paperji/smart-bartender/hardware/3dprint/README.md

# 3D 프린팅 부품 (출력 부품 01~07)

> 팀 **홍당무** · 사용자의 감정 및 취향 분석 기반 AI 맞춤형 음료 및 칵테일 배합 메이커 · 2026-11-10
> 조립 방법은 [`../guide/조립가이드.md`](../guide/조립가이드.md) STEP 9·10과 **부록 D**를 보세요.

큰 판(외형 W420 × D260 × H380)은 포맥스 5T로 만들고, 정밀하게 맞물리거나·시중에서 구하기 어렵거나·겉으로 보이는 부품 7종만 3D 프린터로 출력합니다. 외형 전체를 출력하면 420mm 판을 2~4조각으로 나눠 이어야 하고(대부분의 출력 장비는 한 변 256~350mm), 출력 대행비가 약 30만~45만 원(추정), 큰 평판은 휘어서 권하지 않습니다.

| 번호 | 파일 (`stl/`) | 수량 | 크기 (mm) | 쓰는 곳 | 대신하는 것 |
|---|---|---:|---|---|---|
| 01 | `01_corner_bracket.stl` | 12 (+예비 2) | 26 × 26 × 16 | 바닥 A–측판 B, 선반 D–B, 상판 C–B 모서리 | L자 꺾쇠 P36 + 너트 접착 |
| 02 | `02_nozzle_block.stl` | 1 | 80 × 60 × 25 | 선반 D 아래(잔 칸 가운데) | 노즐 판 M1 + 걸이 M2 |
| 03 | `03_front_bezel.stl` | 1 | 100 × 40 × 3 | 앞판 F 바깥(버튼·LED 둘레) | — (마감) |
| 04 | `04_grommet_20.stl` | 2 | 28 × 28 × 9 | 선반 D의 Ø20 구멍 | 고무 그로밋 P44 |
| 05 | `05_grommet_12.stl` | 1 | 18 × 18 × 9 | 뒤판 G의 Ø12 구멍 | 고무 그로밋 P44 |
| 06 | `06_lid_corner_cap.stl` | 4 | 25 × 25 × 13 | 상판 C 네 모서리(C에만 접착) | — (마감) |
| 07 | `07_divider_bushing.stl` | 1 | 32 × 32 × 7 | 칸막이 E의 Ø25 구멍 | — (튜브 보호·번호) |

합계 7종 24개, 약 120cm³(PETG를 꽉 채우면 약 150g). `stl_plates/`에는 업로드용 묶음(`plate_A_brackets_x14.stl` 브래킷 14개, `plate_B_others_x10.stl` 나머지 10개)이 있습니다.

## 출력 조건

- 재료 **PETG 흰색**(PLA보다 물·알코올·열에 강함), 레이어 0.2mm, 벽 3겹, 인필 브래킷 50%·나머지 15%
- **크기 배율 100%**(M3 너트 홈 맞변 5.9·볼트 구멍 Ø3.5·튜브 구멍 Ø6.2 등 치수 고정), **파일 방향 그대로**(바닥면 z=0, 서포트 없이 출력되게 설계 — 브래킷은 L자 단면이 바닥)
- 모든 파일은 닫힌 형상(manifold), 단위 mm, 바이너리 STL

## 주문(2026-11-10 공개 정보 기준, 실제 금액은 업로드 견적으로 확인)

- **3DFARM** (https://3dfarm.co.kr/, 경기 김포) — 가입 없이 STL 업로드 즉시 견적, 결제 후 24시간 안에 출력 시작, 3만 원 이상 무료배송. 실제 주문 구성: 묶음 파일 `plate_A_brackets_x14.stl` 수량 1 + `plate_B_others_x10.stl` 수량 1(PETG 흰색, 배율 100%, 방향 '원본 그대로'). 2026-11-10 업로드 견적 51,000원 + 39,000원 = 약 9만 원(부품별 파일로 올린 것보다 쌌음) → **실제 결제 78,700원**(11/16 도착 예정). 한 파일에 부품이 여러 개면 1개당 추가 요금이 붙으니 견적에서 비교합니다. 요청사항에 "너트 홈 안에 서포트 없이"를 적습니다
- **메이크잇3d** (크몽, https://kmong.com/gig/533416) — 0.2mm PLA 10g당 1,500원, 시간 요금 없음, 배송 포함. 크몽 메시지로 견적. PLA면 약 1.5만~2.5만 원(추정)
- 그 밖에 와우쓰리디·아이컨택(업로드 견적), GBSA 3D프린팅통합센터 안양(공공, 비용·학생 자격은 전화 확인)

## 모델 고치기

`parts.py`(파이썬, [manifold3d](https://pypi.org/project/manifold3d/))가 모든 STL을 만듭니다. 치수를 바꾸려면 숫자를 고친 뒤 다시 만듭니다.

```
pip install manifold3d
python parts.py out
```

예: 어댑터 플러그가 커서 뒤판 G 구멍을 키웠으면 `grommet(12.0, 7.0, 3.0)`의 구멍 값을, 튜브가 꺾이면 `nozzle(H=25.0)`의 높이를 바꿉니다. 결과 요약은 `parts.json`.

## 위생

3D 출력물은 어떤 필라멘트도 식품용 인증이 없고 층 사이 홈에 액체가 스며들면 씻기 어렵습니다. 음료가 지나가는 길은 실리콘 튜브와 체크밸브뿐이고, 노즐 블록에서는 튜브 끝을 블록 아래로 10mm 내리고 블록 위쪽 튜브 둘레를 실링해 음료가 출력물에 닿지 않게 합니다(조립가이드 STEP 10 절차 7).
