paperji/smart-bartender/hardware/circuit/검증노트.md

# 회로 전기적 검증 노트 (AI 스마트 바텐더 회로도 v3)

> 팀 홍당무 · 2026-11-06 (SPEC v2.1 반영) · 기준: `smart-bartender/docs/SPEC.md` v2.1 §1 핀맵, `hardware/research/parts_research.md`, `canonical_bom.json`
> 대상 도면: `schematic.svg/png`(시트 1/2), `wiring.svg/png`(시트 2/2), `회로도.html`(연결표 ①~㊱)
> 표기: **(추정)** = 계산·일반값으로 낸 값, 실측으로 바꿔야 함. **(자료)** = 판매처/배포처 자료 값.

---

## 1. 요약

| 항목 | 결론 |
|---|---|
| 5V 4A 어댑터 용량 | 순차 구동 최대 약 0.96A(순간), 동시 구동 약 1.37A(정상)·1.77A(순간) → **여유 2.3배 이상** |
| 3A 퓨즈 | 정상 동작(최대 약 1.8A, 4개 동시 기동해도 약 3A·수십 ms)에서는 끊어지지 않음. **단락의 1차 보호는 어댑터(P11) 내장 과전류·단락 보호**이고, F1은 어댑터 보호가 고장 났거나 더 큰 전류의 어댑터를 쓸 때를 위한 **배선 백업 보호**. 4A 어댑터로는 단락이 나도 퓨즈가 안 끊어질 수 있음(6절) |
| 3.3V로 옵토 릴레이 구동(A안) | OFF는 확실. ON은 입력 전류 약 0.35mA(추정)로 **경계 수준 → 벤치 테스트 필수**, 실패 시 **B안(SPEC v2.1 공식 대체안)**: USB·어댑터를 모두 분리한 상태에서 ⑪(VCC←3V3)을 **먼저** 제거 → ⑨(+5V)를 JD-VCC 핀에서 입력 헤더 VCC 핀으로 옮김 → 점퍼 끼움, VCC=JD-VCC=5V, IN은 GPIO 직결. **B안에서 VCC를 3V3에 연결 금지** |
| 1N4007 플라이백 다이오드 | 전류·전압 정격 모두 충분(1A/1000V vs 0.2~0.6A/5V) |
| 1000µF 16V 커패시터 | 내압 3.2배 여유, 펌프 기동 시 순간 강하 약 0.2V 이하(추정) |
| ESP32 핀 | 사용 핀 모두 일반 GPIO(입력 전용·플래시 핀 미사용), GPIO2 스트래핑 핀은 LED+220Ω→GND로 문제 없음. DevKitC V4에는 GPIO2 사용자 LED가 없으므로 **외부 LED1+R1 필수** |
| 배선 굵기 | AWG20(펌프·전원), AWG22(ESP32 전원·앞판), 듀폰(신호·릴레이 헤더) 모두 전류 대비 충분. AWG22는 UL1007 노랑(P24)·검정(P62)·빨강(P63) 세 색: ⑦·㉛~㊱ 검정, ⑧ 빨강, ㉙·㉚·㉝·㉟ 노랑(+번호 테이프) |

---

## 2. 전류 예산

### 2.1 부하별 전류

| 부하 | 전류 | 근거 |
|---|---|---|
| 수중펌프 SZH-GNP155 1개, 정상 | 약 0.20 A | 4.5V 0.18A 표 (자료) → 5V에서 약간 증가 (추정) |
| 수중펌프 1개, 기동 순간 | 약 0.4~0.6 A (수~수십 ms) | 소형 브러시 DC모터 일반값 2~3배 (추정, 실측 필요) |
| 릴레이 코일 JQC-3FF-S-Z 5V 1개 | 약 0.071 A | 코일 약 70Ω (자료, 제조사 원본 미확인) |
| ESP32 DevKitC V4 (BLE 광고·연결) | 0.10~0.25 A | 보수적으로 0.25 A 사용 |
| 릴레이 입력(옵토) 4개 | A안 ≤ 약 1.5 mA, B안 ≤ 약 10 mA | 3절 계산 |
| 상태 LED (GPIO2) | 약 6 mA | (3.3 − 2.0) V ÷ 220 Ω |
| 능동 부저 ONE005 (3V3) | 약 20~30 mA | (추정) |

### 2.2 동작 모드별 합계 (5V 레일 기준)

| 모드 | 계산 | 합계 |
|---|---|---|
| 대기 (BLE 연결) | 0.25 + 0.006 | 약 0.26 A |
| 순차(seq) 정상 — 펌프 1개 + 릴레이 1개 | 0.25 + 0.071 + 0.20 + 0.04 | **약 0.56 A** |
| 순차 순간 최대 — 펌프 기동 | 0.25 + 0.071 + 0.6 + 0.04 | **약 0.96 A** |
| 동시(par) 정상 — 펌프 4 + 릴레이 4 | 0.25 + 4×0.071 + 4×0.20 + 0.04 | **약 1.37 A (약 6.9 W)** |
| 동시 순간 — 펌웨어가 0.1초 간격으로 차례 기동(`PAR_STAGGER_MS`) | 1.37 − 0.20 + 0.6 | **약 1.77 A** |
| (최악) 4개가 정확히 동시에 기동 | 0.25 + 0.284 + 4×0.6 + 0.04 | 약 2.97 A (수십 ms) |

### 2.3 어댑터 여유

- 5V 4A 어댑터 대비: 순차 순간 최대 0.96 A → **약 4.2배**, 동시 순간 1.77 A → **약 2.3배**. 최악 2.97 A도 정격 이내.
- 연속 전력: 최대 약 6.9 W (어댑터 20 W의 약 35%) → 발열 문제 없음.

### 2.4 선·커넥터 전류

| 경로 | 최대 전류 | 사용 선 | 판단 |
|---|---|---|---|
| ②③④ J1(+)→SW1→F1→TB1 | 약 1.8 A (par 순간) | AWG20 | 충분 (AWG20 배선용 수 A급) |
| ⑤ J1(−)→TB2 (펌프 귀환) | 약 1.4 A | AWG20 | 충분 |
| ⑦ J1(−)→ESP32 GND (ESP32 + 릴레이 코일 귀환) | 약 0.25 + 0.28 = 0.55 A | AWG22 UL1007 검정(P62) | 충분 |
| ⑧ TB1→ESP32 5V | 약 0.25 A | AWG22 UL1007 빨강(P63) | 충분 |
| ⑨ TB1→JD-VCC (코일 4개) | 약 0.28 A | 듀폰 | 충분 (듀폰 접점 1 A급). B안은 TB1→입력 헤더 VCC 핀→점퍼 캡→JD-VCC 경로(약 0.28 A + 입력 약 10 mA) — 점퍼 캡(보통 1~3 A급)도 충분 |
| ⑯ 릴레이 GND→ESP32 GND(J2-14) | 약 0.29 A | 듀폰 | 충분. 코일 전류가 ESP32 보드 GND 면을 지나 ⑦로 돌아감(수 mV 강하) |
| ⑰~⑳ COM, ㉑~㉘ 펌프선 | 펌프 1개 0.2~0.6 A | AWG20 2P | 충분. 0.7 m 왕복 강하 ≈ 1.4 m × 33 mΩ/m × 0.2 A ≈ 9 mV |

### 2.5 전압 강하와 ESP32 레귤레이터 여유

- 어댑터 케이블 + SW1 접점 + 퓨즈 + 배선 저항 합 ≈ 0.15~0.2 Ω (추정) → 1.37 A에서 약 0.2~0.3 V 강하 → ESP32 5V 핀 약 4.7~4.9 V.
- DevKitC의 3.3V LDO는 입력이 약 4.3~4.4 V 이상이면 정상 출력(드롭아웃 약 1 V급 가정) → 여유 있음. 순차 구동에서는 강하가 더 작음.

---

## 3. 3.3V 로직으로 옵토 릴레이를 구동하는 근거

- 보드 구조(사진 확인): 입력 헤더 `VCC IN4 IN3 IN2 IN1 GND`(치수도 방향 기준 위→아래), 2핀 점퍼 `JD-VCC | VCC`, 별도 코일 GND 핀 없음(코일 전류는 입력 헤더 GND로 귀환).
- 점퍼 헤더가 2핀뿐이라 **점퍼 캡을 끼우면 두 핀이 모두 덮여** JD-VCC 핀에 듀폰 소켓(⑨)을 같이 꽂을 수 없음 → B안에서는 +5V(⑨)를 **입력 헤더 VCC 핀(⑪을 뺀 자리)** 으로 넣고, 점퍼 캡을 통해 JD-VCC로 보냄. 이렇게 하면 VCC 핀을 ⑨가 차지하므로 3V3(⑪)을 실수로 다시 꽂을 자리도 없어짐.
- 입력 회로(추정, 일반적인 4채널 옵토 보드): `VCC → 1kΩ → 표시 LED(약 1.8 V) → 옵토 LED(약 1.15 V) → INx`.

| 방식 | IN = HIGH (OFF) | IN = LOW (ON) | 판단 |
|---|---|---|---|
| **A안 (SPEC)** 점퍼 제거, VCC = 3V3, JD-VCC = 5V | VCC − IN = 0 V → 전류 0 → **확실히 OFF** | (3.3 − 1.8 − 1.15) ÷ 1 kΩ ≈ **0.35 mA** (추정, 범위 0.3~0.7 mA) | 옵토 CTR이 낮으면 코일 트랜지스터가 덜 켜질 수 있음 → **시험 필수** |
| **B안** (USB·어댑터 분리 후) ⑪ 먼저 제거, ⑨(+5V)를 입력 헤더 VCC 핀으로 옮기고 점퍼 끼움 → VCC = JD-VCC = 5V | 5 − 3.3 = 1.7 V < LED 2개 문턱 약 2.6~3.0 V → **OFF** (추정) | (5 − 2.95) ÷ 1 kΩ ≈ **2.0~2.4 mA** → 확실히 ON | A안 실패 시 사용. **VCC를 3V3에 연결 금지** |

- ESP32 GPIO 부담: A안 싱크 약 0.35 mA, B안 약 2.4 mA → ESP32 권장 범위(수십 mA) 대비 매우 작음.
- B안에서 GPIO에 5V가 들어가는 경로: GPIO HIGH일 때 LED 직렬 회로에 걸리는 전압이 문턱 미만이라 전류가 거의 없고, 부팅 중(High-Z)에도 GPIO 보호 다이오드를 통해 흐를 만큼의 전압차가 생기지 않음(추정). 5V가 직접 GPIO에 닿는 배선은 없음.
- 부팅 순서: 펌웨어 `safeOutput()`이 `gpio_set_level(HIGH)`(출력 레지스터 선기록) → `pinMode(OUTPUT)` → `digitalWrite(HIGH)` 순서(SPEC §1; ESP32 코어 3.x는 `pinMode` 전에 부른 `digitalWrite`를 무시함, `config.h` RELAY_OFF_LEVEL=1)라 부팅 중 펌프가 튀지 않음. 리셋 직후 GPIO26/27/32/33은 입력 상태 → IN 핀에 전류 경로 없음 → OFF 유지.
- 핀 선택 검토: GPIO26·27·32·33·4·2·23은 모두 입출력 가능 GPIO. 입력 전용(34~39)·플래시(6~11) 미사용. GPIO2는 스트래핑 핀이지만 다운로드 모드 조건(LOW 또는 플로팅)을 LED+220Ω→GND가 방해하지 않음. GPIO32/33은 32 kHz 크리스털 핀이지만 DevKitC V4에는 크리스털이 없음.

---

## 4. 다이오드 정격 (D1~D4, 1N4007)

| 항목 | 요구 | 1N4007 | 판단 |
|---|---|---|---|
| 순방향 평균 전류 | 펌프 전류 0.2 A (차단 직후 수 ms) | 1 A | 5배 여유 |
| 순방향 서지 | 기동 전류 0.6 A 수준 | 30 A (8.3 ms) | 충분 |
| 역내압 | 평상시 5 V 역바이어스 | 1000 V | 충분 |
| 역회복 시간 | 릴레이 ON/OFF(초 단위) | 일반 정류용(수 µs) | 릴레이용으로 문제 없음. **PWM(MOSFET) 업그레이드 시 1N5819 쇼트키로 교체** |

- 방향: **띠(캐소드) = 펌프(+)**. 반대로 달면 릴레이 ON 때 5V–GND가 다이오드로 단락 → 5V 레일이 무너져 ESP32 재부팅(브라운아웃)·릴레이 해제, 또는 어댑터 보호 동작(꺼짐·재시작 반복). 4A 어댑터의 단락 전류(약 4~6 A, 추정)는 3A 퓨즈 정격의 1.5~2배라 **퓨즈는 끊어지지 않을 수 있고**, 1A 정격 다이오드가 약 4~5 W로 과열·소손될 수 있음. 특히 ESP32를 USB로 켠 디버깅 상태(⑧ 분리)에서는 릴레이가 계속 붙어 있어 단락이 이어질 수 있음 → "퓨즈 멀쩡 = 다이오드 정상"이 아님. 띠 방향을 눈으로 확인하고, 수축튜브가 변색·냄새 난 다이오드는 교체.
- 위치(SPEC §1): **① 펌프 리드선 이음부(뚜껑 위)** 또는 **② 연장선의 박스 쪽 끝** — **전기적으로 동일**(둘 다 펌프와 병렬).
  배선도(wiring.svg)는 ①로 그렸고, 조립 가이드 STEP3은 ②를 씁니다(젖지 않고, 펌프를 잇기 전에 멀티미터로 방향을 확인하기 쉬움).
  `parts_research.md` 3.5절·BOM P10의 "릴레이 쪽(띠 다리 → NO 단자, 반대 다리 → TB2)"도 ②와 같은 회로입니다.
- 역기전력 크기 예시(가정 L ≈ 1 mH, I = 0.2 A, 차단 1 µs): V ≈ 200 V, E ≈ 20 µJ → 다이오드가 약 0.8 V로 제한.

## 5. 커패시터 정격 (C1, 1000µF 16V 105℃)

- 내압: 16 V ÷ 5 V = 3.2배 여유(일반 권장 1.5~2배 이상) ✔
- 순간 강하 억제(추정): 펌프 기동 추가 전류 0.4 A가 0.5 ms 동안 C1에서만 공급된다고 가정 → ΔV = I·Δt ÷ C = 0.4 × 0.0005 ÷ 0.001 = **0.2 V**.
- 전원 투입 시 충전 돌입: 에너지 ½CV² = 12.5 mJ, 어댑터 출력 임피던스로 제한 → 퓨즈 I²t(3A 속단형 수 A²s급) 대비 무시 가능.
- 극성: 띠(−) → TB2, 긴 다리(+) → TB1. TB1 1번·TB2 8번이 맞닿게 두 커넥터를 나란히 고정해 다리를 바로 꽂음.
- (선택) ESP32 리셋이 생기면 P17 100µF를 ESP32 5V–GND 가까이에 추가.

## 6. 기타 정격

| 부품 | 정격 | 사용 | 판단 |
|---|---|---|---|
| 릴레이 접점 JQC-3FF-S-Z | 10 A 30 VDC | 0.2~0.6 A 5 VDC (유도성, 다이오드 있음) | 충분 |
| J1 DC잭 터미널 | 20 A, 1~38 V | ≤ 1.8 A | 충분 |
| SW1 KCD1-101A | 6 A 250 VAC (DC 정격 미표기) | 5 VDC ≤ 1.8 A | 저전압 DC라 아크 작음, 문제 없음(추정) |
| F1 FH-303 + 3A 유리관 | 홀더 10 A | 3A 퓨즈(속단형 가정, IEC 60127-2 F형): 1.5×In은 1시간 이상 견딤, 2.1×In(6.3 A) ≤ 30분, 2.75×In(8.3 A) 10 ms~2 s | 4A 어댑터는 단락 전류가 약 1.5~2×In(약 4.4~6 A, 어댑터 과전류 보호 동작점 추정)이라 **퓨즈가 끊어지지 않을 수 있음** → 단락 1차 보호는 어댑터 내장 보호, F1은 어댑터 보호 고장·더 큰 어댑터 사용 시의 배선 백업 보호. 정상 동작(최대 약 1.8 A)·4개 동시 기동(약 3 A, 수십 ms)에는 단선 안 됨. 3A 유지(2A로 낮추면 정상 1.37 A·순간 1.77 A는 견디지만 4~5 A에서 즉시 끊어지지는 않음) |
| PCT-418 | AWG28~14 (자료) | AWG20/22, 듀폰 | 적합. 피복 8~10 mm 벗겨 끝까지 삽입 |

---

## 7. SPEC 핀맵 일치 확인

| SPEC §1 항목 | 회로도 | 배선도/연결표 | 일치 |
|---|---|---|---|
| 펌프1 GPIO26 → IN1 | P1, GPIO26(J2-10) | ⑫ 파랑 | ✔ |
| 펌프2 GPIO27 → IN2 | P2, GPIO27(J2-11) | ⑬ 초록 | ✔ |
| 펌프3 GPIO32 → IN3 | P3, GPIO32(J2-7) | ⑭ 노랑 | ✔ |
| 펌프4 GPIO33 → IN4 | P4, GPIO33(J2-8) | ⑮ 보라 | ✔ |
| (확장) 펌프5~8 GPIO25·13·18·19 | 확장 메모 | HTML 핀표 | ✔ (배선은 미표시) |
| 버튼 GPIO4 → GND, INPUT_PULLUP | SW2 | ㉝ ㉞ | ✔ |
| 상태 LED GPIO2 (외부 LED+220Ω **필수**) | LED1·R1 (실선 = 필수) | ㉟ ㊱ | ✔ (보드에 사용자 LED 없음 → 외부 필수) |
| 부저 GPIO23 (능동, HIGH=울림) | BZ1 | ㉙ ㉚ ㉜ | ✔ (`config.h` BUZZER_ON_LEVEL=1과 일치) |
| 릴레이 VCC ← 3V3 (TB3), JD-VCC 점퍼 제거 (A안) | 표시 | ⑩ ⑪ + 점퍼 제거 표시 | ✔ |
| B안: 전원(USB·어댑터) 분리 → ⑪ 먼저 제거 → ⑨를 입력 헤더 VCC 핀으로 옮김 → 점퍼 끼움 · VCC=5V, 3V3 연결 금지 | 메모 | 메모 + 회로도.html ⑤ | ✔ (SPEC §1 v2.1 교차검증 반영본의 "⑪ 먼저 → ⑨ 이동 → 점퍼 캡, 전원 분리 상태"와 같은 순서) |
| 릴레이 JD-VCC ← 5V 레일 | 표시 | ⑨ | ✔ |
| ESP32 5V 핀 ← 5V 레일, USB 시 분리 | 표시 | ⑧ + 경고 | ✔ |
| 공통 GND, 별형 접지(⑤ → TB2, ⑦ → ESP32 GND, 릴레이 GND → ESP32 GND) | GND 레일 | ⑤ ⑦ ⑯ ㉒~㉘ ㉛ | ✔ |
| 전원: 어댑터 → SW1 → F1 3A → TB1, TB2 = GND, TB3 = 3V3 | SW1·F1 | ①~⑥ ⑩ | ✔ |
| 1N4007: 띠 → 펌프(+), 위치는 이음부 또는 박스 쪽 끝(전기적으로 동일) | D1~D4 | 이음부로 그림 + 메모 | ✔ |
| 릴레이 NO/COM/NC 멀티미터 확인 (COM–NC 삐, COM–NO 무음) | — | 배선도 메모 · 회로도.html ④ | ✔ |
| 5V 레일 1000µF 16V | C1 | ⑥ | ✔ |
| Active-LOW, `gpio_set_level(HIGH)` → `pinMode(OUTPUT)` → `digitalWrite(HIGH)` | 메모 | — | ✔ (펌웨어 `config.h` RELAY_ON_LEVEL=0) |

## 8. 회로 구현 선택 (1~3, 5는 SPEC v2.1 §1에 반영됨)

1. **SW1 전원 스위치 + F1 3A 퓨즈**(BOM P13~P15). SPEC v2.1부터 정식 구성(회로도의 "권장" 표시 삭제).
2. **분배 커넥터 3개**: TB1 = +5V(8구 모두 사용), TB2 = GND(J1−, 펌프− ×4, C1−, 예비 2), **TB3 = 3V3**(ESP32 3V3 → 릴레이 VCC·부저 VCC). TB3에는 BOM의 PCT-418 예비분을 사용 → 남는 예비 1개.
3. **GND 별형(스타) 접지**: J1(−) 나사에 ⑤(→TB2, 펌프 귀환)와 ⑦(→ESP32 GND J3-1) 두 가닥. 릴레이 GND는 ⑯으로 ESP32 GND(J2-14)에 연결.
   펌프의 큰 전류가 ESP32 GND 선을 지나지 않아 잡음·리셋에 유리. 결과적으로 모든 GND는 공통(SPEC과 동일).
   참고: SPEC §1 문구는 TB2를 "펌프·릴레이 코일 측"이라 적었지만, 이 릴레이 보드는 코일 GND 핀이 따로 없어 **코일 전류는 ⑯ → ESP32 GND → ⑦** 로 돌아갑니다(2.4절). 모두 공통 GND라 동작에는 영향 없음.
4. **다이오드 위치**: 이음부(뚜껑 위) 또는 연장선 박스 쪽 끝 — 전기적으로 동일(4절). 배선도는 이음부, 조립 가이드는 박스 쪽 끝.
5. 릴레이 단자 NO/COM/NC 순서는 보드 실크 기호를 사진으로 판독해 "치수도 방향에서 각 블록 위 = NO, 가운데 = COM, 아래 = NC"로 그림 → **멀티미터로 확인하도록 안내**(COM–NC 도통, COM–NO 무도통).

## 9. 남은 위험 · 확인 필요

| # | 위험 | 영향 | 대응 |
|---|---|---|---|
| 1 | A안(3.3V)에서 릴레이가 안 켜지거나 불안정 | 펌프 미동작 | 브레드보드 벤치 테스트 → 실패 시 B안(USB·어댑터 분리 후 ⑪ 먼저 제거 → ⑨를 VCC 핀으로 → 점퍼). 입력 회로 직렬 구조는 미확인 |
| 2 | 릴레이 NO/NC 위치 오판 | 전원 넣자마자 펌프 계속 동작 | 도통 확인 후 결선, 첫 통전은 펌프 선 없이(회로도.html ⑦) |
| 3 | JD-VCC·VCC 핀 혼동(인접 2핀) 또는 점퍼를 낀 채 ⑪ 연결 | 5V가 ESP32 3V3로 역류 → 고장 | 빨강/주황 색 구분, 점퍼 캡 제거 확인, 도통 검사(TB1–TB3 무음). B안은 ⑨가 VCC 핀을 차지해 ⑪을 꽂을 자리가 없음 |
| 4 | USB와 어댑터 이중 전원 | PC 포트/보드 손상 | ⑧ 분리 후 USB (경고 3곳 표시). 뽑은 ⑧ 끝(ESP32 5V = USB VBUS)은 수축튜브 캡·테이프로 절연해 J1 −·릴레이 COM 나사에 닿지 않게 |
| 5 | 펌프 기동 전류·실제 유량 미측정 | 전류 예산 오차 | 멀티미터 직렬 측정(200 mA 레인지 초과 주의, 10 A 단자 사용) |
| 6 | 펌프 5V 구동(정격 3~4.5V) | 수명 단축·발열 | 판매처 5V 안내 있음. 펌웨어가 펌프 1개 최대 120초(make, v2.1에서 60→120초)·run 60초로 제한하고 순차 구동이 기본. 120초 연속 구동 시 펌프 발열을 시운전에서 손으로 확인 |
| 7 | 브러시 모터 잡음으로 ESP32 리셋/BLE 끊김 | 제조 중단 | 다이오드(펌프와 병렬, 위치는 이음부·박스 쪽 끝 어느 쪽이든), 순차 구동, 필요 시 C2 100µF(P17) 또는 펌프 단자 0.1µF 세라믹(미보유) 추가 |
| 8 | 이음부·전선이 액체에 젖음 | 누전·부식 | 수축튜브 2겹, 전장 박스는 선반 위(액체와 격리), 이음부는 액면보다 위 |
| 9 | 릴레이 코일 전류가 ESP32 GND를 경유(⑯→⑦) | ⑦ 빠지면 ESP32·릴레이 모두 꺼짐(안전 측) | ⑦을 J1 나사에 확실히 조임 |
| 10 | 레버 커넥터·확장보드 단자에 듀폰 핀/가는 선 접촉 불량 | 간헐 동작 | 듀폰은 잘라 피복 벗겨 사용, 당김 시험 |
| 11 | 부저 ONE005 핀 순서(VCC/I/O/GND) 미확인 | 오결선 | 모듈 인쇄 확인 후 결선 |
| 12 | KCD1·FH-303 패널 구멍 치수 미확인 | 뒤판 G 가공 | 실물 실측(parts_research 8절) |

## 10. 검증 방법 (이번 작업에서 한 것)

- 도면 생성 스크립트(`src/`)가 전선 좌표를 기록해 **점 없는 교차를 자동 검출**: 회로도 0건, 배선도 3건(모두 반원 점프로 표시: ⑭×⑮, ⑫×⑬ — GPIO 순서가 릴레이 IN 순서와 엇갈려 생기는 필연적 교차, ㉙×⑦).
- 서로 다른 전선이 같은 직선 위에 겹치는 구간 자동 검출: 0건.
- 연결표 ①~㊱ 번호가 배선도 번호와 같은 원본(`src/connections.json`)에서 생성됨 → 번호 누락/중복 0건.
- Edge 헤드리스로 PNG(3600×2400)를 만들어 직접 확인하며 3회 수정: 글자 겹침(SW1/F1 라벨, 3V3 플래그–버튼 라벨, 범례 넘침, C1 라벨–전선), 회로도 내부 선이 상자에 가려지는 문제, 펌프 다이오드 가독성(확대 그림 추가), 점퍼 라벨 잘림 수정.
- (v2.1 수정) 상태 LED를 필수(실선)로, SW1·F1의 "권장" 표시 삭제, B안 순서(⑪ 먼저 뽑고 → ⑨를 VCC 핀으로 옮기고 → 점퍼 끼움, 2핀 점퍼라 JD-VCC 핀에는 캡만)·다이오드 위치 문구 통일, 120초 제한 반영 → 스크립트 재실행 후 PNG 재확인(교차 0/3건 동일, 겹침 없음).
- (리뷰 반영 2026-11-06) B안 배선을 실제로 만들 수 있게 수정(2핀 점퍼 헤더: ⑨를 입력 헤더 VCC 핀으로 옮긴 뒤 캡, JD-VCC 핀엔 캡만 — connections.json ⑨, 회로도·배선도 메모, 회로도.html ⑤ 그림), 퓨즈 역할 재정리(단락 1차 보호 = 어댑터, F1 = 백업 — 1·4·6절), 릴레이 초기화 순서를 SPEC·펌웨어와 일치(`gpio_set_level` → `pinMode` → `digitalWrite`), USB 업로드 때 뺀 ⑧ 끝 절연 안내 추가 → 스크립트 재실행 후 PNG 재확인(회로도 교차 0건, 배선도 반원 점프 3건·겹침 0건, 연결 번호 1~36 누락/중복 0건 — 수정 전과 동일).
- (BOM P62·P63 반영 2026-11-06) UL1007은 노랑(P24)·검정(P62)·빨강(P63) 세 색만 구매 → 연결표 색을 실제 구매 색과 맞춤: ⑦·㉛·㉜·㉞·㊱ 검정(P62), ⑧ 빨강(P63), ㉙·㉚·㉝·㉟ 노랑(P24, 예전 주황·분홍·하늘·갈색) + 선 양 끝 번호 테이프, ⑩은 듀폰 주황(또는 UL1007 노랑), ㉙는 듀폰 주황으로 이어도 됨. 배선도 범례·굵기 문구·회로도.html 굵기 안내·⑧ 부품표(P24·P62·P63)와 B안 문구(전원 분리 후 ⑪ 먼저)를 고친 뒤 make_schematic.py → make_wiring.py → make_html.py → render_png.py 재실행: 회로도 교차 0건, 배선도 반원 점프 3건(⑦×㉙, ⑮×⑭, ⑬×⑫)·겹침 0건, 연결 36개·번호 1~36 일치 — 수정 전과 같음. PNG(3600×2400)는 범례·앞판·주의 상자를 확대해 글자 넘침·겹침 없음을 확인.
- (리뷰 반영 2026-11-07) 회로도.html 맨 위 핀맵 표의 B안 요약 행에도 위 문구와 같이 "USB·어댑터 분리 후"와 "⑪ 먼저"를 넣음(make_html.py의 그 행만 고쳐 make_html.py만 재실행 — schematic/wiring SVG·PNG는 바뀌지 않음, 연결표 36행 그대로).
- ESP32 핀 위치는 Espressif DevKitC 핀 배치도, 릴레이 헤더·점퍼·단자 위치는 판매처 사진과 치수도(76×56 mm, 홀 간격 69.6×49.4 mm)로 대조.
