paperji/smart-bartender/docs/프로젝트_정리.md

# 캡스톤 폴더 전체 스캔 결과 정리 (2026-11-06, 7장 v2.1 진행 결과 · 8장 앱 v3.0 2026-11-07 · 10장 앱 v3.1 2026-11-08)

> 기준: 팀 캡스톤 폴더의 모든 파일(HWP·HWPX·PPTX·XLSX·PDF·코드·이미지) 텍스트 추출 후 통합. (보고서 원본은 이 저장소에 넣지 않음)
> 내용이 충돌하면 **최근 수정 파일을 우선**했습니다.

## 1. 과제 한눈에 보기

| 항목 | 내용 |
|---|---|
| 과제명 | 사용자의 감정 및 취향 분석 기반 AI 맞춤형 음료 및 칵테일 배합 메이커 |
| 팀 | 홍당무 (51분반, 4명) |
| 과목 | 캡스톤디자인Ⅰ(2026/1) → **캡스톤디자인Ⅱ(2026/2, 현재)** |
| 유형 | 일반 캡스톤디자인 / 결과물: 시제품 + 소프트웨어 |
| 목표 | 앱에 기분·맛·성향 입력 → AI(Gemini)가 기기 내 재료로 레시피 생성 → ESP32가 펌프 시간 제어로 자동 배합 |
| 특허 아이디어 | ① BM/SW: 재고 연동 AI 추천 + 거절 시 미보유 재료 추가 장착 유도 루프 ② HW: 펌프 단독 구동시간 제어 모듈 |

## 2. 진행 이력 (문서 근거)

| 시기 | 내용 | 근거 파일 |
|---|---|---|
| 3/3~3/21 (1~3주) | 팀 구성, 주제 확정, 역할 분담 | 주차별 보고서, 1학기 중간보고서 |
| 3/25 | 1학기 과제계획서 (밸브+펌프 구조, 앱 워크플로우 설계) | 1학기 과제 계획서 (3/25) |
| 3/26~3/30 | Expo 앱 + Vercel 백엔드(Gemini 2.5 Flash) 구축 | beverage-maker app |
| 4/13 | 선행특허 조사 보고서, 특허 분석 PPT | 선행특허 보고서, 프레젠테이션.pptx |
| 4월 말 | 중간발표, 앱 틀 화면 | 어플틀 사진.png |
| 5/5 | 1차 물품 구매(109,200원), 회로도 V1(솔레노이드 포함) | 물품구매의뢰서.xlsx, 회로도.html |
| 5/8 | 1학기 중간보고서 제출 | 중간보고서 .hwpx |
| 5/14 | **회로도 V2: 솔레노이드 제거, 펌프 단독 제어** | 회로도ver2.html |
| 5/25~6/7 | 진행사항·기말 PPT (Wi-Fi STA, 릴레이 4ch, 캘리브레이션 계획) | 진행사항/기말 .pptx |
| 5/29 | 2차 구매(52,200원: 체크밸브, 1N4007, AWG20, 튜브 5mm, 수축튜브) | 물품구매의뢰서_추가분.xlsx |
| 6/22 | 1학기 결과보고서 (실습비 161,400원 집행) | 결과보고서 .hwp |
| 9/21 | 2026 캡스톤 경진대회 참가 신청 (유형Ⅱ AI·공학) | 참가신청서 .hwp |
| 10/1 | 2학기 과제계획서 (캡스톤디자인Ⅱ) | 과제 계획서 홍당무 .hwp |
| 10/10 | 경진대회 예선보고서 (계획 대비 70%) | 예선보고서 .hwp |
| 11/6 | ESP32 Wi-Fi 코드·앱 코드 최신화 (Wi-Fi/HTTP 방식) | esp32 모터 제어 코드 c++.txt, 앱 코드 javascript.txt |
| 10월 중순 | 경진대회 예선 결과: **예선 탈락** (사용자 확인) → 이후 목표는 졸업작품 시제품·논문·특허 | — |
| 11/10~11/11 | **2학기 부품 구매(무납땜 기준)**: 3D 출력 부품 78,700원(견적 90,000원보다 적음)·포맥스 3장 43,000원 → 디바이스마트 35품목 102,528원(거래명세서 대조) · 다이소 6품목 14,000원(배송비 3,000원 포함) — 2학기 지출 238,228원 | `hardware/BOM_무납땜기준.xlsx` 지출_완료 시트 |

## 3. 하드웨어 현황 (구매 완료)

| 부품 | 수량 | 사용 여부 |
|---|---|---|
| ESP32 DevKitC WROOM-32D V4 (CP2102) | 2 | 1개 사용, 1개 예비 |
| 4채널 5V 릴레이 모듈 SZH-RLBG-012 | 2 | 1개 사용, 1개 예비(펌프 5~8 확장용) |
| 수중펌프모터 SZH-GNP155 | 4 | 사용 |
| SparkFun 솔레노이드 5V ROB-11015 | 4 | **미사용** (설계 변경으로 제외) |
| 실리콘 튜브 내경 4mm×5m, 5mm×8m | — | 사용 |
| 체크밸브 JGB32PPS | 4 | 사용 (역류·드립 방지) |
| 1N4007 다이오드 | 10 | 4개 사용 (펌프 역기전력 보호) |
| 5V 4A 어댑터, DC 플러그, 터미널-DC 커넥터 | 1/1/2 | 사용 |
| AWG20 2P 10m, 열수축 슬리브, 브레드보드, 점퍼선 | — | 사용 |

## 4. 소프트웨어 현황 (v1, 11/6 기준)
- 앱: Expo SDK 54 / React Native, 재료 4개 태그 입력 + 원하는 맛 텍스트 → Vercel 백엔드 → Gemini → `{"재료명": ml}` 응답을 `pump1~4`로 변환 → ESP32에 HTTP POST.
- ESP32: Wi-Fi STA + WebServer `/makeDrink`, `delay()`로 순차 구동, `MS_PER_ML=1000`(미보정).
- 한계: 블루투스 미지원, 재료 저장 안 됨(앱 재시작 시 초기화), IP 하드코딩, 캘리브레이션·진행상황·비상정지·기록 없음, 디자인 미흡, Expo Go 오류 화면 발생 이력.

## 5. 발견한 문제점 / 정정 필요 사항
1. 회로도 V2: 릴레이 모듈 VCC를 5V로 연결 → ESP32(3.3V) 신호로는 릴레이가 확실히 꺼지지 않을 수 있음 → v3에서 JD-VCC 분리 배선으로 수정.
2. 회로도 V2: 플라이백 다이오드 외 전원 안정화 커패시터·퓨즈 없음, ESP32 USB/외부 5V 동시 연결 주의 없음.
3. 기존 코드 `MS_PER_ML = 1000` (1ml/초) 는 실제 펌프 유량(수십 ml/초 수준)과 크게 달라 캘리브레이션 필수.
4. 선행특허 보고서·특허 PPT에는 여전히 '솔레노이드 밸브' 기반 H/W 차별화가 적혀 있음 → 최신 설계(펌프 단독 제어)와 불일치.

## 6. v2에서 바꾸는 것 (요약 — 상세는 SPEC.md)
- 통신: Wi-Fi/HTTP → **BLE (Nordic UART, 줄바꿈 JSON)** — 공유기·IP 불필요.
- 펌웨어: 비차단 상태머신, 진행률 알림, 비상정지(앱/버튼), 펌프별 유량 보정값 플래시 저장, 시리얼로도 테스트 가능.
- 앱: 재료(펌프) 저장·수정·잔량 관리, 기분/맛/도수/날씨(자동)/상황/성향 입력, AI 레시피 카드·비율 조정, 제조 진행·비상정지, 기록·피드백, 캘리브레이션 마법사, 데모 모드.
- AI: 구조화된 JSON 응답(스키마 강제) + 서버/앱 이중 검증 + 오프라인 규칙기반 대체.
- 회로: JD-VCC 분리, 1000µF 커패시터, 퓨즈, 버튼·LED·부저(선택), 실물형 배선도.

## 7. v2.1 진행 결과 (2026-11-07 기준)

### 7.1 만든 것
| 산출물 | 위치 | 상태 |
|---|---|---|
| ESP32 펌웨어 v2.1.0 (BLE) | `firmware/` | PC 테스트 191/191 (펌프 4개 180 + 8개 11), arduino-cli 컴파일 3종(기본·8펌프·2펌프) 에러·경고 0, 플래시 1,128,275B(86%)·RAM 51,328B |
| 안드로이드 앱 v2.1 (Expo) | `app/` | 자동 테스트 143/143, 타입 검사 0 오류, expo-doctor 20/20, 웹 빌드 성공. 데모 기기로 추천 → 레시피 → 제조 → 피드백 → 새 재료 탐색 → 기록 → 잔량 차감까지 브라우저에서 직접 눌러 확인(11/7) |
| AI 서버 v2.1 (Vercel + Gemini) | `backend/` | 로컬 테스트 68/68 (가짜 Gemini 응답, 실제 호출 없음) |
| 회로도·배선도·연결표 ①~㊱ | `hardware/circuit/` | 문서 간 교차 검증 통과(연결 36개 일치) |
| BOM·추가 구매 의뢰서용 시트 | `hardware/BOM.xlsx`, `BOM.md` (2026-11-10부터 두 기준 통합판 — 이 줄의 숫자는 11-06 원본 `hardware/research/BOM_원본_20261106.*` 기준) | 검증 78/0. 필수 구매 79,658원(VAT 포함, 의뢰서 기준 VAT 별도 72,418원, 35품목) |
| 초보자 조립 가이드 | `hardware/guide/조립가이드.html` | STEP 1~12, 그림 15장, 깨진 링크 0 |
| 2학기 중간보고서 | 팀 보고서 폴더의 `캡스톤 디자인 중간보고서(2학기) …홍당무.hwpx/.hwp/.pdf` (이 저장소에는 포함하지 않음) | 1~10주(9/1~11/6), 제출일 2026-11-06 |

### 7.2 교차 검증 (같은 입력을 양쪽에 넣어 결과 비교)
- **펌웨어 ↔ 앱 데모 기기**: 명령 스크립트 387·757·757개 중 386·756·756개가 출력까지 완전히 같음. 남은 1개는 `setcal`에 소수 셋째 자리 값(4.445)을 넣었을 때의 반올림 차이(실제 앱은 소수 둘째 자리까지만 보냄).
- **앱 ↔ AI 서버 (무작위 10,000건 × 3, 3,000건 × 2)**: 계약 항목 모두 100% 일치. "무알콜·성인 확인 전에는 술 장착·대체 제안 0" 안전 항목은 앱·서버 모두 100%. 참고용 차이 4개(탐색 카드 ml 반올림 등)는 계약 밖이며 안전과 무관.

### 7.3 아직 확인하지 못한 것 (실물이 있어야 함)
- ~~실제 보드 업로드·BLE 연결~~ → 2026-11-07 확인(9장). 남은 것: 릴레이·펌프를 단 실물 구동, 릴레이 A안(3.3V)/B안(5V) 결정, 캘리브레이션 실측.
- ~~PC ↔ ESP32 블루투스 연결~~ → 2026-11-07 확인(9장). 남은 것: 실제 **휴대폰(APK)** ↔ ESP32 연결.
- 실제 Gemini 호출: v3.0 부터 서버 배포 없이 각자 본인 키로(8장). 예전 서버는 크레딧 소진 오류 상태였고 더 쓰지 않음.
- ~~가격 미확인 품목~~ → 2026-11-11 무납땜 기준 부품을 모두 사서 디바이스마트 품목은 거래명세서 금액으로 바뀜. 다이소 6품목은 결제 14,000원(배송비 3,000원 포함, 품목별은 다이소몰 판매가로 나눔), 선택 품목(시음 전 교체용 P65~P67, 볼트 P68, 자석 P69)은 사지 않음. 재원(1학기 잔액 이월·예선 지원금·2학기 실습비)도 미확인.

### 7.4 주의
- 식품용 부품으로 바꾸기 전에는 기기에서 나온 액체를 마시지 않고, 시연은 색 물로 합니다(조립가이드 1.3).

## 8. 앱 v3.0 (2026-11-07) — 웹앱 하나로 PC·안드로이드

결정(2026-11-07): ① AI 는 **사용자가 본인 Gemini API 키를 앱에 등록**(BYOK) ② 앱 디자인은 **밝은 톤** ③ Expo 대신 **웹으로 PC·폰에서 동작 + 파일(APK·EXE)로도 설치**. 기준 문서 `docs/WEBAPP_DESIGN.md`.

| 산출물 | 위치 | 상태 |
|---|---|---|
| 앱 v3.0.3 (Vite + React 19 + TypeScript) | `app/` | `npm test` 323/323, 타입 검사 0 오류, 웹·PWA 빌드 + 키 검사 통과 |
| 안드로이드 APK (Capacitor 8) | `app/release/SmartBartender-3.0.3.apk` (깃 제외 → GitHub Releases) | 빌드·서명 확인(약 6MB). **실제 휴대폰 ↔ ESP32 연결·앱 안 업데이트(3.0.2 → 3.0.3) 확인**(9장) |
| Windows EXE (Electron, portable) | `app/release/SmartBartender-3.0.3-portable.exe` (깃 제외 → GitHub Releases) | 빌드(약 108MB) + 창 없이 실행 점검 통과. **실제 PC ↔ ESP32 연결·앱 안 업데이트(3.0.2 → 3.0.3) 확인**(9장) |
| 웹앱 배포 | `.github/workflows/pages.yml` → https://paperji.github.io/smart-bartender/ | 배포됨(2026-11-07, Actions). 저장소에 올리면 자동으로 다시 배포. 열려 있던 3.0.1 창이 3.0.3 으로 저절로 바뀌는 것 확인(PC·휴대폰 크롬) |
| 이전 앱 v2.1 (Expo) | `legacy/app-expo-v2.1/` | 참고용 보관(고치거나 배포하지 않음) |
| 백엔드 v2.1 | `backend/` | 보정 규칙 기준 구현으로만 유지(68/68), 앱↔백엔드 결과 비교 테스트. 배포하지 않음 |

- 바뀐 것: 서버 모드·서버 주소 설정 제거(앱이 Gemini 를 직접 호출, 키는 그 기기에만 저장), 키 등록 화면([키 확인]·[저장]·[삭제]·키 발급 방법), 첫 실행 안내 카드, 밝은 톤 UI, PC 화면(왼쪽 메뉴·2열), 웹 블루투스·APK 네이티브 BLE·EXE 앱 안 기기 선택 창, PWA 오프라인 실행, 설정 > 앱 정보(내려받기·오픈소스 고지).
- 그대로인 것: 펌웨어·BLE 프로토콜, 보정 규칙(SPEC §3.3)·탐색(§5.4), 화면 기능과 문구(해요체), 데모 모드.
- 공개 저장소 원칙(팀 결정 2026-11-07): 개인 이름·학번·연락처는 넣지 않고 팀 이름 "홍당무"만 씀. `hardware/BOM_납땜기준.xlsx`·`BOM_무납땜기준.xlsx` 의 의뢰서 팀장 이름 칸도 비워 두고 문서 속성(작성자)을 지움 — 학교 제출본은 제출 전에 직접 기입.

## 9. 실제 ESP32 연결 시험 (2026-11-07)

USB 로만 연결한 ESP32 보드(릴레이·펌프 없음 → 펌프 핀만 켜지고 아무것도 움직이지 않음)에 펌웨어를 올리고, 이 PC 의 블루투스로 앱과 연결해 봤어요.

| 항목 | 결과 |
|---|---|
| 보드 | ESP32-D0WD-V3 (rev 3.1), 플래시 4MB, CP210x (COM5). 광고 이름 `SmartBartender-606A` |
| 업로드 | `arduino-cli`(Arduino IDE 2 내장) + 코어 esp32 3.3.8 + ArduinoJson 7.4.3 → 1.13MB(86%), 경고 0, 해시 검증 통과 (`firmware/README.md` 3-1) |
| USB 시리얼 | 부팅 메시지·`hello`/`status`/`ping`/`getcal` 응답이 SPEC 그대로 |
| PC 블루투스 자동 시험 | `firmware/test/ble_e2e.py` **32/32** (펌웨어 2.1.0·2.1.1·2.1.2 모두): 광고·특성, 순차·동시 제조(예상 2.425초 → 실제 2.52초), BUSY, 비상 정지(0.08초), 오류 4종, 한글 id 20바이트 쓰기, run, **제조 중 끊기 → 0.6초 뒤 다시 광고 → 다시 연결해 `status.last` 로 결과 확인**. MTU 247 |
| Windows 앱(EXE) | 데모 모드 끄기 → 기기 선택 → 연결(펌웨어 버전 표시) → 오프라인 추천 레시피 → **기기로 제조**(10.6초, 완료·기록·잔량 차감) → **비상 정지**(나온 양 74.3ml 표시) → **제조 중 보드 리셋** → 앱이 자동으로 다시 연결해 "기기가 다시 켜져 제조가 멈췄어요, 확인된 양 약 60ml" 로 정리 |
| 고친 것 (앱 v3.0.1 · 펌웨어 2.1.1) | 독립 검토로 찾은 3가지: ① 블루투스 혼잡 때 펌웨어가 결과 줄(done)까지 버릴 수 있었고, 앱은 연결된 채로는 다시 묻지 않아 제조 화면이 99% 에 멈출 수 있었음 → 펌웨어는 4초까지 다시 보내고 한 줄만 포기 + 줄 맞춤, 앱은 끝날 시각 + 3초·정지 1.5초 뒤·기기 줄이 3초 끊기면 `status` 로 확인 ② EXE 에서 기기가 광고하지 않으면 선택 창이 안 뜨고 "검색 중지"가 몇 분 동안 안 됨 → 선택 창을 바로 열고 취소 가능 ③ EXE 에서 PC 블루투스가 꺼져 있으면 아무 안내 없음 → 안내 문구. 고친 코드를 다시 독립 검토해 찾은 9건(정지 뒤 stopped 를 놓치면 끝날 시각까지 기다림, ack 를 놓친 프라이밍이 계획량으로 기록됨, '기기 선택' 두 번 누르면 취소됨, 남은 callback 때문에 취소 예약이 안 됨, 줄 맞춤 `\n` 만 남은 혼잡 뒤 새 줄이 일찍 포기됨 등)도 고치고, 고치기 전 코드로 되돌리면 실패하는 테스트로 확인. 테스트: 펌웨어 PC 213/213, 앱 284/284(3.0.1) |
| v3.0.1 EXE 로 다시 확인 | 다른 연결이 기기를 잡고 있는 동안 기기 선택 → 선택 창이 바로 열리고 12초 뒤 "기기를 찾지 못했어요" 안내 → **취소하면 바로 끝남**, 나중에 기기가 다시 광고해도 창이 저절로 뜨지 않음 → 다시 기기 선택 → 연결 → 제조 완료·기록 |
| **휴대폰 APK ↔ 실제 ESP32** (갤럭시 S20 Ultra(안드로이드 13), GitHub 에서 받은 3.0.1) | USB 디버깅으로 화면·로그를 보며 시험: 데모 끄기 → 주변 기기 검색 → `SmartBartender-606A` 연결(펌웨어 버전 표시) → 레시피 → **기기로 제조**(10.6초, 완료 알림·기록) → **비상 정지**(63ml 에서 멈춤, 알림) → **보드를 다시 올리는 동안 끊겼다가 앱이 스스로 다시 연결** |
| 휴대폰 첫 연결 실패 | 연결 요청 뒤 0.3초 만에 실패(안드로이드 GATT 133, HCI 0x3E — 기기가 첫 연결 패킷을 놓침, 기기 시리얼에는 아무것도 없음)가 자주 남. PC 는 매번 연결. 첫 시도 연결: 펌웨어 2.1.1(이중 모드) 14번 중 7번, 2.1.2(블루투스 컨트롤러 BLE 전용) 26번 중 22번. 같은 펌웨어도 시험마다 달라 휴대폰 쪽 무선 상황 영향이 큼 → 앱 3.0.3 이 4번까지 자동으로 다시 시도(앱 테스트 287/287) |

### 9.1 v3.0.3 공개 뒤 실기 시험 (2026-11-07, 컴퓨터·휴대폰 × 설치형 앱·웹앱)

v3.0.3(앱 안 자동 업데이트 포함)을 공개하기 전에 업데이트 코드를 독립 검토 4번(지적 18+4+9+1건 모두 고침, 앱 테스트 323/323) 거친 뒤, 웹 배포·Releases v3.0.3 을 올리고 아래를 실제로 해 봤어요.

| 항목 | 결과 |
|---|---|
| 웹 자동 업데이트 — PC 크롬 | 3.0.1 이 열려 있던 탭을 다시 열자 3.0.1 이 잠깐 보인 뒤 **약 10초 안에 스스로 새로고침돼 3.0.3** (서비스 워커) |
| 웹 자동 업데이트 — 휴대폰 크롬 | 위와 같음 (갤럭시 S20 Ultra, 안드로이드 13) |
| EXE 자동 업데이트 | 시험용 3.0.2 EXE 를 켜자 4초 뒤 **"새 버전이 나왔어요 v3.0.3"** 창(바뀐 점 3줄) → 업데이트 → 진행률(약 12초, 113MB) → SHA-256 확인 → 같은 폴더에 3.0.3 EXE 저장(임시 파일 남지 않음) → **새 EXE 가 켜진 뒤 3.0.2 가 스스로 닫힘** → 3.0.3 은 "최신"이라 다시 묻지 않음 |
| APK 자동 업데이트 | 시험용 3.0.2 APK → 설정 › 앱 정보 › 업데이트 확인(자동 확인은 6시간 간격이라 이번엔 건너뜀 — 정상) → 추천 창 → 업데이트 → **"이 출처 허용"을 켜 달라는 창** → 설정 열기(갤럭시는 "출처를 알 수 없는 앱 설치" **목록**이 열려 앱을 찾아 켬) → 안드로이드 설치 창 "업데이트" → **3.0.3(versionCode 30003)**, 기록·설정 그대로, 기기에 자동으로 다시 연결 |
| 페어링 — PC 크롬 웹앱 | 데모 끄기 → 기기 선택(브라우저 창) → **5/5 연결**(2.0~3.1초, 펌웨어 v2.1.2 표시) → 세척(펌프당 3초) 진행률 → 완료 |
| 페어링 — 휴대폰 크롬 웹앱 | **6/6 연결**(약 2.1초) → 세척 완료 |
| 페어링 — 휴대폰 APK 3.0.3 | 업데이트 직후 자동 재연결 + 주변 기기 검색 → **8/8 연결, 모두 첫 시도(GATT 133 재시도 0번)**(5.4~6.4초) → 세척: 기기 시리얼에서 `clean` → ack → 펌프 1~4 → done(12.9초) 확인, 앱 "세척 완료" |
| 페어링 — PC EXE 3.0.3 | 앱 안 기기 선택 창 → **5/5 연결**(2.5~3.1초) → 세척 완료 |

- 시험 방법: PC 크롬은 따로 만든 시험용 프로필 + 원격 디버깅(CDP, 블루투스 선택 창은 `DeviceAccess.selectPrompt`), 휴대폰 크롬은 USB 디버깅으로 같은 방법, APK 는 adb 화면 덤프·터치, EXE 는 `--remote-debugging-port`. "이 출처 허용"·안드로이드 설치 확인은 휴대폰 주인이 직접 누름.
- 보드만 연결된 상태(릴레이·펌프 없음)라 세척은 펌프 핀만 켜지고 아무것도 움직이지 않음.
- 알게 된 점: 갤럭시는 "설정 열기"가 앱 전용 화면이 아니라 목록을 엶 — 다음 버전에서 안내 문구를 "목록에서 AI 스마트 바텐더를 눌러 켜기"로 손볼 것. → v3.1 에서 앱 안 업데이트 창·토스트에 반영(10장).

남은 것: 릴레이·펌프를 단 실물 구동(조립가이드 STEP2 벤치 테스트), 펌프별 캘리브레이션.

## 10. 앱 v3.1 (2026-11-08) — 모두의 레시피 · 여러 AI 키

결정(2026-11-08): ① 사용자가 만든 레시피를 **공유**하고, 다른 사람도 그 레시피로 만들 수 있게 — 공유 서버는 **새 Supabase 무료 프로젝트**, 인기 순위는 **실제로 기기로 만들기 시작했을 때** 기기 하나당 1번만 셈 ② AI 키는 Gemini 말고도 여러 회사 ③ 화면 문구는 "Gemini" 대신 "AI" ④ 키 발급 방법은 AI 를 고르면 그 회사 방법이 보이게 ⑤ v3.0.3 시험에서 알게 된 갤럭시 업데이트 안내 문구를 앱 안 창에도 반영 ⑥ 설정 화면에서 톱니바퀴를 여러 번 누르면 뒤로 가기를 그만큼 눌러야 하던 문제 고침.

| 산출물 | 위치 | 상태 |
|---|---|---|
| 앱 v3.1.0 | `app/` | `npm test` 383/383, 타입 검사 0 오류, 웹·PWA 빌드 + 키 검사 통과 |
| 공유 서버 | Supabase 프로젝트 `smart-bartender`(서울, 무료) — 표·함수 정의 `docs/shared-recipes.sql`(v1~v3) | 표는 직접 읽고 쓸 수 없고 정해진 함수 5개(공유·목록/검색·사용·신고·공유 취소)로만 접근. 앱에 든 키는 공개용(publishable) 키뿐 |
| 안드로이드 APK · Windows EXE | `app/release/SmartBartender-3.1.0.apk` · `SmartBartender-3.1.0-portable.exe` (깃 제외 → GitHub Releases) | 빌드·실기 시험(아래) |

- **여러 AI**: Gemini·ChatGPT·Claude·Grok·DeepSeek·Mistral·Groq·OpenRouter 8곳. 키는 회사마다 따로 그 기기에만 저장. 다른 회사 모양의 키를 넣으면 저장 전에 알려 줌. 회사마다 요청 모양(JSON 스키마·JSON 모드·일반)이 달라 거절되면 한 단계씩 낮춰 다시 요청. 8곳 모두 웹(paperji.github.io)·APK·EXE 에서 브라우저 직접 호출(CORS) 되는 것 확인.
- **모두의 레시피(공유 탭)**: 기록에서 다 만든 잔 → [공유](별명·한마디, AI 가 쓴 설명·팁은 선택) → 많이 만든 순 **TOP 5** + "새로 올라온 레시피" + 이름·재료 검색 + 신고 + 내 공유 취소. 내 기기 펌프에 없는 재료는 빼고 만들 수 있는지 미리 보여 줌. 성인 인증 전에는 무알콜 레시피만 보임.
- **악용 막기(서버)**: 같은 IP(값은 소금 친 해시로만 저장) 하루 공유 20·사용 300·신고 20, 한 레시피에 같은 IP 기기 20대까지만 셈, 서로 다른 IP 2곳 이상에서 신고 3번이면 숨김, 술 이름인데 도수 0 으로 올려도 서버가 술로 판단, 같은 레시피 다시 공유는 새로 만들지 않음, 시간당 전체 600개 한도.
- **독립 검토 3번**: 지적 약 30건 + 13건 + 4건 모두 고치고, 고치기 전 코드로는 실패하는 테스트를 붙임.

### 10.1 실기 시험 (2026-11-08, 컴퓨터·휴대폰 × 설치형 앱·웹앱, 실제 ESP32 — 보드만 연결)

| 항목 | 결과 |
|---|---|
| PC EXE 3.1.0 | 기기 연결(2.6초, 펌웨어 v2.1.2) → 제조 → 기록에서 **공유**(별명 QA홍당무) → 공유 탭 "새로 올라온 레시피"에 "내 레시피"로 보임 → 다른 기기가 만든 뒤 **TOP 1**. 가짜 ChatGPT 키 → "키가 올바르지 않아요"(앱 보안 정책(CSP)에서 막히지 않음). 설정 화면에서 톱니바퀴 숨김 |
| 휴대폰 APK 3.1.0 (갤럭시 S20 Ultra) | 기기 자동 재연결, 아래 탭 5개, 공유 탭에 EXE 가 올린 레시피 → [이 레시피로 만들기] → **실제 ESP32 로 제조 → 만든 수 1**, 기록에 "모두의 레시피" 표시(다시 공유 버튼 없음). 톱니바퀴 숨김·뒤로 1번에 메인. 가짜 ChatGPT 키 → "키가 올바르지 않아요" |
| 휴대폰 크롬 웹앱 | 연결 2.1초 → 공유 레시피로 제조 → **만든 수 2**, "만들어 봤어요" 표시 |
| PC 크롬 웹앱 | 연결 3.1초 → 검색(있는 이름 1개·없는 이름 0개) → 제조 → **만든 수 3** |
| 개발 브라우저 | Gemini 실제 호출("AI 추천 · Gemini"), 가짜 ChatGPT·Claude 키 → "키가 올바르지 않아요", 다른 회사 키 경고·바꾸기, 공유 창 미리보기, 휴대폰 너비 탭 5개 |
| 3차 검토 반영 뒤 다시 빌드한 것 | PC 크롬 웹앱(새 번들) 연결 3.1초 → 제조 완료 → **다른 탭에서 데모 모드로 바꾼 것처럼 해도 완료 화면이 그대로**(기기는 데모로 다시 시작). EXE 연결 2.6초 → 제조 완료, 톱니바퀴 숨김·뒤로 1번. 휴대폰 APK 다시 설치(versionCode 30100) → 실제 기기에 자동 재연결 → 톱니바퀴 숨김·뒤로 1번 → 제조 완료(사이다 115ml·오렌지주스 85ml). 휴대폰 크롬 웹앱(새 번들) 연결 2.1초 → 제조 완료, 톱니바퀴 숨김·뒤로 1번 |

- 시험이 끝난 뒤 공유한 시험 레시피는 공유 취소 → 서버의 레시피·사용 기록·신고 모두 0개 확인.
- 시험 방법은 9.1 과 같음(크롬·EXE 원격 디버깅, 휴대폰 USB 디버깅). 시험용 Gemini 키는 개발용 로컬 파일에만 있고 빌드에는 들어가지 않음(키 검사 통과).

### 10.2 공개 (2026-11-08)

커밋 `6527988` → Actions(리눅스 테스트 382 + 건너뜀 1, Windows 전용 빌드 스크립트 시험)·웹 배포 성공 → Releases **v3.1.0**(APK·EXE, SHA-256 은 릴리스 노트).

| 항목 | 결과 |
|---|---|
| 웹 자동 업데이트 | 3.0.3 이 열려 있던 탭이 약 12초 뒤 스스로 3.1.0 으로 바뀜. 공개 주소(paperji.github.io)에서 공유 탭 → 공유 서버 응답 200 |
| EXE 앱 안 업데이트 (공개된 3.0.3 → 3.1.0) | 켜고 5초 뒤 "새 버전이 나왔어요 v3.1.0"(바뀐 점 3줄) → 업데이트 → 받기·SHA-256 확인 → **새 EXE 가 켜지고 3.0.3 은 닫힘** |
| 공개 직후 실패 1번 | 릴리스를 올리고 약 1분 뒤 첫 시도는 "HTTP 400", 같은 창에서 다시 시도는 "인터넷 연결을 확인해 주세요". 몇 분 뒤 새로 켠 3.0.3 은 처음 상황 그대로 2번 모두 정상 → GitHub 파일 서버 쪽 일시적인 문제로 보임(같은 Electron 으로 따로 받아도 정상). 실패해도 "다시 시도"·나중에 다시 켜면 받을 수 있음 |
| APK | 실제 다운로드 주소에서 받은 파일의 SHA-256 이 릴리스와 같음, 앱의 릴리스 판별 함수로 3.0.3 이 3.1.0 을 새 버전으로 알아봄(휴대폰은 이미 3.1.0 이라 앱 안 업데이트는 시험하지 않음) |

- 시험 메모: 3.0.3 은 창이 화면 앞에 있을 때만 받은 뒤 바로 설치하고, 아니면 "받아 두었어요 — 지금 설치"로 물어봄(설계대로).
