paperji/smart-bartender/hardware/circuit/회로도.html

# AI 스마트 바텐더 회로도 v3 — 회로도 · 배선도 · 연결표

팀 홍당무 · 캡스톤디자인Ⅱ (안양대학교 정보전기전자공학과) · 2026-11-06 · SPEC v2.1 기준 (smart-bartender/docs/SPEC.md §1 핀맵) · 인터넷 없이 열리는 단일 파일

## 한눈에 보기

앱(스마트폰)이 블루투스(BLE)로 레시피를 보내면 ESP32가 각 펌프를 계산된 시간만큼 켭니다. ESP32 핀은 3.3V 신호만 낼 수 있어 펌프를 직접 돌리지 못하므로, 릴레이(전기로 움직이는 스위치)가 5V 전원을 펌프에 연결/차단합니다.

- 전원: 5V 4A 어댑터 → J1 DC잭 → SW1 전원 스위치 → F1 3A 퓨즈 → TB1(+5V 분배). TB2 = GND 분배, TB3 = 3V3 분배. GND는 J1(−) 나사에서 ⑤(→ TB2, 펌프 귀환)와 ⑦(→ ESP32 GND, ESP32·릴레이 귀환)로 따로 나누는 별형 접지이며, 전기적으로는 모두 공통입니다.
- 제어: GPIO26·27·32·33 → 릴레이 IN1~IN4 → 펌프 1~4. 릴레이는 LOW = 켜짐(Active-LOW).
- 보호: 펌프마다 1N4007 다이오드(역기전력 흡수), 5V에 1000µF 커패시터(전압 순간 강하 완화).

기능 | ESP32 핀 (헤더 위치) | 연결 대상
펌프 1 / 2 / 3 / 4 | GPIO26 (J2-10) / GPIO27 (J2-11) / GPIO32 (J2-7) / GPIO33 (J2-8) | 릴레이 IN1 / IN2 / IN3 / IN4
시작/정지 버튼 (선택) | GPIO4 (J3-13) | 버튼 → GND (내부 풀업, 눌림 = LOW)
상태 LED (필수) | GPIO2 (J3-15) | 220Ω → LED → GND (DevKitC V4에는 GPIO2 사용자 LED가 없어 외부 LED 필수)
부저 (선택) | GPIO23 (J3-2) | 능동 부저 I/O (HIGH = 울림)
릴레이 로직 전원 | 3V3 (J2-1) → TB3 | 릴레이 VCC — A안(기본): JD-VCC 점퍼 제거. B안(USB·어댑터 분리 후): ⑪ 먼저 제거 → ⑨(+5V)를 이 VCC 핀으로 옮김 → 점퍼 캡 끼움 · VCC=5V (3V3 연결 금지)
릴레이 코일 전원 | — (TB1 +5V) | 릴레이 JD-VCC (B안: ⑨ → 입력 헤더 VCC 핀 → 점퍼 캡 → JD-VCC)
ESP32 전원 | 5V (J2-19) | TB1 +5V (USB 업로드 시 분리)
(확장) 펌프 5~8 | GPIO25 · 13 · 18 · 19 | 2번째 릴레이 IN1~4 (같은 방식)

J2 = ESP32 왼쪽 핀줄, J3 = 오른쪽 핀줄. 안테나(금속 덮개 쪽)를 위로 두고 위에서부터 1, 2, 3 … 으로 셉니다.

파일: schematic.svg · schematic.png · wiring.svg · wiring.png · 검증노트.md (전류 예산·정격 검토)

## ① 회로도 (전기적 연결 관계)

위쪽 빨간 선 = +5V 버스, 아래 검은 선 = GND 버스. 점(●)이 있는 곳만 연결되고, 점 없이 교차하는 선은 연결되지 않습니다. 점선 = 선택 부품(버튼·부저). 상태 LED는 필수입니다.

## ② 배선도 (실물 그대로 선 잇기)

동그라미 번호 = 아래 연결표의 번호(조립 순서). 반원 모양으로 튀어 오른 곳은 '그냥 위로 지나가는' 곳(연결 아님)입니다. ESP32 확장보드(P02 터미널쉴드)를 쓰면 같은 이름의 단자에 꽂으면 됩니다.

## ③ 연결표 (번호 = 배선도의 동그라미 번호 = 권장 작업 순서)

굵기: AWG20 = 보유한 빨강/검정 2P 선(P19, 펌프·전원), AWG22 = UL1007 22AWG, 듀폰 = 점퍼 케이블(P20~P22, 약 AWG26). UL1007은 노랑(P24)·검정(P62)·빨강(P63) 세 색만 삽니다: GND선 ⑦·㉛~㊱ = 검정, ESP32 5V선 ⑧ = 빨강, 앞판 신호선 ㉙·㉚·㉝·㉟ = 노랑(같은 색이라 선 양 끝에 번호 테이프로 구분). 릴레이 헤더처럼 튀어나온 핀(수)에는 듀폰 암(F) 끝을, 레버 커넥터·나사 단자·확장보드 단자에는 피복을 8~10mm 벗긴 끝을 꽂습니다(듀폰은 반을 잘라 사용). 레버 커넥터는 레버를 올리고 → 끝까지 밀어 넣고 → 레버를 내린 뒤 살짝 당겨 빠지지 않는지 확인합니다.

번호 | 출발 단자 | 도착 단자 | 선 색 | 권장 굵기 | 비고
A. 전원부 (어댑터 → 스위치 → 퓨즈 → 분배 커넥터, ESP32 전원)
1 | 어댑터 DC 플러그 | J1 DC잭(2.1×5.5 암) | — | (꽂기) | 어댑터 콘센트는 마지막 점검 후 꽂기
2 | J1 (+) 나사 | SW1 단자 1 | 빨강 | AWG20
3 | SW1 단자 2 | F1 퓨즈홀더 단자 1 | 빨강 | AWG20 | 납땜+수축튜브
4 | F1 퓨즈홀더 단자 2 | TB1 (+5V) 8번 | 빨강 | AWG20
5 | J1 (−) 나사 | TB2 (GND) 1번 | 검정 | AWG20 | J1(−) 나사에 ⑤·⑦ 두 가닥을 함께 조임
6 | C1 띠(−) 다리 | TB2 8번 / 긴 다리(+) → TB1 1번 | — | (부품 다리) | TB1·TB2를 나란히 붙여 다리를 바로 꽂음. 극성 반대 금지
7 | J1 (−) 나사 | ESP32 GND (J3-1, 오른쪽 줄 1번) | 검정 | AWG22 UL1007 (P62) | ESP32·릴레이 쪽 GND (별형 접지)
8 | TB1 (+5V) 7번 | ESP32 5V (J2-19, 왼쪽 줄 맨 아래) | 빨강 | AWG22 UL1007 (P63) | USB 업로드 때는 이 선을 뽑기!
B. 릴레이 전원 · 제어 신호 (ESP32 ↔ 릴레이 입력 헤더)
9 | TB1 (+5V) 6번 | A안: 릴레이 JD-VCC 핀 (점퍼 헤더 왼쪽) / B안: 입력 헤더 VCC 핀 (⑪을 뺀 자리) | 빨강 | 듀폰 F (≈AWG26) | A안: 점퍼 캡은 빼서 보관 / B안: ⑪을 뽑고 ⑨를 입력 헤더 VCC 핀으로 옮긴 뒤 캡 끼움 — 캡과 듀폰 소켓은 한 핀에 같이 꽂을 수 없음(JD-VCC 핀에는 캡만)
10 | ESP32 3V3 (J2-1, 왼쪽 줄 맨 위) | TB3 (3V3) 2번 | 주황 | 듀폰 (≈AWG26) | 듀폰 양 끝을 잘라 씀. UL1007로 하면 노랑(P24) + 양 끝 번호 테이프 ⑩
11 | 릴레이 VCC (입력 헤더 맨 위) | TB3 (3V3) 1번 | 주황 | 듀폰 F (≈AWG26) | B안이면 연결하지 않음 — 이 VCC 핀에는 ⑨(+5V)가 들어감(B안에서 VCC를 3V3에 연결 금지)
12 | ESP32 GPIO26 (J2-10) | 릴레이 IN1 | 파랑 | 듀폰 (≈AWG26) | 펌프1
13 | ESP32 GPIO27 (J2-11) | 릴레이 IN2 | 초록 | 듀폰 (≈AWG26) | 펌프2
14 | ESP32 GPIO32 (J2-7) | 릴레이 IN3 | 노랑 | 듀폰 (≈AWG26) | 펌프3
15 | ESP32 GPIO33 (J2-8) | 릴레이 IN4 | 보라 | 듀폰 (≈AWG26) | 펌프4
16 | 릴레이 GND (입력 헤더 맨 아래) | ESP32 GND (J2-14) | 검정 | 듀폰 F (≈AWG26) | 릴레이 코일 전류(최대 약 0.3A)도 이 선으로 돌아옴
C. 펌프 전원 (TB1 → 릴레이 COM, 릴레이 NO → 펌프 → TB2)
17 | TB1 (+5V) 5번 | 릴레이 K1 COM (가운데 단자) | 빨강 | AWG20
18 | TB1 (+5V) 4번 | 릴레이 K2 COM (가운데 단자) | 빨강 | AWG20
19 | TB1 (+5V) 3번 | 릴레이 K3 COM (가운데 단자) | 빨강 | AWG20
20 | TB1 (+5V) 2번 | 릴레이 K4 COM (가운데 단자) | 빨강 | AWG20
21 | 릴레이 K1 NO (위 단자) | 펌프1 빨간선(+) | 빨강 | AWG20 2P | 펌프 선은 뚜껑 위 이음부에서 연장
22 | 펌프1 검은선(−) | TB2 (GND) 2번 | 검정 | AWG20 2P
23 | 릴레이 K2 NO (위 단자) | 펌프2 빨간선(+) | 빨강 | AWG20 2P | 펌프 선은 뚜껑 위 이음부에서 연장
24 | 펌프2 검은선(−) | TB2 (GND) 3번 | 검정 | AWG20 2P
25 | 릴레이 K3 NO (위 단자) | 펌프3 빨간선(+) | 빨강 | AWG20 2P | 펌프 선은 뚜껑 위 이음부에서 연장
26 | 펌프3 검은선(−) | TB2 (GND) 4번 | 검정 | AWG20 2P
27 | 릴레이 K4 NO (위 단자) | 펌프4 빨간선(+) | 빨강 | AWG20 2P | 펌프 선은 뚜껑 위 이음부에서 연장
28 | 펌프4 검은선(−) | TB2 (GND) 5번 | 검정 | AWG20 2P
D1~D4 | 다이오드 1N4007 띠(캐소드) 다리 → 펌프 빨간선(+) | 반대쪽(애노드) 다리 → 펌프 검은선(−) | — | (부품 다리) | 위치는 ① 펌프 리드선 이음부(뚜껑 위, 배선도 그림) 또는 ② 연장선의 박스 쪽 끝(조립 가이드 STEP3) — 전기적으로 동일(SPEC §1). 어느 쪽이든 펌프와 병렬, 납땜 후 수축튜브
D. 앞판 F — 상태 LED(필수) · 시작/정지 버튼 · 부저(선택)
29 | TB3 (3V3) 3번 | BZ1 VCC | 노랑 | AWG22 UL1007 (P24) + 듀폰 F | 부저를 달 때만. 3V3선 — 노랑 신호선과 같은 색이라 양 끝 번호 테이프 ㉙ (듀폰 주황으로 이어도 됨)
30 | ESP32 GPIO23 (J3-2) | BZ1 I/O | 노랑 | AWG22 UL1007 (P24) + 듀폰 F | 양 끝 번호 테이프 ㉚
31 | ESP32 GND (J3-7) | 앞판 GND 공통선 | 검정 | AWG22 UL1007 (P62)
32 | BZ1 GND | 앞판 GND 공통선 | 검정 | 듀폰 F + AWG22 UL1007 (P62)
33 | ESP32 GPIO4 (J3-13) | SW2 단자 1 | 노랑 | AWG22 UL1007 (P24) | 납땜 · 양 끝 번호 테이프 ㉝
34 | SW2 단자 2 | 앞판 GND 공통선 | 검정 | AWG22 UL1007 (P62) | 납땜
35 | ESP32 GPIO2 (J3-15) | R1 → LED1 긴 다리(+) | 노랑 | AWG22 UL1007 (P24) | R1은 LED 다리에 납땜 · 양 끝 번호 테이프 ㉟
36 | LED1 짧은 다리(−) | 앞판 GND 공통선 | 검정 | AWG22 UL1007 (P62)

## ④ 꼭 지킬 주의사항 5가지

1. (A안) 릴레이 JD-VCC 점퍼 캡을 뺀다. 보드 모서리의 작은 플라스틱 점퍼 캡(JD-VCC│VCC 두 핀을 이어 줌, 색은 제품마다 다름)을 뽑아 보관합니다. 그다음 JD-VCC 핀(보드 인쇄 확인)에는 +5V(⑨ 빨강), 입력 헤더의 VCC에는 3V3(⑪ 주황)을 꽂습니다. 캡을 낀 채 VCC에 3V3을 연결하면 5V가 ESP32의 3.3V 쪽으로 거꾸로 흘러 ESP32가 고장 날 수 있습니다. 3.3V로 안 켜질 때는 ⑤ B안(USB·어댑터를 모두 뺀 뒤 ⑪을 먼저 뽑고 → ⑨를 JD-VCC 핀에서 빈 VCC 핀으로 옮긴 뒤 → 캡을 다시 끼움. 점퍼 캡과 듀폰 소켓은 한 핀에 같이 꽂을 수 없어 B안에서 JD-VCC 핀에는 캡만 끼웁니다. B안에서는 VCC를 3V3에 절대 연결하지 않음).
2. 다이오드 방향: 띠(은색 줄, 캐소드) = 펌프 빨간선(+) 쪽. 다이오드는 평소엔 전류가 흐르지 않다가, 펌프가 꺼지는 순간 생기는 역방향 고전압만 흡수합니다. 반대로 달면 릴레이가 켜질 때마다 +5V와 GND가 다이오드로 바로 이어집니다(단락). 펌프를 켜는 순간 ESP32가 재부팅되거나 어댑터가 꺼지고, 다이오드가 뜨거워집니다(ESP32를 USB로 켠 디버깅 상태에서는 단락이 계속돼 더 위험). 5V 4A 어댑터는 단락이 나면 약 4~6A(추정)에서 스스로 출력을 끊기 때문에 3A 퓨즈는 끊어지지 않을 수 있습니다 — "퓨즈가 멀쩡하다 = 다이오드 방향이 맞다"가 아닙니다. 수축튜브가 변색됐거나 냄새가 난 다이오드는 교체합니다.
3. 커패시터 극성: 띠(−)가 있는 다리 = GND(TB2), 긴 다리(+) = +5V(TB1). 전해 커패시터는 거꾸로 꽂으면 부풀거나 터질 수 있습니다. 16V 이상 제품(보유 계획 16V)만 사용합니다.
4. USB로 펌웨어를 올릴 때는 ⑧(TB1 → ESP32 5V) 선을 먼저 뽑는다. Espressif는 USB·5V핀·3V3핀 중 한 곳으로만 전원을 넣으라고 경고합니다. ⑧을 꽂은 채 USB를 연결하면 PC의 USB 전원과 어댑터 전원이 서로 부딪히거나, 어댑터가 꺼져 있을 때 USB가 릴레이·펌프까지 먹여 PC 포트에 무리가 갑니다. GND(⑦)는 그대로 둬도 됩니다. 뽑은 ⑧의 끝(ESP32 5V에 연결된 맨 심선)에는 USB를 꽂으면 전기가 흐르므로 수축튜브 캡(P26)이나 절연·마스킹테이프로 감싸고, 릴레이 나사 단자·J1 나사에서 먼 박스 벽에 붙여 둡니다(GND·+5V에 닿으면 USB 단락이나 이중 전원). 업로드가 끝나면 USB를 빼고 테이프를 벗긴 뒤 ⑧을 다시 꽂습니다.
5. 어댑터를 꽂기 전에 멀티미터로 단락 검사. 멀티미터를 도통(삐 소리, 다이오드 기호) 모드로 두고 TB1(+5V) – TB2(GND), TB3(3V3) – TB2, TB1 – TB3 사이를 각각 잽니다. '삐' 소리가 계속 나면 어딘가 붙어 있는 것(단락)이니 전원을 넣지 말고 배선을 다시 확인합니다. (C1·ESP32 보드의 커패시터가 충전되느라 처음에 잠깐 '삐'하고 곧 멈추는 것은 정상)

추가: 릴레이 단자 NO/COM/NC 위치는 보드 인쇄를 확인하세요. 전원 없이 멀티미터 도통 모드에서 COM–NC는 '삐', COM–NO는 무음이 정상입니다(이 배선도는 제조사 치수도 방향 기준 '위 단자 = NO'로 그렸습니다). 전원을 넣자마자 펌프가 계속 돌면 NO/NC를 바꿔 꽂은 것이니 즉시 SW1을 끄세요.

## ⑤ 릴레이 3.3V 동작 시험과 B안

이 릴레이 보드는 입력이 표시 LED + 옵토커플러 LED 직렬 구조로 추정됩니다(보드 회로도 원본 미확인). 그래서 3.3V로 구동(A안)하면 입력 전류가 약 0.3~0.7mA로 작아 켜지지 않을 수도 있습니다. 조립 전에 브레드보드에서 먼저 시험하세요.

1. A안대로 연결(⑨ ⑪ ⑫~⑯) → 앱 또는 nRF Connect에서 {"cmd":"run","p":1,"ms":2000} 전송.
2. IN1 표시 LED가 켜지고 '딸깍' 소리가 나면 성공. 채널 2~4도 "p":2 ~ "p":4로 확인.
3. 안 켜지면 B안: USB와 어댑터를 모두 뺀 상태에서 ① ⑪(3V3 → 릴레이 VCC) 선을 먼저 뽑아 치우고 → ② +5V 선 ⑨(빨강)를 JD-VCC 핀에서 빼서 입력 헤더의 VCC 핀(⑪이 있던 자리)에 꽂고 → ③ 점퍼 캡을 끼웁니다. 이제 +5V가 VCC 핀으로 들어가 점퍼 캡을 거쳐 JD-VCC(코일)에도 들어갑니다(VCC = JD-VCC = 5V). JD-VCC 핀에는 캡만 있고 다른 선은 없습니다(2.54mm 점퍼 캡은 두 핀을 모두 덮으므로 듀폰 소켓을 꽂은 핀에는 들어가지 않음). 신호선(⑫~⑮)·GND(⑯)는 그대로(IN은 GPIO 직결). ⑨가 VCC 핀을 차지하므로 3V3(⑪)을 다시 꽂을 자리도 없어집니다. 확인(전원 없이, 멀티미터 도통 모드): TB1(+5V) ↔ 릴레이 VCC 핀·JD-VCC 핀 모두 '삐', TB1 ↔ TB3(3V3)은 무음.
4. B안으로 1~2를 다시 시험합니다. 꺼질 때(신호 HIGH)도 확실히 꺼지는지 봅니다. 두 안 모두 Active-LOW라 펌웨어는 바꾸지 않습니다. 정한 방식을 릴레이에 테이프로 적어 둡니다.

B안에서 신호가 HIGH(3.3V)일 때 5 − 3.3 = 1.7V만 걸리는데, 직렬 LED 2개를 켜려면 약 2.6~3V가 필요해 확실히 꺼집니다(추정). 신호가 LOW(0V)이면 약 2~2.4mA가 흘러 확실히 켜집니다. B안에서는 릴레이 VCC를 절대 3V3에 연결하지 마세요.

## ⑥ 동작 원리 (논문·보고서용 설명)

### 1) 제어 흐름

앱이 BLE(Nordic UART)로 {"cmd":"make","steps":[{"p":1,"ml":45}, …]}를 보내면, 펌웨어는 펌프별 유량 Q(ml/s, 캘리브레이션 값)를 이용해 구동 시간을 계산합니다.

구동 시간 t [ms] = V [ml] ÷ Q [ml/s] × 1000 예) 45 ml, Q = 4.5 ml/s → t = 10,000 ms (10초)

해당 GPIO를 LOW로 만들어 릴레이를 켜고, t가 지나면 HIGH로 되돌립니다. 기본은 펌프를 하나씩 차례로 켜는 순차 구동(펌프 사이 300ms 휴지)이며, 밸브 없이 '펌프를 켜 둔 시간'으로만 양을 정하는 펌프 단독 시간 제어 방식입니다. 안전을 위해 펌웨어는 한 번의 제조에서 펌프 1개당 최대 120초(재료 1개 최대 300ml, 총 500ml), 직접 구동(run)은 최대 60초로 제한하고, 어떤 펌프든 (최대 구동시간 + 1초) 이상 켜져 있으면 전체를 정지합니다(SPEC §2.3, v2.1).

### 2) 릴레이 Active-LOW와 옵토커플러 절연

릴레이 입력은 VCC → 저항(약 1kΩ) → 표시 LED → 옵토커플러 LED → IN 핀 구조입니다. IN이 LOW(0V)이면 전류가 흘러 옵토 LED가 켜지고, 옵토 출력 트랜지스터가 JD-VCC(5V) 쪽 코일 구동 트랜지스터를 켜서 릴레이 접점(COM–NO)이 닫힙니다. 즉 LOW = ON입니다.

A안 입력 전류 I_IN ≈ (V_VCC − V_LED − V_F,opto) ÷ R = (3.3 − 1.8 − 1.15) V ÷ 1 kΩ ≈ 0.35 mA (추정) B안 입력 전류 I_IN ≈ (5.0 − 1.8 − 1.15) V ÷ 1 kΩ ≈ 2.0 mA, OFF 시 5.0 − 3.3 = 1.7 V < 약 2.95 V → 전류 0

JD-VCC 점퍼를 빼면 입력 쪽(VCC, ESP32 3.3V)과 코일 쪽(JD-VCC, 5V)의 전원이 분리되어, 신호 HIGH = VCC(3.3V)가 되어 확실히 꺼집니다. 부팅 순간 GPIO가 출력 레지스터 기본값(0 = LOW)으로 잠깐 바뀌며 펌프가 튀는 것을 막기 위해, 펌웨어는 gpio_set_level(HIGH)로 출력 레지스터를 먼저 HIGH로 써 두고 pinMode(OUTPUT) → digitalWrite(HIGH) 순서로 바꿉니다(SPEC §1 — ESP32 코어 3.x는 pinMode 전에 부른 digitalWrite를 무시하므로 gpio_set_level을 씀). 부팅 중 GPIO가 입력(High-Z) 상태일 때는 IN 핀으로 전류가 흐를 길이 없어 릴레이는 꺼진 상태를 유지합니다.

### 3) 플라이백(역기전력) 다이오드

모터 코일은 인덕턴스 L을 가져, 릴레이가 전류 I를 갑자기 끊으면 V = L·di/dt의 큰 역전압이 생깁니다. 이 전압은 릴레이 접점에 불꽃(아크)을 일으키고 전기 잡음으로 ESP32 리셋·BLE 끊김을 유발할 수 있습니다. 펌프와 반대 방향(띠 = +)으로 병렬 연결한 다이오드가 이 전류에 순환 경로를 만들어 전압을 약 0.8V로 묶어 줍니다.

예시(가정: L ≈ 1 mH, I = 0.2 A, 차단 1 µs): V ≈ 1e-3 × 0.2 ÷ 1e-6 = 200 V, 에너지 E = ½ L I² ≈ 20 µJ 1N4007: 평균 1 A · 순간 30 A · 역내압 1000 V → 펌프 전류(≈0.2 A, 기동 ≈0.6 A) · 전원 5 V에 충분

### 4) 순차 구동 전류 계산 (전원 용량 검토)

부하 | 전류 | 근거
수중펌프 1개 (정상 운전) | 약 0.20 A | 판매처 표 4.5V 0.18A, 5V에서 약간 증가 (추정)
수중펌프 1개 (기동 순간) | 약 0.4~0.6 A | 소형 DC 모터 일반값 2~3배 (추정, 멀티미터 실측 필요)
릴레이 코일 1개 | 약 0.071 A | JQC-3FF 5V, 코일 약 70Ω (배포처 자료)
ESP32 DevKitC (BLE 동작) | 0.10~0.25 A | 보수적으로 0.25 A 사용
LED + 부저 + 옵토 입력 | 약 0.04 A | LED (3.3−2.0)/220Ω ≈ 6 mA, 부저 약 30 mA (추정)

순차(seq) 정상: 0.25 + 0.071 + 0.20 + 0.04 ≈ 0.56 A 순간 최대: 0.25 + 0.071 + 0.6 + 0.04 ≈ 0.96 A 동시(par) 정상: 0.25 + 4×0.071 + 4×0.20 + 0.04 ≈ 1.37 A (전력 약 6.9 W) 동시 기동(펌웨어가 0.1초 간격으로 차례 기동): 1.37 − 0.20 + 0.6 ≈ 1.77 A → 5V 4A 어댑터 여유: 순차 약 4.2배, 동시 약 2.3배. 3A 퓨즈는 정상 동작에서 끊어지지 않음. 단락 보호: 1차 = 어댑터(P11) 내장 과전류·단락 보호(정격의 약 110~150% = 약 4.4~6A에서 차단, 추정), F1 3A = 배선 백업 보호(어댑터 보호 고장·더 큰 어댑터 사용 대비). 4A 어댑터의 단락 전류는 퓨즈 정격의 약 1.5~2배라 3A 퓨즈가 바로 끊어지지 않을 수 있음(속단형 가정, IEC 60127-2 F형: 1.5배 1시간 이상 견딤, 2.1배 ≤ 30분, 2.75배 10ms~2s).

순차 구동을 기본으로 하는 이유: 한 번에 펌프 1개만 돌아 전류가 작고(전압 강하 최소) 유량이 일정해 정량성이 좋기 때문입니다. 1000µF 커패시터는 펌프 기동 순간의 전류를 잠깐 대신 공급합니다. 예) 추가 0.4A가 0.5ms 동안 필요할 때 ΔV = I·Δt / C = 0.4 × 0.0005 ÷ 0.001 = 0.2V만 떨어집니다(추정).

## ⑦ 처음 전원 넣기 (단계별 점검)

1. ④의 5가지를 눈으로 다시 확인하고, 멀티미터 단락 검사를 합니다.
2. 펌프 선 ㉑ ㉓ ㉕ ㉗을 아직 꽂지 않은 상태에서 SW1을 켭니다. ESP32 빨간 전원 LED가 켜지는지, TB1–TB2 사이 4.9~5.25V, TB3–TB2 사이 3.2~3.4V인지 측정합니다.
3. 앱(또는 nRF Connect)으로 연결해 run 명령으로 릴레이 4개가 차례로 '딸깍'하는지 확인합니다. 안 되면 ⑤ B안.
4. SW1을 끄고 펌프 선을 꽂습니다. 펌프를 물을 담은 용기에 넣고(공회전 금지) 다시 켠 뒤 펌프별로 2초씩 구동해 봅니다.
5. 앱의 캘리브레이션(10초 구동 → 실제 ml 입력)으로 펌프별 유량을 저장합니다. 용기를 절반쯤 채운 상태에서 하세요. 저장 전에는 앱에 "캘리브레이션 전 — 실제보다 적게 나올 수 있어요" 배너가 뜹니다(기본값 20ml/s가 실제 약 3~6ml/s보다 커서 덜 나오는 쪽).
6. PC에서 시리얼 로그를 보며 시험할 때는 ⑧만 뽑고, 뽑은 ⑧ 끝을 수축튜브 캡이나 테이프로 감싸 박스 벽에 붙인 뒤 USB를 연결합니다(이 끝에는 USB 5V가 걸려, J1 − 나사에 닿으면 USB 단락, 릴레이 COM 나사에 닿으면 이중 전원). 이때 어댑터(SW1)를 켜 두면 릴레이·펌프는 어댑터로, ESP32는 USB로 동작합니다(GND ⑦은 연결 유지).

## ⑧ 그림 기호 ↔ 부품(BOM) 대응

기호 | 부품 | BOM ID | 기호 | 부품 | BOM ID
J1 | 터미널블럭 to DC 잭 (2.1mm 암) | P12 | U1 | ESP32 DevKitC V4 (+확장보드 선택) | P01 (+P02)
SW1 | 로커 스위치 KCD1-101A | P13 | K1~K4 | 4채널 릴레이 SZH-RLBG-012 | P08
F1 | 퓨즈홀더 FH-303 + 퓨즈 3A | P14 · P15 | M1~M4 | 수중펌프 SZH-GNP155 | P09
TB1 · TB2 · TB3 | 레버 커넥터 PCT-418 (5V · GND · 3V3) | P18 (3개 + 예비 1) | D1~D4 | 다이오드 1N4007 | P10
C1 | 전해 커패시터 1000µF 16V | P16 | BZ1 · SW2 | 능동 부저 ONE005 · 16mm 푸시 버튼 | P04 · P03
어댑터 | 5V 4A 어댑터 | P11 | LED1 · R1 | 5mm 빨강 LED · 220Ω | P05 · P06
전선 | AWG20 2P(빨/검) · UL1007 22AWG 노랑·검정·빨강 · 듀폰 점퍼 | P19 · P24·P62·P63 · P20~P22 | 절연 | 열수축튜브 · 솔더 슬리브 · 케이블타이 | P26 · P25 · P27

이 페이지와 그림은 hardware/circuit/src/의 파이썬 스크립트(make_schematic.py → make_wiring.py → make_html.py, PNG: render_png.py)로 다시 만들 수 있습니다. 핀이나 배선을 바꿀 때는 먼저 SPEC.md를 고치고 스크립트를 수정한 뒤 다시 실행하세요.
