paperji/smart-bartender/hardware/circuit/schematic.png

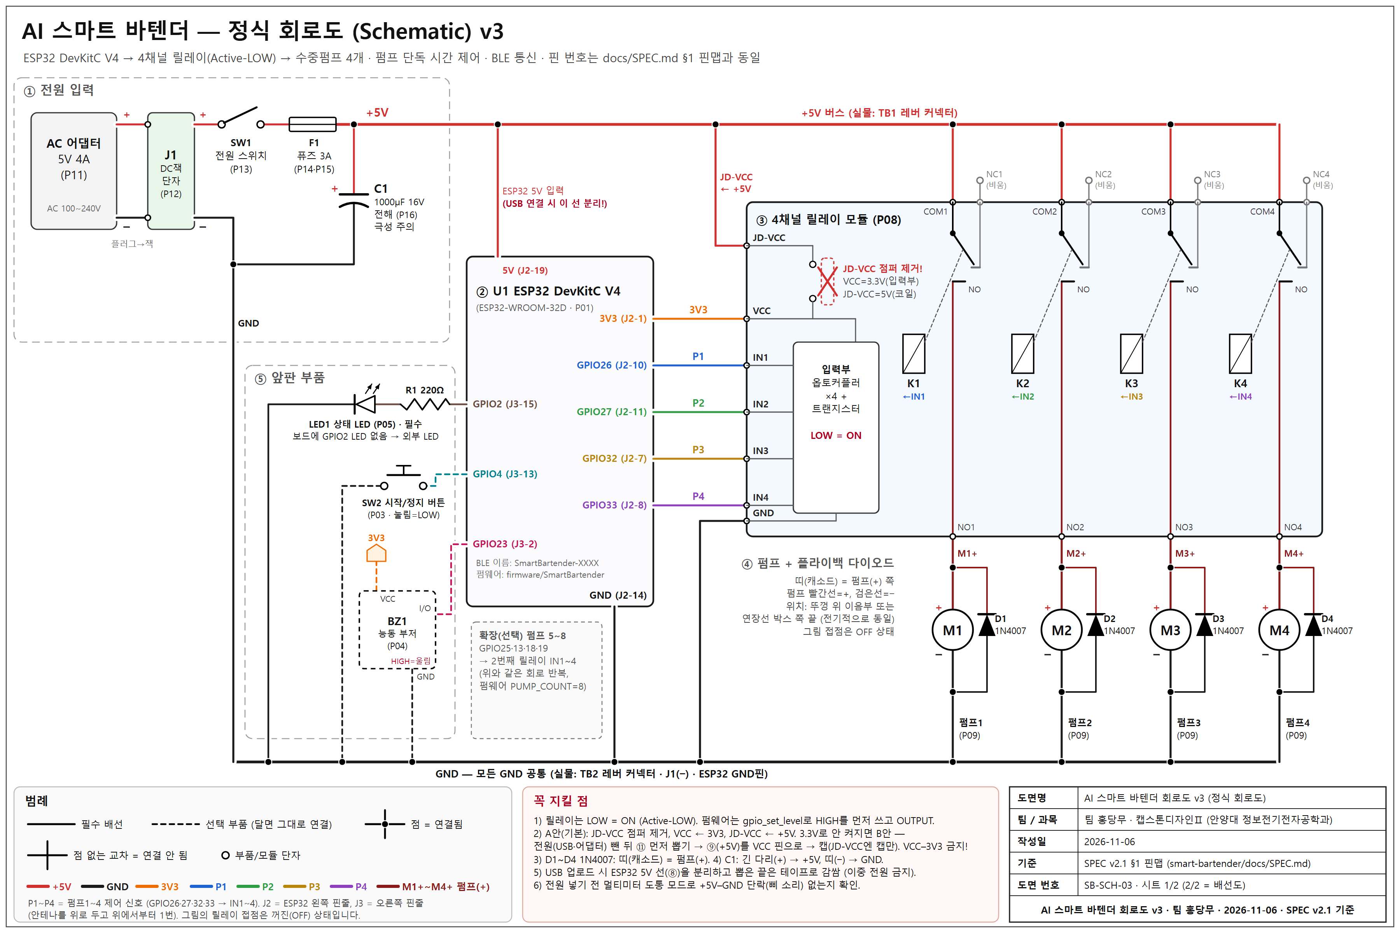
hardware/circuit/schematic.png
