paperji/smart-bartender/hardware/BOM.md

# BOM (부품 목록) — 통합판: 납땜 기준 · 무납땜 기준 비교

> 팀 홍당무 · 작성 2026-11-11 · 사용자의 감정 및 취향 분석 기반 AI 맞춤형 음료 및 칵테일 배합 메이커
> 엑셀: `BOM.xlsx` (시트: 요약 / 주문_링크 / BOM_전체 / 지출_완료 / 보유_미사용 / 선택_업그레이드 / 예산). 이 문서와 엑셀은 같은 스크립트(`research/make_bom_master.py`)로 만들어 숫자가 같습니다.
> 기준별 자세한 BOM(학교 의뢰서 양식 포함): [`BOM_납땜기준.md`](BOM_납땜기준.md) · [`BOM_무납땜기준.md`](BOM_무납땜기준.md). 원본(2026-11-06): [`research/BOM_원본_20261106.md`](research/BOM_원본_20261106.md).

## 0. 한눈에 보기

> **2026-11-11 팀은 무납땜 기준으로 부품을 모두 샀습니다**(디바이스마트 35품목 · 다이소 6품목, 4장). 무납땜의 '앞으로 살 것'은 0원이고, 납땜 열은 '지금 납땜 기준으로 바꾸면 더 사야 할 것'입니다.

| 항목 | 납땜 기준 | 무납땜 기준 | 비고 |
|---|---:|---:|---|
| 앞으로 ① 디바이스마트 (VAT 포함) | 5,203원 (3품목) | 0원 (0품목) | 학교 의뢰서(VAT 별도): 납땜 4,730 · 무납땜 0 |
| └ 디바이스마트 배송비 | 2,700원 | 0원 | 주문액 66,000원 미만일 때 2,700원(조사값) |
| 앞으로 ② 다이소·편의점 등 | 0원 (0품목) | 0원 (0품목) | 가격 아는 것만 |
| 이미 결제한 것 | 238,228원 | 238,228원 | 3D 프린팅 출력 부품 (plate_A 브래킷 01 ×14 + plate_B 나머지 02~07 ×10) 78,700원 · 포맥스 5T 흰색 43,000원 · 디바이스마트 주문 — 무납땜 기준 35품목 102,528원 · 다이소 — 무납땜 기준 6품목 14,000원 |
| **2학기 전체** | **246,131원** | **238,228원** | 선택 구매·공구 구매 제외 · 배송비 포함 |

환불 예정(합계 미포함): 다이소 TARK 직사각 간편 용기 1L 3개입 화이트 (품번 58801) 11,000원

- **납땜 기준**: 원래 설계 그대로 인두기로 납땜(학교 실습실 공구 대여). 제작: [`guide/제작가이드_납땜기준.md`](guide/제작가이드_납땜기준.md)
- **무납땜 기준**: 레버 커넥터·선 달린 스위치·인라인 퓨즈로 집에서 조립. 제작: [`guide/제작가이드_무납땜기준.md`](guide/제작가이드_무납땜기준.md)

## 1. 두 기준에서 달라지는 부품

| ID | 부품 | 적용 | 상태 (납땜 / 무납땜) | 구매 (납땜 / 무납땜) |
|---|---|---|---|---|
| P13 | 로커 스위치 KCD1-101A (ON/OFF, SPST) | 납땜 기준만 | 구매 필요 / 불필요 (P73 하네스 스위치로 대체) | 1 / 0 |
| P14 | 패널형 퓨즈홀더 FH-303 (5×20mm 유리관용) | 납땜 기준만 | 구매 필요 / 불필요 (P74 인라인 퓨즈홀더로 대체) | 1 / 0 |
| P73 | 하네스 스위치 (101A-5264) — KCD-101A 로커 스위치 + 리드선 200mm | 무납땜 기준만 | 해당 없음 / 주문 완료 (11-11, 배송 대기) | 0 / 0 |
| P74 | 퓨즈홀더 FH-201 (빨강, 라인홀더 — 선 달린 인라인형) | 무납땜 기준만 | 해당 없음 / 주문 완료 (11-11, 배송 대기) | 0 / 0 |
| P25 | 열 수축 솔더 슬리브 1.0SQ [SZH-CA002] | 납땜 기준만 | 보유 / 보유 (무납땜 기준에서는 안 씀) | 0 / 0 |
| P26 | NT DIY 열수축튜브 328세트 | 공통 | 구매 필요 / 선택(무납땜에서는 효과 작음) | 1 / 0 |
| P75 | 3선 결합 탈피형 커넥터 PCT-413 (칩센) — 3구 정션형 | 무납땜 기준만 | 해당 없음 / 주문 완료 (11-11, 배송 대기) | 0 / 0 |
| P76 | 2선 결합 탈피형 커넥터 PCT-412 (칩센) — 1:1 이음 | 무납땜 기준만 | 해당 없음 / 주문 완료 (11-11, 배송 대기) | 0 / 0 |
| P77 | 5선 결합 탈피형 커넥터 PCT-415 (칩센) — 앞판 GND 허브 | 무납땜 기준만 | 해당 없음 / 주문 완료 (11-11, 배송 대기) | 0 / 0 |
| P78 | 터미널 압착단자 케이블 2.8mm [CG0731] (30cm) | 무납땜 기준만 | 해당 없음 / 주문 완료 (11-11, 배송 대기) | 0 / 0 |
| P79 | 전기 절연 테이프 19mm×10m 2개입 | 무납땜 기준만 | 해당 없음 / 구매 완료 (11-11) | 0 / 0 |
| P46 | 실습용 납땜세트B (학교 실습실 대여 가능) | 납땜 기준만 | 학교 대여 (집에 없음) / 불필요 (무납땜) | 0 / 0 |
| P47 | 일반 실납 1.0mm [SME15510] (학교 실습실 대여 가능) | 납땜 기준만 | 학교 대여 / 불필요 (무납땜) | 0 / 0 |
| P52 | 열풍기 D26411 (학교 실습실 대여 가능) | 납땜 기준만 | 학교 대여 (집에 없음) / 불필요 (무납땜) | 0 / 0 |

## 2. 주문 링크 (앞으로 살 것, 구매처별)

링크를 누르면 상품 페이지가 열립니다. 고른 기준의 수량만 보고 주문하세요(0 = 그 기준에서는 사지 않음). 디바이스마트 링크·가격은 2026-11-06~10 조사 기준이라 주문 전에 품절·가격을 다시 확인합니다.

### 디바이스마트

| ID | 부품 | 상품 페이지 | 단가(원) | 수량 납땜 | 수량 무납땜 | 메모 |
|---|---|---|---:|---:|---:|---|
| P13 | 로커 스위치 KCD1-101A (ON/OFF, SPST) | [1790](https://www.devicemart.co.kr/goods/view?no=1790) | 330 | 1 | 0 | [납땜 기준만] 회로도 SW1(전원 스위치) / STEP4 뒤판 G 사각 구멍 |
| P14 | 패널형 퓨즈홀더 FH-303 (5×20mm 유리관용) | [4577](https://www.devicemart.co.kr/goods/view?no=4577) | 583 | 1 | 0 | [납땜 기준만] 회로도 F1(퓨즈홀더) / STEP4 뒤판 G 둥근 구멍 |
| P26 | NT DIY 열수축튜브 328세트 | [1320936](https://www.devicemart.co.kr/goods/view?no=1320936) | 4,290 | 1 | 0 | 배선 절연 |

## 3. 전체 BOM (80개 항목, 분류별)

필요·구매 = 납땜 기준 / 무납땜 기준. 단가는 VAT 포함. 상태가 두 기준에서 같으면 하나만 적었습니다.

### 제어 (7개)

| ID | 부품명 | 적용 | 필요 | 보유 | 구매 | 단가(원) | 상태 | 구매처 · 상품 페이지 |
|---|---|---|---:|---:|---:|---:|---|---|
| P01 | ESP32 DevKitC WROOM-32D V4 CP2102 개발보드 [CMODULE-40] (Happy House) | 공통 | 1 / 1 | 2 | 0 / 0 | 9,900 | 보유 | 디바이스마트 · [15313999](https://www.devicemart.co.kr/goods/view?no=15313999) |
| P02 | ESP32-DevKitC 터미널 확장보드 Push-in 타입 (ElectroCookie) | 공통 | 1 / 1 | 1 | 0 / 0 | 12,100 | 주문 완료 (11-11, 배송 대기) | 디바이스마트 · [15223173](https://www.devicemart.co.kr/goods/view?no=15223173) |
| P03 | 메탈 푸쉬 스위치 플랫형 16mm [HX16-B1] (모멘터리) | 공통 | 1 / 1 | 1 | 0 / 0 | 2,970 | 주문 완료 (11-11, 배송 대기) | 디바이스마트 · [1325010](https://www.devicemart.co.kr/goods/view?no=1325010) |
| P04 | 회로내장형 액티브 부저 모듈 [ONE005] | 공통 | 1 / 1 | 1 | 0 / 0 | 1,100 | 주문 완료 (11-11, 배송 대기) | 디바이스마트 · [10916337](https://www.devicemart.co.kr/goods/view?no=10916337) |
| P05 | 5mm LED 빨강 원통평면형 불투명 [5PR3HD19] | 공통 | 1 / 1 | 2 | 0 / 0 | 55 | 주문 완료 (11-11, 배송 대기) | 디바이스마트 · [3218](https://www.devicemart.co.kr/goods/view?no=3218) |
| P06 | 저항 220Ω 1/4W 1% [221F] | 공통 | 1 / 1 | 10 | 0 / 0 | 33 | 주문 완료 (11-11, 배송 대기) | 디바이스마트 · [2001](https://www.devicemart.co.kr/goods/view?no=2001) |
| P07 | Micro USB 5핀 데이터 케이블 1m | 공통 | 1 / 1 | 1 | 0 / 0 | 770 | 주문 완료 (11-11, 배송 대기) | 디바이스마트 · [32695](https://www.devicemart.co.kr/goods/view?no=32695) |

### 구동 (3개)

| ID | 부품명 | 적용 | 필요 | 보유 | 구매 | 단가(원) | 상태 | 구매처 · 상품 페이지 |
|---|---|---|---:|---:|---:|---:|---|---|
| P08 | 아두이노 4채널 5V 릴레이 모듈 [SZH-RLBG-012] | 공통 | 1 / 1 | 2 | 0 / 0 | 4,180 | 보유 | 디바이스마트 · [1327545](https://www.devicemart.co.kr/goods/view?no=1327545) |
| P09 | 수중펌프모터 [SZH-GNP155] | 공통 | 4 / 4 | 6 | 0 / 0 | 3,190 | 주문 완료 (11-11, 배송 대기) | 디바이스마트 · [1329770](https://www.devicemart.co.kr/goods/view?no=1329770) |
| P10 | 다이오드 1N4007 | 공통 | 4 / 4 | 10 | 0 / 0 | 22 | 보유 | 디바이스마트 · [3011](https://www.devicemart.co.kr/goods/view?no=3011) |

### 전원 (10개)

| ID | 부품명 | 적용 | 필요 | 보유 | 구매 | 단가(원) | 상태 | 구매처 · 상품 페이지 |
|---|---|---|---:|---:|---:|---:|---|---|
| P11 | 아답터 100~240V / 5V 4A [내경2.1~2.5/외경5.5mm] 전원 코드 일체형 | 공통 | 1 / 1 | 1 | 0 / 0 | 8,360 | 보유 | 디바이스마트 · [12233458](https://www.devicemart.co.kr/goods/view?no=12233458) |
| P12 | 터미널블럭 to DC 커넥터 (DC2.1 FEMALE) [SZH-LC002] | 공통 | 1 / 1 | 2 | 0 / 0 | 550 | 보유 | 디바이스마트 · [1321144](https://www.devicemart.co.kr/goods/view?no=1321144) |
| P13 | 로커 스위치 KCD1-101A (ON/OFF, SPST) | 납땜 기준만 | 1 / 0 | 0 | 1 / 0 | 330 | 구매 필요 / 불필요 (P73 하네스 스위치로 대체) | 디바이스마트 · [1790](https://www.devicemart.co.kr/goods/view?no=1790) |
| P14 | 패널형 퓨즈홀더 FH-303 (5×20mm 유리관용) | 납땜 기준만 | 1 / 0 | 0 | 1 / 0 | 583 | 구매 필요 / 불필요 (P74 인라인 퓨즈홀더로 대체) | 디바이스마트 · [4577](https://www.devicemart.co.kr/goods/view?no=4577) |
| P15 | 퓨즈 5×20 3A 250V (LB FUSE) | 공통 | 1 / 1 | 3 | 0 / 0 | 121 | 주문 완료 (11-11, 배송 대기) | 디바이스마트 · [4537](https://www.devicemart.co.kr/goods/view?no=4537) |
| P16 | 전해 커패시터 16V 1000µF 105℃ (SAMYOUNG, 10×16mm) | 공통 | 1 / 1 | 10 | 0 / 0 | 99 | 주문 완료 (11-11, 배송 대기) | 디바이스마트 · [29524](https://www.devicemart.co.kr/goods/view?no=29524) |
| P17 | (선택) 전해 커패시터 16V 100µF 105℃ (5×12mm) | 공통 | 1 / 1 | 10 | 0 / 0 | 33 | 주문 완료 (11-11, 배송 대기) | 디바이스마트 · [29522](https://www.devicemart.co.kr/goods/view?no=29522) |
| P18 | 레버형 전선연결 커넥터 8선 결합 PCT-418 (칩센) | 공통 | 3 / 3 | 4 | 0 / 0 | 352 | 주문 완료 (11-11, 배송 대기) | 디바이스마트 · [10911193](https://www.devicemart.co.kr/goods/view?no=10911193) |
| P73 | 하네스 스위치 (101A-5264) — KCD-101A 로커 스위치 + 리드선 200mm | 무납땜 기준만 | 0 / 1 | 1 | 0 / 0 | 4,730 | 해당 없음 / 주문 완료 (11-11, 배송 대기) | 디바이스마트 · [37135](https://www.devicemart.co.kr/goods/view?no=37135) |
| P74 | 퓨즈홀더 FH-201 (빨강, 라인홀더 — 선 달린 인라인형) | 무납땜 기준만 | 0 / 1 | 1 | 0 / 0 | 726 | 해당 없음 / 주문 완료 (11-11, 배송 대기) | 디바이스마트 · [35327](https://www.devicemart.co.kr/goods/view?no=35327) |

### 배선 (17개)

| ID | 부품명 | 적용 | 필요 | 보유 | 구매 | 단가(원) | 상태 | 구매처 · 상품 페이지 |
|---|---|---|---:|---:|---:|---:|---|---|
| P19 | AWG20 2P 10M (검정, 빨강) | 공통 | 1 / 1 | 1 | 0 / 0 | 10,340 | 보유 | 디바이스마트 · [13003174](https://www.devicemart.co.kr/goods/view?no=13003174) |
| P20 | 점퍼 케이블 40P (F/F) | 공통 | 1 / 1 | 1 | 0 / 0 | 1,100 | 보유 | 디바이스마트 · [32284](https://www.devicemart.co.kr/goods/view?no=32284) |
| P21 | 점퍼 케이블 40P (M/F) | 공통 | 1 / 1 | 1 | 0 / 0 | 1,100 | 보유 | 디바이스마트 · [1113721](https://www.devicemart.co.kr/goods/view?no=1113721) |
| P22 | 점퍼 케이블 40P (M/M) | 공통 | 1 / 1 | 1 | 0 / 0 | 1,100 | 보유 | 디바이스마트 · [1113722](https://www.devicemart.co.kr/goods/view?no=1113722) |
| P23 | 브레드보드 830핀 MB-102 [SZH-BBAD-002] | 공통 | 1 / 1 | 2 | 0 / 0 | 1,540 | 보유 | 디바이스마트 · [1322408](https://www.devicemart.co.kr/goods/view?no=1322408) |
| P24 | UL1007 래핑와이어 22AWG 10M 노랑 [VLT-CAB160] | 공통 | 1 / 1 | 1 | 0 / 0 | 3,630 | 주문 완료 (11-11, 배송 대기) | 디바이스마트 · [15960649](https://www.devicemart.co.kr/goods/view?no=15960649) |
| P25 | 열 수축 솔더 슬리브 1.0SQ [SZH-CA002] | 납땜 기준만 | 8 / 0 | 10 | 0 / 0 | 330 | 보유 / 보유 (무납땜 기준에서는 안 씀) | 디바이스마트 · [12507090](https://www.devicemart.co.kr/goods/view?no=12507090) |
| P26 | NT DIY 열수축튜브 328세트 | 공통 | 1 / 1 | 0 | 1 / 0 | 4,290 | 구매 필요 / 선택(무납땜에서는 효과 작음) | 디바이스마트 · [1320936](https://www.devicemart.co.kr/goods/view?no=1320936) |
| P27 | 케이블타이 100mm 1000개 (CableMate UN-100MB 블랙) | 공통 | 1 / 1 | 1 | 0 / 0 | 3,740 | 주문 완료 (11-11, 배송 대기) | 디바이스마트 · [1215043](https://www.devicemart.co.kr/goods/view?no=1215043) |
| P28 | 케이블타이 고정용 접착 마운트 20×20mm [SZ-XL015] | 공통 | 10 / 10 | 10 | 0 / 0 | 132 | 주문 완료 (11-11, 배송 대기) | 디바이스마트 · [1382746](https://www.devicemart.co.kr/goods/view?no=1382746) |
| P62 | UL1007 래핑와이어 22AWG 10M 검정 [VLT-CAB159] | 공통 | 1 / 1 | 1 | 0 / 0 | 3,630 | 주문 완료 (11-11, 배송 대기) | 디바이스마트 · [15960648](https://www.devicemart.co.kr/goods/view?no=15960648) |
| P63 | UL1007 래핑와이어 22AWG 10M 빨강 [VLT-CAB161] | 공통 | 1 / 1 | 1 | 0 / 0 | 3,630 | 주문 완료 (11-11, 배송 대기) | 디바이스마트 · [15960650](https://www.devicemart.co.kr/goods/view?no=15960650) |
| P75 | 3선 결합 탈피형 커넥터 PCT-413 (칩센) — 3구 정션형 | 무납땜 기준만 | 0 / 8 | 10 | 0 / 0 | 220 | 해당 없음 / 주문 완료 (11-11, 배송 대기) | 디바이스마트 · [1290839](https://www.devicemart.co.kr/goods/view?no=1290839) |
| P76 | 2선 결합 탈피형 커넥터 PCT-412 (칩센) — 1:1 이음 | 무납땜 기준만 | 0 / 8 | 10 | 0 / 0 | 132 | 해당 없음 / 주문 완료 (11-11, 배송 대기) | 디바이스마트 · [1290838](https://www.devicemart.co.kr/goods/view?no=1290838) |
| P77 | 5선 결합 탈피형 커넥터 PCT-415 (칩센) — 앞판 GND 허브 | 무납땜 기준만 | 0 / 1 | 1 | 0 / 0 | 253 | 해당 없음 / 주문 완료 (11-11, 배송 대기) | 디바이스마트 · [1290840](https://www.devicemart.co.kr/goods/view?no=1290840) |
| P78 | 터미널 압착단자 케이블 2.8mm [CG0731] (30cm) | 무납땜 기준만 | 0 / 2 | 2 | 0 / 0 | 330 | 해당 없음 / 주문 완료 (11-11, 배송 대기) | 디바이스마트 · [15306311](https://www.devicemart.co.kr/goods/view?no=15306311) |
| P79 | 전기 절연 테이프 19mm×10m 2개입 | 무납땜 기준만 | 0 / 1 | 1 | 0 / 0 | 1,000 | 해당 없음 / 구매 완료 (11-11) | 다이소 · [24482](https://www.daisomall.co.kr/pd/pdr/SCR_PDR_0001?pdNo=24482) |

### 배관 (5개)

| ID | 부품명 | 적용 | 필요 | 보유 | 구매 | 단가(원) | 상태 | 구매처 · 상품 페이지 |
|---|---|---|---:|---:|---:|---:|---|---|
| P29 | 실리콘 튜브 1M 내경 5mm (외경 7mm) [K11168275] | 공통 | 3 / 3 | 8 | 0 / 0 | 1,870 | 보유 | 디바이스마트 · [14115487](https://www.devicemart.co.kr/goods/view?no=14115487) |
| P30 | 실리콘 튜브 1M 내경 4mm (외경 6mm) [K11168264] | 공통 | 1 / 1 | 5 | 0 / 0 | 1,760 | 보유 | 디바이스마트 · [14115486](https://www.devicemart.co.kr/goods/view?no=14115486) |
| P31 | 체크밸브 JGB32PPS (JG) | 공통 | 4 / 4 | 5 | 0 / 0 | 6,050 | 주문 완료 (11-11, 배송 대기) | 디바이스마트 · [12519260](https://www.devicemart.co.kr/goods/view?no=12519260) |
| P32 | 다이소 직사각 저장 용기 970ml (품번 1069852, (주)해창) | 공통 | 4 / 4 | 5 | 0 / 0 | 1,000 | 구매 완료 (11-11) | 다이소 · [1069852](https://www.daisomall.co.kr/pd/pdr/SCR_PDR_0001?pdNo=1069852) |
| P33 | 실리콘 원형 코스터 세트 2개입 (지름 약 10cm) — 드립 매트 | 공통 | 1 / 1 | 1 | 0 / 0 | 1,000 | 구매 완료 (11-11) | 다이소 · [1038323](https://www.daisomall.co.kr/pd/pdr/SCR_PDR_0001?pdNo=1038323) |

### 외형 (15개)

| ID | 부품명 | 적용 | 필요 | 보유 | 구매 | 단가(원) | 상태 | 구매처 · 상품 페이지 |
|---|---|---|---:|---:|---:|---:|---|---|
| P34 | 포맥스(PVC 발포보드) 5T 흰색 600×900mm | 공통 | 3 / 3 | 3 | 0 / 0 |  | 구매 완료 | 구매 완료 — 판매처는 영수증 참고 |
| P35 | 화신박스 단자함 EG AGH-152010 (150×200×100, 플라스틱 속판 포함) | 공통 | 1 / 1 | 1 | 0 / 0 | 12,320 | 주문 완료 (11-11, 배송 대기) | 디바이스마트 · [14003437](https://www.devicemart.co.kr/goods/view?no=14003437) |
| P36 | L자 꺾쇠(소형, 약 25mm) | 둘 다 불필요 | 0 / 0 | 0 | 0 / 0 |  | 불필요 (출력 브래킷 01로 대체) | 다이소/철물점 |
| P37 | 스텐 둥근머리 십자볼트 M3×10 | 공통 | 24 / 24 | 25 | 0 / 0 | 22 | 주문 완료 (11-11, 배송 대기) | 디바이스마트 · [10912297](https://www.devicemart.co.kr/goods/view?no=10912297) |
| P38 | 육각 너트(스텐) M3 | 공통 | 24 / 24 | 25 | 0 / 0 | 22 | 주문 완료 (11-11, 배송 대기) | 디바이스마트 · [10893596](https://www.devicemart.co.kr/goods/view?no=10893596) |
| P39 | M3 알루미늄 서포트 Female 10mm [SZH-ZR059] | 공통 | 4 / 4 | 4 | 0 / 0 | 462 | 주문 완료 (11-11, 배송 대기) | 디바이스마트 · [1382352](https://www.devicemart.co.kr/goods/view?no=1382352) |
| P40 | 둥근머리 십자볼트(니켈) M3×6 | 공통 | 8 / 8 | 10 | 0 / 0 | 11 | 주문 완료 (11-11, 배송 대기) | 디바이스마트 · [10912222](https://www.devicemart.co.kr/goods/view?no=10912222) |
| P41 | 고무발 S-1 18×10H | 공통 | 4 / 4 | 10 | 0 / 0 | 110 | 주문 완료 (11-11, 배송 대기) | 디바이스마트 · [14882214](https://www.devicemart.co.kr/goods/view?no=14882214) |
| P42 | 순간접착제 LOCTITE 401 20g | 공통 | 1 / 1 | 1 | 0 / 0 | 4,400 | 주문 완료 (11-11, 배송 대기) | 디바이스마트 · [9108](https://www.devicemart.co.kr/goods/view?no=9108) |
| P43 | 핫멜트스틱(대) 10개 | 공통 | 1 / 1 | 1 | 0 / 0 | 2,200 | 주문 완료 (11-11, 배송 대기) | 디바이스마트 · [13187167](https://www.devicemart.co.kr/goods/view?no=13187167) |
| P44 | 케이블 그로밋(고무 부싱) — Ø20 구멍용 2개 + Ø12 구멍용 1개 | 둘 다 불필요 | 0 / 0 | 0 | 0 / 0 |  | 불필요 (출력 그로밋 04·05로 대체) | 철물점/온라인(확인 필요) |
| P45 | 원형 네오디뮴 자석 13mm 3개입 (다이소) | 공통 | 1 / 1 | 1 | 0 / 0 | 1,000 | 구매 완료 (11-11) | 다이소 · [1057293](https://www.daisomall.co.kr/pd/pdr/SCR_PDR_0001?pdNo=1057293) |
| P64 | Coms 사각 벨크로테이프 10조 (접착식 양면 찍찍이) 55×35mm [T9162] | 공통 | 1 / 1 | 1 | 0 / 0 | 1,540 | 주문 완료 (11-11, 배송 대기) | 디바이스마트 · [15810228](https://www.devicemart.co.kr/goods/view?no=15810228) |
| P71 | 오공 초강력 폼 양면테이프 투명 18mm×2m (두께 1mm) | 공통 | 1 / 1 | 1 | 0 / 0 | 2,000 | 구매 완료 (11-11) | 다이소 · [1019760](https://www.daisomall.co.kr/pd/pdr/SCR_PDR_0001?pdNo=1019760) |
| P80 | 자석용 보조 설치판 5.5×3.5cm 3개입 (다이소, 접착식 철판) | 공통 | 1 / 1 | 1 | 0 / 0 | 1,000 | 구매 완료 (11-11) | 다이소 · [1050101](https://www.daisomall.co.kr/pd/pdr/SCR_PDR_0001?pdNo=1050101) |

### 3D 프린팅 (1개)

| ID | 부품명 | 적용 | 필요 | 보유 | 구매 | 단가(원) | 상태 | 구매처 · 상품 페이지 |
|---|---|---|---:|---:|---:|---:|---|---|
| P70 | 3D 프린팅 출력 부품 7종 24개 (PETG 흰색) — 업로드 묶음 plate_A(브래킷 14) + plate_B(나머지 10) | 공통 | 1 / 1 | 0 | 0 / 0 |  | 주문 완료 (배송 예정 11/16) | 3DFARM · [상품 페이지](https://3dfarm.co.kr/) |

### 공구 (10개)

| ID | 부품명 | 적용 | 필요 | 보유 | 구매 | 단가(원) | 상태 | 구매처 · 상품 페이지 |
|---|---|---|---:|---:|---:|---:|---|---|
| P46 | 실습용 납땜세트B (학교 실습실 대여 가능) | 납땜 기준만 | 1 / 0 | 0 | 0 / 0 | 26,400 | 학교 대여 (집에 없음) / 불필요 (무납땜) | 디바이스마트 · [10894366](https://www.devicemart.co.kr/goods/view?no=10894366) |
| P47 | 일반 실납 1.0mm [SME15510] (학교 실습실 대여 가능) | 납땜 기준만 | 1 / 0 | 0 | 0 / 0 | 3,190 | 학교 대여 / 불필요 (무납땜) | 디바이스마트 · [1171334](https://www.devicemart.co.kr/goods/view?no=1171334) |
| P48 | 디지털 멀티미터 M300 | 공통 | 1 / 1 | 1 | 0 / 0 | 8,800 | 주문 완료 (11-11, 배송 대기) | 디바이스마트 · [10917721](https://www.devicemart.co.kr/goods/view?no=10917721) |
| P49 | 와이어 스트리퍼 TU-2022 | 공통 | 1 / 1 | 1 | 0 / 0 | 6,600 | 주문 완료 (11-11, 배송 대기) | 디바이스마트 · [1330598](https://www.devicemart.co.kr/goods/view?no=1330598) |
| P50 | 니퍼 TU-C01 (학교 실습실 대여 가능) | 공통 | 1 / 1 | 0 | 0 / 0 | 3,190 | 학교 대여 | 디바이스마트 · [1287084](https://www.devicemart.co.kr/goods/view?no=1287084) |
| P51 | 글루건 DY-3000 60W (학교 실습실 대여 가능) | 공통 | 1 / 1 | 0 | 0 / 0 | 8,360 | 학교 대여 | 디바이스마트 · [10931307](https://www.devicemart.co.kr/goods/view?no=10931307) |
| P52 | 열풍기 D26411 (학교 실습실 대여 가능) | 납땜 기준만 | 1 / 0 | 0 | 0 / 0 | 68,200 | 학교 대여 (집에 없음) / 불필요 (무납땜) | 디바이스마트 · [12171271](https://www.devicemart.co.kr/goods/view?no=12171271) |
| P53 | 헬리컬 스텝드릴 4~35mm [K40843729] (학교 실습실 대여 가능) | 공통 | 1 / 1 | 0 | 0 / 0 | 26,070 | 학교 대여 | 디바이스마트 · [14117356](https://www.devicemart.co.kr/goods/view?no=14117356) |
| P54 | 커터칼(대)·쇠자(60cm)·커팅매트 (학교 실습실 대여 가능) | 공통 | 1 / 1 | 0 | 0 / 0 |  | 학교 대여 | 다이소/화방 |
| P72 | [건전지] 23A 12V 알카라인 1알 (멀티미터 M300용) | 공통 | 1 / 1 | 1 | 0 / 0 | 770 | 주문 완료 (11-11, 배송 대기) | 디바이스마트 · [10921874](https://www.devicemart.co.kr/goods/view?no=10921874) |

### 선택 (9개)

| ID | 부품명 | 적용 | 필요 | 보유 | 구매 | 단가(원) | 상태 | 구매처 · 상품 페이지 |
|---|---|---|---:|---:|---:|---:|---|---|
| P55 | 연동(페리스탈틱) 펌프 DFRobot Gravity Digital Peristaltic Pump [DFR0523] | 선택 | 4 / 4 | 0 | 0 / 0 | 45,540 | 선택(구매 안 함) | 디바이스마트 · [1377341](https://www.devicemart.co.kr/goods/view?no=1377341) |
| P56 | HX711 로드셀 24비트 AD 컨버터 모듈 [SZH-SSBH-016] | 선택 | 1 / 1 | 0 | 0 / 0 | 1,870 | 선택(구매 안 함) | 디바이스마트 · [1327440](https://www.devicemart.co.kr/goods/view?no=1327440) |
| P57 | 4선 로드셀 1kg [VLT-LCS002] | 선택 | 1 / 1 | 0 | 0 / 0 | 7,260 | 선택(구매 안 함) | 디바이스마트 · [15961057](https://www.devicemart.co.kr/goods/view?no=15961057) |
| P58 | MOSFET GPIO 보드 4채널 YYNMOS-4 [SZH-YY012] (AF60N03) | 선택 | 1 / 1 | 0 | 0 / 0 | 19,360 | 선택(구매 안 함) | 디바이스마트 · [13908386](https://www.devicemart.co.kr/goods/view?no=13908386) |
| P65 | (선택·시음 전 교체용) 식품용 실리콘 튜브 내경5/외경7mm (FDA 또는 LFGB 표기), 1m 단위 | 선택 | 3 / 3 | 0 | 0 / 0 |  | 선택(구매 안 함) | 국내 쇼핑몰·실험용품점 (디바이스마트 미취급, 확인 필요) |
| P66 | (선택·시음 전 교체용) 식품용 실리콘 튜브 내경4/외경6mm (FDA 또는 LFGB 표기), 1m 단위 | 선택 | 1 / 1 | 0 | 0 / 0 |  | 선택(구매 안 함) | 국내 쇼핑몰·실험용품점 (디바이스마트 미취급, 확인 필요) |
| P67 | (선택·시음 전 교체용) 식품용 체크밸브 — 액체용, 내경4 튜브용 바브 (P31과 같은 규격) | 선택 | 4 / 4 | 0 | 0 / 0 |  | 선택(구매 안 함) | 국내 쇼핑몰·실험용품점 (디바이스마트 미취급, 확인 필요) |
| P68 | (선택·조립 방식) 둥근머리 십자볼트 머신스크류 M3×15 (철, 노란색) | 선택 | 2 / 2 | 0 | 0 / 0 | 11 | 선택(구매 안 함) | 디바이스마트 · [34252](https://www.devicemart.co.kr/goods/view?no=34252) |
| P69 | (선택·조립 방식) 자석 캐치 추가분 — 상판 C 고정 대안 (P45와 같은 제품) | 선택 | 4 / 4 | 0 | 0 / 0 | 1,000 | 선택(구매 안 함) | 다이소 · [1057293](https://www.daisomall.co.kr/pd/pdr/SCR_PDR_0001?pdNo=1057293) |

### 미사용 (3개)

| ID | 부품명 | 적용 | 필요 | 보유 | 구매 | 단가(원) | 상태 | 구매처 · 상품 페이지 |
|---|---|---|---:|---:|---:|---:|---|---|
| P59 | SparkFun 솔레노이드 5V (small) [ROB-11015] | 미사용 | 0 / 0 | 4 | 0 / 0 | 14,410 | 미사용 | 디바이스마트 · [1313586](https://www.devicemart.co.kr/goods/view?no=1313586) |
| P60 | 열 수축 솔더 슬리브 6.0SQ [SZH-CA004] | 미사용 | 0 / 0 | 10 | 0 / 0 | 440 | 미사용 | 디바이스마트 · [12507092](https://www.devicemart.co.kr/goods/view?no=12507092) |
| P61 | DC 플러그 NT10-AF35 (DC 전원 변환 젠더, 수 5.5/2.1mm, 25cm) | 미사용 | 0 / 0 | 1 | 0 / 0 | 1,100 | 미사용 | 디바이스마트 · [1078077](https://www.devicemart.co.kr/goods/view?no=1078077) |

## 4. 이미 결제한 것 (2학기, 두 기준 공통)

| 날짜 | 품목 | 구매처 | 수량 | 금액(원) | 상태 |
|---|---|---|---|---:|---|
| 11-10 | 3D 프린팅 출력 부품 (plate_A 브래킷 01 ×14 + plate_B 나머지 02~07 ×10) | 3DFARM | 2판 | 78,700 | 주문 완료 (배송 예정 11/16) |
| 11-10 | 포맥스 5T 흰색 | 포맥스 판매처 | 3장 | 43,000 | 구매 완료 |
| 11-11 | 디바이스마트 주문 — 무납땜 기준 35품목 | 디바이스마트 | 35품목 | 102,528 | 주문 완료 (11-11, 배송 대기) |
| 11-11 | 다이소 — 무납땜 기준 6품목 | 다이소 | 6품목 | 14,000 | 구매 완료 (11-11) |
| | **합계** | | | **238,228** | |

### 디바이스마트 주문 — 무납땜 기준 35품목 (11-11) — 무납땜 BOM 계획 대비

거래명세서의 품명·수량·단가(VAT 별도) 그대로입니다. 거래명세서(2026-11-11): 상품 90,480원(VAT 별도) + 배송비 3,000원 → 공급가액 93,207 + 부가세 9,321 = 결제 102,528원(카드). 거래명세서 원본은 개인정보가 있어 저장소에 올리지 않고 팀이 보관(정산용).

| No | ID | 품명 | 수량 | 단가(원) VAT 별도 | 금액(원) VAT 포함 | 무납땜 BOM 계획 대비 |
|---:|---|---|---:|---:|---:|---|
| 1 | P02 | ESP32 확장보드 터미널쉴드(Push-in 타입) | 1 | 11,000 | 12,100 | BOM 계획과 같음 |
| 2 | P03 | 메탈 푸쉬 스위치 플랫형 [HX16-B1] | 1 | 2,700 | 2,970 | BOM 계획과 같음 |
| 3 | P04 | 회로내장형 액티브 부저 모듈 [ONE005] | 1 | 1,000 | 1,100 | BOM 계획과 같음 |
| 4 | P05 | [5PR3HD19] 원통평면형- 5파이 불투명 LED(빨강) | 2 | 50 | 110 | 단가 계획 61 → 실제 55원(VAT 포함) |
| 5 | P06 | 1/4W 1% Axial Resistor 221F (220Ω) | 10 | 30 | 330 | BOM 계획과 같음 |
| 6 | P07 | Micro USB 5P Cable(1M) | 1 | 700 | 770 | BOM 계획과 같음 |
| 7 | P09 | 수중펌프모터 [SZH-GNP155] | 2 | 2,900 | 6,380 | BOM 계획과 같음 |
| 8 | P15 | 퓨즈 5x20-3A | 3 | 110 | 363 | BOM 계획과 같음 |
| 9 | P16 | E/C 16V 1000uF (105℃)/10X16 | 10 | 90 | 990 | BOM 계획과 같음 |
| 10 | P17 | E/C 16V 100uF (105℃)/5X12 | 10 | 30 | 330 | BOM 계획과 같음 |
| 11 | P18 | 8선 결합 탈피형 커넥터 PCT-418 | 4 | 320 | 1,408 | BOM 계획과 같음 |
| 12 | P73 | 하네스 스위치 (101A-5264) | 1 | 4,300 | 4,730 | BOM 계획과 같음 |
| 13 | P74 | 퓨즈홀더 FH-201 (빨강색) | 1 | 660 | 726 | BOM 계획과 같음 |
| 14 | P24 | UL1007 래핑와이어 22AWG 노랑 10M [VLT-CAB160] | 1 | 3,300 | 3,630 | BOM 계획과 같음 |
| 15 | P27 | 케이블메이트 케이블타이, UN-100MB [소/100mm] [블랙] [1000개] | 1 | 3,400 | 3,740 | BOM 계획과 같음 |
| 16 | P28 | 케이블타이 고정용 마운트 20x20mm [SZ-XL015] | 10 | 120 | 1,320 | 단가 계획 145 → 실제 132원(VAT 포함) |
| 17 | P62 | UL1007 래핑와이어 22AWG 검정 10M [VLT-CAB159] | 1 | 3,300 | 3,630 | BOM 계획과 같음 |
| 18 | P63 | UL1007 래핑와이어 22AWG 빨강 10M [VLT-CAB161] | 1 | 3,300 | 3,630 | BOM 계획과 같음 |
| 19 | P75 | PCT-413 | 10 | 200 | 2,200 | BOM 계획과 같음 |
| 20 | P76 | 2선 결합 탈피형 커넥터 PCT-412 | 10 | 120 | 1,320 | BOM 계획과 같음 |
| 21 | P77 | PCT-415 | 1 | 230 | 253 | BOM 계획과 같음 |
| 22 | P31 | [JG] 체크밸브 : JGB32PPS | 1 | 5,500 | 6,050 | BOM 계획과 같음 |
| 23 | P35 | 화신박스 단자함 EG AGH-152010 | 1 | 11,200 | 12,320 | BOM 계획과 같음 |
| 24 | P37 | 스텐 둥근머리 십자볼트 M3x10 | 25 | 20 | 550 | 수량 계획 30 → 실제 25 |
| 25 | P38 | 육각 너트 (스텐) M3 | 25 | 20 | 550 | 수량 계획 30 → 실제 25 |
| 26 | P39 | M3 알루미늄 서포트 Female 10mm [SZH-ZR059] | 4 | 420 | 1,848 | 단가 계획 508 → 실제 462원(VAT 포함) |
| 27 | P40 | 둥근머리 십자볼트 (니켈) M3x6 | 10 | 10 | 110 | BOM 계획과 같음 |
| 28 | P41 | 고무발/라디오발/S-1/18*10H | 10 | 100 | 1,100 | BOM 계획과 같음 |
| 29 | P42 | 순간접착제 LOCTITE 401 20g | 1 | 4,000 | 4,400 | BOM 계획과 같음 |
| 30 | P43 | 핫멜트스틱(대) 10개 | 1 | 2,000 | 2,200 | BOM 계획과 같음 |
| 31 | P64 | Coms 사각 벨크로테이프 10개입 양면 찍찍이 55x35mm [T9162] | 1 | 1,400 | 1,540 | BOM 계획과 같음 |
| 32 | P48 | 디지털 멀티미터 M300 | 1 | 8,000 | 8,800 | BOM 계획과 같음 |
| 33 | P49 | 와이어 스트리퍼 TU-2022 | 1 | 6,000 | 6,600 | BOM 계획과 같음 |
| 34 | P72 | [건전지] 23A [41mAh/1알] | 1 | 700 | 770 | 단가 계획 700 → 실제 770원(VAT 포함) |
| 35 | P78 | 터미널 압착단자 케이블 [1EA] [CG0731] [2.8mm] (옵션 CG0731 2.8mm 흑색) | 2 | 300 | 660 | BOM 계획과 같음 |
| | | 배송비 | | | 3,000 | 거래명세서 배송비 칸: 1번 줄 0원 · 35번 줄(CG0731, P78) 3,000원(VAT 포함) — CG0731만 따로 배송되는 상품으로 보임 |
| | | **합계** | | | **102,528** | 공급가액 93,207 + 부가세 9,321 |

### 다이소 — 무납땜 기준 6품목 (11-11) — 무납땜 BOM 계획 대비

결제 14,000원 = 물건 11,000원 + 배송비 3,000원(2026-11-11 사용자 확인). 품목별 금액은 다이소몰 판매가로 나눔.

| No | ID | 품명 | 수량 | 단가(원) VAT 포함 | 금액(원) VAT 포함 | 무납땜 BOM 계획 대비 |
|---:|---|---|---:|---:|---:|---|
| 1 | P32 | 직사각 저장 용기 970ml (다이소 1069852) | 5 | 1,000 | 5,000 | BOM 계획과 같음 |
| 2 | P33 | 실리콘 원형 코스터 세트 2개입 (다이소 1038323) | 1 | 1,000 | 1,000 | BOM 계획과 같음 |
| 3 | P45 | 원형 네오디뮴 자석 13mm 3개입 (다이소 1057293) | 1 | 1,000 | 1,000 | BOM 계획과 같음 |
| 4 | P80 | 자석용 보조 설치판 3개입 (다이소 1050101) | 1 | 1,000 | 1,000 | BOM 계획과 같음 |
| 5 | P71 | 오공 초강력 폼 양면테이프 18mm×2m (다이소 1019760) | 1 | 2,000 | 2,000 | BOM 계획과 같음 |
| 6 | P79 | 전기 절연 테이프 19mm×10m 2개입 (다이소 24482) | 1 | 1,000 | 1,000 | BOM 계획과 같음 |
| | | 배송비 | | | 3,000 | 다이소 배송비(택배) — 사용자 확인 |
| | | **합계** | | | **14,000** |  |

## 5. 확인할 것 (공통)

- **포맥스 3장**: 600×900 통판이면 직접 재단합니다(커터칼·쇠자 60cm 이상·커팅매트). 맞춤 재단이면 할 일이 없습니다.
- **용기 5개(11-11 구매)**: 4개가 같은 제품인지, 입구가 60mm 이상이고 펌프가 들어가 바닥에 눕는지, 펌프 리드가 입구 위로 약 5cm 이상 나오는지 집에서 확인합니다(제작가이드 2.4). TARK 용기는 취소·환불합니다.
- **디바이스마트 물건이 오면**(11-11 주문) 거래명세서와 수량을 하나씩 맞춰 봅니다(특히 볼트·너트 25개, CG0731 2개, PCT-413·412 10개씩). 모두 왔으면 `bom_variants.json` purchases의 상태를 '구매 완료'로 바꾸고 다시 만듭니다.
- **볼트 P37·너트 P38은 25개씩**(필요 24) — 예비가 1개뿐이니 지퍼백에 따로 보관합니다.
- 단가: 11-11에 산 부품은 거래명세서·구매 금액으로 바꿨습니다. 아직 사지 않은 부품(납땜 기준에서만 더 사는 것·선택 품목)의 단가는 조사 시점(2026-11-06~10) 값입니다.
- 재원(1학기 잔액 이월 38,600원 · 예선 참가 지원금 50,000원 · 캡스톤디자인Ⅱ 실습비)은 아직 확인 전입니다. `예산` 시트 노란 칸을 고치면 판단이 다시 계산됩니다.
- 제작가이드(2026-11-10, `guide/제작가이드_납땜기준.md` · `제작가이드_무납땜기준.md`) 2장 부품표는 이 BOM과 같은 기준입니다. 예전 `조립가이드.md`(2026-11-06)의 부품표는 옛 기준(P32 용기·P36·P44)입니다.
- **TARK 용기 환불액**: 11,000원에 배송비가 들었으면 환불이 적을 수 있습니다. 확정되면 차액을 `지출_완료` 시트에 지출로 넣습니다.

---
*이 문서와 `BOM.xlsx`는 `research/canonical_bom.json`·`research/BOM_원본_20261106.xlsx`(2026-11-06)를 원본으로 `research/make_bom_master.py`(설정 `research/bom_variants.json`)가 만들었습니다. 기준별 BOM은 `research/make_boms.py`.*
