paperji/smart-bartender/hardware/BOM_무납땜기준.md

# BOM — 무납땜 기준 · 사용자의 감정 및 취향 분석 기반 AI 맞춤형 음료 및 칵테일 배합 메이커

> 팀 홍당무 · 작성 2026-11-11 · 원본 [`research/BOM_원본_20261106.md`](research/BOM_원본_20261106.md)(2026-11-06)를 최신화한 판입니다. 다른 기준은 [`BOM_납땜기준.md`](BOM_납땜기준.md), 두 기준을 한 표로 비교한 통합판은 [`BOM.md`](BOM.md).
> 엑셀: `BOM_무납땜기준.xlsx` (시트: 요약 / 주문_링크 / BOM_전체 / 추가구매_의뢰서용 / 지출_완료 / 보유_미사용 / 선택_업그레이드 / 예산). 이 문서와 엑셀은 같은 스크립트로 만들어 숫자가 같습니다.

## 0. 한눈에 보기

- **2026-11-11 이 기준의 부품을 모두 샀습니다**(디바이스마트 35품목 102,528원 · 다이소 6품목 14,000원 — 두 주문 모두 배송비 3,000원씩 포함). 앞으로 살 것은 없고, 산 내역은 `지출_완료` 시트에 부품별로 있습니다.
- **인두기·열풍기 없이** 집에서 조립하는 기준입니다. 납땜 20~23곳과 솔더 슬리브 8곳을 **레버 커넥터**(꽂고 레버만 내리는 이음)와 **선이 미리 달린 부품**으로 바꿨습니다.
- 인두기(P46)·실납(P47)·열풍기(P52)는 필요 없습니다. 대신 피복 벗기기(와이어 스트리퍼)와 멀티미터는 집에 있어야 해서 구매로 넣었습니다.
- 구멍 뚫기(드릴·스텝드릴)는 무납땜이어도 남습니다. 학교에서 빌리거나 손공구(예산 시트)로 합니다.
- **앞으로 살 것 ① 디바이스마트: 없음** (이 기준의 디바이스마트 부품은 모두 샀습니다 — 아래 '이미 결제한 것')
- **앞으로 살 것 ② 다이소·철물점·기타: 없음**
- **이미 결제한 것: 238,228원** — 3D 프린팅 출력 부품 (plate_A 브래킷 01 ×14 + plate_B 나머지 02~07 ×10) 78,700원 · 포맥스 5T 흰색 43,000원 · 디바이스마트 주문 — 무납땜 기준 35품목 102,528원 · 다이소 — 무납땜 기준 6품목 14,000원
- 환불 예정(합계 미포함): 다이소 TARK 직사각 간편 용기 1L 3개입 화이트 (품번 58801) 11,000원 (취소·환불 예정)
- 2학기 전체(이미 결제 + 앞으로 살 것): **238,228원** (선택 구매·공구 구매·가격 미확인 품목 제외)

## 1. 원본 BOM에서 바뀐 점

- **용기 P32**: 처음 산 다이소 TARK 1L(약 165×120×80mm)는 폭 120mm라 W420 본체에 안 들어가 취소하고, 기준(좌우 ≤95·앞뒤 ≤135·높이 ≤170)을 상품 페이지로 확인한 **다이소 직사각 저장 용기 970ml**(약 105×80×150, 1,000원)로 바꿨습니다. 후보 셋(970ml 직사각 · 900ml 원형 · 800ml 사각) 중 단면이 가장 넓고 낮아 액면 변화가 가장 작습니다. 4개 + 예비 1.
- **3D 프린팅 출력 부품 P70** 추가(주문 완료 — 결제 78,700원(견적 90,000원보다 적음), 11/16 배송 예정). 그래서 **L자 꺾쇠 P36·고무 그로밋 P44는 사지 않고**, 포맥스 노즐 판 M1·M2도 자르지 않습니다.
- **포맥스 P34**: 3장 구매 완료(43,000원).
- **멀티미터 P48**은 집에서 STEP1부터 쓰므로 학교 대여 대신 구매로 바꾸고, 전지(P72, 디바이스마트 주문에 함께)를 추가했습니다.
- **폼 양면테이프 P71** 추가(앞면 베젤을 뗄 수 있게 붙임).
- 이미 결제한 돈은 `지출_완료` 시트로 따로 모으고, `예산` 시트를 '이미 결제 / 앞으로 살 것'으로 나눴습니다. TARK 용기 11,000원은 환불 예정으로 따로 적었습니다.
- **다이소 물건 링크**(2026-11-10 다이소몰 확인): 드립 트레이 P33 → 실리콘 원형 코스터 2개입(1038323), 자석 캐치 P45 → 네오디뮴 자석 13mm 3개입(1057293) + 접착식 철판 P80(1050101, 새 품목), 폼 양면테이프 P71 → 오공 18mm×2m 두께 1mm(1019760). 23A 전지 P72는 디바이스마트(10921874)로 옮김.
- **2026-11-11 무납땜 기준 부품 구매**: 디바이스마트 35품목 — 거래명세서를 BOM 무납땜 주문 목록과 대조해 품목이 모두 일치, 차이는 볼트 P37·너트 P38 30→25개(필요 24), 단가 P05·P28·P39가 BOM보다 낮고 23A 전지 P72는 VAT 포함 770원 — 결제 102,528원(배송비 3,000원 포함). 다이소 6품목 14,000원(물건 11,000원 + 배송비 3,000원). 산 부품은 보유 수량에 더하고 `지출_완료` 시트에 부품별로 적었습니다(설정 `bom_variants.json`의 purchases). 고정 방식은 기본(전장 박스 벨크로 P64 · 상판 캡티브 너트)으로 정해져 볼트 P68·자석 P69는 사지 않았습니다.
- **무납땜으로 바꾼 부품**: 로커 스위치 P13 → 선 달린 하네스 스위치 P73, 패널 퓨즈홀더 P14 → 선 달린 인라인 퓨즈홀더 P74, 솔더 슬리브 P25·다이오드 납땜 → 3구 레버 커넥터 P75, 선 이음 → 2구 레버 커넥터 P76, 앞판 GND 공통선 → 5구 레버 커넥터 P77, 버튼 단자 → 2.8mm 단자 달린 선 P78, 수축튜브(열) → 절연테이프 P79.
- **필요 없어진 공구**: 인두기 P46 · 실납 P47 · 열풍기 P52. 수축튜브 P26은 선택으로 바꿈(열을 안 씀). 와이어 스트리퍼 P49(TU-2022)·멀티미터 P48 구매는 두 기준 공통입니다.
- 조립 순서는 `guide/제작가이드_무납땜기준.md`를 따릅니다. 아래 표의 방법이 그 가이드의 STEP3·4·9·10에 그대로 들어 있습니다.

## 2. 무납땜 접속 방법 (원래 납땜하던 곳)

| 접속·작업 | 방법 | 쓰는 부품 · 공구 |
|---|---|---|
| STEP3 다이오드 8곳 + 펌프 리드 이음 8곳 (펌프 4개) | 뚜껑 위에서 **3구 레버 커넥터 2개**(펌프마다): ① 연장선 빨강 + 다이오드 띠쪽 다리 + 펌프 빨강, ② 연장선 검정 + 다이오드 반대 다리 + 펌프 검정. 피복 9~10mm, 한 구멍에 한 가닥. 펌프를 꽂기 전에 멀티미터 다이오드 모드로 방향 확인(검정 리드→빨강 선, 빨강 리드→검정 선에 0.5~0.7, 반대는 OL). 커넥터 2개와 다이오드를 절연테이프로 한 덩어리로 감아 뚜껑 윗면에서 1~2cm 띄워 연장선에 케이블타이로 고정(당김·물방울 방지). 펌프 리드가 뚜껑 위로 3cm 이상 나와야 함 | PCT-413 P75 · 1N4007 P10 · 멀티미터 P48 · 케이블타이 P27 · 절연테이프 P79 |
| STEP4 전원 스위치 SW1 (2곳) | 선이 달린 **하네스 로커 스위치**를 G 사각 구멍에 끼움. 리드 끝 커넥터를 잘라 필요한 길이만 남기고 피복을 벗김. SW1 리드 1 ↔ ②, SW1 리드 2 ↔ F1 리드 1을 **2구 레버 커넥터로 바로 이음**(연결표 ③ 대신 — AWG20 8cm는 쓰지 않음) | 하네스 스위치 P73 · PCT-412 P76 |
| STEP4 퓨즈홀더 F1 (2곳) | 선이 달린 **인라인 퓨즈홀더**를 G 안쪽(박스 밖) 위쪽에 두고 F1 리드 2 ↔ ④를 레버 커넥터로 이음. G 퓨즈 구멍은 뚫지 않음. 퓨즈 교체는 상판 C를 열고 함 | FH-201 P74 · 퓨즈 P15 · PCT-412 P76 |
| STEP9 버튼 SW2 (2곳) | **2.8mm 단자 달린 선**(검정 2) 2개를 버튼 단자에 꽂고 단자를 절연테이프로 감음. 단자 1 쪽은 PCT-412로 노랑 ㉝과, 단자 2 쪽은 GND 허브(PCT-415)에. 단자가 3개 이상이면 누를 때만 이어지는 두 단자를 고름 | CG0731 P78 · PCT-412 · PCT-415 |
| STEP9 LED + 저항 R1 (3곳) | LED 긴 다리(+)에 표시 → LED 긴 다리 ↔ R1, R1 ↔ 노랑 ㉟를 **2구 레버 커넥터**로, LED 짧은 다리는 GND 허브로. 다리는 옆으로 꺾어 커넥터를 F 면에 납작하게 붙이고(F와 박스 사이 약 35mm) 절연테이프로 감쌈 | PCT-412 P76 · PCT-415 P77 · 절연테이프 P79 |
| STEP9 부저 (3곳) | 부저 핀(모듈 인쇄 이름 확인)에 **듀폰 F/F 점퍼**를 꽂고 반대쪽 끝 피복을 벗겨 반으로 접어 꼰 뒤 ㉙·㉚(PCT-412)과 GND 허브에. 부저는 선택 부품이라 빼면 이 3곳이 없어짐 | 점퍼 P20(보유) · PCT-412 · PCT-415 |
| STEP9 앞판 GND 공통선 | 가지치기 납땜 대신 **5구 레버 커넥터** 한 개에 버튼·LED·부저 GND와 박스로 가는 검정 ㉛을 모음 | PCT-415 P77 |
| 수축튜브 약 22~25개 (열 작업) | 열 없이 **절연테이프**로 감음(수축튜브는 선택 — 헐겁게 씌우고 테이프로 고정). 라이터는 쓰지 않음(PVC 판 근처 유독가스) | 절연테이프 P79 · (선택) 수축튜브 P26 |
| 그래도 남는 일 | **구멍 약 51~55개**(뚜껑 12 · 뒤판 G 2 · 전장 박스 8~12 · 외형 판 약 29 — 드릴·스텝드릴 학교 대여 또는 손공구), **글루건**(뚜껑 전선 구멍·LED·보강), 피복 벗기기 약 70곳, 멀티미터 측정 | 스텝드릴 P53(대여) · 글루건 P51 · 스트리퍼 P49 · 멀티미터 P48 |

## 3. 전체 BOM (80개 항목, 분류별)

구매 = 추가로 사야 할 수량, 금액 = 구매 × 단가(VAT 포함). 상태: 구매 필요 · 보유 · 주문 완료 · 구매 완료 · 학교 대여 · 불필요 · 선택 · 미사용.

### 제어 (7개 · 추가 구매 0원)

| ID | 부품명 | 규격/모델 | 필요 | 보유 | 구매 | 단가(원) | 금액(원) | 상태 | 구매처 · 상품번호 | 사용 위치 | 비고 |
|---|---|---|---:|---:|---:|---:|---:|---|---|---|---|
| P01 | ESP32 DevKitC WROOM-32D V4 CP2102 개발보드 [CMODULE-40] (Happy House) | 38핀(19핀×2열), 5V·3V3·GND 전원핀, 마이크로USB(CP2102), EN/BOOT 버튼, 사용자 LED 없음(5V 전원 LED만) | 1 | 2 | 0 | 9,900 | 0 | 보유 | 디바이스마트 · [15313999](https://www.devicemart.co.kr/goods/view?no=15313999) | 회로도 U1 / STEP 전장부(ESP32 장착) | 1개는 고장 대비 예비(펌웨어를 미리 올려 두면 바로 교체 가능, 앱 개발·시험용 겸용). 전원은 USB·5V핀·3V3핀 중 하나만 사용(Espressif 경고). 5V 핀 실크 표기는 "5V". |
| P02 | ESP32-DevKitC 터미널 확장보드 Push-in 타입 (ElectroCookie) | ESP32-DevKitC(38핀) 전용 소켓+푸시인 단자대, 스탠드오프·나사·20P 리본케이블 동봉 (보드 외형 치수 확인 필요) | 1 | 1 | 0 | 12,100 | 0 | 주문 완료 (11-11, 배송 대기) · 지출 12,100원 | 디바이스마트 · [15223173](https://www.devicemart.co.kr/goods/view?no=15223173) | 회로도 U1 단자 / STEP 전장부 | ✔ 11-11 디바이스마트에서 1개 구매(VAT 별도 단가 11,000원). 대안: CMODULE-47(15315957, 4,400원, 3핀(S/V/G) 헤더형·듀폰 연결, 단자대 아님. 보드 DC잭은 6.5~16V 입력이라 5V 어댑터 연결 금지). DevKitC는 폭이 넓어 830핀 브레드보드 1개에 꽂으면 한쪽 핀 열이 거의 남지 않음. |
| P03 | 메탈 푸쉬 스위치 플랫형 16mm [HX16-B1] (모멘터리) | 일반 PUSH(누르는 동안만 ON), 3A 36VDC, 패널 홀 16mm, 스위치 지름 18mm, LED 없음 | 1 | 1 | 0 | 2,970 | 0 | 주문 완료 (11-11, 배송 대기) · 지출 2,970원 | 디바이스마트 · [1325010](https://www.devicemart.co.kr/goods/view?no=1325010) | 회로도 SW2 / 앞판 상부 | ✔ 11-11 디바이스마트에서 1개 구매(VAT 별도 단가 2,700원). GPIO4 ↔ GND (INPUT_PULLUP). 시작/비상정지 버튼. |
| P04 | 회로내장형 액티브 부저 모듈 [ONE005] | DC 3.3~5V, HIGH 입력 시 울림(액티브), 24×21mm, 고정 홀 | 1 | 1 | 0 | 1,100 | 0 | 주문 완료 (11-11, 배송 대기) · 지출 1,100원 | 디바이스마트 · [10916337](https://www.devicemart.co.kr/goods/view?no=10916337) | 회로도 BZ1 / 앞판 상부(안쪽) | ✔ 11-11 디바이스마트에서 1개 구매(VAT 별도 단가 1,000원). SPEC상 선택 부품. I/O ← GPIO23, VCC ← TB3(3V3). HIGH=울림이라 SPEC v2.1 펌웨어 기본값 BUZZER_ON_LEVEL 1과 일치. (SZH-SDBJ-006 같은 LOW=울림 모듈을 쓰면 BUZZER_ON_LEVEL 0) |
| P05 | 5mm LED 빨강 원통평면형 불투명 [5PR3HD19] | 5파이, 2V, 20mA | 1 | 2 | 0 | 55 | 0 | 주문 완료 (11-11, 배송 대기) · 지출 110원 | 디바이스마트 · [3218](https://www.devicemart.co.kr/goods/view?no=3218) | 회로도 LED1 / 앞판 상부 | ✔ 11-11 디바이스마트에서 2개 구매(VAT 별도 단가 50원). DevKitC V4에는 GPIO2 사용자 LED가 없으므로 외부 LED + 220Ω(R1) 필수(SPEC §1). 1개 예비. |
| P06 | 저항 220Ω 1/4W 1% [221F] | 탄소피막, 1/4W, ±1% | 1 | 10 | 0 | 33 | 0 | 주문 완료 (11-11, 배송 대기) · 지출 330원 | 디바이스마트 · [2001](https://www.devicemart.co.kr/goods/view?no=2001) | 회로도 R1 | ✔ 11-11 디바이스마트에서 10개 구매(VAT 별도 단가 30원). 최소주문 10개. LED 전류 약 6mA. |
| P07 | Micro USB 5핀 데이터 케이블 1m | USB-A ↔ micro-B, 데이터 통신 가능 | 1 | 1 | 0 | 770 | 0 | 주문 완료 (11-11, 배송 대기) · 지출 770원 | 디바이스마트 · [32695](https://www.devicemart.co.kr/goods/view?no=32695) | STEP 펌웨어 업로드 | ✔ 11-11 디바이스마트에서 1개 구매(VAT 별도 단가 700원). 펌웨어 업로드용. 데이터 전송되는 케이블이 이미 있으면 구매 불필요(충전 전용 케이블은 PC가 인식 못 함). |

### 구동 (3개 · 추가 구매 0원)

| ID | 부품명 | 규격/모델 | 필요 | 보유 | 구매 | 단가(원) | 금액(원) | 상태 | 구매처 · 상품번호 | 사용 위치 | 비고 |
|---|---|---|---:|---:|---:|---:|---:|---|---|---|---|
| P08 | 아두이노 4채널 5V 릴레이 모듈 [SZH-RLBG-012] | TONGLING JQC-3FF-S-Z 5VDC(코일 약 70Ω≈71mA, 0.36W), 접점 10A 250VAC/10A 30VDC, 채널별 옵토커플러+표시LED, 2핀 JD-VCC/VCC 점퍼(별도 코일 GND핀 없음 → 코일 GND는 메인 헤더 GND), Active-LOW, 76×56mm, M3용 3mm 홀(간격 69.6×49.4mm) | 1 | 2 | 0 | 4,180 | 0 | 보유 | 디바이스마트 · [1327545](https://www.devicemart.co.kr/goods/view?no=1327545) | 회로도 K1~K4(릴레이 CH1~CH4) / STEP 전장부 | 1개는 예비(펌프 5~8 확장·고장 대비). A안(기본: JD-VCC 점퍼 제거, VCC=3V3)으로 안 켜지면 B안(SPEC 공식 대체안, USB·어댑터를 모두 뺀 상태에서: ① 입력 헤더 VCC ← 3V3 선(⑪)을 먼저 뽑음 → ② 5V 선(⑨)을 JD-VCC 핀에서 빼서 입력 헤더 VCC 핀에 꽂음 → ③ 점퍼 캡을 끼움 (VCC = JD-VCC = 5V, 점퍼가 2핀이라 JD-VCC 핀에는 캡만). B안에서 VCC를 3V3에 연결 금지) — parts_research.md 3.2절. |
| P09 | 수중펌프모터 [SZH-GNP155] | 정격 DC 3V(0.12A·80L/H·양정0.35m) / 4.5V(0.18A·100L/H·양정0.55m), 판매처 5V 연결 안내, 출수구 외경 7.5mm·내경 4.9mm, 본체 약 43×23mm, IP68, 튜브 미포함, 식품등급 표기 없음, 해외입고품(AS 불가) | 4 | 6 | 0 | 3,190 | 0 | 주문 완료 (11-11, 배송 대기) · 지출 6,380원 | 디바이스마트 · [1329770](https://www.devicemart.co.kr/goods/view?no=1329770) | 회로도 M1~M4 / STEP 용기·펌프 | ✔ 11-11 디바이스마트에서 2개 구매(VAT 별도 단가 2,900원). qtyToBuy 2 = 고장 대비 예비(권장, 필수 아님 — 기말 시연·논문 실험 중 펌프가 고장 나면 바로 교체). 물 없이 공회전 금지. 식품등급 표기·본체 재질 미확인 → 시음하려면 재질 확인 또는 연동 펌프(P55)로 교체(조립가이드 1.3). |
| P10 | 다이오드 1N4007 | 1A 1000V, DO-41 | 4 | 10 | 0 | 22 | 0 | 보유 | 디바이스마트 · [3011](https://www.devicemart.co.kr/goods/view?no=3011) | 회로도 D1~D4 | 펌프마다 병렬 1개: 띠(캐소드)→펌프(+)(=릴레이 NO 쪽), 반대쪽(애노드)→펌프(−)(=GND). 위치는 펌프 리드 이음부 또는 연장선의 박스 쪽 끝(전기적으로 동일, SPEC §1). |

### 전원 (10개 · 추가 구매 0원)

| ID | 부품명 | 규격/모델 | 필요 | 보유 | 구매 | 단가(원) | 금액(원) | 상태 | 구매처 · 상품번호 | 사용 위치 | 비고 |
|---|---|---|---:|---:|---:|---:|---:|---|---|---|---|
| P11 | 아답터 100~240V / 5V 4A [내경2.1~2.5/외경5.5mm] 전원 코드 일체형 | 5V 4A, DC 케이블 150cm, 과전류·과전압·단락 보호 | 1 | 1 | 0 | 8,360 | 0 | 보유 | 디바이스마트 · [12233458](https://www.devicemart.co.kr/goods/view?no=12233458) | 회로도 어댑터(J1에 꽂음) / STEP 전원 | 최대 소비 추정 약 1.3A(병렬 구동 시) → 여유 충분. 코드 일체형이라 플러그를 뒤판 G의 Ø12 구멍으로 통과시킴 → 플러그 몸통 지름이 12mm 이하인지 실측(확인 필요). |
| P12 | 터미널블럭 to DC 커넥터 (DC2.1 FEMALE) [SZH-LC002] | DC잭 2.1×5.5mm(암), 최대 20A, 1~38V, 나사 단자 | 1 | 2 | 0 | 550 | 0 | 보유 | 디바이스마트 · [1321144](https://www.devicemart.co.kr/goods/view?no=1321144) | 회로도 J1 / 전장 박스 | 1개 예비. 어댑터 플러그를 꽂는 입력 단자(전장 박스 안). |
| P13 | 로커 스위치 KCD1-101A (ON/OFF, SPST) | 2P, 6A 250VAC / 10A 125VAC | 0 | 0 | 0 | 330 | 0 | 불필요 (P73 하네스 스위치로 대체) | 디바이스마트 · [1790](https://www.devicemart.co.kr/goods/view?no=1790) | 회로도 SW1(전원 스위치) / STEP4 뒤판 G 사각 구멍 | 단자가 납땜·탭형이라 무납땜 기준에서는 선이 달린 같은 계열 스위치(P73)를 씀. |
| P14 | 패널형 퓨즈홀더 FH-303 (5×20mm 유리관용) | 10A 250V, 너트 고정형, 납땜 단자 | 0 | 0 | 0 | 583 | 0 | 불필요 (P74 인라인 퓨즈홀더로 대체) | 디바이스마트 · [4577](https://www.devicemart.co.kr/goods/view?no=4577) | 회로도 F1(퓨즈홀더) / STEP4 뒤판 G 둥근 구멍 | FH-303은 납땜 러그라 무납땜으로 쓸 수 없음. 뒤판 G의 퓨즈 구멍도 필요 없어짐. |
| P15 | 퓨즈 5×20 3A 250V (LB FUSE) | 5파이×20mm, 3A | 1 | 3 | 0 | 121 | 0 | 주문 완료 (11-11, 배송 대기) · 지출 363원 | 디바이스마트 · [4537](https://www.devicemart.co.kr/goods/view?no=4537) | 회로도 F1(3A 퓨즈, P74 인라인 홀더에 넣음) | ✔ 11-11 디바이스마트에서 3개 구매(VAT 별도 단가 110원). 2개 예비(예비 퓨즈는 기기와 함께 보관). |
| P16 | 전해 커패시터 16V 1000µF 105℃ (SAMYOUNG, 10×16mm) | 16V / 1000µF / 105℃ / 10×16 DIP | 1 | 10 | 0 | 99 | 0 | 주문 완료 (11-11, 배송 대기) · 지출 990원 | 디바이스마트 · [29524](https://www.devicemart.co.kr/goods/view?no=29524) | 회로도 C1 | ✔ 11-11 디바이스마트에서 10개 구매(VAT 별도 단가 90원). 최소주문 10개. TB1(+5V) 1번 ↔ TB2(GND) 8번 사이(연결 ⑥). 극성 주의(긴 다리·무표시 쪽 +, 띠 쪽 −). |
| P17 | (선택) 전해 커패시터 16V 100µF 105℃ (5×12mm) | 16V / 100µF / 105℃ | 1 | 10 | 0 | 33 | 0 | 주문 완료 (11-11, 배송 대기) · 지출 330원 | 디바이스마트 · [29522](https://www.devicemart.co.kr/goods/view?no=29522) | C2(선택, 회로도 외 보조) / 확장보드 5V–GND | ✔ 11-11 디바이스마트에서 10개 구매(VAT 별도 단가 30원). 최소주문 10개. ESP32 확장보드 5V-GND 단자 근처 보조 커패시터(선택, 회로도에는 없음 — ESP32 재부팅이 잦을 때만). |
| P18 | 레버형 전선연결 커넥터 8선 결합 PCT-418 (칩센) | 8구 전부 공통 결선, AWG28~14(0.08~4.0mm²), 단선·연선 가능, 40.1×21×14.4mm | 3 | 4 | 0 | 352 | 0 | 주문 완료 (11-11, 배송 대기) · 지출 1,408원 | 디바이스마트 · [10911193](https://www.devicemart.co.kr/goods/view?no=10911193) | 회로도 TB1(+5V)·TB2(GND)·TB3(3V3) / 전장 박스 | ✔ 11-11 디바이스마트에서 4개 구매(VAT 별도 단가 320원). TB1 +5V · TB2 GND · TB3 3V3 분배 3개 + 예비 1. 무납땜 기준에서 다이오드는 뚜껑 위 PCT-413(P75)에 있으므로 GND 커넥터는 TB2 하나로 충분. |
| P73 | 하네스 스위치 (101A-5264) — KCD-101A 로커 스위치 + 리드선 200mm | ON/OFF 로커(비조광), 선이 공장에서 달려 나옴(끝의 5264 커넥터는 잘라 피복 벗김). 리드 굵기 확인 필요(AWG22 이상 권장) | 1 | 1 | 0 | 4,730 | 0 | 주문 완료 (11-11, 배송 대기) · 지출 4,730원 | 디바이스마트 · [37135](https://www.devicemart.co.kr/goods/view?no=37135) | 회로도 SW1 / STEP4 뒤판 G 사각 구멍 | ✔ 11-11 디바이스마트에서 1개 구매(VAT 별도 단가 4,300원). P13 대신. G 사각 구멍은 그대로(받은 스위치 몸통을 재서 0.5mm 작게 표시 → 줄로 맞춤). 5mm 판이라 '딸깍' 고정이 약하면 글루건 보강(추정). 리드는 필요한 길이만 남겨 자르고, 나머지 거리는 AWG20(②)으로 이음. 리드가 가늘어 벗길 때 끊기지 않게 조심. 2주 기다릴 수 있으면 나사 단자 셀렉터 스위치 슈나이더 XA2AD21(3,080원 + 업체 택배 3,300원, G에 Ø22.3 둥근 구멍)도 가능. |
| P74 | 퓨즈홀더 FH-201 (빨강, 라인홀더 — 선 달린 인라인형) | 5×20mm 유리관 퓨즈용, 15A, 양쪽 리드선(굵기 확인) | 1 | 1 | 0 | 726 | 0 | 주문 완료 (11-11, 배송 대기) · 지출 726원 | 디바이스마트 · [35327](https://www.devicemart.co.kr/goods/view?no=35327) | 회로도 F1 / 뒤판 G 안쪽(박스 밖) | ✔ 11-11 디바이스마트에서 1개 구매(VAT 별도 단가 660원). P14 대신. 퓨즈 P15(3A)를 그대로 넣음. 홀더는 박스 밖, 상판 C를 열었을 때 손이 닿는 G 안쪽 위쪽에 케이블타이로 고정(볼트·브래킷 금속에 닿지 않게). 퓨즈 교체·STEP4 '퓨즈 빼면 0V' 시험은 상판 C를 열고 함. |

### 배선 (17개 · 추가 구매 0원)

| ID | 부품명 | 규격/모델 | 필요 | 보유 | 구매 | 단가(원) | 금액(원) | 상태 | 구매처 · 상품번호 | 사용 위치 | 비고 |
|---|---|---|---:|---:|---:|---:|---:|---|---|---|---|
| P19 | AWG20 2P 10M (검정, 빨강) | 2심 평행선 AWG20 | 1 | 1 | 0 | 10,340 | 0 | 보유 | 디바이스마트 · [13003174](https://www.devicemart.co.kr/goods/view?no=13003174) | 전원·펌프 배선 | 5V/GND 전원 배선 + 펌프 리드선 연장(펌프당 약 0.7m × 4 ≈ 2.8m). |
| P20 | 점퍼 케이블 40P (F/F) | 2.54mm 듀폰 | 1 | 1 | 0 | 1,100 | 0 | 보유 | 디바이스마트 · [32284](https://www.devicemart.co.kr/goods/view?no=32284) | 릴레이 신호선 | 릴레이 IN 헤더 ↔ 확장보드(한쪽 끝을 잘라 피복을 벗겨 푸시인 단자에 삽입). |
| P21 | 점퍼 케이블 40P (M/F) | 2.54mm 듀폰 | 1 | 1 | 0 | 1,100 | 0 | 보유 | 디바이스마트 · [1113721](https://www.devicemart.co.kr/goods/view?no=1113721) | 릴레이 신호선 | 신호선/시험용. |
| P22 | 점퍼 케이블 40P (M/M) | 2.54mm 듀폰 | 1 | 1 | 0 | 1,100 | 0 | 보유 | 디바이스마트 · [1113722](https://www.devicemart.co.kr/goods/view?no=1113722) | STEP 벤치 테스트 | 브레드보드 시험용. |
| P23 | 브레드보드 830핀 MB-102 [SZH-BBAD-002] | 830홀 | 1 | 2 | 0 | 1,540 | 0 | 보유 | 디바이스마트 · [1322408](https://www.devicemart.co.kr/goods/view?no=1322408) | STEP 벤치 테스트 | 조립 전 회로 시험(벤치 테스트)용. 본체에는 미사용. |
| P24 | UL1007 래핑와이어 22AWG 10M 노랑 [VLT-CAB160] | UL1007, 22AWG, 노랑 | 1 | 1 | 0 | 3,630 | 0 | 주문 완료 (11-11, 배송 대기) · 지출 3,630원 | 디바이스마트 · [15960649](https://www.devicemart.co.kr/goods/view?no=15960649) | 앞판 신호선 ㉙·㉚·㉝·㉟ | ✔ 11-11 디바이스마트에서 1개 구매(VAT 별도 단가 3,300원). 앞판 신호선(㉙ 부저 VCC 연장·㉚ 부저 I/O·㉝ 버튼·㉟ LED)용. 앞판 신호선 ㉙·㉚·㉝·㉟는 모두 이 노랑(연결표와 같음)이고 4가닥이 같은 색이라 선 양 끝 번호 테이프로 구분(㉙는 연결표대로 듀폰 주황으로 이어도 됨). GND선과 5V선은 색을 나눔: GND선(⑦·앞판 GND 공통선 ㉛·㉜·㉞·㊱) = 검정 P62, ESP32 5V선(⑧) = 빨강 P63(같은 시리즈·같은 값). 단가는 상품 페이지 확인(VAT 별도 3,300원). |
| P25 | 열 수축 솔더 슬리브 1.0SQ [SZH-CA002] | 납+접착제 내장 수축튜브(무납땜 접속), 1.0SQ용 | 0 | 10 | 0 | 330 | 0 | 보유 (무납땜 기준에서는 안 씀) | 디바이스마트 · [12507090](https://www.devicemart.co.kr/goods/view?no=12507090) | 펌프 리드 연장 | 펌프 리드 이음을 3구 레버 커넥터 P75로 바꿈. 리드가 짧아 뚜껑 안쪽에서 이어야 할 때만(방수 필요) 학교에서 열풍기로 씀. |
| P26 | NT DIY 열수축튜브 328세트 | 8규격 5색, 40mm 컷팅 | 1 | 0 | 0 | 4,290 | 0 | 선택(무납땜에서는 효과 작음) | 디바이스마트 · [1320936](https://www.devicemart.co.kr/goods/view?no=1320936) | 배선 절연 | 열을 쓰지 않으므로 수축이 안 됨. 헐겁게 씌워 절연테이프 P79로 고정할 때만 필요 — 절연테이프만 써도 됨. 11-11 주문에는 넣지 않았음 — 나중에 따로 사면 배송비(66,000원 미만 2,700원)가 붙으니 다른 주문과 묶어 삼. |
| P27 | 케이블타이 100mm 1000개 (CableMate UN-100MB 블랙) | 100mm | 1 | 1 | 0 | 3,740 | 0 | 주문 완료 (11-11, 배송 대기) · 지출 3,740원 | 디바이스마트 · [1215043](https://www.devicemart.co.kr/goods/view?no=1215043) | 배관·배선 정리 | ✔ 11-11 디바이스마트에서 1개 구매(VAT 별도 단가 3,400원). 튜브-바브 연결부 조임, 배선 정리. |
| P28 | 케이블타이 고정용 접착 마운트 20×20mm [SZ-XL015] | 양면테이프 부착형 | 10 | 10 | 0 | 132 | 0 | 주문 완료 (11-11, 배송 대기) · 지출 1,320원 | 디바이스마트 · [1382746](https://www.devicemart.co.kr/goods/view?no=1382746) | 배관 고정 | ✔ 11-11 디바이스마트에서 10개 구매(VAT 별도 단가 120원). 최소주문 10개. 선반 아래 체크밸브·튜브 고정. |
| P62 | UL1007 래핑와이어 22AWG 10M 검정 [VLT-CAB159] | UL1007, 22AWG, 검정 | 1 | 1 | 0 | 3,630 | 0 | 주문 완료 (11-11, 배송 대기) · 지출 3,630원 | 디바이스마트 · [15960648](https://www.devicemart.co.kr/goods/view?no=15960648) | ESP32 GND ⑦ · 앞판 GND ㉛(PCT-415로) | ✔ 11-11 디바이스마트에서 1개 구매(VAT 별도 단가 3,300원). ESP32 GND선 ⑦(J1 − 나사 → J3-1, 약 20cm)과 앞판 GND ㉛(약 40cm, PCT-415 GND 모음으로) — 합계 약 0.6m. ㉜·㉞·㊱은 듀폰·CG0731·LED 다리로 PCT-415에 바로 꽂음. ⑦(GND 검정)과 ⑧(5V 빨강, P63)을 색으로 구분해 바꿔 무는 실수(ESP32 역전압)를 막음. 10M 단위 판매. 단가는 상품 페이지 확인(VAT 별도 3,300원). |
| P63 | UL1007 래핑와이어 22AWG 10M 빨강 [VLT-CAB161] | UL1007, 22AWG, 빨강 | 1 | 1 | 0 | 3,630 | 0 | 주문 완료 (11-11, 배송 대기) · 지출 3,630원 | 디바이스마트 · [15960650](https://www.devicemart.co.kr/goods/view?no=15960650) | ESP32 5V ⑧ | ✔ 11-11 디바이스마트에서 1개 구매(VAT 별도 단가 3,300원). ESP32 5V선 ⑧(TB1-7 → J2-19, 약 20cm). 검정 P62와 색으로 극성 구분. 10M 단위 판매라 대부분 남음 → 2학기 확장(로드셀·추가 펌프) 전원선으로 활용. 단가는 상품 페이지 확인(VAT 별도 3,300원). |
| P75 | 3선 결합 탈피형 커넥터 PCT-413 (칩센) — 3구 정션형 | 3구가 모두 이어짐, 0.08~2.5mm² (AWG28~14), 피복 9~10mm, 재사용 가능 | 8 | 10 | 0 | 220 | 0 | 주문 완료 (11-11, 배송 대기) · 지출 2,200원 | 디바이스마트 · [1290839](https://www.devicemart.co.kr/goods/view?no=1290839) | STEP3 펌프 리드 이음 + 다이오드 D1~D4 (뚜껑 위) | ✔ 11-11 디바이스마트에서 10개 구매(VAT 별도 단가 200원). 펌프마다 2개: ① 연장선 빨강 + 다이오드 띠(캐소드) 다리 + 펌프 빨강, ② 연장선 검정 + 다이오드 반대 다리 + 펌프 검정. 한 구멍에 한 가닥. 레버를 내린 커넥터 2개와 다이오드를 절연테이프 P79로 한 덩어리로 감고, 뚜껑 윗면에서 1~2cm 띄워 케이블타이로 연장선에 고정(방수가 아니므로 리필 때 이 위로 붓지 않음). 펌프 리드가 뚜껑 위로 3cm 이상 나와야 함. 레버형인지 받으면 확인. 8 + 예비 2. |
| P76 | 2선 결합 탈피형 커넥터 PCT-412 (칩센) — 1:1 이음 | 0.08~2.5mm² (AWG28~14), 피복 9~10mm, 재사용 가능 | 8 | 10 | 0 | 132 | 0 | 주문 완료 (11-11, 배송 대기) · 지출 1,320원 | 디바이스마트 · [1290838](https://www.devicemart.co.kr/goods/view?no=1290838) | STEP4 ②–SW1 · SW1–F1(연결표 ③ 대신) · F1–④ 3곳 · STEP9 ㉙·㉚·㉝·LED↔R1·R1↔㉟ 5곳 | ✔ 11-11 디바이스마트에서 10개 구매(VAT 별도 단가 120원). 전원부 3 + 앞판 5 + 예비 2. 전원부 이음은 박스 밖 G 쪽에 두고 케이블타이로 고정. ㉙(3V3) 이음은 피복을 9~10mm로만 벗김 — 남은 심선이 옆의 LED·R1 다리나 버튼 단자(GND)에 닿으면 3V3 단락. 가는 듀폰선은 벗긴 끝을 반으로 접어 꼬아 넣고 당겨 봄. |
| P77 | 5선 결합 탈피형 커넥터 PCT-415 (칩센) — 앞판 GND 허브 | 5구 공통, 0.08~2.5mm² (AWG28~14) | 1 | 1 | 0 | 253 | 0 | 주문 완료 (11-11, 배송 대기) · 지출 253원 | 디바이스마트 · [1290840](https://www.devicemart.co.kr/goods/view?no=1290840) | STEP9 앞판 GND ㉛·㉜·㉞·㊱ | ✔ 11-11 디바이스마트에서 1개 구매(VAT 별도 단가 230원). 앞판 GND 공통선(가지치기 납땜) 대신. 버튼 단자 2(㉞)·LED 짧은 다리(㊱)·부저 GND(㉜)·박스로 가는 검정 ㉛을 한 곳에. F 안쪽 박스 오른쪽 빈 공간 쪽에 폼 양면테이프(P71)로 붙임. |
| P78 | 터미널 압착단자 케이블 2.8mm [CG0731] (30cm) | 2.8mm 암 평형 단자가 압착된 선(다른 끝은 피복 벗김) | 2 | 2 | 0 | 330 | 0 | 주문 완료 (11-11, 배송 대기) · 지출 660원 | 디바이스마트 · [15306311](https://www.devicemart.co.kr/goods/view?no=15306311) | STEP9 버튼 SW2 단자 2곳 | ✔ 11-11 디바이스마트에서 2개 구매(VAT 별도 단가 300원). 버튼 단자 2곳에 꽂고 다른 끝을 PCT-412(노랑 ㉝)·PCT-415(GND)에. 빨강은 5V에만 쓰는 규칙이라 검정으로 주문하되, 단자 1 쪽 선(GPIO4 신호)은 양 끝에 ㉝ 번호 테이프를 감아 GND와 구분. 빨강·검정이 아닌 색을 고를 수 있으면 1개는 그 색. 버튼 단자 개수·폭(2.8mm)은 받으면 확인 — 안 맞으면 심선을 러그 구멍에 감아 꼬고 테이프, 또는 학교에서 2곳만 납땜. STEP2 벤치 시험의 버튼 연결에도 씀. |
| P79 | 전기 절연 테이프 19mm×10m 2개입 | PVC | 1 | 1 | 0 | 1,000 | 0 | 구매 완료 (11-11) · 지출 1,000원 | 다이소 · [24482](https://www.daisomall.co.kr/pd/pdr/SCR_PDR_0001?pdNo=24482) | 다이오드 다리 · 저항 R1 · 이음부 절연 | ✔ 11-11 다이소에서 1개 구매(단가 1,000원). 열을 써야 하는 수축튜브 대신(또는 수축튜브를 헐겁게 씌우고 감아 고정). |

### 배관 (5개 · 추가 구매 0원)

| ID | 부품명 | 규격/모델 | 필요 | 보유 | 구매 | 단가(원) | 금액(원) | 상태 | 구매처 · 상품번호 | 사용 위치 | 비고 |
|---|---|---|---:|---:|---:|---:|---:|---|---|---|---|
| P29 | 실리콘 튜브 1M 내경 5mm (외경 7mm) [K11168275] | 내경5/외경7mm, 1m, 한국산, 식품등급 표기 없음 | 3 | 8 | 0 | 1,870 | 0 | 보유 | 디바이스마트 · [14115487](https://www.devicemart.co.kr/goods/view?no=14115487) | 배관(펌프→체크밸브) | 펌프 출수구(외경 7.5mm)에 끼움 → 체크밸브 앞까지. 펌프당 약 0.7m(용기 인출 여유 포함). 식품등급 표기 없음 → 시음 전에는 식품용 P65로 교체(선택, 조립가이드 1.3). |
| P30 | 실리콘 튜브 1M 내경 4mm (외경 6mm) [K11168264] | 내경4/외경6mm, 1m, 한국산, 식품등급 표기 없음 | 1 | 5 | 0 | 1,760 | 0 | 보유 | 디바이스마트 · [14115486](https://www.devicemart.co.kr/goods/view?no=14115486) | 배관(체크밸브↔노즐) | 체크밸브 바브(Ø3.2~5.0)용: ①입구 바브에 3cm 슬리브 → 그 바깥(외경6)에 내경5 튜브를 1.5cm 겹쳐 끼우고 케이블타이 ②출구 → 노즐 약 10cm. 식품등급 표기 없음 → 시음 전에는 식품용 P66으로 교체(선택, 조립가이드 1.3). |
| P31 | 체크밸브 JGB32PPS (JG) | 덕빌형, 개방압 2kPa(약 20cm 물기둥), 배압 3bar, 전장 35.3~35.8mm, 바브 Ø3.2(끝)~5.0(턱), 내부 유로 Ø2.0mm, 판매처 설명상 공기용, 재질/식품적합성 미표기 | 4 | 5 | 0 | 6,050 | 0 | 주문 완료 (11-11, 배송 대기) · 지출 6,050원 | 디바이스마트 · [12519260](https://www.devicemart.co.kr/goods/view?no=12519260) | 배관 CV1~CV4 / STEP 배관 | ✔ 11-11 디바이스마트에서 1개 구매(VAT 별도 단가 5,500원). qtyToBuy 1 = 고장·막힘 대비 예비. 화살표(FLOW)가 노즐 쪽을 향하게, 노즐 직전에 설치. 유로 Ø2.0mm라 유량이 크게 줄 수 있음(parts_research.md 3.3절). 판매처 설명상 공기용·재질 미표기 → 시음 전에는 식품용 P67로 교체(선택, 조립가이드 1.3). |
| P32 | 다이소 직사각 저장 용기 970ml (품번 1069852, (주)해창) | 약 105(앞뒤) × 80(좌우) × 150mm(높이, 뚜껑 포함 — 상세 치수도). 몸체 PET · 나사식 뚜껑 PP, 식품용 기구 표시. 입구 안지름 약 64~70mm(사진 비례 추정) | 4 | 5 | 0 | 1,000 | 0 | 구매 완료 (11-11) · 지출 5,000원 | 다이소 · [1069852](https://www.daisomall.co.kr/pd/pdr/SCR_PDR_0001?pdNo=1069852) | STEP 용기 준비 | ✔ 11-11 다이소에서 5개 구매(단가 1,000원). W420 기준(좌우 ≤95·앞뒤 ≤135·높이 ≤170)을 상품 페이지로 확인(2026-11-10). 좁은 80mm 쪽을 좌우로 놓음. 후보 셋 중 단면이 가장 넓고(약 81~83cm²) 낮아 액면 변화가 가장 작음(설계 기준 '낮고 넓을수록 좋음'). 칸 폭 98.75에서 좌우 여유 약 16~19mm → 가이드 N(용기 사이)으로 자리 고정. 눈금 없음. 같은 회사 대안: 원형 저장 용기 900ml(1035184, 지름 94×165) · 사각 저장 용기 800ml(1027241, 80×80×165). 4개 + 예비 1(뚜껑 구멍 뚫다 깨질 때 대비). 나사식 뚜껑이라 리필 때 뚜껑을 잡고 몸통을 돌림. 몸체 PET 60℃까지(열탕·식기세척기 금지). 처음 산 TARK 1L(165×120×80)은 취소. |
| P33 | 실리콘 원형 코스터 세트 2개입 (지름 약 10cm) — 드립 매트 | 지름 약 10cm, 가장자리 턱이 낮은 실리콘 매트 2개(그레이·브라운). 높이 몇 mm(표기 없음) | 1 | 1 | 0 | 1,000 | 0 | 구매 완료 (11-11) · 지출 1,000원 | 다이소 · [1038323](https://www.daisomall.co.kr/pd/pdr/SCR_PDR_0001?pdNo=1038323) | STEP 잔 받침 | ✔ 11-11 다이소에서 1개 구매(단가 1,000원). 잔 칸 바닥(150×100mm)에 깔아 방울을 받음 — 치수 조건(≤150×100, 높이 ≤15mm)을 모두 맞는 다이소몰 상품(2026-11-10). 턱이 얕아 몇 방울만 받으므로 시연 중 자주 닦음. 물을 더 받고 싶으면 분리형 모던 비누 받침(1063199, 14×9.5×3cm, 1,000원)도 되지만 높이 30mm라 잔 높이 한계가 약 175mm로 줄어듦(추정). |

### 외형 (15개 · 추가 구매 0원)

| ID | 부품명 | 규격/모델 | 필요 | 보유 | 구매 | 단가(원) | 금액(원) | 상태 | 구매처 · 상품번호 | 사용 위치 | 비고 |
|---|---|---|---:|---:|---:|---:|---:|---|---|---|---|
| P34 | 포맥스(PVC 발포보드) 5T 흰색 600×900mm | 5mm 두께, 커터칼 재단 가능 | 3 | 3 | 0 |  |  | 구매 완료 · 지출 43,000원 | 구매 완료 — 판매처는 영수증 참고 | STEP 외형(재단표 A~N) | 2026-11-10 3장 구매 완료(43,000원). 600×900 통판이면 재단표(부록 B, W420)대로 직접 재단 — 커터칼·쇠자 60cm 이상·커팅매트(P54) 필요. 노즐 판 M1·M2는 출력 노즐 블록 02를 쓰므로 자르지 않음. |
| P35 | 화신박스 단자함 EG AGH-152010 (150×200×100, 플라스틱 속판 포함) | 전장부 전용 박스(액체와 격리) | 1 | 1 | 0 | 12,320 | 0 | 주문 완료 (11-11, 배송 대기) · 지출 12,320원 | 디바이스마트 · [14003437](https://www.devicemart.co.kr/goods/view?no=14003437) | STEP5 전장부 / STEP10 선반 D 위 | ✔ 11-11 디바이스마트에서 1개 구매(VAT 별도 단가 11,200원). 선반 위에 올리고 ESP32·릴레이·분배 커넥터를 내부에 배치. 벽 구멍: 좌·우 Ø12(펌프 선), 뒤 Ø16(어댑터 선·SW1/F1 선), 앞 Ø10(앞판 신호선) — 배선 후 글루건으로 막음. 내부 유효 치수 실측(확인 필요). 선반 D에는 접착식 벨크로(P64) 4쌍으로 고정(기본, 박스 바닥·D에 구멍 없음). 볼트 고정은 선택: 뒤쪽 두 모서리(본체 x 약 115·295, y 약 180)만, M3×15(P68). |
| P36 | L자 꺾쇠(소형, 약 25mm) | 철제, 나사 구멍 2개 | 0 | 0 | 0 |  |  | 불필요 (출력 브래킷 01로 대체) | 다이소/철물점 | STEP 외형 조립 | 3D 프린팅 모서리 브래킷 01(P70) 12개 + 예비 2를 씀. 출력 부품이 없을 때만 12개. |
| P37 | 스텐 둥근머리 십자볼트 M3×10 | M3, 10mm, SUS | 24 | 25 | 0 | 22 | 0 | 주문 완료 (11-11, 배송 대기) · 지출 550원 | 디바이스마트 · [10912297](https://www.devicemart.co.kr/goods/view?no=10912297) | STEP 외형·전장 | ✔ 11-11 디바이스마트에서 25개 구매(VAT 별도 단가 20원). 출력 브래킷 01 12개 × 2쌍 = 24(상판 C 캡티브 너트 4 포함). 실제로는 25개를 사서 예비가 1개뿐 — 지퍼백에 따로 보관하고, 모자라면 디바이스마트에서 더 삼(개당 20원 + 배송비). 전장 박스 볼트 고정(선택)은 P68 M3×15를 따로 씀. |
| P38 | 육각 너트(스텐) M3 | M3, SUS | 24 | 25 | 0 | 22 | 0 | 주문 완료 (11-11, 배송 대기) · 지출 550원 | 디바이스마트 · [10893596](https://www.devicemart.co.kr/goods/view?no=10893596) | STEP 외형·전장 | ✔ 11-11 디바이스마트에서 25개 구매(VAT 별도 단가 20원). 출력 브래킷 01 12개 × 2쌍 = 24(상판 C 캡티브 너트 4 포함). 실제로는 25개를 사서 예비가 1개뿐 — 지퍼백에 따로 보관하고, 모자라면 디바이스마트에서 더 삼(개당 20원 + 배송비). 전장 박스를 볼트(P68)로 고정하는 선택을 하면 너트 2개가 더 필요 — 지금은 벨크로(P64) 기준이라 해당 없음. |
| P39 | M3 알루미늄 서포트 Female 10mm [SZH-ZR059] | M3, 10mm×5mm | 4 | 4 | 0 | 462 | 0 | 주문 완료 (11-11, 배송 대기) · 지출 1,848원 | 디바이스마트 · [1382352](https://www.devicemart.co.kr/goods/view?no=1382352) | STEP 전장부 | ✔ 11-11 디바이스마트에서 4개 구매(VAT 별도 단가 420원). 릴레이 모듈을 박스 속판에 띄워 고정(속판에 Ø3.2 구멍 4개, 간격 69.6×49.4mm). ESP32 확장보드는 서포트 동봉. |
| P40 | 둥근머리 십자볼트(니켈) M3×6 | M3, 6mm | 8 | 10 | 0 | 11 | 0 | 주문 완료 (11-11, 배송 대기) · 지출 110원 | 디바이스마트 · [10912222](https://www.devicemart.co.kr/goods/view?no=10912222) | STEP 전장부 | ✔ 11-11 디바이스마트에서 10개 구매(VAT 별도 단가 10원). 서포트 고정용, 최소주문 10개. |
| P41 | 고무발 S-1 18×10H | 지름 18mm, 높이 10mm | 4 | 10 | 0 | 110 | 0 | 주문 완료 (11-11, 배송 대기) · 지출 1,100원 | 디바이스마트 · [14882214](https://www.devicemart.co.kr/goods/view?no=14882214) | STEP 외형 | ✔ 11-11 디바이스마트에서 10개 구매(VAT 별도 단가 100원). 최소주문 10개. 바닥판 네 모서리. |
| P42 | 순간접착제 LOCTITE 401 20g | 시아노아크릴레이트, 플라스틱용 | 1 | 1 | 0 | 4,400 | 0 | 주문 완료 (11-11, 배송 대기) · 지출 4,400원 | 디바이스마트 · [9108](https://www.devicemart.co.kr/goods/view?no=9108) | STEP 외형 조립 | ✔ 11-11 디바이스마트에서 1개 구매(VAT 별도 단가 4,000원). 포맥스 맞대기 접착 + 출력 브래킷 01 육각 홈의 캡티브 너트 고정(상판 C 쪽, 기름 바른 볼트를 끼운 채 굳힘). |
| P43 | 핫멜트스틱(대) 10개 | 글루건용 굵은 스틱 | 1 | 1 | 0 | 2,200 | 0 | 주문 완료 (11-11, 배송 대기) · 지출 2,200원 | 디바이스마트 · [13187167](https://www.devicemart.co.kr/goods/view?no=13187167) | STEP 외형·배관 | ✔ 11-11 디바이스마트에서 1개 구매(VAT 별도 단가 2,000원). 접착부 보강·관통 구멍 실링(전장 박스 벽 구멍·그로밋 둘레·뚜껑 구멍, 그로밋 대안). 사용 글루건 규격(7mm/11mm) 확인. |
| P44 | 케이블 그로밋(고무 부싱) — Ø20 구멍용 2개 + Ø12 구멍용 1개 | 고무, 패널 두께 5mm용(홈 폭 5mm 이상), 장착 구멍 Ø20 ×2 · Ø12 ×1 | 0 | 0 | 0 |  |  | 불필요 (출력 그로밋 04·05로 대체) | 철물점/온라인(확인 필요) | STEP 외형(선반 D·뒤판 G) | 3D 프린팅 그로밋 04(Ø20용) 2개 + 05(Ø12용) 1개(P70)를 씀. 출력 부품이 없을 때만 구매. |
| P45 | 원형 네오디뮴 자석 13mm 3개입 (다이소) | 지름 약 13mm 원형 네오디뮴 자석 3개, 접착면 없음 | 1 | 1 | 0 | 1,000 | 0 | 구매 완료 (11-11) · 지출 1,000원 | 다이소 · [1057293](https://www.daisomall.co.kr/pd/pdr/SCR_PDR_0001?pdNo=1057293) | STEP9 뒤 덮개 H 고정 (P80 철판과 짝) | ✔ 11-11 다이소에서 1개 구매(단가 1,000원). 다이소몰에 완제품 '자석 캐치'가 없어 자석 + 접착식 철판(P80)으로 만듦. 2개를 걸림턱 L 뒷면에 순간접착제(P42)로 붙이고(1개 예비), 뒤 덮개 H 안쪽 같은 자리에 P80 철판을 붙임. 흡착력 수치는 상품 정보에 없음(가벼운 5mm 판이라 2곳이면 충분할 것으로 추정). |
| P64 | Coms 사각 벨크로테이프 10조 (접착식 양면 찍찍이) 55×35mm [T9162] | 뒷면 접착(양면테이프), 까끌면+보슬면 한 쌍 × 10조, 55×35mm | 1 | 1 | 0 | 1,540 | 0 | 주문 완료 (11-11, 배송 대기) · 지출 1,540원 | 디바이스마트 · [15810228](https://www.devicemart.co.kr/goods/view?no=15810228) | STEP10 절차 1 전장 박스 고정(기본) / 2.3 소모품 | ✔ 11-11 디바이스마트에서 1개 구매(VAT 별도 단가 1,400원). 전장 박스(P35)를 선반 D에 고정하는 기본 방법(조립가이드 2.3 소모품·STEP10 절차 1): 박스 바닥 네 모서리와 D의 같은 자리에 한 쌍씩 = 4쌍 사용(크면 반으로 잘라 씀), 6쌍 예비. 박스 바닥·선반 D에 구멍을 뚫지 않음(박스 앞쪽 모서리 아래는 막힌 빈 공간이라 너트를 끼울 수 없음). 붙일 면의 먼지·기름을 닦고 꾹 눌러 붙임(제품 설명: 거친 면·재사용 시 접착력 떨어짐). 상품 페이지 확인: VAT 별도 1,400원 / 포함 1,540원, 평균 준비기간 3~4일(2026-11-06). |
| P71 | 오공 초강력 폼 양면테이프 투명 18mm×2m (두께 1mm) | 아크릴 폼, 폭 18mm · 길이 2m · 두께 1mm | 1 | 1 | 0 | 2,000 | 0 | 구매 완료 (11-11) · 지출 2,000원 | 다이소 · [1019760](https://www.daisomall.co.kr/pd/pdr/SCR_PDR_0001?pdNo=1019760) | STEP9 절차 다 8 앞면 베젤(출력 03) · 부저 고정 | ✔ 11-11 다이소에서 1개 구매(단가 2,000원). 베젤은 순간접착제로 붙이지 않음(LED를 바꿀 때 베젤을 떼야 함). 부착 후 24시간 뒤 최대 접착력, 뗄 때 표면이 상할 수 있음(상품 안내). 더 싼 대안: 3M 스카치 마운팅 폼 12mm×1m(58898, 1,000원, 두께 표기 없음). |
| P80 | 자석용 보조 설치판 5.5×3.5cm 3개입 (다이소, 접착식 철판) | 약 35×55mm 철판 3개, 뒷면 접착테이프(재사용 불가, 붙인 뒤 24시간 후 사용) | 1 | 1 | 0 | 1,000 | 0 | 구매 완료 (11-11) · 지출 1,000원 | 다이소 · [1050101](https://www.daisomall.co.kr/pd/pdr/SCR_PDR_0001?pdNo=1050101) | STEP9 뒤 덮개 H 안쪽 (P45 자석과 짝) | ✔ 11-11 다이소에서 1개 구매(단가 1,000원). 자석이 붙는 철판. 뒤 덮개 H 안쪽, 걸림턱 L의 자석과 마주 보는 자리에 2개 붙임(1개 예비). 더 작은 3×3cm 6개입(1050099)은 조사 때 온라인 재고 0. |

### 3D 프린팅 (1개 · 추가 구매 0원)

| ID | 부품명 | 규격/모델 | 필요 | 보유 | 구매 | 단가(원) | 금액(원) | 상태 | 구매처 · 상품번호 | 사용 위치 | 비고 |
|---|---|---|---:|---:|---:|---:|---:|---|---|---|---|
| P70 | 3D 프린팅 출력 부품 7종 24개 (PETG 흰색) — 업로드 묶음 plate_A(브래킷 14) + plate_B(나머지 10) | 레이어 0.2mm · 벽 3겹 · 인필 plate_A 50%/plate_B 15% · 배율 100% · 방향 원본 그대로. 01 브래킷 ×14, 02 노즐 블록, 03 앞면 베젤, 04 그로밋 Ø20 ×2, 05 그로밋 Ø12, 06 상판 모서리 캡 ×4, 07 튜브 부싱 | 1 | 0 | 0 |  |  | 주문 완료 (배송 예정 11/16) · 지출 78,700원 | 3DFARM · [상품 페이지](https://3dfarm.co.kr/) | STEP9·10, 제작가이드 부록 D | 결제 78,700원(업로드 견적 51,000 + 39,000 = 90,000원보다 적음). 파일·조건: hardware/3dprint/README.md. 받은 날 부록 D '받은 뒤 확인' 표대로 검수. |

### 공구 (10개 · 추가 구매 0원)

| ID | 부품명 | 규격/모델 | 필요 | 보유 | 구매 | 단가(원) | 금액(원) | 상태 | 구매처 · 상품번호 | 사용 위치 | 비고 |
|---|---|---|---:|---:|---:|---:|---:|---|---|---|---|
| P46 | 실습용 납땜세트B (학교 실습실 대여 가능) | 인두기 30W·인두 스탠드·납흡입기·페이스트·납 50g | 0 | 0 | 0 | 26,400 | 0 | 불필요 (무납땜) | 디바이스마트 · [10894366](https://www.devicemart.co.kr/goods/view?no=10894366) | STEP 공구 준비 | 무납땜 기준에서는 쓰지 않음. |
| P47 | 일반 실납 1.0mm [SME15510] (학교 실습실 대여 가능) | 1.0mm | 0 | 0 | 0 | 3,190 | 0 | 불필요 (무납땜) | 디바이스마트 · [1171334](https://www.devicemart.co.kr/goods/view?no=1171334) | STEP 공구 준비 | 무납땜 기준에서는 쓰지 않음. |
| P48 | 디지털 멀티미터 M300 | DCV ≤500V, DCA ≤200mA, 저항, 도통 | 1 | 1 | 0 | 8,800 | 0 | 주문 완료 (11-11, 배송 대기) · 지출 8,800원 | 디바이스마트 · [10917721](https://www.devicemart.co.kr/goods/view?no=10917721) | STEP 공구 준비 | ✔ 11-11 디바이스마트에서 1개 구매(VAT 별도 단가 8,000원). 집에서 STEP1부터 계속 씀(전압·도통·다이오드 방향 확인) → 학교 대여 대신 구매. 12V 23A 전지는 들어 있지 않아 P72로 따로 삼. 받으면 다이얼에 다이오드(▶\|) 자리가 있는지 확인. |
| P49 | 와이어 스트리퍼 TU-2022 | 구멍 0.4/0.5/0.65/0.8/1.0/1.3mm (약 AWG26~16, 듀폰선까지) | 1 | 1 | 0 | 6,600 | 0 | 주문 완료 (11-11, 배송 대기) · 지출 6,600원 | 디바이스마트 · [1330598](https://www.devicemart.co.kr/goods/view?no=1330598) | STEP 공구 준비 | ✔ 11-11 디바이스마트에서 1개 구매(VAT 별도 단가 6,000원). 집에서 하는 피복 벗기기(STEP4 J1·TB, STEP5 듀폰 끝 8mm, STEP10 앞판 결선, 무납땜은 레버 커넥터 9~10mm)에 필요 → 학교 대여 대신 구매. AWG20 → 1.0, UL1007 22AWG → 0.8, 듀폰선 → 0.5 구멍. 원래 BOM의 TU-2021(0.6~2.6mm)은 듀폰선이 범위 밖. |
| P50 | 니퍼 TU-C01 (학교 실습실 대여 가능) | 125mm | 1 | 0 | 0 | 3,190 | 0 | 학교 대여 | 디바이스마트 · [1287084](https://www.devicemart.co.kr/goods/view?no=1287084) | STEP 공구 준비 | 학교 대여 가능. [가격: 디바이스마트 검색 API 값 — 상품 페이지 재확인 필요(일부 품목은 페이지가가 약 10% 낮았음)] |
| P51 | 글루건 DY-3000 60W (학교 실습실 대여 가능) | 11mm 스틱용 | 1 | 0 | 0 | 8,360 | 0 | 학교 대여 | 디바이스마트 · [10931307](https://www.devicemart.co.kr/goods/view?no=10931307) | STEP 공구 준비 | 학교 대여 가능. [가격: 디바이스마트 검색 API 값 — 상품 페이지 재확인 필요(일부 품목은 페이지가가 약 10% 낮았음)] |
| P52 | 열풍기 D26411 (학교 실습실 대여 가능) | 2단 풍량, 노즐 2개 | 0 | 0 | 0 | 68,200 | 0 | 불필요 (무납땜) | 디바이스마트 · [12171271](https://www.devicemart.co.kr/goods/view?no=12171271) | STEP 공구 준비 | 솔더 슬리브를 쓰지 않으므로 필요 없음. 수축튜브는 열 없이 헐겁게 씌우거나 절연테이프(P79)로 대신. |
| P53 | 헬리컬 스텝드릴 4~35mm [K40843729] (학교 실습실 대여 가능) | 생크 6.35mm | 1 | 0 | 0 | 26,070 | 0 | 학교 대여 | 디바이스마트 · [14117356](https://www.devicemart.co.kr/goods/view?no=14117356) | STEP 공구 준비 | 구멍 약 51~55개(뚜껑 12 · 뒤판 G 2(퓨즈 구멍 없음) · 전장 박스 8~12 · 외형 판 약 29). 빌릴 수 없으면 예산 시트의 손공구 줄. |
| P54 | 커터칼(대)·쇠자(60cm)·커팅매트 (학교 실습실 대여 가능) | 포맥스 직접 재단용 | 1 | 0 | 0 |  |  | 학교 대여 | 다이소/화방 | STEP 외형 | 포맥스가 600×900 통판이면 직접 재단해야 함 — 커터칼(대)·쇠자 60cm 이상(다이소 50cm 자는 짧음)·커팅매트를 학교에서 빌리거나 삼. 맞춤 재단이면 불필요. |
| P72 | [건전지] 23A 12V 알카라인 1알 (멀티미터 M300용) | 23A(A23) 12V, 41mAh | 1 | 1 | 0 | 770 | 0 | 주문 완료 (11-11, 배송 대기) · 지출 770원 | 디바이스마트 · [10921874](https://www.devicemart.co.kr/goods/view?no=10921874) | P48 멀티미터 | ✔ 11-11 디바이스마트에서 1개 구매(VAT 별도 단가 700원). M300에는 전지가 들어 있지 않음(상품 페이지). 디바이스마트 주문에 함께 넣어 삼(11-11, 실제 단가 VAT 별도 700원). 다이소몰은 23A를 온라인으로 팔지 않음(편의점·문구점에도 있을 수 있음). |

### 선택 (9개 · 추가 구매 0원)

| ID | 부품명 | 규격/모델 | 필요 | 보유 | 구매 | 단가(원) | 금액(원) | 상태 | 구매처 · 상품번호 | 사용 위치 | 비고 |
|---|---|---|---:|---:|---:|---:|---:|---|---|---|---|
| P55 | 연동(페리스탈틱) 펌프 DFRobot Gravity Digital Peristaltic Pump [DFR0523] | 입력 5~6V, 연속 1.8A/피크 2.5A, 서보(PPM) 신호 제어 | 4 | 0 | 0 | 45,540 | 0 | 선택(구매 안 함) | 디바이스마트 · [1377341](https://www.devicemart.co.kr/goods/view?no=1377341) | 2학기 확장/논문 | 액체가 튜브에만 닿아 위생·정량성 우수. 4개면 약 18만원, 전류가 커서 5V 10A급 전원 필요(확인 필요). 대안: Adafruit 12V 연동펌프(14600697, 49,830원, 12V 전원 필요). |
| P56 | HX711 로드셀 24비트 AD 컨버터 모듈 [SZH-SSBH-016] | 2.7~5V | 1 | 0 | 0 | 1,870 | 0 | 선택(구매 안 함) | 디바이스마트 · [1327440](https://www.devicemart.co.kr/goods/view?no=1327440) | 2학기 확장/논문 | 무게 기반 자동 보정(잔 받침 아래 로드셀). |
| P57 | 4선 로드셀 1kg [VLT-LCS002] | 1kg, 4선 | 1 | 0 | 0 | 7,260 | 0 | 선택(구매 안 함) | 디바이스마트 · [15961057](https://www.devicemart.co.kr/goods/view?no=15961057) | 2학기 확장/논문 | HX711과 함께 사용. |
| P58 | MOSFET GPIO 보드 4채널 YYNMOS-4 [SZH-YY012] (AF60N03) | 36V 5A, 단방향 | 1 | 0 | 0 | 19,360 | 0 | 선택(구매 안 함) | 디바이스마트 · [13908386](https://www.devicemart.co.kr/goods/view?no=13908386) | 2학기 확장/논문 | 릴레이 대체·PWM 유량 미세제어. ESP32 3.3V 게이트 구동 가능 여부 확인 필요. PWM 시 플라이백은 1N5819 쇼트키(상품번호 27, 44원, 최소 10) 권장. |
| P65 | (선택·시음 전 교체용) 식품용 실리콘 튜브 내경5/외경7mm (FDA 또는 LFGB 표기), 1m 단위 | 내경5/외경7mm, 식품 접촉용 표기(FDA 21 CFR 177.2600 또는 LFGB) + 판매처 적합성 자료(시험성적서) 확인 | 3 | 0 | 0 |  |  | 선택(구매 안 함) | 국내 쇼핑몰·실험용품점 (디바이스마트 미취급, 확인 필요) | 1.3 시음 조건 / STEP8 배관(P29 자리) | P29 대체(지금 P29는 식품등급 표기 없음 → 바꾸기 전에는 아무도 마시지 않음, 조립가이드 1.3·5장). 펌프 출수구(외경 7.5) → 체크밸브 앞까지 펌프당 약 0.7m × 4 = 약 2.8m → 3m. 디바이스마트 검색("식품용 실리콘 튜브"·"실리콘 튜브 FDA"·"식품등급"·"Food-Grade", 2026-11-06)에 식품용 표기 실리콘 튜브 없음 → 판매처·가격 확인 필요. 시음할 계획(예: 졸업작품 심사)이 정해지면 미리 주문. 튜브·밸브만으로는 부족 — 펌프(P09) 재질 확인 또는 연동 펌프(P55) 교체도 함께(1.3). |
| P66 | (선택·시음 전 교체용) 식품용 실리콘 튜브 내경4/외경6mm (FDA 또는 LFGB 표기), 1m 단위 | 내경4/외경6mm, 식품 접촉용 표기(FDA 21 CFR 177.2600 또는 LFGB) + 판매처 적합성 자료 확인 | 1 | 0 | 0 |  |  | 선택(구매 안 함) | 국내 쇼핑몰·실험용품점 (디바이스마트 미취급, 확인 필요) | 1.3 시음 조건 / STEP8 배관(P30 자리: 슬리브·노즐 쪽) | P30 대체: 체크밸브 입구 겹침 이음 슬리브 3cm + 밸브 → 노즐 15cm = 펌프당 18cm × 4 = 약 0.72m → 1m. 외경 6mm가 내경5 튜브 안에 꽉 끼어야 겹침 이음이 됨(P30과 같은 치수). 디바이스마트 검색("식품용 실리콘 튜브"·"실리콘 튜브 FDA"·"식품등급"·"Food-Grade", 2026-11-06)에 식품용 표기 실리콘 튜브 없음 → 판매처·가격 확인 필요.  |
| P67 | (선택·시음 전 교체용) 식품용 체크밸브 — 액체용, 내경4 튜브용 바브 (P31과 같은 규격) | 식품 접촉 재질 표기(예: PP 몸통 + 실리콘 덕빌, FDA 21 CFR 177.1520·177.2600 등), 액체용, 바브가 내경4/외경6 튜브에 맞음(P31: 바브 끝 Ø3.2~턱 Ø5.0), 개방압 약 2kPa 이하·내부 유로 Ø2mm 이상 권장 | 4 | 0 | 0 |  |  | 선택(구매 안 함) | 국내 쇼핑몰·실험용품점 (디바이스마트 미취급, 확인 필요) | 1.3 시음 조건 / STEP8 배관 CV1~CV4(P31 자리) | P31 대체(JGB32PPS는 판매처 설명상 "공기용", 재질·식품 적합성 미표기). 4개 + 예비 1 권장(선택 구매 수량 5). 디바이스마트 "체크밸브" 검색 결과(JGB32PPS·JT3205·JGG95ABS 등)는 모두 공기용 설명이고 식품용 표기 제품 없음(2026-11-06) → 판매처·가격 확인 필요. 개방압이 크거나 유로가 좁으면 유량이 줄어드니, 바꾼 뒤 STEP8 누수·역류 테스트와 STEP11 캘리브레이션을 다시 함. 화살표(FLOW)는 노즐 쪽. |
| P68 | (선택·조립 방식) 둥근머리 십자볼트 머신스크류 M3×15 (철, 노란색) | M3, 15mm, 철(상품명 "노란색"), 십자 | 2 | 0 | 0 | 11 | 0 | 선택(구매 안 함) | 디바이스마트 · [34252](https://www.devicemart.co.kr/goods/view?no=34252) | STEP10 절차 1 (선택: 볼트 고정) / STEP9 D 선반 (선택) 구멍 | 전장 박스를 볼트로 고정할 때만(선택, 기본은 벨크로 P64): 뒤쪽 두 모서리(본체 x 약 115·295, y 약 180 — 아래가 용기 칸)만 사용. 볼트가 박스 바닥 + 선반 D(5mm) + 너트(P38 M3)를 지나야 해서 M3×10(P37)은 짧을 수 있음(박스 바닥 두께 실측). 최소주문 10개 → 선택 구매 수량 10(110원). 너트는 P38, 뒤 덮개 H를 열고 용기를 꺼낸 뒤 용기 칸 쪽(D 아래)에서 끼움. 스텐을 원하면 스텐 둥근머리 십자볼트는 15mm가 없어 M3×16(10912300, 33원, 최소 5개). 볼트 고정을 고르면(11-11 주문에는 넣지 않았으므로 따로 주문 — 너트 P38도 예비가 1개뿐이라 2개 더), 선반 D Ø3.5 ×2(STEP9 구멍 표 "D 선반 (선택)", 조립 전)와 박스 바닥 Ø3.5 ×2(STEP5 박스 준비, 속판 달기 전)를 미리 뚫음. 상품 페이지 확인: VAT 별도 10원 / 포함 11원, 평균 준비기간 1~2일(2026-11-06). |
| P69 | (선택·조립 방식) 자석 캐치 추가분 — 상판 C 고정 대안 (P45와 같은 제품) | P45 자석 + P80 철판과 같은 제품 | 4 | 0 | 0 | 1,000 | 0 | 선택(구매 안 함) | 다이소 · [1057293](https://www.daisomall.co.kr/pd/pdr/SCR_PDR_0001?pdNo=1057293) | STEP9 상판 C (선택: 자석 고정) | 상판 C를 볼트(브래킷 캡티브 너트) 대신 자석으로 붙일 때만(선택): P45 자석 1팩 + P80 철판 1팩을 더 삼(4곳이면 각 2팩). 기본(캡티브 너트)이면 불필요. |

### 미사용 (3개 · 추가 구매 0원)

| ID | 부품명 | 규격/모델 | 필요 | 보유 | 구매 | 단가(원) | 금액(원) | 상태 | 구매처 · 상품번호 | 사용 위치 | 비고 |
|---|---|---|---:|---:|---:|---:|---:|---|---|---|---|
| P59 | SparkFun 솔레노이드 5V (small) [ROB-11015] | 5V 솔레노이드 | 0 | 4 | 0 | 14,410 | 0 | 미사용 | 디바이스마트 · [1313586](https://www.devicemart.co.kr/goods/view?no=1313586) | - | 1학기 설계 변경(솔레노이드 제거, 펌프 단독 시간 제어)으로 미사용. |
| P60 | 열 수축 솔더 슬리브 6.0SQ [SZH-CA004] | 6.0SQ(약 10AWG)용 | 0 | 10 | 0 | 440 | 0 | 미사용 | 디바이스마트 · [12507092](https://www.devicemart.co.kr/goods/view?no=12507092) | - | AWG20·펌프 리드선에는 너무 커서 미사용. |
| P61 | DC 플러그 NT10-AF35 (DC 전원 변환 젠더, 수 5.5/2.1mm, 25cm) | 수(Male) 플러그 + 25cm 리드선 | 0 | 1 | 0 | 1,100 | 0 | 미사용 | 디바이스마트 · [1078077](https://www.devicemart.co.kr/goods/view?no=1078077) | - | 현재 설계에서는 불필요(어댑터 → 터미널 DC 암 단자로 직접 연결). 예비/시험용. |

## 4. 추가 구매 목록 (구매처별)

더 살 부품이 없습니다. 이미 산 부품의 링크는 엑셀 `주문_링크` 시트의 '☑ 이미 산 것' 구획에 있습니다.

### 4.1 디바이스마트: 0품목, 합계 0원 (VAT 포함) / 0원 (VAT 별도)

더 살 디바이스마트 부품이 없습니다. 이미 산 내역(거래명세서 대조)은 아래 '이미 결제한 것'에 있습니다.

### 4.2 다이소 · 철물점 · 기타: 0품목

더 살 물건이 없습니다.

## 5. 이미 결제한 것 (2학기)

| 날짜 | 품목 | 구매처 | 수량 | 금액(원) | 상태 | 비고 |
|---|---|---|---|---:|---|---|
| 11-10 | 3D 프린팅 출력 부품 (plate_A 브래킷 01 ×14 + plate_B 나머지 02~07 ×10) | 3DFARM | 2판 | 78,700 | 주문 완료 (배송 예정 11/16) | PETG 흰색 · 0.2mm · 벽 3겹 · 인필 plate_A 50% / plate_B 15%. 실제 결제 78,700원(2026-11-11 사용자 확인) — 업로드 견적 51,000 + 39,000 = 90,000원보다 적음. 판별 금액은 따로 확인하지 않음 |
| 11-10 | 포맥스 5T 흰색 | 포맥스 판매처 | 3장 | 43,000 | 구매 완료 | 600×900 통판인지 맞춤 재단인지 확인 필요(통판이면 직접 재단) |
| 11-11 | 디바이스마트 주문 — 무납땜 기준 35품목 | 디바이스마트 | 35품목 | 102,528 | 주문 완료 (11-11, 배송 대기) | 거래명세서(2026-11-11): 상품 90,480원(VAT 별도) + 배송비 3,000원 → 공급가액 93,207 + 부가세 9,321 = 결제 102,528원(카드). 거래명세서 원본은 개인정보가 있어 저장소에 올리지 않고 팀이 보관(정산용). |
| 11-11 | 다이소 — 무납땜 기준 6품목 | 다이소 | 6품목 | 14,000 | 구매 완료 (11-11) | 결제 14,000원 = 물건 11,000원 + 배송비 3,000원(2026-11-11 사용자 확인). 품목별 금액은 다이소몰 판매가로 나눔. |
| | **합계** | | | **238,228** | | |
| 11-10 | ~~다이소 TARK 직사각 간편 용기 1L 3개입 화이트 (품번 58801)~~ | 다이소 | 4 | (11,000) | 취소·환불 예정 | 약 165×120×80mm라 W420 본체(용기 폭 ≤95mm)에 안 들어감. 금액 구성(상품값·배송비)과 환불 확정액은 영수증으로 확인 (합계 미포함) |

### 디바이스마트 주문 — 무납땜 기준 35품목 (11-11) — 부품별 내역 · BOM 계획 대비

거래명세서의 품명·수량·단가(VAT 별도) 그대로입니다. 거래명세서(2026-11-11): 상품 90,480원(VAT 별도) + 배송비 3,000원 → 공급가액 93,207 + 부가세 9,321 = 결제 102,528원(카드). 거래명세서 원본은 개인정보가 있어 저장소에 올리지 않고 팀이 보관(정산용).

| No | ID | 품명 | 수량 | 단가(원) VAT 별도 | 금액(원) VAT 포함 | BOM 계획 대비 |
|---:|---|---|---:|---:|---:|---|
| 1 | P02 | ESP32 확장보드 터미널쉴드(Push-in 타입) | 1 | 11,000 | 12,100 | BOM 계획과 같음 |
| 2 | P03 | 메탈 푸쉬 스위치 플랫형 [HX16-B1] | 1 | 2,700 | 2,970 | BOM 계획과 같음 |
| 3 | P04 | 회로내장형 액티브 부저 모듈 [ONE005] | 1 | 1,000 | 1,100 | BOM 계획과 같음 |
| 4 | P05 | [5PR3HD19] 원통평면형- 5파이 불투명 LED(빨강) | 2 | 50 | 110 | 단가 계획 61 → 실제 55원(VAT 포함) |
| 5 | P06 | 1/4W 1% Axial Resistor 221F (220Ω) | 10 | 30 | 330 | BOM 계획과 같음 |
| 6 | P07 | Micro USB 5P Cable(1M) | 1 | 700 | 770 | BOM 계획과 같음 |
| 7 | P09 | 수중펌프모터 [SZH-GNP155] | 2 | 2,900 | 6,380 | BOM 계획과 같음 |
| 8 | P15 | 퓨즈 5x20-3A | 3 | 110 | 363 | BOM 계획과 같음 |
| 9 | P16 | E/C 16V 1000uF (105℃)/10X16 | 10 | 90 | 990 | BOM 계획과 같음 |
| 10 | P17 | E/C 16V 100uF (105℃)/5X12 | 10 | 30 | 330 | BOM 계획과 같음 |
| 11 | P18 | 8선 결합 탈피형 커넥터 PCT-418 | 4 | 320 | 1,408 | BOM 계획과 같음 |
| 12 | P73 | 하네스 스위치 (101A-5264) | 1 | 4,300 | 4,730 | BOM 계획과 같음 |
| 13 | P74 | 퓨즈홀더 FH-201 (빨강색) | 1 | 660 | 726 | BOM 계획과 같음 |
| 14 | P24 | UL1007 래핑와이어 22AWG 노랑 10M [VLT-CAB160] | 1 | 3,300 | 3,630 | BOM 계획과 같음 |
| 15 | P27 | 케이블메이트 케이블타이, UN-100MB [소/100mm] [블랙] [1000개] | 1 | 3,400 | 3,740 | BOM 계획과 같음 |
| 16 | P28 | 케이블타이 고정용 마운트 20x20mm [SZ-XL015] | 10 | 120 | 1,320 | 단가 계획 145 → 실제 132원(VAT 포함) |
| 17 | P62 | UL1007 래핑와이어 22AWG 검정 10M [VLT-CAB159] | 1 | 3,300 | 3,630 | BOM 계획과 같음 |
| 18 | P63 | UL1007 래핑와이어 22AWG 빨강 10M [VLT-CAB161] | 1 | 3,300 | 3,630 | BOM 계획과 같음 |
| 19 | P75 | PCT-413 | 10 | 200 | 2,200 | BOM 계획과 같음 |
| 20 | P76 | 2선 결합 탈피형 커넥터 PCT-412 | 10 | 120 | 1,320 | BOM 계획과 같음 |
| 21 | P77 | PCT-415 | 1 | 230 | 253 | BOM 계획과 같음 |
| 22 | P31 | [JG] 체크밸브 : JGB32PPS | 1 | 5,500 | 6,050 | BOM 계획과 같음 |
| 23 | P35 | 화신박스 단자함 EG AGH-152010 | 1 | 11,200 | 12,320 | BOM 계획과 같음 |
| 24 | P37 | 스텐 둥근머리 십자볼트 M3x10 | 25 | 20 | 550 | 수량 계획 30 → 실제 25 |
| 25 | P38 | 육각 너트 (스텐) M3 | 25 | 20 | 550 | 수량 계획 30 → 실제 25 |
| 26 | P39 | M3 알루미늄 서포트 Female 10mm [SZH-ZR059] | 4 | 420 | 1,848 | 단가 계획 508 → 실제 462원(VAT 포함) |
| 27 | P40 | 둥근머리 십자볼트 (니켈) M3x6 | 10 | 10 | 110 | BOM 계획과 같음 |
| 28 | P41 | 고무발/라디오발/S-1/18*10H | 10 | 100 | 1,100 | BOM 계획과 같음 |
| 29 | P42 | 순간접착제 LOCTITE 401 20g | 1 | 4,000 | 4,400 | BOM 계획과 같음 |
| 30 | P43 | 핫멜트스틱(대) 10개 | 1 | 2,000 | 2,200 | BOM 계획과 같음 |
| 31 | P64 | Coms 사각 벨크로테이프 10개입 양면 찍찍이 55x35mm [T9162] | 1 | 1,400 | 1,540 | BOM 계획과 같음 |
| 32 | P48 | 디지털 멀티미터 M300 | 1 | 8,000 | 8,800 | BOM 계획과 같음 |
| 33 | P49 | 와이어 스트리퍼 TU-2022 | 1 | 6,000 | 6,600 | BOM 계획과 같음 |
| 34 | P72 | [건전지] 23A [41mAh/1알] | 1 | 700 | 770 | 단가 계획 700 → 실제 770원(VAT 포함) |
| 35 | P78 | 터미널 압착단자 케이블 [1EA] [CG0731] [2.8mm] (옵션 CG0731 2.8mm 흑색) | 2 | 300 | 660 | BOM 계획과 같음 |
| | | 배송비 | | | 3,000 | 거래명세서 배송비 칸: 1번 줄 0원 · 35번 줄(CG0731, P78) 3,000원(VAT 포함) — CG0731만 따로 배송되는 상품으로 보임 |
| | | **합계** | | | **102,528** | 공급가액 93,207 + 부가세 9,321 |

### 다이소 — 무납땜 기준 6품목 (11-11) — 부품별 내역 · BOM 계획 대비

결제 14,000원 = 물건 11,000원 + 배송비 3,000원(2026-11-11 사용자 확인). 품목별 금액은 다이소몰 판매가로 나눔.

| No | ID | 품명 | 수량 | 단가(원) VAT 포함 | 금액(원) VAT 포함 | BOM 계획 대비 |
|---:|---|---|---:|---:|---:|---|
| 1 | P32 | 직사각 저장 용기 970ml (다이소 1069852) | 5 | 1,000 | 5,000 | BOM 계획과 같음 |
| 2 | P33 | 실리콘 원형 코스터 세트 2개입 (다이소 1038323) | 1 | 1,000 | 1,000 | BOM 계획과 같음 |
| 3 | P45 | 원형 네오디뮴 자석 13mm 3개입 (다이소 1057293) | 1 | 1,000 | 1,000 | BOM 계획과 같음 |
| 4 | P80 | 자석용 보조 설치판 3개입 (다이소 1050101) | 1 | 1,000 | 1,000 | BOM 계획과 같음 |
| 5 | P71 | 오공 초강력 폼 양면테이프 18mm×2m (다이소 1019760) | 1 | 2,000 | 2,000 | BOM 계획과 같음 |
| 6 | P79 | 전기 절연 테이프 19mm×10m 2개입 (다이소 24482) | 1 | 1,000 | 1,000 | BOM 계획과 같음 |
| | | 배송비 | | | 3,000 | 다이소 배송비(택배) — 사용자 확인 |
| | | **합계** | | | **14,000** |  |

## 6. 예산 요약

| 구분 | 금액(원) | 비고 |
|---|---:|---|
| 1학기 실습비 지원 / 집행 / 잔액 | 200,000 / 161,400 / 38,600 | 결과보고서 정산서 기준. 잔액 이월 여부 확인 필요 |
| 경진대회 예선 참가 지원금 | 50,000 | 받았는지·사용 기한 확인 필요 |
| 캡스톤디자인Ⅱ 실습비 | 확인 필요 | 1학기는 200,000원 |
| 2학기 이미 결제 | 238,228 | 3D 프린팅 출력 부품 (plate_A 브래킷 01 ×14 + plate_B 나머지 02~07 ×10) · 포맥스 5T 흰색 · 디바이스마트 주문 — 무납땜 기준 35품목 · 다이소 — 무납땜 기준 6품목 |
| 2학기 앞으로 ① 디바이스마트 | 0 | VAT 포함 (VAT 별도 0) |
| 2학기 앞으로 ② 다이소·철물점·기타 | 0 | 가격 미확인 품목 제외 |
| **2학기 전체** | **238,228** | 선택 구매·공구 구매 제외 |
| (공구 직접 구매) 집에 없으면: 글루건·니퍼 | 11,550 | 글루건 DY-3000 8,360(11mm 스틱 P43용) + 니퍼 TU-C01 3,190 (디바이스마트) |
| (공구 직접 구매) 드릴을 못 빌릴 때 손공구 | 15,990 | 테이퍼 리머 TR-01 11,990(엘레파츠) + 줄 3개 세트 2,000 + 대형 커터칼 2,000(다이소). 손으로 하면 몇 시간 걸림 |

엑셀 `예산` 시트의 노란 칸(재원)을 확인한 값으로 고치면 판단이 자동으로 다시 계산됩니다. 선택 업그레이드(로드셀·연동펌프 등)는 원본 `research/BOM_원본_20261106.md` 4장과 같고 엑셀 `선택_업그레이드` 시트에 그대로 있습니다.

## 7. 확인할 것

- **포맥스 3장**: 600×900 통판이면 직접 재단합니다(커터칼·쇠자 60cm 이상·커팅매트). 맞춤 재단이면 할 일이 없습니다.
- **용기 5개(11-11 구매)**: 4개가 같은 제품인지, 입구가 60mm 이상이고 펌프가 들어가 바닥에 눕는지, 펌프 리드가 입구 위로 약 5cm 이상 나오는지 집에서 확인합니다(제작가이드 2.4). TARK 용기는 취소·환불합니다.
- **디바이스마트 물건이 오면**(11-11 주문) 거래명세서와 수량을 하나씩 맞춰 봅니다(특히 볼트·너트 25개, CG0731 2개, PCT-413·412 10개씩). 모두 왔으면 `bom_variants.json` purchases의 상태를 '구매 완료'로 바꾸고 다시 만듭니다.
- **볼트 P37·너트 P38은 25개씩**(필요 24) — 예비가 1개뿐이니 지퍼백에 따로 보관합니다.
- 단가: 11-11에 산 부품은 거래명세서·구매 금액으로 바꿨습니다. 아직 사지 않은 부품(납땜 기준에서만 더 사는 것·선택 품목)의 단가는 조사 시점(2026-11-06~10) 값입니다.
- 재원(1학기 잔액 이월 38,600원 · 예선 참가 지원금 50,000원 · 캡스톤디자인Ⅱ 실습비)은 아직 확인 전입니다. `예산` 시트 노란 칸을 고치면 판단이 다시 계산됩니다.
- 제작가이드(2026-11-10, `guide/제작가이드_납땜기준.md` · `제작가이드_무납땜기준.md`) 2장 부품표는 이 BOM과 같은 기준입니다. 예전 `조립가이드.md`(2026-11-06)의 부품표는 옛 기준(P32 용기·P36·P44)입니다.
- **TARK 용기 환불액**: 11,000원에 배송비가 들었으면 환불이 적을 수 있습니다. 확정되면 차액을 `지출_완료` 시트에 지출로 넣습니다.
- **펌프 리드 길이**: 레버 커넥터는 방수가 안 되므로 뚜껑 위에서만 잇습니다. 펌프 리드가 뚜껑 위로 3cm 이상 나오는지 먼저 확인합니다.
- **받으면 확인**: PCT-413이 레버형인지, 버튼 단자가 2.8mm 탭인지, 하네스 스위치가 G 사각 구멍에 '딸깍' 걸리는지(약하면 글루건), P73·P74 리드 굵기(AWG22 이상 권장).
- 조립은 `guide/제작가이드_무납땜기준.md`(2026-11-10)를 따릅니다. 예전 `조립가이드.md`는 납땜 기준입니다.
- **버튼 HX16-B1 단자**: 받으면 단자 개수·폭을 잽니다. 2.8mm 탭이 아니면 감아 꼬기(테이프) 또는 학교에서 2곳만 납땜합니다.
- **점퍼 P20·P21 길이**: BOM에 길이가 없습니다. 부저까지 모자라면 F/F + M/F로 잇거나 노랑 UL1007 40cm를 씁니다.
- **시운전 뒤** 뚜껑 위 레버 커넥터가 젖지 않았는지 확인합니다(방수 아님).
- 학과에 **실습실 공구 대여**(드릴·스텝드릴·글루건·니퍼·커터칼/쇠자)가 되는지 먼저 묻습니다. 안 되면 `예산` 시트의 공구 직접 구매 줄을 봅니다.

---
*이 문서와 `BOM_무납땜기준.xlsx`는 `research/canonical_bom.json`과 `research/BOM_원본_20261106.xlsx`(2026-11-06)를 원본으로 `research/make_boms.py`(설정 `research/bom_variants.json`)가 만들었습니다. 엑셀에서 수량이나 단가 칸만 고쳐도 금액·합계·예산이 자동으로 다시 계산됩니다.*
