paperji/smart-bartender/hardware/research/BOM_원본_20261106.md

# BOM (부품 목록) — 사용자의 감정 및 취향 분석 기반 AI 맞춤형 음료 및 칵테일 배합 메이커 (v2)

> **보관본**: 2026-11-06 원본(원래 위치 `hardware/BOM.md`). 아래 본문의 경로는 `hardware/` 기준입니다. BOM 생성기(`make_boms.py`·`make_bom_master.py`)가 이 원본의 엑셀(`BOM_원본_20261106.xlsx`)에서 VAT 별도 단가·보유_미사용·선택_업그레이드·1학기 예산 값을 읽습니다.
> **최신판(2026-11-10)**: 통합판 [`BOM.md`](../BOM.md) · [`BOM_납땜기준.md`](../BOM_납땜기준.md) · [`BOM_무납땜기준.md`](../BOM_무납땜기준.md) — 3D 프린팅 출력 부품·새 용기·이미 결제한 돈을 반영했습니다. 이 문서는 2026-11-06 원본으로 남겨 둡니다.
> 팀 홍당무 · 안양대 정보전기전자공학과 캡스톤디자인Ⅱ · 작성 2026-11-06 · 수정 2026-11-06 (SPEC v2.1 · 경진대회 예선 탈락 반영)
> 엑셀 파일: `BOM_원본_20261106.xlsx`(원래 이름 `BOM.xlsx`). 시트는 BOM_전체 / 추가구매_의뢰서용 / 보유_미사용 / 선택_업그레이드 / 예산 다섯 개입니다. 이 문서와 엑셀은 같은 스크립트로 만들어 내용이 같습니다.
> 근거 자료: `research/parts_research.md`(사양·호환성·재단표), `research/canonical_bom.json`(원본 데이터), `../docs/SPEC.md` v2.1(핀맵), `circuit/회로도.html`(회로 기호), `guide/조립가이드.md`(구멍 위치).

## 0. 한눈에 보기

- 교내 경진대회는 **예선 탈락**이라 급한 일정이 없습니다. 목표는 **기말 시연 · 졸업작품 시제품 · 졸업논문 · 특허**입니다. 부품은 **기말 시연 최소 2~3주 전**에 주문하면 됩니다(6장).
- **새로 사야 하는 품목: 35개**. 디바이스마트 29개, 다이소·철물점·재단 업체 6개입니다.
- **디바이스마트 주문 합계: 79,658원 (VAT 포함)**. VAT를 뺀 금액은 72,418원으로, 학교 의뢰서에 적는 금액입니다(1학기와 같은 기준).
  - 무료배송 기준(66,000원, VAT 포함)을 넘습니다. 기준에 못 미치면 배송비 2,700원이 붙습니다.
  - 이 중 16,474원(11품목)은 사이트 검색 결과로만 확인한 단가입니다. 주문할 때 상품 페이지에서 다시 확인하세요. 이 품목들이 모두 10% 싸게 나와도 무료배송 기준은 넘습니다.
- **가격을 아직 모르는 품목 6개**는 단가 칸을 비워 두었습니다: P32 식품용 밀폐용기 0.7~1.2L, P33 드립 트레이, P34 포맥스, P36 L자 꺾쇠, P44 케이블 그로밋, P45 자석 캐치.
- **전장 박스는 접착식 벨크로(P64, 1,540원)로 선반에 붙이는 것이 기본**이라 필수 구매에 넣었습니다. 볼트로 고정하고 싶으면 선택 품목 P68(M3×15, 110원)을 디바이스마트 주문에 함께 넣으세요(4.2절).
- **식품용 부품으로 바꾸기 전에는 기기에서 나온 액체를 아무도 마시지 않습니다**(조립가이드 1.3). 시연은 색 물로 합니다. 팀원 시음이 꼭 필요할 때만 **선택(시음 전 교체용)** P65·P66·P67(식품용 튜브·체크밸브)을 사세요. 디바이스마트에 없어 가격 확인이 필요합니다(4.2절).
- 공구(인두기·열풍기 등)는 **학교 실습실에서 빌리는 것**을 기준으로 해서 구매 수량을 0으로 두었습니다.
- 표의 단가는 2026-11-06에 조회한 디바이스마트 **VAT 포함** 판매가입니다. 빈칸은 "가격 확인 필요"라는 뜻입니다.

## 1. 전체 BOM (69개 항목, 분류별)

구매 = 추가로 사야 할 수량, 금액 = 구매 × 단가입니다. 상품번호를 누르면 상품 페이지가 열립니다.

### 제어 (7개 · 추가 구매 17,392원)

| ID | 부품명 | 규격/모델 | 필요 | 보유 | 구매 | 단가(원) | 금액(원) | 구매처 · 상품번호 | 사용 위치 | 비고 |
|---|---|---|---:|---:|---:|---:|---:|---|---|---|
| P01 | ESP32 DevKitC WROOM-32D V4 CP2102 개발보드 [CMODULE-40] (Happy House) | 38핀(19핀×2열), 5V·3V3·GND 전원핀, 마이크로USB(CP2102), EN/BOOT 버튼, 사용자 LED 없음(5V 전원 LED만) | 1 | 2 | 0 | 9,900 | 0 | 디바이스마트 · [15313999](https://www.devicemart.co.kr/goods/view?no=15313999) | 회로도 U1 / STEP 전장부(ESP32 장착) | 1개는 고장 대비 예비(펌웨어를 미리 올려 두면 바로 교체 가능, 앱 개발·시험용 겸용). 전원은 USB·5V핀·3V3핀 중 하나만 사용(Espressif 경고). 5V 핀 실크 표기는 "5V". 1학기 구매 단가 8,000원(VAT 별도). |
| P02 | ESP32-DevKitC 터미널 확장보드 Push-in 타입 (ElectroCookie) | ESP32-DevKitC(38핀) 전용 소켓+푸시인 단자대, 스탠드오프·나사·20P 리본케이블 동봉 (보드 외형 치수 확인 필요) | 1 | 0 | **1** | 12,100 | 12,100 | 디바이스마트 · [15223173](https://www.devicemart.co.kr/goods/view?no=15223173) | 회로도 U1 단자 / STEP 전장부 | 대안: CMODULE-47(15315957, 4,400원, 3핀(S/V/G) 헤더형·듀폰 연결, 단자대 아님. 보드 DC잭은 6.5~16V 입력이라 5V 어댑터 연결 금지). DevKitC는 폭이 넓어 830핀 브레드보드 1개에 꽂으면 한쪽 핀 열이 거의 남지 않음. |
| P03 | 메탈 푸쉬 스위치 플랫형 16mm [HX16-B1] (모멘터리) | 일반 PUSH(누르는 동안만 ON), 3A 36VDC, 패널 홀 16mm, 스위치 지름 18mm, LED 없음 | 1 | 0 | **1** | 2,970 | 2,970 | 디바이스마트 · [1325010](https://www.devicemart.co.kr/goods/view?no=1325010) | 회로도 SW2 / 앞판 상부 | GPIO4 ↔ GND (INPUT_PULLUP). 시작/비상정지 버튼. |
| P04 | 회로내장형 액티브 부저 모듈 [ONE005] | DC 3.3~5V, HIGH 입력 시 울림(액티브), 24×21mm, 고정 홀 | 1 | 0 | **1** | 1,100 | 1,100 | 디바이스마트 · [10916337](https://www.devicemart.co.kr/goods/view?no=10916337) | 회로도 BZ1 / 앞판 상부(안쪽) | SPEC상 선택 부품. I/O ← GPIO23, VCC ← TB3(3V3). HIGH=울림이라 SPEC v2.1 펌웨어 기본값 BUZZER_ON_LEVEL 1과 일치. (SZH-SDBJ-006 같은 LOW=울림 모듈을 쓰면 BUZZER_ON_LEVEL 0) |
| P05 | 5mm LED 빨강 원통평면형 불투명 [5PR3HD19] | 5파이, 2V, 20mA | 1 | 0 | **2** | 61 | 122 | 디바이스마트 · [3218](https://www.devicemart.co.kr/goods/view?no=3218) | 회로도 LED1 / 앞판 상부 | DevKitC V4에는 GPIO2 사용자 LED가 없으므로 외부 LED + 220Ω(R1) 필수(SPEC §1). 1개 예비. ※단가 재확인 필요(사이트 검색 결과 값, 상품 페이지 미확인) |
| P06 | 저항 220Ω 1/4W 1% [221F] | 탄소피막, 1/4W, ±1% | 1 | 0 | **10** | 33 | 330 | 디바이스마트 · [2001](https://www.devicemart.co.kr/goods/view?no=2001) | 회로도 R1 | 최소주문 10개. LED 전류 약 6mA. ※단가 재확인 필요(사이트 검색 결과 값, 상품 페이지 미확인) |
| P07 | Micro USB 5핀 데이터 케이블 1m | USB-A ↔ micro-B, 데이터 통신 가능 | 1 | 0 | **1** | 770 | 770 | 디바이스마트 · [32695](https://www.devicemart.co.kr/goods/view?no=32695) | STEP 펌웨어 업로드 | 펌웨어 업로드용. 데이터 전송되는 케이블이 이미 있으면 구매 불필요(충전 전용 케이블은 PC가 인식 못 함). |

### 구동 (3개 · 추가 구매 6,380원)

| ID | 부품명 | 규격/모델 | 필요 | 보유 | 구매 | 단가(원) | 금액(원) | 구매처 · 상품번호 | 사용 위치 | 비고 |
|---|---|---|---:|---:|---:|---:|---:|---|---|---|
| P08 | 아두이노 4채널 5V 릴레이 모듈 [SZH-RLBG-012] | TONGLING JQC-3FF-S-Z 5VDC(코일 약 70Ω≈71mA, 0.36W), 접점 10A 250VAC/10A 30VDC, 채널별 옵토커플러+표시LED, 2핀 JD-VCC/VCC 점퍼(별도 코일 GND핀 없음 → 코일 GND는 메인 헤더 GND), Active-LOW, 76×56mm, M3용 3mm 홀(간격 69.6×49.4mm) | 1 | 2 | 0 | 4,180 | 0 | 디바이스마트 · [1327545](https://www.devicemart.co.kr/goods/view?no=1327545) | 회로도 K1~K4(릴레이 CH1~CH4) / STEP 전장부 | 1개는 예비(펌프 5~8 확장·고장 대비). A안(기본: JD-VCC 점퍼 제거, VCC=3V3)으로 안 켜지면 B안(SPEC 공식 대체안, USB·어댑터를 모두 뺀 상태에서: ① 입력 헤더 VCC ← 3V3 선(⑪)을 먼저 뽑음 → ② 5V 선(⑨)을 JD-VCC 핀에서 빼서 입력 헤더 VCC 핀에 꽂음 → ③ 점퍼 캡을 끼움 (VCC = JD-VCC = 5V, 점퍼가 2핀이라 JD-VCC 핀에는 캡만). B안에서 VCC를 3V3에 연결 금지) — parts_research.md 3.2절. |
| P09 | 수중펌프모터 [SZH-GNP155] | 정격 DC 3V(0.12A·80L/H·양정0.35m) / 4.5V(0.18A·100L/H·양정0.55m), 판매처 5V 연결 안내, 출수구 외경 7.5mm·내경 4.9mm, 본체 약 43×23mm, IP68, 튜브 미포함, 식품등급 표기 없음, 해외입고품(AS 불가) | 4 | 4 | **2** | 3,190 | 6,380 | 디바이스마트 · [1329770](https://www.devicemart.co.kr/goods/view?no=1329770) | 회로도 M1~M4 / STEP 용기·펌프 | qtyToBuy 2 = 고장 대비 예비(권장, 필수 아님 — 기말 시연·논문 실험 중 펌프가 고장 나면 바로 교체). 물 없이 공회전 금지. 식품등급 표기·본체 재질 미확인 → 시음하려면 재질 확인 또는 연동 펌프(P55)로 교체(조립가이드 1.3). |
| P10 | 다이오드 1N4007 | 1A 1000V, DO-41 | 4 | 10 | 0 | 22 | 0 | 디바이스마트 · [3011](https://www.devicemart.co.kr/goods/view?no=3011) | 회로도 D1~D4 | 펌프마다 병렬 1개: 띠(캐소드)→펌프(+)(=릴레이 NO 쪽), 반대쪽(애노드)→펌프(−)(=GND). 위치는 펌프 리드 이음부 또는 연장선의 박스 쪽 끝(전기적으로 동일, SPEC §1). |

### 전원 (8개 · 추가 구매 4,004원)

| ID | 부품명 | 규격/모델 | 필요 | 보유 | 구매 | 단가(원) | 금액(원) | 구매처 · 상품번호 | 사용 위치 | 비고 |
|---|---|---|---:|---:|---:|---:|---:|---|---|---|
| P11 | 아답터 100~240V / 5V 4A [내경2.1~2.5/외경5.5mm] 전원 코드 일체형 | 5V 4A, DC 케이블 150cm, 과전류·과전압·단락 보호 | 1 | 1 | 0 | 8,360 | 0 | 디바이스마트 · [12233458](https://www.devicemart.co.kr/goods/view?no=12233458) | 회로도 어댑터(J1에 꽂음) / STEP 전원 | 최대 소비 추정 약 1.3A(병렬 구동 시) → 여유 충분. 코드 일체형이라 플러그를 뒤판 G의 Ø12 구멍으로 통과시킴 → 플러그 몸통 지름이 12mm 이하인지 실측(확인 필요). |
| P12 | 터미널블럭 to DC 커넥터 (DC2.1 FEMALE) [SZH-LC002] | DC잭 2.1×5.5mm(암), 최대 20A, 1~38V, 나사 단자 | 1 | 2 | 0 | 550 | 0 | 디바이스마트 · [1321144](https://www.devicemart.co.kr/goods/view?no=1321144) | 회로도 J1 / 전장 박스 | 1개 예비. 어댑터 플러그를 꽂는 입력 단자(전장 박스 안). |
| P13 | 로커 스위치 KCD1-101A (ON/OFF, SPST) | 2P, 6A 250VAC / 10A 125VAC | 1 | 0 | **1** | 330 | 330 | 디바이스마트 · [1790](https://www.devicemart.co.kr/goods/view?no=1790) | 회로도 SW1(전원 스위치) / STEP4 뒤판 G 사각 구멍 | 주 전원 스위치(SPEC v2.1 §1: J1(+) → SW1 → F1 → TB1). 패널 사각 구멍 치수는 실물 실측(확인 필요, 몸통 약 19×13mm 추정). STEP4에서 뒤판 G에 구멍을 먼저 뚫고 G 바깥에서 끼운 뒤 G 안쪽에서 납땜(재단된 G판이 STEP4 전에 필요). |
| P14 | 패널형 퓨즈홀더 FH-303 (5×20mm 유리관용) | 10A 250V, 너트 고정형, 납땜 단자 | 1 | 0 | **1** | 583 | 583 | 디바이스마트 · [4577](https://www.devicemart.co.kr/goods/view?no=4577) | 회로도 F1(퓨즈홀더) / STEP4 뒤판 G 둥근 구멍 | J1(+) → SW1 → F1 → TB1(+5V 버스). 장착 구멍 지름 실측(확인 필요, 나사 몸통 약 Ø12~13mm 추정). STEP4에서 뒤판 G 둥근 구멍에 바깥에서 끼우고 안쪽 너트로 고정한 뒤 납땜(SW1과 함께). |
| P15 | 퓨즈 5×20 3A 250V (LB FUSE) | 5파이×20mm, 3A | 1 | 0 | **3** | 121 | 363 | 디바이스마트 · [4537](https://www.devicemart.co.kr/goods/view?no=4537) | 회로도 F1(3A 퓨즈, P14 홀더에 장착) | 2개 예비(예비 퓨즈는 기기와 함께 보관). |
| P16 | 전해 커패시터 16V 1000µF 105℃ (SAMYOUNG, 10×16mm) | 16V / 1000µF / 105℃ / 10×16 DIP | 1 | 0 | **10** | 99 | 990 | 디바이스마트 · [29524](https://www.devicemart.co.kr/goods/view?no=29524) | 회로도 C1 | 최소주문 10개. TB1(+5V) 1번 ↔ TB2(GND) 8번 사이(연결 ⑥). 극성 주의(긴 다리·무표시 쪽 +, 띠 쪽 −). |
| P17 | (선택) 전해 커패시터 16V 100µF 105℃ (5×12mm) | 16V / 100µF / 105℃ | 1 | 0 | **10** | 33 | 330 | 디바이스마트 · [29522](https://www.devicemart.co.kr/goods/view?no=29522) | C2(선택, 회로도 외 보조) / 확장보드 5V–GND | 최소주문 10개. ESP32 확장보드 5V-GND 단자 근처 보조 커패시터(선택, 회로도에는 없음 — ESP32 재부팅이 잦을 때만). ※단가 재확인 필요(사이트 검색 결과 값, 상품 페이지 미확인) |
| P18 | 레버형 전선연결 커넥터 8선 결합 PCT-418 (칩센) | 8구 전부 공통 결선, AWG28~14(0.08~4.0mm²), 단선·연선 가능, 40.1×21×14.4mm | 3 | 0 | **4** | 352 | 1,408 | 디바이스마트 · [10911193](https://www.devicemart.co.kr/goods/view?no=10911193) | 회로도 TB1(+5V)·TB2(GND)·TB3(3V3) / 전장 박스 | 회로도 v3 기준 3개 사용 + 1개 예비. TB1 = +5V 버스(8구 모두: F1 출력④·ESP32 5V⑧·JD-VCC⑨·K1~K4 COM⑰~⑳·C1+⑥), TB2 = GND 버스(J1−⑤·펌프(−)×4 ㉒㉔㉖㉘·C1−⑥, 2구 예비), TB3 = 3V3 분배(ESP32 3V3⑩ → 릴레이 VCC⑪(A안)·부저 VCC㉙). ESP32 GND는 J1(−)에서 바로(⑦, 별형 접지), 다이오드는 펌프 선에 납땜하므로 GND 커넥터는 TB2 하나로 충분. |

### 배선 (12개 · 추가 구매 20,370원)

| ID | 부품명 | 규격/모델 | 필요 | 보유 | 구매 | 단가(원) | 금액(원) | 구매처 · 상품번호 | 사용 위치 | 비고 |
|---|---|---|---:|---:|---:|---:|---:|---|---|---|
| P19 | AWG20 2P 10M (검정, 빨강) | 2심 평행선 AWG20 | 1 | 1 | 0 | 10,340 | 0 | 디바이스마트 · [13003174](https://www.devicemart.co.kr/goods/view?no=13003174) | 전원·펌프 배선 | 5V/GND 전원 배선 + 펌프 리드선 연장(펌프당 약 0.7m × 4 ≈ 2.8m). |
| P20 | 점퍼 케이블 40P (F/F) | 2.54mm 듀폰 | 1 | 1 | 0 | 1,100 | 0 | 디바이스마트 · [32284](https://www.devicemart.co.kr/goods/view?no=32284) | 릴레이 신호선 | 릴레이 IN 헤더 ↔ 확장보드(한쪽 끝을 잘라 피복을 벗겨 푸시인 단자에 삽입). |
| P21 | 점퍼 케이블 40P (M/F) | 2.54mm 듀폰 | 1 | 1 | 0 | 1,100 | 0 | 디바이스마트 · [1113721](https://www.devicemart.co.kr/goods/view?no=1113721) | 릴레이 신호선 | 신호선/시험용. |
| P22 | 점퍼 케이블 40P (M/M) | 2.54mm 듀폰 | 1 | 1 | 0 | 1,100 | 0 | 디바이스마트 · [1113722](https://www.devicemart.co.kr/goods/view?no=1113722) | STEP 벤치 테스트 | 브레드보드 시험용. |
| P23 | 브레드보드 830핀 MB-102 [SZH-BBAD-002] | 830홀 | 1 | 2 | 0 | 1,540 | 0 | 디바이스마트 · [1322408](https://www.devicemart.co.kr/goods/view?no=1322408) | STEP 벤치 테스트 | 조립 전 회로 시험(벤치 테스트)용. 본체에는 미사용. 1학기 정산액(5/5 109,200원)이 의뢰서 합계(108,000원)보다 1,200원 많아, 품절 대체품 [Voltly] 브레드보드 830핀 흰색 VLT-BB016(15960353, 2,000원×2)으로 구매된 것으로 추정 — 실물 확인. |
| P24 | UL1007 래핑와이어 22AWG 10M 노랑 [VLT-CAB160] | UL1007, 22AWG, 노랑 | 1 | 0 | **1** | 3,630 | 3,630 | 디바이스마트 · [15960649](https://www.devicemart.co.kr/goods/view?no=15960649) | 앞판 신호선 ㉙·㉚·㉝·㉟ | 앞판 신호선(㉙ 부저 VCC 연장·㉚ 부저 I/O·㉝ 버튼·㉟ LED)용. 앞판 신호선 ㉙·㉚·㉝·㉟는 모두 이 노랑(연결표와 같음)이고 4가닥이 같은 색이라 선 양 끝 번호 테이프로 구분(㉙는 연결표대로 듀폰 주황으로 이어도 됨). GND선과 5V선은 색을 나눔: GND선(⑦·앞판 GND 공통선 ㉛·㉜·㉞·㊱) = 검정 P62, ESP32 5V선(⑧) = 빨강 P63(같은 시리즈·같은 값). 단가는 상품 페이지 확인(VAT 별도 3,300원). |
| P62 | UL1007 래핑와이어 22AWG 10M 검정 [VLT-CAB159] | UL1007, 22AWG, 검정 | 1 | 0 | **1** | 3,630 | 3,630 | 디바이스마트 · [15960648](https://www.devicemart.co.kr/goods/view?no=15960648) | ESP32 GND ⑦ · 앞판 GND 공통선 ㉛·㉜·㉞·㊱ | ESP32 GND선 ⑦(J1 − 나사 → J3-1, 약 20cm)과 앞판 GND 공통선(㉛ 약 40cm·㉜·㉞·㊱ 짧은 선) — 합계 약 1.5m. ⑦(GND 검정)과 ⑧(5V 빨강, P63)을 색으로 구분해 바꿔 무는 실수(ESP32 역전압)를 막음. 10M 단위 판매. 단가는 상품 페이지 확인(VAT 별도 3,300원). |
| P63 | UL1007 래핑와이어 22AWG 10M 빨강 [VLT-CAB161] | UL1007, 22AWG, 빨강 | 1 | 0 | **1** | 3,630 | 3,630 | 디바이스마트 · [15960650](https://www.devicemart.co.kr/goods/view?no=15960650) | ESP32 5V ⑧ | ESP32 5V선 ⑧(TB1-7 → J2-19, 약 20cm). 검정 P62와 색으로 극성 구분. 10M 단위 판매라 대부분 남음 → 2학기 확장(로드셀·추가 펌프) 전원선으로 활용. 단가는 상품 페이지 확인(VAT 별도 3,300원). |
| P25 | 열 수축 솔더 슬리브 1.0SQ [SZH-CA002] | 납+접착제 내장 수축튜브(무납땜 접속), 1.0SQ용 | 8 | 10 | 0 | 330 | 0 | 디바이스마트 · [12507090](https://www.devicemart.co.kr/goods/view?no=12507090) | 펌프 리드 연장 | 펌프 리드 ↔ AWG20 연장선 접속(펌프당 2개=8개). 열풍기 필요. |
| P26 | NT DIY 열수축튜브 328세트 | 8규격 5색, 40mm 컷팅 | 1 | 0 | **1** | 4,290 | 4,290 | 디바이스마트 · [1320936](https://www.devicemart.co.kr/goods/view?no=1320936) | 배선 절연 | 다이오드 다리·납땜부 절연. |
| P27 | 케이블타이 100mm 1000개 (CableMate UN-100MB 블랙) | 100mm | 1 | 0 | **1** | 3,740 | 3,740 | 디바이스마트 · [1215043](https://www.devicemart.co.kr/goods/view?no=1215043) | 배관·배선 정리 | 튜브-바브 연결부 조임, 배선 정리. ※단가 재확인 필요(사이트 검색 결과 값, 상품 페이지 미확인) |
| P28 | 케이블타이 고정용 접착 마운트 20×20mm [SZ-XL015] | 양면테이프 부착형 | 10 | 0 | **10** | 145 | 1,450 | 디바이스마트 · [1382746](https://www.devicemart.co.kr/goods/view?no=1382746) | 배관 고정 | 최소주문 10개. 선반 아래 체크밸브·튜브 고정. ※단가 재확인 필요(사이트 검색 결과 값, 상품 페이지 미확인) |

### 배관 (5개 · 추가 구매 6,050원)

| ID | 부품명 | 규격/모델 | 필요 | 보유 | 구매 | 단가(원) | 금액(원) | 구매처 · 상품번호 | 사용 위치 | 비고 |
|---|---|---|---:|---:|---:|---:|---:|---|---|---|
| P29 | 실리콘 튜브 1M 내경 5mm (외경 7mm) [K11168275] | 내경5/외경7mm, 1m, 한국산, 식품등급 표기 없음 | 3 | 8 | 0 | 1,870 | 0 | 디바이스마트 · [14115487](https://www.devicemart.co.kr/goods/view?no=14115487) | 배관(펌프→체크밸브) | 펌프 출수구(외경 7.5mm)에 끼움 → 체크밸브 앞까지. 펌프당 약 0.7m(용기 인출 여유 포함). 식품등급 표기 없음 → 시음 전에는 식품용 P65로 교체(선택, 조립가이드 1.3). |
| P30 | 실리콘 튜브 1M 내경 4mm (외경 6mm) [K11168264] | 내경4/외경6mm, 1m, 한국산, 식품등급 표기 없음 | 1 | 5 | 0 | 1,760 | 0 | 디바이스마트 · [14115486](https://www.devicemart.co.kr/goods/view?no=14115486) | 배관(체크밸브↔노즐) | 체크밸브 바브(Ø3.2~5.0)용: ①입구 바브에 3cm 슬리브 → 그 바깥(외경6)에 내경5 튜브를 1.5cm 겹쳐 끼우고 케이블타이 ②출구 → 노즐 약 10cm. 식품등급 표기 없음 → 시음 전에는 식품용 P66으로 교체(선택, 조립가이드 1.3). |
| P31 | 체크밸브 JGB32PPS (JG) | 덕빌형, 개방압 2kPa(약 20cm 물기둥), 배압 3bar, 전장 35.3~35.8mm, 바브 Ø3.2(끝)~5.0(턱), 내부 유로 Ø2.0mm, 판매처 설명상 공기용, 재질/식품적합성 미표기 | 4 | 4 | **1** | 6,050 | 6,050 | 디바이스마트 · [12519260](https://www.devicemart.co.kr/goods/view?no=12519260) | 배관 CV1~CV4 / STEP 배관 | qtyToBuy 1 = 고장·막힘 대비 예비. 화살표(FLOW)가 노즐 쪽을 향하게, 노즐 직전에 설치. 유로 Ø2.0mm라 유량이 크게 줄 수 있음(parts_research.md 3.3절). 판매처 설명상 공기용·재질 미표기 → 시음 전에는 식품용 P67로 교체(선택, 조립가이드 1.3). |
| P32 | 식품용 밀폐용기 0.7~1.2L (PP/트라이탄) | 외곽 ≤ 폭95×깊이135×높이170mm(뚜껑 포함, W420 본체 기준), 뚜껑 입구 폭 ≥ 60mm, 뚜껑은 구멍을 뚫을 수 있는 PP | 4 | 0 | **4** |  |  | [다이소 매장(실측 후 구매)](https://www.daisomall.co.kr/pd/pdr/SCR_PDR_0001?pdNo=58803) | STEP 용기 준비 | W420 본체는 용기 외곽 폭 ≤ 95mm일 때만 4개 일렬 배치 가능. 폭 95 초과~120mm 이하면 본체를 W520으로(parts_research.md 5.4절, 포맥스 재단 전에 결정), 120mm 초과면 다른 용기. 깊이 135mm 초과면 깊이 규칙도 적용. 다이소 1L급 직사각 용기는 대부분 폭 120mm 이상(예: TARK 1L 약 165×120×80mm는 W520 + 깊이 +30 필요, 다이소몰 pdNo=58803) → 매장에서 자로 재고 구매. 뚜껑에 Ø7(튜브)·Ø5(전선)·Ø3(공기, 진공 방지) 구멍. 가격 확인 필요 |
| P33 | 드립 트레이(물받이) ≤ 150×100mm | PP 또는 스테인리스, 세척 가능, 높이 ≤ 15mm 권장 | 1 | 0 | **1** |  |  | 다이소 | STEP 잔 받침 | 비누받침/배수 트레이 등으로 대체 가능. 가격 확인 필요 |

### 외형 (13개 · 추가 구매 25,462원)

| ID | 부품명 | 규격/모델 | 필요 | 보유 | 구매 | 단가(원) | 금액(원) | 구매처 · 상품번호 | 사용 위치 | 비고 |
|---|---|---|---:|---:|---:|---:|---:|---|---|---|
| P34 | 포맥스(PVC 발포보드) 5T 흰색 600×900mm | 5mm 두께, 커터칼 재단 가능 | 3 | 0 | **3** |  |  | [포맥스/아크릴 재단 쇼핑몰(아크리애·정아크릴·DKD아크릴 등) 또는 화방](https://www.acryiae.com/front/product/view.do?productSeq=14) | STEP 외형(재단표 A~N) | 권장: 재단표 부품 치수로 "맞춤 재단 주문"(아크리애 안내 오차 ±1~2mm, 자동견적 → 가격 확인 필요). 뒤판 G는 1주차 STEP4(SW1·F1을 G에 끼운 뒤 납땜)에 필요하므로 STEP1 시작일에 주문. 용기 폭으로 본체 폭(W420/W520)을 정한 뒤 주문. 직접 재단 시 600×900 3장(2장 + 뒤 덮개·예비용 1장). 디바이스마트(하나아크릴) 5T는 300×300~450×450 맞춤재단, 흰색 5T 미확인·일부 색 품절. 가격 확인 필요 |
| P35 | 화신박스 단자함 EG AGH-152010 (150×200×100, 플라스틱 속판 포함) | 전장부 전용 박스(액체와 격리) | 1 | 0 | **1** | 12,320 | 12,320 | 디바이스마트 · [14003437](https://www.devicemart.co.kr/goods/view?no=14003437) | STEP5 전장부 / STEP10 선반 D 위 | 선반 위에 올리고 ESP32·릴레이·분배 커넥터를 내부에 배치. 벽 구멍: 좌·우 Ø12(펌프 선), 뒤 Ø16(어댑터 선·SW1/F1 선), 앞 Ø10(앞판 신호선) — 배선 후 글루건으로 막음. 내부 유효 치수 실측(확인 필요). 선반 D에는 접착식 벨크로(P64) 4쌍으로 고정(기본, 박스 바닥·D에 구멍 없음). 볼트 고정은 선택: 뒤쪽 두 모서리(본체 x 약 115·295, y 약 180)만, M3×15(P68). |
| P36 | L자 꺾쇠(소형, 약 25mm) | 철제, 나사 구멍 2개 | 12 | 0 | **12** |  |  | 다이소/철물점 | STEP 외형 조립 | 패널 모서리 보강 + 상판 탈착 고정. 가격 확인 필요 |
| P37 | 스텐 둥근머리 십자볼트 M3×10 | M3, 10mm, SUS | 40 | 0 | **40** | 22 | 880 | 디바이스마트 · [10912297](https://www.devicemart.co.kr/goods/view?no=10912297) | STEP 외형·전장 | 최소주문 5개. ※단가 재확인 필요(사이트 검색 결과 값, 상품 페이지 미확인) |
| P38 | 육각 너트(스텐) M3 | M3, SUS | 40 | 0 | **40** | 22 | 880 | 디바이스마트 · [10893596](https://www.devicemart.co.kr/goods/view?no=10893596) | STEP 외형·전장 | 최소주문 5개. ※단가 재확인 필요(사이트 검색 결과 값, 상품 페이지 미확인) |
| P39 | M3 알루미늄 서포트 Female 10mm [SZH-ZR059] | M3, 10mm×5mm | 4 | 0 | **4** | 508 | 2,032 | 디바이스마트 · [1382352](https://www.devicemart.co.kr/goods/view?no=1382352) | STEP 전장부 | 릴레이 모듈을 박스 속판에 띄워 고정(속판에 Ø3.2 구멍 4개, 간격 69.6×49.4mm). ESP32 확장보드는 서포트 동봉. ※단가 재확인 필요(사이트 검색 결과 값, 상품 페이지 미확인) |
| P40 | 둥근머리 십자볼트(니켈) M3×6 | M3, 6mm | 8 | 0 | **10** | 11 | 110 | 디바이스마트 · [10912222](https://www.devicemart.co.kr/goods/view?no=10912222) | STEP 전장부 | 서포트 고정용, 최소주문 10개. ※단가 재확인 필요(사이트 검색 결과 값, 상품 페이지 미확인) |
| P41 | 고무발 S-1 18×10H | 지름 18mm, 높이 10mm | 4 | 0 | **10** | 110 | 1,100 | 디바이스마트 · [14882214](https://www.devicemart.co.kr/goods/view?no=14882214) | STEP 외형 | 최소주문 10개. 바닥판 네 모서리. |
| P42 | 순간접착제 LOCTITE 401 20g | 시아노아크릴레이트, 플라스틱용 | 1 | 0 | **1** | 4,400 | 4,400 | 디바이스마트 · [9108](https://www.devicemart.co.kr/goods/view?no=9108) | STEP 외형 조립 | 포맥스 맞대기 접착 + 상판 C 꺾쇠 아래 M3 너트 고정(캡티브 너트, 조립가이드 STEP9). 다이소 순간접착제로 대체 가능. ※단가 재확인 필요(사이트 검색 결과 값, 상품 페이지 미확인) |
| P43 | 핫멜트스틱(대) 10개 | 글루건용 굵은 스틱 | 1 | 0 | **1** | 2,200 | 2,200 | 디바이스마트 · [13187167](https://www.devicemart.co.kr/goods/view?no=13187167) | STEP 외형·배관 | 접착부 보강·관통 구멍 실링(전장 박스 벽 구멍·그로밋 둘레·뚜껑 구멍, 그로밋 대안). 사용 글루건 규격(7mm/11mm) 확인. ※단가 재확인 필요(사이트 검색 결과 값, 상품 페이지 미확인) |
| P44 | 케이블 그로밋(고무 부싱) — Ø20 구멍용 2개 + Ø12 구멍용 1개 | 고무, 패널 두께 5mm용(홈 폭 5mm 이상), 장착 구멍 Ø20 ×2 · Ø12 ×1 | 3 | 0 | **3** |  |  | 철물점/온라인(확인 필요) | STEP 외형(선반 D·뒤판 G) | 조립가이드 STEP9 구멍표 기준: 선반 D Ø20 ×2(펌프 선 통로), 뒤판 G Ø12 ×1(어댑터 선). 뒤판 G는 어댑터 플러그(코드 일체형)를 먼저 Ø12 구멍에 통과시킨 뒤, 그로밋에 칼집을 내어 케이블에 끼우고 구멍에 밀어 넣음(플러그가 그로밋 안지름보다 큼, 추정). 일반 그로밋은 판 두께 1~3mm용이 많아 5mm 포맥스에 맞는 제품이 없으면 사지 않고 글루건으로 구멍 가장자리 마감(대안, 추가 비용 0). 가격 확인 필요 |
| P45 | 자석 캐치(또는 소형 경첩) 2세트 | 가구용 | 2 | 0 | **2** |  |  | 다이소/철물점 | STEP 외형(뒤 덮개) | 뒤 덮개(용기 칸) H 고정용 2개. 상판 C도 자석으로 고정하려면(볼트·캡티브 너트 대신, 선택) P69로 2~4개 추가. 가격 확인 필요 |
| P64 | Coms 사각 벨크로테이프 10조 (접착식 양면 찍찍이) 55×35mm [T9162] | 뒷면 접착(양면테이프), 까끌면+보슬면 한 쌍 × 10조, 55×35mm | 1 | 0 | **1** | 1,540 | 1,540 | 디바이스마트 · [15810228](https://www.devicemart.co.kr/goods/view?no=15810228) | STEP10 절차 1 전장 박스 고정(기본) / 2.3 소모품 | 전장 박스(P35)를 선반 D에 고정하는 기본 방법(조립가이드 2.3 소모품·STEP10 절차 1): 박스 바닥 네 모서리와 D의 같은 자리에 한 쌍씩 = 4쌍 사용(크면 반으로 잘라 씀), 6쌍 예비. 박스 바닥·선반 D에 구멍을 뚫지 않음(박스 앞쪽 모서리 아래는 막힌 빈 공간이라 너트를 끼울 수 없음). 붙일 면의 먼지·기름을 닦고 꾹 눌러 붙임(제품 설명: 거친 면·재사용 시 접착력 떨어짐). 상품 페이지 확인: VAT 별도 1,400원 / 포함 1,540원, 평균 준비기간 3~4일(2026-11-06). |

### 공구 (9개 · 추가 구매 0원)

| ID | 부품명 | 규격/모델 | 필요 | 보유 | 구매 | 단가(원) | 금액(원) | 구매처 · 상품번호 | 사용 위치 | 비고 |
|---|---|---|---:|---:|---:|---:|---:|---|---|---|
| P46 | 실습용 납땜세트B (학교 실습실 대여 가능) | 인두기 30W·인두 스탠드·납흡입기·페이스트·납 50g | 1 | 0 | 0 | 26,400 | 0 | 디바이스마트 · [10894366](https://www.devicemart.co.kr/goods/view?no=10894366) | STEP 공구 준비 | 학교 실습실 대여 가능. 없을 때만 구매. ※단가 재확인 필요(사이트 검색 결과 값, 상품 페이지 미확인) |
| P47 | 일반 실납 1.0mm [SME15510] (학교 실습실 대여 가능) | 1.0mm | 1 | 0 | 0 | 3,190 | 0 | 디바이스마트 · [1171334](https://www.devicemart.co.kr/goods/view?no=1171334) | STEP 공구 준비 | 학교 실습실 대여/지급 확인. ※단가 재확인 필요(사이트 검색 결과 값, 상품 페이지 미확인) |
| P48 | 디지털 멀티미터 M300 (학교 실습실 대여 가능) | DCV ≤500V, DCA ≤200mA, 저항, 도통 | 1 | 0 | 0 | 8,800 | 0 | 디바이스마트 · [10917721](https://www.devicemart.co.kr/goods/view?no=10917721) | STEP 공구 준비 | 전압·극성·도통 확인 필수 도구. ※단가 재확인 필요(사이트 검색 결과 값, 상품 페이지 미확인) |
| P49 | 와이어 스트리퍼 TU-2021 (학교 실습실 대여 가능) | 0.6~2.6mm(약 AWG22~10) | 1 | 0 | 0 | 4,180 | 0 | 디바이스마트 · [1330597](https://www.devicemart.co.kr/goods/view?no=1330597) | STEP 공구 준비 | AWG20/22 피복 제거. ※단가 재확인 필요(사이트 검색 결과 값, 상품 페이지 미확인) |
| P50 | 니퍼 TU-C01 (학교 실습실 대여 가능) | 125mm | 1 | 0 | 0 | 3,190 | 0 | 디바이스마트 · [1287084](https://www.devicemart.co.kr/goods/view?no=1287084) | STEP 공구 준비 | 학교 대여 가능. ※단가 재확인 필요(사이트 검색 결과 값, 상품 페이지 미확인) |
| P51 | 글루건 DY-3000 60W (학교 실습실 대여 가능) | 11mm 스틱용 | 1 | 0 | 0 | 8,360 | 0 | 디바이스마트 · [10931307](https://www.devicemart.co.kr/goods/view?no=10931307) | STEP 공구 준비 | 학교 대여 가능. ※단가 재확인 필요(사이트 검색 결과 값, 상품 페이지 미확인) |
| P52 | 열풍기 D26411 (학교 실습실 대여 가능) | 2단 풍량, 노즐 2개 | 1 | 0 | 0 | 68,200 | 0 | 디바이스마트 · [12171271](https://www.devicemart.co.kr/goods/view?no=12171271) | STEP 공구 준비 | 솔더 슬리브·수축튜브용. 고가 → 학교 대여 권장. ※단가 재확인 필요(사이트 검색 결과 값, 상품 페이지 미확인) |
| P53 | 헬리컬 스텝드릴 4~35mm [K40843729] (학교 실습실 대여 가능) | 생크 6.35mm | 1 | 0 | 0 | 26,070 | 0 | 디바이스마트 · [14117356](https://www.devicemart.co.kr/goods/view?no=14117356) | STEP 공구 준비 | Ø4~25 구멍: 버튼 Ø16·그로밋 Ø20/Ø12·튜브 통로 Ø25·전장 박스 벽 Ø10~16·뚜껑 Ø7/Ø5·LED Ø5·노즐 판 Ø6.5. Ø3(뚜껑 공기 구멍·안내 구멍)·Ø3.2/Ø3.5(M3 볼트)는 일반 드릴 날 사용. 드릴 본체·드릴 날은 학교 대여. ※단가 재확인 필요(사이트 검색 결과 값, 상품 페이지 미확인) |
| P54 | 커터칼(대)·쇠자(60cm)·커팅매트 (학교 실습실 대여 가능) | 포맥스 직접 재단용 | 1 | 0 | 0 |  |  | 다이소/화방 | STEP 외형 | 재단 주문 시 불필요. 가격 확인 필요 |

### 선택 (9개 · 추가 구매 0원)

필요할 때만 사는 품목입니다(구매 0 → 필수 합계에서 빠짐). 업그레이드 P55~P58은 4.1절, 시음 전 교체용·조립 방식 선택 P65~P69 품목은 4.2절에 선택 시 수량·금액이 있습니다.

| ID | 부품명 | 규격/모델 | 필요 | 보유 | 구매 | 단가(원) | 금액(원) | 구매처 · 상품번호 | 사용 위치 | 비고 |
|---|---|---|---:|---:|---:|---:|---:|---|---|---|
| P55 | 연동(페리스탈틱) 펌프 DFRobot Gravity Digital Peristaltic Pump [DFR0523] | 입력 5~6V, 연속 1.8A/피크 2.5A, 서보(PPM) 신호 제어 | 4 | 0 | 0 | 45,540 | 0 | 디바이스마트 · [1377341](https://www.devicemart.co.kr/goods/view?no=1377341) | 2학기 확장/논문 | 액체가 튜브에만 닿아 위생·정량성 우수. 4개면 약 18만원, 전류가 커서 5V 10A급 전원 필요(확인 필요). 대안: Adafruit 12V 연동펌프(14600697, 49,830원, 12V 전원 필요). |
| P56 | HX711 로드셀 24비트 AD 컨버터 모듈 [SZH-SSBH-016] | 2.7~5V | 1 | 0 | 0 | 1,870 | 0 | 디바이스마트 · [1327440](https://www.devicemart.co.kr/goods/view?no=1327440) | 2학기 확장/논문 | 무게 기반 자동 보정(잔 받침 아래 로드셀). |
| P57 | 4선 로드셀 1kg [VLT-LCS002] | 1kg, 4선 | 1 | 0 | 0 | 7,260 | 0 | 디바이스마트 · [15961057](https://www.devicemart.co.kr/goods/view?no=15961057) | 2학기 확장/논문 | HX711과 함께 사용. |
| P58 | MOSFET GPIO 보드 4채널 YYNMOS-4 [SZH-YY012] (AF60N03) | 36V 5A, 단방향 | 1 | 0 | 0 | 19,360 | 0 | 디바이스마트 · [13908386](https://www.devicemart.co.kr/goods/view?no=13908386) | 2학기 확장/논문 | 릴레이 대체·PWM 유량 미세제어. ESP32 3.3V 게이트 구동 가능 여부 확인 필요. PWM 시 플라이백은 1N5819 쇼트키(상품번호 27, 44원, 최소 10) 권장. |
| P65 | (선택·시음 전 교체용) 식품용 실리콘 튜브 내경5/외경7mm (FDA 또는 LFGB 표기), 1m 단위 | 내경5/외경7mm, 식품 접촉용 표기(FDA 21 CFR 177.2600 또는 LFGB) + 판매처 적합성 자료(시험성적서) 확인 | 3 | 0 | 0 |  |  | 국내 쇼핑몰·실험용품점 (디바이스마트 미취급, 확인 필요) | 1.3 시음 조건 / STEP8 배관(P29 자리) | P29 대체(지금 P29는 식품등급 표기 없음 → 바꾸기 전에는 아무도 마시지 않음, 조립가이드 1.3·5장). 펌프 출수구(외경 7.5) → 체크밸브 앞까지 펌프당 약 0.7m × 4 = 약 2.8m → 3m. 디바이스마트 검색("식품용 실리콘 튜브"·"실리콘 튜브 FDA"·"식품등급"·"Food-Grade", 2026-11-06)에 식품용 표기 실리콘 튜브 없음 → 판매처·가격 확인 필요. 시음할 계획(예: 졸업작품 심사)이 정해지면 미리 주문. 튜브·밸브만으로는 부족 — 펌프(P09) 재질 확인 또는 연동 펌프(P55) 교체도 함께(1.3). 가격 확인 필요 |
| P66 | (선택·시음 전 교체용) 식품용 실리콘 튜브 내경4/외경6mm (FDA 또는 LFGB 표기), 1m 단위 | 내경4/외경6mm, 식품 접촉용 표기(FDA 21 CFR 177.2600 또는 LFGB) + 판매처 적합성 자료 확인 | 1 | 0 | 0 |  |  | 국내 쇼핑몰·실험용품점 (디바이스마트 미취급, 확인 필요) | 1.3 시음 조건 / STEP8 배관(P30 자리: 슬리브·노즐 쪽) | P30 대체: 체크밸브 입구 겹침 이음 슬리브 3cm + 밸브 → 노즐 15cm = 펌프당 18cm × 4 = 약 0.72m → 1m. 외경 6mm가 내경5 튜브 안에 꽉 끼어야 겹침 이음이 됨(P30과 같은 치수). 디바이스마트 검색("식품용 실리콘 튜브"·"실리콘 튜브 FDA"·"식품등급"·"Food-Grade", 2026-11-06)에 식품용 표기 실리콘 튜브 없음 → 판매처·가격 확인 필요. 가격 확인 필요 |
| P67 | (선택·시음 전 교체용) 식품용 체크밸브 — 액체용, 내경4 튜브용 바브 (P31과 같은 규격) | 식품 접촉 재질 표기(예: PP 몸통 + 실리콘 덕빌, FDA 21 CFR 177.1520·177.2600 등), 액체용, 바브가 내경4/외경6 튜브에 맞음(P31: 바브 끝 Ø3.2~턱 Ø5.0), 개방압 약 2kPa 이하·내부 유로 Ø2mm 이상 권장 | 4 | 0 | 0 |  |  | 국내 쇼핑몰·실험용품점 (디바이스마트 미취급, 확인 필요) | 1.3 시음 조건 / STEP8 배관 CV1~CV4(P31 자리) | P31 대체(JGB32PPS는 판매처 설명상 "공기용", 재질·식품 적합성 미표기). 4개 + 예비 1 권장(선택 구매 수량 5). 디바이스마트 "체크밸브" 검색 결과(JGB32PPS·JT3205·JGG95ABS 등)는 모두 공기용 설명이고 식품용 표기 제품 없음(2026-11-06) → 판매처·가격 확인 필요. 개방압이 크거나 유로가 좁으면 유량이 줄어드니, 바꾼 뒤 STEP8 누수·역류 테스트와 STEP11 캘리브레이션을 다시 함. 화살표(FLOW)는 노즐 쪽. 가격 확인 필요 |
| P68 | (선택·조립 방식) 둥근머리 십자볼트 머신스크류 M3×15 (철, 노란색) | M3, 15mm, 철(상품명 "노란색"), 십자 | 2 | 0 | 0 | 11 | 0 | 디바이스마트 · [34252](https://www.devicemart.co.kr/goods/view?no=34252) | STEP10 절차 1 (선택: 볼트 고정) / STEP9 D 선반 (선택) 구멍 | 전장 박스를 볼트로 고정할 때만(선택, 기본은 벨크로 P64): 뒤쪽 두 모서리(본체 x 약 115·295, y 약 180 — 아래가 용기 칸)만 사용. 볼트가 박스 바닥 + 선반 D(5mm) + 너트(P38 M3)를 지나야 해서 M3×10(P37)은 짧을 수 있음(박스 바닥 두께 실측). 최소주문 10개 → 선택 구매 수량 10(110원). 너트는 P38, 뒤 덮개 H를 열고 용기를 꺼낸 뒤 용기 칸 쪽(D 아래)에서 끼움. 스텐을 원하면 스텐 둥근머리 십자볼트는 15mm가 없어 M3×16(10912300, 33원, 최소 5개). 볼트 고정을 고르면 디바이스마트 주문에 함께 넣고, 선반 D Ø3.5 ×2(STEP9 구멍 표 "D 선반 (선택)", 조립 전)와 박스 바닥 Ø3.5 ×2(STEP5 박스 준비, 속판 달기 전)를 미리 뚫음. 상품 페이지 확인: VAT 별도 10원 / 포함 11원, 평균 준비기간 1~2일(2026-11-06). |
| P69 | (선택·조립 방식) 자석 캐치 추가분 — 상판 C 고정 대안 (P45와 같은 제품) | 가구용 자석 캐치, P45와 같은 제품 | 4 | 0 | 0 |  |  | 다이소/철물점 | STEP9 상판 C (선택: 자석 고정) | 상판 C를 볼트(꺾쇠 아래 캡티브 너트, STEP9 절차 다 9) 대신 자석으로 붙일 때만(선택): 2~4개 추가(선택 구매 수량은 4 기준). 뒤 덮개 H용 P45 2개와 별도. 볼트 방식이면 불필요. 가격 확인 필요. 가격 확인 필요 |

### 미사용 (3개 · 추가 구매 0원)

| ID | 부품명 | 규격/모델 | 필요 | 보유 | 구매 | 단가(원) | 금액(원) | 구매처 · 상품번호 | 사용 위치 | 비고 |
|---|---|---|---:|---:|---:|---:|---:|---|---|---|
| P59 | SparkFun 솔레노이드 5V (small) [ROB-11015] | 5V 솔레노이드 | 0 | 4 | 0 | 14,410 | 0 | 디바이스마트 · [1313586](https://www.devicemart.co.kr/goods/view?no=1313586) | - | 1학기 설계 변경(솔레노이드 제거, 펌프 단독 시간 제어)으로 미사용. |
| P60 | 열 수축 솔더 슬리브 6.0SQ [SZH-CA004] | 6.0SQ(약 10AWG)용 | 0 | 10 | 0 | 440 | 0 | 디바이스마트 · [12507092](https://www.devicemart.co.kr/goods/view?no=12507092) | - | AWG20·펌프 리드선에는 너무 커서 미사용. |
| P61 | DC 플러그 NT10-AF35 (DC 전원 변환 젠더, 수 5.5/2.1mm, 25cm) | 수(Male) 플러그 + 25cm 리드선 | 0 | 1 | 0 | 1,100 | 0 | 디바이스마트 · [1078077](https://www.devicemart.co.kr/goods/view?no=1078077) | - | 현재 설계에서는 불필요(어댑터 → 터미널 DC 암 단자로 직접 연결). 예비/시험용. |

## 2. 추가 구매 목록 (구매처별)

### 2.1 디바이스마트: 29품목, 합계 79,658원 (VAT 포함) / 72,418원 (VAT 별도)

학교 물품구매의뢰서에는 **VAT 별도 단가**를 적습니다(1학기 의뢰서와 같은 기준). 엑셀 `추가구매_의뢰서용` 시트를 그대로 옮겨 쓰면 됩니다.

| 순번 | ID | 물품 이름 | 상품 번호 | 수량 | 단가 VAT 별도 | 소계 VAT 별도 | 단가 VAT 포함 | 소계 VAT 포함 | 비고 |
|---:|---|---|---|---:|---:|---:|---:|---:|---|
| 1 | P02 | ESP32-DevKitC 터미널 확장보드 Push-in 타입 (ElectroCookie) | [15223173](https://www.devicemart.co.kr/goods/view?no=15223173) | 1 | 11,000 | 11,000 | 12,100 | 12,100 | ESP32 배선용 단자 확장보드 |
| 2 | P03 | 메탈 푸쉬 스위치 플랫형 16mm [HX16-B1] (모멘터리) | [1325010](https://www.devicemart.co.kr/goods/view?no=1325010) | 1 | 2,700 | 2,700 | 2,970 | 2,970 | 시작/비상정지 버튼 |
| 3 | P04 | 회로내장형 액티브 부저 모듈 [ONE005] | [10916337](https://www.devicemart.co.kr/goods/view?no=10916337) | 1 | 1,000 | 1,000 | 1,100 | 1,100 | 완료 알림 부저 |
| 4 | P05 | 5mm LED 빨강 원통평면형 불투명 [5PR3HD19] | [3218](https://www.devicemart.co.kr/goods/view?no=3218) | 2 | 55 | 110 | 61 | 122 | 상태 표시 LED (1개 예비) · 단가 재확인 필요 |
| 5 | P06 | 저항 220Ω 1/4W 1% [221F] | [2001](https://www.devicemart.co.kr/goods/view?no=2001) | 10 | 30 | 300 | 33 | 330 | LED 저항 (최소주문 10개) · 단가 재확인 필요 |
| 6 | P07 | Micro USB 5핀 데이터 케이블 1m | [32695](https://www.devicemart.co.kr/goods/view?no=32695) | 1 | 700 | 700 | 770 | 770 | 펌웨어 업로드용 (데이터 케이블 보유 시 제외) |
| 7 | P09 | 수중펌프모터 [SZH-GNP155] | [1329770](https://www.devicemart.co.kr/goods/view?no=1329770) | 2 | 2,900 | 5,800 | 3,190 | 6,380 | 고장 대비 예비 펌프 (권장) |
| 8 | P13 | 로커 스위치 KCD1-101A (ON/OFF, SPST) | [1790](https://www.devicemart.co.kr/goods/view?no=1790) | 1 | 300 | 300 | 330 | 330 | 주 전원 스위치 |
| 9 | P14 | 패널형 퓨즈홀더 FH-303 (5×20mm 유리관용) | [4577](https://www.devicemart.co.kr/goods/view?no=4577) | 1 | 530 | 530 | 583 | 583 | 퓨즈홀더 (전원 보호) |
| 10 | P15 | 퓨즈 5×20 3A 250V (LB FUSE) | [4537](https://www.devicemart.co.kr/goods/view?no=4537) | 3 | 110 | 330 | 121 | 363 | 3A 퓨즈 (2개 예비) |
| 11 | P16 | 전해 커패시터 16V 1000µF 105℃ (SAMYOUNG, 10×16mm) | [29524](https://www.devicemart.co.kr/goods/view?no=29524) | 10 | 90 | 900 | 99 | 990 | 5V 전원 안정화 (최소주문 10개) |
| 12 | P17 | (선택) 전해 커패시터 16V 100µF 105℃ (5×12mm) | [29522](https://www.devicemart.co.kr/goods/view?no=29522) | 10 | 30 | 300 | 33 | 330 | (선택) 보조 커패시터 (최소주문 10개) · 단가 재확인 필요 |
| 13 | P18 | 레버형 전선연결 커넥터 8선 결합 PCT-418 (칩센) | [10911193](https://www.devicemart.co.kr/goods/view?no=10911193) | 4 | 320 | 1,280 | 352 | 1,408 | TB1 +5V · TB2 GND · TB3 3V3 분배 (1개 예비) |
| 14 | P24 | UL1007 래핑와이어 22AWG 10M 노랑 [VLT-CAB160] | [15960649](https://www.devicemart.co.kr/goods/view?no=15960649) | 1 | 3,300 | 3,300 | 3,630 | 3,630 | 버튼·LED·부저 신호선 (노랑) |
| 15 | P62 | UL1007 래핑와이어 22AWG 10M 검정 [VLT-CAB159] | [15960648](https://www.devicemart.co.kr/goods/view?no=15960648) | 1 | 3,300 | 3,300 | 3,630 | 3,630 | ESP32 GND선 ⑦·앞판 GND 공통선 (검정) |
| 16 | P63 | UL1007 래핑와이어 22AWG 10M 빨강 [VLT-CAB161] | [15960650](https://www.devicemart.co.kr/goods/view?no=15960650) | 1 | 3,300 | 3,300 | 3,630 | 3,630 | ESP32 5V선 ⑧ (빨강) |
| 17 | P26 | NT DIY 열수축튜브 328세트 | [1320936](https://www.devicemart.co.kr/goods/view?no=1320936) | 1 | 3,900 | 3,900 | 4,290 | 4,290 | 배선 절연 |
| 18 | P27 | 케이블타이 100mm 1000개 (CableMate UN-100MB 블랙) | [1215043](https://www.devicemart.co.kr/goods/view?no=1215043) | 1 | 3,400 | 3,400 | 3,740 | 3,740 | 튜브 연결부 조임·배선 정리 · 단가 재확인 필요 |
| 19 | P28 | 케이블타이 고정용 접착 마운트 20×20mm [SZ-XL015] | [1382746](https://www.devicemart.co.kr/goods/view?no=1382746) | 10 | 132 | 1,320 | 145 | 1,450 | 체크밸브·튜브 고정 (최소주문 10개) · 단가 재확인 필요 |
| 20 | P31 | 체크밸브 JGB32PPS (JG) | [12519260](https://www.devicemart.co.kr/goods/view?no=12519260) | 1 | 5,500 | 5,500 | 6,050 | 6,050 | 고장·막힘 대비 예비 체크밸브 |
| 21 | P35 | 화신박스 단자함 EG AGH-152010 (150×200×100, 플라스틱 속판 포함) | [14003437](https://www.devicemart.co.kr/goods/view?no=14003437) | 1 | 11,200 | 11,200 | 12,320 | 12,320 | 전장부 박스 (액체와 격리) |
| 22 | P37 | 스텐 둥근머리 십자볼트 M3×10 | [10912297](https://www.devicemart.co.kr/goods/view?no=10912297) | 40 | 20 | 800 | 22 | 880 | 외형·전장 고정 볼트 · 단가 재확인 필요 |
| 23 | P38 | 육각 너트(스텐) M3 | [10893596](https://www.devicemart.co.kr/goods/view?no=10893596) | 40 | 20 | 800 | 22 | 880 | M3 볼트용 너트 · 단가 재확인 필요 |
| 24 | P39 | M3 알루미늄 서포트 Female 10mm [SZH-ZR059] | [1382352](https://www.devicemart.co.kr/goods/view?no=1382352) | 4 | 462 | 1,848 | 508 | 2,032 | 릴레이 모듈 띄움 고정 · 단가 재확인 필요 |
| 25 | P40 | 둥근머리 십자볼트(니켈) M3×6 | [10912222](https://www.devicemart.co.kr/goods/view?no=10912222) | 10 | 10 | 100 | 11 | 110 | 서포트 고정 볼트 (최소주문 10개) · 단가 재확인 필요 |
| 26 | P41 | 고무발 S-1 18×10H | [14882214](https://www.devicemart.co.kr/goods/view?no=14882214) | 10 | 100 | 1,000 | 110 | 1,100 | 바닥 고무발 (최소주문 10개) |
| 27 | P42 | 순간접착제 LOCTITE 401 20g | [9108](https://www.devicemart.co.kr/goods/view?no=9108) | 1 | 4,000 | 4,000 | 4,400 | 4,400 | 포맥스 접착 · 상판 C 꺾쇠 너트 고정 · 단가 재확인 필요 |
| 28 | P43 | 핫멜트스틱(대) 10개 | [13187167](https://www.devicemart.co.kr/goods/view?no=13187167) | 1 | 2,000 | 2,000 | 2,200 | 2,200 | 접착부 보강 (글루건 스틱 규격 확인) · 단가 재확인 필요 |
| 29 | P64 | Coms 사각 벨크로테이프 10조 (접착식 양면 찍찍이) 55×35mm [T9162] | [15810228](https://www.devicemart.co.kr/goods/view?no=15810228) | 1 | 1,400 | 1,400 | 1,540 | 1,540 | 전장 박스 고정 (접착식 벨크로 10쌍 중 4쌍 사용) |
| | | **합계** | | | | **72,418** | | **79,658** | VAT 포함 기준 무료배송 충족 |

### 2.2 다이소 · 철물점 · 재단 업체: 6품목 (상품번호 없음, 가격 확인 필요)

| 순번 | ID | 물품 | 수량 | 구매처 | 고르는 기준 |
|---:|---|---|---:|---|---|
| 30 | P32 | 식품용 밀폐용기 0.7~1.2L (PP/트라이탄) | 4 | 다이소 매장 | 외곽 폭≤95·깊이≤135·높이≤170mm(W420 본체 기준), 입구≥60mm, PP — 매장에서 자로 실측 후 같은 제품 4개. 폭 95 초과~120mm면 본체 W520 |
| 31 | P33 | 드립 트레이(물받이) ≤ 150×100mm | 1 | 다이소 | 물받이 ≤150×100mm, 높이≤15mm |
| 32 | P34 | 포맥스(PVC 발포보드) 5T 흰색 600×900mm | 3 | 포맥스 재단 쇼핑몰(아크리애·정아크릴·DKD아크릴) 또는 화방 | 용기로 본체 폭(W420/W520)을 정한 뒤 재단표(A~N) 치수로 맞춤 재단 주문 권장 (직접 재단 시 600×900 3장). 뒤판 G는 1주차 STEP4에 필요하므로 일찍 주문 |
| 33 | P36 | L자 꺾쇠(소형, 약 25mm) | 12 | 다이소/철물점 | 약 25mm, 나사 구멍 Ø3.5~4 (M3 볼트용) |
| 34 | P44 | 케이블 그로밋(고무 부싱) — Ø20 구멍용 2개 + Ø12 구멍용 1개 | 3 | 철물점/온라인 | Ø20 구멍용 2(선반 D) + Ø12 구멍용 1(뒤판 G), 패널 5mm용 — 맞는 제품이 없으면 글루건 마감 |
| 35 | P45 | 자석 캐치(또는 소형 경첩) 2세트 | 2 | 다이소/철물점 | 뒤 덮개(용기 칸) 고정 |

- **용기(P32)를 가장 먼저 고르세요. 본체 크기가 용기로 정해집니다.** 기본 본체(W420)는 용기 4개를 한 줄로 넣기 때문에 **용기 외곽 폭이 95mm 이하**(깊이 ≤ 135mm, 높이 ≤ 170mm, 뚜껑 포함)여야 합니다.
  - 폭이 95mm보다 크고 120mm 이하면 본체 폭을 **W520**으로 늘립니다(`research/parts_research.md` 5.4절). 120mm보다 크면 다른 용기를 고르세요. 깊이가 135mm보다 크면 깊이도 같은 만큼 늘려야 합니다.
  - 다이소 1L 직사각 용기는 대부분 폭이 120mm 이상입니다. 매장에 자를 가져가서 직접 재고, **같은 제품 4개**를 사세요.
- **포맥스(P34)**: 용기로 본체 폭(W420/W520)을 정한 다음, `research/parts_research.md` 5.2절 재단표(A~N)의 치수대로 맞춤 재단을 주문하는 것이 가장 정확합니다. 납기와 가격은 쇼핑몰 자동견적으로 확인하세요.
- **그로밋(P44)**: 선반 D의 Ø20 구멍 2개용과 뒤판 G의 Ø12 구멍 1개용입니다(조립가이드 STEP9 구멍표). 그로밋은 1~3mm 판용이 많아서 5mm 포맥스에 맞는 제품이 없을 수 있습니다. 그럴 때는 사지 말고 **글루건으로 구멍 가장자리를 마감**하세요.

## 3. 보유했지만 이번 설계에서 안 쓰는 부품 / 남는 부품

| ID | 부품 | 보유 | 사용 | 남음 | 구분 | 1학기 단가 (VAT 별도) | 활용 아이디어 |
|---|---|---:|---:|---:|---|---:|---|
| P59 | SparkFun 솔레노이드 5V (small) [ROB-11015] | 4 | 0 | 4 | 미사용(설계 변경) | 13,100 | 1학기 설계 변경(솔레노이드 제거 → 펌프 단독 시간 제어)으로 미사용. 이 부품은 액체를 여닫는 '밸브'가 아니라 막대(플런저)를 밀고 당기는 소형 액추에이터이므로 액체 경로에는 쓸 수 없음(제품 설명 확인 권장). 활용: ① 주류 용기 칸 잠금 장치 — 앱 성인 인증(만 19세) 후에만 잠금 해제(예비 릴레이 CH + 1N4007 병렬, 정격 전류 확인 필요), ② 노즐을 톡 쳐서 마지막 방울을 떨어뜨리는 드립 커터, ③ 시연용 동작 데모. 사용하지 않으면 학과 공용 부품으로 반납·기증. |
| P60 | 열 수축 솔더 슬리브 6.0SQ [SZH-CA004] | 10 | 0 | 10 | 미사용(규격 큼) | 400 | 약 10AWG 굵은 전선용이라 AWG20·펌프 리드선에는 너무 큼. 활용: 2학기 연동펌프용 5V 10A급 전원의 굵은 전선(AWG14~12) 접속. |
| P61 | DC 플러그 NT10-AF35 (수 5.5/2.1mm, 25cm) | 1 | 0 | 1 | 미사용 | 1,000 | 어댑터 → DC 암 단자(P12) 직결이라 불필요. 활용: 벤치 시험용 전원 케이블, 2학기 추가 모듈 전원 분기. |
| P01 | ESP32 DevKitC WROOM-32D V4 | 2 | 1 | 1 | 예비 1 | 8,000 | 펌웨어 개발용 두 번째 보드(본체 조립 중에도 앱-BLE 시험), 기말 시연·논문 실험 중 고장 대비 예비 — 펌웨어를 미리 올려 둘 것. |
| P08 | 4채널 5V 릴레이 [SZH-RLBG-012] | 2 | 1 | 1 | 예비 1 | 2,600 | SPEC의 펌프 5~8 확장(GPIO 25·13·18·19), 솔레노이드 잠금 장치·조명 제어, 고장 대비 예비(B안 전환 시험용으로도 사용). |
| P23 | 브레드보드 830핀 | 2 | 0 | 2 | 벤치 테스트 전용 | 1,400 | 조립 전 회로 시험용(본체에는 미사용). 2학기 HX711·로드셀 시험. (1학기 대체품 VLT-BB016 2,000원으로 구매되었을 가능성 — BOM 비고 참고) |
| P12 | 터미널블럭 to DC 커넥터 (DC2.1 FEMALE) | 2 | 1 | 1 | 예비 1 | 500 | 전원 입력 단자 예비. |
| P10 | 다이오드 1N4007 | 10 | 4 | 6 | 예비 6 | 20 | 펌프 추가(5~8)·솔레노이드 플라이백 다이오드. |
| P29 | 실리콘 튜브 내경 5mm (1m) | 8 | 3 | 5 | 예비 약 5m | 1,700 | 위생을 위해 주기적 교체용, 세척용 연장 호스. |
| P30 | 실리콘 튜브 내경 4mm (1m) | 5 | 1 | 4 | 예비 약 4m | 1,600 | 노즐 쪽 튜브 교체용. |
| P25 | 열 수축 솔더 슬리브 1.0SQ | 10 | 8 | 2 | 예비 2 | 300 | 접속 실패 시 재작업용. |
| P22 | 점퍼 케이블 40P (M/M) | 1 | 0 | 1 | 벤치 테스트 전용 | 1,000 | 브레드보드 시험용. |
| | **남는 부품의 1학기 구매 금액 합계** | | | | | **87,920** | 가장 큰 항목은 솔레노이드 4개(52,400원) |

## 4. 선택 구매

이 장의 품목은 필수 구매 합계와 학교 의뢰서에 넣지 않았습니다. 사기로 정하면 엑셀 `추가구매_의뢰서용` 시트에 직접 줄을 추가하세요.

### 4.1 선택 업그레이드 (2학기 확장 · 졸업논문 · 특허 포인트)

필수 부품으로 기본 동작(제조·캘리브레이션)을 먼저 확인한 뒤, 졸업논문 실험과 특허 아이디어용으로 검토하세요. 예산이 확인되면 1순위부터 하나씩 사는 것을 권합니다.

| 우선 | ID | 품목 | 상품번호 | 수량 | 단가(원) | 금액(원) | 기대 효과 (논문 포인트) | 조건 · 주의 |
|---|---|---|---|---:|---:|---:|---|---|
| 1순위 | P56+P57 | HX711 로드셀 AD 모듈 [SZH-SSBH-016] + 4선 로드셀 1kg [VLT-LCS002] | [1327440](https://www.devicemart.co.kr/goods/view?no=1327440) / [15961057](https://www.devicemart.co.kr/goods/view?no=15961057) | 1 | 9,130 | 9,130 | 잔 받침 아래 무게 측정 → ① '시간 제어(개루프) vs 무게 피드백(폐루프)' 추출 정확도 비교 실험(목표량 대비 오차율 %) — 논문 핵심 데이터, ② 캘리브레이션 자동화(10초 구동 후 무게로 ml/s 자동 계산), ③ 잔이 없으면 제조 금지(안전). | GPIO 2개 필요(SPEC 핀맵 확장 필요). 액체 비중(시럽·주류) 보정 필요. 단가 = 1,870 + 7,260 (각 상품 페이지). |
| 2순위 | P55 | DFRobot Gravity 디지털 연동(페리스탈틱) 펌프 [DFR0523] | [1377341](https://www.devicemart.co.kr/goods/view?no=1377341) | 4 | 45,540 | 182,160 | 액체가 튜브 안에서만 이동 → 펌프 내부 오염 없음(식품 위생). 회전수 ∝ 유량이라 양정·점도 영향이 적어 시럽 같은 '이종 점도 액체 정밀 펌핑'(특허 아이디어)과 직결. 수중펌프 vs 연동펌프 유량 안정성 비교 실험. | 4개 약 18만원. 연속 1.8A/피크 2.5A → 4개 동시 구동 시 5V 10A급 전원 필요(아래 U2). 서보(PPM) 신호 제어라 펌웨어 수정 필요. |
| 2순위(P55와 함께) | U2 | 5V 10A급 SMPS (연동펌프 4개 동시 구동용) |  | 1 |  |  | 연동펌프 전원. | 제품·가격 확인 필요. |
| 3순위 | P58 | MOSFET GPIO 보드 4채널 YYNMOS-4 [SZH-YY012] (AF60N03) | [13908386](https://www.devicemart.co.kr/goods/view?no=13908386) | 1 | 19,360 | 19,360 | 릴레이 대체 → 무접점(딸깍 소음·접점 마모 없음), PWM으로 유량 미세 조절 → 목표량 근처에서 감속해 넘침 감소. | ESP32 3.3V 게이트 구동 가능 여부 확인 필요. |
| 3순위(P58과 함께) | U1 | 쇼트키 다이오드 1N5819 (MOSFET PWM용 플라이백) | [27](https://www.devicemart.co.kr/goods/view?no=27) | 10 | 44 | 440 | PWM 구동 시 빠른 플라이백 다이오드. | 최소주문 10개. ※단가 재확인 필요(조사 메모 값). |
| 대안 | U3 | (대안) Adafruit 12V 연동펌프 | [14600697](https://www.devicemart.co.kr/goods/view?no=14600697) | 0 | 49,830 | 0 | P55 대신 사용 가능한 연동펌프. | 12V 전원 별도 필요 → 전원 설계 변경. 수량 0(비교용). |
| 무료 | S1 | (소프트웨어) 잔량 기반 유량 보정 |  | 0 | 0 | 0 | 앱이 아는 잔량(액면 높이)에 따라 유량이 15~20% 변하는 것을 보정 계수로 반영 → 추가 비용 없이 정확도 개선. | 펌웨어·앱 수정만 필요. 로드셀 데이터로 보정 계수 도출 가능. |
| | | **합계 (가격 미확인 제외)** | | | | **211,090** | | |

- **1순위는 로드셀 + HX711(9,130원)** 입니다. 값이 싸고, "시간 제어 vs 무게 피드백" 추출 정확도(오차율) 비교 실험 데이터를 얻을 수 있어 논문 효과가 가장 큽니다.

### 4.2 선택 구매: 시음 전 교체용 · 조립 방식 선택

| 구분 | ID | 품목 | 상품번호 | 수량 | 단가(원) | 금액(원) | 언제 사나 (용도) | 고르는 기준 · 주의 |
|---|---|---|---|---:|---:|---:|---|---|
| 시음 전 교체용 | P65 | 식품용 실리콘 튜브 내경5/외경7mm (FDA 또는 LFGB 표기), 1m 단위 |  | 3 |  |  | 팀원 시음(예: 졸업작품 심사)을 할 때만 — 그 전에는 색 물 시연, 아무도 마시지 않음(조립가이드 1.3). P29(내경5) 대체: 펌프 → 체크밸브 펌프당 약 0.7m × 4 | FDA(21 CFR 177.2600) 또는 LFGB 표기 + 판매처 적합성 자료 확인. 내경5/외경7(펌프 출수구 외경 7.5에 꽉 끼는 규격). 디바이스마트 미취급 → 국내 쇼핑몰·실험용품점에서 찾기 · 가격 확인 필요 |
| 시음 전 교체용 | P66 | 식품용 실리콘 튜브 내경4/외경6mm (FDA 또는 LFGB 표기), 1m 단위 |  | 1 |  |  | P30(내경4) 대체: 체크밸브 입구 슬리브 3cm + 밸브 → 노즐 15cm, 펌프당 18cm × 4 | FDA 또는 LFGB 표기. 내경4/외경6(외경 6이 내경5 튜브 안에 꽉 끼어야 겹침 이음 가능). 디바이스마트 미취급 · 가격 확인 필요 |
| 시음 전 교체용 | P67 | 식품용 체크밸브 — 액체용, 내경4 튜브용 바브 (P31과 같은 규격) |  | 5 |  |  | P31(공기용·재질 미표기) 대체: 4개 + 예비 1. 바꾼 뒤 STEP8 누수·역류 테스트와 STEP11 캘리브레이션 다시 | 식품 접촉 재질 표기(예: PP 몸통 + 실리콘 덕빌), 액체용, 바브가 내경4 튜브에 맞음(P31: Ø3.2~5.0), 개방압 약 2kPa 이하·유로 Ø2mm 이상 권장(작으면 유량 감소). 디바이스마트 미취급 · 가격 확인 필요 |
| 조립 방식 선택 | P68 | 둥근머리 십자볼트 머신스크류 M3×15 (철, 노란색) | [34252](https://www.devicemart.co.kr/goods/view?no=34252) | 10 | 11 | 110 | 전장 박스를 볼트로 고정할 때만(기본은 벨크로 P64): 뒤쪽 두 모서리에 2개 사용, 최소주문 10개. 너트는 P38 | M3×10(P37)은 박스 바닥 + 선반 D 5mm + 너트에 짧을 수 있음. 스텐을 원하면 M3×16(10912300, 33원, 최소 5개). 고르면 디바이스마트 주문에 함께 넣고 D 선반·박스 바닥 Ø3.5 ×2를 조립 전에 뚫기 |
| 조립 방식 선택 | P69 | 자석 캐치 추가분 — 상판 C 고정 대안 (P45와 같은 제품) |  | 4 |  |  | 상판 C를 볼트(캡티브 너트) 대신 자석으로 고정할 때만: 2~4개(4 기준). 뒤 덮개 H용 P45 2개와 별도 | P45와 같은 제품(다이소/철물점). 볼트 방식이면 불필요 · 가격 확인 필요 |
| | | **소계: 시음 전 교체용** | | | | **0** | 가격 확인 필요 3품목 미포함 | |
| | | **소계: 조립 방식 선택** | | | | **110** | 가격 확인 필요 1품목 미포함 | |

- **시음 전 교체용**: 지금 튜브(P29·P30)·체크밸브(P31)는 식품등급 표기가 없어서(체크밸브는 "공기용") **바꾸기 전에는 아무도 마시지 않습니다**. 시음이 꼭 필요하면 ① 이 세 가지로 교체 + 펌프(P09) 재질 확인(또는 연동 펌프 P55로 교체) → ② 조립가이드 STEP12 세척 → ③ **팀원만** 마십니다(조립가이드 1.3). 디바이스마트에는 식품용 표기 제품이 없어(2026-11-06 검색) 판매처·가격을 따로 확인해야 합니다. **FDA·LFGB 표기와 판매처의 적합성 자료(시험성적서)** 를 확인하고, 규격(내경5/외경7, 내경4/외경6, 내경4 튜브용 바브)이 지금 부품과 같은지 봅니다.
- **조립 방식 선택**: 기본 방식(전장 박스 = 벨크로 P64, 상판 C = 꺾쇠 아래 캡티브 너트)이면 살 것이 없습니다. 전장 박스를 볼트로 고정하려면 P68(110원)을 디바이스마트 주문에 넣고, 선반 D와 박스 바닥의 Ø3.5 구멍 2개를 **조립 전에** 뚫어 둡니다. 상판 C를 자석으로 붙이려면 P69를 다이소에서 P45와 함께 삽니다.

## 5. 예산 요약

| 구분 | 금액(원) | 비고 |
|---|---:|---|
| 1학기 실습비 지원 | 200,000 | 캡스톤디자인Ⅰ |
| 1학기 집행: 5/5 물품구매의뢰서 | 109,200 | 의뢰서 합계 108,000원과 1,200원 차이는 브레드보드 대체품 구매로 추정 |
| 1학기 집행: 5/29 추가분 | 52,200 | |
| **1학기 집행 합계** | **161,400** | 결과보고서 정산서 기준 |
| **1학기 잔액** | **38,600** | 2학기로 **이월되는지 확인 필요** |
| 경진대회 예선 참가 지원금 | 50,000 | 팀당. **받았는지·언제까지 쓸 수 있는지 확인 필요**. 식사비·다과비·재료비에 사용. (예선 탈락이라 본선 지원금은 없음) |
| 캡스톤디자인Ⅱ 실습비 | 확인 필요 | 1학기는 200,000원이었음 |
| 2학기 ① 디바이스마트 추가 구매 | 79,658 | VAT 포함. VAT 별도로는 72,418원 |
| 2학기 ② 다이소·철물점·재단 | 가격 확인 필요 | 6품목 |
| (선택) ③ 업그레이드 | 211,090 | 5V 10A SMPS 가격 미포함 |
| (선택) ④ 시음 전 교체용 | 가격 확인 필요 | 식품용 튜브·체크밸브(P65·P66·P67). 시음할 때만 |
| (선택) ⑤ 조립 방식 선택 | 110 + 가격 확인 필요 | 볼트 고정 P68 110원 · 상판 자석 P69. 기본 방식이면 0원 |

### 지출 시나리오

| 시나리오 | 지출 예상(원) | 예선 지원금(50,000원)만 쓸 때 | 1학기 잔액 + 예선 지원금(88,600원)으로 쓸 때 | 빠진 비용 |
|---|---:|---|---|---|
| 1. 필수 구매만 (①, 권장 예비 포함) | 79,658 | **29,658원 부족** | 8,942원 남음 | ② 다이소·재단 비용 미포함 |
| 2. 필수 + 선택 업그레이드 (① + ③) | 290,748 | **240,748원 부족** | **202,148원 부족** | ②·5V 10A SMPS 미포함 |
| (참고) 필수 + 1순위 업그레이드만 (① + 로드셀·HX711) | 88,788 | **38,788원 부족** | **188원 부족** | ② 미포함 |
| (시음할 때) 필수 + 시음 전 교체용 (① + ④) | 79,658 | **29,658원 부족** | 8,942원 남음 | ② 미포함, ④ 가격 미확인 3품목 미포함 |

- **시나리오 1(필수 구매만)**: 예선 지원금만으로는 29,658원이 모자랍니다. 1학기 잔액(38,600원)이 이월되면 합계 88,600원으로 8,942원이 남습니다.
- **시나리오 2(필수 + 선택 업그레이드)**: 290,748원이라 캡스톤디자인Ⅱ 실습비가 있어야 합니다. 실습비가 1학기와 같은 200,000원이라면 합계 288,600원으로 **2,148원이 모자라고**, ② 비용과 SMPS 비용도 빠져 있어 실제로는 더 모자랍니다. 업그레이드는 1순위(로드셀+HX711, 9,130원)부터 하나씩 사세요.
- **(시음할 때)**: ④ 시음 전 교체용 부품은 가격을 아직 몰라 지출 예상이 시나리오 1과 같게 보입니다. 엑셀 `선택_업그레이드` 시트 아래 표에 단가를 넣으면 `예산` 시트의 ④와 이 시나리오가 자동으로 다시 계산됩니다.
- 위 세 가지 재원(1학기 잔액 이월, 예선 참가 지원금, 캡스톤디자인Ⅱ 실습비)은 **모두 아직 확인되지 않았습니다**. 엑셀 `예산` 시트의 노란 칸을 확인한 값으로 고치면 시나리오 판단이 자동으로 바뀝니다.

## 6. 구매 팁

1. **기말 시연 최소 2~3주 전에 주문하세요.** 디바이스마트 준비기간(상품 페이지 표기 1~4일)과 택배, 학교 구매신청 처리 기간이 걸립니다.
   받은 뒤에도 조립·배선·캘리브레이션·시연 연습에 1~2주가 필요하고, 고장 나거나 빠진 부품을 다시 주문할 시간도 있어야 합니다.
2. **돈이 어디서 나오는지 먼저 확인하세요.** 학사지원과나 지도교수님께 다음을 물어보세요.
   ① 1학기 잔액 38,600원이 2학기로 이월되는지, ② 경진대회 예선 참가 지원금 50,000원을 받았는지와 사용 기한, ③ 캡스톤디자인Ⅱ 실습비 금액, ④ 학교 구매신청이 처리되는 데 걸리는 기간.
   오리엔테이션 자료 기준으로 안양캠퍼스 팀은 법인카드를 빌리거나 인터넷 구매신청으로 지원금을 씁니다.
3. **용기(P32)부터 고르세요.** 용기 폭으로 본체 폭(95mm 이하 → W420, 95~120mm → W520)이 정해지고, 그래야 포맥스 재단 치수가 확정됩니다. 디바이스마트 부품은 본체 크기와 상관없어서 따로 먼저 주문해도 됩니다.
4. **디바이스마트는 한 번에 주문하세요.** 66,000원(VAT 포함) 이상이면 무료배송입니다.
   예비 펌프(P09)와 예비 체크밸브(P31)를 모두 빼도 67,228원으로 기준을 넘습니다. 그래도 예비 부품은 기말 시연이나 논문 실험 중에 고장 났을 때 바로 바꿀 수 있으므로 그대로 두는 것을 권합니다.
   VAT 별도 금액(72,418원)으로 계산해도 66,000원을 넘습니다.
5. **장바구니에서 확인할 것**: 품절 여부, 최소주문수량(저항·커패시터·접착 마운트·볼트·고무발은 10개 단위, M3 볼트·너트는 최소 5개), 최종 가격(특히 "단가 재확인 필요" 품목).
6. **Micro USB 케이블(P07)** 은 이미 있으면 빼도 됩니다. 단, 충전 전용 케이블은 PC가 ESP32를 인식하지 못하니 **데이터 전송이 되는 케이블**인지 확인하세요.
7. **다이소·철물점**: 자를 가져가서 용기를 직접 재고 **같은 제품 4개**를 사세요. 드립 트레이, L자 꺾쇠, 자석 캐치도 함께 사면 됩니다. 그로밋은 5mm 판에 맞는지 확인하고, 맞는 게 없으면 글루건 마감으로 대신합니다.
8. **포맥스**: 맞춤 재단은 업체마다 납기가 달라서 주문할 때 확인하세요. 납기가 너무 길면 화방이나 문구점에서 600×900 판을 사서 커터칼로 직접 자르면 됩니다. 판 배치는 `parts_research.md` 5.3절에 있습니다.
   **뒤판 G는 1주차 STEP4에서 필요합니다**(스위치 SW1·퓨즈홀더 F1을 G에 끼운 뒤 납땜). 그래서 포맥스도 STEP1을 시작하는 날 주문하세요.
9. **공구는 학교 실습실에서 빌리세요.** 인두기, 멀티미터, 와이어 스트리퍼, 니퍼, 글루건, 드릴(스텝드릴 + Ø3·Ø3.5 드릴 날)이 필요합니다. 열풍기(68,200원)는 솔더 슬리브를 녹이는 데만 쓰므로 꼭 빌리세요.
10. **받으면 바로 검수하세요.** 수량을 세고, 펌프는 **물에 담근 상태에서만** 5V로 잠깐 돌려 봅니다(공회전 금지). 릴레이는 3.3V 구동(A안) 벤치 테스트를 하고, 안 켜지면 B안으로 바꿉니다(`parts_research.md` 3.2절).
11. **영수증과 거래명세서를 보관하세요.** 결과보고서 실습비 정산서와 지원금 증빙에 필요합니다.
12. **주문 전에 고정 방식을 정하세요.** 전장 박스는 벨크로(P64, 필수 구매에 포함)가 기본이고, 볼트로 하려면 P68을 같이 주문합니다. 상판 C는 캡티브 너트(P37·P38·P42, 추가 구매 없음)가 기본이고, 자석으로 하려면 P69를 다이소에서 삽니다(4.2절).
13. **시음 계획이 있으면 식품용 부품을 미리 사세요.** 졸업작품 심사 등에서 팀원이 맛을 봐야 한다면 P65·P66·P67을 그 전에 주문해 교체하고, 누수 테스트(STEP8)와 캘리브레이션(STEP11)을 다시 합니다. 판매처가 정해지면 BOM 단가 칸을 채우세요.

## 7. 가격 미확인 · 재확인 필요 목록

- **가격 미확인(단가 빈칸, 추가 구매 품목)**: P32, P33, P34, P36, P44, P45. 다이소·철물점·재단 업체 가격은 조사하지 못했습니다.
- **가격 미확인(구매 안 함)**: P54 커터칼·쇠자·커팅매트(공구, 대여), U2 5V 10A SMPS(업그레이드).
- **가격 미확인(선택 구매)**: P65, P66, P67, P69 — 식품용 튜브·체크밸브는 디바이스마트에 식품용 표기 제품이 없어 판매처부터 찾아야 합니다(2026-11-06 검색).
- **단가 재확인 필요(검색 결과 값, 상품 페이지 미확인)**: 추가 구매 품목 중 P05, P06, P17, P27, P28, P37, P38, P39, P40, P42, P43 → 합계 16,474원. 공구 P46~P53, 업그레이드 U1(1N5819)도 같습니다.
- 포맥스 맞춤 재단 가격과 MDF 레이저 커팅 대행 가격도 확인하지 못했습니다.

---
*이 문서와 BOM.xlsx는 `research/canonical_bom.json`을 원본으로 같은 생성 스크립트(make_bom.py)가 만들었습니다. 엑셀에서 수량이나 단가 칸만 고쳐도 금액, 합계, 예산 시트가 자동으로 다시 계산됩니다.*
