paperji/smart-bartender/hardware/research/parts_research.md

# 부품 사양 조사 · 추가 구매처 · 정규 BOM 근거 (AI 스마트 바텐더 v2)

> 팀 홍당무 · 작성 2026-11-06 · 수정 2026-11-06 (SPEC **v2.1** · 회로도 v3 · 조립가이드 구멍표 · 경진대회 예선 탈락 · v2.1 교차검증(릴레이 B안 절차 · 전장 박스 벨크로 고정 · 뒤판 G STEP4 가공 · 시음 전 교체 부품) 반영)
> 기준 문서: `smart-bartender/docs/SPEC.md` (v2.1). 확정 BOM 데이터: `canonical_bom.json` (이 문서의 ID P01~P69 와 동일 — 나중에 추가한 P62·P63 UL1007 검정·빨강, P64 벨크로, P65~P69 선택 구매는 기존 번호를 바꾸지 않으려고 맨 뒤 번호)
> 일정: 교내 경진대회는 **예선 탈락**이라 급한 일정 압박은 없습니다. 목표는 **기말 시연 · 졸업작품 시제품 · 졸업논문 · 특허**입니다.
>
> **가격 표기 규칙**: 디바이스마트 가격은 2026-11-06 조회한 **VAT 포함 판매가**(원)입니다.
> (물품구매의뢰서에 적힌 금액은 VAT 별도 가격이라 10% 차이가 납니다. 예: 펌프 2,900원 → 3,190원)
> 직접 확인하지 못한 값은 **"확인 필요"** 로 적었고, 추측한 값은 **"추정"** 이라고 명시했습니다.
> **가격 검증 상태**: 상품 페이지(판매가 VAT 별도/포함)로 직접 확인한 품목과, 조사 도중 디바이스마트 접속이 차단되어 **사이트 검색 API 값만 확인한 품목**이 섞여 있습니다.
> 후자는 BOM `note`에 `[가격: 디바이스마트 검색 API 값 — 상품 페이지 재확인 필요]`로 표시(구매 품목 중 P05·P06·P17·P27·P28·P37~P40·P42·P43, 공구 P46~P53).
> 페이지와 비교한 품목 중 6개(P03·P04·P13·P14·P15·P24)는 API 값이 페이지 VAT 포함가보다 약 10% 높았기에 페이지 값으로 고쳤습니다(P24: 3,993 → 3,630원). P62·P63(3,630원), P64 벨크로(1,540원), P68 M3×15 볼트(11원)도 상품 페이지 값입니다.

---

## 1. 핵심 결론 (먼저 읽기)

1. **배관 규격**: 펌프 출수구는 **외경 7.5mm / 내경 4.9mm** → 보유한 **내경 5mm(외경 7mm) 튜브**가 맞습니다.
   체크밸브(JGB32PPS) 바브는 **끝 Ø3.2 ~ 턱 Ø5.0mm** → **내경 4mm(외경 6mm) 튜브**가 맞습니다.
   두 튜브는 "내경4 튜브 3cm를 체크밸브에 끼우고 → 그 바깥(외경 6mm)에 내경5 튜브를 겹쳐 끼우기 + 케이블타이" 방식으로
   **추가 어댑터 없이** 연결됩니다(1mm 끼워맞춤).
2. **체크밸브가 유량을 크게 줄입니다(추정)**: 내부 유로가 **Ø2.0mm**, 개방압 **2kPa(약 20cm 물기둥)** 라서
   펌프 유량이 **약 3~6 ml/s(추정)** 로 떨어질 수 있습니다(밸브 없으면 약 10~14 ml/s, 추정). 3.3절 참고.
   → 200ml 한 잔에 약 35~65초. SPEC v2.1에서 **펌프당 최대 구동시간이 120초**로 늘어나, 유량이 **2.5 ml/s 이상**이면 한 재료 최대 300ml(`maxStepMl`)까지 가능합니다(4 ml/s면 300ml에 75초).
3. **릴레이(SZH-RLBG-012)**: 채널마다 옵토커플러가 있고, **JD-VCC 점퍼는 2핀(VCC | JD-VCC)** 형이며 **별도 코일 GND 핀이 없습니다**(코일 GND = 메인 헤더 GND).
   SPEC 기본 **A안**(점퍼 제거, VCC=3.3V, JD-VCC=5V)은 널리 쓰이지만 이 보드는 입력이 "표시 LED + 옵토 LED 직렬" 구조로 보여
   **3.3V에서는 입력 전류가 작아(약 0.3~0.7mA, 추정) 안 켜질 수도** 있습니다. 반드시 벤치 테스트 후, 안 되면 SPEC v2.1 공식 대체안 **B안**(**⑪ 3V3 선을 먼저 뽑고 → ⑨ 5V 선을 JD-VCC 핀에서 입력 헤더 VCC 핀으로 옮기고 → 점퍼 캡을 끼움**, VCC = JD-VCC = 5V, IN=GPIO 직결 — 3.2절)으로 전환. 두 안 모두 Active-LOW라 펌웨어는 같습니다.
4. **ESP32 DevKitC V4**: 38핀, 5V 핀 이름은 **"5V"**, **GPIO2 사용자 LED 없음**(5V 전원 LED만) → 상태 LED는 **외부 LED + 220Ω 필수**.
   보드 폭이 넓어 브레드보드 1개로는 불편 → **ESP32-DevKitC 전용 푸시인 터미널 확장보드(P02)** 를 권장.
5. **추가 구매(디바이스마트)** 합계 **79,658원(VAT 포함, 무료배송 기준 66,000원 이상)**.
   여기에 다이소 용기·드립트레이·L자 꺾쇠·자석 캐치, 포맥스 재단비(가격 확인 필요)가 추가됩니다.
6. **용기 폭이 본체 크기를 정합니다**: 기본 본체 **W420은 용기 외곽 폭 ≤ 95mm일 때만** 용기 4개를 한 줄로 넣을 수 있습니다.
   폭 95mm 초과 ~ 120mm 이하면 본체를 **W520**으로(5.4절), 120mm 초과면 다른 용기를 고릅니다. 다이소 1L급 직사각 용기는 대부분 **폭 120mm 이상**이므로 매장에서 자로 실측하세요.
   **용기를 먼저 정한 뒤** 포맥스 재단(5.2절)을 주문합니다.
7. **부저 ONE005는 HIGH=울림** → SPEC v2.1 펌웨어 기본값 `BUZZER_ON_LEVEL 1`과 일치. 상태 LED는 **외부 LED + 220Ω 필수**(4번).
8. **관통 구멍 지름은 조립가이드와 같습니다**(5.6절 일람). 그로밋(P44)은 선반 D **Ø20 ×2** + 뒤판 G **Ø12 ×1**용이고, 5mm 판에 맞는 제품이 없으면 **글루건 마감**으로 대신합니다.
   뒤판 G의 구멍(Ø12·SW1 사각·F1 둥근)은 **STEP4(1주차)에서 미리 뚫습니다** — SW1·F1을 G 바깥에서 끼운 뒤 G 안쪽에서 납땜해야 하므로, 재단된 G판이 STEP4 전에 있어야 합니다.
9. **전장 박스 고정 = 접착식 벨크로(P64, 필수 구매)** 가 기본입니다. 박스 앞쪽 모서리 아래는 사방이 막힌 빈 공간이라 볼트 너트를 끼울 손이 들어가지 않기 때문입니다. 볼트는 선택이며 **뒤쪽 두 모서리(본체 x 약 115·295, y 약 180 — 아래가 용기 칸)** 만, M3×15(P68) + 너트(P38)로 고정합니다(5.6절).
10. **식품용 부품으로 바꾸기 전에는 기기에서 나온 액체를 아무도 마시지 않습니다**(조립가이드 1.3·5장, 시연은 색 물). 시음이 꼭 필요할 때만 **선택(시음 전 교체용)** P65·P66·P67(식품용 튜브·체크밸브)로 바꾸고 펌프 재질을 확인합니다(3.6절). 디바이스마트에는 식품용 표기 제품이 없어 판매처·가격 확인이 필요합니다.

---

## 2. 보유 부품 사양 (디바이스마트 상품 페이지 확인)

| ID | 부품 | 확인된 사양 | 출처 |
|---|---|---|---|
| P01 | ESP32 DevKitC WROOM-32D V4 CP2102 [CMODULE-40] ×2 | Espressif DevKitC V4 레이아웃, **38핀(J2·J3 각 19핀)**, 전원 3가지(마이크로USB / **5V**+GND 핀 / 3V3+GND 핀) **중 하나만** 사용(Espressif 경고), **5V Power On LED만 있음(사용자 LED 없음)**, GPIO6~11(CLK·D0~D3·CMD)은 플래시용이라 사용 금지 | [상품](https://www.devicemart.co.kr/goods/view?no=15313999), [Espressif 가이드](https://docs.espressif.com/projects/esp-dev-kits/en/latest/esp32/esp32-devkitc/user_guide.html) |
| P08 | 4채널 5V 릴레이 [SZH-RLBG-012] ×2 | 릴레이 **TONGLING JQC-3FF-S-Z 5VDC**, 접점 AC 250V 10A / DC 30V 10A, 동작전압 5V, 채널별 **옵토커플러 + 입력 표시 LED**, 헤더 `GND IN1 IN2 IN3 IN4 VCC`, **2핀 점퍼 `VCC | JD-VCC`**(사진 확대로 확인, 별도 GND 핀 없음), LOW 입력 시 동작(Active-LOW), PCB 76×56mm, 고정홀 Ø3mm(간격 69.6×49.4mm) | [상품](https://www.devicemart.co.kr/goods/view?no=1327545) |
| P08 | (릴레이 코일) | 5V 코일 약 **70Ω → 약 71mA**, 0.36W, 동작전압 3.8V (배포처 데이터, 제조사 원본 미확인 → 확인 필요) | [Futurlec JQC-3FF-05](https://futurlec.com/Relays/JQC-3FF-05.shtml) |
| P09 | 수중펌프 [SZH-GNP155] ×4 | 표: JT-DC3W-3 = **3V 0.12A 0.36W 양정 0.35m 80L/H**, JT-DC3W-4.5 = **4.5V 0.18A 0.91W 양정 0.55m 100L/H**, 기동전압 1V, IP68. 판매처 설명 "빨간선 → 5V". **노즐(출수구) 외경 7.5mm · 내경 4.9mm**, 본체 약 43×23mm, 튜브 미포함, 해외입고(기술지원·AS 불가). 판매처 사진에서 6×9, 5×8 튜브 장착 예시 | [상품](https://www.devicemart.co.kr/goods/view?no=1329770) |
| P31 | 체크밸브 JGB32PPS ×4 | "단방향으로 **공기**를 흐르게 하는 체크밸브", **Open Pressure 2kPa, Back Pressure 3bar**, 요약 "35.3(±0.3)mm × 4.8(±0.3)mm". 도면: 전장 35.8mm, 몸통 Ø10.1, 바브 끝 Ø3.2 / 턱 Ø5.0, 바브 몸통 Ø4.0, **내부 유로 Ø2.0**, 덕빌(오리주둥이) 방식, FLOW 화살표 표시. **재질·식품 적합성 표기 없음(확인 필요)** | [상품](https://www.devicemart.co.kr/goods/view?no=12519260) |
| P30 | 실리콘 튜브 내경 4mm 1M ×5 | **내경 4 / 외경 6mm**, 1m, 원산지 한국(나비PB). 식품등급 표기 없음 | [상품](https://www.devicemart.co.kr/goods/view?no=14115486) |
| P29 | 실리콘 튜브 내경 5mm 1M ×8 | **내경 5 / 외경 7mm**, 1m, 원산지 한국. 식품등급 표기 없음 | [상품](https://www.devicemart.co.kr/goods/view?no=14115487) |
| P61 | DC 플러그 NT10-AF35 ×1 | "DC 전원 변환 젠더 / **MALE** 외경 5.5파이, 내경 2.1파이 / 25cm" (수 플러그 + 리드선) | [상품](https://www.devicemart.co.kr/goods/view?no=1078077) |
| P12 | 터미널블럭 to DC 커넥터 (DC2.1 FEMALE) ×2 | DC잭 2.1×5.5mm(암), 최대허용전류 20A, 허용전압 1~38V, 나사 단자 | [상품](https://www.devicemart.co.kr/goods/view?no=1321144) |
| P11 | 아답터 5V 4A ×1 | 100~240V, 50/60Hz, DC 케이블 150cm, 과전류·과전압·단락 보호, 플러그 내경 2.1~2.5 / 외경 5.5mm | [상품](https://www.devicemart.co.kr/goods/view?no=12233458) |
| P19 | AWG20 2P 10M (검/빨) ×1 | 전원·펌프 연장선 | [상품](https://www.devicemart.co.kr/goods/view?no=13003174) |
| P25/P60 | 열수축 솔더 슬리브 1.0SQ ×10 / 6.0SQ ×10 | 납·접착제 내장 수축튜브(열풍기로 가열하면 납땜+방수 절연). 6.0SQ는 굵은 전선(약 10AWG)용이라 이번 설계엔 미사용 | [1.0SQ](https://www.devicemart.co.kr/goods/view?no=12507090), [6.0SQ](https://www.devicemart.co.kr/goods/view?no=12507092) |
| P10 | 1N4007 ×10 | 1A 1000V 정류 다이오드 | [상품](https://www.devicemart.co.kr/goods/view?no=3011) |
| P59 | SparkFun 솔레노이드 5V ×4 | 설계 변경으로 **미사용** | [상품](https://www.devicemart.co.kr/goods/view?no=1313586) |

---

## 3. 호환성 · 설계 판단

### 3.1 펌프 ↔ 튜브 ↔ 체크밸브 ↔ 노즐 (결론: 보유품만으로 연결 가능)

```
[펌프 출수구 외경 7.5]──내경5/외경7 튜브(약 0.7m)──┐
                                                   │ (겹침 이음 1.5cm + 케이블타이)
                         내경4/외경6 튜브 3cm 슬리브 ┘
                                 │
                     [체크밸브 입구 바브 Ø3.2~5.0]  ▶FLOW▶  [출구 바브]
                                 │
                       내경4/외경6 튜브 약 10cm ── 노즐 플레이트 구멍(Ø6.5) ── 잔
```

| 연결부 | 치수 | 판단 |
|---|---|---|
| 펌프 출수구 ↔ 내경5 튜브 | 출수구 외경 7.5 vs 튜브 내경 5 | **꽉 끼움(권장)**. 판매처도 5×8 튜브 장착 사진 제시. 뜨거운 물에 튜브 끝을 10초 담그면 잘 들어감 |
| 펌프 출수구 ↔ 내경4 튜브 | 7.5 vs 4 | 너무 빡빡함(비권장) |
| 체크밸브 바브 ↔ 내경4 튜브 | 바브 턱 Ø5.0 vs 내경 4 | **적합**. 케이블타이로 한 번 조이면 확실 |
| 체크밸브 바브 ↔ 내경5 튜브 | 바브 턱 Ø5.0 vs 내경 5 | 헐거움 → 직접 연결 비권장 |
| 내경5 튜브 ↔ 내경4 튜브(외경 6) | 6 vs 5 (1mm 겹침) | **겹침 이음 가능**. 1.5cm 이상 겹치고 케이블타이 |

- 체크밸브는 **FLOW 화살표가 노즐 쪽**을 향하게, **노즐 바로 앞(선반 아래)** 에 둡니다. 그러면 펌프가 멈춰도 밸브 아래쪽 튜브에 액체가 차 있어(빨대 위를 손가락으로 막은 효과) 다음 제조 때 바로 나옵니다.
- 개방압 2kPa(약 20cm 물기둥)는 사이펀(저절로 흘러나옴)을 한 번 더 막아 주는 안전장치 역할도 합니다. 그래도 **노즐 출구는 모든 용기의 최대 액면보다 높게**(SPEC 1절) 유지합니다.
- 보유 튜브 수량(내경5 8m, 내경4 5m)은 필요량(약 2.8m, 약 0.6m)보다 충분합니다.

### 3.2 릴레이를 ESP32(3.3V)로 구동 (JD-VCC 점퍼)

- 보드 구조(사진 확인): 헤더 `GND IN1 IN2 IN3 IN4 VCC`, 점퍼 `VCC | JD-VCC` **2핀**. 점퍼를 빼면 **VCC = 입력(옵토) 쪽 전원**, **JD-VCC = 릴레이 코일 전원**. 코일 전류는 **메인 헤더 GND** 로 돌아옵니다(별도 GND 핀 없음) → GND 공통 필수(SPEC과 동일).
- 입력 회로는 통상 `VCC → 1kΩ → 표시LED → 옵토LED → INx` 직렬 구조로 알려져 있습니다(포럼 분석 — 이 보드 회로도 원본은 미확인, **확인 필요**). LED 두 개의 전압강하 합이 약 2.6~3.0V라서:

| 방식 | 연결 | OFF(IN=HIGH 3.3V) | ON(IN=LOW 0V) | 판단 |
|---|---|---|---|---|
| **A안 (SPEC 기본)** | 점퍼 제거, VCC←TB3(ESP32 **3V3**), JD-VCC←TB1(**5V**), GND 공통 | 0V 걸림 → **확실히 OFF** | (3.3−2.6~3.0)/1kΩ ≈ **0.3~0.7mA(추정)** → **켜지지 않을 수 있음** | 먼저 시험 |
| **B안 (SPEC v2.1 공식 대체안)** | USB·어댑터를 모두 뺀 뒤 **① ⑪(VCC ← 3V3)을 먼저 뽑음 → ② ⑨(+5V)를 JD-VCC 핀에서 빼서 입력 헤더 VCC 핀(⑪ 자리)에 꽂음 → ③ 점퍼 캡 끼움** → VCC = JD-VCC = **5V**(JD-VCC 핀에는 캡만), IN←ESP32 GPIO 직결, GND 공통 | 5−3.3=1.7V < LED 합 2.6V → **OFF**(추정) | (5−2.6)/1kΩ ≈ **2.4mA** → 확실히 ON | A안 실패 시 |

- **시험 방법(벤치 테스트)**: 브레드보드에서 A안으로 연결 → `{"cmd":"run","p":1,"ms":2000}` 또는 테스트 스케치로 IN1을 LOW → "딸깍" 소리·표시 LED 확인. 4채널 모두 확인. 안 켜지면 B안. 두 안 모두 Active-LOW라 펌웨어는 그대로입니다.
- **주의(B안)**: 점퍼가 끼워진 상태에서 VCC 핀을 ESP32 **3V3(TB3)에 연결하면 절대 안 됩니다**(5V가 3.3V 레일로 역류). B안에서 릴레이 VCC는 **절대 3V3에 연결하지 않음**(SPEC §1).
- **왜 ⑨를 옮기나(B안)**: 점퍼 헤더는 `VCC | JD-VCC` 2핀이고 점퍼 캡이 두 핀을 모두 덮습니다. 듀폰 선이 꽂힌 핀에는 캡이 들어가지 않으므로 ⑨를 JD-VCC 핀에 둔 채로는 캡을 끼울 수 없고, ⑨를 빼고 캡만 끼우면 릴레이에 5V가 전혀 들어가지 않습니다. 그래서 ⑨를 입력 헤더 VCC 핀으로 옮기고, 캡이 VCC → JD-VCC(코일)로 5V를 넘겨줍니다. **⑪을 먼저 뽑는 이유**: 점퍼와 ⑪이 한순간이라도 함께 연결되면 5V가 ESP32 3V3로 거꾸로 들어갑니다. ⑨가 VCC 핀을 차지하면 ⑪을 다시 꽂을 자리도 없어집니다. 옮긴 뒤 전원 없이 멀티미터 도통 모드로 +5V 레일 ↔ VCC 핀, +5V 레일 ↔ JD-VCC 핀이 모두 "삐"인지 확인합니다(조립가이드 STEP2 절차 라와 같은 순서).
- 부팅 중 GPIO가 입력(High-Z) 상태일 때도 두 방식 모두 입력 LED에 전류가 흐를 경로가 없어 릴레이는 OFF 상태를 유지합니다. 펌웨어는 SPEC v2.1 초기화 순서(출력 레지스터를 먼저 HIGH로 `gpio_set_level` → `pinMode(OUTPUT)` → `digitalWrite(HIGH)`; ESP32 코어 3.x는 `pinMode` 전의 `digitalWrite`를 무시)를 따릅니다.
- 참고 자료: RandomNerdTutorials는 "입력이 약 2V 아래로 내려가면 릴레이 동작"이라 설명하고 3.3V/VIN 모두 사용 가능하다고 함([링크](https://randomnerdtutorials.com/esp32-relay-module-ac-web-server/)). 반면 일부 판매처는 3.3V 안정 동작을 위해 입력 저항(1kΩ→220Ω) 교체가 필요할 수 있다고 안내([Phipps Electronics](https://www.phippselectronics.com/support/5v-2-4-8-channel-relay-modules-with-optocoupler-users-guide/)).

### 3.3 유량 · 양정 추정 (반드시 실측으로 대체할 것)

- 조건: 노즐 출구 높이 230mm(바닥판 윗면 기준), 용기 안 액면 높이 약 150mm(가득) ~ 30mm(거의 빔) → 들어 올리는 높이 약 0.08~0.20m.
  체크밸브 개방압 2kPa ≈ 0.20m, 체크밸브 유로 Ø2.0mm의 국부 손실(손실계수 1~3 가정), 튜브 마찰(내경5 0.7m + 내경4 0.15m) 포함.
  펌프 곡선은 판매처 표(4.5V: 0.55m / 100L/H)를 직선으로 가정, 5V에서는 회전수 비례 가정(양정 ×(5/4.5)², 유량 ×5/4.5).
- 결과(**추정**, 계산 스크립트로 산출):

| 조건 | 가득 찬 용기 | 거의 빈 용기 | 차이 |
|---|---|---|---|
| 5V, 체크밸브 있음(손실계수 1~3) | **약 4~6 ml/s** | 약 3~5 ml/s | 약 20% |
| 5V, 체크밸브 없음 | 약 14 ml/s | 약 12 ml/s | 약 15% |

- 의미:
  1. SPEC 기본 유량값 20 ml/s 는 실제보다 **크게 설정된 값**(실제로 덜 나오는 쪽, 넘치진 않음). **캘리브레이션(펌프 10초 구동 → 실측 ml 입력)은 필수**입니다.
  2. SPEC v2.1의 "한 펌프 구동시간 ≤ **120초**" 기준으로, 유량 4 ml/s면 300ml에 75초라 문제없습니다. 유량이 **2.5 ml/s 미만**이면 300ml 한 스텝이 120초를 넘어 `LIMIT` 오류가 나므로, 양을 줄이거나 4번 선택지를 씁니다.
  3. 액면 높이에 따라 유량이 15~20% 달라질 수 있음 → **캘리브레이션은 용기를 절반쯤 채운 상태에서** 하고, 낮고 넓은 용기가 유리.
  4. 너무 느리면(예: 3 ml/s 미만) 선택지: (a) 체크밸브 제거(노즐 높이 조건 유지, 매 제조 시 튜브 채우는 시간 생김), (b) 유로가 더 큰 체크밸브로 교체(제품 확인 필요), (c) `"mode":"par"` 동시 구동.
  5. 밀폐용기 뚜껑에 **Ø3 공기 구멍**(SPEC §1)이 없으면 퍼낼수록 용기 안이 진공이 되어 유량이 점점 줄어듭니다 → 뚜껑마다 공기 구멍 1개(5.2절 뚜껑 가공).

### 3.4 ESP32 보드 · 확장보드

- 보유 보드는 Espressif ESP32-DevKitC V4와 동일한 핀 배치(사진·핀 표 확인). SPEC 핀맵(GPIO 26/27/32/33, 25/13/18/19, 4, 2, 23)은 모두 일반 GPIO이며 플래시 핀(6~11)과 겹치지 않습니다.
  GPIO2는 부팅 모드 관련(스트래핑) 핀이지만 LED+220Ω을 GND로 연결하는 것은 문제없습니다.
- **P02 ElectroCookie ESP32-DevKitC 터미널쉴드(Push-in)**: DevKitC 전용, 누르고 전선 꽂는 단자, 스탠드오프·나사·20핀 리본케이블 동봉(제품 사진).
  대안 **CMODULE-47**(15315957, 4,400원): "ESP32S 38P/V4" 3핀(S·V·G) 헤더 확장보드, 소켓 간격 24.0/25.5mm 두 종 → DevKitC 호환이지만 **나사/푸시인 단자가 아니라 듀폰선 연결**. 보드의 DC잭은 "DC6.5~16V" 입력(레귤레이터 경유)이라 **5V 어댑터를 거기에 꽂으면 안 됨** → 5V 핀 헤더로 공급.

### 3.5 전원 예산 · 보호

| 부하 | 전류(추정) |
|---|---|
| 펌프 1개 | 약 0.2A (4.5V 정격 0.18A, 5V에서 약간 증가, 기동 순간 더 큼 → 실측 필요) |
| 릴레이 코일 1개 | 약 71mA |
| ESP32 (BLE 동작) | 약 0.1~0.25A |
| **순차 모드 최대** | 약 0.6A |
| **동시 모드 최대(4펌프)** | 약 1.3A + 기동 서지 |

- 5V 4A 어댑터로 충분. **전원 스위치(SW1) + 3A 퓨즈(F1)** 는 SPEC v2.1에 반영됨(배선 단락 시 화재 방지, 시연·실험 안전). 배치: `어댑터(+) → J1 → SW1 → F1(3A) → TB1(+5V 버스)`.
- 1000µF 16V 전해 커패시터 C1은 **TB1 1번(+) ↔ TB2 8번(−)** 사이(연결 ⑥, 릴레이/ESP32 가까이).
- 분배는 **레버형 8구 커넥터 PCT-418**(8구 공통 결선, AWG28~14) **3개 + 예비 1개** (회로도 v3):

| 커넥터 | 역할 | 사용 구 |
|---|---|---|
| **TB1** | **+5V 버스** | 8구 모두: F1 출력④ · ESP32 5V⑧ · JD-VCC⑨(B안: ⑨는 입력 헤더 VCC 핀 → 점퍼 캡 → JD-VCC) · K1~K4 COM⑰~⑳ · C1+⑥ |
| **TB2** | **GND 버스** | J1(−)⑤ · 펌프(−)×4 ㉒㉔㉖㉘ · C1−⑥ (2구 예비) |
| **TB3** | **3V3 분배** | ESP32 3V3⑩ → 릴레이 VCC⑪(A안만) · 부저 VCC㉙ (5구 예비) |
| (예비) | 고장·확장 대비 | — |

- 접지는 **별형(스타)**: J1(−) 나사에서 ⑤ → TB2(펌프 쪽), ⑦ → ESP32 GND로 따로 나누고, 릴레이 GND 핀 → ESP32 GND(⑯). 전기적으로는 모두 공통 GND(SPEC §1). ESP32 GND가 J1에서 바로 가므로 GND 레버 커넥터는 TB2 하나로 충분합니다.
- 플라이백 다이오드(1N4007)는 펌프와 병렬: 캐소드(띠) → 펌프(+)(릴레이 NO 쪽), 애노드 → 펌프(−)(GND 쪽). 위치는 **펌프 리드 이음부 또는 연장선의 박스 쪽 끝**(전기적으로 동일, SPEC §1).

### 3.6 위생(식품 접촉) — 지금 부품으로는 아무도 마시지 않음 · 시음 전 교체 부품

- 펌프(P09)·실리콘 튜브(P29·P30)·체크밸브(P31) 모두 **식품등급 표기가 없습니다**(확인 필요). 체크밸브는 판매처 설명상 "공기"용이고, 펌프 본체·덕빌 고무 재질도 확인되지 않았습니다.
  식품에 닿아도 안전한지는 알코올이 있든 없든 같은 문제입니다.
- 그래서 **식품용 부품으로 바꾸기 전에는 기기에서 나온 액체를 아무도 마시지 않습니다**(조립가이드 1.3·5장). 기말 시연·졸업작품 전시의 시연은 **물이나 식용색소를 탄 색 물을 컵에 따르는 것까지**만 합니다. 학교 시연·전시에서는 주류를 쓰지 않습니다(조립가이드 1.4).
- 시제품은 **처음 사용 전 미지근한 물 + 식초/베이킹소다 세척 → 맑은 물 세척(clean 명령)**, 사용 후 매번 물로 세척합니다(조립가이드 STEP12).
- **시음이 꼭 필요할 때(예: 졸업작품 심사)**: ① 아래 **선택(시음 전 교체용)** 부품으로 교체 + 펌프 재질 확인(또는 연동 펌프 P55로 교체, 7절) → ② STEP12 세척 → ③ **팀원만** 마십니다(조립가이드 1.3). 시음 계획이 정해지면 미리 주문합니다(BOM 4.2절, 엑셀 `선택_업그레이드` 시트 아래 표).

| ID | 교체 부품 (선택) | 바꾸는 부품 | 선택 시 수량 | 고르는 기준 |
|---|---|---|---:|---|
| P65 | 식품용 실리콘 튜브 내경5/외경7mm, 1m 단위 | P29 | 3 (m) | **FDA(21 CFR 177.2600) 또는 LFGB 표기** + 판매처 적합성 자료(시험성적서). 펌프 출수구(외경 7.5)에 꽉 끼는 내경5/외경7 그대로. 펌프당 약 0.7m × 4 |
| P66 | 식품용 실리콘 튜브 내경4/외경6mm, 1m 단위 | P30 | 1 (m) | 같은 표기. 외경 6이 내경5 튜브 안에 꽉 끼어야 겹침 이음이 됨(3.1절). 슬리브 3cm + 밸브 → 노즐 15cm = 펌프당 18cm × 4 |
| P67 | 식품용 체크밸브 (액체용, 내경4 튜브용 바브) | P31 | 5 (4 + 예비 1) | 식품 접촉 재질 표기(예: PP 몸통 + 실리콘 덕빌), 액체용, 바브가 내경4 튜브에 맞음(P31: Ø3.2~5.0), 개방압 약 2kPa 이하·유로 Ø2mm 이상 권장 |

- **구매처**: 디바이스마트 검색("식품용 실리콘 튜브"·"실리콘 튜브 FDA"·"식품등급"·"Food-Grade"·"체크밸브", 2026-11-06)에서 **식품용 표기 실리콘 튜브·체크밸브를 찾지 못했습니다**(체크밸브 JGB32PPS·JT3205·JGG95ABS는 모두 "공기" 용도 설명). 국내 쇼핑몰·실험용품점에서 위 기준으로 찾고, **판매처·가격 확인 필요**. "식품용"이라는 말만 있고 FDA·LFGB 표기나 자료가 없으면 고르지 않습니다.
- 바꾼 뒤에는 개방압·유로가 달라 유량이 바뀔 수 있으므로 **STEP8 누수·역류 테스트와 STEP11 캘리브레이션을 다시** 합니다.
- 고도수 주류(40%)가 펌프 플라스틱(재질 미표기)에 오래 닿아도 되는지는 검증되지 않았습니다. 논문·2학기에는 액체가 튜브에만 닿는 연동 펌프(7절 P55)가 위생 면에서 근본 대책입니다.

---

## 4. 추가 구매 목록 (canonical_bom.json 중 qtyToBuy > 0)

### 4.1 디바이스마트 (합계 **79,658원**, VAT 포함 → 66,000원 이상 **무료배송**, 미만이면 배송비 2,700원)

<!-- BOM_TABLE_START -->
| ID | 품목 | 상품번호 | 수량 | 단가 | 소계 | 비고 |
|---|---|---|---|---|---|---|
| P35 | 화신박스 단자함 EG AGH-152010 (150×200×100, 플라스틱 속판 포함) | 14003437 | 1 | 12,320 | 12,320 | 전장 박스 |
| P02 | ESP32-DevKitC 터미널 확장보드 Push-in 타입 (ElectroCookie) | 15223173 | 1 | 12,100 | 12,100 | 대안 CMODULE-47 4,400원 |
| P09 | 수중펌프모터 [SZH-GNP155] | 1329770 | 2 | 3,190 | 6,380 | 고장 대비 예비(권장) |
| P31 | 체크밸브 JGB32PPS (JG) | 12519260 | 1 | 6,050 | 6,050 | 고장·막힘 대비 예비 |
| P42 | 순간접착제 LOCTITE 401 20g | 9108 | 1 | 4,400 | 4,400 |  |
| P26 | NT DIY 열수축튜브 328세트 | 1320936 | 1 | 4,290 | 4,290 |  |
| P27 | 케이블타이 100mm 1000개 (CableMate UN-100MB 블랙) | 1215043 | 1 | 3,740 | 3,740 |  |
| P24 | UL1007 래핑와이어 22AWG 10M 노랑 [VLT-CAB160] | 15960649 | 1 | 3,630 | 3,630 | 신호선(노랑) |
| P62 | UL1007 래핑와이어 22AWG 10M 검정 [VLT-CAB159] | 15960648 | 1 | 3,630 | 3,630 | GND선 ⑦·앞판 GND(검정) |
| P63 | UL1007 래핑와이어 22AWG 10M 빨강 [VLT-CAB161] | 15960650 | 1 | 3,630 | 3,630 | ESP32 5V선 ⑧(빨강) |
| P03 | 메탈 푸쉬 스위치 플랫형 16mm [HX16-B1] (모멘터리) | 1325010 | 1 | 2,970 | 2,970 | 모멘터리 |
| P43 | 핫멜트스틱(대) 10개 | 13187167 | 1 | 2,200 | 2,200 |  |
| P39 | M3 알루미늄 서포트 Female 10mm [SZH-ZR059] | 1382352 | 4 | 508 | 2,032 |  |
| P64 | Coms 사각 벨크로테이프 10조 (접착식 양면 찍찍이) 55×35mm [T9162] | 15810228 | 1 | 1,540 | 1,540 | 전장 박스 고정(벨크로 기본) |
| P28 | 케이블타이 고정용 접착 마운트 20×20mm [SZ-XL015] | 1382746 | 10 | 145 | 1,450 | 최소 10 |
| P18 | 레버형 전선연결 커넥터 8선 결합 PCT-418 (칩센) | 10911193 | 4 | 352 | 1,408 | TB1 +5V · TB2 GND · TB3 3V3 + 예비 1 |
| P04 | 회로내장형 액티브 부저 모듈 [ONE005] | 10916337 | 1 | 1,100 | 1,100 | HIGH=울림 |
| P41 | 고무발 S-1 18×10H | 14882214 | 10 | 110 | 1,100 | 최소 10 |
| P16 | 전해 커패시터 16V 1000µF 105℃ (SAMYOUNG, 10×16mm) | 29524 | 10 | 99 | 990 | 최소 10 |
| P37 | 스텐 둥근머리 십자볼트 M3×10 | 10912297 | 40 | 22 | 880 |  |
| P38 | 육각 너트(스텐) M3 | 10893596 | 40 | 22 | 880 |  |
| P07 | Micro USB 5핀 데이터 케이블 1m | 32695 | 1 | 770 | 770 | 보유 시 제외 |
| P14 | 패널형 퓨즈홀더 FH-303 (5×20mm 유리관용) | 4577 | 1 | 583 | 583 |  |
| P15 | 퓨즈 5×20 3A 250V (LB FUSE) | 4537 | 3 | 121 | 363 |  |
| P06 | 저항 220Ω 1/4W 1% [221F] | 2001 | 10 | 33 | 330 | 최소 10 |
| P13 | 로커 스위치 KCD1-101A (ON/OFF, SPST) | 1790 | 1 | 330 | 330 |  |
| P17 | (선택) 전해 커패시터 16V 100µF 105℃ (5×12mm) | 29522 | 10 | 33 | 330 | 선택, 최소 10 |
| P05 | 5mm LED 빨강 원통평면형 불투명 [5PR3HD19] | 3218 | 2 | 61 | 122 |  |
| P40 | 둥근머리 십자볼트(니켈) M3×6 | 10912222 | 10 | 11 | 110 | 최소 10 |
| | **합계** | | | | **79,658** | |
<!-- BOM_TABLE_END -->

- 위 합계 중 **16,474원**은 검색 API 가격(페이지 재확인 필요) 품목입니다. 이 품목들이 모두 10% 낮더라도 합계는 약 78,000원으로 **무료배송 기준(66,000원)을 넘습니다**.
- **UL1007 22AWG는 노랑(P24)·검정(P62)·빨강(P63) 각 1롤**입니다. 조립가이드 연결표의 ⑦ ESP32 GND = 검정, ⑧ ESP32 5V = 빨강, 앞판 GND 공통선(㉛·㉜·㉞·㊱) = 검정을 색으로 지키기 위해서입니다(두 선을 바꿔 물면 ESP32에 역전압). 나머지 UL1007 신호선(㉙·㉚·㉝·㉟)은 노랑 + 선 양 끝 번호 테이프로 구분합니다. 검정·빨강은 기존 번호(P01~P61)를 바꾸지 않으려고 맨 뒤 번호 P62·P63을 붙였고, BOM 표에서는 P24 바로 뒤에 놓았습니다. 세 상품 모두 상품 페이지에서 VAT 별도 3,300원 / VAT 포함 3,630원, 평균 준비기간 3~4일을 확인했습니다(2026-11-06).
- **P64 접착식 벨크로**(Coms T9162, 55×35mm 까끌면+보슬면 10쌍, 1,540원)는 전장 박스를 선반 D에 붙이는 **기본 고정 방법**이라 필수 구매에 넣었습니다(조립가이드 2.3·STEP10). 4쌍(박스 바닥 네 모서리)을 쓰고 6쌍은 예비입니다. 디바이스마트의 다른 "벨크로" 상품은 대부분 케이블 묶음용(고리형·롤타이)이라 뒷면 접착식 사각 패드를 골랐습니다(상품 페이지·상세 이미지 확인: "양면Tape/찍찍이, 10조, 55×35").
- 주문 전에 장바구니에서 **품절·최소주문수량·최종 가격**을 다시 확인하세요(조회 시점 기준 모두 판매 '정상' 상태. 단, P62·P63은 판매 상태를 확인하지 못함).
- 상품별 평균 준비기간은 페이지 표기 **1~4일** → 택배·학교 구매신청 처리 기간과 조립·캘리브레이션·시연 연습(1~2주)을 생각해 **기말 시연 최소 2~3주 전 주문** 권장.
- 예산(1학기 잔액 38,600원 이월 여부, 경진대회 예선 참가 지원금 50,000원 수령 여부·사용 기한, 캡스톤디자인Ⅱ 실습비 금액)은 모두 확인 필요 → `../BOM.xlsx` `예산` 시트와 `../BOM.md` 5장.
- 같은 품목을 엘레파츠·아이씨뱅큐 등에서도 찾을 수 있으나 이번 조사에서는 가격·재고를 확인하지 않았습니다.

### 4.2 다이소 · 철물점 · 재단 업체 (가격 확인 필요)

| ID | 품목 | 수량 | 구매처 | 기준 |
|---|---|---|---|---|
| P32 | 식품용 밀폐용기 0.7~1.2L | 4 | 다이소 매장(자 들고 가서 실측) | 외곽 **폭 ≤95 × 깊이 ≤135 × 높이 ≤170mm**(W420 본체 기준), 뚜껑 입구 ≥60mm, PP. 폭 95 초과~120mm면 본체 W520(5.4절) |
| P33 | 드립 트레이 | 1 | 다이소 | ≤150×100mm, 높이 ≤15mm |
| P34 | 포맥스 5T 흰색 600×900 | 3 (직접 재단 시) | 재단 쇼핑몰([아크리애](https://www.acryiae.com/front/product/view.do?productSeq=14), [정아크릴](https://jungacryl.com/), [DKD아크릴](https://www.aquaself.net/goods/goods_view.php?goodsNo=1616)) 또는 화방 | **5.2절 재단표 그대로 맞춤 재단 주문 권장**(아크리애: 10~1200mm 입력, ±1~2mm, 900×900 초과는 방문/퀵). **뒤판 G는 1주차 STEP4에 필요** → STEP1 시작일에 주문 |
| P36 | L자 꺾쇠 25mm 내외 | 12 | 다이소/철물점 | 나사 구멍 Ø3.5~4 |
| P44 | 고무 그로밋: **Ø20 구멍용 2**(선반 D) + **Ø12 구멍용 1**(뒤판 G) | 3 | 철물점/온라인 | 패널 두께 5mm용(홈 폭 ≥5mm). 맞는 제품이 없으면 사지 않고 **글루건으로 구멍 가장자리 마감** |
| P45 | 자석 캐치 또는 소형 경첩 | 2 | 다이소/철물점 | 뒤 덮개 H 고정. 상판 C도 자석으로 고정하면 같은 제품 2~4개 추가(P69, 선택 — 4.4절) |

- 디바이스마트(하나아크릴) 포맥스 5T는 300×300~450×450 맞춤 재단 상품이며, 흰색 5T는 확인되지 않았고 검정·회색·초록은 품절(조회 시점).
- MDF 레이저 커팅 대행은 국내 가격을 확인하지 못했습니다(확인 필요). 학교/지역 메이커스페이스 레이저커터 이용 시 아래 재단표를 DXF로 옮겨 사용 가능. MDF는 물에 약하므로 수성 바니시·시트지 마감, 5~6T 권장.

### 4.3 공구 (학교 실습실 대여 우선 — BOM에서는 qtyToBuy 0)

인두기 세트(P46, 26,400원), 실납(P47), 멀티미터(P48, 8,800원), 와이어 스트리퍼(P49), 니퍼(P50), 글루건(P51), **열풍기(P52 — 솔더 슬리브용, 68,200원이므로 대여 권장)**, 드릴+스텝드릴(P53), 커터칼·쇠자·커팅매트(P54).

### 4.4 선택 구매 — 시음 전 교체용 · 조립 방식 선택 (BOM에서는 분류 '선택', qtyToBuy 0 → 필수 합계 제외)

| ID | 구분 | 품목 | 선택 시 수량 | 단가 | 구매처 | 언제 사나 |
|---|---|---|---:|---:|---|---|
| P65 | 시음 전 교체용 | 식품용 실리콘 튜브 내경5/외경7mm (FDA/LFGB 표기) | 3 (m) | 가격 확인 필요 | 국내 쇼핑몰·실험용품점 (디바이스마트 미취급) | 팀원 시음을 할 때만 (3.6절) |
| P66 | 시음 전 교체용 | 식품용 실리콘 튜브 내경4/외경6mm (FDA/LFGB 표기) | 1 (m) | 가격 확인 필요 | 〃 | 〃 |
| P67 | 시음 전 교체용 | 식품용 체크밸브 (액체용, 내경4 튜브용 바브) | 5 | 가격 확인 필요 | 〃 | 〃 |
| P68 | 조립 방식 선택 | 둥근머리 십자볼트 M3×15 (철, 노란색) [34252](https://www.devicemart.co.kr/goods/view?no=34252) | 10 (최소주문, 2개 사용) | 11원 | 디바이스마트 | 전장 박스를 **볼트로** 고정할 때만(기본은 벨크로 P64) — 5.6절 |
| P69 | 조립 방식 선택 | 자석 캐치 추가분 (P45와 같은 제품) | 4 (2~4) | 가격 확인 필요 | 다이소/철물점 | 상판 C를 볼트(캡티브 너트) 대신 **자석**으로 고정할 때만 |

- 선택 시 금액은 엑셀 `선택_업그레이드` 시트 아래 표에서 계산되고, `예산` 시트의 ④(시음 전 교체용)·⑤(조립 방식 선택)와 "(시음할 때)" 시나리오에 자동으로 들어갑니다. 판매처를 정하면 단가 칸만 채우면 됩니다.
- P68: 볼트가 박스 바닥 + 선반 D(5mm) + 너트(P38)를 지나야 해서 M3×10(P37)은 짧을 수 있습니다(박스 바닥 두께 실측). 디바이스마트의 스텐 둥근머리 십자볼트에는 15mm가 없어 철(노란색) M3×15를 골랐습니다. 스텐을 원하면 M3×16([10912300](https://www.devicemart.co.kr/goods/view?no=10912300), 33원, 최소 5개). 볼트 고정을 고르면 디바이스마트 주문에 함께 넣고, 구멍은 **조립 전에** 뚫습니다(선반 D는 STEP9 구멍 표, 박스 바닥은 STEP5 박스 준비 — 속판을 달기 전).

---

## 5. 외형 개념 · 재단표 (cut list) — 조립가이드는 이 치수를 그대로 사용

### 5.1 좌표와 구역 (모든 치수 mm, 판 두께 t = 5, 포맥스 5T)

- 외형 **W420 × D260 × H380** (고무발 제외).
- 좌표: **x** = 왼쪽→오른쪽(앞에서 볼 때, 0~420), **y** = 앞→뒤(0~260), **z** = **바닥판 윗면** 기준 높이(바닥판 두께 5mm는 그 아래).
- 내부 폭 = 420 − 5 − 5 = **410**.

| 구역 | 범위 | 설명 |
|---|---|---|
| 전장부(상단) | z 260~370, 선반 위 | 하이박스(150×200×100)를 선반 위 x 105~305, y 40~190 에 배치. 액체와 격리. 고정은 **접착식 벨크로(P64) 4쌍**(박스 바닥 네 모서리, 구멍 없음)이 기본, 볼트는 선택(뒤쪽 두 모서리만, 5.6절) |
| 중간 선반 | z 255~260 | 전장부 바닥 겸 노즐 지지 |
| 용기 칸(하단 뒤) | y 110~255, z 0~255 | 용기가 놓이는 깊이 140(y 110~250, 뒤쪽 y 250~255는 걸림턱 L). 용기 4개 일렬 — 가이드 N 사이 칸 폭 약 97~100 → **용기 외곽 폭 ≤ 95**. 뒤 덮개 H(y 255~260) 열고 뒤로 꺼냄 |
| 잔 칸(하단 앞 가운데) | x 135~285, y 0~105, z 0~255 | 폭 150 × 깊이 105, 드립 트레이 + 잔 |
| 노즐 출구 | 한 줄 4개 x 192·204·216·228(가운데 x 210), y 52, **z 230** | 용기 최대 액면(≤ z 160)보다 70mm 이상 높음 → 사이펀 방지 |

### 5.2 재단표

| 기호 | 패널명 | 치수 (가로 × 세로) | 수량 | 위치 / 가공 |
|---|---|---|---|---|
| A | 바닥판 | 420 × 260 | 1 | 맨 아래. 네 모서리 아래에 고무발(P41). 뒤 덮개 걸림턱 L 부착 |
| B | 측판 (좌·우) | 260(깊이) × 370(높이) | 2 | 바닥판 위 양끝(x 0~5, 415~420)에 세움 |
| C | 상판 (탈착식) | 420 × 260 | 1 | 측판 위(z 370~375). L자 꺾쇠 4개 + M3 볼트로 고정(정비 시 분리). 꺾쇠 아래 M3 너트는 **순간접착제로 미리 붙여 둠**(캡티브 너트 — C를 얹으면 손이 안 들어가므로 위에서 볼트만 돌림, 조립가이드 STEP9). 대안: 자석 캐치(P69 2~4개, 선택) |
| D | 중간 선반 | 410 × 250 | 1 | z 255~260, y 5~255. **Ø20 구멍 2개**(펌프 전선 통로, 그로밋 P44 Ø20용): 판 기준 좌·우 끝에서 55, 뒤쪽 끝에서 35 = 본체 좌표 (x 60, y 220), (x 360, y 220). **(선택) Ø3.5 구멍 2개**(전장 박스를 볼트로 고정할 때만): 판 기준 왼쪽 끝에서 110 / 290, 뒤쪽 끝에서 75 = 본체 (x 115, y 180), (x 295, y 180) — 조립 전에 가공, 벨크로 고정이면 뚫지 않음 |
| E | 칸막이 (용기 칸 ↔ 잔 칸) | 410 × 255 | 1 | y 105~110, z 0~255. **Ø25 구멍 1개**(튜브 4가닥 통로): 판 가로 중앙, 위 끝에서 17mm 아래가 구멍 중심 |
| F | 앞판 상부 (조작 패널) | 410 × 115 | 1 | y 0~5, z 255~370. **Ø16 구멍**(버튼 P03): 오른쪽 끝에서 70, 높이 중앙 / **Ø5 구멍**(LED P05): 오른쪽 끝에서 110, 높이 중앙 |
| G | 뒤판 상부 (전원 패널) | 410 × 115 | 1 | y 255~260, z 255~370. 뒤에서 볼 때 왼쪽 끝에서: **Ø12 구멍** 40(어댑터 선, 그로밋 P44 Ø12용 또는 글루건 마감) / **로커 스위치 사각 구멍** 90(실물 실측) / **퓨즈홀더 구멍** 140(실물 실측, 약 Ø12~13 추정) — 모두 높이 중앙. **구멍은 STEP4(1주차)에서 미리 뚫음**: SW1·F1을 G 바깥에서 끼운 뒤 G 안쪽에서 납땜(먼저 납땜하면 둘 다 끼울 수 없음). G는 STEP4부터 전원부에 매달려 다니다가 STEP9에 본체에 붙음 |
| H | 뒤 덮개 (용기 칸, 탈착식) | 408 × 253 | 1 | y 255~260, 뒤쪽 개구부(410 × 255)에 1mm 여유로 끼움. 손가락 구멍 Ø25(선택, 가로 가운데·위쪽 끝에서 25), 자석 캐치 2개(P45) |
| I | 앞판 하부 (좌·우) | 125 × 255 | 2 | y 0~5, z 0~255, x 5~130 / 290~415 |
| J | 잔 칸 옆벽 (좌·우) | 105(깊이) × 255(높이) | 2 | x 130~135 / 285~290, y 0~105 (앞면과 같은 면, 뒤끝은 칸막이 E에 닿음) |
| K | 선반 받침대 | 145 × 20 | 2 | 측판 안쪽, 용기 칸 구간(y 110~255), z 235~255. 선반 D를 받침 |
| L | 뒤 덮개 걸림턱 | 410 × 15 | 1 | 바닥판 위 뒤쪽 끝 y 250~255에 세워 붙임(높이 15, 뒤 덮개 H가 안으로 밀려들지 않게) |
| M1 | 노즐 플레이트 | 60 × 60 | 1 | 하단면 z 230. **Ø6.5 구멍 4개 한 줄**: 왼쪽 끝에서 **12·24·36·48mm**, 앞쪽 끝에서 **30mm**(간격 12mm, 왼쪽부터 펌프 1·2·3·4 = 본체 x 192·204·216·228, y 52). 내경4 튜브(외경 6) 끝을 위에서 꽂아 아래로 3mm 나오게 하고 위에서 글루건 고정. (2×2 배열은 앞·뒤 튜브가 20mm 틈에서 겹쳐 꺾이므로 쓰지 않음) |
| M2 | 노즐 걸이 | 60 × 20 | 2 | M1 위 좌·우 양끝에 세워 붙여 "ㄷ"자 노즐 블록(앞·뒤는 열림, 튜브는 뒤쪽 칸막이 E에서 들어옴). 튜브를 끼운 뒤 블록을 선반 D 아래 x 180~240, y 22~82에 접착 → M1 하단 z 230 |
| N | 용기 칸 가이드 (선택) | 140 × 15 | 3 | 바닥판 위 용기 사이(x ≈ 107, 210, 312), y 110~250(칸막이 E 뒷면 ~ 걸림턱 L 앞면), 세워 붙임 |

- 체크밸브 4개: 용기 칸 쪽 선반 아래, 칸막이 구멍 근처에 접착 마운트(P28)+케이블타이로 가로 고정, 화살표 → 노즐 방향.
- 튜브 길이(펌프당): 내경5 약 0.7m(용기 뚜껑 → 위로 → 체크밸브, 용기를 뒤로 30cm 꺼낼 여유 포함), 내경4 약 13cm(슬리브 3cm + 밸브→노즐 10cm).
- **용기 뚜껑 가공**(뚜껑마다 3개): **Ø7**(튜브, 펌프 출수구 바로 위) · **Ø5**(펌프 전선, Ø7에서 약 20mm 옆) · **Ø3 공기 구멍**(가장자리에서 약 15mm 안쪽, 진공 방지 — SPEC §1).
  송곳으로 작게 뚫고 스텝드릴을 천천히 돌려 넓힘(PP는 빨리 돌리면 녹음). Ø3은 송곳 또는 Ø3 드릴 날. 펌프 리드-연장선 이음(솔더 슬리브)은 **뚜껑 위**에서 하고, Ø5 구멍 둘레는 글루건으로 막음(**공기 구멍은 막지 않음**).

### 5.3 직접 재단할 때 판 배치 (600 × 900 판 3장, 칼날 여유 5mm)

- **판 1**: A(0,0) · C(0,265) · B좌(0,530) · B우(265,530) · I좌(425,0) · I우(425,260) · K×2(세워서 20×145: (555,0),(580,0))
- **판 2**: D(0,0) · E(0,255) · F(0,515) · G(0,635) · L(0,755) · N×3(가로로 (0,775),(145,775),(290,775)) · J좌(415,0) · J우(415,260) · M1(525,0) · M2×2((525,65),(525,90))
- **판 3**: H(0,0) + 나머지는 실수 대비 예비
- (괄호 안은 판 왼쪽 위 모서리 기준 부품 왼쪽 위 좌표, 가로 600 방향이 x)
- 재단 주문 시에는 위 표의 부품을 그대로 주문(판 배치 불필요).
- 직접 재단할 때는 **판 2의 G를 가장 먼저** 잘라 둡니다(1주차 STEP4에서 SW1·F1 구멍을 뚫고 끼움).

### 5.4 폭·깊이 변경 규칙 (용기가 더 클 때)

- **먼저 용기 외곽 폭(w, 좌우 방향, 뚜껑 포함)으로 본체 폭을 고릅니다** (용기 4개 일렬 + 가이드 N 3개):

| 용기 외곽 폭 w | 본체 | 근거 |
|---|---|---|
| **w ≤ 95mm** | **W420 (기본)** | 내부 폭 410 − 가이드 15 = 395 → 칸당 약 98.75 |
| **95 < w ≤ 120mm** | **W520** (ΔW = 100, 아래 규칙) | 내부 폭 510 − 15 = 495 → 칸당 약 123.75 |
| **w > 120mm** | 4개 일렬 불가 → **다른 용기** 고르기 | (가이드·재단표는 W420·W520 두 경우만 계산됨) |

  깊이(앞뒤 방향)가 135mm보다 크면 아래 깊이 규칙도 함께 적용합니다(예: TARK 1L 165×120 → W520 + 깊이 +30). **용기를 정한 뒤에 포맥스를 재단/주문**하세요.
- **폭을 ΔW 만큼 늘릴 때** (예: 폭 120mm 용기 → 본체 W520, ΔW = 100):
  A·C 가로 +ΔW, D·E·F·G·L 가로 +ΔW, H 가로 +ΔW, I 가로 +ΔW/2(각각), 나머지(B·J·K·M·N) 그대로. 잔 칸은 가운데 유지, N 위치는 (내부폭/4) 간격으로 재계산.
  → W520 예: A·C 520×260, D 510×250, E 510×255, F·G 510×115, H 508×253, L 510×15, I 175×255.
  잔 칸·노즐 블록·전장 박스는 가운데(x 260 기준)로 옮기고, 구멍은 판 기준 위치를 그대로 씁니다(D Ø20은 좌·우 끝에서 55, E Ø25는 가로 가운데, F·G는 각 끝에서 같은 거리).
- **깊이를 ΔD 만큼 늘릴 때** (용기 깊이 135mm 초과): A·C·B 깊이 +ΔD, D +ΔD, K +ΔD, N +ΔD (용기 칸만 깊어지고 잔 칸은 그대로).

### 5.5 접착·고정 요령(재료 관점)

- 포맥스(PVC 발포)는 **순간접착제(시아노아크릴레이트)** 로 맞대기 접착이 잘 됩니다(P42). 안쪽 모서리를 글루건(P43)으로 한 번 더 보강.
- 힘이 걸리는 곳(측판-바닥, 상판 탈착부, 선반)은 **L자 꺾쇠 + M3×10 볼트·너트**(P36~P38). 포맥스에 목나사는 잘 빠지므로 관통 볼트+너트 사용.
- 릴레이 모듈은 하이박스 속판에 M3 서포트 10mm(P39) 4개로 띄워 고정(아래쪽 납땜면 단락 방지).
- **전장 박스 → 선반 D**: 접착식 벨크로(P64) 4쌍(박스 바닥 네 모서리와 D의 같은 자리)이 기본입니다. 박스 앞쪽 모서리 아래(x 5~130 / 290~415, y 5~105)는 I·J·E·B·A·D로 사방이 막힌 빈 공간이라 너트를 끼울 수 없고, 조립이 끝난 본체에 구멍을 뚫으면 안 되기 때문입니다. 볼트로 더 단단히 잡고 싶으면 **뒤쪽 두 모서리(x 약 115·295, y 약 180)** 만 쓰고, 너트는 뒤 덮개 H를 열고 용기를 꺼낸 뒤 용기 칸 쪽(D 아래)에서 끼웁니다(M3×15 P68 + P38).
- **상판 C**: 꺾쇠를 B에 달기 전에 각 꺾쇠 가로 다리 아래에 M3 너트를 대고 볼트로 잡은 상태에서 너트 테두리에 순간접착제(P42)를 조금 발라 붙입니다(**캡티브 너트**). 볼트 나사산에 식용유·바셀린을 살짝 묻히면 볼트가 같이 붙지 않습니다. 대안은 자석 캐치(P69, 선택).

### 5.6 관통 구멍 일람 (조립가이드 STEP3·4·5·9·10의 구멍과 같은 값)

판 위치는 각 판의 끝에서 잰 거리(mm)입니다. G판은 **뒤에서(바깥면) 볼 때** 기준입니다.

| 판 / 부품 | 구멍 | 개수 | 위치 | 용도 / 마감 |
|---|---|---:|---|---|
| D 중간 선반 | Ø20 | 2 | 좌·우 끝에서 55, 뒤쪽 끝에서 35 | 펌프 1·2 / 3·4 전선 → **그로밋 P44(Ø20용)**, 배선 후 둘레 글루건 |
| D 중간 선반 **(선택)** | Ø3.5 | 2 | 왼쪽 끝에서 110 / 290, 뒤쪽 끝에서 75 (본체 x 115·295, y 180) | 전장 박스를 **볼트로** 고정할 때만 — STEP9 조립 전에 가공. M3×15(P68) + 너트(P38). 벨크로(기본)면 뚫지 않음 |
| E 칸막이 | Ø25 | 1 | 가로 가운데(205), 위쪽 끝에서 17 | 체크밸브 → 노즐 튜브 4가닥(2×2로 묶어 통과) |
| F 앞판 상부 | Ø16 | 1 | 오른쪽 끝에서 70, 높이 가운데(57.5) | 버튼 SW2(P03), 뒤에서 너트 |
| F 앞판 상부 | Ø5 | 1 | 오른쪽 끝에서 110, 높이 가운데 | LED1(P05), 뒤에서 글루건 |
| G 뒤판 상부 | Ø12 | 1 | 왼쪽 끝에서 40, 높이 가운데 | 어댑터 선 → **그로밋 P44(Ø12용)** 또는 글루건 마감. **G의 구멍 3개는 STEP4에서 미리 뚫음** |
| G 뒤판 상부 | 사각(실측) | 1 | 왼쪽 끝에서 90, 높이 가운데 | SW1 로커 스위치(P13, 몸통 약 19×13 추정 → 실측보다 0.5mm 작게 시작해 넓힘) |
| G 뒤판 상부 | 원형(실측, 약 Ø12~13 추정) | 1 | 왼쪽 끝에서 140, 높이 가운데 | F1 퓨즈홀더(P14), 안쪽에서 너트 |
| H 뒤 덮개 | Ø25 (선택) | 1 | 가로 가운데, 위쪽 끝에서 25 | 손가락 걸이 |
| M1 노즐 판 | Ø6.5 | 4 | **한 줄**: 왼쪽 끝에서 12·24·36·48, 앞쪽 끝에서 30 | 내경4 튜브 끝(외경 6), 위에서 글루건 |
| 용기 뚜껑 ×4 | Ø7 · Ø5 · **Ø3** | 각 1 | 출수구 바로 위 / Ø7에서 20 옆 / 가장자리에서 15 안쪽 | 튜브 / 펌프 전선(글루건으로 막음) / **공기 구멍(막지 않음)** |
| 전장 박스(P35) 벽 | Ø12 · Ø12 · Ø16 · Ø10 | 각 1 | 왼쪽 · 오른쪽 · 뒤 · 앞 벽, 박스 바닥에서 약 20 | 펌프 1·2 선 / 펌프 3·4 선 / 어댑터 선·SW1·F1 선 / 앞판 신호선 — 배선 후 글루건 |
| 전장 박스 바닥 **(선택)** | Ø3.5 | 2 | **뒤쪽 두 모서리**(본체 x 약 115·295, y 약 180 — 선반 D (선택) 구멍과 같은 자리) | 볼트 고정을 고를 때만, STEP5 박스 준비에서 속판을 달기 전에 뚫음. **기본은 벨크로(P64) — 박스 바닥에 구멍 없음** |
| 전장 박스 속판 | Ø3.2 | 4 | 릴레이 고정 구멍 간격 69.6 × 49.4 | M3 서포트 10mm(P39) + M3×6(P40) |
| 꺾쇠 자리(A·B·C·D) | Ø3.5 | 꺾쇠마다 | 꺾쇠 구멍에 맞춰 조립 때 | M3×10 볼트·너트(P36~P38) |

- **그로밋(P44)**: 일반 고무 그로밋은 판 두께 1~3mm용이 많습니다. 5mm 포맥스에 맞는 홈 폭(≥5mm) 제품이 없으면 사지 말고, 구멍 가장자리를 사포로 다듬은 뒤 **글루건으로 마감**합니다(전선 피복 보호 + 물방울 차단).
  뒤판 G는 어댑터 플러그(코드 일체형)를 **먼저 Ø12 구멍에 통과**시킨 뒤 그로밋에 칼집을 내어 케이블에 끼우고 구멍에 밀어 넣습니다(플러그 몸통이 그로밋 안지름보다 큼, 추정). 플러그 몸통 지름이 12mm보다 크면 G 구멍을 키워야 합니다(실측).
- **드릴**: 스텝드릴(P53, 4~35mm)로 Ø5~Ø25, 일반 드릴 날로 Ø3·Ø3.2·Ø3.5 (모두 학교 대여).

---

## 6. 용기 선택 기준 (P32)

1. 외곽 **폭 ≤ 95mm**, **깊이 ≤ 135mm**, **높이 ≤ 170mm** (뚜껑 포함) — **W420 본체 기준**. 폭이 95mm 초과~120mm 이하면 본체 **W520**(5.4절), 120mm 초과면 다른 용기. 펌프(약 43×23mm, 출수구 포함 높이 약 30mm)가 바닥에 눕혀 들어가야 함.
2. 뚜껑 입구 폭 ≥ 60mm (펌프를 넣고 빼기), 뚜껑에 구멍 3개(Ø7 튜브 · Ø5 전선 · **Ø3 공기**)를 뚫을 수 있는 PP 재질.
3. **낮고 넓을수록** 액면 변화가 작아 유량이 일정(3.3절). 단 펌프보다 낮은 액면(약 25~30mm)은 못 씀(잔여량).
4. 같은 제품 4개로 통일(캘리브레이션 조건 동일).
5. 확인한 다이소 1L 제품 치수: TARK 직사각 간편 용기 1L 3개입 약 165×120×80mm (2,000원, [pdNo=58803](https://www.daisomall.co.kr/pd/pdr/SCR_PDR_0001?pdNo=58803)), 내츄럴 직사각 손잡이형 1L 약 144×204×53mm(1,000원, 품절 표시, [pdNo=21252](https://www.daisomall.co.kr/pd/pdr/SCR_PDR_0001?pdNo=21252)) → **둘 다 폭 95 초과**. 매장에서 슬림/세로형/원형(지름 ≤95) 용기를 실측하거나 5.4절 규칙으로 본체 확대.

---

## 7. 선택 업그레이드 (논문 · 2학기 확장)

| ID | 품목 | 가격 | 효과 / 주의 |
|---|---|---|---|
| P55 | DFRobot Gravity 디지털 연동펌프 DFR0523 (5~6V, 연속 1.8A) | 45,540원 ×4 | 튜브만 액체에 닿아 위생적, 회전수=유량이라 정량성 우수, 양정 영향 적음. 4개 동시 시 큰 전류 → 5V 10A급 전원 필요(확인 필요). 대안 Adafruit 12V 연동펌프(14600697, 49,830원, 12V 전원) |
| P56+P57 | HX711 모듈(1,870원) + 1kg 로드셀(7,260원) | 9,130원 | 잔 받침 아래 무게 측정 → 실제 추출량으로 자동 보정·종료(시간 제어의 오차 보완). 논문 실험 데이터에 유용 |
| P58 | 4채널 MOSFET 보드 YYNMOS-4 (AF60N03) | 19,360원 | 릴레이 대체, PWM으로 유량 미세 조절. ESP32 3.3V 구동 여부 확인 필요, 플라이백은 1N5819 |

---

## 8. 확인 필요 항목 (직접 확인하지 못한 것)

1. 릴레이 보드 실제 입력 회로(표시 LED 직렬 여부)와 **3.3V(A안) 동작 여부** → 벤치 테스트로 확정.
2. 체크밸브 JGB32PPS **재질·식품 적합성**, 액체 사용 시 실제 개방압·유량 손실.
3. 펌프·실리콘 튜브의 식품등급 여부, 펌프 본체 재질(고도수 주류 내성). 시음 전 교체 부품(P65~P67, 식품용 FDA/LFGB 표기 튜브·체크밸브)의 판매처·가격(디바이스마트 미취급).
4. 실제 유량(ml/s) — 3.3절은 계산 추정치.
5. 펌프 기동 전류(멀티미터 측정 권장), 리드선 길이.
6. 로커 스위치 KCD1-101A 패널 구멍 치수, 퓨즈홀더 FH-303 장착 구멍 지름 → 실물 실측 후 **STEP4에서** G판 가공(재단된 G판이 STEP4 전에 필요).
7. ElectroCookie 확장보드 외형 치수, 하이박스 AGH-152010 내부 유효 치수.
8. 다이소 용기·드립트레이·L자 꺾쇠·자석 캐치, 고무 그로밋 가격·재고.
9. 포맥스 맞춤 재단 가격(쇼핑몰 자동견적), MDF 레이저 커팅 대행 가격.
10. 릴레이 코일 저항/전류(배포처 데이터 70Ω — 제조사 원본 미확인).
11. 5mm 판에 맞는 그로밋(홈 폭 ≥5mm, Ø20용·Ø12용) 유무 → 없으면 글루건 마감.
12. 어댑터(P11) 플러그 몸통 지름 — 뒤판 G Ø12 · 전장 박스 뒤 벽 Ø16 통과 여부.
13. 예산: 1학기 잔액(38,600원) 2학기 이월 여부, 경진대회 예선 참가 지원금(50,000원) 수령 여부·사용 기한, 캡스톤디자인Ⅱ 실습비 금액, 학교 구매신청 처리 기간.
14. (볼트 고정을 고를 때만) 전장 박스 바닥 두께 → M3 볼트 길이(M3×15 P68로 충분한지). 벨크로(P64)의 박스(플라스틱)·포맥스 접착력은 실물로 확인.

---

## 9. SPEC 변경 제안 → v2.1 반영 현황

이 조사에서 낸 제안 중 1~7번은 SPEC **v2.1**(2026-11-06)에 반영되었습니다. 이 문서와 BOM도 v2.1 기준으로 고쳤습니다.

| # | 제안 | SPEC v2.1 | 이 문서 · BOM |
|---|---|---|---|
| 1 | 상태 LED: 외부 LED + 220Ω **필수**(DevKitC V4에 GPIO2 사용자 LED 없음) | 반영 (§1) | P05 · P06 |
| 2 | 릴레이 **B안**(VCC=JD-VCC=5V, IN=GPIO 직결)을 공식 대체안으로, "B안에서 VCC를 3V3에 연결 금지". 교차검증에서 절차 확정: **⑪ 먼저 뽑기 → ⑨를 입력 헤더 VCC 핀으로 → 점퍼 캡** | 반영 (§1) | 3.2절, P08 |
| 3 | 전원 스위치 SW1 + 3A 퓨즈 F1, PCT-418 분배 | 반영 (§1: TB1 +5V 버스 · TB2 GND 버스 · TB3 3V3 분배, 별형 접지) | 3.5절, P13~P15 · P18 |
| 4 | 한 펌프 구동시간 60초 → **120초** | 반영 (§2.3, `maxPumpMs` 120000) | 1절 2번, 3.3절 |
| 5 | 기본 유량 20 ml/s 유지 + "캘리브레이션 전" 안내, 용기를 반쯤 채운 상태에서 캘리브레이션 | 반영 (§1, §5.6 `calSet` 배너) | 3.3절 |
| 6 | 튜브 규격 · 체크밸브 방향 · 노즐 높이 명시 | 반영 (§1 액체 경로 — **뚜껑 Ø3 공기 구멍** 포함) | 3.1절, 5.2절 뚜껑 가공 |
| 7 | 부저 **ONE005(HIGH=울림)** 확정 | 반영 (§1 `BUZZER_ON_LEVEL 1`) | P04 (LOW=울림 모듈이면 `BUZZER_ON_LEVEL 0`) |
| 8 | (선택) 잔량 기반 유량 보정 계수 | 미반영 — 향후 과제 | 7절 로드셀 업그레이드와 함께 논문 주제 후보 |

- **SPEC 문구 메모 → 반영됨**: SPEC §1 접지 문단이 "⑤ → TB2(펌프 측)"으로 고쳐졌고, 이 릴레이 보드는 별도 코일 GND 핀이 없어 **릴레이 코일 전류는 릴레이 GND 핀 → ESP32 GND(⑯) → ⑦ → 어댑터(−)** 로 돌아온다는 설명도 들어갔습니다(회로도 연결표 ⑯ 비고와 같음).

---

## 10. 출처 (2026-11-06 조회)

- 디바이스마트 상품 페이지(상품번호는 BOM의 productNo): `https://www.devicemart.co.kr/goods/view?no=<상품번호>` — 상세 설명은 `goods/view_contents?no=<상품번호>` 및 상세 이미지에서 확인
  - 펌프 1329770, 릴레이 1327545, 체크밸브 12519260, ESP32 15313999, 튜브 14115486/14115487, DC플러그 1078077, DC터미널 1321144, 어댑터 12233458,
    ElectroCookie 15223173, CMODULE-47 15315957, PCT-418 10911193, PCT-1-5 14021207, 하이박스 14003437, 부저 10916337/1326921, 푸시스위치 1325010, 로커 1790, 퓨즈홀더 4577, 퓨즈 4537, 커패시터 29524/29522, 포맥스(하나아크릴) 7926 외
  - 교차검증 추가분(2026-11-06): 접착식 벨크로 Coms T9162 15810228(상세 이미지: 양면Tape/찍찍이 10조 55×35mm), M3×15 철 십자볼트 34252, 스텐 M3×16 10912300. 식품용 표기 실리콘 튜브·체크밸브는 디바이스마트 검색에서 찾지 못함
- [Espressif ESP32-DevKitC V4 사용자 가이드](https://docs.espressif.com/projects/esp-dev-kits/en/latest/esp32/esp32-devkitc/user_guide.html)
- [RandomNerdTutorials — ESP32 Relay Module](https://randomnerdtutorials.com/esp32-relay-module-ac-web-server/)
- [Phipps Electronics — Relay modules with optocoupler user's guide](https://www.phippselectronics.com/support/5v-2-4-8-channel-relay-modules-with-optocoupler-users-guide/)
- [Arduino Forum — Relay jumper isolation](https://forum.arduino.cc/t/relay-jumper-isolation/693248)
- [Futurlec — JQC-3FF-05 relay data](https://futurlec.com/Relays/JQC-3FF-05.shtml)
- [다이소몰 TARK 직사각 간편 용기 1L](https://www.daisomall.co.kr/pd/pdr/SCR_PDR_0001?pdNo=58803), [내츄럴 직사각 손잡이형 1L](https://www.daisomall.co.kr/pd/pdr/SCR_PDR_0001?pdNo=21252)
- [아크리애 포맥스판(백색) 맞춤 재단](https://www.acryiae.com/front/product/view.do?productSeq=14), [정아크릴](https://jungacryl.com/), [DKD아크릴 포맥스&ABS 재단](https://www.aquaself.net/goods/goods_view.php?goodsNo=1616)
