paperji/smart-bartender/hardware/BOM.xlsx

Sheet: 요약
통합 BOM — 납땜 기준 · 무납땜 기준 비교 · 사용자의 감정 및 취향 분석 기반 AI 맞춤형 음료 및 칵테일 배합 메이커
팀 홍당무 · 작성 2026-11-11 · 원본 BOM(2026-11-06)은 research/BOM_원본_20261106.xlsx 로 보관. 기준별 자세한 BOM: BOM_납땜기준.xlsx · BOM_무납땜기준.xlsx
이 파일은
• 2026-11-11 팀은 무납땜 기준으로 부품을 모두 샀습니다(디바이스마트 35품목 · 다이소 6품목 — 지출_완료 시트에 부품별). 무납땜 열의 '앞으로 살 것'은 0이고, 납땜 열은 '지금 납땜 기준으로 바꾸면 더 사야 할 것'입니다.
• 두 기준(납땜 = 인두기로 원래 설계대로, 무납땜 = 레버 커넥터·선 달린 부품)을 한 표로 비교한 통합판입니다. 부품마다 '적용'(공통 / 납땜 기준만 / 무납땜 기준만)과 기준별 필요·구매 수량이 있습니다.
• 주문할 때는 '주문_링크' 시트를 보세요 — 앞으로 살 부품을 구매처별로 모았고(이미 산 것은 아래 '☑ 이미 산 것' 구획), 링크를 누르면 상품 페이지가 열립니다.
• 학교 물품구매의뢰서 양식(VAT 별도)은 기준별 BOM의 '추가구매_의뢰서용' 시트에 있습니다.
• 제작 방법은 guide/제작가이드_납땜기준.md · guide/제작가이드_무납땜기준.md.
한눈에 보기
항목 | 납땜 기준(원) | 무납땜 기준(원) | 비고
앞으로 ① 디바이스마트 (VAT 포함) | 5203 | 0 | 품목 수: 납땜 3 · 무납땜 0
└ 디바이스마트 배송비 (66,000원 미만일 때) | 2700 | 0 | 2,700원(조사값, VAT 포함)
앞으로 ② 다이소·편의점 등 (가격 아는 것만) | 0 | 0 | 가격 미확인: 없음
이미 결제한 것 | 238228 | 238228 | 3D 프린팅 출력 부품 (plate_A 브래킷 01 ×14 + plate_B 나머지 02~07 ×10) · 포맥스 5T 흰색 · 디바이스마트 주문 — 무납땜 기준 35품목 · 다이소 — 무납땜 기준 6품목 — 실제로 쓴 돈이라 두 기준 같음
2학기 전체 | 246131 | 238228 | 선택 구매·공구 구매 제외 · 디바이스마트 주문액이 66,000원 미만이면 배송비 2,700원 포함
두 기준에서 달라지는 부품
ID | 부품 | 적용 | 메모
P13 | 로커 스위치 KCD1-101A (ON/OFF, SPST) | 납땜 기준만 | 상태 (납땜 / 무납땜): 구매 필요 / 불필요 (P73 하네스 스위치로 대체)
P14 | 패널형 퓨즈홀더 FH-303 (5×20mm 유리관용) | 납땜 기준만 | 상태 (납땜 / 무납땜): 구매 필요 / 불필요 (P74 인라인 퓨즈홀더로 대체)
P73 | 하네스 스위치 (101A-5264) — KCD-101A 로커 스위치 + 리드선 200mm | 무납땜 기준만 | 상태 (납땜 / 무납땜): 해당 없음 / 주문 완료 (11-11, 배송 대기)
P74 | 퓨즈홀더 FH-201 (빨강, 라인홀더 — 선 달린 인라인형) | 무납땜 기준만 | 상태 (납땜 / 무납땜): 해당 없음 / 주문 완료 (11-11, 배송 대기)
P25 | 열 수축 솔더 슬리브 1.0SQ [SZH-CA002] | 납땜 기준만 | 상태 (납땜 / 무납땜): 보유 / 보유 (무납땜 기준에서는 안 씀)
P26 | NT DIY 열수축튜브 328세트 | 공통 | 상태 (납땜 / 무납땜): 구매 필요 / 선택(무납땜에서는 효과 작음)
P75 | 3선 결합 탈피형 커넥터 PCT-413 (칩센) — 3구 정션형 | 무납땜 기준만 | 상태 (납땜 / 무납땜): 해당 없음 / 주문 완료 (11-11, 배송 대기)
P76 | 2선 결합 탈피형 커넥터 PCT-412 (칩센) — 1:1 이음 | 무납땜 기준만 | 상태 (납땜 / 무납땜): 해당 없음 / 주문 완료 (11-11, 배송 대기)
P77 | 5선 결합 탈피형 커넥터 PCT-415 (칩센) — 앞판 GND 허브 | 무납땜 기준만 | 상태 (납땜 / 무납땜): 해당 없음 / 주문 완료 (11-11, 배송 대기)
P78 | 터미널 압착단자 케이블 2.8mm [CG0731] (30cm) | 무납땜 기준만 | 상태 (납땜 / 무납땜): 해당 없음 / 주문 완료 (11-11, 배송 대기)
P79 | 전기 절연 테이프 19mm×10m 2개입 | 무납땜 기준만 | 상태 (납땜 / 무납땜): 해당 없음 / 구매 완료 (11-11)
P46 | 실습용 납땜세트B (학교 실습실 대여 가능) | 납땜 기준만 | 상태 (납땜 / 무납땜): 학교 대여 (집에 없음) / 불필요 (무납땜)
P47 | 일반 실납 1.0mm [SME15510] (학교 실습실 대여 가능) | 납땜 기준만 | 상태 (납땜 / 무납땜): 학교 대여 / 불필요 (무납땜)
P52 | 열풍기 D26411 (학교 실습실 대여 가능) | 납땜 기준만 | 상태 (납땜 / 무납땜): 학교 대여 (집에 없음) / 불필요 (무납땜)
원본 BOM(2026-11-06)에서 바뀐 점 (공통)
• 용기 P32: 처음 산 다이소 TARK 1L(약 165×120×80mm)는 폭 120mm라 W420 본체에 안 들어가 취소하고, 기준(좌우 ≤95·앞뒤 ≤135·높이 ≤170)을 상품 페이지로 확인한 다이소 직사각 저장 용기 970ml(약 105×80×150, 1,000원)로 바꿨습니다. 후보 셋(970ml 직사각 · 900ml 원형 · 800ml 사각) 중 단면이 가장 넓고 낮아 액면 변화가 가장 작습니다. 4개 + 예비 1.
• 3D 프린팅 출력 부품 P70 추가(주문 완료 — 결제 78,700원(견적 90,000원보다 적음), 11/16 배송 예정). 그래서 L자 꺾쇠 P36·고무 그로밋 P44는 사지 않고, 포맥스 노즐 판 M1·M2도 자르지 않습니다.
• 포맥스 P34: 3장 구매 완료(43,000원).
• 멀티미터 P48은 집에서 STEP1부터 쓰므로 학교 대여 대신 구매로 바꾸고, 전지(P72, 디바이스마트 주문에 함께)를 추가했습니다.
• 폼 양면테이프 P71 추가(앞면 베젤을 뗄 수 있게 붙임).
• 이미 결제한 돈은 지출_완료 시트로 따로 모으고, 예산 시트를 '이미 결제 / 앞으로 살 것'으로 나눴습니다. TARK 용기 11,000원은 환불 예정으로 따로 적었습니다.
• 다이소 물건 링크(2026-11-10 다이소몰 확인): 드립 트레이 P33 → 실리콘 원형 코스터 2개입(1038323), 자석 캐치 P45 → 네오디뮴 자석 13mm 3개입(1057293) + 접착식 철판 P80(1050101, 새 품목), 폼 양면테이프 P71 → 오공 18mm×2m 두께 1mm(1019760). 23A 전지 P72는 디바이스마트(10921874)로 옮김.
• 2026-11-11 무납땜 기준 부품 구매: 디바이스마트 35품목 — 거래명세서를 BOM 무납땜 주문 목록과 대조해 품목이 모두 일치, 차이는 볼트 P37·너트 P38 30→25개(필요 24), 단가 P05·P28·P39가 BOM보다 낮고 23A 전지 P72는 VAT 포함 770원 — 결제 102,528원(배송비 3,000원 포함). 다이소 6품목 14,000원(물건 11,000원 + 배송비 3,000원). 산 부품은 보유 수량에 더하고 지출_완료 시트에 부품별로 적었습니다(설정 bom_variants.json의 purchases). 고정 방식은 기본(전장 박스 벨크로 P64 · 상판 캡티브 너트)으로 정해져 볼트 P68·자석 P69는 사지 않았습니다.
확인할 것 (공통)
• 포맥스 3장: 600×900 통판이면 직접 재단합니다(커터칼·쇠자 60cm 이상·커팅매트). 맞춤 재단이면 할 일이 없습니다.
• 용기 5개(11-11 구매): 4개가 같은 제품인지, 입구가 60mm 이상이고 펌프가 들어가 바닥에 눕는지, 펌프 리드가 입구 위로 약 5cm 이상 나오는지 집에서 확인합니다(제작가이드 2.4). TARK 용기는 취소·환불합니다.
• 디바이스마트 물건이 오면(11-11 주문) 거래명세서와 수량을 하나씩 맞춰 봅니다(특히 볼트·너트 25개, CG0731 2개, PCT-413·412 10개씩). 모두 왔으면 bom_variants.json purchases의 상태를 '구매 완료'로 바꾸고 다시 만듭니다.
• 볼트 P37·너트 P38은 25개씩(필요 24) — 예비가 1개뿐이니 지퍼백에 따로 보관합니다.
• 단가: 11-11에 산 부품은 거래명세서·구매 금액으로 바꿨습니다. 아직 사지 않은 부품(납땜 기준에서만 더 사는 것·선택 품목)의 단가는 조사 시점(2026-11-06~10) 값입니다.
• 재원(1학기 잔액 이월 38,600원 · 예선 참가 지원금 50,000원 · 캡스톤디자인Ⅱ 실습비)은 아직 확인 전입니다. 예산 시트 노란 칸을 고치면 판단이 다시 계산됩니다.
• 제작가이드(2026-11-10, guide/제작가이드_납땜기준.md · 제작가이드_무납땜기준.md) 2장 부품표는 이 BOM과 같은 기준입니다. 예전 조립가이드.md(2026-11-06)의 부품표는 옛 기준(P32 용기·P36·P44)입니다.
• TARK 용기 환불액: 11,000원에 배송비가 들었으면 환불이 적을 수 있습니다. 확정되면 차액을 지출_완료 시트에 지출로 넣습니다.

Sheet: 주문_링크
주문 링크 — 두 기준 비교 (앞으로 살 것 3품목, 수량 0 = 그 기준에서는 사지 않음)
링크를 누르면 상품 페이지가 열립니다. 고른 기준의 수량 열만 보고 주문하세요. 수량·단가는 BOM_전체 시트와 연동됩니다. 디바이스마트 링크·가격은 2026-11-06~10 조사 기준 — 주문 전에 품절·가격을 다시 확인. 주문액이 66,000원 미만이면 배송비 2,700원(조사값)이 따로 붙음(예산 시트에 포함). 학교 의뢰서는 기준별 BOM의 '추가구매_의뢰서용' 시트.
주문함 | ID | 부품명 | 구매처 | 상품번호 | 단가(원) VAT 포함 | 수량 납땜 | 금액 납땜 | 수량 무납땜 | 금액 무납땜 | 링크 (누르면 상품 페이지) | 고르는 기준 · 메모
디바이스마트 (devicemart.co.kr — 학교 인터넷 구매신청)
☐ | P13 | 로커 스위치 KCD1-101A (ON/OFF, SPST) | 디바이스마트 | 1790 | 330 | 1 | 330 | 0 | 0 | 상품 페이지 열기 (https://www.devicemart.co.kr/goods/view?no=1790) | [납땜 기준만] 회로도 SW1(전원 스위치) / STEP4 뒤판 G 사각 구멍
☐ | P14 | 패널형 퓨즈홀더 FH-303 (5×20mm 유리관용) | 디바이스마트 | 4577 | 583 | 1 | 583 | 0 | 0 | 상품 페이지 열기 (https://www.devicemart.co.kr/goods/view?no=4577) | [납땜 기준만] 회로도 F1(퓨즈홀더) / STEP4 뒤판 G 둥근 구멍
☐ | P26 | NT DIY 열수축튜브 328세트 | 디바이스마트 | 1320936 | 4290 | 1 | 4290 | 0 | 0 | 상품 페이지 열기 (https://www.devicemart.co.kr/goods/view?no=1320936) | 배선 절연
 |  | 디바이스마트 소계 (VAT 포함, 가격 아는 것만) |  |  |  |  | 5203 |  | 0
 |  | 앞으로 살 것 합계 (VAT 포함, 가격 미확인·배송비 제외 — 배송비는 예산 시트) |  |  |  |  | 5203 |  | 0
☑ 이미 산 것 — 디바이스마트 주문 — 무납땜 기준 35품목 · 주문 완료 (11-11, 배송 대기) · 산 수량은 무납땜 열에
☑ 11-11 | P02 | ESP32-DevKitC 터미널 확장보드 Push-in 타입 (ElectroCookie) | 디바이스마트 | 15223173 | 12100 |  |  | 1 | 12100 | 상품 페이지 열기 (https://www.devicemart.co.kr/goods/view?no=15223173) | [무납땜 BOM 대비] BOM 계획과 같음
☑ 11-11 | P03 | 메탈 푸쉬 스위치 플랫형 16mm [HX16-B1] (모멘터리) | 디바이스마트 | 1325010 | 2970 |  |  | 1 | 2970 | 상품 페이지 열기 (https://www.devicemart.co.kr/goods/view?no=1325010) | [무납땜 BOM 대비] BOM 계획과 같음
☑ 11-11 | P04 | 회로내장형 액티브 부저 모듈 [ONE005] | 디바이스마트 | 10916337 | 1100 |  |  | 1 | 1100 | 상품 페이지 열기 (https://www.devicemart.co.kr/goods/view?no=10916337) | [무납땜 BOM 대비] BOM 계획과 같음
☑ 11-11 | P05 | 5mm LED 빨강 원통평면형 불투명 [5PR3HD19] | 디바이스마트 | 3218 | 55 |  |  | 2 | 110 | 상품 페이지 열기 (https://www.devicemart.co.kr/goods/view?no=3218) | [무납땜 BOM 대비] 단가 계획 61 → 실제 55원(VAT 포함)
☑ 11-11 | P06 | 저항 220Ω 1/4W 1% [221F] | 디바이스마트 | 2001 | 33 |  |  | 10 | 330 | 상품 페이지 열기 (https://www.devicemart.co.kr/goods/view?no=2001) | [무납땜 BOM 대비] BOM 계획과 같음
☑ 11-11 | P07 | Micro USB 5핀 데이터 케이블 1m | 디바이스마트 | 32695 | 770 |  |  | 1 | 770 | 상품 페이지 열기 (https://www.devicemart.co.kr/goods/view?no=32695) | [무납땜 BOM 대비] BOM 계획과 같음
☑ 11-11 | P09 | 수중펌프모터 [SZH-GNP155] | 디바이스마트 | 1329770 | 3190 |  |  | 2 | 6380 | 상품 페이지 열기 (https://www.devicemart.co.kr/goods/view?no=1329770) | [무납땜 BOM 대비] BOM 계획과 같음
☑ 11-11 | P15 | 퓨즈 5×20 3A 250V (LB FUSE) | 디바이스마트 | 4537 | 121 |  |  | 3 | 363 | 상품 페이지 열기 (https://www.devicemart.co.kr/goods/view?no=4537) | [무납땜 BOM 대비] BOM 계획과 같음
☑ 11-11 | P16 | 전해 커패시터 16V 1000µF 105℃ (SAMYOUNG, 10×16mm) | 디바이스마트 | 29524 | 99 |  |  | 10 | 990 | 상품 페이지 열기 (https://www.devicemart.co.kr/goods/view?no=29524) | [무납땜 BOM 대비] BOM 계획과 같음
☑ 11-11 | P17 | (선택) 전해 커패시터 16V 100µF 105℃ (5×12mm) | 디바이스마트 | 29522 | 33 |  |  | 10 | 330 | 상품 페이지 열기 (https://www.devicemart.co.kr/goods/view?no=29522) | [무납땜 BOM 대비] BOM 계획과 같음
☑ 11-11 | P18 | 레버형 전선연결 커넥터 8선 결합 PCT-418 (칩센) | 디바이스마트 | 10911193 | 352 |  |  | 4 | 1408 | 상품 페이지 열기 (https://www.devicemart.co.kr/goods/view?no=10911193) | [무납땜 BOM 대비] BOM 계획과 같음
☑ 11-11 | P73 | 하네스 스위치 (101A-5264) — KCD-101A 로커 스위치 + 리드선 200mm | 디바이스마트 | 37135 | 4730 |  |  | 1 | 4730 | 상품 페이지 열기 (https://www.devicemart.co.kr/goods/view?no=37135) | [무납땜 BOM 대비] BOM 계획과 같음
☑ 11-11 | P74 | 퓨즈홀더 FH-201 (빨강, 라인홀더 — 선 달린 인라인형) | 디바이스마트 | 35327 | 726 |  |  | 1 | 726 | 상품 페이지 열기 (https://www.devicemart.co.kr/goods/view?no=35327) | [무납땜 BOM 대비] BOM 계획과 같음
☑ 11-11 | P24 | UL1007 래핑와이어 22AWG 10M 노랑 [VLT-CAB160] | 디바이스마트 | 15960649 | 3630 |  |  | 1 | 3630 | 상품 페이지 열기 (https://www.devicemart.co.kr/goods/view?no=15960649) | [무납땜 BOM 대비] BOM 계획과 같음
☑ 11-11 | P27 | 케이블타이 100mm 1000개 (CableMate UN-100MB 블랙) | 디바이스마트 | 1215043 | 3740 |  |  | 1 | 3740 | 상품 페이지 열기 (https://www.devicemart.co.kr/goods/view?no=1215043) | [무납땜 BOM 대비] BOM 계획과 같음
☑ 11-11 | P28 | 케이블타이 고정용 접착 마운트 20×20mm [SZ-XL015] | 디바이스마트 | 1382746 | 132 |  |  | 10 | 1320 | 상품 페이지 열기 (https://www.devicemart.co.kr/goods/view?no=1382746) | [무납땜 BOM 대비] 단가 계획 145 → 실제 132원(VAT 포함)
☑ 11-11 | P62 | UL1007 래핑와이어 22AWG 10M 검정 [VLT-CAB159] | 디바이스마트 | 15960648 | 3630 |  |  | 1 | 3630 | 상품 페이지 열기 (https://www.devicemart.co.kr/goods/view?no=15960648) | [무납땜 BOM 대비] BOM 계획과 같음
☑ 11-11 | P63 | UL1007 래핑와이어 22AWG 10M 빨강 [VLT-CAB161] | 디바이스마트 | 15960650 | 3630 |  |  | 1 | 3630 | 상품 페이지 열기 (https://www.devicemart.co.kr/goods/view?no=15960650) | [무납땜 BOM 대비] BOM 계획과 같음
☑ 11-11 | P75 | 3선 결합 탈피형 커넥터 PCT-413 (칩센) — 3구 정션형 | 디바이스마트 | 1290839 | 220 |  |  | 10 | 2200 | 상품 페이지 열기 (https://www.devicemart.co.kr/goods/view?no=1290839) | [무납땜 BOM 대비] BOM 계획과 같음
☑ 11-11 | P76 | 2선 결합 탈피형 커넥터 PCT-412 (칩센) — 1:1 이음 | 디바이스마트 | 1290838 | 132 |  |  | 10 | 1320 | 상품 페이지 열기 (https://www.devicemart.co.kr/goods/view?no=1290838) | [무납땜 BOM 대비] BOM 계획과 같음
☑ 11-11 | P77 | 5선 결합 탈피형 커넥터 PCT-415 (칩센) — 앞판 GND 허브 | 디바이스마트 | 1290840 | 253 |  |  | 1 | 253 | 상품 페이지 열기 (https://www.devicemart.co.kr/goods/view?no=1290840) | [무납땜 BOM 대비] BOM 계획과 같음
☑ 11-11 | P78 | 터미널 압착단자 케이블 2.8mm [CG0731] (30cm) | 디바이스마트 | 15306311 | 330 |  |  | 2 | 660 | 상품 페이지 열기 (https://www.devicemart.co.kr/goods/view?no=15306311) | [무납땜 BOM 대비] BOM 계획과 같음
☑ 11-11 | P31 | 체크밸브 JGB32PPS (JG) | 디바이스마트 | 12519260 | 6050 |  |  | 1 | 6050 | 상품 페이지 열기 (https://www.devicemart.co.kr/goods/view?no=12519260) | [무납땜 BOM 대비] BOM 계획과 같음
☑ 11-11 | P35 | 화신박스 단자함 EG AGH-152010 (150×200×100, 플라스틱 속판 포함) | 디바이스마트 | 14003437 | 12320 |  |  | 1 | 12320 | 상품 페이지 열기 (https://www.devicemart.co.kr/goods/view?no=14003437) | [무납땜 BOM 대비] BOM 계획과 같음
☑ 11-11 | P37 | 스텐 둥근머리 십자볼트 M3×10 | 디바이스마트 | 10912297 | 22 |  |  | 25 | 550 | 상품 페이지 열기 (https://www.devicemart.co.kr/goods/view?no=10912297) | [무납땜 BOM 대비] 수량 계획 30 → 실제 25
☑ 11-11 | P38 | 육각 너트(스텐) M3 | 디바이스마트 | 10893596 | 22 |  |  | 25 | 550 | 상품 페이지 열기 (https://www.devicemart.co.kr/goods/view?no=10893596) | [무납땜 BOM 대비] 수량 계획 30 → 실제 25
☑ 11-11 | P39 | M3 알루미늄 서포트 Female 10mm [SZH-ZR059] | 디바이스마트 | 1382352 | 462 |  |  | 4 | 1848 | 상품 페이지 열기 (https://www.devicemart.co.kr/goods/view?no=1382352) | [무납땜 BOM 대비] 단가 계획 508 → 실제 462원(VAT 포함)
☑ 11-11 | P40 | 둥근머리 십자볼트(니켈) M3×6 | 디바이스마트 | 10912222 | 11 |  |  | 10 | 110 | 상품 페이지 열기 (https://www.devicemart.co.kr/goods/view?no=10912222) | [무납땜 BOM 대비] BOM 계획과 같음
☑ 11-11 | P41 | 고무발 S-1 18×10H | 디바이스마트 | 14882214 | 110 |  |  | 10 | 1100 | 상품 페이지 열기 (https://www.devicemart.co.kr/goods/view?no=14882214) | [무납땜 BOM 대비] BOM 계획과 같음
☑ 11-11 | P42 | 순간접착제 LOCTITE 401 20g | 디바이스마트 | 9108 | 4400 |  |  | 1 | 4400 | 상품 페이지 열기 (https://www.devicemart.co.kr/goods/view?no=9108) | [무납땜 BOM 대비] BOM 계획과 같음
☑ 11-11 | P43 | 핫멜트스틱(대) 10개 | 디바이스마트 | 13187167 | 2200 |  |  | 1 | 2200 | 상품 페이지 열기 (https://www.devicemart.co.kr/goods/view?no=13187167) | [무납땜 BOM 대비] BOM 계획과 같음
☑ 11-11 | P64 | Coms 사각 벨크로테이프 10조 (접착식 양면 찍찍이) 55×35mm [T9162] | 디바이스마트 | 15810228 | 1540 |  |  | 1 | 1540 | 상품 페이지 열기 (https://www.devicemart.co.kr/goods/view?no=15810228) | [무납땜 BOM 대비] BOM 계획과 같음
☑ 11-11 | P48 | 디지털 멀티미터 M300 | 디바이스마트 | 10917721 | 8800 |  |  | 1 | 8800 | 상품 페이지 열기 (https://www.devicemart.co.kr/goods/view?no=10917721) | [무납땜 BOM 대비] BOM 계획과 같음
☑ 11-11 | P49 | 와이어 스트리퍼 TU-2022 | 디바이스마트 | 1330598 | 6600 |  |  | 1 | 6600 | 상품 페이지 열기 (https://www.devicemart.co.kr/goods/view?no=1330598) | [무납땜 BOM 대비] BOM 계획과 같음
☑ 11-11 | P72 | [건전지] 23A 12V 알카라인 1알 (멀티미터 M300용) | 디바이스마트 | 10921874 | 770 |  |  | 1 | 770 | 상품 페이지 열기 (https://www.devicemart.co.kr/goods/view?no=10921874) | [무납땜 BOM 대비] 단가 계획 700 → 실제 770원(VAT 포함)
 |  | (참고) 이미 산 것 — 위 '앞으로 살 것 합계'에 넣지 않음, 배송비 제외 |  |  |  |  | 0 |  | 99528
☑ 이미 산 것 — 다이소 — 무납땜 기준 6품목 · 구매 완료 (11-11) · 산 수량은 무납땜 열에
☑ 11-11 | P79 | 전기 절연 테이프 19mm×10m 2개입 | 다이소 | 24482 | 1000 |  |  | 1 | 1000 | 상품 페이지 열기 (https://www.daisomall.co.kr/pd/pdr/SCR_PDR_0001?pdNo=24482) | [무납땜 BOM 대비] BOM 계획과 같음
☑ 11-11 | P32 | 다이소 직사각 저장 용기 970ml (품번 1069852, (주)해창) | 다이소 | 1069852 | 1000 |  |  | 5 | 5000 | 상품 페이지 열기 (https://www.daisomall.co.kr/pd/pdr/SCR_PDR_0001?pdNo=1069852) | [무납땜 BOM 대비] BOM 계획과 같음
☑ 11-11 | P33 | 실리콘 원형 코스터 세트 2개입 (지름 약 10cm) — 드립 매트 | 다이소 | 1038323 | 1000 |  |  | 1 | 1000 | 상품 페이지 열기 (https://www.daisomall.co.kr/pd/pdr/SCR_PDR_0001?pdNo=1038323) | [무납땜 BOM 대비] BOM 계획과 같음
☑ 11-11 | P45 | 원형 네오디뮴 자석 13mm 3개입 (다이소) | 다이소 | 1057293 | 1000 |  |  | 1 | 1000 | 상품 페이지 열기 (https://www.daisomall.co.kr/pd/pdr/SCR_PDR_0001?pdNo=1057293) | [무납땜 BOM 대비] BOM 계획과 같음
☑ 11-11 | P71 | 오공 초강력 폼 양면테이프 투명 18mm×2m (두께 1mm) | 다이소 | 1019760 | 2000 |  |  | 1 | 2000 | 상품 페이지 열기 (https://www.daisomall.co.kr/pd/pdr/SCR_PDR_0001?pdNo=1019760) | [무납땜 BOM 대비] BOM 계획과 같음
☑ 11-11 | P80 | 자석용 보조 설치판 5.5×3.5cm 3개입 (다이소, 접착식 철판) | 다이소 | 1050101 | 1000 |  |  | 1 | 1000 | 상품 페이지 열기 (https://www.daisomall.co.kr/pd/pdr/SCR_PDR_0001?pdNo=1050101) | [무납땜 BOM 대비] BOM 계획과 같음
 |  | (참고) 이미 산 것 — 위 '앞으로 살 것 합계'에 넣지 않음, 배송비 제외 |  |  |  |  | 0 |  | 11000

Sheet: BOM_전체
AI 스마트 바텐더 — 통합 BOM (납땜 기준 · 무납땜 기준 비교, 부품 전체)
팀 홍당무 · 작성 2026-11-11 · 원본 BOM(2026-11-06, research/BOM_원본_20261106.xlsx)을 최신화한 통합판 · 단가 = VAT 포함 판매가(빈칸 = 가격 확인 필요) · 금액 = 구매 수량 × 단가 · '적용' = 그 부품이 어느 기준에 필요한지
No | ID | 분류 | 부품명 | 규격/모델 | 적용 | 필요 납땜 | 필요 무납땜 | 보유 | 구매 납땜 | 구매 무납땜 | 단가(원) VAT 포함 | 금액(원) 납땜 | 금액(원) 무납땜 | 상태 (납땜 / 무납땜) | 지출 완료(원) | 구매처 | 상품번호 | 링크 | 사용 위치 | 비고
1 | P01 | 제어 | ESP32 DevKitC WROOM-32D V4 CP2102 개발보드 [CMODULE-40] (Happy House) | 38핀(19핀×2열), 5V·3V3·GND 전원핀, 마이크로USB(CP2102), EN/BOOT 버튼, 사용자 LED 없음(5V 전원 LED만) | 공통 | 1 | 1 | 2 | 0 | 0 | 9900 | 0 | 0 | 보유 |  | 디바이스마트 | 15313999 | 상품 페이지 (https://www.devicemart.co.kr/goods/view?no=15313999) | 회로도 U1 / STEP 전장부(ESP32 장착) | 1개는 고장 대비 예비(펌웨어를 미리 올려 두면 바로 교체 가능, 앱 개발·시험용 겸용). 전원은 USB·5V핀·3V3핀 중 하나만 사용(Espressif 경고). 5V 핀 실크 표기는 "5V".
2 | P02 | 제어 | ESP32-DevKitC 터미널 확장보드 Push-in 타입 (ElectroCookie) | ESP32-DevKitC(38핀) 전용 소켓+푸시인 단자대, 스탠드오프·나사·20P 리본케이블 동봉 (보드 외형 치수 확인 필요) | 공통 | 1 | 1 | 1 | 0 | 0 | 12100 | 0 | 0 | 주문 완료 (11-11, 배송 대기) | 12100 | 디바이스마트 | 15223173 | 상품 페이지 (https://www.devicemart.co.kr/goods/view?no=15223173) | 회로도 U1 단자 / STEP 전장부 | ✔ 11-11 디바이스마트에서 1개 구매(VAT 별도 단가 11,000원). 대안: CMODULE-47(15315957, 4,400원, 3핀(S/V/G) 헤더형·듀폰 연결, 단자대 아님. 보드 DC잭은 6.5~16V 입력이라 5V 어댑터 연결 금지). DevKitC는 폭이 넓어 830핀 브레드보드 1개에 꽂으면 한쪽 핀 열이 거의 남지 않음.
3 | P03 | 제어 | 메탈 푸쉬 스위치 플랫형 16mm [HX16-B1] (모멘터리) | 일반 PUSH(누르는 동안만 ON), 3A 36VDC, 패널 홀 16mm, 스위치 지름 18mm, LED 없음 | 공통 | 1 | 1 | 1 | 0 | 0 | 2970 | 0 | 0 | 주문 완료 (11-11, 배송 대기) | 2970 | 디바이스마트 | 1325010 | 상품 페이지 (https://www.devicemart.co.kr/goods/view?no=1325010) | 회로도 SW2 / 앞판 상부 | ✔ 11-11 디바이스마트에서 1개 구매(VAT 별도 단가 2,700원). GPIO4 ↔ GND (INPUT_PULLUP). 시작/비상정지 버튼.
4 | P04 | 제어 | 회로내장형 액티브 부저 모듈 [ONE005] | DC 3.3~5V, HIGH 입력 시 울림(액티브), 24×21mm, 고정 홀 | 공통 | 1 | 1 | 1 | 0 | 0 | 1100 | 0 | 0 | 주문 완료 (11-11, 배송 대기) | 1100 | 디바이스마트 | 10916337 | 상품 페이지 (https://www.devicemart.co.kr/goods/view?no=10916337) | 회로도 BZ1 / 앞판 상부(안쪽) | ✔ 11-11 디바이스마트에서 1개 구매(VAT 별도 단가 1,000원). SPEC상 선택 부품. I/O ← GPIO23, VCC ← TB3(3V3). HIGH=울림이라 SPEC v2.1 펌웨어 기본값 BUZZER_ON_LEVEL 1과 일치. (SZH-SDBJ-006 같은 LOW=울림 모듈을 쓰면 BUZZER_ON_LEVEL 0)
5 | P05 | 제어 | 5mm LED 빨강 원통평면형 불투명 [5PR3HD19] | 5파이, 2V, 20mA | 공통 | 1 | 1 | 2 | 0 | 0 | 55 | 0 | 0 | 주문 완료 (11-11, 배송 대기) | 110 | 디바이스마트 | 3218 | 상품 페이지 (https://www.devicemart.co.kr/goods/view?no=3218) | 회로도 LED1 / 앞판 상부 | ✔ 11-11 디바이스마트에서 2개 구매(VAT 별도 단가 50원). DevKitC V4에는 GPIO2 사용자 LED가 없으므로 외부 LED + 220Ω(R1) 필수(SPEC §1). 1개 예비.
6 | P06 | 제어 | 저항 220Ω 1/4W 1% [221F] | 탄소피막, 1/4W, ±1% | 공통 | 1 | 1 | 10 | 0 | 0 | 33 | 0 | 0 | 주문 완료 (11-11, 배송 대기) | 330 | 디바이스마트 | 2001 | 상품 페이지 (https://www.devicemart.co.kr/goods/view?no=2001) | 회로도 R1 | ✔ 11-11 디바이스마트에서 10개 구매(VAT 별도 단가 30원). 최소주문 10개. LED 전류 약 6mA.
7 | P07 | 제어 | Micro USB 5핀 데이터 케이블 1m | USB-A ↔ micro-B, 데이터 통신 가능 | 공통 | 1 | 1 | 1 | 0 | 0 | 770 | 0 | 0 | 주문 완료 (11-11, 배송 대기) | 770 | 디바이스마트 | 32695 | 상품 페이지 (https://www.devicemart.co.kr/goods/view?no=32695) | STEP 펌웨어 업로드 | ✔ 11-11 디바이스마트에서 1개 구매(VAT 별도 단가 700원). 펌웨어 업로드용. 데이터 전송되는 케이블이 이미 있으면 구매 불필요(충전 전용 케이블은 PC가 인식 못 함).
8 | P08 | 구동 | 아두이노 4채널 5V 릴레이 모듈 [SZH-RLBG-012] | TONGLING JQC-3FF-S-Z 5VDC(코일 약 70Ω≈71mA, 0.36W), 접점 10A 250VAC/10A 30VDC, 채널별 옵토커플러+표시LED, 2핀 JD-VCC/VCC 점퍼(별도 코일 GND핀 없음 → 코일 GND는 메인 헤더 GND), Active-LOW, 76×56mm, M3용 3mm 홀(간격 69.6×49.4mm) | 공통 | 1 | 1 | 2 | 0 | 0 | 4180 | 0 | 0 | 보유 |  | 디바이스마트 | 1327545 | 상품 페이지 (https://www.devicemart.co.kr/goods/view?no=1327545) | 회로도 K1~K4(릴레이 CH1~CH4) / STEP 전장부 | 1개는 예비(펌프 5~8 확장·고장 대비). A안(기본: JD-VCC 점퍼 제거, VCC=3V3)으로 안 켜지면 B안(SPEC 공식 대체안, USB·어댑터를 모두 뺀 상태에서: ① 입력 헤더 VCC ← 3V3 선(⑪)을 먼저 뽑음 → ② 5V 선(⑨)을 JD-VCC 핀에서 빼서 입력 헤더 VCC 핀에 꽂음 → ③ 점퍼 캡을 끼움 (VCC = JD-VCC = 5V, 점퍼가 2핀이라 JD-VCC 핀에는 캡만). B안에서 VCC를 3V3에 연결 금지) — parts_research.md 3.2절.
9 | P09 | 구동 | 수중펌프모터 [SZH-GNP155] | 정격 DC 3V(0.12A·80L/H·양정0.35m) / 4.5V(0.18A·100L/H·양정0.55m), 판매처 5V 연결 안내, 출수구 외경 7.5mm·내경 4.9mm, 본체 약 43×23mm, IP68, 튜브 미포함, 식품등급 표기 없음, 해외입고품(AS 불가) | 공통 | 4 | 4 | 6 | 0 | 0 | 3190 | 0 | 0 | 주문 완료 (11-11, 배송 대기) | 6380 | 디바이스마트 | 1329770 | 상품 페이지 (https://www.devicemart.co.kr/goods/view?no=1329770) | 회로도 M1~M4 / STEP 용기·펌프 | ✔ 11-11 디바이스마트에서 2개 구매(VAT 별도 단가 2,900원). qtyToBuy 2 = 고장 대비 예비(권장, 필수 아님 — 기말 시연·논문 실험 중 펌프가 고장 나면 바로 교체). 물 없이 공회전 금지. 식품등급 표기·본체 재질 미확인 → 시음하려면 재질 확인 또는 연동 펌프(P55)로 교체(조립가이드 1.3).
10 | P10 | 구동 | 다이오드 1N4007 | 1A 1000V, DO-41 | 공통 | 4 | 4 | 10 | 0 | 0 | 22 | 0 | 0 | 보유 |  | 디바이스마트 | 3011 | 상품 페이지 (https://www.devicemart.co.kr/goods/view?no=3011) | 회로도 D1~D4 | 펌프마다 병렬 1개: 띠(캐소드)→펌프(+)(=릴레이 NO 쪽), 반대쪽(애노드)→펌프(−)(=GND). 위치는 펌프 리드 이음부 또는 연장선의 박스 쪽 끝(전기적으로 동일, SPEC §1).
11 | P11 | 전원 | 아답터 100~240V / 5V 4A [내경2.1~2.5/외경5.5mm] 전원 코드 일체형 | 5V 4A, DC 케이블 150cm, 과전류·과전압·단락 보호 | 공통 | 1 | 1 | 1 | 0 | 0 | 8360 | 0 | 0 | 보유 |  | 디바이스마트 | 12233458 | 상품 페이지 (https://www.devicemart.co.kr/goods/view?no=12233458) | 회로도 어댑터(J1에 꽂음) / STEP 전원 | 최대 소비 추정 약 1.3A(병렬 구동 시) → 여유 충분. 코드 일체형이라 플러그를 뒤판 G의 Ø12 구멍으로 통과시킴 → 플러그 몸통 지름이 12mm 이하인지 실측(확인 필요).
12 | P12 | 전원 | 터미널블럭 to DC 커넥터 (DC2.1 FEMALE) [SZH-LC002] | DC잭 2.1×5.5mm(암), 최대 20A, 1~38V, 나사 단자 | 공통 | 1 | 1 | 2 | 0 | 0 | 550 | 0 | 0 | 보유 |  | 디바이스마트 | 1321144 | 상품 페이지 (https://www.devicemart.co.kr/goods/view?no=1321144) | 회로도 J1 / 전장 박스 | 1개 예비. 어댑터 플러그를 꽂는 입력 단자(전장 박스 안).
13 | P13 | 전원 | 로커 스위치 KCD1-101A (ON/OFF, SPST) | 2P, 6A 250VAC / 10A 125VAC | 납땜 기준만 | 1 | 0 | 0 | 1 | 0 | 330 | 330 | 0 | 구매 필요 / 불필요 (P73 하네스 스위치로 대체) |  | 디바이스마트 | 1790 | 상품 페이지 (https://www.devicemart.co.kr/goods/view?no=1790) | 회로도 SW1(전원 스위치) / STEP4 뒤판 G 사각 구멍 | [납땜] 회로도 SW1. 단자는 납땜(가이드 STEP4 절차 4). 5mm 포맥스라 스냅 클립이 안 걸리면 G 안쪽 구멍 둘레를 커터칼로 얇게 파거나 글루건으로 보강(추정). / [무납땜] 단자가 납땜·탭형이라 무납땜 기준에서는 선이 달린 같은 계열 스위치(P73)를 씀.
14 | P14 | 전원 | 패널형 퓨즈홀더 FH-303 (5×20mm 유리관용) | 10A 250V, 너트 고정형, 납땜 단자 | 납땜 기준만 | 1 | 0 | 0 | 1 | 0 | 583 | 583 | 0 | 구매 필요 / 불필요 (P74 인라인 퓨즈홀더로 대체) |  | 디바이스마트 | 4577 | 상품 페이지 (https://www.devicemart.co.kr/goods/view?no=4577) | 회로도 F1(퓨즈홀더) / STEP4 뒤판 G 둥근 구멍 | [납땜] J1(+) → SW1 → F1 → TB1(+5V 버스). 장착 구멍 지름 실측(확인 필요, 나사 몸통 약 Ø12~13mm 추정). STEP4에서 뒤판 G 둥근 구멍에 바깥에서 끼우고 안쪽 너트로 고정한 뒤 납땜(SW1과 함께). / [무납땜] FH-303은 납땜 러그라 무납땜으로 쓸 수 없음. 뒤판 G의 퓨즈 구멍도 필요 없어짐.
15 | P15 | 전원 | 퓨즈 5×20 3A 250V (LB FUSE) | 5파이×20mm, 3A | 공통 | 1 | 1 | 3 | 0 | 0 | 121 | 0 | 0 | 주문 완료 (11-11, 배송 대기) | 363 | 디바이스마트 | 4537 | 상품 페이지 (https://www.devicemart.co.kr/goods/view?no=4537) | [납땜] 회로도 F1(3A 퓨즈, P14 홀더에 장착) / [무납땜] 회로도 F1(3A 퓨즈, P74 인라인 홀더에 넣음) | ✔ 11-11 디바이스마트에서 3개 구매(VAT 별도 단가 110원). 2개 예비(예비 퓨즈는 기기와 함께 보관).
16 | P16 | 전원 | 전해 커패시터 16V 1000µF 105℃ (SAMYOUNG, 10×16mm) | 16V / 1000µF / 105℃ / 10×16 DIP | 공통 | 1 | 1 | 10 | 0 | 0 | 99 | 0 | 0 | 주문 완료 (11-11, 배송 대기) | 990 | 디바이스마트 | 29524 | 상품 페이지 (https://www.devicemart.co.kr/goods/view?no=29524) | 회로도 C1 | ✔ 11-11 디바이스마트에서 10개 구매(VAT 별도 단가 90원). 최소주문 10개. TB1(+5V) 1번 ↔ TB2(GND) 8번 사이(연결 ⑥). 극성 주의(긴 다리·무표시 쪽 +, 띠 쪽 −).
17 | P17 | 전원 | (선택) 전해 커패시터 16V 100µF 105℃ (5×12mm) | 16V / 100µF / 105℃ | 공통 | 1 | 1 | 10 | 0 | 0 | 33 | 0 | 0 | 주문 완료 (11-11, 배송 대기) | 330 | 디바이스마트 | 29522 | 상품 페이지 (https://www.devicemart.co.kr/goods/view?no=29522) | C2(선택, 회로도 외 보조) / 확장보드 5V–GND | ✔ 11-11 디바이스마트에서 10개 구매(VAT 별도 단가 30원). 최소주문 10개. ESP32 확장보드 5V-GND 단자 근처 보조 커패시터(선택, 회로도에는 없음 — ESP32 재부팅이 잦을 때만).
18 | P18 | 전원 | 레버형 전선연결 커넥터 8선 결합 PCT-418 (칩센) | 8구 전부 공통 결선, AWG28~14(0.08~4.0mm²), 단선·연선 가능, 40.1×21×14.4mm | 공통 | 3 | 3 | 4 | 0 | 0 | 352 | 0 | 0 | 주문 완료 (11-11, 배송 대기) | 1408 | 디바이스마트 | 10911193 | 상품 페이지 (https://www.devicemart.co.kr/goods/view?no=10911193) | 회로도 TB1(+5V)·TB2(GND)·TB3(3V3) / 전장 박스 | [납땜] ✔ 11-11 디바이스마트에서 4개 구매(VAT 별도 단가 320원). 회로도 v3 기준 3개 사용 + 1개 예비. TB1 = +5V 버스(8구 모두: F1 출력④·ESP32 5V⑧·JD-VCC⑨·K1~K4 COM⑰~⑳·C1+⑥), TB2 = GND 버스(J1−⑤·펌프(−)×4 ㉒㉔㉖㉘·C1−⑥, 2구 예비), TB3 = 3V3 분배(ESP32 3V3⑩ → 릴레이 VCC⑪(A안)·부저 VCC㉙). ESP32 GND는 J1(−)에서 바로(⑦, 별형 접지), 다이오드는 펌프 선에 납땜하므로 GND 커넥터는 TB2 하나로 충분. / [무납땜] ✔ 11-11 디바이스마트에서 4개 구매(VAT 별도 단가 320원). TB1 +5V · TB2 GND · TB3 3V3 분배 3개 + 예비 1. 무납땜 기준에서 다이오드는 뚜껑 위 PCT-413(P75)에 있으므로 GND 커넥터는 TB2 하나로 충분.
19 | P73 | 전원 | 하네스 스위치 (101A-5264) — KCD-101A 로커 스위치 + 리드선 200mm | ON/OFF 로커(비조광), 선이 공장에서 달려 나옴(끝의 5264 커넥터는 잘라 피복 벗김). 리드 굵기 확인 필요(AWG22 이상 권장) | 무납땜 기준만 | 0 | 1 | 1 | 0 | 0 | 4730 | 0 | 0 | 해당 없음 / 주문 완료 (11-11, 배송 대기) | 4730 | 디바이스마트 | 37135 | 상품 페이지 (https://www.devicemart.co.kr/goods/view?no=37135) | 회로도 SW1 / STEP4 뒤판 G 사각 구멍 | ✔ 11-11 디바이스마트에서 1개 구매(VAT 별도 단가 4,300원). P13 대신. G 사각 구멍은 그대로(받은 스위치 몸통을 재서 0.5mm 작게 표시 → 줄로 맞춤). 5mm 판이라 '딸깍' 고정이 약하면 글루건 보강(추정). 리드는 필요한 길이만 남겨 자르고, 나머지 거리는 AWG20(②)으로 이음. 리드가 가늘어 벗길 때 끊기지 않게 조심. 2주 기다릴 수 있으면 나사 단자 셀렉터 스위치 슈나이더 XA2AD21(3,080원 + 업체 택배 3,300원, G에 Ø22.3 둥근 구멍)도 가능.
20 | P74 | 전원 | 퓨즈홀더 FH-201 (빨강, 라인홀더 — 선 달린 인라인형) | 5×20mm 유리관 퓨즈용, 15A, 양쪽 리드선(굵기 확인) | 무납땜 기준만 | 0 | 1 | 1 | 0 | 0 | 726 | 0 | 0 | 해당 없음 / 주문 완료 (11-11, 배송 대기) | 726 | 디바이스마트 | 35327 | 상품 페이지 (https://www.devicemart.co.kr/goods/view?no=35327) | 회로도 F1 / 뒤판 G 안쪽(박스 밖) | ✔ 11-11 디바이스마트에서 1개 구매(VAT 별도 단가 660원). P14 대신. 퓨즈 P15(3A)를 그대로 넣음. 홀더는 박스 밖, 상판 C를 열었을 때 손이 닿는 G 안쪽 위쪽에 케이블타이로 고정(볼트·브래킷 금속에 닿지 않게). 퓨즈 교체·STEP4 '퓨즈 빼면 0V' 시험은 상판 C를 열고 함.
21 | P19 | 배선 | AWG20 2P 10M (검정, 빨강) | 2심 평행선 AWG20 | 공통 | 1 | 1 | 1 | 0 | 0 | 10340 | 0 | 0 | 보유 |  | 디바이스마트 | 13003174 | 상품 페이지 (https://www.devicemart.co.kr/goods/view?no=13003174) | 전원·펌프 배선 | 5V/GND 전원 배선 + 펌프 리드선 연장(펌프당 약 0.7m × 4 ≈ 2.8m).
22 | P20 | 배선 | 점퍼 케이블 40P (F/F) | 2.54mm 듀폰 | 공통 | 1 | 1 | 1 | 0 | 0 | 1100 | 0 | 0 | 보유 |  | 디바이스마트 | 32284 | 상품 페이지 (https://www.devicemart.co.kr/goods/view?no=32284) | 릴레이 신호선 | 릴레이 IN 헤더 ↔ 확장보드(한쪽 끝을 잘라 피복을 벗겨 푸시인 단자에 삽입).
23 | P21 | 배선 | 점퍼 케이블 40P (M/F) | 2.54mm 듀폰 | 공통 | 1 | 1 | 1 | 0 | 0 | 1100 | 0 | 0 | 보유 |  | 디바이스마트 | 1113721 | 상품 페이지 (https://www.devicemart.co.kr/goods/view?no=1113721) | 릴레이 신호선 | 신호선/시험용.
24 | P22 | 배선 | 점퍼 케이블 40P (M/M) | 2.54mm 듀폰 | 공통 | 1 | 1 | 1 | 0 | 0 | 1100 | 0 | 0 | 보유 |  | 디바이스마트 | 1113722 | 상품 페이지 (https://www.devicemart.co.kr/goods/view?no=1113722) | STEP 벤치 테스트 | 브레드보드 시험용.
25 | P23 | 배선 | 브레드보드 830핀 MB-102 [SZH-BBAD-002] | 830홀 | 공통 | 1 | 1 | 2 | 0 | 0 | 1540 | 0 | 0 | 보유 |  | 디바이스마트 | 1322408 | 상품 페이지 (https://www.devicemart.co.kr/goods/view?no=1322408) | STEP 벤치 테스트 | 조립 전 회로 시험(벤치 테스트)용. 본체에는 미사용.
26 | P24 | 배선 | UL1007 래핑와이어 22AWG 10M 노랑 [VLT-CAB160] | UL1007, 22AWG, 노랑 | 공통 | 1 | 1 | 1 | 0 | 0 | 3630 | 0 | 0 | 주문 완료 (11-11, 배송 대기) | 3630 | 디바이스마트 | 15960649 | 상품 페이지 (https://www.devicemart.co.kr/goods/view?no=15960649) | 앞판 신호선 ㉙·㉚·㉝·㉟ | ✔ 11-11 디바이스마트에서 1개 구매(VAT 별도 단가 3,300원). 앞판 신호선(㉙ 부저 VCC 연장·㉚ 부저 I/O·㉝ 버튼·㉟ LED)용. 앞판 신호선 ㉙·㉚·㉝·㉟는 모두 이 노랑(연결표와 같음)이고 4가닥이 같은 색이라 선 양 끝 번호 테이프로 구분(㉙는 연결표대로 듀폰 주황으로 이어도 됨). GND선과 5V선은 색을 나눔: GND선(⑦·앞판 GND 공통선 ㉛·㉜·㉞·㊱) = 검정 P62, ESP32 5V선(⑧) = 빨강 P63(같은 시리즈·같은 값). 단가는 상품 페이지 확인(VAT 별도 3,300원).
27 | P25 | 배선 | 열 수축 솔더 슬리브 1.0SQ [SZH-CA002] | 납+접착제 내장 수축튜브(무납땜 접속), 1.0SQ용 | 납땜 기준만 | 8 | 0 | 10 | 0 | 0 | 330 | 0 | 0 | 보유 / 보유 (무납땜 기준에서는 안 씀) |  | 디바이스마트 | 12507090 | 상품 페이지 (https://www.devicemart.co.kr/goods/view?no=12507090) | 펌프 리드 연장 | [납땜] 펌프 리드 ↔ AWG20 연장선 접속(펌프당 2개=8개). 열풍기 필요. / [무납땜] 펌프 리드 이음을 3구 레버 커넥터 P75로 바꿈. 리드가 짧아 뚜껑 안쪽에서 이어야 할 때만(방수 필요) 학교에서 열풍기로 씀.
28 | P26 | 배선 | NT DIY 열수축튜브 328세트 | 8규격 5색, 40mm 컷팅 | 공통 | 1 | 1 | 0 | 1 | 0 | 4290 | 4290 | 0 | 구매 필요 / 선택(무납땜에서는 효과 작음) |  | 디바이스마트 | 1320936 | 상품 페이지 (https://www.devicemart.co.kr/goods/view?no=1320936) | 배선 절연 | [납땜] 다이오드 다리·납땜부 절연. / [무납땜] 열을 쓰지 않으므로 수축이 안 됨. 헐겁게 씌워 절연테이프 P79로 고정할 때만 필요 — 절연테이프만 써도 됨. 11-11 주문에는 넣지 않았음 — 나중에 따로 사면 배송비(66,000원 미만 2,700원)가 붙으니 다른 주문과 묶어 삼.
29 | P27 | 배선 | 케이블타이 100mm 1000개 (CableMate UN-100MB 블랙) | 100mm | 공통 | 1 | 1 | 1 | 0 | 0 | 3740 | 0 | 0 | 주문 완료 (11-11, 배송 대기) | 3740 | 디바이스마트 | 1215043 | 상품 페이지 (https://www.devicemart.co.kr/goods/view?no=1215043) | 배관·배선 정리 | ✔ 11-11 디바이스마트에서 1개 구매(VAT 별도 단가 3,400원). 튜브-바브 연결부 조임, 배선 정리.
30 | P28 | 배선 | 케이블타이 고정용 접착 마운트 20×20mm [SZ-XL015] | 양면테이프 부착형 | 공통 | 10 | 10 | 10 | 0 | 0 | 132 | 0 | 0 | 주문 완료 (11-11, 배송 대기) | 1320 | 디바이스마트 | 1382746 | 상품 페이지 (https://www.devicemart.co.kr/goods/view?no=1382746) | 배관 고정 | ✔ 11-11 디바이스마트에서 10개 구매(VAT 별도 단가 120원). 최소주문 10개. 선반 아래 체크밸브·튜브 고정.
31 | P62 | 배선 | UL1007 래핑와이어 22AWG 10M 검정 [VLT-CAB159] | UL1007, 22AWG, 검정 | 공통 | 1 | 1 | 1 | 0 | 0 | 3630 | 0 | 0 | 주문 완료 (11-11, 배송 대기) | 3630 | 디바이스마트 | 15960648 | 상품 페이지 (https://www.devicemart.co.kr/goods/view?no=15960648) | [납땜] ESP32 GND ⑦ · 앞판 GND 이음점 ㉛·㉜·㉞·㊱ / [무납땜] ESP32 GND ⑦ · 앞판 GND ㉛(PCT-415로) | [납땜] ✔ 11-11 디바이스마트에서 1개 구매(VAT 별도 단가 3,300원). ESP32 GND선 ⑦(J1 − 나사 → J3-1, 약 20cm)과 앞판 GND(㉛ 약 40cm + 짧은 선 ㉜·㉞·㊱ 각 약 8cm를 한 점에서 납땜) — 합계 약 1m. ⑦(GND 검정)과 ⑧(5V 빨강, P63)을 색으로 구분해 바꿔 무는 실수(ESP32 역전압)를 막음. 10M 단위 판매. 단가는 상품 페이지 확인(VAT 별도 3,300원). / [무납땜] ✔ 11-11 디바이스마트에서 1개 구매(VAT 별도 단가 3,300원). ESP32 GND선 ⑦(J1 − 나사 → J3-1, 약 20cm)과 앞판 GND ㉛(약 40cm, PCT-415 GND 모음으로) — 합계 약 0.6m. ㉜·㉞·㊱은 듀폰·CG0731·LED 다리로 PCT-415에 바로 꽂음. ⑦(GND 검정)과 ⑧(5V 빨강, P63)을 색으로 구분해 바꿔 무는 실수(ESP32 역전압)를 막음. 10M 단위 판매. 단가는 상품 페이지 확인(VAT 별도 3,300원).
32 | P63 | 배선 | UL1007 래핑와이어 22AWG 10M 빨강 [VLT-CAB161] | UL1007, 22AWG, 빨강 | 공통 | 1 | 1 | 1 | 0 | 0 | 3630 | 0 | 0 | 주문 완료 (11-11, 배송 대기) | 3630 | 디바이스마트 | 15960650 | 상품 페이지 (https://www.devicemart.co.kr/goods/view?no=15960650) | ESP32 5V ⑧ | ✔ 11-11 디바이스마트에서 1개 구매(VAT 별도 단가 3,300원). ESP32 5V선 ⑧(TB1-7 → J2-19, 약 20cm). 검정 P62와 색으로 극성 구분. 10M 단위 판매라 대부분 남음 → 2학기 확장(로드셀·추가 펌프) 전원선으로 활용. 단가는 상품 페이지 확인(VAT 별도 3,300원).
33 | P75 | 배선 | 3선 결합 탈피형 커넥터 PCT-413 (칩센) — 3구 정션형 | 3구가 모두 이어짐, 0.08~2.5mm² (AWG28~14), 피복 9~10mm, 재사용 가능 | 무납땜 기준만 | 0 | 8 | 10 | 0 | 0 | 220 | 0 | 0 | 해당 없음 / 주문 완료 (11-11, 배송 대기) | 2200 | 디바이스마트 | 1290839 | 상품 페이지 (https://www.devicemart.co.kr/goods/view?no=1290839) | STEP3 펌프 리드 이음 + 다이오드 D1~D4 (뚜껑 위) | ✔ 11-11 디바이스마트에서 10개 구매(VAT 별도 단가 200원). 펌프마다 2개: ① 연장선 빨강 + 다이오드 띠(캐소드) 다리 + 펌프 빨강, ② 연장선 검정 + 다이오드 반대 다리 + 펌프 검정. 한 구멍에 한 가닥. 레버를 내린 커넥터 2개와 다이오드를 절연테이프 P79로 한 덩어리로 감고, 뚜껑 윗면에서 1~2cm 띄워 케이블타이로 연장선에 고정(방수가 아니므로 리필 때 이 위로 붓지 않음). 펌프 리드가 뚜껑 위로 3cm 이상 나와야 함. 레버형인지 받으면 확인. 8 + 예비 2.
34 | P76 | 배선 | 2선 결합 탈피형 커넥터 PCT-412 (칩센) — 1:1 이음 | 0.08~2.5mm² (AWG28~14), 피복 9~10mm, 재사용 가능 | 무납땜 기준만 | 0 | 8 | 10 | 0 | 0 | 132 | 0 | 0 | 해당 없음 / 주문 완료 (11-11, 배송 대기) | 1320 | 디바이스마트 | 1290838 | 상품 페이지 (https://www.devicemart.co.kr/goods/view?no=1290838) | STEP4 ②–SW1 · SW1–F1(연결표 ③ 대신) · F1–④ 3곳 · STEP9 ㉙·㉚·㉝·LED↔R1·R1↔㉟ 5곳 | ✔ 11-11 디바이스마트에서 10개 구매(VAT 별도 단가 120원). 전원부 3 + 앞판 5 + 예비 2. 전원부 이음은 박스 밖 G 쪽에 두고 케이블타이로 고정. ㉙(3V3) 이음은 피복을 9~10mm로만 벗김 — 남은 심선이 옆의 LED·R1 다리나 버튼 단자(GND)에 닿으면 3V3 단락. 가는 듀폰선은 벗긴 끝을 반으로 접어 꼬아 넣고 당겨 봄.
35 | P77 | 배선 | 5선 결합 탈피형 커넥터 PCT-415 (칩센) — 앞판 GND 허브 | 5구 공통, 0.08~2.5mm² (AWG28~14) | 무납땜 기준만 | 0 | 1 | 1 | 0 | 0 | 253 | 0 | 0 | 해당 없음 / 주문 완료 (11-11, 배송 대기) | 253 | 디바이스마트 | 1290840 | 상품 페이지 (https://www.devicemart.co.kr/goods/view?no=1290840) | STEP9 앞판 GND ㉛·㉜·㉞·㊱ | ✔ 11-11 디바이스마트에서 1개 구매(VAT 별도 단가 230원). 앞판 GND 공통선(가지치기 납땜) 대신. 버튼 단자 2(㉞)·LED 짧은 다리(㊱)·부저 GND(㉜)·박스로 가는 검정 ㉛을 한 곳에. F 안쪽 박스 오른쪽 빈 공간 쪽에 폼 양면테이프(P71)로 붙임.
36 | P78 | 배선 | 터미널 압착단자 케이블 2.8mm [CG0731] (30cm) | 2.8mm 암 평형 단자가 압착된 선(다른 끝은 피복 벗김) | 무납땜 기준만 | 0 | 2 | 2 | 0 | 0 | 330 | 0 | 0 | 해당 없음 / 주문 완료 (11-11, 배송 대기) | 660 | 디바이스마트 | 15306311 | 상품 페이지 (https://www.devicemart.co.kr/goods/view?no=15306311) | STEP9 버튼 SW2 단자 2곳 | ✔ 11-11 디바이스마트에서 2개 구매(VAT 별도 단가 300원). 버튼 단자 2곳에 꽂고 다른 끝을 PCT-412(노랑 ㉝)·PCT-415(GND)에. 빨강은 5V에만 쓰는 규칙이라 검정으로 주문하되, 단자 1 쪽 선(GPIO4 신호)은 양 끝에 ㉝ 번호 테이프를 감아 GND와 구분. 빨강·검정이 아닌 색을 고를 수 있으면 1개는 그 색. 버튼 단자 개수·폭(2.8mm)은 받으면 확인 — 안 맞으면 심선을 러그 구멍에 감아 꼬고 테이프, 또는 학교에서 2곳만 납땜. STEP2 벤치 시험의 버튼 연결에도 씀.
37 | P79 | 배선 | 전기 절연 테이프 19mm×10m 2개입 | PVC | 무납땜 기준만 | 0 | 1 | 1 | 0 | 0 | 1000 | 0 | 0 | 해당 없음 / 구매 완료 (11-11) | 1000 | 다이소 | 24482 | 상품 페이지 (https://www.daisomall.co.kr/pd/pdr/SCR_PDR_0001?pdNo=24482) | 다이오드 다리 · 저항 R1 · 이음부 절연 | ✔ 11-11 다이소에서 1개 구매(단가 1,000원). 열을 써야 하는 수축튜브 대신(또는 수축튜브를 헐겁게 씌우고 감아 고정).
38 | P29 | 배관 | 실리콘 튜브 1M 내경 5mm (외경 7mm) [K11168275] | 내경5/외경7mm, 1m, 한국산, 식품등급 표기 없음 | 공통 | 3 | 3 | 8 | 0 | 0 | 1870 | 0 | 0 | 보유 |  | 디바이스마트 | 14115487 | 상품 페이지 (https://www.devicemart.co.kr/goods/view?no=14115487) | 배관(펌프→체크밸브) | 펌프 출수구(외경 7.5mm)에 끼움 → 체크밸브 앞까지. 펌프당 약 0.7m(용기 인출 여유 포함). 식품등급 표기 없음 → 시음 전에는 식품용 P65로 교체(선택, 조립가이드 1.3).
39 | P30 | 배관 | 실리콘 튜브 1M 내경 4mm (외경 6mm) [K11168264] | 내경4/외경6mm, 1m, 한국산, 식품등급 표기 없음 | 공통 | 1 | 1 | 5 | 0 | 0 | 1760 | 0 | 0 | 보유 |  | 디바이스마트 | 14115486 | 상품 페이지 (https://www.devicemart.co.kr/goods/view?no=14115486) | 배관(체크밸브↔노즐) | 체크밸브 바브(Ø3.2~5.0)용: ①입구 바브에 3cm 슬리브 → 그 바깥(외경6)에 내경5 튜브를 1.5cm 겹쳐 끼우고 케이블타이 ②출구 → 노즐 약 10cm. 식품등급 표기 없음 → 시음 전에는 식품용 P66으로 교체(선택, 조립가이드 1.3).
40 | P31 | 배관 | 체크밸브 JGB32PPS (JG) | 덕빌형, 개방압 2kPa(약 20cm 물기둥), 배압 3bar, 전장 35.3~35.8mm, 바브 Ø3.2(끝)~5.0(턱), 내부 유로 Ø2.0mm, 판매처 설명상 공기용, 재질/식품적합성 미표기 | 공통 | 4 | 4 | 5 | 0 | 0 | 6050 | 0 | 0 | 주문 완료 (11-11, 배송 대기) | 6050 | 디바이스마트 | 12519260 | 상품 페이지 (https://www.devicemart.co.kr/goods/view?no=12519260) | 배관 CV1~CV4 / STEP 배관 | ✔ 11-11 디바이스마트에서 1개 구매(VAT 별도 단가 5,500원). qtyToBuy 1 = 고장·막힘 대비 예비. 화살표(FLOW)가 노즐 쪽을 향하게, 노즐 직전에 설치. 유로 Ø2.0mm라 유량이 크게 줄 수 있음(parts_research.md 3.3절). 판매처 설명상 공기용·재질 미표기 → 시음 전에는 식품용 P67로 교체(선택, 조립가이드 1.3).
41 | P32 | 배관 | 다이소 직사각 저장 용기 970ml (품번 1069852, (주)해창) | 약 105(앞뒤) × 80(좌우) × 150mm(높이, 뚜껑 포함 — 상세 치수도). 몸체 PET · 나사식 뚜껑 PP, 식품용 기구 표시. 입구 안지름 약 64~70mm(사진 비례 추정) | 공통 | 4 | 4 | 5 | 0 | 0 | 1000 | 0 | 0 | 구매 완료 (11-11) | 5000 | 다이소 | 1069852 | 상품 페이지 (https://www.daisomall.co.kr/pd/pdr/SCR_PDR_0001?pdNo=1069852) | STEP 용기 준비 | ✔ 11-11 다이소에서 5개 구매(단가 1,000원). W420 기준(좌우 ≤95·앞뒤 ≤135·높이 ≤170)을 상품 페이지로 확인(2026-11-10). 좁은 80mm 쪽을 좌우로 놓음. 후보 셋 중 단면이 가장 넓고(약 81~83cm²) 낮아 액면 변화가 가장 작음(설계 기준 '낮고 넓을수록 좋음'). 칸 폭 98.75에서 좌우 여유 약 16~19mm → 가이드 N(용기 사이)으로 자리 고정. 눈금 없음. 같은 회사 대안: 원형 저장 용기 900ml(1035184, 지름 94×165) · 사각 저장 용기 800ml(1027241, 80×80×165). 4개 + 예비 1(뚜껑 구멍 뚫다 깨질 때 대비). 나사식 뚜껑이라 리필 때 뚜껑을 잡고 몸통을 돌림. 몸체 PET 60℃까지(열탕·식기세척기 금지). 처음 산 TARK 1L(165×120×80)은 취소.
42 | P33 | 배관 | 실리콘 원형 코스터 세트 2개입 (지름 약 10cm) — 드립 매트 | 지름 약 10cm, 가장자리 턱이 낮은 실리콘 매트 2개(그레이·브라운). 높이 몇 mm(표기 없음) | 공통 | 1 | 1 | 1 | 0 | 0 | 1000 | 0 | 0 | 구매 완료 (11-11) | 1000 | 다이소 | 1038323 | 상품 페이지 (https://www.daisomall.co.kr/pd/pdr/SCR_PDR_0001?pdNo=1038323) | STEP 잔 받침 | ✔ 11-11 다이소에서 1개 구매(단가 1,000원). 잔 칸 바닥(150×100mm)에 깔아 방울을 받음 — 치수 조건(≤150×100, 높이 ≤15mm)을 모두 맞는 다이소몰 상품(2026-11-10). 턱이 얕아 몇 방울만 받으므로 시연 중 자주 닦음. 물을 더 받고 싶으면 분리형 모던 비누 받침(1063199, 14×9.5×3cm, 1,000원)도 되지만 높이 30mm라 잔 높이 한계가 약 175mm로 줄어듦(추정).
43 | P34 | 외형 | 포맥스(PVC 발포보드) 5T 흰색 600×900mm | 5mm 두께, 커터칼 재단 가능 | 공통 | 3 | 3 | 3 | 0 | 0 |  |  |  | 구매 완료 | 43000 | 구매 완료 — 판매처는 영수증 참고 |  |  | STEP 외형(재단표 A~N) | 2026-11-10 3장 구매 완료(43,000원). 600×900 통판이면 재단표(부록 B, W420)대로 직접 재단 — 커터칼·쇠자 60cm 이상·커팅매트(P54) 필요. 노즐 판 M1·M2는 출력 노즐 블록 02를 쓰므로 자르지 않음.
44 | P35 | 외형 | 화신박스 단자함 EG AGH-152010 (150×200×100, 플라스틱 속판 포함) | 전장부 전용 박스(액체와 격리) | 공통 | 1 | 1 | 1 | 0 | 0 | 12320 | 0 | 0 | 주문 완료 (11-11, 배송 대기) | 12320 | 디바이스마트 | 14003437 | 상품 페이지 (https://www.devicemart.co.kr/goods/view?no=14003437) | STEP5 전장부 / STEP10 선반 D 위 | ✔ 11-11 디바이스마트에서 1개 구매(VAT 별도 단가 11,200원). 선반 위에 올리고 ESP32·릴레이·분배 커넥터를 내부에 배치. 벽 구멍: 좌·우 Ø12(펌프 선), 뒤 Ø16(어댑터 선·SW1/F1 선), 앞 Ø10(앞판 신호선) — 배선 후 글루건으로 막음. 내부 유효 치수 실측(확인 필요). 선반 D에는 접착식 벨크로(P64) 4쌍으로 고정(기본, 박스 바닥·D에 구멍 없음). 볼트 고정은 선택: 뒤쪽 두 모서리(본체 x 약 115·295, y 약 180)만, M3×15(P68).
45 | P36 | 외형 | L자 꺾쇠(소형, 약 25mm) | 철제, 나사 구멍 2개 | 둘 다 불필요 | 0 | 0 | 0 | 0 | 0 |  |  |  | 불필요 (출력 브래킷 01로 대체) |  | 다이소/철물점 |  |  | STEP 외형 조립 | 3D 프린팅 모서리 브래킷 01(P70) 12개 + 예비 2를 씀. 출력 부품이 없을 때만 12개.
46 | P37 | 외형 | 스텐 둥근머리 십자볼트 M3×10 | M3, 10mm, SUS | 공통 | 24 | 24 | 25 | 0 | 0 | 22 | 0 | 0 | 주문 완료 (11-11, 배송 대기) | 550 | 디바이스마트 | 10912297 | 상품 페이지 (https://www.devicemart.co.kr/goods/view?no=10912297) | STEP 외형·전장 | ✔ 11-11 디바이스마트에서 25개 구매(VAT 별도 단가 20원). 출력 브래킷 01 12개 × 2쌍 = 24(상판 C 캡티브 너트 4 포함). 실제로는 25개를 사서 예비가 1개뿐 — 지퍼백에 따로 보관하고, 모자라면 디바이스마트에서 더 삼(개당 20원 + 배송비). 전장 박스 볼트 고정(선택)은 P68 M3×15를 따로 씀.
47 | P38 | 외형 | 육각 너트(스텐) M3 | M3, SUS | 공통 | 24 | 24 | 25 | 0 | 0 | 22 | 0 | 0 | 주문 완료 (11-11, 배송 대기) | 550 | 디바이스마트 | 10893596 | 상품 페이지 (https://www.devicemart.co.kr/goods/view?no=10893596) | STEP 외형·전장 | ✔ 11-11 디바이스마트에서 25개 구매(VAT 별도 단가 20원). 출력 브래킷 01 12개 × 2쌍 = 24(상판 C 캡티브 너트 4 포함). 실제로는 25개를 사서 예비가 1개뿐 — 지퍼백에 따로 보관하고, 모자라면 디바이스마트에서 더 삼(개당 20원 + 배송비). 전장 박스를 볼트(P68)로 고정하는 선택을 하면 너트 2개가 더 필요 — 지금은 벨크로(P64) 기준이라 해당 없음.
48 | P39 | 외형 | M3 알루미늄 서포트 Female 10mm [SZH-ZR059] | M3, 10mm×5mm | 공통 | 4 | 4 | 4 | 0 | 0 | 462 | 0 | 0 | 주문 완료 (11-11, 배송 대기) | 1848 | 디바이스마트 | 1382352 | 상품 페이지 (https://www.devicemart.co.kr/goods/view?no=1382352) | STEP 전장부 | ✔ 11-11 디바이스마트에서 4개 구매(VAT 별도 단가 420원). 릴레이 모듈을 박스 속판에 띄워 고정(속판에 Ø3.2 구멍 4개, 간격 69.6×49.4mm). ESP32 확장보드는 서포트 동봉.
49 | P40 | 외형 | 둥근머리 십자볼트(니켈) M3×6 | M3, 6mm | 공통 | 8 | 8 | 10 | 0 | 0 | 11 | 0 | 0 | 주문 완료 (11-11, 배송 대기) | 110 | 디바이스마트 | 10912222 | 상품 페이지 (https://www.devicemart.co.kr/goods/view?no=10912222) | STEP 전장부 | ✔ 11-11 디바이스마트에서 10개 구매(VAT 별도 단가 10원). 서포트 고정용, 최소주문 10개.
50 | P41 | 외형 | 고무발 S-1 18×10H | 지름 18mm, 높이 10mm | 공통 | 4 | 4 | 10 | 0 | 0 | 110 | 0 | 0 | 주문 완료 (11-11, 배송 대기) | 1100 | 디바이스마트 | 14882214 | 상품 페이지 (https://www.devicemart.co.kr/goods/view?no=14882214) | STEP 외형 | ✔ 11-11 디바이스마트에서 10개 구매(VAT 별도 단가 100원). 최소주문 10개. 바닥판 네 모서리.
51 | P42 | 외형 | 순간접착제 LOCTITE 401 20g | 시아노아크릴레이트, 플라스틱용 | 공통 | 1 | 1 | 1 | 0 | 0 | 4400 | 0 | 0 | 주문 완료 (11-11, 배송 대기) | 4400 | 디바이스마트 | 9108 | 상품 페이지 (https://www.devicemart.co.kr/goods/view?no=9108) | STEP 외형 조립 | ✔ 11-11 디바이스마트에서 1개 구매(VAT 별도 단가 4,000원). 포맥스 맞대기 접착 + 출력 브래킷 01 육각 홈의 캡티브 너트 고정(상판 C 쪽, 기름 바른 볼트를 끼운 채 굳힘).
52 | P43 | 외형 | 핫멜트스틱(대) 10개 | 글루건용 굵은 스틱 | 공통 | 1 | 1 | 1 | 0 | 0 | 2200 | 0 | 0 | 주문 완료 (11-11, 배송 대기) | 2200 | 디바이스마트 | 13187167 | 상품 페이지 (https://www.devicemart.co.kr/goods/view?no=13187167) | STEP 외형·배관 | ✔ 11-11 디바이스마트에서 1개 구매(VAT 별도 단가 2,000원). 접착부 보강·관통 구멍 실링(전장 박스 벽 구멍·그로밋 둘레·뚜껑 구멍, 그로밋 대안). 사용 글루건 규격(7mm/11mm) 확인.
53 | P44 | 외형 | 케이블 그로밋(고무 부싱) — Ø20 구멍용 2개 + Ø12 구멍용 1개 | 고무, 패널 두께 5mm용(홈 폭 5mm 이상), 장착 구멍 Ø20 ×2 · Ø12 ×1 | 둘 다 불필요 | 0 | 0 | 0 | 0 | 0 |  |  |  | 불필요 (출력 그로밋 04·05로 대체) |  | 철물점/온라인(확인 필요) |  |  | STEP 외형(선반 D·뒤판 G) | 3D 프린팅 그로밋 04(Ø20용) 2개 + 05(Ø12용) 1개(P70)를 씀. 출력 부품이 없을 때만 구매.
54 | P45 | 외형 | 원형 네오디뮴 자석 13mm 3개입 (다이소) | 지름 약 13mm 원형 네오디뮴 자석 3개, 접착면 없음 | 공통 | 1 | 1 | 1 | 0 | 0 | 1000 | 0 | 0 | 구매 완료 (11-11) | 1000 | 다이소 | 1057293 | 상품 페이지 (https://www.daisomall.co.kr/pd/pdr/SCR_PDR_0001?pdNo=1057293) | STEP9 뒤 덮개 H 고정 (P80 철판과 짝) | ✔ 11-11 다이소에서 1개 구매(단가 1,000원). 다이소몰에 완제품 '자석 캐치'가 없어 자석 + 접착식 철판(P80)으로 만듦. 2개를 걸림턱 L 뒷면에 순간접착제(P42)로 붙이고(1개 예비), 뒤 덮개 H 안쪽 같은 자리에 P80 철판을 붙임. 흡착력 수치는 상품 정보에 없음(가벼운 5mm 판이라 2곳이면 충분할 것으로 추정).
55 | P64 | 외형 | Coms 사각 벨크로테이프 10조 (접착식 양면 찍찍이) 55×35mm [T9162] | 뒷면 접착(양면테이프), 까끌면+보슬면 한 쌍 × 10조, 55×35mm | 공통 | 1 | 1 | 1 | 0 | 0 | 1540 | 0 | 0 | 주문 완료 (11-11, 배송 대기) | 1540 | 디바이스마트 | 15810228 | 상품 페이지 (https://www.devicemart.co.kr/goods/view?no=15810228) | STEP10 절차 1 전장 박스 고정(기본) / 2.3 소모품 | ✔ 11-11 디바이스마트에서 1개 구매(VAT 별도 단가 1,400원). 전장 박스(P35)를 선반 D에 고정하는 기본 방법(조립가이드 2.3 소모품·STEP10 절차 1): 박스 바닥 네 모서리와 D의 같은 자리에 한 쌍씩 = 4쌍 사용(크면 반으로 잘라 씀), 6쌍 예비. 박스 바닥·선반 D에 구멍을 뚫지 않음(박스 앞쪽 모서리 아래는 막힌 빈 공간이라 너트를 끼울 수 없음). 붙일 면의 먼지·기름을 닦고 꾹 눌러 붙임(제품 설명: 거친 면·재사용 시 접착력 떨어짐). 상품 페이지 확인: VAT 별도 1,400원 / 포함 1,540원, 평균 준비기간 3~4일(2026-11-06).
56 | P71 | 외형 | 오공 초강력 폼 양면테이프 투명 18mm×2m (두께 1mm) | 아크릴 폼, 폭 18mm · 길이 2m · 두께 1mm | 공통 | 1 | 1 | 1 | 0 | 0 | 2000 | 0 | 0 | 구매 완료 (11-11) | 2000 | 다이소 | 1019760 | 상품 페이지 (https://www.daisomall.co.kr/pd/pdr/SCR_PDR_0001?pdNo=1019760) | STEP9 절차 다 8 앞면 베젤(출력 03) · 부저 고정 | ✔ 11-11 다이소에서 1개 구매(단가 2,000원). 베젤은 순간접착제로 붙이지 않음(LED를 바꿀 때 베젤을 떼야 함). 부착 후 24시간 뒤 최대 접착력, 뗄 때 표면이 상할 수 있음(상품 안내). 더 싼 대안: 3M 스카치 마운팅 폼 12mm×1m(58898, 1,000원, 두께 표기 없음).
57 | P80 | 외형 | 자석용 보조 설치판 5.5×3.5cm 3개입 (다이소, 접착식 철판) | 약 35×55mm 철판 3개, 뒷면 접착테이프(재사용 불가, 붙인 뒤 24시간 후 사용) | 공통 | 1 | 1 | 1 | 0 | 0 | 1000 | 0 | 0 | 구매 완료 (11-11) | 1000 | 다이소 | 1050101 | 상품 페이지 (https://www.daisomall.co.kr/pd/pdr/SCR_PDR_0001?pdNo=1050101) | STEP9 뒤 덮개 H 안쪽 (P45 자석과 짝) | ✔ 11-11 다이소에서 1개 구매(단가 1,000원). 자석이 붙는 철판. 뒤 덮개 H 안쪽, 걸림턱 L의 자석과 마주 보는 자리에 2개 붙임(1개 예비). 더 작은 3×3cm 6개입(1050099)은 조사 때 온라인 재고 0.
58 | P70 | 3D 프린팅 | 3D 프린팅 출력 부품 7종 24개 (PETG 흰색) — 업로드 묶음 plate_A(브래킷 14) + plate_B(나머지 10) | 레이어 0.2mm · 벽 3겹 · 인필 plate_A 50%/plate_B 15% · 배율 100% · 방향 원본 그대로. 01 브래킷 ×14, 02 노즐 블록, 03 앞면 베젤, 04 그로밋 Ø20 ×2, 05 그로밋 Ø12, 06 상판 모서리 캡 ×4, 07 튜브 부싱 | 공통 | 1 | 1 | 0 | 0 | 0 |  |  |  | 주문 완료 (배송 예정 11/16) | 78700 | 3DFARM |  | 상품 페이지 (https://3dfarm.co.kr/) | STEP9·10, 제작가이드 부록 D | 결제 78,700원(업로드 견적 51,000 + 39,000 = 90,000원보다 적음). 파일·조건: hardware/3dprint/README.md. 받은 날 부록 D '받은 뒤 확인' 표대로 검수.
59 | P46 | 공구 | 실습용 납땜세트B (학교 실습실 대여 가능) | 인두기 30W·인두 스탠드·납흡입기·페이스트·납 50g | 납땜 기준만 | 1 | 0 | 0 | 0 | 0 | 26400 | 0 | 0 | 학교 대여 (집에 없음) / 불필요 (무납땜) |  | 디바이스마트 | 10894366 | 상품 페이지 (https://www.devicemart.co.kr/goods/view?no=10894366) | STEP 공구 준비 | [납땜] STEP3 다이오드 8곳 · STEP4 SW1·F1 4곳 · STEP9 앞판 6~9곳을 학교 실습실에서 납땜. 대여가 안 되면 인두 ZD-70RA(5,500원)+스탠드 B320(2,750원)+실납 P47(3,190원) = 11,440원으로 대신(예산 시트). / [무납땜] 무납땜 기준에서는 쓰지 않음.
60 | P47 | 공구 | 일반 실납 1.0mm [SME15510] (학교 실습실 대여 가능) | 1.0mm | 납땜 기준만 | 1 | 0 | 0 | 0 | 0 | 3190 | 0 | 0 | 학교 대여 / 불필요 (무납땜) |  | 디바이스마트 | 1171334 | 상품 페이지 (https://www.devicemart.co.kr/goods/view?no=1171334) | STEP 공구 준비 | [납땜] 학교 실습실 대여/지급 확인. [가격: 디바이스마트 검색 API 값 — 상품 페이지 재확인 필요(일부 품목은 페이지가가 약 10% 낮았음)] / [무납땜] 무납땜 기준에서는 쓰지 않음.
61 | P48 | 공구 | 디지털 멀티미터 M300 | DCV ≤500V, DCA ≤200mA, 저항, 도통 | 공통 | 1 | 1 | 1 | 0 | 0 | 8800 | 0 | 0 | 주문 완료 (11-11, 배송 대기) | 8800 | 디바이스마트 | 10917721 | 상품 페이지 (https://www.devicemart.co.kr/goods/view?no=10917721) | STEP 공구 준비 | ✔ 11-11 디바이스마트에서 1개 구매(VAT 별도 단가 8,000원). 집에서 STEP1부터 계속 씀(전압·도통·다이오드 방향 확인) → 학교 대여 대신 구매. 12V 23A 전지는 들어 있지 않아 P72로 따로 삼. 받으면 다이얼에 다이오드(▶|) 자리가 있는지 확인.
62 | P49 | 공구 | 와이어 스트리퍼 TU-2022 | 구멍 0.4/0.5/0.65/0.8/1.0/1.3mm (약 AWG26~16, 듀폰선까지) | 공통 | 1 | 1 | 1 | 0 | 0 | 6600 | 0 | 0 | 주문 완료 (11-11, 배송 대기) | 6600 | 디바이스마트 | 1330598 | 상품 페이지 (https://www.devicemart.co.kr/goods/view?no=1330598) | STEP 공구 준비 | ✔ 11-11 디바이스마트에서 1개 구매(VAT 별도 단가 6,000원). 집에서 하는 피복 벗기기(STEP4 J1·TB, STEP5 듀폰 끝 8mm, STEP10 앞판 결선, 무납땜은 레버 커넥터 9~10mm)에 필요 → 학교 대여 대신 구매. AWG20 → 1.0, UL1007 22AWG → 0.8, 듀폰선 → 0.5 구멍. 원래 BOM의 TU-2021(0.6~2.6mm)은 듀폰선이 범위 밖.
63 | P50 | 공구 | 니퍼 TU-C01 (학교 실습실 대여 가능) | 125mm | 공통 | 1 | 1 | 0 | 0 | 0 | 3190 | 0 | 0 | 학교 대여 |  | 디바이스마트 | 1287084 | 상품 페이지 (https://www.devicemart.co.kr/goods/view?no=1287084) | STEP 공구 준비 | 학교 대여 가능. [가격: 디바이스마트 검색 API 값 — 상품 페이지 재확인 필요(일부 품목은 페이지가가 약 10% 낮았음)]
64 | P51 | 공구 | 글루건 DY-3000 60W (학교 실습실 대여 가능) | 11mm 스틱용 | 공통 | 1 | 1 | 0 | 0 | 0 | 8360 | 0 | 0 | 학교 대여 |  | 디바이스마트 | 10931307 | 상품 페이지 (https://www.devicemart.co.kr/goods/view?no=10931307) | STEP 공구 준비 | 학교 대여 가능. [가격: 디바이스마트 검색 API 값 — 상품 페이지 재확인 필요(일부 품목은 페이지가가 약 10% 낮았음)]
65 | P52 | 공구 | 열풍기 D26411 (학교 실습실 대여 가능) | 2단 풍량, 노즐 2개 | 납땜 기준만 | 1 | 0 | 0 | 0 | 0 | 68200 | 0 | 0 | 학교 대여 (집에 없음) / 불필요 (무납땜) |  | 디바이스마트 | 12171271 | 상품 페이지 (https://www.devicemart.co.kr/goods/view?no=12171271) | STEP 공구 준비 | [납땜] 솔더 슬리브 P25 8곳(펌프 리드 이음)을 녹이는 데 씀. 빌릴 수 없으면 가이드 그림 9 B(인두 납땜 + 수축튜브, 수축은 인두 옆면)로 대신. / [무납땜] 솔더 슬리브를 쓰지 않으므로 필요 없음. 수축튜브는 열 없이 헐겁게 씌우거나 절연테이프(P79)로 대신.
66 | P53 | 공구 | 헬리컬 스텝드릴 4~35mm [K40843729] (학교 실습실 대여 가능) | 생크 6.35mm | 공통 | 1 | 1 | 0 | 0 | 0 | 26070 | 0 | 0 | 학교 대여 |  | 디바이스마트 | 14117356 | 상품 페이지 (https://www.devicemart.co.kr/goods/view?no=14117356) | STEP 공구 준비 | [납땜] 구멍 약 52~56개(뚜껑 12 · 뒤판 G 3 · 전장 박스 8~12 · 외형 판 약 29). 납땜 전에 G·F 판 구멍부터. / [무납땜] 구멍 약 51~55개(뚜껑 12 · 뒤판 G 2(퓨즈 구멍 없음) · 전장 박스 8~12 · 외형 판 약 29). 빌릴 수 없으면 예산 시트의 손공구 줄.
67 | P54 | 공구 | 커터칼(대)·쇠자(60cm)·커팅매트 (학교 실습실 대여 가능) | 포맥스 직접 재단용 | 공통 | 1 | 1 | 0 | 0 | 0 |  |  |  | 학교 대여 |  | 다이소/화방 |  |  | STEP 외형 | 포맥스가 600×900 통판이면 직접 재단해야 함 — 커터칼(대)·쇠자 60cm 이상(다이소 50cm 자는 짧음)·커팅매트를 학교에서 빌리거나 삼. 맞춤 재단이면 불필요.
68 | P72 | 공구 | [건전지] 23A 12V 알카라인 1알 (멀티미터 M300용) | 23A(A23) 12V, 41mAh | 공통 | 1 | 1 | 1 | 0 | 0 | 770 | 0 | 0 | 주문 완료 (11-11, 배송 대기) | 770 | 디바이스마트 | 10921874 | 상품 페이지 (https://www.devicemart.co.kr/goods/view?no=10921874) | P48 멀티미터 | ✔ 11-11 디바이스마트에서 1개 구매(VAT 별도 단가 700원). M300에는 전지가 들어 있지 않음(상품 페이지). 디바이스마트 주문에 함께 넣어 삼(11-11, 실제 단가 VAT 별도 700원). 다이소몰은 23A를 온라인으로 팔지 않음(편의점·문구점에도 있을 수 있음).
69 | P55 | 선택 | 연동(페리스탈틱) 펌프 DFRobot Gravity Digital Peristaltic Pump [DFR0523] | 입력 5~6V, 연속 1.8A/피크 2.5A, 서보(PPM) 신호 제어 | 선택 | 4 | 4 | 0 | 0 | 0 | 45540 | 0 | 0 | 선택(구매 안 함) |  | 디바이스마트 | 1377341 | 상품 페이지 (https://www.devicemart.co.kr/goods/view?no=1377341) | 2학기 확장/논문 | 액체가 튜브에만 닿아 위생·정량성 우수. 4개면 약 18만원, 전류가 커서 5V 10A급 전원 필요(확인 필요). 대안: Adafruit 12V 연동펌프(14600697, 49,830원, 12V 전원 필요).
70 | P56 | 선택 | HX711 로드셀 24비트 AD 컨버터 모듈 [SZH-SSBH-016] | 2.7~5V | 선택 | 1 | 1 | 0 | 0 | 0 | 1870 | 0 | 0 | 선택(구매 안 함) |  | 디바이스마트 | 1327440 | 상품 페이지 (https://www.devicemart.co.kr/goods/view?no=1327440) | 2학기 확장/논문 | 무게 기반 자동 보정(잔 받침 아래 로드셀).
71 | P57 | 선택 | 4선 로드셀 1kg [VLT-LCS002] | 1kg, 4선 | 선택 | 1 | 1 | 0 | 0 | 0 | 7260 | 0 | 0 | 선택(구매 안 함) |  | 디바이스마트 | 15961057 | 상품 페이지 (https://www.devicemart.co.kr/goods/view?no=15961057) | 2학기 확장/논문 | HX711과 함께 사용.
72 | P58 | 선택 | MOSFET GPIO 보드 4채널 YYNMOS-4 [SZH-YY012] (AF60N03) | 36V 5A, 단방향 | 선택 | 1 | 1 | 0 | 0 | 0 | 19360 | 0 | 0 | 선택(구매 안 함) |  | 디바이스마트 | 13908386 | 상품 페이지 (https://www.devicemart.co.kr/goods/view?no=13908386) | 2학기 확장/논문 | 릴레이 대체·PWM 유량 미세제어. ESP32 3.3V 게이트 구동 가능 여부 확인 필요. PWM 시 플라이백은 1N5819 쇼트키(상품번호 27, 44원, 최소 10) 권장.
73 | P65 | 선택 | (선택·시음 전 교체용) 식품용 실리콘 튜브 내경5/외경7mm (FDA 또는 LFGB 표기), 1m 단위 | 내경5/외경7mm, 식품 접촉용 표기(FDA 21 CFR 177.2600 또는 LFGB) + 판매처 적합성 자료(시험성적서) 확인 | 선택 | 3 | 3 | 0 | 0 | 0 |  |  |  | 선택(구매 안 함) |  | 국내 쇼핑몰·실험용품점 (디바이스마트 미취급, 확인 필요) |  |  | 1.3 시음 조건 / STEP8 배관(P29 자리) | P29 대체(지금 P29는 식품등급 표기 없음 → 바꾸기 전에는 아무도 마시지 않음, 조립가이드 1.3·5장). 펌프 출수구(외경 7.5) → 체크밸브 앞까지 펌프당 약 0.7m × 4 = 약 2.8m → 3m. 디바이스마트 검색("식품용 실리콘 튜브"·"실리콘 튜브 FDA"·"식품등급"·"Food-Grade", 2026-11-06)에 식품용 표기 실리콘 튜브 없음 → 판매처·가격 확인 필요. 시음할 계획(예: 졸업작품 심사)이 정해지면 미리 주문. 튜브·밸브만으로는 부족 — 펌프(P09) 재질 확인 또는 연동 펌프(P55) 교체도 함께(1.3).
74 | P66 | 선택 | (선택·시음 전 교체용) 식품용 실리콘 튜브 내경4/외경6mm (FDA 또는 LFGB 표기), 1m 단위 | 내경4/외경6mm, 식품 접촉용 표기(FDA 21 CFR 177.2600 또는 LFGB) + 판매처 적합성 자료 확인 | 선택 | 1 | 1 | 0 | 0 | 0 |  |  |  | 선택(구매 안 함) |  | 국내 쇼핑몰·실험용품점 (디바이스마트 미취급, 확인 필요) |  |  | 1.3 시음 조건 / STEP8 배관(P30 자리: 슬리브·노즐 쪽) | P30 대체: 체크밸브 입구 겹침 이음 슬리브 3cm + 밸브 → 노즐 15cm = 펌프당 18cm × 4 = 약 0.72m → 1m. 외경 6mm가 내경5 튜브 안에 꽉 끼어야 겹침 이음이 됨(P30과 같은 치수). 디바이스마트 검색("식품용 실리콘 튜브"·"실리콘 튜브 FDA"·"식품등급"·"Food-Grade", 2026-11-06)에 식품용 표기 실리콘 튜브 없음 → 판매처·가격 확인 필요.
75 | P67 | 선택 | (선택·시음 전 교체용) 식품용 체크밸브 — 액체용, 내경4 튜브용 바브 (P31과 같은 규격) | 식품 접촉 재질 표기(예: PP 몸통 + 실리콘 덕빌, FDA 21 CFR 177.1520·177.2600 등), 액체용, 바브가 내경4/외경6 튜브에 맞음(P31: 바브 끝 Ø3.2~턱 Ø5.0), 개방압 약 2kPa 이하·내부 유로 Ø2mm 이상 권장 | 선택 | 4 | 4 | 0 | 0 | 0 |  |  |  | 선택(구매 안 함) |  | 국내 쇼핑몰·실험용품점 (디바이스마트 미취급, 확인 필요) |  |  | 1.3 시음 조건 / STEP8 배관 CV1~CV4(P31 자리) | P31 대체(JGB32PPS는 판매처 설명상 "공기용", 재질·식품 적합성 미표기). 4개 + 예비 1 권장(선택 구매 수량 5). 디바이스마트 "체크밸브" 검색 결과(JGB32PPS·JT3205·JGG95ABS 등)는 모두 공기용 설명이고 식품용 표기 제품 없음(2026-11-06) → 판매처·가격 확인 필요. 개방압이 크거나 유로가 좁으면 유량이 줄어드니, 바꾼 뒤 STEP8 누수·역류 테스트와 STEP11 캘리브레이션을 다시 함. 화살표(FLOW)는 노즐 쪽.
76 | P68 | 선택 | (선택·조립 방식) 둥근머리 십자볼트 머신스크류 M3×15 (철, 노란색) | M3, 15mm, 철(상품명 "노란색"), 십자 | 선택 | 2 | 2 | 0 | 0 | 0 | 11 | 0 | 0 | 선택(구매 안 함) |  | 디바이스마트 | 34252 | 상품 페이지 (https://www.devicemart.co.kr/goods/view?no=34252) | STEP10 절차 1 (선택: 볼트 고정) / STEP9 D 선반 (선택) 구멍 | 전장 박스를 볼트로 고정할 때만(선택, 기본은 벨크로 P64): 뒤쪽 두 모서리(본체 x 약 115·295, y 약 180 — 아래가 용기 칸)만 사용. 볼트가 박스 바닥 + 선반 D(5mm) + 너트(P38 M3)를 지나야 해서 M3×10(P37)은 짧을 수 있음(박스 바닥 두께 실측). 최소주문 10개 → 선택 구매 수량 10(110원). 너트는 P38, 뒤 덮개 H를 열고 용기를 꺼낸 뒤 용기 칸 쪽(D 아래)에서 끼움. 스텐을 원하면 스텐 둥근머리 십자볼트는 15mm가 없어 M3×16(10912300, 33원, 최소 5개). 볼트 고정을 고르면(11-11 주문에는 넣지 않았으므로 따로 주문 — 너트 P38도 예비가 1개뿐이라 2개 더), 선반 D Ø3.5 ×2(STEP9 구멍 표 "D 선반 (선택)", 조립 전)와 박스 바닥 Ø3.5 ×2(STEP5 박스 준비, 속판 달기 전)를 미리 뚫음. 상품 페이지 확인: VAT 별도 10원 / 포함 11원, 평균 준비기간 1~2일(2026-11-06).
77 | P69 | 선택 | (선택·조립 방식) 자석 캐치 추가분 — 상판 C 고정 대안 (P45와 같은 제품) | P45 자석 + P80 철판과 같은 제품 | 선택 | 4 | 4 | 0 | 0 | 0 | 1000 | 0 | 0 | 선택(구매 안 함) |  | 다이소 | 1057293 | 상품 페이지 (https://www.daisomall.co.kr/pd/pdr/SCR_PDR_0001?pdNo=1057293) | STEP9 상판 C (선택: 자석 고정) | 상판 C를 볼트(브래킷 캡티브 너트) 대신 자석으로 붙일 때만(선택): P45 자석 1팩 + P80 철판 1팩을 더 삼(4곳이면 각 2팩). 기본(캡티브 너트)이면 불필요.
78 | P59 | 미사용 | SparkFun 솔레노이드 5V (small) [ROB-11015] | 5V 솔레노이드 | 미사용 | 0 | 0 | 4 | 0 | 0 | 14410 | 0 | 0 | 미사용 |  | 디바이스마트 | 1313586 | 상품 페이지 (https://www.devicemart.co.kr/goods/view?no=1313586) | - | 1학기 설계 변경(솔레노이드 제거, 펌프 단독 시간 제어)으로 미사용.
79 | P60 | 미사용 | 열 수축 솔더 슬리브 6.0SQ [SZH-CA004] | 6.0SQ(약 10AWG)용 | 미사용 | 0 | 0 | 10 | 0 | 0 | 440 | 0 | 0 | 미사용 |  | 디바이스마트 | 12507092 | 상품 페이지 (https://www.devicemart.co.kr/goods/view?no=12507092) | - | AWG20·펌프 리드선에는 너무 커서 미사용.
80 | P61 | 미사용 | DC 플러그 NT10-AF35 (DC 전원 변환 젠더, 수 5.5/2.1mm, 25cm) | 수(Male) 플러그 + 25cm 리드선 | 미사용 | 0 | 0 | 1 | 0 | 0 | 1100 | 0 | 0 | 미사용 |  | 디바이스마트 | 1078077 | 상품 페이지 (https://www.devicemart.co.kr/goods/view?no=1078077) | - | 현재 설계에서는 불필요(어댑터 → 터미널 DC 암 단자로 직접 연결). 예비/시험용.
 |  |  | 합계 (추가 구매, VAT 포함 · 가격 미확인 품목 제외) |  |  |  |  |  |  |  |  | 5203 | 0 | 부품별 지출 합계 → | 232228
 |  |  | └ 디바이스마트 주문 합계 (VAT 포함) |  |  |  |  |  |  |  |  | 5203 | 0 | 전체 지출 (배송비 포함) → | 238228
 |  |  | └ 다이소·편의점 등 (가격 아는 품목만) |  |  |  |  |  |  |  |  | 0 | 0

Sheet: 지출_완료
이미 결제한 것 (2학기) — 두 기준 공통
금액은 VAT 포함 결제액. 디바이스마트는 거래명세서(VAT 별도 단가 × 1.1), 나머지는 알려 준 금액입니다. 영수증·거래명세서를 보관해 결과보고서 정산서에 씁니다.
No | 날짜 | 품목 | 구매처 | 수량 | 금액(원) | 상태 | BOM ID | 비고
1 | 11-10 | 3D 프린팅 출력 부품 (plate_A 브래킷 01 ×14 + plate_B 나머지 02~07 ×10) | 3DFARM | 2판 | 78700 | 주문 완료 (배송 예정 11/16) | P70 | PETG 흰색 · 0.2mm · 벽 3겹 · 인필 plate_A 50% / plate_B 15%. 실제 결제 78,700원(2026-11-11 사용자 확인) — 업로드 견적 51,000 + 39,000 = 90,000원보다 적음. 판별 금액은 따로 확인하지 않음
2 | 11-10 | 포맥스 5T 흰색 | 포맥스 판매처 | 3장 | 43000 | 구매 완료 | P34 | 600×900 통판인지 맞춤 재단인지 확인 필요(통판이면 직접 재단)
3 | 11-11 | ESP32 확장보드 터미널쉴드(Push-in 타입) | 디바이스마트 | 1 | 12100 | 주문 완료 (11-11, 배송 대기) | P02 | 단가 11,000원(VAT 별도)
4 | 11-11 | 메탈 푸쉬 스위치 플랫형 [HX16-B1] | 디바이스마트 | 1 | 2970 | 주문 완료 (11-11, 배송 대기) | P03 | 단가 2,700원(VAT 별도)
5 | 11-11 | 회로내장형 액티브 부저 모듈 [ONE005] | 디바이스마트 | 1 | 1100 | 주문 완료 (11-11, 배송 대기) | P04 | 단가 1,000원(VAT 별도)
6 | 11-11 | [5PR3HD19] 원통평면형- 5파이 불투명 LED(빨강) | 디바이스마트 | 2 | 110 | 주문 완료 (11-11, 배송 대기) | P05 | 단가 50원(VAT 별도)
7 | 11-11 | 1/4W 1% Axial Resistor 221F (220Ω) | 디바이스마트 | 10 | 330 | 주문 완료 (11-11, 배송 대기) | P06 | 단가 30원(VAT 별도)
8 | 11-11 | Micro USB 5P Cable(1M) | 디바이스마트 | 1 | 770 | 주문 완료 (11-11, 배송 대기) | P07 | 단가 700원(VAT 별도)
9 | 11-11 | 수중펌프모터 [SZH-GNP155] | 디바이스마트 | 2 | 6380 | 주문 완료 (11-11, 배송 대기) | P09 | 단가 2,900원(VAT 별도)
10 | 11-11 | 퓨즈 5x20-3A | 디바이스마트 | 3 | 363 | 주문 완료 (11-11, 배송 대기) | P15 | 단가 110원(VAT 별도)
11 | 11-11 | E/C 16V 1000uF (105℃)/10X16 | 디바이스마트 | 10 | 990 | 주문 완료 (11-11, 배송 대기) | P16 | 단가 90원(VAT 별도)
12 | 11-11 | E/C 16V 100uF (105℃)/5X12 | 디바이스마트 | 10 | 330 | 주문 완료 (11-11, 배송 대기) | P17 | 단가 30원(VAT 별도)
13 | 11-11 | 8선 결합 탈피형 커넥터 PCT-418 | 디바이스마트 | 4 | 1408 | 주문 완료 (11-11, 배송 대기) | P18 | 단가 320원(VAT 별도)
14 | 11-11 | 하네스 스위치 (101A-5264) | 디바이스마트 | 1 | 4730 | 주문 완료 (11-11, 배송 대기) | P73 | 단가 4,300원(VAT 별도)
15 | 11-11 | 퓨즈홀더 FH-201 (빨강색) | 디바이스마트 | 1 | 726 | 주문 완료 (11-11, 배송 대기) | P74 | 단가 660원(VAT 별도)
16 | 11-11 | UL1007 래핑와이어 22AWG 노랑 10M [VLT-CAB160] | 디바이스마트 | 1 | 3630 | 주문 완료 (11-11, 배송 대기) | P24 | 단가 3,300원(VAT 별도)
17 | 11-11 | 케이블메이트 케이블타이, UN-100MB [소/100mm] [블랙] [1000개] | 디바이스마트 | 1 | 3740 | 주문 완료 (11-11, 배송 대기) | P27 | 단가 3,400원(VAT 별도)
18 | 11-11 | 케이블타이 고정용 마운트 20x20mm [SZ-XL015] | 디바이스마트 | 10 | 1320 | 주문 완료 (11-11, 배송 대기) | P28 | 단가 120원(VAT 별도)
19 | 11-11 | UL1007 래핑와이어 22AWG 검정 10M [VLT-CAB159] | 디바이스마트 | 1 | 3630 | 주문 완료 (11-11, 배송 대기) | P62 | 단가 3,300원(VAT 별도)
20 | 11-11 | UL1007 래핑와이어 22AWG 빨강 10M [VLT-CAB161] | 디바이스마트 | 1 | 3630 | 주문 완료 (11-11, 배송 대기) | P63 | 단가 3,300원(VAT 별도)
21 | 11-11 | PCT-413 | 디바이스마트 | 10 | 2200 | 주문 완료 (11-11, 배송 대기) | P75 | 단가 200원(VAT 별도)
22 | 11-11 | 2선 결합 탈피형 커넥터 PCT-412 | 디바이스마트 | 10 | 1320 | 주문 완료 (11-11, 배송 대기) | P76 | 단가 120원(VAT 별도)
23 | 11-11 | PCT-415 | 디바이스마트 | 1 | 253 | 주문 완료 (11-11, 배송 대기) | P77 | 단가 230원(VAT 별도)
24 | 11-11 | [JG] 체크밸브 : JGB32PPS | 디바이스마트 | 1 | 6050 | 주문 완료 (11-11, 배송 대기) | P31 | 단가 5,500원(VAT 별도)
25 | 11-11 | 화신박스 단자함 EG AGH-152010 | 디바이스마트 | 1 | 12320 | 주문 완료 (11-11, 배송 대기) | P35 | 단가 11,200원(VAT 별도)
26 | 11-11 | 스텐 둥근머리 십자볼트 M3x10 | 디바이스마트 | 25 | 550 | 주문 완료 (11-11, 배송 대기) | P37 | 단가 20원(VAT 별도) · BOM 계획 30개보다 적은 25개 — 필요 24개라 예비 1개
27 | 11-11 | 육각 너트 (스텐) M3 | 디바이스마트 | 25 | 550 | 주문 완료 (11-11, 배송 대기) | P38 | 단가 20원(VAT 별도) · BOM 계획 30개보다 적은 25개 — 필요 24개라 예비 1개
28 | 11-11 | M3 알루미늄 서포트 Female 10mm [SZH-ZR059] | 디바이스마트 | 4 | 1848 | 주문 완료 (11-11, 배송 대기) | P39 | 단가 420원(VAT 별도)
29 | 11-11 | 둥근머리 십자볼트 (니켈) M3x6 | 디바이스마트 | 10 | 110 | 주문 완료 (11-11, 배송 대기) | P40 | 단가 10원(VAT 별도)
30 | 11-11 | 고무발/라디오발/S-1/18*10H | 디바이스마트 | 10 | 1100 | 주문 완료 (11-11, 배송 대기) | P41 | 단가 100원(VAT 별도)
31 | 11-11 | 순간접착제 LOCTITE 401 20g | 디바이스마트 | 1 | 4400 | 주문 완료 (11-11, 배송 대기) | P42 | 단가 4,000원(VAT 별도)
32 | 11-11 | 핫멜트스틱(대) 10개 | 디바이스마트 | 1 | 2200 | 주문 완료 (11-11, 배송 대기) | P43 | 단가 2,000원(VAT 별도)
33 | 11-11 | Coms 사각 벨크로테이프 10개입 양면 찍찍이 55x35mm [T9162] | 디바이스마트 | 1 | 1540 | 주문 완료 (11-11, 배송 대기) | P64 | 단가 1,400원(VAT 별도)
34 | 11-11 | 디지털 멀티미터 M300 | 디바이스마트 | 1 | 8800 | 주문 완료 (11-11, 배송 대기) | P48 | 단가 8,000원(VAT 별도)
35 | 11-11 | 와이어 스트리퍼 TU-2022 | 디바이스마트 | 1 | 6600 | 주문 완료 (11-11, 배송 대기) | P49 | 단가 6,000원(VAT 별도)
36 | 11-11 | [건전지] 23A [41mAh/1알] | 디바이스마트 | 1 | 770 | 주문 완료 (11-11, 배송 대기) | P72 | 단가 700원(VAT 별도)
37 | 11-11 | 터미널 압착단자 케이블 [1EA] [CG0731] [2.8mm] (옵션 CG0731 2.8mm 흑색) | 디바이스마트 | 2 | 660 | 주문 완료 (11-11, 배송 대기) | P78 | 단가 300원(VAT 별도) · 배송비 3,000원은 이 품목 줄에 붙음(아래 배송비 줄)
38 | 11-11 | 배송비 | 디바이스마트 |  | 3000 | 주문 완료 (11-11, 배송 대기) |  | 거래명세서 배송비 칸: 1번 줄 0원 · 35번 줄(CG0731, P78) 3,000원(VAT 포함) — CG0731만 따로 배송되는 상품으로 보임
39 | 11-11 | 직사각 저장 용기 970ml (다이소 1069852) | 다이소 | 5 | 5000 | 구매 완료 (11-11) | P32 | 단가 1,000원(VAT 포함) · 단가는 다이소몰 판매가(결제 합계는 사용자 확인)
40 | 11-11 | 실리콘 원형 코스터 세트 2개입 (다이소 1038323) | 다이소 | 1 | 1000 | 구매 완료 (11-11) | P33 | 단가 1,000원(VAT 포함) · 단가는 다이소몰 판매가(결제 합계는 사용자 확인)
41 | 11-11 | 원형 네오디뮴 자석 13mm 3개입 (다이소 1057293) | 다이소 | 1 | 1000 | 구매 완료 (11-11) | P45 | 단가 1,000원(VAT 포함) · 단가는 다이소몰 판매가(결제 합계는 사용자 확인)
42 | 11-11 | 자석용 보조 설치판 3개입 (다이소 1050101) | 다이소 | 1 | 1000 | 구매 완료 (11-11) | P80 | 단가 1,000원(VAT 포함) · 단가는 다이소몰 판매가(결제 합계는 사용자 확인)
43 | 11-11 | 오공 초강력 폼 양면테이프 18mm×2m (다이소 1019760) | 다이소 | 1 | 2000 | 구매 완료 (11-11) | P71 | 단가 2,000원(VAT 포함) · 단가는 다이소몰 판매가(결제 합계는 사용자 확인)
44 | 11-11 | 전기 절연 테이프 19mm×10m 2개입 (다이소 24482) | 다이소 | 1 | 1000 | 구매 완료 (11-11) | P79 | 단가 1,000원(VAT 포함) · 단가는 다이소몰 판매가(결제 합계는 사용자 확인)
45 | 11-11 | 배송비 | 다이소 |  | 3000 | 구매 완료 (11-11) |  | 다이소 배송비(택배) — 사용자 확인
 |  | 지출 완료 합계 |  |  | 238228
환불 예정 (합계에 넣지 않음)
No | 날짜 | 품목 | 구매처 | 수량 | 금액(원) | 상태 |  | 비고
1 | 11-10 | 다이소 TARK 직사각 간편 용기 1L 3개입 화이트 (품번 58801) | 다이소 | 4 | 11000 | 취소·환불 예정 |  | 약 165×120×80mm라 W420 본체(용기 폭 ≤95mm)에 안 들어감. 금액 구성(상품값·배송비)과 환불 확정액은 영수증으로 확인

Sheet: 보유_미사용
보유했지만 이번 설계(v2)에서 쓰지 않거나 남는 부품
1학기 구매 단가는 물품구매의뢰서 기준(VAT 별도). 남는 수량 = 보유 − 이번 설계 사용.
No | ID | 부품명 | 보유수량 | 이번 설계 사용 | 남는 수량 | 구분 | 1학기 구매 단가(원) | 남는 부품 금액(원) | 활용 아이디어 / 메모
1 | P59 | SparkFun 솔레노이드 5V (small) [ROB-11015] | 4 | 0 | 4 | 미사용(설계 변경) | 13100 | 52400 | 1학기 설계 변경(솔레노이드 제거 → 펌프 단독 시간 제어)으로 미사용. 이 부품은 액체를 여닫는 '밸브'가 아니라 막대(플런저)를 밀고 당기는 소형 액추에이터이므로 액체 경로에는 쓸 수 없음(제품 설명 확인 권장). 활용: ① 주류 용기 칸 잠금 장치 — 앱 성인 인증(만 19세) 후에만 잠금 해제(예비 릴레이 CH + 1N4007 병렬, 정격 전류 확인 필요), ② 노즐을 톡 쳐서 마지막 방울을 떨어뜨리는 드립 커터, ③ 시연용 동작 데모. 사용하지 않으면 학과 공용 부품으로 반납·기증.
2 | P60 | 열 수축 솔더 슬리브 6.0SQ [SZH-CA004] | 10 | 0 | 10 | 미사용(규격 큼) | 400 | 4000 | 약 10AWG 굵은 전선용이라 AWG20·펌프 리드선에는 너무 큼. 활용: 2학기 연동펌프용 5V 10A급 전원의 굵은 전선(AWG14~12) 접속.
3 | P61 | DC 플러그 NT10-AF35 (수 5.5/2.1mm, 25cm) | 1 | 0 | 1 | 미사용 | 1000 | 1000 | 어댑터 → DC 암 단자(P12) 직결이라 불필요. 활용: 벤치 시험용 전원 케이블, 2학기 추가 모듈 전원 분기.
4 | P01 | ESP32 DevKitC WROOM-32D V4 | 2 | 1 | 1 | 예비 1 | 8000 | 8000 | 펌웨어 개발용 두 번째 보드(본체 조립 중에도 앱-BLE 시험), 기말 시연·논문 실험 중 고장 대비 예비 — 펌웨어를 미리 올려 둘 것.
5 | P08 | 4채널 5V 릴레이 [SZH-RLBG-012] | 2 | 1 | 1 | 예비 1 | 2600 | 2600 | SPEC의 펌프 5~8 확장(GPIO 25·13·18·19), 솔레노이드 잠금 장치·조명 제어, 고장 대비 예비(B안 전환 시험용으로도 사용).
6 | P23 | 브레드보드 830핀 | 2 | 0 | 2 | 벤치 테스트 전용 | 1400 | 2800 | 조립 전 회로 시험용(본체에는 미사용). 2학기 HX711·로드셀 시험. (1학기 대체품 VLT-BB016 2,000원으로 구매되었을 가능성 — BOM 비고 참고)
7 | P12 | 터미널블럭 to DC 커넥터 (DC2.1 FEMALE) | 2 | 1 | 1 | 예비 1 | 500 | 500 | 전원 입력 단자 예비.
8 | P10 | 다이오드 1N4007 | 10 | 4 | 6 | 예비 6 | 20 | 120 | 펌프 추가(5~8)·솔레노이드 플라이백 다이오드.
9 | P29 | 실리콘 튜브 내경 5mm (1m) | 8 | 3 | 5 | 예비 약 5m | 1700 | 8500 | 위생을 위해 주기적 교체용, 세척용 연장 호스.
10 | P30 | 실리콘 튜브 내경 4mm (1m) | 5 | 1 | 4 | 예비 약 4m | 1600 | 6400 | 노즐 쪽 튜브 교체용.
11 | P25 | 열 수축 솔더 슬리브 1.0SQ | 10 | 8 | 2 | 예비 2 | 300 | 600 | 접속 실패 시 재작업용.
12 | P22 | 점퍼 케이블 40P (M/M) | 1 | 0 | 1 | 벤치 테스트 전용 | 1000 | 1000 | 브레드보드 시험용.
 |  | 합계 (남는 부품의 1학기 구매 금액) |  |  |  |  |  | 87920
무납땜 기준에서는 P25 열수축 솔더 슬리브 1.0SQ 10개도 모두 남습니다(펌프 리드 이음을 레버 커넥터로 하므로). 이 시트는 원본(2026-11-06)과 같고, 기준별 수량은 BOM_납땜기준.xlsx / BOM_무납땜기준.xlsx의 같은 시트에 있습니다.

Sheet: 선택_업그레이드
선택 구매 — 위: 업그레이드(2학기 확장 · 졸업논문 · 특허 포인트) / 아래: 시음 전 교체용 · 조립 방식 선택
단가 = 디바이스마트 VAT 포함가. 빈칸 = 가격 확인 필요(단가를 입력하면 금액·예산 시트가 자동 계산). 이 시트의 품목은 필수 구매(BOM_전체 합계·의뢰서)에 포함하지 않음. 업그레이드는 필수 부품으로 기본 동작 확인 후 검토.
No | ID | 품목 | 상품번호 | 링크 | 수량 | 단가(원) | 금액(원) | 우선순위 | 기대 효과 (논문 포인트) | 필요 조건 / 주의
1 | P56+P57 | HX711 로드셀 AD 모듈 [SZH-SSBH-016] + 4선 로드셀 1kg [VLT-LCS002] | 1327440 / 15961057 | 상품 페이지 (https://www.devicemart.co.kr/goods/view?no=1327440) | 1 | 9130 | 9130 | 1순위 | 잔 받침 아래 무게 측정 → ① '시간 제어(개루프) vs 무게 피드백(폐루프)' 추출 정확도 비교 실험(목표량 대비 오차율 %) — 논문 핵심 데이터, ② 캘리브레이션 자동화(10초 구동 후 무게로 ml/s 자동 계산), ③ 잔이 없으면 제조 금지(안전). | GPIO 2개 필요(SPEC 핀맵 확장 필요). 액체 비중(시럽·주류) 보정 필요. 단가 = 1,870 + 7,260 (각 상품 페이지).
2 | P55 | DFRobot Gravity 디지털 연동(페리스탈틱) 펌프 [DFR0523] | 1377341 | 상품 페이지 (https://www.devicemart.co.kr/goods/view?no=1377341) | 4 | 45540 | 182160 | 2순위 | 액체가 튜브 안에서만 이동 → 펌프 내부 오염 없음(식품 위생). 회전수 ∝ 유량이라 양정·점도 영향이 적어 시럽 같은 '이종 점도 액체 정밀 펌핑'(특허 아이디어)과 직결. 수중펌프 vs 연동펌프 유량 안정성 비교 실험. | 4개 약 18만원. 연속 1.8A/피크 2.5A → 4개 동시 구동 시 5V 10A급 전원 필요(아래 U2). 서보(PPM) 신호 제어라 펌웨어 수정 필요.
3 | U2 | 5V 10A급 SMPS (연동펌프 4개 동시 구동용) |  |  | 1 |  |  | 2순위(P55와 함께) | 연동펌프 전원. | 제품·가격 확인 필요.
4 | P58 | MOSFET GPIO 보드 4채널 YYNMOS-4 [SZH-YY012] (AF60N03) | 13908386 | 상품 페이지 (https://www.devicemart.co.kr/goods/view?no=13908386) | 1 | 19360 | 19360 | 3순위 | 릴레이 대체 → 무접점(딸깍 소음·접점 마모 없음), PWM으로 유량 미세 조절 → 목표량 근처에서 감속해 넘침 감소. | ESP32 3.3V 게이트 구동 가능 여부 확인 필요.
5 | U1 | 쇼트키 다이오드 1N5819 (MOSFET PWM용 플라이백) | 27 | 상품 페이지 (https://www.devicemart.co.kr/goods/view?no=27) | 10 | 44 | 440 | 3순위(P58과 함께) | PWM 구동 시 빠른 플라이백 다이오드. | 최소주문 10개. ※단가 재확인 필요(조사 메모 값).
6 | U3 | (대안) Adafruit 12V 연동펌프 | 14600697 | 상품 페이지 (https://www.devicemart.co.kr/goods/view?no=14600697) | 0 | 49830 | 0 | 대안 | P55 대신 사용 가능한 연동펌프. | 12V 전원 별도 필요 → 전원 설계 변경. 수량 0(비교용).
7 | S1 | (소프트웨어) 잔량 기반 유량 보정 |  |  | 0 | 0 | 0 | 무료 | 앱이 아는 잔량(액면 높이)에 따라 유량이 15~20% 변하는 것을 보정 계수로 반영 → 추가 비용 없이 정확도 개선. | 펌웨어·앱 수정만 필요. 로드셀 데이터로 보정 계수 도출 가능.
 |  | 합계 (가격 확인 필요 품목 제외) |  |  |  |  | 211090
선택 구매 — 시음 전 교체용(식품용 튜브·체크밸브) · 조립 방식 선택(볼트·자석) : 필요할 때만, 필수 합계에 포함하지 않음
No | ID | 품목 | 상품번호 | 링크 | 수량 | 단가(원) | 금액(원) | 구분 | 언제 사나 (용도) | 고르는 기준 / 주의
1 | P65 | 식품용 실리콘 튜브 내경5/외경7mm (FDA 또는 LFGB 표기), 1m 단위 |  |  | 3 |  |  | 시음 전 교체용 | 팀원 시음(예: 졸업작품 심사)을 할 때만 — 그 전에는 색 물 시연, 아무도 마시지 않음(조립가이드 1.3). P29(내경5) 대체: 펌프 → 체크밸브 펌프당 약 0.7m × 4 | FDA(21 CFR 177.2600) 또는 LFGB 표기 + 판매처 적합성 자료 확인. 내경5/외경7(펌프 출수구 외경 7.5에 꽉 끼는 규격). 디바이스마트 미취급 → 국내 쇼핑몰·실험용품점에서 찾기 · 가격 확인 필요
2 | P66 | 식품용 실리콘 튜브 내경4/외경6mm (FDA 또는 LFGB 표기), 1m 단위 |  |  | 1 |  |  | 시음 전 교체용 | P30(내경4) 대체: 체크밸브 입구 슬리브 3cm + 밸브 → 노즐 15cm, 펌프당 18cm × 4 | FDA 또는 LFGB 표기. 내경4/외경6(외경 6이 내경5 튜브 안에 꽉 끼어야 겹침 이음 가능). 디바이스마트 미취급 · 가격 확인 필요
3 | P67 | 식품용 체크밸브 — 액체용, 내경4 튜브용 바브 (P31과 같은 규격) |  |  | 5 |  |  | 시음 전 교체용 | P31(공기용·재질 미표기) 대체: 4개 + 예비 1. 바꾼 뒤 STEP8 누수·역류 테스트와 STEP11 캘리브레이션 다시 | 식품 접촉 재질 표기(예: PP 몸통 + 실리콘 덕빌), 액체용, 바브가 내경4 튜브에 맞음(P31: Ø3.2~5.0), 개방압 약 2kPa 이하·유로 Ø2mm 이상 권장(작으면 유량 감소). 디바이스마트 미취급 · 가격 확인 필요
4 | P68 | 둥근머리 십자볼트 머신스크류 M3×15 (철, 노란색) | 34252 | 상품 페이지 (https://www.devicemart.co.kr/goods/view?no=34252) | 10 | 11 | 110 | 조립 방식 선택 | 전장 박스를 볼트로 고정할 때만(기본은 벨크로 P64): 뒤쪽 두 모서리에 2개 사용, 최소주문 10개. 너트는 P38 | M3×10(P37)은 박스 바닥 + 선반 D 5mm + 너트에 짧을 수 있음. 스텐을 원하면 M3×16(10912300, 33원, 최소 5개). 고르면 디바이스마트 주문에 함께 넣고 D 선반·박스 바닥 Ø3.5 ×2를 조립 전에 뚫기
5 | P69 | 자석 캐치 추가분 — 상판 C 고정 대안 (P45와 같은 제품) |  |  | 4 |  |  | 조립 방식 선택 | 상판 C를 볼트(캡티브 너트) 대신 자석으로 고정할 때만: 2~4개(4 기준). 뒤 덮개 H용 P45 2개와 별도 | P45와 같은 제품(다이소/철물점). 볼트 방식이면 불필요 · 가격 확인 필요
 |  | 소계: 시음 전 교체용 (가격 확인 필요 품목 제외) |  |  |  |  | 0 |  |  | 3품목 가격 확인 필요
 |  | 소계: 조립 방식 선택 (가격 확인 필요 품목 제외) |  |  |  |  | 110 |  |  | 1품목 가격 확인 필요
 |  | 합계 (선택 구매, 가격 확인 필요 품목 제외) |  |  |  |  | 110

Sheet: 예산
예산 — 두 기준 비교 (2학기 금액은 VAT 포함)
작성 2026-11-11. 노란 칸은 확인한 값으로 고치는 칸입니다. 기준별 자세한 예산은 각 기준 BOM의 '예산' 시트.
A. 1학기(캡스톤디자인Ⅰ) 실습비 집행 — 결과보고서 정산서 기준
항목 | 금액(원) |  | 비고
지원 금액 | 200000 |  | 캡스톤디자인Ⅰ 실습비
5/5 물품구매의뢰서 | 109200 |  | ESP32×2·릴레이×2·펌프×4·솔레노이드×4·튜브(내경4)×5·브레드보드×2·점퍼·DC부품·어댑터. 의뢰서 합계 108,000원과 1,200원 차이 = 브레드보드 품절 대체품(VLT-BB016 2,000원×2) 구매로 추정
5/29 물품구매의뢰서(추가분) | 52200 |  | 솔더 슬리브·AWG20 전선·1N4007·체크밸브×4·튜브(내경5)×8
집행액 합계 | 161400 |  | 정산서 실제 집행액 161,400원과 일치해야 함
집행 잔액 | 38600 |  | 정산서 집행 잔액 38,600원. 2학기 이월 여부 확인 필요(아래 C에서 사용)
B. 2학기 — 기준별 비교
항목 | 납땜 기준(원) | 무납땜 기준(원) | 비고
이미 결제한 것 (지출_완료) | 238228 | 238228 | 3D 프린팅 출력 부품 (plate_A 브래킷 01 ×14 + plate_B 나머지 02~07 ×10) 78,700원 · 포맥스 5T 흰색 43,000원 · 디바이스마트 주문 — 무납땜 기준 35품목 102,528원 · 다이소 — 무납땜 기준 6품목 14,000원
앞으로 ① 디바이스마트 (VAT 포함) | 5203 | 0 | 무료배송 기준 66,000원. 학교 의뢰서(VAT 별도)는 기준별 BOM의 '추가구매_의뢰서용' 시트
└ 디바이스마트 배송비 (주문액 66,000원 미만일 때) | 2700 | 0 | 2,700원(조사값, VAT 포함)
앞으로 ② 다이소·편의점 등 (가격 아는 것만) | 0 | 0
2학기 전체 (이미 결제 + 앞으로) | 246131 | 238228 | 선택 구매·공구 구매·가격 미확인 품목 제외 · 배송비 포함
(공구 직접 구매) 학교 대여가 안 될 때 인두 최저 구성 | 11440 |  | 인두 ZD-70RA 5,500 + 스탠드 B320 2,750 + 실납 P47 3,190 (디바이스마트). 열풍기는 사지 않고 수축은 인두 옆면 (납땜 기준만)
(공구 직접 구매) 집에 없으면: 글루건·니퍼 | 11550 | 11550 | 글루건 DY-3000 8,360(11mm 스틱 P43용) + 니퍼 TU-C01 3,190 (디바이스마트)
(공구 직접 구매) 드릴을 못 빌릴 때 손공구 | 15990 | 15990 | 테이퍼 리머 TR-01 11,990(엘레파츠) + 줄 3개 세트 2,000 + 대형 커터칼 2,000(다이소). 손으로 하면 몇 시간 걸림
C. 재원 (모두 확인 필요)
재원 | 금액(원) | 상태 | 비고
1학기 실습비 잔액 (2학기로 이월될 때만) | 38600 | 이월 여부 확인 필요
경진대회 예선 참가 지원금 (팀당) | 50000 | 수령 여부·사용 기한 확인 필요
캡스톤디자인Ⅱ 실습비 (2학기) |  | 금액 확인 필요 | 1학기는 200,000원
재원 합계 (입력된 금액만) | 88600
판단 (재원 합계 − 2학기 전체) | 납땜 기준 | 무납땜 기준 | 음수 = 부족
남는 돈 | -157531 | -149628 | 실습비가 아직 입력되지 않음
