paperji/smart-bartender/hardware/research/BOM_원본_20261106.xlsx

Sheet: BOM_전체
AI 스마트 바텐더 v2 — 정규 BOM (부품 전체 목록)
팀 홍당무 · 작성 2026-11-06 · 단가 = 디바이스마트 VAT 포함 판매가(2026-11-06 조회) · 단가 빈칸 = 가격 확인 필요 · '※단가 재확인 필요' = 검색 결과 값(상품 페이지 미확인) · 근거: hardware/research/parts_research.md, canonical_bom.json · 주황 칸 = 추가 구매 필요 · 분류 '선택' = 필요할 때만 구매(추가구매수량 0 → 필수 합계 제외, 선택 시 수량·금액은 선택_업그레이드 시트)
No | ID | 분류 | 부품명 | 규격/모델 | 필요수량 | 보유수량 | 추가구매수량 | 단가(원) VAT 포함 | 추가구매금액(원) =수량×단가 | 구매처 | 상품번호 | 링크 | 사용 위치 (회로 기호/조립 STEP) | 비고
1 | P01 | 제어 | ESP32 DevKitC WROOM-32D V4 CP2102 개발보드 [CMODULE-40] (Happy House) | 38핀(19핀×2열), 5V·3V3·GND 전원핀, 마이크로USB(CP2102), EN/BOOT 버튼, 사용자 LED 없음(5V 전원 LED만) | 1 | 2 | 0 | 9900 | 0 | 디바이스마트 | 15313999 | 상품 페이지 (https://www.devicemart.co.kr/goods/view?no=15313999) | 회로도 U1 / STEP 전장부(ESP32 장착) | 1개는 고장 대비 예비(펌웨어를 미리 올려 두면 바로 교체 가능, 앱 개발·시험용 겸용). 전원은 USB·5V핀·3V3핀 중 하나만 사용(Espressif 경고). 5V 핀 실크 표기는 "5V". 1학기 구매 단가 8,000원(VAT 별도).
2 | P02 | 제어 | ESP32-DevKitC 터미널 확장보드 Push-in 타입 (ElectroCookie) | ESP32-DevKitC(38핀) 전용 소켓+푸시인 단자대, 스탠드오프·나사·20P 리본케이블 동봉 (보드 외형 치수 확인 필요) | 1 | 0 | 1 | 12100 | 12100 | 디바이스마트 | 15223173 | 상품 페이지 (https://www.devicemart.co.kr/goods/view?no=15223173) | 회로도 U1 단자 / STEP 전장부 | 대안: CMODULE-47(15315957, 4,400원, 3핀(S/V/G) 헤더형·듀폰 연결, 단자대 아님. 보드 DC잭은 6.5~16V 입력이라 5V 어댑터 연결 금지). DevKitC는 폭이 넓어 830핀 브레드보드 1개에 꽂으면 한쪽 핀 열이 거의 남지 않음.
3 | P03 | 제어 | 메탈 푸쉬 스위치 플랫형 16mm [HX16-B1] (모멘터리) | 일반 PUSH(누르는 동안만 ON), 3A 36VDC, 패널 홀 16mm, 스위치 지름 18mm, LED 없음 | 1 | 0 | 1 | 2970 | 2970 | 디바이스마트 | 1325010 | 상품 페이지 (https://www.devicemart.co.kr/goods/view?no=1325010) | 회로도 SW2 / 앞판 상부 | GPIO4 ↔ GND (INPUT_PULLUP). 시작/비상정지 버튼.
4 | P04 | 제어 | 회로내장형 액티브 부저 모듈 [ONE005] | DC 3.3~5V, HIGH 입력 시 울림(액티브), 24×21mm, 고정 홀 | 1 | 0 | 1 | 1100 | 1100 | 디바이스마트 | 10916337 | 상품 페이지 (https://www.devicemart.co.kr/goods/view?no=10916337) | 회로도 BZ1 / 앞판 상부(안쪽) | SPEC상 선택 부품. I/O ← GPIO23, VCC ← TB3(3V3). HIGH=울림이라 SPEC v2.1 펌웨어 기본값 BUZZER_ON_LEVEL 1과 일치. (SZH-SDBJ-006 같은 LOW=울림 모듈을 쓰면 BUZZER_ON_LEVEL 0)
5 | P05 | 제어 | 5mm LED 빨강 원통평면형 불투명 [5PR3HD19] | 5파이, 2V, 20mA | 1 | 0 | 2 | 61 | 122 | 디바이스마트 | 3218 | 상품 페이지 (https://www.devicemart.co.kr/goods/view?no=3218) | 회로도 LED1 / 앞판 상부 | DevKitC V4에는 GPIO2 사용자 LED가 없으므로 외부 LED + 220Ω(R1) 필수(SPEC §1). 1개 예비. ※단가 재확인 필요(사이트 검색 결과 값, 상품 페이지 미확인)
6 | P06 | 제어 | 저항 220Ω 1/4W 1% [221F] | 탄소피막, 1/4W, ±1% | 1 | 0 | 10 | 33 | 330 | 디바이스마트 | 2001 | 상품 페이지 (https://www.devicemart.co.kr/goods/view?no=2001) | 회로도 R1 | 최소주문 10개. LED 전류 약 6mA. ※단가 재확인 필요(사이트 검색 결과 값, 상품 페이지 미확인)
7 | P07 | 제어 | Micro USB 5핀 데이터 케이블 1m | USB-A ↔ micro-B, 데이터 통신 가능 | 1 | 0 | 1 | 770 | 770 | 디바이스마트 | 32695 | 상품 페이지 (https://www.devicemart.co.kr/goods/view?no=32695) | STEP 펌웨어 업로드 | 펌웨어 업로드용. 데이터 전송되는 케이블이 이미 있으면 구매 불필요(충전 전용 케이블은 PC가 인식 못 함).
8 | P08 | 구동 | 아두이노 4채널 5V 릴레이 모듈 [SZH-RLBG-012] | TONGLING JQC-3FF-S-Z 5VDC(코일 약 70Ω≈71mA, 0.36W), 접점 10A 250VAC/10A 30VDC, 채널별 옵토커플러+표시LED, 2핀 JD-VCC/VCC 점퍼(별도 코일 GND핀 없음 → 코일 GND는 메인 헤더 GND), Active-LOW, 76×56mm, M3용 3mm 홀(간격 69.6×49.4mm) | 1 | 2 | 0 | 4180 | 0 | 디바이스마트 | 1327545 | 상품 페이지 (https://www.devicemart.co.kr/goods/view?no=1327545) | 회로도 K1~K4(릴레이 CH1~CH4) / STEP 전장부 | 1개는 예비(펌프 5~8 확장·고장 대비). A안(기본: JD-VCC 점퍼 제거, VCC=3V3)으로 안 켜지면 B안(SPEC 공식 대체안, USB·어댑터를 모두 뺀 상태에서: ① 입력 헤더 VCC ← 3V3 선(⑪)을 먼저 뽑음 → ② 5V 선(⑨)을 JD-VCC 핀에서 빼서 입력 헤더 VCC 핀에 꽂음 → ③ 점퍼 캡을 끼움 (VCC = JD-VCC = 5V, 점퍼가 2핀이라 JD-VCC 핀에는 캡만). B안에서 VCC를 3V3에 연결 금지) — parts_research.md 3.2절.
9 | P09 | 구동 | 수중펌프모터 [SZH-GNP155] | 정격 DC 3V(0.12A·80L/H·양정0.35m) / 4.5V(0.18A·100L/H·양정0.55m), 판매처 5V 연결 안내, 출수구 외경 7.5mm·내경 4.9mm, 본체 약 43×23mm, IP68, 튜브 미포함, 식품등급 표기 없음, 해외입고품(AS 불가) | 4 | 4 | 2 | 3190 | 6380 | 디바이스마트 | 1329770 | 상품 페이지 (https://www.devicemart.co.kr/goods/view?no=1329770) | 회로도 M1~M4 / STEP 용기·펌프 | qtyToBuy 2 = 고장 대비 예비(권장, 필수 아님 — 기말 시연·논문 실험 중 펌프가 고장 나면 바로 교체). 물 없이 공회전 금지. 식품등급 표기·본체 재질 미확인 → 시음하려면 재질 확인 또는 연동 펌프(P55)로 교체(조립가이드 1.3).
10 | P10 | 구동 | 다이오드 1N4007 | 1A 1000V, DO-41 | 4 | 10 | 0 | 22 | 0 | 디바이스마트 | 3011 | 상품 페이지 (https://www.devicemart.co.kr/goods/view?no=3011) | 회로도 D1~D4 | 펌프마다 병렬 1개: 띠(캐소드)→펌프(+)(=릴레이 NO 쪽), 반대쪽(애노드)→펌프(−)(=GND). 위치는 펌프 리드 이음부 또는 연장선의 박스 쪽 끝(전기적으로 동일, SPEC §1).
11 | P11 | 전원 | 아답터 100~240V / 5V 4A [내경2.1~2.5/외경5.5mm] 전원 코드 일체형 | 5V 4A, DC 케이블 150cm, 과전류·과전압·단락 보호 | 1 | 1 | 0 | 8360 | 0 | 디바이스마트 | 12233458 | 상품 페이지 (https://www.devicemart.co.kr/goods/view?no=12233458) | 회로도 어댑터(J1에 꽂음) / STEP 전원 | 최대 소비 추정 약 1.3A(병렬 구동 시) → 여유 충분. 코드 일체형이라 플러그를 뒤판 G의 Ø12 구멍으로 통과시킴 → 플러그 몸통 지름이 12mm 이하인지 실측(확인 필요).
12 | P12 | 전원 | 터미널블럭 to DC 커넥터 (DC2.1 FEMALE) [SZH-LC002] | DC잭 2.1×5.5mm(암), 최대 20A, 1~38V, 나사 단자 | 1 | 2 | 0 | 550 | 0 | 디바이스마트 | 1321144 | 상품 페이지 (https://www.devicemart.co.kr/goods/view?no=1321144) | 회로도 J1 / 전장 박스 | 1개 예비. 어댑터 플러그를 꽂는 입력 단자(전장 박스 안).
13 | P13 | 전원 | 로커 스위치 KCD1-101A (ON/OFF, SPST) | 2P, 6A 250VAC / 10A 125VAC | 1 | 0 | 1 | 330 | 330 | 디바이스마트 | 1790 | 상품 페이지 (https://www.devicemart.co.kr/goods/view?no=1790) | 회로도 SW1(전원 스위치) / STEP4 뒤판 G 사각 구멍 | 주 전원 스위치(SPEC v2.1 §1: J1(+) → SW1 → F1 → TB1). 패널 사각 구멍 치수는 실물 실측(확인 필요, 몸통 약 19×13mm 추정). STEP4에서 뒤판 G에 구멍을 먼저 뚫고 G 바깥에서 끼운 뒤 G 안쪽에서 납땜(재단된 G판이 STEP4 전에 필요).
14 | P14 | 전원 | 패널형 퓨즈홀더 FH-303 (5×20mm 유리관용) | 10A 250V, 너트 고정형, 납땜 단자 | 1 | 0 | 1 | 583 | 583 | 디바이스마트 | 4577 | 상품 페이지 (https://www.devicemart.co.kr/goods/view?no=4577) | 회로도 F1(퓨즈홀더) / STEP4 뒤판 G 둥근 구멍 | J1(+) → SW1 → F1 → TB1(+5V 버스). 장착 구멍 지름 실측(확인 필요, 나사 몸통 약 Ø12~13mm 추정). STEP4에서 뒤판 G 둥근 구멍에 바깥에서 끼우고 안쪽 너트로 고정한 뒤 납땜(SW1과 함께).
15 | P15 | 전원 | 퓨즈 5×20 3A 250V (LB FUSE) | 5파이×20mm, 3A | 1 | 0 | 3 | 121 | 363 | 디바이스마트 | 4537 | 상품 페이지 (https://www.devicemart.co.kr/goods/view?no=4537) | 회로도 F1(3A 퓨즈, P14 홀더에 장착) | 2개 예비(예비 퓨즈는 기기와 함께 보관).
16 | P16 | 전원 | 전해 커패시터 16V 1000µF 105℃ (SAMYOUNG, 10×16mm) | 16V / 1000µF / 105℃ / 10×16 DIP | 1 | 0 | 10 | 99 | 990 | 디바이스마트 | 29524 | 상품 페이지 (https://www.devicemart.co.kr/goods/view?no=29524) | 회로도 C1 | 최소주문 10개. TB1(+5V) 1번 ↔ TB2(GND) 8번 사이(연결 ⑥). 극성 주의(긴 다리·무표시 쪽 +, 띠 쪽 −).
17 | P17 | 전원 | (선택) 전해 커패시터 16V 100µF 105℃ (5×12mm) | 16V / 100µF / 105℃ | 1 | 0 | 10 | 33 | 330 | 디바이스마트 | 29522 | 상품 페이지 (https://www.devicemart.co.kr/goods/view?no=29522) | C2(선택, 회로도 외 보조) / 확장보드 5V–GND | 최소주문 10개. ESP32 확장보드 5V-GND 단자 근처 보조 커패시터(선택, 회로도에는 없음 — ESP32 재부팅이 잦을 때만). ※단가 재확인 필요(사이트 검색 결과 값, 상품 페이지 미확인)
18 | P18 | 전원 | 레버형 전선연결 커넥터 8선 결합 PCT-418 (칩센) | 8구 전부 공통 결선, AWG28~14(0.08~4.0mm²), 단선·연선 가능, 40.1×21×14.4mm | 3 | 0 | 4 | 352 | 1408 | 디바이스마트 | 10911193 | 상품 페이지 (https://www.devicemart.co.kr/goods/view?no=10911193) | 회로도 TB1(+5V)·TB2(GND)·TB3(3V3) / 전장 박스 | 회로도 v3 기준 3개 사용 + 1개 예비. TB1 = +5V 버스(8구 모두: F1 출력④·ESP32 5V⑧·JD-VCC⑨·K1~K4 COM⑰~⑳·C1+⑥), TB2 = GND 버스(J1−⑤·펌프(−)×4 ㉒㉔㉖㉘·C1−⑥, 2구 예비), TB3 = 3V3 분배(ESP32 3V3⑩ → 릴레이 VCC⑪(A안)·부저 VCC㉙). ESP32 GND는 J1(−)에서 바로(⑦, 별형 접지), 다이오드는 펌프 선에 납땜하므로 GND 커넥터는 TB2 하나로 충분.
19 | P19 | 배선 | AWG20 2P 10M (검정, 빨강) | 2심 평행선 AWG20 | 1 | 1 | 0 | 10340 | 0 | 디바이스마트 | 13003174 | 상품 페이지 (https://www.devicemart.co.kr/goods/view?no=13003174) | 전원·펌프 배선 | 5V/GND 전원 배선 + 펌프 리드선 연장(펌프당 약 0.7m × 4 ≈ 2.8m).
20 | P20 | 배선 | 점퍼 케이블 40P (F/F) | 2.54mm 듀폰 | 1 | 1 | 0 | 1100 | 0 | 디바이스마트 | 32284 | 상품 페이지 (https://www.devicemart.co.kr/goods/view?no=32284) | 릴레이 신호선 | 릴레이 IN 헤더 ↔ 확장보드(한쪽 끝을 잘라 피복을 벗겨 푸시인 단자에 삽입).
21 | P21 | 배선 | 점퍼 케이블 40P (M/F) | 2.54mm 듀폰 | 1 | 1 | 0 | 1100 | 0 | 디바이스마트 | 1113721 | 상품 페이지 (https://www.devicemart.co.kr/goods/view?no=1113721) | 릴레이 신호선 | 신호선/시험용.
22 | P22 | 배선 | 점퍼 케이블 40P (M/M) | 2.54mm 듀폰 | 1 | 1 | 0 | 1100 | 0 | 디바이스마트 | 1113722 | 상품 페이지 (https://www.devicemart.co.kr/goods/view?no=1113722) | STEP 벤치 테스트 | 브레드보드 시험용.
23 | P23 | 배선 | 브레드보드 830핀 MB-102 [SZH-BBAD-002] | 830홀 | 1 | 2 | 0 | 1540 | 0 | 디바이스마트 | 1322408 | 상품 페이지 (https://www.devicemart.co.kr/goods/view?no=1322408) | STEP 벤치 테스트 | 조립 전 회로 시험(벤치 테스트)용. 본체에는 미사용. 1학기 정산액(5/5 109,200원)이 의뢰서 합계(108,000원)보다 1,200원 많아, 품절 대체품 [Voltly] 브레드보드 830핀 흰색 VLT-BB016(15960353, 2,000원×2)으로 구매된 것으로 추정 — 실물 확인.
24 | P24 | 배선 | UL1007 래핑와이어 22AWG 10M 노랑 [VLT-CAB160] | UL1007, 22AWG, 노랑 | 1 | 0 | 1 | 3630 | 3630 | 디바이스마트 | 15960649 | 상품 페이지 (https://www.devicemart.co.kr/goods/view?no=15960649) | 앞판 신호선 ㉙·㉚·㉝·㉟ | 앞판 신호선(㉙ 부저 VCC 연장·㉚ 부저 I/O·㉝ 버튼·㉟ LED)용. 앞판 신호선 ㉙·㉚·㉝·㉟는 모두 이 노랑(연결표와 같음)이고 4가닥이 같은 색이라 선 양 끝 번호 테이프로 구분(㉙는 연결표대로 듀폰 주황으로 이어도 됨). GND선과 5V선은 색을 나눔: GND선(⑦·앞판 GND 공통선 ㉛·㉜·㉞·㊱) = 검정 P62, ESP32 5V선(⑧) = 빨강 P63(같은 시리즈·같은 값). 단가는 상품 페이지 확인(VAT 별도 3,300원).
25 | P62 | 배선 | UL1007 래핑와이어 22AWG 10M 검정 [VLT-CAB159] | UL1007, 22AWG, 검정 | 1 | 0 | 1 | 3630 | 3630 | 디바이스마트 | 15960648 | 상품 페이지 (https://www.devicemart.co.kr/goods/view?no=15960648) | ESP32 GND ⑦ · 앞판 GND 공통선 ㉛·㉜·㉞·㊱ | ESP32 GND선 ⑦(J1 − 나사 → J3-1, 약 20cm)과 앞판 GND 공통선(㉛ 약 40cm·㉜·㉞·㊱ 짧은 선) — 합계 약 1.5m. ⑦(GND 검정)과 ⑧(5V 빨강, P63)을 색으로 구분해 바꿔 무는 실수(ESP32 역전압)를 막음. 10M 단위 판매. 단가는 상품 페이지 확인(VAT 별도 3,300원).
26 | P63 | 배선 | UL1007 래핑와이어 22AWG 10M 빨강 [VLT-CAB161] | UL1007, 22AWG, 빨강 | 1 | 0 | 1 | 3630 | 3630 | 디바이스마트 | 15960650 | 상품 페이지 (https://www.devicemart.co.kr/goods/view?no=15960650) | ESP32 5V ⑧ | ESP32 5V선 ⑧(TB1-7 → J2-19, 약 20cm). 검정 P62와 색으로 극성 구분. 10M 단위 판매라 대부분 남음 → 2학기 확장(로드셀·추가 펌프) 전원선으로 활용. 단가는 상품 페이지 확인(VAT 별도 3,300원).
27 | P25 | 배선 | 열 수축 솔더 슬리브 1.0SQ [SZH-CA002] | 납+접착제 내장 수축튜브(무납땜 접속), 1.0SQ용 | 8 | 10 | 0 | 330 | 0 | 디바이스마트 | 12507090 | 상품 페이지 (https://www.devicemart.co.kr/goods/view?no=12507090) | 펌프 리드 연장 | 펌프 리드 ↔ AWG20 연장선 접속(펌프당 2개=8개). 열풍기 필요.
28 | P26 | 배선 | NT DIY 열수축튜브 328세트 | 8규격 5색, 40mm 컷팅 | 1 | 0 | 1 | 4290 | 4290 | 디바이스마트 | 1320936 | 상품 페이지 (https://www.devicemart.co.kr/goods/view?no=1320936) | 배선 절연 | 다이오드 다리·납땜부 절연.
29 | P27 | 배선 | 케이블타이 100mm 1000개 (CableMate UN-100MB 블랙) | 100mm | 1 | 0 | 1 | 3740 | 3740 | 디바이스마트 | 1215043 | 상품 페이지 (https://www.devicemart.co.kr/goods/view?no=1215043) | 배관·배선 정리 | 튜브-바브 연결부 조임, 배선 정리. ※단가 재확인 필요(사이트 검색 결과 값, 상품 페이지 미확인)
30 | P28 | 배선 | 케이블타이 고정용 접착 마운트 20×20mm [SZ-XL015] | 양면테이프 부착형 | 10 | 0 | 10 | 145 | 1450 | 디바이스마트 | 1382746 | 상품 페이지 (https://www.devicemart.co.kr/goods/view?no=1382746) | 배관 고정 | 최소주문 10개. 선반 아래 체크밸브·튜브 고정. ※단가 재확인 필요(사이트 검색 결과 값, 상품 페이지 미확인)
31 | P29 | 배관 | 실리콘 튜브 1M 내경 5mm (외경 7mm) [K11168275] | 내경5/외경7mm, 1m, 한국산, 식품등급 표기 없음 | 3 | 8 | 0 | 1870 | 0 | 디바이스마트 | 14115487 | 상품 페이지 (https://www.devicemart.co.kr/goods/view?no=14115487) | 배관(펌프→체크밸브) | 펌프 출수구(외경 7.5mm)에 끼움 → 체크밸브 앞까지. 펌프당 약 0.7m(용기 인출 여유 포함). 식품등급 표기 없음 → 시음 전에는 식품용 P65로 교체(선택, 조립가이드 1.3).
32 | P30 | 배관 | 실리콘 튜브 1M 내경 4mm (외경 6mm) [K11168264] | 내경4/외경6mm, 1m, 한국산, 식품등급 표기 없음 | 1 | 5 | 0 | 1760 | 0 | 디바이스마트 | 14115486 | 상품 페이지 (https://www.devicemart.co.kr/goods/view?no=14115486) | 배관(체크밸브↔노즐) | 체크밸브 바브(Ø3.2~5.0)용: ①입구 바브에 3cm 슬리브 → 그 바깥(외경6)에 내경5 튜브를 1.5cm 겹쳐 끼우고 케이블타이 ②출구 → 노즐 약 10cm. 식품등급 표기 없음 → 시음 전에는 식품용 P66으로 교체(선택, 조립가이드 1.3).
33 | P31 | 배관 | 체크밸브 JGB32PPS (JG) | 덕빌형, 개방압 2kPa(약 20cm 물기둥), 배압 3bar, 전장 35.3~35.8mm, 바브 Ø3.2(끝)~5.0(턱), 내부 유로 Ø2.0mm, 판매처 설명상 공기용, 재질/식품적합성 미표기 | 4 | 4 | 1 | 6050 | 6050 | 디바이스마트 | 12519260 | 상품 페이지 (https://www.devicemart.co.kr/goods/view?no=12519260) | 배관 CV1~CV4 / STEP 배관 | qtyToBuy 1 = 고장·막힘 대비 예비. 화살표(FLOW)가 노즐 쪽을 향하게, 노즐 직전에 설치. 유로 Ø2.0mm라 유량이 크게 줄 수 있음(parts_research.md 3.3절). 판매처 설명상 공기용·재질 미표기 → 시음 전에는 식품용 P67로 교체(선택, 조립가이드 1.3).
34 | P32 | 배관 | 식품용 밀폐용기 0.7~1.2L (PP/트라이탄) | 외곽 ≤ 폭95×깊이135×높이170mm(뚜껑 포함, W420 본체 기준), 뚜껑 입구 폭 ≥ 60mm, 뚜껑은 구멍을 뚫을 수 있는 PP | 4 | 0 | 4 |  |  | 다이소 매장(실측 후 구매) |  | 참고(다이소몰) (https://www.daisomall.co.kr/pd/pdr/SCR_PDR_0001?pdNo=58803) | STEP 용기 준비 | W420 본체는 용기 외곽 폭 ≤ 95mm일 때만 4개 일렬 배치 가능. 폭 95 초과~120mm 이하면 본체를 W520으로(parts_research.md 5.4절, 포맥스 재단 전에 결정), 120mm 초과면 다른 용기. 깊이 135mm 초과면 깊이 규칙도 적용. 다이소 1L급 직사각 용기는 대부분 폭 120mm 이상(예: TARK 1L 약 165×120×80mm는 W520 + 깊이 +30 필요, 다이소몰 pdNo=58803) → 매장에서 자로 재고 구매. 뚜껑에 Ø7(튜브)·Ø5(전선)·Ø3(공기, 진공 방지) 구멍. 가격 확인 필요
35 | P33 | 배관 | 드립 트레이(물받이) ≤ 150×100mm | PP 또는 스테인리스, 세척 가능, 높이 ≤ 15mm 권장 | 1 | 0 | 1 |  |  | 다이소 |  |  | STEP 잔 받침 | 비누받침/배수 트레이 등으로 대체 가능. 가격 확인 필요
36 | P34 | 외형 | 포맥스(PVC 발포보드) 5T 흰색 600×900mm | 5mm 두께, 커터칼 재단 가능 | 3 | 0 | 3 |  |  | 포맥스/아크릴 재단 쇼핑몰(아크리애·정아크릴·DKD아크릴 등) 또는 화방 |  | 재단 쇼핑몰 (https://www.acryiae.com/front/product/view.do?productSeq=14) | STEP 외형(재단표 A~N) | 권장: 재단표 부품 치수로 "맞춤 재단 주문"(아크리애 안내 오차 ±1~2mm, 자동견적 → 가격 확인 필요). 뒤판 G는 1주차 STEP4(SW1·F1을 G에 끼운 뒤 납땜)에 필요하므로 STEP1 시작일에 주문. 용기 폭으로 본체 폭(W420/W520)을 정한 뒤 주문. 직접 재단 시 600×900 3장(2장 + 뒤 덮개·예비용 1장). 디바이스마트(하나아크릴) 5T는 300×300~450×450 맞춤재단, 흰색 5T 미확인·일부 색 품절. 가격 확인 필요
37 | P35 | 외형 | 화신박스 단자함 EG AGH-152010 (150×200×100, 플라스틱 속판 포함) | 전장부 전용 박스(액체와 격리) | 1 | 0 | 1 | 12320 | 12320 | 디바이스마트 | 14003437 | 상품 페이지 (https://www.devicemart.co.kr/goods/view?no=14003437) | STEP5 전장부 / STEP10 선반 D 위 | 선반 위에 올리고 ESP32·릴레이·분배 커넥터를 내부에 배치. 벽 구멍: 좌·우 Ø12(펌프 선), 뒤 Ø16(어댑터 선·SW1/F1 선), 앞 Ø10(앞판 신호선) — 배선 후 글루건으로 막음. 내부 유효 치수 실측(확인 필요). 선반 D에는 접착식 벨크로(P64) 4쌍으로 고정(기본, 박스 바닥·D에 구멍 없음). 볼트 고정은 선택: 뒤쪽 두 모서리(본체 x 약 115·295, y 약 180)만, M3×15(P68).
38 | P36 | 외형 | L자 꺾쇠(소형, 약 25mm) | 철제, 나사 구멍 2개 | 12 | 0 | 12 |  |  | 다이소/철물점 |  |  | STEP 외형 조립 | 패널 모서리 보강 + 상판 탈착 고정. 가격 확인 필요
39 | P37 | 외형 | 스텐 둥근머리 십자볼트 M3×10 | M3, 10mm, SUS | 40 | 0 | 40 | 22 | 880 | 디바이스마트 | 10912297 | 상품 페이지 (https://www.devicemart.co.kr/goods/view?no=10912297) | STEP 외형·전장 | 최소주문 5개. ※단가 재확인 필요(사이트 검색 결과 값, 상품 페이지 미확인)
40 | P38 | 외형 | 육각 너트(스텐) M3 | M3, SUS | 40 | 0 | 40 | 22 | 880 | 디바이스마트 | 10893596 | 상품 페이지 (https://www.devicemart.co.kr/goods/view?no=10893596) | STEP 외형·전장 | 최소주문 5개. ※단가 재확인 필요(사이트 검색 결과 값, 상품 페이지 미확인)
41 | P39 | 외형 | M3 알루미늄 서포트 Female 10mm [SZH-ZR059] | M3, 10mm×5mm | 4 | 0 | 4 | 508 | 2032 | 디바이스마트 | 1382352 | 상품 페이지 (https://www.devicemart.co.kr/goods/view?no=1382352) | STEP 전장부 | 릴레이 모듈을 박스 속판에 띄워 고정(속판에 Ø3.2 구멍 4개, 간격 69.6×49.4mm). ESP32 확장보드는 서포트 동봉. ※단가 재확인 필요(사이트 검색 결과 값, 상품 페이지 미확인)
42 | P40 | 외형 | 둥근머리 십자볼트(니켈) M3×6 | M3, 6mm | 8 | 0 | 10 | 11 | 110 | 디바이스마트 | 10912222 | 상품 페이지 (https://www.devicemart.co.kr/goods/view?no=10912222) | STEP 전장부 | 서포트 고정용, 최소주문 10개. ※단가 재확인 필요(사이트 검색 결과 값, 상품 페이지 미확인)
43 | P41 | 외형 | 고무발 S-1 18×10H | 지름 18mm, 높이 10mm | 4 | 0 | 10 | 110 | 1100 | 디바이스마트 | 14882214 | 상품 페이지 (https://www.devicemart.co.kr/goods/view?no=14882214) | STEP 외형 | 최소주문 10개. 바닥판 네 모서리.
44 | P42 | 외형 | 순간접착제 LOCTITE 401 20g | 시아노아크릴레이트, 플라스틱용 | 1 | 0 | 1 | 4400 | 4400 | 디바이스마트 | 9108 | 상품 페이지 (https://www.devicemart.co.kr/goods/view?no=9108) | STEP 외형 조립 | 포맥스 맞대기 접착 + 상판 C 꺾쇠 아래 M3 너트 고정(캡티브 너트, 조립가이드 STEP9). 다이소 순간접착제로 대체 가능. ※단가 재확인 필요(사이트 검색 결과 값, 상품 페이지 미확인)
45 | P43 | 외형 | 핫멜트스틱(대) 10개 | 글루건용 굵은 스틱 | 1 | 0 | 1 | 2200 | 2200 | 디바이스마트 | 13187167 | 상품 페이지 (https://www.devicemart.co.kr/goods/view?no=13187167) | STEP 외형·배관 | 접착부 보강·관통 구멍 실링(전장 박스 벽 구멍·그로밋 둘레·뚜껑 구멍, 그로밋 대안). 사용 글루건 규격(7mm/11mm) 확인. ※단가 재확인 필요(사이트 검색 결과 값, 상품 페이지 미확인)
46 | P44 | 외형 | 케이블 그로밋(고무 부싱) — Ø20 구멍용 2개 + Ø12 구멍용 1개 | 고무, 패널 두께 5mm용(홈 폭 5mm 이상), 장착 구멍 Ø20 ×2 · Ø12 ×1 | 3 | 0 | 3 |  |  | 철물점/온라인(확인 필요) |  |  | STEP 외형(선반 D·뒤판 G) | 조립가이드 STEP9 구멍표 기준: 선반 D Ø20 ×2(펌프 선 통로), 뒤판 G Ø12 ×1(어댑터 선). 뒤판 G는 어댑터 플러그(코드 일체형)를 먼저 Ø12 구멍에 통과시킨 뒤, 그로밋에 칼집을 내어 케이블에 끼우고 구멍에 밀어 넣음(플러그가 그로밋 안지름보다 큼, 추정). 일반 그로밋은 판 두께 1~3mm용이 많아 5mm 포맥스에 맞는 제품이 없으면 사지 않고 글루건으로 구멍 가장자리 마감(대안, 추가 비용 0). 가격 확인 필요
47 | P45 | 외형 | 자석 캐치(또는 소형 경첩) 2세트 | 가구용 | 2 | 0 | 2 |  |  | 다이소/철물점 |  |  | STEP 외형(뒤 덮개) | 뒤 덮개(용기 칸) H 고정용 2개. 상판 C도 자석으로 고정하려면(볼트·캡티브 너트 대신, 선택) P69로 2~4개 추가. 가격 확인 필요
48 | P64 | 외형 | Coms 사각 벨크로테이프 10조 (접착식 양면 찍찍이) 55×35mm [T9162] | 뒷면 접착(양면테이프), 까끌면+보슬면 한 쌍 × 10조, 55×35mm | 1 | 0 | 1 | 1540 | 1540 | 디바이스마트 | 15810228 | 상품 페이지 (https://www.devicemart.co.kr/goods/view?no=15810228) | STEP10 절차 1 전장 박스 고정(기본) / 2.3 소모품 | 전장 박스(P35)를 선반 D에 고정하는 기본 방법(조립가이드 2.3 소모품·STEP10 절차 1): 박스 바닥 네 모서리와 D의 같은 자리에 한 쌍씩 = 4쌍 사용(크면 반으로 잘라 씀), 6쌍 예비. 박스 바닥·선반 D에 구멍을 뚫지 않음(박스 앞쪽 모서리 아래는 막힌 빈 공간이라 너트를 끼울 수 없음). 붙일 면의 먼지·기름을 닦고 꾹 눌러 붙임(제품 설명: 거친 면·재사용 시 접착력 떨어짐). 상품 페이지 확인: VAT 별도 1,400원 / 포함 1,540원, 평균 준비기간 3~4일(2026-11-06).
49 | P46 | 공구 | 실습용 납땜세트B (학교 실습실 대여 가능) | 인두기 30W·인두 스탠드·납흡입기·페이스트·납 50g | 1 | 0 | 0 | 26400 | 0 | 디바이스마트 | 10894366 | 상품 페이지 (https://www.devicemart.co.kr/goods/view?no=10894366) | STEP 공구 준비 | 학교 실습실 대여 가능. 없을 때만 구매. ※단가 재확인 필요(사이트 검색 결과 값, 상품 페이지 미확인)
50 | P47 | 공구 | 일반 실납 1.0mm [SME15510] (학교 실습실 대여 가능) | 1.0mm | 1 | 0 | 0 | 3190 | 0 | 디바이스마트 | 1171334 | 상품 페이지 (https://www.devicemart.co.kr/goods/view?no=1171334) | STEP 공구 준비 | 학교 실습실 대여/지급 확인. ※단가 재확인 필요(사이트 검색 결과 값, 상품 페이지 미확인)
51 | P48 | 공구 | 디지털 멀티미터 M300 (학교 실습실 대여 가능) | DCV ≤500V, DCA ≤200mA, 저항, 도통 | 1 | 0 | 0 | 8800 | 0 | 디바이스마트 | 10917721 | 상품 페이지 (https://www.devicemart.co.kr/goods/view?no=10917721) | STEP 공구 준비 | 전압·극성·도통 확인 필수 도구. ※단가 재확인 필요(사이트 검색 결과 값, 상품 페이지 미확인)
52 | P49 | 공구 | 와이어 스트리퍼 TU-2021 (학교 실습실 대여 가능) | 0.6~2.6mm(약 AWG22~10) | 1 | 0 | 0 | 4180 | 0 | 디바이스마트 | 1330597 | 상품 페이지 (https://www.devicemart.co.kr/goods/view?no=1330597) | STEP 공구 준비 | AWG20/22 피복 제거. ※단가 재확인 필요(사이트 검색 결과 값, 상품 페이지 미확인)
53 | P50 | 공구 | 니퍼 TU-C01 (학교 실습실 대여 가능) | 125mm | 1 | 0 | 0 | 3190 | 0 | 디바이스마트 | 1287084 | 상품 페이지 (https://www.devicemart.co.kr/goods/view?no=1287084) | STEP 공구 준비 | 학교 대여 가능. ※단가 재확인 필요(사이트 검색 결과 값, 상품 페이지 미확인)
54 | P51 | 공구 | 글루건 DY-3000 60W (학교 실습실 대여 가능) | 11mm 스틱용 | 1 | 0 | 0 | 8360 | 0 | 디바이스마트 | 10931307 | 상품 페이지 (https://www.devicemart.co.kr/goods/view?no=10931307) | STEP 공구 준비 | 학교 대여 가능. ※단가 재확인 필요(사이트 검색 결과 값, 상품 페이지 미확인)
55 | P52 | 공구 | 열풍기 D26411 (학교 실습실 대여 가능) | 2단 풍량, 노즐 2개 | 1 | 0 | 0 | 68200 | 0 | 디바이스마트 | 12171271 | 상품 페이지 (https://www.devicemart.co.kr/goods/view?no=12171271) | STEP 공구 준비 | 솔더 슬리브·수축튜브용. 고가 → 학교 대여 권장. ※단가 재확인 필요(사이트 검색 결과 값, 상품 페이지 미확인)
56 | P53 | 공구 | 헬리컬 스텝드릴 4~35mm [K40843729] (학교 실습실 대여 가능) | 생크 6.35mm | 1 | 0 | 0 | 26070 | 0 | 디바이스마트 | 14117356 | 상품 페이지 (https://www.devicemart.co.kr/goods/view?no=14117356) | STEP 공구 준비 | Ø4~25 구멍: 버튼 Ø16·그로밋 Ø20/Ø12·튜브 통로 Ø25·전장 박스 벽 Ø10~16·뚜껑 Ø7/Ø5·LED Ø5·노즐 판 Ø6.5. Ø3(뚜껑 공기 구멍·안내 구멍)·Ø3.2/Ø3.5(M3 볼트)는 일반 드릴 날 사용. 드릴 본체·드릴 날은 학교 대여. ※단가 재확인 필요(사이트 검색 결과 값, 상품 페이지 미확인)
57 | P54 | 공구 | 커터칼(대)·쇠자(60cm)·커팅매트 (학교 실습실 대여 가능) | 포맥스 직접 재단용 | 1 | 0 | 0 |  |  | 다이소/화방 |  |  | STEP 외형 | 재단 주문 시 불필요. 가격 확인 필요
58 | P55 | 선택 | 연동(페리스탈틱) 펌프 DFRobot Gravity Digital Peristaltic Pump [DFR0523] | 입력 5~6V, 연속 1.8A/피크 2.5A, 서보(PPM) 신호 제어 | 4 | 0 | 0 | 45540 | 0 | 디바이스마트 | 1377341 | 상품 페이지 (https://www.devicemart.co.kr/goods/view?no=1377341) | 2학기 확장/논문 | 액체가 튜브에만 닿아 위생·정량성 우수. 4개면 약 18만원, 전류가 커서 5V 10A급 전원 필요(확인 필요). 대안: Adafruit 12V 연동펌프(14600697, 49,830원, 12V 전원 필요).
59 | P56 | 선택 | HX711 로드셀 24비트 AD 컨버터 모듈 [SZH-SSBH-016] | 2.7~5V | 1 | 0 | 0 | 1870 | 0 | 디바이스마트 | 1327440 | 상품 페이지 (https://www.devicemart.co.kr/goods/view?no=1327440) | 2학기 확장/논문 | 무게 기반 자동 보정(잔 받침 아래 로드셀).
60 | P57 | 선택 | 4선 로드셀 1kg [VLT-LCS002] | 1kg, 4선 | 1 | 0 | 0 | 7260 | 0 | 디바이스마트 | 15961057 | 상품 페이지 (https://www.devicemart.co.kr/goods/view?no=15961057) | 2학기 확장/논문 | HX711과 함께 사용.
61 | P58 | 선택 | MOSFET GPIO 보드 4채널 YYNMOS-4 [SZH-YY012] (AF60N03) | 36V 5A, 단방향 | 1 | 0 | 0 | 19360 | 0 | 디바이스마트 | 13908386 | 상품 페이지 (https://www.devicemart.co.kr/goods/view?no=13908386) | 2학기 확장/논문 | 릴레이 대체·PWM 유량 미세제어. ESP32 3.3V 게이트 구동 가능 여부 확인 필요. PWM 시 플라이백은 1N5819 쇼트키(상품번호 27, 44원, 최소 10) 권장.
62 | P65 | 선택 | (선택·시음 전 교체용) 식품용 실리콘 튜브 내경5/외경7mm (FDA 또는 LFGB 표기), 1m 단위 | 내경5/외경7mm, 식품 접촉용 표기(FDA 21 CFR 177.2600 또는 LFGB) + 판매처 적합성 자료(시험성적서) 확인 | 3 | 0 | 0 |  |  | 국내 쇼핑몰·실험용품점 (디바이스마트 미취급, 확인 필요) |  |  | 1.3 시음 조건 / STEP8 배관(P29 자리) | P29 대체(지금 P29는 식품등급 표기 없음 → 바꾸기 전에는 아무도 마시지 않음, 조립가이드 1.3·5장). 펌프 출수구(외경 7.5) → 체크밸브 앞까지 펌프당 약 0.7m × 4 = 약 2.8m → 3m. 디바이스마트 검색("식품용 실리콘 튜브"·"실리콘 튜브 FDA"·"식품등급"·"Food-Grade", 2026-11-06)에 식품용 표기 실리콘 튜브 없음 → 판매처·가격 확인 필요. 시음할 계획(예: 졸업작품 심사)이 정해지면 미리 주문. 튜브·밸브만으로는 부족 — 펌프(P09) 재질 확인 또는 연동 펌프(P55) 교체도 함께(1.3). 가격 확인 필요
63 | P66 | 선택 | (선택·시음 전 교체용) 식품용 실리콘 튜브 내경4/외경6mm (FDA 또는 LFGB 표기), 1m 단위 | 내경4/외경6mm, 식품 접촉용 표기(FDA 21 CFR 177.2600 또는 LFGB) + 판매처 적합성 자료 확인 | 1 | 0 | 0 |  |  | 국내 쇼핑몰·실험용품점 (디바이스마트 미취급, 확인 필요) |  |  | 1.3 시음 조건 / STEP8 배관(P30 자리: 슬리브·노즐 쪽) | P30 대체: 체크밸브 입구 겹침 이음 슬리브 3cm + 밸브 → 노즐 15cm = 펌프당 18cm × 4 = 약 0.72m → 1m. 외경 6mm가 내경5 튜브 안에 꽉 끼어야 겹침 이음이 됨(P30과 같은 치수). 디바이스마트 검색("식품용 실리콘 튜브"·"실리콘 튜브 FDA"·"식품등급"·"Food-Grade", 2026-11-06)에 식품용 표기 실리콘 튜브 없음 → 판매처·가격 확인 필요. 가격 확인 필요
64 | P67 | 선택 | (선택·시음 전 교체용) 식품용 체크밸브 — 액체용, 내경4 튜브용 바브 (P31과 같은 규격) | 식품 접촉 재질 표기(예: PP 몸통 + 실리콘 덕빌, FDA 21 CFR 177.1520·177.2600 등), 액체용, 바브가 내경4/외경6 튜브에 맞음(P31: 바브 끝 Ø3.2~턱 Ø5.0), 개방압 약 2kPa 이하·내부 유로 Ø2mm 이상 권장 | 4 | 0 | 0 |  |  | 국내 쇼핑몰·실험용품점 (디바이스마트 미취급, 확인 필요) |  |  | 1.3 시음 조건 / STEP8 배관 CV1~CV4(P31 자리) | P31 대체(JGB32PPS는 판매처 설명상 "공기용", 재질·식품 적합성 미표기). 4개 + 예비 1 권장(선택 구매 수량 5). 디바이스마트 "체크밸브" 검색 결과(JGB32PPS·JT3205·JGG95ABS 등)는 모두 공기용 설명이고 식품용 표기 제품 없음(2026-11-06) → 판매처·가격 확인 필요. 개방압이 크거나 유로가 좁으면 유량이 줄어드니, 바꾼 뒤 STEP8 누수·역류 테스트와 STEP11 캘리브레이션을 다시 함. 화살표(FLOW)는 노즐 쪽. 가격 확인 필요
65 | P68 | 선택 | (선택·조립 방식) 둥근머리 십자볼트 머신스크류 M3×15 (철, 노란색) | M3, 15mm, 철(상품명 "노란색"), 십자 | 2 | 0 | 0 | 11 | 0 | 디바이스마트 | 34252 | 상품 페이지 (https://www.devicemart.co.kr/goods/view?no=34252) | STEP10 절차 1 (선택: 볼트 고정) / STEP9 D 선반 (선택) 구멍 | 전장 박스를 볼트로 고정할 때만(선택, 기본은 벨크로 P64): 뒤쪽 두 모서리(본체 x 약 115·295, y 약 180 — 아래가 용기 칸)만 사용. 볼트가 박스 바닥 + 선반 D(5mm) + 너트(P38 M3)를 지나야 해서 M3×10(P37)은 짧을 수 있음(박스 바닥 두께 실측). 최소주문 10개 → 선택 구매 수량 10(110원). 너트는 P38, 뒤 덮개 H를 열고 용기를 꺼낸 뒤 용기 칸 쪽(D 아래)에서 끼움. 스텐을 원하면 스텐 둥근머리 십자볼트는 15mm가 없어 M3×16(10912300, 33원, 최소 5개). 볼트 고정을 고르면 디바이스마트 주문에 함께 넣고, 선반 D Ø3.5 ×2(STEP9 구멍 표 "D 선반 (선택)", 조립 전)와 박스 바닥 Ø3.5 ×2(STEP5 박스 준비, 속판 달기 전)를 미리 뚫음. 상품 페이지 확인: VAT 별도 10원 / 포함 11원, 평균 준비기간 1~2일(2026-11-06).
66 | P69 | 선택 | (선택·조립 방식) 자석 캐치 추가분 — 상판 C 고정 대안 (P45와 같은 제품) | 가구용 자석 캐치, P45와 같은 제품 | 4 | 0 | 0 |  |  | 다이소/철물점 |  |  | STEP9 상판 C (선택: 자석 고정) | 상판 C를 볼트(꺾쇠 아래 캡티브 너트, STEP9 절차 다 9) 대신 자석으로 붙일 때만(선택): 2~4개 추가(선택 구매 수량은 4 기준). 뒤 덮개 H용 P45 2개와 별도. 볼트 방식이면 불필요. 가격 확인 필요. 가격 확인 필요
67 | P59 | 미사용 | SparkFun 솔레노이드 5V (small) [ROB-11015] | 5V 솔레노이드 | 0 | 4 | 0 | 14410 | 0 | 디바이스마트 | 1313586 | 상품 페이지 (https://www.devicemart.co.kr/goods/view?no=1313586) | - | 1학기 설계 변경(솔레노이드 제거, 펌프 단독 시간 제어)으로 미사용.
68 | P60 | 미사용 | 열 수축 솔더 슬리브 6.0SQ [SZH-CA004] | 6.0SQ(약 10AWG)용 | 0 | 10 | 0 | 440 | 0 | 디바이스마트 | 12507092 | 상품 페이지 (https://www.devicemart.co.kr/goods/view?no=12507092) | - | AWG20·펌프 리드선에는 너무 커서 미사용.
69 | P61 | 미사용 | DC 플러그 NT10-AF35 (DC 전원 변환 젠더, 수 5.5/2.1mm, 25cm) | 수(Male) 플러그 + 25cm 리드선 | 0 | 1 | 0 | 1100 | 0 | 디바이스마트 | 1078077 | 상품 페이지 (https://www.devicemart.co.kr/goods/view?no=1078077) | - | 현재 설계에서는 불필요(어댑터 → 터미널 DC 암 단자로 직접 연결). 예비/시험용.
 |  |  | 합계 (추가 구매, VAT 포함 · 가격 미확인 품목 제외) |  |  |  | 196 |  | 79658
 |  |  | └ 디바이스마트 주문 합계 (VAT 포함) |  |  |  |  |  | 79658 | 무료배송 충족(≥66,000원)
 |  |  | └ 이 중 단가 재확인 필요 품목 금액 |  |  |  |  |  | 16474 |  |  |  |  | P05·P06·P17·P27·P28·P37~P40·P42·P43 — 모두 10% 낮아도 무료배송 기준 유지
 |  |  | └ 가격 미확인(빈칸) 추가 구매 품목 수 |  |  |  |  |  | 6 |  |  |  |  | P32 용기 · P33 드립 트레이 · P34 포맥스 · P36 L자 꺾쇠 · P44 그로밋 · P45 자석 캐치 (선택 구매 P65·P66·P67·P69도 가격 확인 필요 — 선택_업그레이드 시트)

Sheet: 추가구매_의뢰서용
 | <캡스톤 물품 구매 신청>
분반 | 51 |  |  |  | 캡스톤디자인Ⅱ(2026/2학기) 추가분 · 작성 2026-11-06
팀명 | 홍당무 |  |  |  | 금액 = 단가(VAT 별도). 1학기 의뢰서·정산서와 같은 기준 (디바이스마트 VAT 포함가 ÷ 1.1)
팀장 | (제출 전 직접 기입) | 연락처 |  |  | 팀장 이름·연락처는 제출 전에 직접 기입 (공개 저장소라 비워 둠)
순번 | 물품 이름 | 상품 번호 | 금액 | 세부내역(수량) | 비고
【1】 디바이스마트 (devicemart.co.kr) — 학교 인터넷 구매신청 / 법인카드
1 | ESP32-DevKitC 터미널 확장보드 Push-in 타입 (ElectroCookie) | 15223173 | ₩11000 | 1 | P02 · ESP32 배선용 단자 확장보드
2 | 메탈 푸쉬 스위치 플랫형 16mm [HX16-B1] (모멘터리) | 1325010 | ₩2700 | 1 | P03 · 시작/비상정지 버튼
3 | 회로내장형 액티브 부저 모듈 [ONE005] | 10916337 | ₩1000 | 1 | P04 · 완료 알림 부저
4 | 5mm LED 빨강 원통평면형 불투명 [5PR3HD19] | 3218 | ₩55 | 2 | P05 · 상태 표시 LED (1개 예비) · 단가 재확인 필요
5 | 저항 220Ω 1/4W 1% [221F] | 2001 | ₩30 | 10 | P06 · LED 저항 (최소주문 10개) · 단가 재확인 필요
6 | Micro USB 5핀 데이터 케이블 1m | 32695 | ₩700 | 1 | P07 · 펌웨어 업로드용 (데이터 케이블 보유 시 제외)
7 | 수중펌프모터 [SZH-GNP155] | 1329770 | ₩2900 | 2 | P09 · 고장 대비 예비 펌프 (권장)
8 | 로커 스위치 KCD1-101A (ON/OFF, SPST) | 1790 | ₩300 | 1 | P13 · 주 전원 스위치
9 | 패널형 퓨즈홀더 FH-303 (5×20mm 유리관용) | 4577 | ₩530 | 1 | P14 · 퓨즈홀더 (전원 보호)
10 | 퓨즈 5×20 3A 250V (LB FUSE) | 4537 | ₩110 | 3 | P15 · 3A 퓨즈 (2개 예비)
11 | 전해 커패시터 16V 1000µF 105℃ (SAMYOUNG, 10×16mm) | 29524 | ₩90 | 10 | P16 · 5V 전원 안정화 (최소주문 10개)
12 | (선택) 전해 커패시터 16V 100µF 105℃ (5×12mm) | 29522 | ₩30 | 10 | P17 · (선택) 보조 커패시터 (최소주문 10개) · 단가 재확인 필요
13 | 레버형 전선연결 커넥터 8선 결합 PCT-418 (칩센) | 10911193 | ₩320 | 4 | P18 · TB1 +5V · TB2 GND · TB3 3V3 분배 (1개 예비)
14 | UL1007 래핑와이어 22AWG 10M 노랑 [VLT-CAB160] | 15960649 | ₩3300 | 1 | P24 · 버튼·LED·부저 신호선 (노랑)
15 | UL1007 래핑와이어 22AWG 10M 검정 [VLT-CAB159] | 15960648 | ₩3300 | 1 | P62 · ESP32 GND선 ⑦·앞판 GND 공통선 (검정)
16 | UL1007 래핑와이어 22AWG 10M 빨강 [VLT-CAB161] | 15960650 | ₩3300 | 1 | P63 · ESP32 5V선 ⑧ (빨강)
17 | NT DIY 열수축튜브 328세트 | 1320936 | ₩3900 | 1 | P26 · 배선 절연
18 | 케이블타이 100mm 1000개 (CableMate UN-100MB 블랙) | 1215043 | ₩3400 | 1 | P27 · 튜브 연결부 조임·배선 정리 · 단가 재확인 필요
19 | 케이블타이 고정용 접착 마운트 20×20mm [SZ-XL015] | 1382746 | ₩132 | 10 | P28 · 체크밸브·튜브 고정 (최소주문 10개) · 단가 재확인 필요
20 | 체크밸브 JGB32PPS (JG) | 12519260 | ₩5500 | 1 | P31 · 고장·막힘 대비 예비 체크밸브
21 | 화신박스 단자함 EG AGH-152010 (150×200×100, 플라스틱 속판 포함) | 14003437 | ₩11200 | 1 | P35 · 전장부 박스 (액체와 격리)
22 | 스텐 둥근머리 십자볼트 M3×10 | 10912297 | ₩20 | 40 | P37 · 외형·전장 고정 볼트 · 단가 재확인 필요
23 | 육각 너트(스텐) M3 | 10893596 | ₩20 | 40 | P38 · M3 볼트용 너트 · 단가 재확인 필요
24 | M3 알루미늄 서포트 Female 10mm [SZH-ZR059] | 1382352 | ₩462 | 4 | P39 · 릴레이 모듈 띄움 고정 · 단가 재확인 필요
25 | 둥근머리 십자볼트(니켈) M3×6 | 10912222 | ₩10 | 10 | P40 · 서포트 고정 볼트 (최소주문 10개) · 단가 재확인 필요
26 | 고무발 S-1 18×10H | 14882214 | ₩100 | 10 | P41 · 바닥 고무발 (최소주문 10개)
27 | 순간접착제 LOCTITE 401 20g | 9108 | ₩4000 | 1 | P42 · 포맥스 접착 · 상판 C 꺾쇠 너트 고정 · 단가 재확인 필요
28 | 핫멜트스틱(대) 10개 | 13187167 | ₩2000 | 1 | P43 · 접착부 보강 (글루건 스틱 규격 확인) · 단가 재확인 필요
29 | Coms 사각 벨크로테이프 10조 (접착식 양면 찍찍이) 55×35mm [T9162] | 15810228 | ₩1400 | 1 | P64 · 전장 박스 고정 (접착식 벨크로 10쌍 중 4쌍 사용)
 | 디바이스마트 소계 (VAT 별도) |  | ₩72418 |  | 참고: 실제 결제 예상액(VAT 포함)은 아래 줄
 | └ 참고: 디바이스마트 결제 예상액 (VAT 포함, BOM_전체 시트 연동) |  | ₩79658 |  | 무료배송 기준 66,000원 충족
【2】 다이소 · 철물점 · 재단 업체 (상품 번호 없음 — 법인카드 사용, 가격 확인 필요)
30 | 식품용 밀폐용기 0.7~1.2L (PP/트라이탄) |  |  | 4 | P32 · 구매처: 다이소 매장 · 외곽 폭≤95·깊이≤135·높이≤170mm(W420 본체 기준), 입구≥60mm, PP — 매장에서 자로 실측 후 같은 제품 4개. 폭 95 초과~120mm면 본체 W520 · 가격 확인 필요
31 | 드립 트레이(물받이) ≤ 150×100mm |  |  | 1 | P33 · 구매처: 다이소 · 물받이 ≤150×100mm, 높이≤15mm · 가격 확인 필요
32 | 포맥스(PVC 발포보드) 5T 흰색 600×900mm |  |  | 3 | P34 · 구매처: 포맥스 재단 쇼핑몰(아크리애·정아크릴·DKD아크릴) 또는 화방 · 용기로 본체 폭(W420/W520)을 정한 뒤 재단표(A~N) 치수로 맞춤 재단 주문 권장 (직접 재단 시 600×900 3장). 뒤판 G는 1주차 STEP4에 필요하므로 일찍 주문 · 가격 확인 필요
33 | L자 꺾쇠(소형, 약 25mm) |  |  | 12 | P36 · 구매처: 다이소/철물점 · 약 25mm, 나사 구멍 Ø3.5~4 (M3 볼트용) · 가격 확인 필요
34 | 케이블 그로밋(고무 부싱) — Ø20 구멍용 2개 + Ø12 구멍용 1개 |  |  | 3 | P44 · 구매처: 철물점/온라인 · Ø20 구멍용 2(선반 D) + Ø12 구멍용 1(뒤판 G), 패널 5mm용 — 맞는 제품이 없으면 글루건 마감 · 가격 확인 필요
35 | 자석 캐치(또는 소형 경첩) 2세트 |  |  | 2 | P45 · 구매처: 다이소/철물점 · 뒤 덮개(용기 칸) 고정 · 가격 확인 필요
 | 다이소·철물점·재단 소계 |  | ₩0 |  | 가격 확인 후 금액 칸에 단가를 입력하면 자동 합산
 | 합계 (VAT 별도) |  | ₩72418 |  | 총 35품목 (가격 미확인 6품목은 금액 미포함)

Sheet: 보유_미사용
보유했지만 이번 설계(v2)에서 쓰지 않거나 남는 부품
1학기 구매 단가는 물품구매의뢰서 기준(VAT 별도). 남는 수량 = 보유 − 이번 설계 사용.
No | ID | 부품명 | 보유수량 | 이번 설계 사용 | 남는 수량 | 구분 | 1학기 구매 단가(원) | 남는 부품 금액(원) | 활용 아이디어 / 메모
1 | P59 | SparkFun 솔레노이드 5V (small) [ROB-11015] | 4 | 0 | 4 | 미사용(설계 변경) | 13100 | 52400 | 1학기 설계 변경(솔레노이드 제거 → 펌프 단독 시간 제어)으로 미사용. 이 부품은 액체를 여닫는 '밸브'가 아니라 막대(플런저)를 밀고 당기는 소형 액추에이터이므로 액체 경로에는 쓸 수 없음(제품 설명 확인 권장). 활용: ① 주류 용기 칸 잠금 장치 — 앱 성인 인증(만 19세) 후에만 잠금 해제(예비 릴레이 CH + 1N4007 병렬, 정격 전류 확인 필요), ② 노즐을 톡 쳐서 마지막 방울을 떨어뜨리는 드립 커터, ③ 시연용 동작 데모. 사용하지 않으면 학과 공용 부품으로 반납·기증.
2 | P60 | 열 수축 솔더 슬리브 6.0SQ [SZH-CA004] | 10 | 0 | 10 | 미사용(규격 큼) | 400 | 4000 | 약 10AWG 굵은 전선용이라 AWG20·펌프 리드선에는 너무 큼. 활용: 2학기 연동펌프용 5V 10A급 전원의 굵은 전선(AWG14~12) 접속.
3 | P61 | DC 플러그 NT10-AF35 (수 5.5/2.1mm, 25cm) | 1 | 0 | 1 | 미사용 | 1000 | 1000 | 어댑터 → DC 암 단자(P12) 직결이라 불필요. 활용: 벤치 시험용 전원 케이블, 2학기 추가 모듈 전원 분기.
4 | P01 | ESP32 DevKitC WROOM-32D V4 | 2 | 1 | 1 | 예비 1 | 8000 | 8000 | 펌웨어 개발용 두 번째 보드(본체 조립 중에도 앱-BLE 시험), 기말 시연·논문 실험 중 고장 대비 예비 — 펌웨어를 미리 올려 둘 것.
5 | P08 | 4채널 5V 릴레이 [SZH-RLBG-012] | 2 | 1 | 1 | 예비 1 | 2600 | 2600 | SPEC의 펌프 5~8 확장(GPIO 25·13·18·19), 솔레노이드 잠금 장치·조명 제어, 고장 대비 예비(B안 전환 시험용으로도 사용).
6 | P23 | 브레드보드 830핀 | 2 | 0 | 2 | 벤치 테스트 전용 | 1400 | 2800 | 조립 전 회로 시험용(본체에는 미사용). 2학기 HX711·로드셀 시험. (1학기 대체품 VLT-BB016 2,000원으로 구매되었을 가능성 — BOM 비고 참고)
7 | P12 | 터미널블럭 to DC 커넥터 (DC2.1 FEMALE) | 2 | 1 | 1 | 예비 1 | 500 | 500 | 전원 입력 단자 예비.
8 | P10 | 다이오드 1N4007 | 10 | 4 | 6 | 예비 6 | 20 | 120 | 펌프 추가(5~8)·솔레노이드 플라이백 다이오드.
9 | P29 | 실리콘 튜브 내경 5mm (1m) | 8 | 3 | 5 | 예비 약 5m | 1700 | 8500 | 위생을 위해 주기적 교체용, 세척용 연장 호스.
10 | P30 | 실리콘 튜브 내경 4mm (1m) | 5 | 1 | 4 | 예비 약 4m | 1600 | 6400 | 노즐 쪽 튜브 교체용.
11 | P25 | 열 수축 솔더 슬리브 1.0SQ | 10 | 8 | 2 | 예비 2 | 300 | 600 | 접속 실패 시 재작업용.
12 | P22 | 점퍼 케이블 40P (M/M) | 1 | 0 | 1 | 벤치 테스트 전용 | 1000 | 1000 | 브레드보드 시험용.
 |  | 합계 (남는 부품의 1학기 구매 금액) |  |  |  |  |  | 87920

Sheet: 선택_업그레이드
선택 구매 — 위: 업그레이드(2학기 확장 · 졸업논문 · 특허 포인트) / 아래: 시음 전 교체용 · 조립 방식 선택
단가 = 디바이스마트 VAT 포함가. 빈칸 = 가격 확인 필요(단가를 입력하면 금액·예산 시트가 자동 계산). 이 시트의 품목은 필수 구매(BOM_전체 합계·의뢰서)에 포함하지 않음. 업그레이드는 필수 부품으로 기본 동작 확인 후 검토.
No | ID | 품목 | 상품번호 | 링크 | 수량 | 단가(원) | 금액(원) | 우선순위 | 기대 효과 (논문 포인트) | 필요 조건 / 주의
1 | P56+P57 | HX711 로드셀 AD 모듈 [SZH-SSBH-016] + 4선 로드셀 1kg [VLT-LCS002] | 1327440 / 15961057 | 상품 페이지 (https://www.devicemart.co.kr/goods/view?no=1327440) | 1 | 9130 | 9130 | 1순위 | 잔 받침 아래 무게 측정 → ① '시간 제어(개루프) vs 무게 피드백(폐루프)' 추출 정확도 비교 실험(목표량 대비 오차율 %) — 논문 핵심 데이터, ② 캘리브레이션 자동화(10초 구동 후 무게로 ml/s 자동 계산), ③ 잔이 없으면 제조 금지(안전). | GPIO 2개 필요(SPEC 핀맵 확장 필요). 액체 비중(시럽·주류) 보정 필요. 단가 = 1,870 + 7,260 (각 상품 페이지).
2 | P55 | DFRobot Gravity 디지털 연동(페리스탈틱) 펌프 [DFR0523] | 1377341 | 상품 페이지 (https://www.devicemart.co.kr/goods/view?no=1377341) | 4 | 45540 | 182160 | 2순위 | 액체가 튜브 안에서만 이동 → 펌프 내부 오염 없음(식품 위생). 회전수 ∝ 유량이라 양정·점도 영향이 적어 시럽 같은 '이종 점도 액체 정밀 펌핑'(특허 아이디어)과 직결. 수중펌프 vs 연동펌프 유량 안정성 비교 실험. | 4개 약 18만원. 연속 1.8A/피크 2.5A → 4개 동시 구동 시 5V 10A급 전원 필요(아래 U2). 서보(PPM) 신호 제어라 펌웨어 수정 필요.
3 | U2 | 5V 10A급 SMPS (연동펌프 4개 동시 구동용) |  |  | 1 |  |  | 2순위(P55와 함께) | 연동펌프 전원. | 제품·가격 확인 필요.
4 | P58 | MOSFET GPIO 보드 4채널 YYNMOS-4 [SZH-YY012] (AF60N03) | 13908386 | 상품 페이지 (https://www.devicemart.co.kr/goods/view?no=13908386) | 1 | 19360 | 19360 | 3순위 | 릴레이 대체 → 무접점(딸깍 소음·접점 마모 없음), PWM으로 유량 미세 조절 → 목표량 근처에서 감속해 넘침 감소. | ESP32 3.3V 게이트 구동 가능 여부 확인 필요.
5 | U1 | 쇼트키 다이오드 1N5819 (MOSFET PWM용 플라이백) | 27 | 상품 페이지 (https://www.devicemart.co.kr/goods/view?no=27) | 10 | 44 | 440 | 3순위(P58과 함께) | PWM 구동 시 빠른 플라이백 다이오드. | 최소주문 10개. ※단가 재확인 필요(조사 메모 값).
6 | U3 | (대안) Adafruit 12V 연동펌프 | 14600697 | 상품 페이지 (https://www.devicemart.co.kr/goods/view?no=14600697) | 0 | 49830 | 0 | 대안 | P55 대신 사용 가능한 연동펌프. | 12V 전원 별도 필요 → 전원 설계 변경. 수량 0(비교용).
7 | S1 | (소프트웨어) 잔량 기반 유량 보정 |  |  | 0 | 0 | 0 | 무료 | 앱이 아는 잔량(액면 높이)에 따라 유량이 15~20% 변하는 것을 보정 계수로 반영 → 추가 비용 없이 정확도 개선. | 펌웨어·앱 수정만 필요. 로드셀 데이터로 보정 계수 도출 가능.
 |  | 합계 (가격 확인 필요 품목 제외) |  |  |  |  | 211090
선택 구매 — 시음 전 교체용(식품용 튜브·체크밸브) · 조립 방식 선택(볼트·자석) : 필요할 때만, 필수 합계에 포함하지 않음
No | ID | 품목 | 상품번호 | 링크 | 수량 | 단가(원) | 금액(원) | 구분 | 언제 사나 (용도) | 고르는 기준 / 주의
1 | P65 | 식품용 실리콘 튜브 내경5/외경7mm (FDA 또는 LFGB 표기), 1m 단위 |  |  | 3 |  |  | 시음 전 교체용 | 팀원 시음(예: 졸업작품 심사)을 할 때만 — 그 전에는 색 물 시연, 아무도 마시지 않음(조립가이드 1.3). P29(내경5) 대체: 펌프 → 체크밸브 펌프당 약 0.7m × 4 | FDA(21 CFR 177.2600) 또는 LFGB 표기 + 판매처 적합성 자료 확인. 내경5/외경7(펌프 출수구 외경 7.5에 꽉 끼는 규격). 디바이스마트 미취급 → 국내 쇼핑몰·실험용품점에서 찾기 · 가격 확인 필요
2 | P66 | 식품용 실리콘 튜브 내경4/외경6mm (FDA 또는 LFGB 표기), 1m 단위 |  |  | 1 |  |  | 시음 전 교체용 | P30(내경4) 대체: 체크밸브 입구 슬리브 3cm + 밸브 → 노즐 15cm, 펌프당 18cm × 4 | FDA 또는 LFGB 표기. 내경4/외경6(외경 6이 내경5 튜브 안에 꽉 끼어야 겹침 이음 가능). 디바이스마트 미취급 · 가격 확인 필요
3 | P67 | 식품용 체크밸브 — 액체용, 내경4 튜브용 바브 (P31과 같은 규격) |  |  | 5 |  |  | 시음 전 교체용 | P31(공기용·재질 미표기) 대체: 4개 + 예비 1. 바꾼 뒤 STEP8 누수·역류 테스트와 STEP11 캘리브레이션 다시 | 식품 접촉 재질 표기(예: PP 몸통 + 실리콘 덕빌), 액체용, 바브가 내경4 튜브에 맞음(P31: Ø3.2~5.0), 개방압 약 2kPa 이하·유로 Ø2mm 이상 권장(작으면 유량 감소). 디바이스마트 미취급 · 가격 확인 필요
4 | P68 | 둥근머리 십자볼트 머신스크류 M3×15 (철, 노란색) | 34252 | 상품 페이지 (https://www.devicemart.co.kr/goods/view?no=34252) | 10 | 11 | 110 | 조립 방식 선택 | 전장 박스를 볼트로 고정할 때만(기본은 벨크로 P64): 뒤쪽 두 모서리에 2개 사용, 최소주문 10개. 너트는 P38 | M3×10(P37)은 박스 바닥 + 선반 D 5mm + 너트에 짧을 수 있음. 스텐을 원하면 M3×16(10912300, 33원, 최소 5개). 고르면 디바이스마트 주문에 함께 넣고 D 선반·박스 바닥 Ø3.5 ×2를 조립 전에 뚫기
5 | P69 | 자석 캐치 추가분 — 상판 C 고정 대안 (P45와 같은 제품) |  |  | 4 |  |  | 조립 방식 선택 | 상판 C를 볼트(캡티브 너트) 대신 자석으로 고정할 때만: 2~4개(4 기준). 뒤 덮개 H용 P45 2개와 별도 | P45와 같은 제품(다이소/철물점). 볼트 방식이면 불필요 · 가격 확인 필요
 |  | 소계: 시음 전 교체용 (가격 확인 필요 품목 제외) |  |  |  |  | 0 |  |  | 3품목 가격 확인 필요
 |  | 소계: 조립 방식 선택 (가격 확인 필요 품목 제외) |  |  |  |  | 110 |  |  | 1품목 가격 확인 필요
 |  | 합계 (선택 구매, 가격 확인 필요 품목 제외) |  |  |  |  | 110

Sheet: 예산
예산 — 1학기 집행 · 2학기 추가 구매 예상 · 재원 대비
작성 2026-11-06 (SPEC v2.1 · 경진대회 예선 탈락 반영). 1학기 금액은 결과보고서 실습비 정산서(VAT 별도 단가 기준). 2학기 구매 예상은 VAT 포함(보수적). 교내 경진대회는 예선 탈락 → 일정 압박 없음, 목표는 기말 시연·졸업작품·졸업논문·특허. 예선 참가 지원금은 '2026 캡스톤경진대회 예선 오리엔테이션'(학사지원과) 자료 기준. 노란 칸(확인 필요)은 확인 후 직접 고치세요.
A. 1학기(캡스톤디자인Ⅰ) 실습비 집행 — 결과보고서 정산서 기준
항목 | 금액(원) |  |  | 비고
지원 금액 | 200000 |  |  | 캡스톤디자인Ⅰ 실습비
5/5 물품구매의뢰서 | 109200 |  |  | ESP32×2·릴레이×2·펌프×4·솔레노이드×4·튜브(내경4)×5·브레드보드×2·점퍼·DC부품·어댑터. 의뢰서 합계 108,000원과 1,200원 차이 = 브레드보드 품절 대체품(VLT-BB016 2,000원×2) 구매로 추정
5/29 물품구매의뢰서(추가분) | 52200 |  |  | 솔더 슬리브·AWG20 전선·1N4007·체크밸브×4·튜브(내경5)×8
집행액 합계 | 161400 |  |  | 정산서 실제 집행액 161,400원과 일치해야 함
집행 잔액 | 38600 |  |  | 정산서 집행 잔액 38,600원. 2학기 이월 여부 확인 필요(아래 C에서 사용)
B. 2학기 추가 구매 예상 (이번 BOM)
항목 | VAT 포함(원) | VAT 별도(원) |  | 비고
① 디바이스마트 필수·예비 부품 (29품목) | 79658 | 72418 |  | 무료배송 기준 66,000원(VAT 포함) 충족. 고장 대비 권장 예비(P09 펌프×2·P31 체크밸브×1) 12,430원, 전장 박스 고정 벨크로(P64) 1,540원 포함. 이 중 16,474원은 단가 재확인 필요 품목
② 다이소·철물점·재단 (6품목) |  |  |  | 가격 확인 필요 — 용기 4·드립 트레이·포맥스 5T(3장 또는 맞춤 재단)·L자 꺾쇠 12·그로밋 3·자석 캐치 2
필수 추가 구매 합계 (②는 가격 확인 후 반영) | 79658 | 72418 |  | ② 가격이 정해지면 위 칸에 입력
③ 선택 업그레이드 (선택_업그레이드 시트) | 211090 |  |  | 로드셀+HX711·연동펌프×4·MOSFET 보드 등. 5V 10A SMPS 가격 미포함. 기본 동작 확인 후 1순위부터 검토
④ 선택: 시음 전 교체용 (식품용 튜브·체크밸브, 선택_업그레이드 시트 아래 표) | 0 |  |  | 팀원 시음(조립가이드 1.3 조건)을 할 때만 구매. 가격 확인 필요(P65·P66·P67) — 아래 표 단가 칸에 입력하면 이 칸과 시나리오가 자동으로 바뀜. 펌프(P09) 재질 확인 또는 연동 펌프(P55) 교체도 필요
⑤ 선택: 조립 방식 선택 (M3×15 볼트·자석 캐치 추가) | 110 |  |  | 기본(벨크로 P64·상판 캡티브 너트)이면 0원. 전장 박스 볼트 고정 = P68 110원(최소 10개), 상판 자석 고정 = P69(가격 확인 필요). 시나리오에는 넣지 않음(금액이 작음)
C. 재원 대비 — 2학기 부품비로 쓸 수 있는 돈 (모두 확인 필요, VAT 포함 금액과 비교)
재원 | 금액(원) | 상태 |  | 비고
1학기 실습비 잔액 (2학기로 이월될 때만) | 38600 | 이월 여부 확인 필요 |  | 위 A의 집행 잔액(38,600원). 2학기로 넘어오지 않으면 이 칸을 0으로 바꾸세요.
경진대회 예선 참가 지원금 (팀당) | 50000 | 수령 여부·사용 기한 확인 필요 |  | 교내 경진대회는 예선 탈락(본선 지원금 없음). 예선 참가 지원금을 받았는지, 재료비로 언제까지 쓸 수 있는지 학사지원과에 확인. 사용처 예: 식사비(1회 1인 15,000원)·다과비(1회 1인 5,000원)·재료비. 못 쓰면 0으로 바꾸세요.
캡스톤디자인Ⅱ 실습비 (2학기) |  | 금액 확인 필요 |  | 1학기(캡스톤디자인Ⅰ)는 200,000원이었음. 금액을 알면 B칸에 입력 → 아래 시나리오가 자동으로 다시 계산됩니다.
재원 합계 (입력된 금액만) | 88600 | 실습비 미입력 |  | 확인 전 금액이 섞여 있습니다. 실제로 쓸 수 있는 돈인지 확인한 뒤 판단하세요.
지출 시나리오 | 지출 예상(원) | 예선 지원금만 쓸 때 남는 돈 | 재원 합계로 쓸 때 남는 돈 | 판단 (음수 = 부족)
시나리오 1: 필수 구매만 (① 디바이스마트, 권장 예비 포함) | 79658 | -29658 | 8942 | 예선 지원금만으로는 부족, 재원 합계로는 가능 (② 다이소·재단 비용 미포함)
시나리오 2: 필수 + 선택 업그레이드 (① + ③) | 290748 | -240748 | -202148 | 재원 합계 초과 → 실습비 확인 후 1순위(로드셀)부터 단계적으로 (②·5V 10A SMPS 미포함)
(참고) 필수 + 1순위 업그레이드만 (① + 로드셀·HX711) | 88788 | -38788 | -188 | 재원 합계 초과 (② 미포함)
(시음할 때) 필수 + 시음 전 교체용 (① + ④) | 79658 | -29658 | 8942 | 재원 합계 안에서 가능 (② 미포함, ④ 가격 미확인 3품목 미포함)
D. 분류별 추가 구매 소계 (VAT 포함, BOM_전체 연동)
분류 | 추가구매금액(원) | 추가구매 품목 수 |  | 비고
제어 | 17392 | 6
구동 | 6380 | 1
전원 | 4004 | 6
배선 | 20370 | 6
배관 | 6050 | 3 |  | 가격 미확인 2품목 미포함
외형 | 25462 | 13 |  | 가격 미확인 4품목 미포함
공구 | 0 | 0
선택 | 0 | 0
미사용 | 0 | 0
합계 | 79658 | 35
