paperji/smart-bartender/hardware/3dprint/stl/04_grommet_20.stl

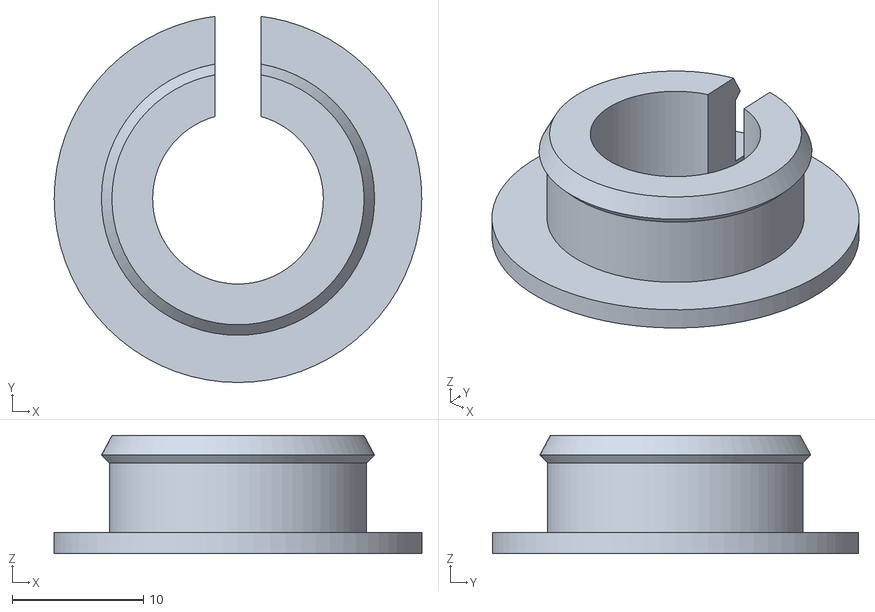
[picture p2: CAD file, 2026-11-09]
hardware/3dprint/stl/04_grommet_20.stl
28.0 x 27.9 x 9.00
