paperji/smart-bartender/hardware/3dprint/stl_plates/plate_B_others_x10.stl

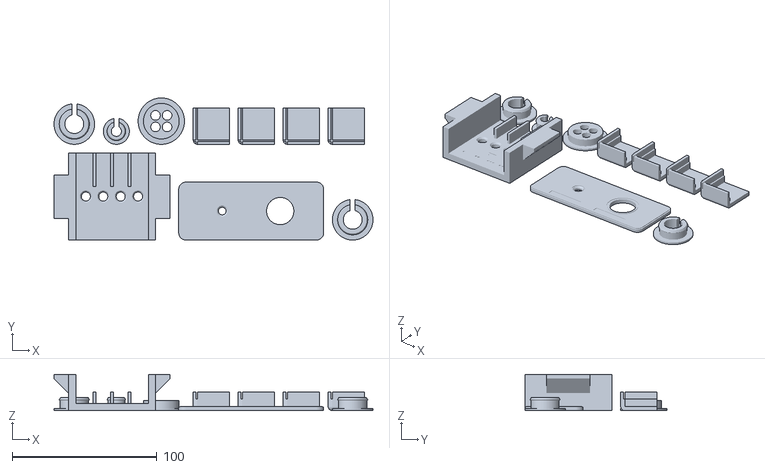
[picture p3: CAD file, 2026-11-09]
hardware/3dprint/stl_plates/plate_B_others_x10.stl
220.0 x 98.0 x 25.0
