paperji/smart-bartender/hardware/3dprint/stl/06_lid_corner_cap.stl

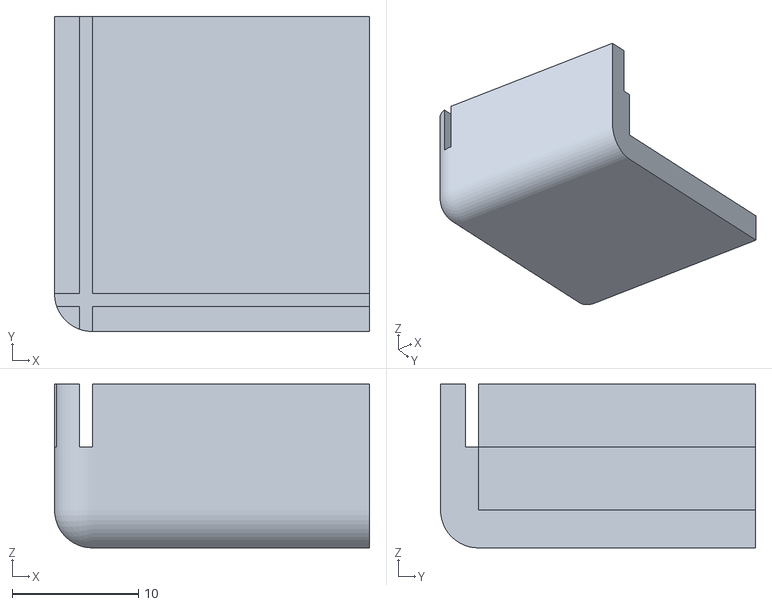
[picture p4: CAD file, 2026-11-09]
hardware/3dprint/stl/06_lid_corner_cap.stl
25.0 x 25.0 x 13.0
