paperji/smart-bartender/hardware/3dprint/stl_plates/plate_A_brackets_x14.stl

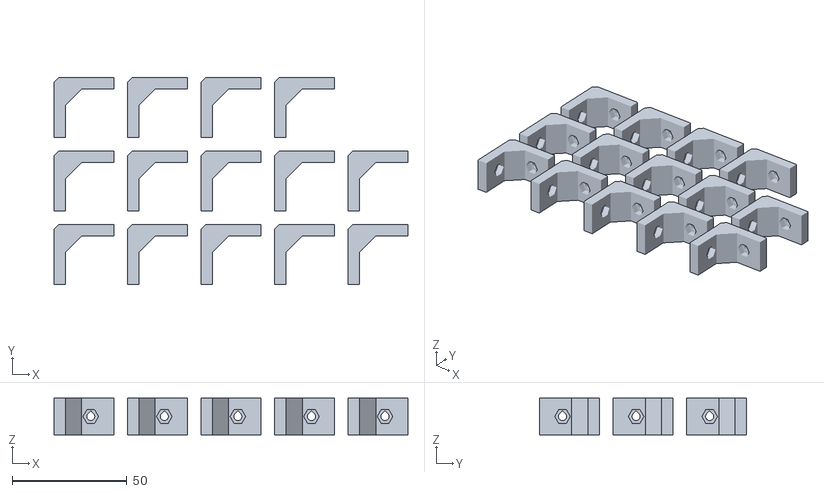
[picture p5: CAD file, 2026-11-09]
hardware/3dprint/stl_plates/plate_A_brackets_x14.stl
154.0 x 90.0 x 16.0
