paperji/smart-bartender/hardware/3dprint/stl/01_corner_bracket.stl

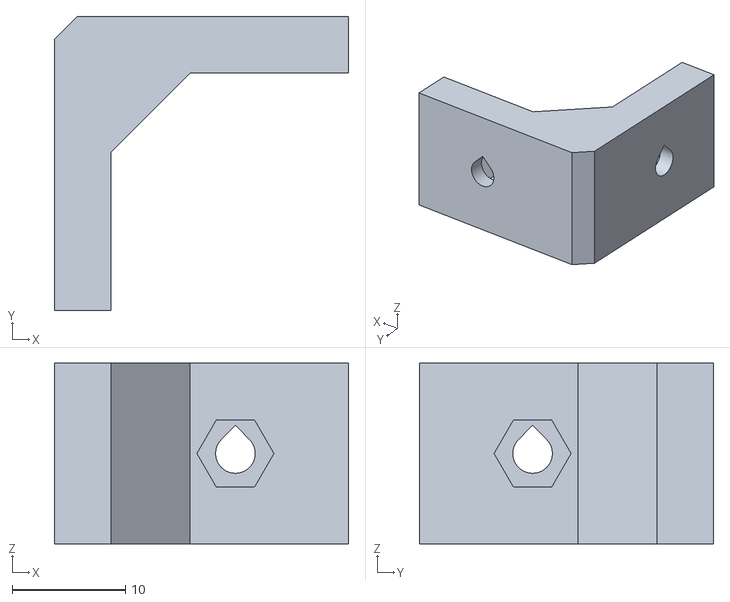
[picture p6: CAD file, 2026-11-09]
hardware/3dprint/stl/01_corner_bracket.stl
26.0 x 26.0 x 16.0
