paperji/smart-bartender/hardware/3dprint/stl/05_grommet_12.stl

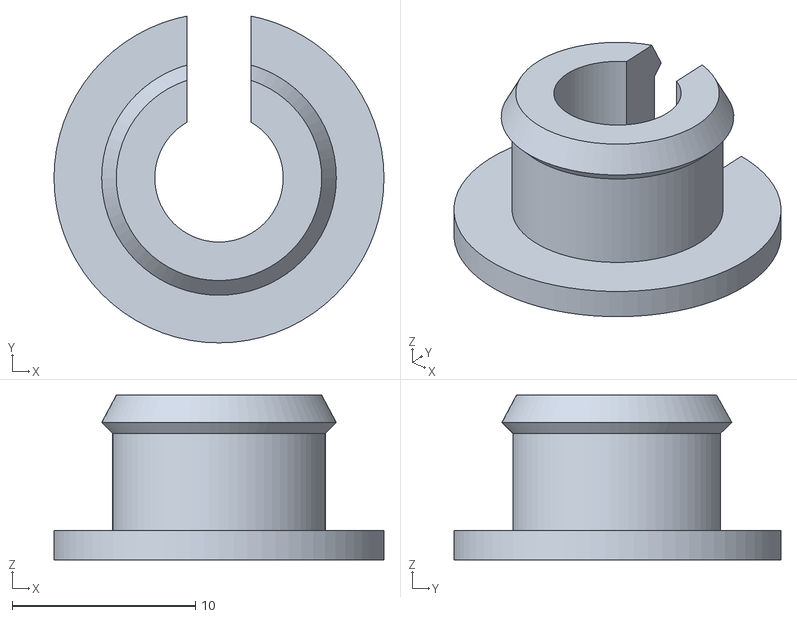
[picture p7: CAD file, 2026-11-09]
hardware/3dprint/stl/05_grommet_12.stl
18.0 x 17.8 x 9.00
