paperji/smart-bartender/hardware/3dprint/stl/03_front_bezel.stl

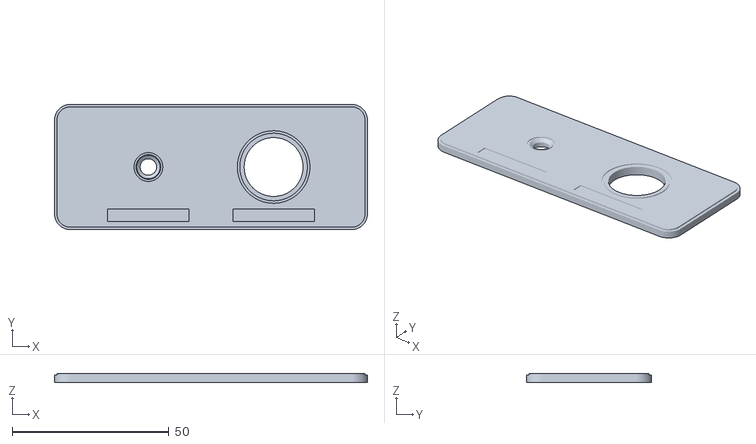
[picture p8: CAD file, 2026-11-09]
hardware/3dprint/stl/03_front_bezel.stl
100.0 x 40.0 x 3.00
