paperji/smart-bartender/hardware/3dprint/stl/02_nozzle_block.stl

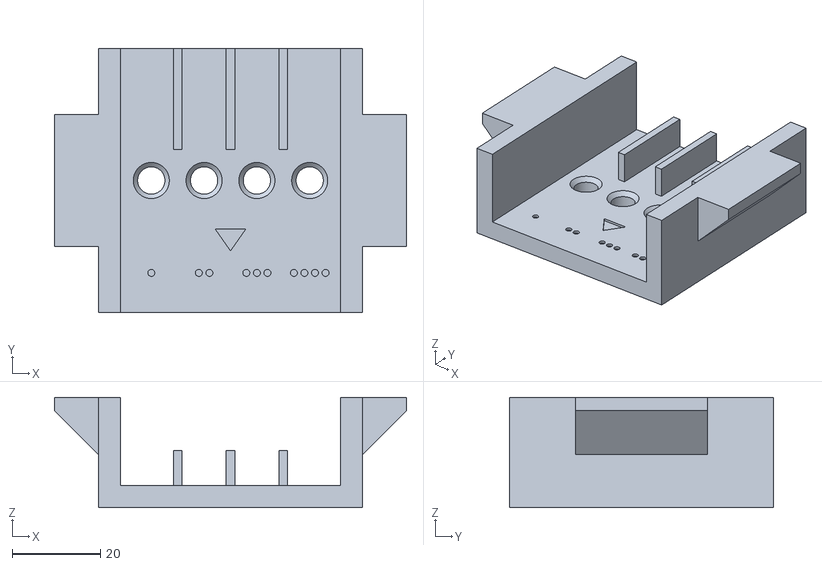
[picture p9: CAD file, 2026-11-09]
hardware/3dprint/stl/02_nozzle_block.stl
80.0 x 60.0 x 25.0
