paperji/smart-bartender/hardware/3dprint/stl/07_divider_bushing.stl

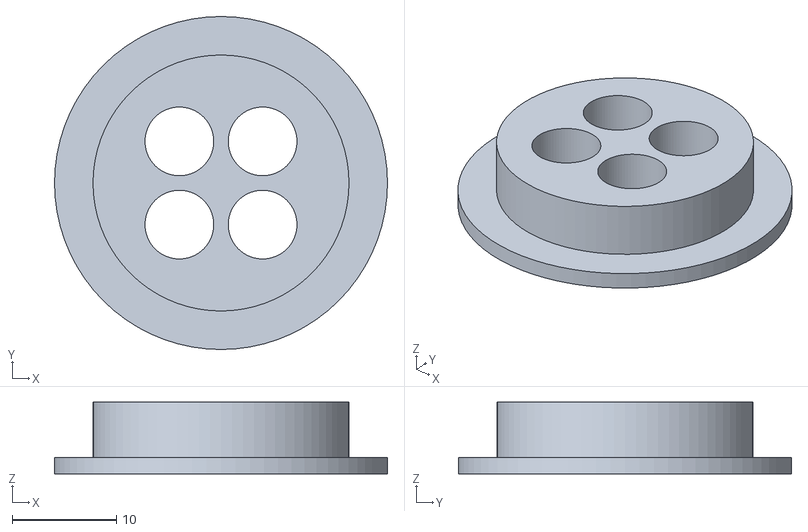
[picture p10: CAD file, 2026-11-09]
hardware/3dprint/stl/07_divider_bushing.stl
32.0 x 32.0 x 6.90
