paperji/smart-bartender/hardware/guide/제작가이드_납땜기준.md

# 초보자용 제작가이드 (납땜 기준) — 사용자의 감정 및 취향 분석 기반 AI 맞춤형 음료 및 칵테일 배합 메이커

> 팀 **홍당무** · 안양대학교 정보전기전자공학과 캡스톤디자인Ⅱ (2026/2학기) · 작성 2026-11-10 · 2026-11-11 부품 구매 반영 · 최신화 BOM·970ml 용기·3D 프린팅 부품 반영
> 목표: 2학기 **졸업작품 시제품** · **기말 시연(발표)** · 졸업논문·특허용 실험 데이터 · 앱 화면 이름: "AI 스마트 바텐더" · 하드웨어 v2
>
> **이 가이드는 납땜 기준입니다.** 원래 설계 그대로 **인두기로 납땜**합니다. 집에 납땜 도구가 없으므로 **납땜과 드릴 작업은 학교 실습실에서 두 번에 몰아서** 합니다([2.5](#s2-5)). 집에서만 만들고 싶으면 [무납땜 기준 제작가이드](제작가이드_무납땜기준.md)를 보세요.
>
> **기준 문서** (이 가이드와 숫자가 다르면 아래 문서가 우선입니다)
> - 부품 목록(BOM): [`../BOM_납땜기준.md`](../BOM_납땜기준.md) · `../BOM_납땜기준.xlsx` (부품 번호 **P01~P72 · P80**, 2026-11-11) · 두 기준 비교 통합판 `../BOM.xlsx`
> - 시스템 명세: `../../docs/SPEC.md` (v3.0 — 핀맵 · BLE 프로토콜은 v2.1 그대로 · 앱 동작)
> - 회로도·실물 배선도: `../circuit/회로도.html` (`../circuit/schematic.svg`, `../circuit/wiring.svg`) — 전기 회로는 두 기준이 같습니다.
> - 3D 프린팅 부품(출력 부품 01~07): `../3dprint/` (STL·모델 코드·출력 조건) — [부록 D](#appD)
> - 펌웨어 설명서: `../../firmware/README.md`, 앱 설명서: `../../app/README.md`
> - 앱 받기(v3.1): 웹앱 [https://paperji.github.io/smart-bartender/](https://paperji.github.io/smart-bartender/) (Chrome·Edge) · 안드로이드 APK / Windows EXE [https://github.com/paperji/smart-bartender/releases/latest](https://github.com/paperji/smart-bartender/releases/latest)
> - 예전 판: [`조립가이드.md`](조립가이드.md) (2026-11-06 — 3D 출력 부품이 없을 때의 대안 방법까지 들어 있음)

## 처음이라면 — 이것만 기억하세요 {#first}

1. **배선을 만지기 전에는 항상 어댑터를 콘센트에서 뽑습니다.** 스위치만 끄면 안쪽 단자(J1)에는 아직 전기가 있습니다.
2. **한 STEP의 확인 포인트(✔)를 모두 통과해야** 다음 STEP으로 넘어갑니다. 문제는 일찍 찾을수록 고치기 쉽습니다.
3. **방향(+/−)이 있는 부품은 4가지**뿐입니다: 다이오드(띠 쪽), 커패시터(띠 쪽이 −), LED(긴 다리가 +), DC 단자 J1. 꽂기 전에 [그림 6](#step1)과 비교합니다.
4. **펌프는 물 없이 돌리지 않습니다.** 공회전하면 망가집니다.
5. **선을 자르면 바로 양 끝에 번호 테이프**(①~㊱)를 붙입니다. 같은 색 선이 많아 번호가 유일한 구분 방법입니다.
6. **이 기기에서 나온 액체는 아무도 마시지 않습니다**(펌프·튜브가 식품용이 아님 — [1.3](#food)). 시연은 색 물로 합니다.
7. 막히면 멈추고 [4장 문제 해결 표](#s4)를 봅니다. 모르는 낱말은 [부록 E 용어 사전](#appE)에서 찾고, 손기술은 [2.6](#skills)에서 먼저 연습합니다.

### 지금까지 준비된 것 (2026-11-11 기준) {#status}

| 항목 | 상태 | 할 일 |
|---|---|---|
| 3D 프린팅 출력 부품 7종 24개 (P70) | 주문 완료(결제 78,700원), **11/16 도착 예정** | 받은 날 [부록 D](#appD) '받은 뒤 확인' 표대로 검사 |
| 포맥스 5T 흰색 3장 (P34) | 구매 완료 | 600×900 통판인지, 재단된 판인지 확인 → 통판이면 STEP9에서 직접 재단 |
| 용기 (P32) | **다이소 직사각 저장 용기 970ml 5개 구매 완료(11-11)** (처음 산 TARK 1L은 폭 120mm라 본체에 안 들어가 취소·환불) | 4개가 같은 제품인지 · 펌프가 들어가 눕는지 · 리드 길이 확인 — [2.4](#s2-4) |
| 디바이스마트 추가 부품 | **무납땜 기준 35품목 주문 완료(11-11)** — 결제 102,528원(배송비 3,000원 포함), 배송 대기 | 받으면 [STEP1](#step1) 검수 — 거래명세서와 수량 대조(볼트·너트는 25개씩). 이 납땜 기준으로 만들려면 납땜 전용 3품목(P13·P14·P26, 5,203원 + 배송비 약 2,700원)을 더 주문 — BOM 엑셀 `주문_링크` 시트 |
| 다이소 물건 (코스터 P33 · 자석 P45 · 철판 P80 · 폼 테이프 P71 · 절연테이프 P79) | 구매 완료(11-11, 결제 14,000원 — 배송비 3,000원 포함) | 영수증 보관(정산) |
| 학교 실습실 공구 | 빌릴 수 있는지 아직 모름 | 인두기·열풍기·드릴·스텝드릴·글루건 대여 문의 — [2.2](#s2-2) |

## 이 가이드 읽는 법 {#howto}

- 부품 이름 뒤의 **P번호**(예: 수중펌프 P09)는 BOM 번호와 같습니다. 부품 상자에도 P번호를 적어 두면 찾기 쉽습니다.
- 전선 번호 **①~㊱**은 회로도 산출물 `../circuit/회로도.html`의 "③ 연결표"와 `../circuit/wiring.svg`(배선도)의 동그라미 번호와 **같습니다**. [STEP5 연결표](#wiring-table)에 같은 번호로 옮겨 적었습니다. 전선 양 끝에 마스킹테이프로 번호를 붙이세요.
- 회로 기호(U1, K1~K4 = 릴레이 채널 1~4, M1~M4, D1~D4, J1, SW1, SW2, F1, TB1(+5V)·TB2(GND)·TB3(3V3), C1, R1, LED1, BZ1)는 회로도와 같습니다.
  단, **"M1"은 회로도에서는 펌프 1**입니다. 이 가이드에서는 펌프를 "펌프 1~4"라고 적습니다.
- 각 STEP은 **목표 → 어디서·난이도 → 준비물 → 소요 시간 → 그림 → 절차 → 확인 포인트(✔) → 흔한 실수(⚠)** 순서입니다.
  - **어디서**: "집" 또는 "학교 실습실"(공구를 빌려야 하는 작업). **난이도**: ★☆☆ 쉬움 · ★★☆ 보통 · ★★★ 꼼꼼함이 필요함.
  - 절차 속 *"왜?"* 는 그렇게 하는 이유입니다. 이유를 알면 실수가 줄어듭니다.
- **출력 부품 01~07**은 3D 프린팅 업체에 주문해 받는 부품입니다([부록 D](#appD)). 이 가이드는 **출력 부품을 쓰는 방법만** 설명합니다. 출력 부품이 깨지거나 맞지 않을 때의 대안은 부록 D 끝에 모았습니다.
- `□` 체크박스는 인쇄해서 펜으로 표시하며 진행하세요. (인쇄용: `제작가이드_납땜기준.html` → Ctrl+P → A4. 화면에서 누른 체크는 그 브라우저에 저장됩니다.)
- 좌표는 **x = 왼쪽→오른쪽(앞에서 볼 때), y = 앞→뒤, z = 바닥판 윗면에서 잰 높이**, 단위는 mm입니다.
- "추정"이라고 쓴 숫자는 계산이나 자료로 짐작한 값이라 **직접 재서 확인**해야 합니다.

## 목차 {#toc}

- [처음이라면 — 이것만 기억하세요](#first)
- [0. 완성 사양 · 동작 개요](#s0)
- [1. 안전 수칙](#s1)
- [2. 준비물 · 일정 · 기본 손기술](#s2)
- [3. 단계별 제작](#s3)
  - [STEP 1. 부품 검수 · 멀티미터 기초](#step1)
  - [STEP 2. 브레드보드 단위 테스트](#step2)
  - [STEP 3. 펌프 모듈 만들기 (뚜껑 · 연장선 · 납땜 · 열수축 · 다이오드)](#step3)
  - [STEP 4. 전원부 (DC 단자 · 스위치 · 퓨즈 · 분배 커넥터 · 커패시터)](#step4)
  - [STEP 5. ESP32 · 릴레이 영구 배선 (연결표)](#step5)
  - [STEP 6. 전원 넣기 전 점검 · 첫 전원 투입](#step6)
  - [STEP 7. 펌웨어 업로드 · 앱 블루투스 연결](#step7)
  - [STEP 8. 배관 (튜브 · 체크밸브 · 누수 테스트)](#step8)
  - [STEP 9. 외형 제작 (재단 · 구멍 · 앞판 · 조립 · 방수)](#step9)
  - [STEP 10. 최종 조립 · 배선 정리](#step10)
  - [STEP 11. 캘리브레이션 (유량 맞추기)](#step11)
  - [STEP 12. 시운전 · 세척 · 보관](#step12)
- [4. 문제 해결 표](#s4)
- [5. 시연(발표) 체크리스트](#s5)
- [6. 개선 아이디어](#s6)
- [부록 A. 핀맵 요약](#appA) · [부록 B. 재단표](#appB) · [부록 C. 캘리브레이션 기록표](#appC) · [부록 D. 3D 프린팅 부품](#appD) · [부록 E. 용어 사전](#appE)

<!-- pagebreak -->

## 0. 완성 사양 · 동작 개요 {#s0}

### 0.1 완성 사양

| 항목 | 내용 |
|---|---|
| 외형 | 폭 420 × 깊이 260 × 높이 380 mm (고무발 10mm 별도), 흰색 포맥스 5T + 3D 프린팅 부품 7종(모서리 브래킷·노즐 블록·앞면 베젤·그로밋 2종(Ø20용·Ø12용)·상판 모서리 캡·튜브 부싱, PETG, [부록 D](#appD)) |
| 구조 | 위: 전장부(전자 부품 박스) / 아래 뒤: 용기 칸(용기 4개) / 아래 앞 가운데: 잔 칸 |
| 재료 수 | 4가지 (펌프 1~4). 두 번째 릴레이(P08 예비)를 달면 8가지까지 확장 가능 (펌웨어 `PUMP_COUNT`) |
| 용기 | **다이소 직사각 저장 용기 970ml**(품번 1069852) 4개 — 약 앞뒤 105 × 좌우 80 × 높이 150 mm(뚜껑 포함), 몸체 PET(60℃까지)·돌려 닫는 PP 뚜껑. 칸 하나에 들어가는 한계는 좌우 ≤ 95, 앞뒤 ≤ 135, 높이 ≤ 170 mm |
| 노즐 높이 | 튜브 끝 z 220 mm (출력 노즐 블록 02 아랫면 z 230에서 튜브를 10mm 내림). 설계상 최대 액면 z 160보다 60mm 높음(970ml 용기는 높이 150이라 실제 액면은 이보다 낮음) → 잔 높이 약 190mm까지 |
| 제조량 | 한 잔 30~500 ml (재료 1개 최대 300 ml, 펌프 1개 최대 120초) — SPEC §2.3 |
| 유량 | 약 3~6 ml/초 (체크밸브 포함, **추정**). 캘리브레이션으로 펌프마다 실제 값 저장 |
| 한 잔(200 ml) 시간 | 약 35~65초 (추정) |
| 전원 | DC 5V 4A 어댑터(P11) → 로커 스위치 SW1(P13) → 3A 퓨즈 F1(패널형 홀더 P14) → 분배 커넥터 TB1(+5V)·TB2(GND)·TB3(3V3) |
| 제어 | ESP32 DevKitC(P01) + 4채널 릴레이(P08), 펌웨어 v2.1.2 |
| 선 잇는 방법 | 인두 납땜 약 20~23곳 + 솔더 슬리브 8곳 + 수축튜브(학교 실습실) |
| 통신 | 블루투스 저전력(BLE, Nordic UART). 공유기·IP 주소 필요 없음 |
| 조작 | 스마트폰 앱 + 기기 앞면 시작/정지 버튼(비상정지) + 상태 LED + 부저 |

### 0.2 동작 순서 (한 잔이 만들어지기까지)

1. 사용자가 앱에 기분·맛·도수·날씨·상황·성향과 잔 용량을 입력합니다.
2. 앱이 **기기에 장착된 재료 목록**(펌프 1~4의 이름·종류·도수·잔량)과 함께 사용자가 고른 AI(Gemini 등 8곳 중 하나)에 보냅니다. 이때 앱 설정에 등록한 **사용자 본인의 AI API 키**를 씁니다(팀 서버 없음).
3. AI가 장착된 재료만으로 레시피(재료별 ml)를 만들어 돌려주면, 앱이 SPEC §3.3 규칙으로 다시 검증·보정합니다. 키가 없거나 AI가 안 되면 앱이 자체 규칙(오프라인 추천)으로 추천합니다.
4. 사용자가 레시피를 확인·조정하고 **제조 시작**을 누르면, 앱이 블루투스로 `{"cmd":"make", ...}` 명령을 보냅니다.
5. ESP32가 `구동 시간 = ml ÷ 유량(ml/초)`을 계산해 릴레이를 켜고 끕니다. 릴레이가 켜진 동안 해당 펌프가 용기 속 액체를 밀어 올립니다.
6. 액체는 튜브 → 체크밸브 → 노즐을 지나 잔으로 떨어집니다. 펌프는 하나씩 차례로(순차 모드) 돌아갑니다.
7. 끝나면 기기가 `done`을 보내고 부저가 "삐-삐" 울립니다. 휴대폰에는 완료 알림과 진동이 옵니다. 앱은 잔량을 줄이고 기록을 남깁니다.
8. 맛 평가(좋아요/별로예요)를 하면 앱이 "한 잔 더 만들까요?"를 묻습니다. [예] → 같은 입력으로 다시 추천, [아니요, 다른 걸 원해요] → 새 재료를 제안하는 **탐색 모드**(SPEC §5).

그림 1. 시스템 구성도

그림 2. 완성 모습

### 0.3 세 구역으로 나누는 이유

- **전장부(선반 위)**: ESP32·릴레이·전원 부품을 닫힌 박스(P35)에 넣고 선반 위에 둡니다. *왜?* 액체는 아래로 흐르므로, 전기 부품을 액체보다 **위**, 그리고 **선반으로 막힌 곳**에 두면 물이 튀거나 새도 닿지 않습니다.
- **용기 칸(아래 뒤)**: 무거운 용기를 바닥에 두어 무게 중심이 낮아집니다(넘어짐 방지). 뒤 덮개(H)를 열고 용기를 뒤로 꺼내 채웁니다.
- **잔 칸(아래 앞 가운데)**: 앞이 열려 있어 잔을 넣고 빼기 쉽고, 드립 트레이(P33)가 떨어지는 방울을 받습니다.
- **노즐은 용기 액면보다 높게**: 노즐이 액면보다 낮으면 펌프가 꺼져도 빨대 원리(사이펀)로 액체가 계속 흘러나옵니다. 이 기기는 노즐 튜브 끝(z 220)이 최대 액면(z 160)보다 60mm 높습니다.

그림 3. 외형 3면도 (단위 mm)

그림 4. 내부 배치도

> 그림 2~4는 예전 설계(포맥스 노즐 판 M1+M2, 노즐 출구 z 230, 잔 약 200mm)로 그린 그림입니다. 지금은 **출력 노즐 블록 02**를 쓰므로 블록 아랫면이 z 230이고 **튜브 끝이 z 220**(최대 액면 z 160보다 60mm 높음), **잔은 높이 약 190mm까지**입니다([0.1](#s0)). 그림의 용기 크기도 예시이며, 실제는 970ml 용기(좌우 80 × 앞뒤 105 × 높이 150mm)를 좁은 쪽이 좌우로 가게 넣습니다.

### 0.4 전기 연결 요약 (SPEC §1)

| 기능 | ESP32 핀 | 연결 대상 |
|---|---|---|
| 펌프 1~4 | GPIO 26 / 27 / 32 / 33 | 릴레이 IN1 / IN2 / IN3 / IN4 (LOW = 켜짐) |
| 시작/정지 버튼 SW2 (P03) | GPIO 4 | 버튼 → GND (내부 풀업) |
| 상태 LED1 (P05) + R1 220Ω (P06) — **필수** | GPIO 2 | GPIO2 → R1 → LED 긴 다리(+), 짧은 다리(−) → GND. 보드에 GPIO2 LED가 없어 외부 LED 필수 |
| 부저 BZ1 (P04, 선택) | GPIO 23 | 부저 I/O (**HIGH = 울림**), VCC = 3V3 (TB3) |
| 릴레이 입력측 전원 | 3V3 (TB3) | 릴레이 **입력 헤더**(GND·IN1~4·VCC 줄) 끝의 VCC 핀(옆 점퍼 헤더의 VCC 아님). **A안(기본)**: JD-VCC 점퍼 제거. **B안**(A안으로 안 켜질 때): USB·어댑터를 모두 뺀 뒤 ⑪(3V3)을 **먼저** 뽑고 → ⑨(+5V)를 JD-VCC 핀에서 이 입력 헤더 VCC 핀으로 옮기고 → 점퍼 캡을 끼워 VCC = JD-VCC = 5V(점퍼 헤더가 2핀이라 JD-VCC 핀에는 캡만) — **B안에서 VCC를 3V3에 연결 금지** |
| 릴레이 코일 전원 | 5V 레일 (TB1) | 릴레이 JD-VCC 핀 (B안: 입력 헤더 VCC 핀 → 점퍼 캡 → JD-VCC) |
| ESP32 전원 | 5V 레일(TB1) → **5V 핀** | USB를 꽂을 때는 이 선(⑧)을 뺌 |
| 공통 GND (별형 접지) | GND | J1 − 나사에서 두 갈래로 나눔: ⑤ → TB2(펌프 −), ⑦ → ESP32 GND(ESP32·릴레이). 전기적으로는 모두 공통 |
| 전원 경로 | — | 어댑터 → J1 → SW1(스위치) → F1(3A 퓨즈) → TB1(+5V 분배). TB2 = GND 분배, TB3 = 3V3 분배 |

> 참고: 회로도 전체는 `../circuit/회로도.html`을 함께 인쇄해서 옆에 두고 보세요. 이 가이드는 **배선 순서**와 **만드는 방법**을 설명하고, 전기적 연결은 회로도와 SPEC 핀맵을 그대로 따릅니다.

<!-- pagebreak -->

## 1. 안전 수칙 {#s1}

### 1.1 전기

- [ ] **배선을 바꾸거나 손댈 때는 항상 어댑터를 콘센트에서 뽑습니다.** 스위치(SW1)만 끄는 것으로는 J1 단자까지 전기가 살아 있습니다.
- [ ] 5V는 감전 위험은 거의 없지만, **+와 −가 직접 닿으면(단락)** 수 A가 흘러 전선이 뜨거워지고 피복이 녹을 수 있습니다. 단락이 나면 **먼저 어댑터(P11)의 내장 보호가 출력을 끊고**(꺼졌다 켜졌다 반복), 3A 퓨즈(F1)는 어댑터 보호가 고장 났거나 더 센 어댑터를 쓸 때를 위한 **백업 보호**입니다. 5V 4A 어댑터로는 단락이 나도 퓨즈가 끊어지지 않을 수 있으므로 **"퓨즈가 멀쩡하다 = 배선이 맞다"가 아닙니다.** 퓨즈를 더 큰 값이나 철사로 바꾸지 마세요.
- [ ] **USB와 어댑터 5V를 동시에 ESP32에 넣지 않습니다(이중 전원 금지).** USB를 꽂기 전에 ⑧(TB1 → ESP32 5V 선)을 뽑고, **뽑은 끝은 테이프로 감쌉니다**(STEP7). PC USB 포트나 보드가 상할 수 있습니다.
- [ ] 극성(+/−)이 있는 부품(다이오드·커패시터·LED·DC 단자)은 그림 6과 비교해 확인한 뒤 연결합니다.
- [ ] **벤치 테스트(STEP2)에는 아직 퓨즈(F1)가 없습니다.** 어댑터를 꽂기 전에 멀티미터로 +5V 레일–GND 레일이 단락(0Ω, 계속 "삐")이 아닌지 보고, 냄새·열이 나면 바로 어댑터를 뽑습니다.
- [ ] 젖은 손으로 전원부를 만지지 않습니다. 액체를 쏟으면 먼저 어댑터를 뽑고 닦습니다.
- [ ] 어댑터(P11)의 콘센트 쪽(220V)은 절대 분해하지 않습니다.

### 1.2 공구

- [ ] **인두(약 350℃), 열풍기(250~300℃), 글루건**은 화상 위험이 큽니다. 인두는 항상 스탠드에 두고, 열풍기 노즐은 사용 후 5분간 만지지 않습니다.
- [ ] 납땜 연기는 들이마시지 않게 창문을 열거나 선풍기로 옆으로 날립니다. 납땜 후 손을 씻습니다. 학교 실습실의 사용 규칙(환기·보호구·뒷정리)을 따릅니다.
- [ ] 드릴·스텝드릴을 쓸 때는 판을 클램프로 고정하고 보안경을 씁니다. **회전 공구를 쓸 때는 장갑을 끼지 않습니다**(장갑이 말려 들어갈 수 있음).
- [ ] 커터칼은 쇠자를 대고 몸 바깥쪽으로 긋습니다. 커팅매트 위에서 작업합니다.

### 1.3 식품 위생 — 지금 부품으로는 아무도 마시지 않습니다 {#food}

- [ ] 이 기기의 **펌프(P09)·실리콘 튜브(P29·P30)·체크밸브(P31)는 "식품 등급" 표기가 없습니다**(체크밸브는 판매처 설명상 "공기용"이고, 펌프 본체·덕빌 밸브 고무·윤활제 재질도 확인되지 않았습니다). 식품에 닿아도 안전한지는 **알코올이 있든 없든 똑같은 문제**입니다. 그래서
  - 튜브(P29·P30)와 체크밸브(P31)를 **식품용 표기(FDA·LFGB 등)가 있는 부품**(선택 품목 **P65·P66·P67**, BOM 3장 '선택' 분류 — 가격 확인 필요)으로 바꾸고 펌프 재질을 확인하기 전까지는(또는 연동 펌프 P55로 바꾸기 전까지는) **기기에서 나온 액체를 아무도 마시지 않습니다.** 관람객에게도 주지 않습니다.
  - 기말 시연·졸업작품 전시의 시연은 **물이나 식용색소를 탄 물(색 물)을 컵에 따르는 것까지**만 합니다. 색 물을 쓰면 레시피별 비율 차이가 눈에 보여 시연 효과도 좋습니다.
  - 이와 별개로 학교 시연·전시에서는 **주류를 쓰지 않습니다**(학교 규정, 펌프·튜브의 알코올 내성 미확인 — 1.4).
  - 처음 쓰기 전과 매번 쓴 뒤에 **세척**합니다(STEP12).
- [ ] 시음이 꼭 필요하면(예: 졸업작품 심사): ① 식품용 튜브·체크밸브로 교체 — **P65**(내경5/외경7 튜브 3m, P29 자리)·**P66**(내경4/외경6 튜브 1m, P30 자리)·**P67**(체크밸브 4개 + 예비 1, P31 자리) — + 펌프 재질 확인(또는 P55로 교체) → ② 바꾼 뒤 **STEP8 누수·역류 테스트와 STEP11 캘리브레이션을 다시** → ③ STEP12 세척 → ④ **팀원만** 마십니다. P65·P66·P67은 디바이스마트에 없어 **판매처·가격 확인 필요**(BOM 3장 '선택' 분류)이므로, 시음 계획이 정해지면 일찍 찾아 주문합니다.
- [ ] 용기(P32, 970ml)에는 '식품용 기구' 표시가 있지만 **몸체(PET)는 60℃까지만** 견딥니다(뚜껑 PP는 100℃). 뜨거운 물을 넣거나 식기세척기·전자레인지에 넣지 않고, 솔·연마분으로 문지르지 않습니다(상품 표시사항).
- [ ] 우유·요거트 같은 유제품은 쉽게 상하고 튜브에 남으므로 넣지 않습니다.
- [ ] 설탕이 많은 음료를 넣은 채로 하룻밤 두지 않습니다. 당분이 굳으면 체크밸브가 달라붙어 안 열립니다.
- [ ] **개선안(졸업논문·후속 개선)**: 식품용 표기(FDA·LFGB 등)가 있는 실리콘 튜브와 체크밸브(P65·P66·P67)로 교체, 또는 액체가 튜브에만 닿는 **연동(페리스탈틱) 펌프(P55)** 로 교체 → [6장](#s6).

### 1.4 음주 관련

- [ ] **학교 시연·전시에서는 주류를 쓰지 않습니다**(1.3 — 식품용 부품으로 바꾸기 전에는 어차피 아무도 마시지 않음). 식품용 부품으로 바꾼 뒤 주류를 쓰려면 학교·행사 규정에 주류 반입·시음이 허용되는지 먼저 확인하세요.
- [ ] 주류를 쓸 때는 앱의 **성인 인증(만 19세 이상)** 을 켜 두고, 음주운전 경고를 안내합니다. 미성년자에게 제공하지 않습니다.
- [ ] 알코올(특히 40도 증류주)은 불이 붙는 액체입니다. 인두·열풍기 근처에 두지 않습니다.
- [ ] 펌프 플라스틱이 고도수 알코올에 오래 닿아도 괜찮은지는 확인되지 않았습니다. 주류는 사용할 때만 넣고, 끝나면 바로 물로 세척합니다.

<!-- pagebreak -->

## 2. 준비물 · 일정 · 기본 손기술 {#s2}

### 2.1 부품 (BOM 번호 기준) {#s2-1}

"보유" = 1학기에 이미 산 것, "구매" = 이번 학기에 사는 수량(예비 포함 — 11-11에 산 부품은 실제로 산 수량). 상세 사양·구매처·가격은 [`../BOM_납땜기준.md`](../BOM_납땜기준.md) 3장에 있습니다. **2026-11-11 무납땜 기준의 '구매' 열 부품을 모두 샀습니다**(이 납땜 기준에만 쓰는 P13·P14·P26은 사지 않음) — 물건이 오면 [STEP1](#step1)에서 이 표로 하나씩 확인합니다.

| 확인 | ID | 부품 | 필요 | 보유 | 구매 | 이 가이드에서 쓰는 곳 |
|:-:|---|---|---:|---:|---:|---|
| [ ] | P01 | ESP32 DevKitC WROOM-32D V4 (U1) | 1 | 2 | 0 | STEP2·5 |
| [ ] | P02 | ESP32-DevKitC 터미널 확장보드 Push-in (ElectroCookie) | 1 | 0 | 1 | STEP5 |
| [ ] | P03 | 메탈 푸시 스위치 16mm HX16-B1 (SW2, 시작/정지 버튼) | 1 | 0 | 1 | STEP2·9·10 앞판 |
| [ ] | P04 | 액티브 부저 모듈 ONE005 (BZ1, 선택) | 1 | 0 | 1 | STEP2·9·10 앞판 |
| [ ] | P05 | 5mm LED 빨강 (LED1, **필수**) | 1 | 0 | 2 | STEP2·9 |
| [ ] | P06 | 저항 220Ω (R1) | 1 | 0 | 10 | STEP2·9 |
| [ ] | P07 | Micro USB **데이터** 케이블 | 1 | 0 | 1 | STEP2·7 (있으면 생략) |
| [ ] | P08 | 4채널 5V 릴레이 SZH-RLBG-012 (K1~K4) | 1 | 2 | 0 | STEP2·5 |
| [ ] | P09 | 수중펌프 SZH-GNP155 (펌프 1~4, 본체 약 43×23mm) | 4 | 4 | 2(예비) | STEP2·3·8 |
| [ ] | P10 | 다이오드 1N4007 (D1~D4) | 4 | 10 | 0 | STEP2·3 |
| [ ] | P11 | 어댑터 5V 4A | 1 | 1 | 0 | STEP1·2·4 |
| [ ] | P12 | 터미널블럭 to DC 암 단자 (J1) | 1 | 2 | 0 | STEP1·2·4 |
| [ ] | P13 | 로커 스위치 KCD1-101A (SW1, 단자에 납땜) | 1 | 0 | 1 | STEP4·9·10 |
| [ ] | P14 | 패널형 퓨즈홀더 FH-303 (F1, 단자에 납땜) | 1 | 0 | 1 | STEP4·9·10 |
| [ ] | P15 | 유리관 퓨즈 5×20 3A | 1 | 0 | 3 | STEP4 (2개는 예비) |
| [ ] | P16 | 전해 커패시터 1000µF 16V (C1) | 1 | 0 | 10 | STEP4 |
| [ ] | P17 | 전해 커패시터 100µF 16V (C2, 선택) | 1 | 0 | 10 | STEP5 (선택) |
| [ ] | P18 | 레버형 8구 커넥터 PCT-418 (TB1 +5V · TB2 GND · TB3 3V3) | 3 | 0 | 4 | STEP4·5 |
| [ ] | P19 | AWG20 2심 전선 10m (빨강/검정) | 1 | 1 | 0 | STEP3·4·5 |
| [ ] | P20~P22 | 점퍼 케이블 F/F · M/F · M/M | 각 1 | 각 1 | 0 | STEP2·5·9 |
| [ ] | P23 | 브레드보드 830핀 | 1 | 2 | 0 | STEP2 |
| [ ] | P24 | UL1007 22AWG 전선 10m **노랑** | 1 | 0 | 1 | STEP5·9·10 신호선 ⑩·㉙·㉚·㉝·㉟ (모두 노랑이라 양 끝 번호 테이프로 구분) |
| [ ] | P62 | UL1007 22AWG 전선 10m **검정** | 1 | 0 | 1 | STEP4·5 ⑦(ESP32 GND), STEP9 앞판 GND ㉛·㉜·㉞·㊱ |
| [ ] | P63 | UL1007 22AWG 전선 10m **빨강** | 1 | 0 | 1 | STEP5 ⑧(ESP32 5V) |
| [ ] | P25 | 열수축 솔더 슬리브 1.0SQ | 8 | 10 | 0 | STEP3 펌프 리드 이음 |
| [ ] | P26 | 열수축튜브 세트 | 1 | 0 | 1 | STEP3·4·7·9 |
| [ ] | P27 | 케이블타이 100mm | 1 | 0 | 1 | STEP5·8·10 |
| [ ] | P28 | 케이블타이 접착 마운트 | 10 | 0 | 10 | STEP5·10 |
| [ ] | P29 | 실리콘 튜브 내경5/외경7 (1m) | 3 | 8 | 0 | STEP8 |
| [ ] | P30 | 실리콘 튜브 내경4/외경6 (1m) | 1 | 5 | 0 | STEP8 |
| [ ] | P31 | 체크밸브 JGB32PPS (CV1~CV4) | 4 | 4 | 1(예비) | STEP1·8 |
| [ ] | P32 | **다이소 직사각 저장 용기 970ml** (품번 1069852, 약 105×80×150mm) | 4 | 0 | 5(예비 1) | STEP1·3·8·10 |
| [ ] | P33 | 실리콘 원형 코스터 2개입 (지름 10cm, 다이소 — 드립 매트) | 1 | 0 | 1 | STEP9·10 |
| [ ] | P34 | 포맥스 5T 흰색 600×900 — **구매 완료** | 3 | 3 | 0 | STEP4(뒤판 G)·9 |
| [ ] | P35 | 화신박스 단자함 EG AGH-152010 (150×200×100, 속판 포함 — 전장 박스) | 1 | 0 | 1 | STEP5·10 |
| [ ] | P37·P38 | M3×10 볼트 · M3 너트 (브래킷 12개 × 2쌍 + 예비 1 — 25개씩 삼, 잃어버리지 않게 따로 보관) | 24 · 24 | 0 | 25 · 25 | STEP9·10 |
| [ ] | P39·P40 | M3 서포트 10mm · M3×6 볼트 | 4 · 8 | 0 | 4 · 10 | STEP5 |
| [ ] | P41 | 고무발 18×10 | 4 | 0 | 10 | STEP9 |
| [ ] | P42·P43 | 순간접착제 · 핫멜트(글루건) 스틱 11mm | 1 · 1 | 0 | 1 · 1 | STEP3·9·10 |
| [ ] | P45 | 네오디뮴 자석 13mm 3개입 (다이소, 뒤 덮개 H용 — 2개 사용) | 1팩 | 0 | 1 | STEP9 |
| [ ] | P80 | 자석용 보조 설치판(접착식 철판) 3개입 (다이소, P45와 짝 — 2개 사용) | 1팩 | 0 | 1 | STEP9 |
| [ ] | P64 | 접착식 벨크로(찍찍이) 55×35mm 10쌍 (Coms T9162) | 1팩 | 0 | 1 | STEP10 전장 박스 고정(4쌍 사용) |
| [ ] | P70 | **3D 프린팅 출력 부품 7종 24개** (PETG 흰색) — **주문 완료, 11/16 도착 예정** | 1식 | 0 | 0 | STEP9·10, [부록 D](#appD) |
| [ ] | P71 | 폼 양면테이프 (오공 18mm×2m, 두께 1mm, 다이소) | 1 | 0 | 1 | STEP5·9 (앞면 베젤·부저) |
| [ ] | P65~P69 | (선택) 식품용 튜브·체크밸브 P65~P67 · M3×15 볼트 P68 · 자석·철판 추가분 P69 | 선택 | 0 | 0 | 1.3 · STEP8·9·10 — 아래 메모 |

> **선택 부품 P65~P69**는 구매 수량이 0이고 합계에 들어가지 않습니다(BOM '선택' 분류). 기본 방식(전장 박스 = 벨크로 P64, 상판 C = 캡티브 너트, 시연 = 색 물)이면 하나도 사지 않습니다. 시음을 할 때만 식품용 튜브·체크밸브 P65·P66·P67(디바이스마트에 없어 **판매처·가격 확인 필요**), 전장 박스를 볼트로 고정할 때만 M3×15 볼트 P68(11-11 주문에 넣지 않았으므로 따로 주문 — 너트 P38도 2개 더), 상판을 자석으로 붙일 때만 P69(다이소)를 삽니다.
>
> **3D 출력 부품(P70)**: 이 가이드는 출력 부품을 쓰는 방법만 설명합니다. 그래서 예전 BOM의 L자 꺾쇠(P36)·고무 그로밋(P44)은 사지 않고, 포맥스 노즐 판 M1·M2도 자르지 않습니다. 받은 날 [부록 D](#appD)의 '받은 뒤 확인' 표대로 너트·볼트·튜브·버튼을 끼워 봅니다. *왜?* 안 맞아 다시 출력하면 2~5일이 더 걸립니다.
>
> 쓰지 않는 보유품: **P59 솔레노이드**(설계 변경으로 제외), **P60 솔더 슬리브 6.0SQ**(너무 굵음), **P61 DC 플러그 NT10-AF35**(수 플러그라 불필요).

### 2.2 공구 {#s2-2}

| ID | 공구 | 구하는 방법 | 쓰는 곳 |
|---|---|---|---|
| P48 · P72 | 디지털 멀티미터 M300 + 12V **23A 전지**(멀티미터에 들어 있지 않음) | **구매**(둘 다 11-11 디바이스마트 주문 — 집에서 STEP1부터 계속 씀) | 모든 STEP (도통·전압·다이오드 방향) — 다이오드 모드(▶ 기호)는 받은 날 확인(STEP1 절차 3) |
| P49 | 와이어 스트리퍼 TU-2022 (구멍 0.4~1.3mm) | **구매**(11-11 주문) | 피복 벗기기 — [2.6 가](#skills) |
| P46 · P47 | 인두기 세트 + 실납 1.0mm | 학교 대여 | STEP3·4·9 납땜 (학교 실습실) |
| P52 | 열풍기 | 학교 대여 | STEP3 솔더 슬리브, 수축튜브 (학교 실습실) |
| P53 | 드릴 + 스텝드릴 4~35mm | 학교 대여 | 구멍 약 52~56개 (뚜껑 12 · 뒤판 G 3 · 전장 박스 8~12 · 외형 판 약 29) |
| — | 일반(트위스트) 드릴 날 **Ø3 · Ø3.5** | 학교 대여 (없으면 구매) | Ø3 안내 구멍 · 뚜껑 공기 구멍, Ø3.5 브래킷·상판·릴레이 고정 구멍 (스텝드릴은 4mm부터라 이 구멍을 못 뚫음). 스텝드릴에 Ø5·Ø7 단이 없으면 한 단 작게 뚫고 줄로 넓힘(받은 날 확인) |
| P51 | 글루건 (11mm 스틱용 — P43) | **집에서 계속 씀** — 학교 것을 집에 가져올 수 없으면 구매 | 구멍 막기·LED 고정·보강 |
| P50 | 니퍼 | **집에서 계속 씀** — 가져올 수 없으면 구매 | 선·부품 다리 자르기 |
| P54 | 커터칼(대) · 쇠자 60cm 이상 · 커팅매트 | **집에서 씀**(재단) — 가져올 수 없으면 구매 | 포맥스 재단 (600×900 통판이면 꼭 필요 — 다이소 50cm 자는 짧음) |
| — | 줄자, 직각자(ㄱ자), 연필, 송곳, 사포 #240, 작은 줄, 십자드라이버, 작은 일자드라이버(릴레이·J1 나사 단자) | 집 | 공통 |
| — | 클램프 2개, 보안경 | 학교 | 드릴 작업 |
| — | 계량컵(100ml 이상) 또는 주방 저울(1g 단위), 스톱워치(휴대폰) | 집 | STEP2·11 |

> 학교에서 빌릴 수 없을 때(BOM `예산` 시트 '공구 직접 구매'): 인두 최저 구성(인두 ZD-70RA + 스탠드 + 실납) **11,440원** — 열풍기는 사지 않고 수축튜브는 인두 옆면으로 줄입니다(솔더 슬리브는 [STEP3](#step3)의 그림 9 B 방법으로 대신) · 글루건·니퍼 **11,550원** · 드릴 대신 손공구(테이퍼 리머·줄·대형 커터칼) **15,990원**(손으로 하면 몇 시간 걸림).

### 2.3 소모품 {#s2-3}

마스킹테이프(번호 테이프 — 노랑 UL1007 선 구분에 꼭 필요), 네임펜, **폼 양면테이프 P71**, **접착식 벨크로 P64**(전장 박스 고정, 10쌍 중 4쌍 — 필요하면 잘라 씀), 절연테이프(있으면 편함), 작은 지퍼백(작은 부품을 P번호별로 나눠 담기), 식용색소(시연용 색 물), 키친타월, 물티슈, 식초 또는 베이킹소다(세척), 큰 대야(누수 테스트), 일회용 컵 여러 개.

### 2.4 시작하기 전에 확인할 것 {#s2-4}

- [x] **고정 방식 — 기본으로 정함(11-11 주문 기준)**: 전장 박스는 벨크로 P64, 상판 C는 캡티브 너트입니다(볼트 P68·자석 P69는 사지 않음). 나중에 전장 박스를 볼트로 잡고 싶으면 P68 M3×15와 P38 너트 2개를 더 사고, 선반 D·박스 바닥에 Ø3.5 구멍을 **조립 전에** 뚫습니다(STEP5·STEP10).
- [x] **디바이스마트 주문 — 2026-11-11 완료** — 무납땜 기준 35품목, 결제 102,528원(상품 99,528원 + CG0731 따로 배송 3,000원 · 부품별 내역은 BOM 엑셀 `지출_완료` 시트). 도착까지 1~4일입니다. **멀티미터(P48)·23A 전지(P72)·스트리퍼(P49)·USB 데이터 케이블(P07)도 이 주문에 들어 있으므로, 주문품이 온 뒤에 STEP1을 시작합니다.** 받으면 거래명세서(35줄)와 수량을 하나씩 맞춰 봅니다 — 볼트 P37·너트 P38은 **25개씩**(BOM 계획 30개보다 적음, 필요 24). 거래명세서 원본은 개인정보가 있으니 팀만 보관합니다.
  - 기다리는 동안 할 수 있는 것: 용기 확인(아래), 포맥스 뒤판 G 자르기, [2.6](#skills) 읽기, (집에 데이터용 Micro USB 케이블이 있으면) STEP2 절차 가 펌웨어 업로드.
- [ ] **납땜 전용 부품 추가 주문 — 학교 1차 방문 전에** — 11-11 주문은 무납땜 기준이라 이 납땜 기준에만 쓰는 **P13 로커 스위치 · P14 패널 퓨즈홀더 · P26 수축튜브**가 없습니다. BOM 엑셀 `주문_링크` 시트에서 3품목(5,203원 + 배송비 약 2,700원 — 66,000원 미만 주문)을 주문합니다.
- [x] **용기(P32) — 다이소 직사각 저장 용기 970ml(품번 1069852) 5개 구매 완료(11-11).**
- [ ] **용기 확인** — 집에서 자와 펌프 1개로 아래를 확인합니다(안 맞으면 구매처에서 교환·반품).
  - 4개가 **같은 제품**인지(높이가 같아야 노즐·액면 계산이 맞음)
  - 몸통이 **좌우 ≤ 95, 앞뒤 ≤ 135, 높이 ≤ 170mm**(뚜껑 포함) 안인지 — 970ml는 약 80 × 105 × 150mm라 **좁은 80mm 쪽을 좌우**로 놓습니다.
  - 입구 안지름이 60mm 이상이고 **펌프(약 43×23mm)가 입구로 들어가 바닥에 눕는지**
  - 뚜껑이 손으로 돌려 꽉 닫히는지, 뚜껑 윗면에 구멍 3개(Ø7·Ø5·Ø3)를 낼 평평한 자리가 있는지
  - 산 날 집에서 펌프를 용기 바닥에 눕히고 **리드가 입구 위로 몇 cm 나오는지** 잽니다. **약 5cm 이상**이면 충분합니다(뚜껑 두께와 안쪽 여유 1~2cm를 빼고 뚜껑 위로 3cm 이상 — 추정). 짧은 펌프는 STEP3 절차 3대로 뚜껑 안쪽에서 솔더 슬리브로 잇습니다(학교 1차 방문).
  - *왜?* 본체 안쪽 폭 410mm에 용기 4개를 한 줄로 넣고(칸 하나 약 98mm), 뚜껑에 펌프를 매달아 넣기 때문입니다.
  - 970ml가 맞지 않으면 **원형 900ml(품번 1035184)** 4개로 바꿉니다(같은 기준으로 확인). 처음 산 TARK 1L(폭 120mm)은 W420 본체에 들어가지 않으므로 취소·환불합니다.
- [x] **다이소에서 함께 산 것 — 11-11 구매 완료**(링크는 BOM 엑셀 `주문_링크` 시트의 '이미 산 것') — 폼 양면테이프 P71(오공 18mm×2m, 2,000원) · 네오디뮴 자석 13mm 3개입 P45(1,000원) + 접착식 철판 3개입 P80(1,000원) · 실리콘 원형 코스터 P33(드립 매트, 1,000원) · 전기 절연테이프 P79(1,000원 — 무납땜용으로 함께 샀음, 이 기준에서는 있으면 편함). 멀티미터용 23A 전지(P72)는 디바이스마트 주문에 들어 있습니다. 결제는 14,000원(물건 11,000원 + 배송비 3,000원)입니다. 영수증을 모아 둡니다(정산).
- [ ] **학교 실습실 공구 대여 묻기** — 인두기·열풍기·드릴·스텝드릴·일반 드릴 날(Ø3·Ø3.5)·글루건·니퍼·커터칼/쇠자를 빌릴 수 있는지, 언제 쓸 수 있는지, **글루건·니퍼·커터칼·쇠자는 집에 가져가 써도 되는지**(집에서 계속 씀) 학과(조교)에 먼저 묻습니다. BOM은 '대여 가능'을 전제로 했을 뿐 확인된 적은 없습니다. 안 되면 [2.2](#s2-2) 아래 메모(공구 직접 구매)를 봅니다.
- [ ] **포맥스(P34, 구매 완료) 확인** — 받은 판이 **600×900 통판**이면 STEP9에서 직접 재단합니다(그림 13 — 커터칼(대)·쇠자 60cm 이상·커팅매트). 맞춤 재단 판이면 [부록 B](#appB) 치수와 맞는지 줄자로 잽니다. **뒤판 G(410×115)는 STEP4에 필요하므로 가장 먼저** 자릅니다 — 판 2에 그림 13대로 모든 선을 먼저 그린 뒤 G 자리만 잘라 냅니다(아무 데서나 자르면 D·E·F 자리가 모자랄 수 있음). 노즐 판 M1·M2는 자르지 않습니다(출력 노즐 블록 02 사용).
- [ ] **3D 출력 부품(P70, 주문 완료 · 11/16 도착 예정)** — STEP 1~8은 출력 부품 없이 할 수 있고, STEP9부터 필요합니다. 받은 날 [부록 D](#appD)의 '받은 뒤 확인' 표대로 끼워 봅니다.
  - 지금 어댑터(P11) **플러그 머리 지름**을 자로 잽니다. 12mm보다 크면 뒤판 G의 Ø12 구멍을 키워야 하고, 이미 주문한 그로밋 05(Ø12용)는 맞지 않습니다 → 구멍 가장자리를 글루건으로 둥글게 마감하거나 05의 구멍 값을 바꿔 다시 출력합니다([부록 D](#appD)).

### 2.5 일정 예시 (날짜 없는 상대 일정) {#s2-5}

목표는 **2학기 졸업작품 시제품 · 기말 시연(발표) · 졸업논문 실험 데이터**입니다. 정해진 전시 마감이 없으므로 서두르지 말고, 한 STEP의 확인 포인트(✔)를 모두 통과한 뒤 다음 STEP으로 넘어가세요. 각 STEP마다 사진을 찍어 두면 논문·결과보고서·특허 그림 자료로 씁니다.

집에는 납땜 도구가 없으므로 **인두·열풍기·드릴이 필요한 일을 학교 실습실에 두 번 가서 몰아서** 합니다. 나머지는 집에서 합니다.

| 시기 | 할 일 | 어디서 |
|---|---|---|
| 시작일 (11-11) | 디바이스마트 주문 · 다이소 구매 **(11-11 완료 — 무납땜 기준 부품)** · **납땜 전용 P13·P14·P26 추가 주문**(1차 학교 방문 전에 도착해야 함) · 용기 확인(2.4) · TARK 환불 · 학교 공구 대여 문의 | 집 · 매장 |
| 주문품이 오기까지(1~4일) | 포맥스 뒤판 G 먼저 자르기 · [2.6](#skills) 읽기 · (데이터용 Micro USB 케이블이 있으면) STEP2 절차 가 펌웨어 업로드 | 집 |
| 1주차 앞 (주문품 도착 뒤) | STEP1 검수 → STEP2 브레드보드 시험(릴레이 A안/B안 결정) | 집 |
| 1주차 중 | **학교 1차 방문**: 뚜껑·G판 구멍 → STEP4 SW1·F1 납땜 → STEP3 다이오드 하네스(→ 방향 확인)·솔더 슬리브 → 전장 박스 구멍 (아래 목록) | 학교 실습실 (3~4시간) |
| 1주차 뒤 | STEP3 마무리(물 시험) → STEP4 나머지(J1·TB·C1) → STEP5 박스 배선 → STEP6 첫 전원 → STEP7 앱 연결 | 집 |
| 2주차 앞 | STEP8 배관·누수 테스트(책상 위) · 포맥스 재단(STEP9 절차 가) · 출력 부품 검수 | 집 |
| 2주차 중 | **학교 2차 방문**: 외형 판 구멍 약 29개(상판 C 포함) → 앞판 F에 버튼·LED → 앞판 납땜 6~9곳(부저를 달면 9곳) (아래 목록) | 학교 실습실 (3~4시간) |
| 2주차 뒤 | STEP9 조립·방수 → STEP10 최종 조립 | 집 |
| 3주차 | STEP11 캘리브레이션 → STEP12 시운전·세척 → 리허설(발표 순서대로 + 연속 10~20잔) | 집 |
| 그 뒤 | 논문용 반복 측정(유량·50ml 정확도·제조 시간), 개선 — [부록 C](#appC) 기록표, [6장](#s6) | 집 |
| 기말 발표 · 졸업작품 전시 | 날짜 **확인 필요**(학과 공지). 날짜가 정해지면 그 1주 전에 리허설을 한 번 더 | — |

#### 학교 1차 방문 — 챙길 것과 순서 {#school1}

용기·뒤판 G·전장 박스와 디바이스마트 주문품을 받은 뒤에 갑니다. 이 STEP들의 해당 절차를 인쇄해 갑니다(STEP3 · STEP4 · STEP5 절차 가).

- [ ] 챙길 것: 용기 4개(뚜껑 포함, 번호), 펌프 4개, AWG20 2심 **70cm × 4가닥**(양 끝 번호·"펌프 쪽"/"박스 쪽" 표시) + 빨강 **② 25cm · ③ 8cm · ④ 30cm**, 1N4007 4개, C1(P16), 로커 스위치 P13 · 퓨즈홀더 P14, 재단한 **뒤판 G**, 전장 박스 P35(속판 포함), 릴레이 P08 · ESP32+확장보드 P02(속판 배치·고정 구멍 표시용), 솔더 슬리브 P25 8개, 수축튜브 P26, 멀티미터 P48, 스트리퍼 P49, 니퍼, 자(또는 캘리퍼스)·연필·네임펜·송곳·줄·커터칼·사포, 마스킹테이프, 연습용 자투리 선, **어댑터 플러그 머리 지름 메모**(2.4에서 잰 값, 또는 어댑터 P11), 일반 드릴 날 Ø3·Ø3.5(학교에 없을 때)
  - (권장) **예비 펌프 모듈 1개**도 같이 만들 것: 예비 펌프 P09 1개 · 예비 용기 뚜껑 · AWG20 2심 70cm 1가닥 · 1N4007 1개 · 솔더 슬리브 2개(보유 10개 중 남는 것) — 납땜 부품은 학교에서만 고칠 수 있으므로 시연 대비
- [ ] 순서: ⓪ (집에서 미리) STEP4 절차 1 재기 → ① 뚜껑 구멍 12개(예비 모듈까지면 15개)(STEP3 절차 2) → ② 뒤판 G 구멍 3개(STEP4 절차 2) → ③ SW1·F1을 G에 끼우고 납땜(STEP4 절차 3~5) → ④ 다이오드 하네스 4개(STEP3 절차 4) → **바로 다이오드 방향 확인**(펌프를 잇기 전에) → ⑤ 펌프 리드를 뚜껑에 통과시키고 솔더 슬리브 8곳(STEP3 절차 3·5) → ⑥ 전장 박스 벽 구멍 4개 + 속판 구멍(릴레이 4개, 확장보드를 나사로 고정할 거면 보드를 대고 표시해 함께, 볼트 고정을 고르면 박스 바닥 Ø3.5 2개도 — STEP5 절차 가 1~4) → ⑦ C1 두 다리에 수축튜브를 씌워 줄여 둠(끝 10mm 남김 — STEP4 절차 9)
- [ ] 돌아오기 전에: 이음 16곳(펌프 리드 8 + 하네스 8, 예비 모듈은 +4) 당김 테스트, SW1·F1 단자 수축튜브, 다이오드 하네스 4개 방향 기록

#### 학교 2차 방문 — 챙길 것과 순서 {#school2}

출력 부품과 외형 판(재단 끝)이 모두 준비된 뒤에 갑니다(STEP9 절차 나·다 8 인쇄).

- [ ] 챙길 것: 재단한 판 A·B좌우·C·D·E·F·H, **출력 브래킷 01 전부 · 그로밋 04 2개 · 튜브 부싱 07 · 베젤 03**(구멍에 바로 끼워 보기), 버튼 P03 · LED P05 · R1 P06 · 부저 P04 + 듀폰 F/F 3가닥(㉙·㉚·㉜ 끝), UL1007 **노랑 40cm × 4 · 검정 40cm × 1 · 검정 약 8cm × 2(㉞·㊱) · 약 20cm × 1(㉜)**, 수축튜브, 번호 테이프, 멀티미터, 스트리퍼, 니퍼, 폼 양면테이프 P71, 글루건 스틱 P43, 자·연필·직각자·송곳, 일반 드릴 날 Ø3·Ø3.5(학교에 없을 때)
- [ ] 순서: ① 외형 판 구멍(STEP9 구멍 표 — **Ø3.5 24개**(A 4 · B 12 · D 4 · C 4) · Ø20 × 2 · Ø25 · Ø16 · Ø5, 선택: H 손가락 구멍, 볼트 고정을 고르면 D Ø3.5 × 2) → 뚫자마자 브래킷 01·그로밋 04·부싱 07을 끼워 보고 안 맞으면 그 자리에서 넓힘 → ② F에 버튼·LED → ③ 앞판 납땜(STEP9 절차 다 8)
- [ ] 돌아오기 전에: 버튼을 누를 때만 ㉝–㉛ "삐", 납땜부 모두 수축튜브, 노랑 4가닥 양 끝 번호 테이프

### 2.6 기본 손기술 (처음이면 자투리 선으로 먼저 연습) {#skills}

이 가이드에서 반복해서 쓰는 손기술입니다. 실제 부품에 하기 전에 남는 전선으로 두세 번 해 보세요.

#### 가. 피복 벗기기 (와이어 스트리퍼 TU-2022)

1. 벗길 길이를 자로 재서 네임펜으로 표시합니다. 이 가이드에서 쓰는 길이: 레버 커넥터 PCT-418 **10~11mm** · 나사 단자(J1·릴레이) **6~7mm** · 확장보드 푸시인 단자 **8mm** · 솔더 슬리브 **8~10mm** · 다이오드 하네스 이음 **8~10mm**.
2. 전선 굵기에 맞는 구멍을 고릅니다: **AWG20(빨강·검정 2심) → 1.0**, **UL1007 22AWG(노랑·검정·빨강) → 0.8**, **듀폰 점퍼선 → 0.5**. 펌프 리드처럼 가는 선은 작은 구멍부터 해 보고, 속의 구리선이 잘리면 한 칸 큰 구멍으로 바꿉니다.
3. 표시한 곳을 구멍에 맞춰 손잡이를 끝까지 쥔 채 → 선 끝 쪽으로 당겨 피복을 빼냅니다.
4. 드러난 **심선**(속의 가는 구리 가닥들)을 손가락으로 한 방향으로 꼬아 한 가닥처럼 만듭니다. 가닥이 여러 개 끊겼으면 잘라 내고 다시 벗깁니다.
   *왜?* 끊긴 가닥만큼 굵기가 줄어 열이 나고, 삐져나온 가닥이 옆 단자에 닿으면 단락됩니다.
5. **2심 전선 가르기** — AWG20 2심(빨강·검정이 붙은 선)에서 한 색만 쓸 때는, 두 선 사이 홈에 커터칼 끝을 살짝 대고 2~3cm 그은 뒤 손으로 벌려 떼어 냅니다. 남은 다른 색은 같은 색이 필요한 선(⑤ 검정 등)에 씁니다.

#### 나. 레버 커넥터 (PCT-418)

1. 레버를 위로 끝까지 올립니다.
2. 피복을 벗긴 선을 구멍 **끝까지** 밀어 넣습니다(투명 몸통이면 심선 끝이 안쪽 벽에 닿는 것이 보임).
3. 레버를 "딸깍" 내립니다.
4. 선을 손가락으로 살짝(약 1kg) 당겨 빠지지 않는지 봅니다. **한 구멍에 한 가닥**만 넣습니다.
5. 한 커넥터 안의 구멍은 **모두 서로 이어져** 있습니다. 8구(PCT-418)는 한 선에 들어온 전기를 나머지 7구로 나누는 "분배기"입니다.
6. 가는 선(듀폰선·펌프 리드)이 헐겁게 물리면, 피복을 **두 배 길이(약 18~22mm)** 로 벗겨 반으로 접어 꼬아 넣습니다. 들어가는 길이는 그대로이고 굵기만 두 배가 됩니다. 먼저 접지 않고 넣어 당김 테스트를 해 보고, 빠질 때만 접습니다.
- ⚠ 피복이 커넥터 안까지 들어가면(너무 짧게 벗김) 전기가 안 통하고, 심선이 밖으로 보이면(너무 길게 벗김) 단락될 수 있습니다. 투명 몸통으로 확인합니다.
- 레버를 다시 올리면 선을 뺄 수 있어 **고쳐 꽂기 쉽습니다**.

#### 다. 나사 단자 (J1 · 릴레이 출력 단자)

1. 작은 일자드라이버로 나사를 반시계 방향으로 2~3바퀴 풀어 구멍을 엽니다.
2. 피복을 6~7mm 벗겨 꼰 심선을 넣고 시계 방향으로 조입니다(손가락 힘으로 꽉 — 너무 세게 돌리면 나사산이 망가짐).
3. 당겨 봅니다. 피복이 물려 있으면 안 되고, 심선이 1mm 넘게 밖에 보이면 안 됩니다.

#### 라. 푸시인 단자 (ESP32 확장보드 P02)

단자 옆의 누름 버튼(또는 레버)을 일자드라이버로 누른 채 선을 넣고 떼면 물립니다. 뺄 때도 버튼을 누른 채 당깁니다. 받은 보드에서 누르는 곳을 먼저 확인합니다(제품마다 모양이 다름).

#### 마. 듀폰(점퍼)선 끝 처리

F/F 점퍼선은 양 끝이 검은 소켓(구멍)입니다. 한쪽 소켓은 릴레이·부저 핀에 그대로 꽂고, 다른 쪽은 니퍼로 소켓을 잘라 0.5 구멍으로 피복을 벗겨(푸시인 8mm · PCT-418 10~11mm — 접어 쓸 때는 두 배 길이) 꼬아 씁니다.

#### 바. 납땜 기초 (학교 실습실에서, 실제 작업 전에 자투리 선으로 3번)

그림은 [STEP3](#step3)의 그림 9(납땜 · 열수축 절차)를 함께 봅니다.

1. 인두를 스탠드에 꽂고 약 350℃로 켭니다. 젖은 스펀지(또는 황동 수세미)로 팁을 닦고 실납을 살짝 녹여 팁을 은색으로 만듭니다.
2. 이을 곳에 **수축튜브를 먼저** 끼워 둡니다. (가장 흔한 실수: 잊고 납땜 → 다시 풀어야 함)
3. 심선을 꼬아 잇고, 인두 팁을 심선에 2~3초 대어 데운 뒤 **실납을 심선 쪽에** 댑니다(인두 끝에 직접 녹이지 않음). 납이 심선 사이로 스며들면 실납 → 인두 순서로 뗍니다.
4. 5초 동안 움직이지 않고 식힙니다. **반짝이고 심선 모양이 보이면 좋음**, 회색의 둥근 덩어리면 "냉납"(접촉 불량)이라 다시 데웁니다.
5. 수축튜브를 이음부 위로 밀어 열풍기(또는 인두 옆면)로 줄입니다.
- ⚠ 인두 팁은 약 350℃입니다. 손에서 놓을 때는 항상 스탠드에 꽂습니다. 포맥스 판·전선 피복에 닿으면 녹습니다.

#### 사. 글루건 · 스텝드릴 · 순간접착제

- **글루건**: 3~5분 예열 → 조금씩 짭니다 → 굳기 전(약 30초) 안에 위치를 맞춥니다. 굳은 뒤에도 떼어 낼 수 있어 정비할 때 편합니다.
- **스텝드릴**: 송곳으로 중심을 찍고 → 낮은 속도로 → 원하는 지름의 단 테두리까지만 뚫고 → 양면 거스러미를 커터칼로 정리합니다. 판은 클램프로 고정하고 보안경을 씁니다. PP 뚜껑은 특히 천천히(빨리 돌리면 녹음).
- **순간접착제**: 얇게 바르고 10초 누릅니다. 많이 바르면 늦게 굳고 하얗게 번집니다.

**연습 체크**

- [ ] 자투리 AWG20 · UL1007 · 듀폰선을 각 2번씩 벗겨 봄
- [ ] 레버 커넥터에 넣고 당김 테스트 3번
- [ ] 납땜 3번(학교 1차 방문 첫 10분)

<!-- pagebreak -->

## 3. 단계별 제작 {#s3}

| STEP | 내용 | 어디서 | 난이도 | 소요 시간 | 먼저 끝나야 하는 STEP |
|---|---|---|:-:|---|---|
| 1 | 부품 검수 · 멀티미터 기초 | 집 | ★☆☆ | 1~1.5시간 | — |
| 2 | 브레드보드 단위 테스트 | 집 | ★★☆ | 2~3시간 | 1 |
| 3 | 펌프 모듈 (뚜껑 · 연장선 · 납땜 · 다이오드) | **학교**(구멍·납땜) + 집(물 시험) | ★★☆ | 2~3시간 | 1, 용기 구입 |
| 4 | 전원부 | **학교**(G 구멍·SW1·F1 납땜) + 집 | ★★☆ | 2~2.5시간 | 1, 뒤판 G 재단 |
| 5 | ESP32 · 릴레이 영구 배선 | 집 (박스 구멍은 학교 1차) | ★★★ | 3~4시간 | 2, 4 |
| 6 | 전원 넣기 전 점검 · 첫 전원 | 집 | ★☆☆ | 30분 | 5 |
| 7 | 펌웨어 업로드 · 앱 연결 | 집 | ★☆☆ | 1시간 | 6 |
| 8 | 배관 · 누수 테스트 | 집 | ★★☆ | 2~3시간 | 3, 7 |
| 9 | 외형 제작 | **학교**(판 구멍·앞판 납땜) + 집(재단·조립) | ★★★ | 6~8시간 (직접 재단) + 접착제 굳는 시간 | 4(뒤판 G), 판 준비, 출력 부품 |
| 10 | 최종 조립 · 배선 정리 | 집 | ★★★ | 3~4시간 | 5, 8, 9 |
| 11 | 캘리브레이션 | 집 | ★☆☆ | 1~1.5시간 | 10 |
| 12 | 시운전 · 세척 · 보관 | 집 | ★☆☆ | 2시간 | 11 |

STEP 9(재단·조립)는 전기 작업과 동시에 다른 팀원이 진행하면 시간을 크게 줄일 수 있습니다. 단, 절차 다 8의 뒤판 G 붙이기는 STEP4(G에 스위치·퓨즈를 단 뒤)가 끝나야 합니다.

<!-- pagebreak -->

### STEP 1. 부품 검수 · 멀티미터 기초 {#step1}

> **목표**: 모든 부품이 있고 고장 나지 않았는지 확인하고, 멀티미터로 "연결됐는지(도통)"와 "전압"을 잴 수 있게 된다.
> **어디서 · 난이도**: 집 · ★☆☆
> **준비물**: 2.1 부품 전체, 멀티미터(P48) + 23A 전지(P72), 어댑터(P11) + J1(P12), 용기(P32) 1개, 마스킹테이프, 네임펜
> **소요 시간**: 1~1.5시간

그림 5. 멀티미터 기초

그림 6. 극성(방향)이 있는 부품 확대도

#### 절차

1. **부품 대조** — 2.1 표를 인쇄해 부품을 하나씩 꺼내며 수량과 외관(깨짐·휘어짐)을 확인하고 표에 체크합니다. 디바이스마트 상자는 **거래명세서(35줄)** 와도 수량을 맞춰 봅니다(볼트·너트 25개씩, PCT-413·PCT-412 10개씩, CG0731 2개 — CG0731은 따로 배송되어 늦게 올 수 있음). 작은 부품(저항·다이오드·볼트)은 지퍼백에 P번호를 적어 나눠 담습니다.
   *왜?* 조립 도중 부품이 모자라면 주문·배송에 며칠이 걸립니다.
2. **번호 붙이기** — 펌프 4개, 용기 4개(몸통과 뚜껑 모두), 체크밸브 4개에 마스킹테이프로 1~4 번호를 붙입니다. 같은 번호끼리 한 세트가 됩니다.
3. **멀티미터 준비** — M300 뒷면을 열어 **23A 전지(P72)** 를 넣습니다(제품에 들어 있지 않음). 다이얼에 다이오드(`▶|`) 자리가 있는지 봅니다(판매 페이지에는 적혀 있지 않음). **없으면** 이 가이드의 다이오드 방향 확인(STEP1 절차 7, STEP3)은 저항 모드(2k)로 두 방향을 재서 합니다: 한쪽만 숫자가 나오고 반대쪽이 OL이면, 숫자가 나올 때 **빨강 리드가 닿은 다리가 띠 없는 쪽(애노드)** 입니다. 두 방향 모두 OL이면(멀티미터마다 다름 — 추정) 띠 위치를 사진으로 찍어 팀원과 두 번 확인합니다. 검정 리드를 **COM**, 빨강 리드를 **VΩ** 구멍에 꽂습니다. (A·mA 구멍은 쓰지 않습니다.)
4. **도통 테스트 연습(그림 5 ①)** — 다이얼을 `•)))`(삐 소리) 위치로 돌리고 두 리드 끝을 맞대 보면 "삐" 소리가 납니다. 점퍼선 한 가닥의 양 끝에 대어 삐 소리가 나는지 확인합니다.
   *왜?* 앞으로 "이 선이 저 단자에 제대로 연결됐나?"를 전원 없이 확인할 때 계속 씁니다.
5. **어댑터 전압·극성 측정(그림 5 ②③)** — J1(P12)에 어댑터 플러그를 꽂고 콘센트에 연결합니다. 다이얼을 `V⎓ 20V`(직류 전압)로 두고 빨강을 J1의 **+**, 검정을 **−** 단자에 댑니다.
   - 4.9~5.25V가 나오면 정상입니다.
   - 숫자 앞에 **−**가 나오면 J1의 +/− 표시가 반대이거나 어댑터가 "센터 −" 형입니다. J1의 표시 옆에 실제 극성을 네임펜으로 적어 둡니다.
   - 측정 후 어댑터를 콘센트에서 뽑습니다.
6. **펌프 확인** — 멀티미터를 저항(Ω, 200 또는 2k) 모드로 두고 펌프의 빨강·검정 선 사이를 잽니다. 수 Ω~수십 Ω(추정)이 나오면 정상, **OL**(무한대)이면 선이 끊긴 불량입니다. 펌프는 **물 없이 돌리지 않습니다**(공회전하면 망가짐).
7. **다이오드 확인(그림 6 ①)** — 다이얼을 다이오드(`▶|`) 모드로 두고, 빨강을 띠 없는 쪽(애노드), 검정을 띠 쪽(캐소드)에 대면 0.5~0.7 정도가 나옵니다. 반대로 대면 OL. 4개 모두 확인합니다.
8. **릴레이 모듈 살펴보기 · NO/NC 확인(전원 없이)** — 입력 핀(`GND IN1 IN2 IN3 IN4 VCC`), 옆의 2핀 점퍼(보드 인쇄 `JD-VCC`·`VCC`, 작은 플라스틱 점퍼 캡이 두 핀을 잇고 있음 — 캡 색은 제품마다 다름), 출력 나사 단자에 인쇄된 **NO / COM / NC** 순서를 확인해 사진으로 찍어 둡니다. **JD-VCC 핀 옆에 빨간 네임펜으로 점**을 찍어 둡니다(VCC 핀과 바로 붙어 있어 헷갈리기 쉬움).
   - 멀티미터를 도통(`•)))`) 모드로 두고, 채널마다 나사 단자 3개 중 **COM(보통 가운데)** 과 나머지 두 단자를 차례로 잽니다. **COM–NC = "삐"**, **COM–NO = 소리 없음**이 정상입니다(릴레이가 꺼져 있을 때는 COM과 NC가 붙어 있기 때문). 소리가 안 난 단자 옆에 "NO"라고 적습니다. 4채널 모두 합니다.
   *왜?* 제품마다 단자 순서가 다를 수 있어서, 가이드 그림보다 **보드 인쇄와 멀티미터 결과가 정답**입니다. 펌프를 NC에 물리면 전원을 켜자마자 펌프가 계속 돕니다.
9. **ESP32 확인** — 데이터용 USB 케이블(P07)로 PC에 꽂으면 보드의 빨간 전원 LED가 켜지고, 윈도우 **장치 관리자 → 포트(COM & LPT)** 에 `Silicon Labs CP210x … (COMx)`가 보여야 합니다. 안 보이면 다른 케이블(충전 전용 케이블은 안 됨)을 쓰거나 CP210x 드라이버를 설치합니다.
10. **체크밸브 방향 확인** — 체크밸브(P31) 몸통의 **화살표(FLOW)** 방향으로 입으로 살짝 불면 바람이 통하고, 반대로는 막혀야 합니다. 불량은 예비(P31 추가 1개)로 교체합니다. 확인 후 물로 헹굽니다.
11. **튜브 확인** — 내경5 튜브(P29)를 펌프 출수구에 끼워 보아 헐겁지 않은지, 내경4 튜브(P30)가 체크밸브 바브에 끼워지는지 맞춰 봅니다(끝까지 끼우지 않아도 됨).
12. **용기 확인** — 펌프를 970ml 용기 입구로 넣어 바닥에 눕혀 보고, 뚜껑이 끝까지 돌아가 닫히는지 봅니다. 용기 4개를 나란히 세워 높이가 같은지도 봅니다. 펌프 리드가 입구 위로 몇 cm 나오는지 재서 적습니다(약 5cm 이상이면 STEP3의 "뚜껑 위로 3cm 이상"을 채움 — 추정).

#### 확인 포인트

- [ ] ✔ 2.1 표의 "보유" 부품이 모두 있음, 부족한 것은 주문 목록에 적음
- [ ] ✔ 어댑터 출력 4.9~5.25V, J1의 +/− 극성 확인 및 표시
- [ ] ✔ 펌프 4개 모두 저항값 정상(OL 아님)
- [ ] ✔ 다이오드 4개 정방향 0.5~0.7, 역방향 OL (다이오드 모드가 없으면 절차 3의 저항 모드 판정)
- [ ] ✔ 릴레이 4채널 모두 COM–NC "삐", COM–NO 무음 → NO 단자에 표시, JD-VCC 핀에 빨간 점
- [ ] ✔ ESP32가 PC에서 COM 포트로 인식됨
- [ ] ✔ 체크밸브 4개 모두 한쪽으로만 통함, 화살표 방향 확인
- [ ] ✔ 펌프가 용기 입구로 들어가고 뚜껑이 닫힘, 용기 4개 높이 같음, 펌프 리드 길이 기록: ____ cm

#### 흔한 실수

- ⚠ 멀티미터 빨강 리드를 **A(전류)** 구멍에 꽂은 채 전압을 재면 멀티미터 내부 퓨즈가 끊어집니다. 항상 **VΩ** 구멍.
- ⚠ 충전 전용 USB 케이블로는 PC가 ESP32를 인식하지 못합니다(전원 LED는 켜짐). 데이터 케이블인지 확인.
- ⚠ 펌프를 "돌아가나 보려고" 물 없이 전원에 연결하면 수명이 크게 줄어듭니다.

### STEP 2. 브레드보드 단위 테스트 {#step2}

> **목표**: 납땜·조립 전에 펌웨어를 올리고, 시리얼 명령으로 릴레이 4개가 "딸깍" 켜지고 꺼지는지, 펌프 1개가 물을 퍼 올리는지 확인한다. 릴레이 연결 방식(A안/B안)을 여기서 결정한다.
> **어디서 · 난이도**: 집 · ★★☆
> **준비물**: ESP32(P01), 릴레이(P08), 어댑터(P11)+J1(P12), 브레드보드(P23), 점퍼선(P20~P22), LED(P05)+220Ω(P06), 1N4007(P10) 1개, 펌프(P09) 1개, 내경5 튜브 30cm, 물컵 2개, USB 케이블(P07), PC, **멀티미터(P48)**, (절차 바, 선택) 버튼 P03 · 부저 P04 · M/F 점퍼 2가닥
> **소요 시간**: 2~3시간 (Arduino IDE 설치 포함)

그림 7. 벤치 테스트 연결도 (A안)

#### 절차 가. 펌웨어 업로드 (ESP32만 USB에 연결)

1. **Arduino IDE 2** 를 엽니다. 처음이라면 `../../firmware/README.md` 1장대로 설정합니다.
   - 보드 매니저: **esp32 by Espressif Systems 3.x** (검증 3.3.8). *왜?* 2.x 버전은 BLE 함수가 달라 컴파일 오류가 납니다.
   - 라이브러리 매니저: **ArduinoJson 7.x** (검증 7.4.3).
   - (이 PC에는 2026-11-06 기준 ESP32 코어 3.3.8과 ArduinoJson이 이미 설치되어 있습니다.)
2. `firmware/SmartBartender/SmartBartender.ino` 를 엽니다. `config.h`, `BartenderCore.h` 탭이 함께 열려야 합니다.
3. **도구** 메뉴: 보드 = `ESP32 Dev Module`, 포트 = STEP1에서 본 `COMx`, Partition Scheme = `Default 4MB with spiffs`.
4. ESP32**만** USB로 PC에 연결합니다(아직 다른 선은 꽂지 않음). 업로드(→) 버튼을 누릅니다.
   `Connecting....`에서 멈추면 보드의 **BOOT 버튼을 누르고 있다가** `Writing at …`이 나오면 뗍니다.
5. `Hard resetting via RTS pin...`이 나오면 완료입니다.
6. **도구 → 시리얼 모니터**: 속도 **115200**, 줄 끝 **새 줄(New Line)**. 보드의 **EN** 버튼을 누르면 `# AI 스마트 바텐더 펌웨어 v2.1.2`과 장치 이름(`SmartBartender-XXXX`)이 보입니다. 이 이름을 적어 둡니다.
7. 입력창에 `{"cmd":"hello"}` → Enter. `{"ev":"info","fw":"2.1.2",...,"calSet":[0,0,0,0],"maxPumpMs":120000,...}` 한 줄이 오면 펌웨어 정상입니다(버전 끝자리는 달라도 됨).
   `calSet`이 모두 0인 것은 "아직 캘리브레이션 안 함"이라는 뜻이라 지금은 정상입니다(STEP11에서 1로 바뀜).

> **ESP32를 브레드보드에 놓는 법**: 830핀 브레드보드 한 개에 ESP32를 꽂으면 보드가 넓어 한쪽 핀 줄을 쓸 수 없습니다. 브레드보드 2개(P23, 보유 2)를 나란히 붙여 가운데에 걸쳐 꽂거나, ESP32 핀에 F 점퍼선을 직접 꽂습니다. 안테나가 위, USB 단자가 아래(몸 쪽)가 되게 두면 그림 7·부록 A의 핀 순서와 같습니다.

#### 절차 나. 상태 LED 테스트

> **LED(P05)·220Ω(P06)이 아직 없으면**(둘 다 보유 0 — 주문품) 이 절차는 건너뛰고 절차 다·마를 먼저 한 뒤, 부품이 도착하면 돌아와서 합니다(그때는 어댑터와 USB를 모두 뽑은 상태에서 8번부터). LED는 상태 표시만 하므로 없어도 펌웨어 업로드·시리얼 명령·릴레이·펌프 시험은 똑같이 됩니다. 확인 포인트의 "외부 LED" 항목은 이때 체크합니다.

8. USB를 뽑고, 브레드보드에 **GPIO2(오른쪽 줄 15번, J3-15) → 220Ω(R1) → LED 긴 다리(+)**, **LED 짧은 다리(−) → GND(오른쪽 줄 1번, J3-1)** 로 꽂습니다(그림 7 오른쪽, 그림 6 ③). 이 LED는 **필수 부품**입니다.
9. USB를 다시 꽂으면 LED가 **1초 간격으로 천천히 깜빡**여야 합니다(= 블루투스 연결 대기 중).
   *왜 외부 LED?* 우리 보드(DevKitC V4)에는 GPIO2에 연결된 LED가 없고 빨간 전원 LED만 있기 때문입니다.

#### 절차 다. 릴레이 테스트 — A안 (SPEC 기본)

10. USB를 뽑습니다. 릴레이 모듈의 **JD-VCC 점퍼 캡을 뽑아** 잃어버리지 않게 테이프로 모듈 옆에 붙여 둡니다(B안이 되면 다시 씀).
    *왜?* 점퍼를 빼면 "입력 쪽 전원(VCC)"과 "코일 전원(JD-VCC)"이 분리됩니다. 입력 쪽을 ESP32와 같은 3.3V로 맞추면 ESP32가 HIGH(3.3V)를 낼 때 릴레이가 **확실하게 꺼집니다**.
11. 그림 7처럼 연결합니다. (F/F 또는 M/F 점퍼선 사용)
    - 릴레이 **입력 헤더**(`GND IN1 IN2 IN3 IN4 VCC` 6핀 줄) 끝의 `VCC` 핀 ← ESP32 `3V3` (주황, 왼쪽 줄 맨 위 J2-1) — 옆 점퍼 헤더(`VCC`·`JD-VCC` 2핀)의 VCC가 **아님**
    - 릴레이 `IN1` ← `GPIO26`(파랑), `IN2` ← `GPIO27`(초록), `IN3` ← `GPIO32`(노랑), `IN4` ← `GPIO33`(보라) — 연결표 ⑫~⑮와 같은 색
    - 릴레이 `GND` ← ESP32 `GND`(왼쪽 줄 14번 J2-14), 그리고 브레드보드 **GND 레일(−)**
    - 릴레이 `JD-VCC`(빨간 점 찍은 핀) ← 브레드보드 **+5V 레일** (빨강 점퍼선 — B안이 되면 이 선을 `VCC` 핀으로 옮김, 절차 라)
    - J1 `+` → +5V 레일, J1 `−` → GND 레일 (STEP1에서 표시한 실제 극성대로, J1에는 어댑터 플러그)
    - **ESP32의 `5V` 핀은 비워 둡니다.**
12. 연결을 그림 7과 한 줄씩 대조합니다. 어댑터를 꽂기 전에 멀티미터 저항 모드로 **+5V 레일–GND 레일**이 0Ω 근처가 아닌지 확인합니다(벤치에는 퓨즈가 없음). 그다음 ESP32 USB를 꽂고 → 어댑터를 콘센트에 꽂습니다.
13. 시리얼 모니터에 `{"cmd":"run","p":1,"ms":2000}` → 릴레이 1이 **"딸깍"** 하고 표시 LED가 2초간 켜졌다가 꺼져야 합니다. `p`를 2, 3, 4로 바꿔 반복합니다.
14. `{"cmd":"clean","ms":1000}` → 릴레이 1→2→3→4가 1초씩 차례로 딸깍거립니다.
15. 결과를 아래 표에 기록합니다.

| 채널 | 딸깍 소리 | 표시 LED | 꺼질 때 확실히 꺼짐 | 판정 |
|---|---|---|---|---|
| 1 (GPIO26) | [ ] | [ ] | [ ] | A안 / B안 |
| 2 (GPIO27) | [ ] | [ ] | [ ] | A안 / B안 |
| 3 (GPIO32) | [ ] | [ ] | [ ] | A안 / B안 |
| 4 (GPIO33) | [ ] | [ ] | [ ] | A안 / B안 |

#### 절차 라. (A안이 안 될 때만) B안

16. A안에서 표시 LED가 희미하거나, 딸깍 소리가 안 나거나, 4채널 중 일부만 될 때는 입력 전류가 부족한 것입니다(이 보드는 입력이 LED 두 개 직렬 구조로 보여 3.3V에서 약 0.3~0.7mA밖에 안 흐를 수 있음 — 추정). 이때 SPEC의 **공식 대체안인 B안**으로 바꿉니다.
17. **어댑터와 USB를 모두 뽑습니다.** 그다음 순서를 지킵니다(회로도.html "⑤ B안"과 같음).
    1. 릴레이 `VCC` ← ESP32 `3V3` 선(주황, 연결표 ⑪)을 **먼저 뽑아** 치웁니다.
    2. 릴레이 `JD-VCC`(빨간 점)에 꽂혀 있던 **+5V 선(빨강, 연결표 ⑨)을 뽑아, 방금 비운 입력 헤더 `VCC` 핀에 꽂습니다.**
    3. 그다음 **점퍼 캡을 끼웁니다.** JD-VCC 핀에는 캡만 남습니다. 이제 `VCC`로 들어온 +5V가 점퍼를 통해 `JD-VCC`(코일)에도 들어갑니다(VCC = JD-VCC = 5V).
    4. IN1~IN4(GPIO 직결)·GND는 그대로 둡니다.
    5. (전원 없이) 멀티미터 도통 모드로 **+5V 레일 ↔ 릴레이 `VCC` 핀**, **+5V 레일 ↔ `JD-VCC` 핀**이 모두 "삐"인지 확인합니다.

    *왜 +5V 선을 옮기나?* 점퍼 헤더는 `VCC`·`JD-VCC` 2핀뿐이고 점퍼 캡은 두 핀을 모두 덮습니다. 그래서 듀폰 선이 꽂힌 핀에는 캡이 들어가지 않고, +5V 선만 빼고 캡을 끼우면 릴레이에 5V가 전혀 들어가지 않습니다.
    *왜 이 순서?* 점퍼와 ⑪(3V3)이 한순간이라도 함께 연결되면 5V가 ESP32의 3.3V 쪽으로 거꾸로 들어가 보드가 상할 수 있습니다. +5V 선이 `VCC` 핀을 차지하면 3V3 선을 다시 꽂을 자리도 없어집니다.
18. 12~15를 다시 합니다. B안에서는 특히 **꺼질 때 표시 LED가 완전히 꺼지는지**도 봅니다. **B안에서는 릴레이 VCC를 절대 3V3에 연결하지 않습니다.** 두 안 모두 LOW = 켜짐(Active-LOW)이라 **펌웨어는 바꾸지 않습니다**.
19. 결정한 방식(A안/B안)을 릴레이 모듈에 테이프로 적어 둡니다. STEP5에서 이 방식대로 배선합니다(B안이면 연결표 ⑪은 연결하지 않고, ⑨를 입력 헤더 `VCC` 핀에 꽂은 뒤 캡을 끼움).

#### 절차 마. 펌프 1개 물 테스트

20. 어댑터를 뽑습니다. 펌프 1의 **빨강 선**을 브레드보드의 빈 세로줄(줄 A라고 부름)에 꽂고, 같은 줄 A에서 M/M 점퍼(P22)로 **릴레이 `NO1`**(K1 NO — STEP1에서 "NO"라고 적은 나사 단자)에 잇습니다. **검정 선 → GND 레일**, 릴레이 `COM1`(K1 COM) ← +5V 레일. 펌프 리드 끝 심선은 꼬아서 꽂고, 쉽게 빠지면 M/M 점퍼 핀에 감아 마스킹테이프로 감습니다.
21. 다이오드 1개를 펌프와 나란히 꽂습니다: **띠 쪽 → 줄 A**(펌프 빨강과 같은 줄), 반대쪽 → GND 레일 (그림 7 D1 — 그림은 연결 관계만 그렸고, 줄 A는 펌프 빨강·D1 띠·NO1 점퍼가 만나는 곳입니다).
    *왜?* 모터를 끄는 순간 생기는 높은 역전압(역기전력)을 다이오드가 흘려보내 릴레이 접점과 ESP32를 보호합니다.
    ⚠ 방향을 반대로 달면 릴레이가 켜지는 순간 +5V와 GND가 다이오드로 바로 이어집니다(단락) — 어댑터가 꺼졌다 켜졌다 하고 다이오드가 뜨거워집니다. 벤치에는 퓨즈가 없으니 꽂기 전에 띠 위치를 한 번 더 봅니다.
22. 펌프 출수구에 내경5 튜브 30cm를 끼우고, 펌프를 물컵 바닥에 놓고, 튜브 끝을 빈 컵에 넣습니다.
23. USB → 어댑터 순으로 전원을 넣고 `{"cmd":"run","p":1,"ms":3000}` → 3초간 물이 나오면 성공입니다.
24. (참고 측정) 빈 컵을 비우고 `{"cmd":"run","p":1,"ms":10000}` → 나온 양을 계량컵으로 잽니다. 체크밸브 없이 약 100~140ml(10~14 ml/초, 추정) 정도면 정상입니다. 값을 적어 둡니다.
25. `{"cmd":"run","p":1,"ms":20000}` 을 보내고 5초 뒤 `{"cmd":"stop"}` → 바로 멈추고 `stopped` 이벤트가 와야 합니다(비상정지 확인).

#### 절차 바. (선택) 버튼·부저 테스트

26. 버튼(P03) 한쪽 단자 → GPIO4(오른쪽 줄 13번, J3-13), 다른 쪽 → GND. 버튼 단자에는 M/F 점퍼의 F 소켓을 끼워(단자가 두꺼워 안 끼워지면 이 선택 시험은 학교 2차 방문 뒤로 미룸) 브레드보드에 잇습니다. 버튼은 방향이 없지만, 단자가 3개 이상이면 멀티미터 도통 모드로 **버튼을 누를 때만 "삐"** 나는 두 단자를 고릅니다(나머지는 버튼 조명용일 수 있음). 대기 중 짧게 누르면 시리얼에 `{"ev":"status",...}`가 나옵니다. 펌프를 20초 돌리는 중에 누르면 즉시 멈추고 `"reason":"button"`이 나옵니다.
27. 부저(P04): 모듈에 인쇄된 핀 이름을 보고 `VCC → 3V3`, `GND → GND`, `I/O → GPIO23`(오른쪽 줄 2번, J3-2). ONE005는 **I/O가 HIGH일 때 울리는** 모듈이라 펌웨어 기본값(`config.h`의 `BUZZER_ON_LEVEL 1`, SPEC §1)과 맞습니다. EN 버튼을 누르면 부팅 때 "삑" 소리가 나야 합니다. 다른 부저로 바꿨는데 부팅 후 계속 울린다면 LOW에 울리는 모듈이니 `BUZZER_ON_LEVEL`을 0으로 바꿉니다.

#### 확인 포인트

- [ ] ✔ `hello` → `info` 응답, 장치 이름 기록: `SmartBartender-______`
- [ ] ✔ 외부 LED가 천천히 깜빡임
- [ ] ✔ 릴레이 4채널 모두 켜지고 꺼짐, 방식 결정: **A안 / B안** (동그라미)
- [ ] ✔ 펌프 1 물 테스트 성공, 10초 유량 ______ ml (체크밸브 없음)
- [ ] ✔ `stop` 명령으로 즉시 정지

#### 흔한 실수

- ⚠ 어댑터 +5V를 ESP32 `5V` 핀에도 연결 → USB와 이중 전원. 벤치 테스트에서 ESP32는 **USB로만** 전원을 받습니다.
- ⚠ GND를 공통으로 묶지 않음 → 릴레이가 반응하지 않습니다. ESP32 GND, 릴레이 GND, 어댑터 −가 모두 GND 레일에 있어야 합니다.
- ⚠ 830 브레드보드 한 개에 ESP32를 꽂으면 보드가 넓어 한쪽 핀 열을 쓸 수 없습니다. 브레드보드 2개를 나란히 붙여 걸쳐 꽂거나, ESP32 핀에 F 점퍼선을 직접 꽂으세요.
- ⚠ 시리얼 모니터의 줄 끝이 "줄 끝 없음"이면 명령이 실행되지 않습니다. **새 줄(New Line)** 로.
- ⚠ 업로드 중에는 시리얼 모니터 창이 포트를 잡고 있으면 실패할 수 있습니다. 업로드 실패 시 모니터를 닫고 다시.

### STEP 3. 펌프 모듈 만들기 (뚜껑 · 연장선 · 납땜 · 열수축 · 다이오드) {#step3}

> **목표**: 펌프 4개 각각을 "뚜껑 + 펌프 + 70cm 연장선 + 다이오드"가 한 덩어리인 **펌프 모듈**로 만든다. 이음부는 물에 닿지 않는 뚜껑 위에, 다이오드는 젖지 않는 전장 박스 쪽 끝에 둔다.
> **어디서 · 난이도**: 학교 실습실(뚜껑 구멍 · 다이오드 납땜 · 솔더 슬리브 — [1차 방문](#school1)) + 집(물 시험) · ★★☆
> **준비물**: 펌프(P09) 4, 용기(P32, 970ml) 4, AWG20 2심(P19) 약 3m, 1N4007(P10) 4, 솔더 슬리브(P25) 8, 수축튜브(P26), 인두(P46)·실납(P47), 열풍기(P52), 스트리퍼(P49)·니퍼(P50), 멀티미터(P48), 스텝드릴(P53)·송곳, 글루건, 마스킹테이프·네임펜
> **소요 시간**: 2~3시간 (학교 1~1.5시간 포함)

그림 8. 용기 뚜껑 가공 상세 (970ml 용기, 납땜 기준)

그림 9. 납땜 · 열수축 절차

#### 970ml 용기의 돌림 뚜껑

- 970ml 용기는 **돌려서 닫는 둥근 뚜껑**입니다. 펌프 모듈을 만든 뒤에는 뚜껑에 전선과 튜브가 달려 있으므로, **뚜껑을 잡은 채 용기 몸통을 돌려** 열고 닫습니다. *왜?* 뚜껑을 돌리면 위의 전선·튜브가 꼬이고 이음부가 당겨집니다.
- 뚜껑(PP)에 구멍을 낼 때는 드릴을 천천히 돌립니다. 몸통(PET)에는 구멍을 내지 않습니다.

#### 절차

1. **연장선 자르기** — AWG20 2심을 **70cm × 4가닥**으로 자릅니다. 양 끝에 펌프 번호(1~4) 테이프를 붙이고, 한쪽 끝에는 "펌프 쪽", 다른 쪽에는 "박스 쪽"이라고 씁니다.
   *왜 70cm?* 용기 바닥 → 뚜껑 → 선반 구멍 → 박스까지 약 40cm에, 용기를 뒤로 30cm 꺼낼 수 있는 여유를 더한 길이입니다. 실제 배치에서 남으면 묶어 두면 됩니다.
2. **뚜껑 가공(그림 8)** — 펌프를 용기 바닥에 눕혀 놓고 뚜껑을 덮어 위치를 봅니다. 뚜껑 윗면의 평평한 부분 안에 **Ø7 튜브 구멍**(펌프 출수구에 가까운 쪽), 거기서 20mm 떨어진 곳에 **Ø5 전선 구멍**, 뚜껑 가장자리에서 10mm 안쪽에 **Ø3 공기 구멍**을 연필로 표시합니다.
   - Ø7·Ø5는 송곳으로 작은 구멍을 낸 뒤 스텝드릴을 **천천히** 돌려 넓히고, Ø3 공기 구멍은 Ø3 일반 드릴 날로 천천히 뚫습니다(스텝드릴은 4mm부터). *왜?* PP 뚜껑은 빨리 돌리면 열로 녹아 구멍이 지저분해집니다.
   - *왜 공기 구멍?* 밀폐용기는 액체를 퍼낼수록 안이 진공이 되어 유량이 줄어듭니다. 작은 구멍 하나로 공기가 들어오게 합니다(SPEC §1). **Ø3 공기 구멍은 글루건으로 막지 않습니다.**
   - 거스러미는 커터칼로 정리합니다. 4개 모두 같은 위치로 가공하고, 뚜껑에도 몸통과 같은 번호를 적습니다.
3. **펌프 리드선 통과** — 펌프의 빨강·검정 리드선을 뚜껑 **안쪽에서 바깥쪽으로** Ø5 구멍에 통과시킵니다. 펌프를 바닥에 눕혀 뚜껑을 덮었을 때 리드가 팽팽하지 않게 **뚜껑 안쪽에 1~2cm 여유**를 남기고, 그 상태에서 뚜껑 위로 **최소 3cm** 나와야 합니다.
   - 리드가 짧아 뚜껑 위로 나오지 않으면: 뚜껑 안쪽에서 잇고, 이음부를 솔더 슬리브(접착제 내장이라 방수)로 확실히 감싼 뒤 액면보다 높은 곳(뚜껑 바로 아래)에 오게 합니다.
4. **다이오드 하네스(박스 쪽 끝) 먼저 만들기(그림 9 C 오른쪽)** — 학교 실습실에서
   1. 박스 쪽 끝의 빨강·검정을 **약 28cm** 갈라 놓습니다([2.6 가](#skills) 5).
   2. **빨강은 끝에서 약 20cm, 검정은 끝에서 약 23cm** 되는 곳을 자릅니다(두 이음이 3cm 엇갈림). 잘려 나온 **꼬리 2가닥(빨강 20cm · 검정 23cm)** 에도 펌프 번호 테이프를 붙이고, 잘린 네 끝을 모두 **8~10mm** 벗깁니다.
   3. **수축튜브를 먼저 끼웁니다**: 가는 튜브(약 2cm)를 빨강 꼬리·검정 꼬리에 하나씩 끼워 꼬리 끝 쪽으로 밀어 두고, 굵은 튜브 1개(약 6cm)는 케이블 쪽 빨강·검정 두 가닥을 함께 감싸게 끼워 2심이 붙은 곳까지 멀리 밀어 둡니다.
   4. 다이오드를 두 이음 사이에 **선과 나란히** 놓습니다(띠 쪽이 빨강 이음, 반대쪽이 검정 이음 — 3cm 거리에 맞춰 다리를 자름). **빨강 이음**: 케이블 쪽 빨강 + 빨강 꼬리 + 다이오드 **띠(캐소드) 쪽 다리**를 함께 꼬아 납땜. **검정 이음**: 케이블 쪽 검정 + 검정 꼬리 + 다이오드 반대쪽 다리를 같은 방법으로. 가는 튜브를 각 이음 위로 밀어 수축한 뒤, 굵은 튜브를 다이오드와 두 이음 위로 밀어 한꺼번에 수축합니다(Y자 이음 — 그림 9 C는 연결 관계만 그린 것).
   5. 꼬리 끝을 벗깁니다: **빨강 6~7mm(릴레이 NO 나사 단자), 검정 10~11mm(TB2 레버 커넥터)**.
   6. **바로 확인**: 멀티미터 다이오드 모드로 꼬리 끝에서 **검정 리드 → 빨강 꼬리, 빨강 리드 → 검정 꼬리**에 대면 0.5~0.7, 반대로 대면 OL이어야 합니다(다이오드 모드가 없으면 STEP1 절차 3의 저항 모드 판정).
   *왜 꼬리를 길게?* 빨강은 릴레이 NO, 검정은 TB2로 따로 가야 하고, 굵은 이음 덩어리는 박스 벽 구멍 밖(선반 위)에 두고 가는 꼬리만 구멍을 지나게 하려는 것입니다. 다이오드를 선 맨 끝에 달면 두 끝이 다이오드 길이만큼밖에 벌어지지 않아 두 단자에 동시에 닿지 않을 수 있습니다.
   *왜 먼저?* 펌프를 연결하면 펌프 코일이 다이오드와 나란히 붙어 멀티미터로 방향을 확인할 수 없습니다. 펌프를 잇기 전에 확인해야 합니다.
   *왜 박스 쪽?* 다이오드와 납땜부가 액체·습기에 닿지 않는 곳에 있어야 오래갑니다. SPEC §1은 다이오드 위치를 "펌프 리드선 이음부(뚜껑 위) 또는 연장선의 박스 쪽 끝 — **전기적으로 동일**"이라고 정해 두었습니다. 어느 쪽이든 펌프와 **병렬**이고 **띠 = 빨강(+)** 이면 똑같이 동작합니다.
5. **이음(그림 9 A — 솔더 슬리브)** — 학교 실습실에서
   1. 이음 위치가 **2cm 엇갈리도록** 자릅니다(그림 9 C 왼쪽): 펌프 리드가 뚜껑 위로 5cm 이상 나오면 **펌프 검정 리드를 2cm 짧게**, 연장선은 펌프 쪽 끝을 약 5cm 가른 뒤 **빨강만 2cm 잘라 냅니다**(그러면 검정이 2cm 길어져 길이가 맞음)(리드가 그보다 짧으면 자르지 않음 — 슬리브가 이음을 하나씩 감싸므로 엇갈리지 않아도 됨). 그다음 펌프 리드와 연장선(펌프 쪽 끝)의 피복을 각각 **8~10mm** 벗깁니다.
      *왜?* 두 이음이 나란히 있으면 굵어지고, 혹시 피복이 벗겨졌을 때 서로 닿아 단락될 수 있습니다.
   2. 솔더 슬리브(P25)를 굵은 연장선 쪽에 먼저 끼웁니다.
   3. 두 심선을 나란히 겹쳐 살짝 비틀고, 슬리브를 밀어 와서 **가운데 은색 납 고리가 겹친 곳 한가운데** 오게 합니다.
   4. 열풍기(약 250~300℃ 또는 1단)를 슬리브 가운데부터 쬡니다. 은색 납이 녹아 심선 사이로 스미고, 양 끝 빨간 접착 고리가 녹아 선에 달라붙으면 끝입니다(약 20~40초).
   5. 식힌 뒤 양쪽을 살짝(약 1kg 힘) 당겨 빠지지 않는지 봅니다.
   - **열풍기를 빌리지 못하면 그림 9 B**: 수축튜브를 먼저 끼우고 → 심선을 꼬아 잇고 → 인두로 심선을 3초 데운 뒤 실납을 심선에 대어 녹이고(인두 끝에 직접 녹이지 않음) → 식힌 뒤 수축튜브를 덮어 인두 옆면으로 수축합니다.
6. **색 확인** — 펌프 빨강 ↔ 연장선 빨강, 펌프 검정 ↔ 연장선 검정인지 다시 봅니다. 판매처 안내대로 **빨강 = +**입니다.
7. **전선 구멍 막기** — 펌프를 바닥에 내려놓고 뚜껑 안쪽 리드에 여유(1~2cm)가 남았는지 다시 본 뒤, 뚜껑 위 Ø5 구멍 둘레를 글루건으로 막습니다(전선이 빠지지 않게 + 물방울 차단). Ø7 튜브 구멍은 STEP8에서 튜브를 끼운 뒤 마무리합니다. Ø3 공기 구멍은 그대로 둡니다.
8. **동작 확인** — **어댑터를 뽑은 상태에서** STEP2의 벤치 연결에서 펌프 1을 빼고, 그 자리에 펌프 모듈의 박스 쪽 끝을 **빨강(꼬리) → 줄 A(NO1로 가는 점퍼가 꽂힌 줄), 검정(꼬리) → GND 레일**로 꽂고(벤치용 다이오드 D1은 빼도 됨 — 모듈에 다이오드가 있음), 펌프를 물컵에 넣습니다. USB → 어댑터 순으로 전원을 넣고 `{"cmd":"run","p":1,"ms":2000}`. 물이 나오면 성공. 펌프를 바꿀 때마다 어댑터를 뽑고 바꿔 4개 모두 반복합니다.

#### 확인 포인트

- [ ] ✔ 다이오드 하네스 4개 모두 방향 확인 — **펌프를 잇기 전에**(다이오드 모드: 검정 리드→빨강 꼬리 0.5~0.7 / 모드가 없으면 STEP1 절차 3 판정)
- [ ] ✔ 펌프 리드 이음 8곳 + 하네스 이음 8곳 당김 테스트 통과, 빨강-빨강·검정-검정
- [ ] ✔ 펌프 리드 이음(솔더 슬리브)이 모두 뚜껑 **위**에 있음(리드가 짧아 안쪽에서 이은 것은 뚜껑 바로 아래, 액면보다 위)
- [ ] ✔ 뚜껑마다 Ø7·Ø5·Ø3 구멍 3개, 몸통과 같은 번호
- [ ] ✔ 펌프 모듈 4개 물 테스트 통과

#### 흔한 실수

- ⚠ 수축튜브·솔더 슬리브를 **미리 끼우지 않고** 납땜 → 다시 풀어야 합니다. 납땜 전에 항상 "튜브 끼웠나?"를 먼저.
- ⚠ 열풍기를 한곳에 너무 오래 → 피복이 녹습니다. 슬리브를 돌려 가며 고르게.
- ⚠ 납땜 덩어리가 회색·둥근 공 모양이면 "냉납"(접촉 불량). 심선을 충분히 데운 뒤 다시.
- ⚠ 다이오드 방향 반대 → 펌프를 켜는 순간 5V가 다이오드로 바로 흘러(단락) ESP32가 재부팅되거나 어댑터가 꺼집니다. **퓨즈(F1)는 멀쩡할 수 있고**, ESP32를 USB로 켠 상태(STEP7 디버깅)에서는 단락이 계속돼 다이오드가 뜨거워집니다. 수축 전에 사진을 찍어 두세요.
- ⚠ 펌프 모듈을 만든 뒤 뚜껑을 돌려 닫음 → 전선·튜브가 꼬입니다. 뚜껑을 잡고 **몸통을 돌립니다**.

### STEP 4. 전원부 (DC 단자 · 스위치 · 퓨즈 · 분배 커넥터 · 커패시터) {#step4}

> **목표**: `어댑터 → J1 → SW1 → F1(3A) → TB1(+5V 분배)` 와 `J1(−) → TB2(GND 분배)` 를 만들고, 1000µF 커패시터 C1을 TB1–TB2 사이에 단다 (연결표 ②~⑦).
> **어디서 · 난이도**: 학교 실습실(G 구멍 · SW1·F1 납땜 — [1차 방문](#school1)) + 집(J1·TB·C1·시험) · ★★☆
> **준비물**: J1(P12), SW1(P13), F1 퓨즈홀더(P14) + 3A 퓨즈(P15), PCT-418(P18) 2개(TB1·TB2), C1 1000µF(P16), AWG20(P19), UL1007 22AWG **검정(P62)** — ⑦용, 수축튜브(P26), 인두·실납(학교), 스트리퍼(P49), 멀티미터, **뒤판 G(재단된 판 410×115)** + 드릴·스텝드릴
> **소요 시간**: 2~2.5시간

그림 10. 전원부 결선도

레버 커넥터(PCT-418) 쓰는 법은 [2.6 나](#skills)에 있습니다. 절차 1은 집에서 미리(학교 1차 방문 전), 절차 2~5와 절차 9의 C1 수축튜브는 학교 1차 방문에서, 나머지는 집에서 합니다.

#### 절차

1. **SW1·F1 구멍 크기 재기** — 로커 스위치(P13)의 몸통 크기(보통 약 19×13mm, 추정)와 퓨즈홀더(P14)의 나사 몸통 지름(보통 Ø12~13mm, 추정)과 **어댑터(P11) 플러그 머리 지름**을 캘리퍼스나 자로 재서 적어 둡니다. 플러그 머리가 12mm보다 크면 절차 2에서 G의 어댑터 선 구멍(Ø12)을 그만큼 키웁니다(STEP9 절차 나).
2. **뒤판 G에 구멍 내기(먼저!)** — 재단된 G판에 [STEP9 구멍 표](#step9)의 **G 행**대로 Ø12(어댑터 선)·사각(SW1)·둥근 구멍(F1, 1에서 잰 지름)을 뚫습니다. 사각 구멍 맞추는 법과 "뒤(바깥)" 표시는 STEP9 절차 나를 따릅니다.
   *왜 지금?* 스위치(SW1)와 퓨즈홀더(F1)는 **G 바깥에서 구멍에 끼우는** 부품입니다. 둘을 잇는 짧은 선 ③을 먼저 납땜해 버리면, 한쪽을 끼운 뒤 다른 쪽을 G 바깥으로 꺼낼 길이 없어 **둘 다 끼우는 것이 불가능**합니다(③을 다시 떼어야 함). 그래서 G에 먼저 끼운 다음 G 안쪽에서 납땜합니다.
   - G판이 아직 없으면(재단 주문 배송 중) STEP3이나 STEP9 준비를 먼저 하고, 판이 오면 STEP4를 합니다. **SW1·F1은 G에 끼우기 전에 납땜하지 않습니다.**
3. **SW1·F1을 G에 끼우기** — G의 바깥면("뒤(바깥)"이라고 쓴 면)에서 SW1을 사각 구멍에 밀어 "딸깍" 끼웁니다(ON 표시 "I"가 위). F1은 바깥에서 둥근 구멍에 넣고 **G 안쪽에서 고정 너트를 조입니다.** 아직 선은 없습니다.
   - 5mm 포맥스라 SW1의 걸쇠가 잘 안 걸리면, G 안쪽 구멍 둘레를 커터칼로 얇게 파 주거나, 절차 12 시험 뒤 몸통 둘레를 글루건으로 보강합니다(추정).
4. **SW1 납땜(G 안쪽)** — 빨강 AWG20 두 가닥(② 약 25cm, ③ 약 8cm)을 준비합니다. 스위치 단자에 맞는 수축튜브를 먼저 끼우고, 단자 구멍에 심선을 걸어 납땜한 뒤 수축튜브로 단자를 덮습니다. 인두 끝이 G판(포맥스)에 닿지 않게 합니다(녹음).
   *왜 수축튜브?* 스위치 단자는 금속이 드러나 있어 다른 선이나 금속(브래킷 볼트·너트)에 닿으면 단락됩니다.
5. **F1 납땜(G 안쪽)** — ③의 다른 끝을 퓨즈홀더 한쪽 단자에, 빨강 ④(약 30cm)를 다른 쪽 단자에 납땜하고 수축튜브로 덮습니다. ③은 G 안쪽에서만 지나갑니다.
   *왜 이 순서(스위치 → 퓨즈)?* 스위치를 끄면 퓨즈 이후 전체가 꺼지고, 퓨즈는 스위치 뒤의 모든 배선을 보호합니다.
   - 이제 G판은 ②·④로 전원부에 매달린 채 STEP9까지 함께 다닙니다(그림 10의 "뒤판 G" 점선 상자). STEP9에서 G를 본체에 붙일 때 ②·④의 박스 쪽 끝을 잠시 빼고, STEP10에서 다시 연결합니다.
6. **J1 연결** — J1(P12) 나사 단자를 일자드라이버로 풉니다. 피복을 6~7mm 벗긴 **② 빨강 → J1 +** 에 넣고 조입니다. **J1 −** 에는 **⑤ 검정 AWG20(약 15cm)** 과 **⑦ 검정 UL1007(P62, 약 20cm, 나중에 ESP32 GND로 감)** 두 가닥을 함께 꼬아 넣고 조인 뒤 당겨 봅니다. STEP1에서 표시한 실제 극성을 따릅니다.
   *왜 J1 −에서 바로 ESP32로?* 펌프의 큰 전류가 흐르는 GND(TB2)와 ESP32의 GND를 J1 한 점에서 나눠, 펌프가 켜질 때 생기는 잡음이 ESP32로 덜 들어가게 합니다(SPEC §1 **별형 접지**, 회로도 ⑤·⑦). 릴레이 GND는 STEP5에서 ESP32 GND에 연결합니다(⑯). 결국 모든 GND는 하나로 이어집니다.
7. **TB1 (+5V)** — ④ 끝 → **TB1 8번** 구멍.
8. **TB2 (GND)** — ⑤ 끝 → **TB2 1번** 구멍. (TB3는 STEP5에서 **3V3 분배**용으로 씁니다.)
9. **C1 커패시터(그림 6 ②)** — 두 다리를 각각 수축튜브로 감싸 끝 10mm만 드러내고(수축은 학교 1차 방문 때 미리 해 옴 — 집에서는 절연테이프로 감아도 됨), **긴 다리(+) → TB1 1번**, **띠 쪽 짧은 다리(−) → TB2 8번** 에 꽂습니다(⑥). TB2를 TB1 아래에 **반대 방향**으로 놓으면 TB1-1과 TB2-8이 위아래로 마주 보아 다리를 바로 꽂을 수 있습니다(그림 10).
   *왜?* 펌프가 켜지는 순간 큰 전류가 흘러 5V가 순간적으로 떨어지는데, 커패시터가 작은 물탱크처럼 전기를 보충해 ESP32가 재부팅(브라운아웃)되는 것을 막습니다.
10. **퓨즈 넣기** — 퓨즈홀더 뚜껑을 돌려 열고 3A 퓨즈(P15)를 넣습니다. 예비 퓨즈 2개는 예비 부품 상자([5장](#s5))에 넣어 둡니다.
11. **단락 검사(그림 5 ④)** — 어댑터를 뽑은 상태에서 멀티미터 저항 모드로 TB1–TB2 사이를 잽니다(TB1·TB2의 빈 구멍에 10~11mm 벗긴 자투리 "시험 선"을 하나씩 꽂아 그 끝에 리드를 대면 쉬움 — 두 시험 선 끝이 서로 닿지 않게 떨어뜨려 놓고, 재지 않을 때는 끝을 테이프로 감아 둠. TB1의 시험 선은 STEP5에서 TB1 구멍을 다 쓰기 전에 뽑고, TB2의 시험 선은 예비 구멍 6번에 남겨도 됨). 숫자가 점점 커져 OL이 되면 정상(커패시터가 충전되는 중)입니다. 0Ω 근처에서 그대로면 어딘가 단락입니다.
12. **전압 확인** — SW1을 OFF로 두고 어댑터를 꽂습니다. TB1–TB2(시험 선 끝): **0V** → SW1 ON: **4.9~5.25V** → SW1 OFF, 어댑터 뽑기. **퓨즈 시험**: 퓨즈홀더 뚜껑을 돌려 퓨즈를 뺌 → 어댑터를 꽂고 SW1 ON → **0V**면 정상 → SW1 OFF, 어댑터 뽑기 → 퓨즈를 다시 넣음.

#### 확인 포인트

- [ ] ✔ SW1·F1이 G에 **먼저 끼워진 뒤** 납땜됨, ③은 G 안쪽에만 있음
- [ ] ✔ SW1 OFF → 0V, ON → 약 5V (TB1–TB2)
- [ ] ✔ C1 + 는 TB1, − 는 TB2 (띠 쪽)
- [ ] ✔ 모든 금속 단자가 수축튜브로 덮여 있음
- [ ] ✔ 레버 커넥터 선 당김 테스트 통과
- [ ] ✔ SW1·F1 구멍 실측값 기록: SW1 ____×____ mm, F1 Ø____ mm

#### 흔한 실수

- ⚠ SW1·F1을 G에 끼우기 전에 ③까지 납땜 → 둘을 G에 끼울 수 없습니다(바깥에서 끼우는 부품 두 개가 선으로 이어져 있기 때문). ③ 한쪽을 인두로 떼고 G에 끼운 뒤 다시 납땜하세요.
- ⚠ 피복을 너무 짧게 벗겨 레버 커넥터 안에서 피복이 물림 → 접촉 불량. 너무 길면 심선이 밖으로 드러나 단락 위험.
- ⚠ 퓨즈가 끊어졌다고 더 큰 퓨즈나 은박지로 바꾸기 → 단락 시 화재 위험. 원인(다이오드 방향, 선 닿음)을 먼저 찾으세요.
- ⚠ 한 레버 구멍에 선 두 개를 억지로 꽂기 → 한 구멍에 한 선이 원칙입니다(두 가닥을 함께 조이는 곳은 J1 − 나사뿐).

### STEP 5. ESP32 · 릴레이 영구 배선 (연결표) {#step5}

> **목표**: 전장 박스(P35) 안에 ESP32+확장보드, 릴레이, 분배 커넥터를 고정하고, 아래 **연결표 순서 그대로**(⑦~⑳) 영구 배선한다. STEP2에서 정한 A안/B안을 따른다.
> **어디서 · 난이도**: 집 (박스·속판 구멍만 드릴 — [학교 1차 방문](#school1)) · ★★★
> **준비물**: 전장 박스(P35), ESP32(P01)+확장보드(P02), 릴레이(P08), STEP4 전원부, M3 서포트(P39) 4 + M3×6(P40) 8, 점퍼선 F/F(P20)·M/F(P21), AWG20(P19), UL1007 빨강(P63, ⑧)·노랑(P24, ⑩을 UL1007로 할 때), 레버 커넥터 1개 더(TB3, 3V3용), 100µF(P17, 선택), 폼 양면테이프(P71), 접착 마운트(P28), 케이블타이(P27), 스트리퍼(P49), 스텝드릴(박스 구멍 — 학교 1차 방문), 마스킹테이프
> **소요 시간**: 3~4시간

그림 11. 전장 박스 배치 예시

> 실물 배선 그림은 `../circuit/wiring.svg`, 전기 회로는 `../circuit/schematic.svg`, 원본 연결표는 `../circuit/회로도.html` "③ 연결표"입니다. 아래 표는 그 연결표를 **같은 번호(①~㊱)** 로 옮기고, 이 가이드의 STEP과 대략 길이를 덧붙인 것입니다.

#### 절차 가. 박스 준비

1. 박스의 안쪽 크기(가로·세로·높이)와 속판 크기를 재서 적고, 부품들을 속판 위에 올려 그림 11처럼 배치해 봅니다. 겹치면 조정합니다.
2. **벽 구멍** — 스텝드릴로 뚫습니다(학교 1차 방문). 왼쪽 벽 Ø12(펌프 1·2), 오른쪽 벽 Ø12(펌프 3·4), 뒤 벽 Ø16(어댑터 선 ①, SW1·F1 왕복선 ②·④), 앞 벽 Ø10(앞판의 버튼·LED·부저 선 ㉙~㊱). 높이는 박스 바닥에서 약 20mm.
   - 뒤 벽 구멍으로는 STEP10에서 **어댑터 플러그 머리**가 지나가야 합니다. 플러그 머리 지름에 약 5mm(먼저 지나가 있는 ②·④ 두 가닥)를 더한 값이 16mm보다 크면 구멍을 그만큼 넓힙니다.
   - 박스 **바닥에는 구멍을 뚫지 않습니다**(STEP10에서 벨크로로 고정). 볼트 고정(선택, M3×15 P68 + 너트 P38 — 둘 다 따로 더 주문)을 고른 경우만, 이때(속판을 달기 전) 바닥 **뒤쪽 두 모서리**(박스 좌·우 끝에서 약 10mm, 뒤 끝에서 약 10mm — 선반 D의 선택 구멍과 맞는 자리, 박스 벽 두께를 재서 확인)에 Ø3.5를 뚫습니다(STEP10 절차 1).
   *왜?* 선반 구멍(x 60, x 360)이 박스 양옆에 있고, 전원 부품은 뒤판 G, 버튼·LED는 앞판 F에 있기 때문입니다(그림 4 (다)).
3. **릴레이 고정** — 릴레이의 고정 구멍(Ø3, 간격 약 69.6 × 49.4mm)에 맞춰 속판에 Ø3.5 구멍 4개를 뚫고, M3 서포트 10mm(P39)를 아래에서 M3×6(P40)으로 고정 → 릴레이를 올리고 위에서 M3×6으로 고정합니다.
   *왜 띄우나?* 릴레이 뒷면의 납땜 점이 다른 금속에 닿지 않게 하고, 열이 빠지게 합니다.
4. **ESP32 + 확장보드(P02)** — 확장보드에 동봉 스탠드오프를 달아 속판에 고정하고(나사로 고정하려면 학교 1차 방문에 보드를 대고 표시해 함께 뚫어 둠 — 구멍 없이 스탠드오프 바닥을 폼 양면테이프 P71로 붙여도 됨), ESP32를 확장보드 소켓에 핀 이름이 맞게 꽂습니다(보드의 `3V3`이 확장보드의 `3V3` 표시와 같은 자리). **USB 단자가 박스 앞쪽**을 보게 둡니다.
5. **TB1~TB3, C1, J1** — 폼 양면테이프(P71)로 붙이고, 필요하면 접착 마운트(P28)+케이블타이로 한 번 더 잡습니다. 넣기 전에 ②(J1 +)·④(TB1-8)를 잠시 빼서, G에 달린 쪽 끝이 박스 밖에 남도록 **박스 뒤 벽 Ø16 구멍으로 바깥→안으로** 넣은 뒤 다시 연결합니다.
6. **A안이면 릴레이 JD-VCC 점퍼 캡을 뽑습니다.** **B안이면**(이 STEP은 전원 없이 배선) 아래 연결표의 ⑪은 **연결하지 않고**, ⑨(+5V)를 JD-VCC 핀이 아닌 **입력 헤더 `VCC` 핀**에 꽂은 뒤 점퍼 캡을 끼웁니다(JD-VCC 핀에는 캡만).
   *왜?* 점퍼 헤더는 2핀이라 캡이 두 핀을 모두 덮습니다. 선이 꽂힌 핀에는 캡이 들어가지 않고, ⑨를 빼고 캡만 끼우면 릴레이에 5V가 들어가지 않습니다.

#### 절차 나. 배선 요령

7. 연결표 순서대로 **한 줄씩** 연결하고, 끝날 때마다 표의 □에 체크합니다. 선 양 끝에 번호 테이프(⑦, ⑧ …)를 붙입니다. 선 색은 아래 표의 색(= 회로도 배선도의 색)을 따르면 나중에 찾기 쉽습니다.
   - **UL1007 22AWG는 노랑(P24)·검정(P62)·빨강(P63) 세 색만 삽니다.** GND선(⑦, 앞판 GND 이음점으로 가는 ㉛과 짧은 선 ㉜·㉞·㊱)은 검정, ESP32 5V선(⑧)은 빨강, 그 밖의 UL1007 선(⑩을 UL1007로 할 때, ㉙·㉚·㉝·㉟)은 모두 노랑입니다.
   - *왜?* ⑦(GND)과 ⑧(5V)을 바꿔 물면 ESP32에 거꾸로 전기가 들어가 고장 나므로 색으로 확실히 나눕니다. 노랑 선은 여러 가닥이 같은 색이라 **양 끝 번호 테이프가 유일한 구분 방법**입니다. 자르자마자 번호를 붙이세요.
8. **릴레이 입력 헤더 ↔ 확장보드**: F/F 점퍼선의 한쪽 끝(암 소켓)은 릴레이 핀에 꽂고, 다른 쪽 끝을 잘라 피복을 8mm 벗겨 꼬은 뒤 확장보드 푸시인 단자에 넣습니다. 소켓이 헐거우면 글루건 한 방울로 고정합니다.
9. **릴레이 나사 단자**: 피복 6~7mm, 일자드라이버로 단자를 풀고 넣은 뒤 조이고 당겨 봅니다.
10. 3V3은 **TB3(레버 커넥터)** 에서 나눕니다: ESP32 3V3 → TB3-2(⑩), TB3-1 → 릴레이 VCC(⑪), TB3-3 → 부저 VCC(㉙). ESP32의 GND 단자는 J3-1(⑦), J2-14(⑯), J3-7(㉛)을 하나씩 씁니다.

#### 연결표 (①~㊱ — 회로도.html ③ 연결표와 같은 번호) {#wiring-table}

| □ | 번호 | 출발 | 도착 | 선 (색 · 대략 길이) | STEP | 비고 |
|:-:|:-:|---|---|---|:-:|---|
| [ ] | ① | 어댑터 DC 플러그 | J1 DC잭(암) | (꽂기) | 10 | 뒤판 G의 Ø12 구멍(그로밋) → 박스 뒤 벽 구멍 통과, 장력 완화 묶음 |
| [ ] | ② | J1 **+** 나사 | SW1 단자 1 | AWG20 빨강 25cm | 4 | 박스 뒤 벽 구멍 통과. STEP9에서 J1 쪽을 빼고 STEP10에서 다시 연결 |
| [ ] | ③ | SW1 단자 2 | F1 단자 1 | AWG20 빨강 8cm | 4 | 납땜 + 수축튜브 (뒤판 G 안쪽) |
| [ ] | ④ | F1 단자 2 | **TB1-8** | AWG20 빨강 30cm | 4 | 박스 뒤 벽 구멍 통과. STEP9에서 TB1 쪽을 빼고 STEP10에서 다시 연결 |
| [ ] | ⑤ | J1 **−** 나사 | **TB2-1** | AWG20 검정 15cm | 4 | J1 − 나사에 ⑤·⑦ 함께 조임 |
| [ ] | ⑥ | C1 긴 다리(+) / 띠 다리(−) | **TB1-1** / **TB2-8** | 부품 다리 | 4 | 극성 반대 금지 |
| [ ] | ⑦ | J1 **−** 나사 | ESP32 **GND** (J3-1) | UL1007 검정(P62) 20cm | 4·5 | ESP32 쪽 GND (별형 접지) |
| [ ] | ⑧ | **TB1-7** | ESP32 **5V** (J2-19) | UL1007 빨강(P63) 20cm | 5 | 노란 테이프 "USB 꽂을 때 분리" |
| [ ] | ⑨ | **TB1-6** | A안: 릴레이 **JD-VCC** 핀 (빨간 점) / **B안: 입력 헤더 VCC 핀**(⑪ 자리) | 듀폰 F 빨강 | 5 | A안: 점퍼 캡 빼서 보관 / B안: ⑨를 VCC 핀에 꽂고 캡 끼움 — JD-VCC 핀에는 캡만 |
| [ ] | ⑩ | ESP32 **3V3** (J2-1) | **TB3-2** | 듀폰 주황(양 끝을 잘라 씀) 또는 UL1007 노랑(P24) + 번호 테이프 ⑩, 약 15cm | 5 | 3V3선. 노랑으로 하면 번호 테이프로만 구분 |
| [ ] | ⑪ | 릴레이 입력 헤더 **VCC** 핀 | **TB3-1** | 듀폰 F 주황 | 5 | **B안이면 연결하지 않음**(그 VCC 핀에 ⑨가 들어감, B안에서 3V3 연결 금지) |
| [ ] | ⑫ | ESP32 **GPIO26** (J2-10) | 릴레이 **IN1** | 듀폰 파랑 | 5 | 펌프 1 |
| [ ] | ⑬ | ESP32 **GPIO27** (J2-11) | 릴레이 **IN2** | 듀폰 초록 | 5 | 펌프 2 |
| [ ] | ⑭ | ESP32 **GPIO32** (J2-7) | 릴레이 **IN3** | 듀폰 노랑 | 5 | 펌프 3 |
| [ ] | ⑮ | ESP32 **GPIO33** (J2-8) | 릴레이 **IN4** | 듀폰 보라 | 5 | 펌프 4 |
| [ ] | ⑯ | 릴레이 **GND** 핀 | ESP32 **GND** (J2-14) | 듀폰 F 검정 | 5 | 릴레이 코일 전류(최대 약 0.3A)도 이 선으로 |
| [ ] | ⑰ | **TB1-5** | 릴레이 **K1 COM** | AWG20 빨강 15cm | 5 | |
| [ ] | ⑱ | **TB1-4** | 릴레이 **K2 COM** | AWG20 빨강 15cm | 5 | |
| [ ] | ⑲ | **TB1-3** | 릴레이 **K3 COM** | AWG20 빨강 15cm | 5 | |
| [ ] | ⑳ | **TB1-2** | 릴레이 **K4 COM** | AWG20 빨강 15cm | 5 | |
| [ ] | ㉑ | 릴레이 **K1 NO** | 펌프 1 빨강(+) | 펌프 모듈 연장선 빨강 | 10 | 왼쪽 벽 구멍 |
| [ ] | ㉒ | 펌프 1 검정(−) | **TB2-2** | 펌프 모듈 연장선 검정 | 10 | |
| [ ] | ㉓ | 릴레이 **K2 NO** | 펌프 2 빨강(+) | 펌프 모듈 연장선 빨강 | 10 | 왼쪽 벽 구멍 |
| [ ] | ㉔ | 펌프 2 검정(−) | **TB2-3** | 펌프 모듈 연장선 검정 | 10 | |
| [ ] | ㉕ | 릴레이 **K3 NO** | 펌프 3 빨강(+) | 펌프 모듈 연장선 빨강 | 10 | 오른쪽 벽 구멍 |
| [ ] | ㉖ | 펌프 3 검정(−) | **TB2-4** | 펌프 모듈 연장선 검정 | 10 | |
| [ ] | ㉗ | 릴레이 **K4 NO** | 펌프 4 빨강(+) | 펌프 모듈 연장선 빨강 | 10 | 오른쪽 벽 구멍 |
| [ ] | ㉘ | 펌프 4 검정(−) | **TB2-5** | 펌프 모듈 연장선 검정 | 10 | |
| [ ] | D1~D4 | 1N4007 띠(캐소드) → 펌프 빨강(+) | 반대쪽(애노드) → 펌프 검정(−) | 부품 다리 | 3 | 위치: 박스 쪽 끝에서 약 20cm 앞 Y자 이음(이 가이드) 또는 뚜껑 위 이음부(배선도 그림) — 전기적으로 동일 |
| [ ] | ㉙ | **TB3-3** | 부저 BZ1 VCC | UL1007 노랑(P24) 40cm + 듀폰 F 끝, 번호 테이프 ㉙ (듀폰 주황을 이어 써도 됨) | 10 | 부저를 달 때만. 3V3선 |
| [ ] | ㉚ | ESP32 **GPIO23** (J3-2) | 부저 BZ1 I/O | UL1007 노랑(P24) 40cm + 듀폰 F 끝, 번호 테이프 ㉚ | 10 | |
| [ ] | ㉛ | ESP32 **GND** (J3-7) | 앞판 GND 이음점 | UL1007 검정(P62) 40cm | 9·10 | 짧은 검정 3가닥(㉜·㉞·㊱)과 한 점에서 납땜 |
| [ ] | ㉜ | 부저 BZ1 GND | 앞판 GND 이음점 | 듀폰 F + UL1007 검정(P62) 약 20cm | 9 | 이음점에 납땜 |
| [ ] | ㉝ | ESP32 **GPIO4** (J3-13) | 버튼 SW2 단자 1 | UL1007 노랑(P24) 40cm, 번호 테이프 ㉝ | 10 | 버튼은 방향 없음 |
| [ ] | ㉞ | 버튼 SW2 단자 2 | 앞판 GND 이음점 | UL1007 검정(P62) 약 8cm | 9 | 납땜 |
| [ ] | ㉟ | ESP32 **GPIO2** (J3-15) | R1 220Ω → LED1 긴 다리(+) | UL1007 노랑(P24) 40cm, 번호 테이프 ㉟ | 10 | R1은 LED 다리에 납땜 |
| [ ] | ㊱ | LED1 짧은 다리(−) | 앞판 GND 이음점 | UL1007 검정(P62) 약 8cm | 9 | 납땜 |
| [ ] | (선택) | C2 100µF + / − | 확장보드 5V / GND | 부품 다리 | 5 | 회로도 외 추가 보조(재부팅이 잦을 때만) |

**분배 커넥터 구멍 배정** (그림 10, 회로도와 같음)

| 커넥터 | 1 | 2 | 3 | 4 | 5 | 6 | 7 | 8 |
|---|---|---|---|---|---|---|---|---|
| TB1 (+5V) | C1 + (⑥) | K4 COM (⑳) | K3 COM (⑲) | K2 COM (⑱) | K1 COM (⑰) | JD-VCC (⑨) — B안: 릴레이 VCC | ESP32 5V (⑧) | F1에서 (④) |
| TB2 (GND) | J1 − (⑤) | 펌프1 − (㉒) | 펌프2 − (㉔) | 펌프3 − (㉖) | 펌프4 − (㉘) | 예비 | 예비 | C1 − (⑥) |
| TB3 (3V3) | 릴레이 VCC (⑪) — B안: 비움 | ESP32 3V3 (⑩) | 부저 VCC (㉙) | 예비 | 예비 | 예비 | 예비 | 예비 |

> 참고: 분배 커넥터 배정은 SPEC v2.1 §1·회로도(v3)와 같이 **TB1 = +5V, TB2 = GND, TB3 = 3V3**입니다(예전 자료에 "GND 2개"로 적힌 메모가 있어도 이 배정이 맞습니다). ESP32 GND는 J1 − 나사에서 바로(⑦), 다이오드는 펌프 선에 납땜하므로 GND 레버 커넥터는 TB2 하나로 충분합니다. 구매 수량(4개: 3개 사용 + 예비 1)은 그대로입니다.

#### 절차 다. 배선 후 점검 (전원 없이)

11. 멀티미터 도통 모드로 **⑫~⑮**를 확인합니다: 확장보드의 GPIO26 단자 ↔ 릴레이 IN1 핀 "삐" … GPIO33 ↔ IN4 "삐". 이웃한 핀끼리(IN1 ↔ IN2)는 소리가 **나지 않아야** 합니다.
12. TB1 ↔ 릴레이 K1~K4 COM·JD-VCC, TB3 ↔ 릴레이 VCC(A안)·ESP32 3V3, J1 − ↔ ESP32 GND ↔ 릴레이 GND 핀, TB2 ↔ J1 − 도통 확인. **B안이면** TB1 ↔ 릴레이 `VCC` 핀·`JD-VCC` 핀 **둘 다 "삐"**(캡을 통해), TB1 ↔ TB3는 **무음**이어야 합니다.
13. 펌프(㉑~㉘)·앞판(㉙~㊱)은 STEP10에서 연결합니다. 지금은 박스 벽 구멍에 표시만 해 둡니다.

#### 확인 포인트

- [ ] ✔ 연결표 ②~⑳ 체크 완료 (B안이면 ⑪ 없음, ⑨는 입력 헤더 VCC 핀, 점퍼 끼움)
- [ ] ✔ A안: 점퍼 뽑음 / B안: ⑨가 VCC 핀에, JD-VCC 핀은 캡만 — 릴레이에 적힌 방식과 같음
- [ ] ✔ 신호선 도통 확인, 이웃 핀 단락 없음
- [ ] ✔ ⑧에 "USB 꽂을 때 분리" 노란 테이프
- [ ] ✔ 모든 선 끝에 연결 번호 라벨

#### 흔한 실수

- ⚠ GPIO32/33과 GPIO26/27을 뒤바꿔 꽂기 → 앱에서 "펌프 1"을 눌렀는데 펌프 3이 돕니다. 확장보드 실크 인쇄를 보고 꽂으세요(그림 7: 32·33이 26·27보다 위쪽).
- ⚠ 릴레이 **NO** 대신 **NC**에 펌프 연결 → 전원을 켜자마자 펌프가 계속 돕니다. 보드 인쇄를 확인(전원 없이 도통 모드에서 COM–NC는 "삐", COM–NO는 무음이 정상).
- ⚠ B안(점퍼 끼움)인데 ⑪(VCC ← 3V3)을 그대로 둠 → 5V가 3.3V 쪽으로 들어가 ESP32 손상 위험.
- ⚠ B안에서 ⑨를 JD-VCC 핀에 꽂아 둔 채 캡을 끼우려 함 → 캡이 들어가지 않습니다. ⑨만 빼고 캡을 끼우면 릴레이에 5V가 전혀 안 들어가 4채널 모두 동작하지 않습니다. ⑨를 입력 헤더 VCC 핀으로 옮기세요.
- ⚠ 점퍼선 소켓이 헐거워 진동에 빠짐 → 글루건 한 방울.

### STEP 6. 전원 넣기 전 점검 · 첫 전원 투입 {#step6}

> **목표**: 전원을 넣기 전에 단락·극성 실수를 모두 찾고, 처음 전원을 안전하게 넣어 전압을 확인한다. (이 단계에서는 펌프를 아직 연결하지 않음)
> **어디서 · 난이도**: 집 · ★☆☆
> **준비물**: 멀티미터, 연결표, 그림 6·10·11, 휴대폰(BLE 확인용 — STEP7 절차 나 5의 Serial Bluetooth Terminal 앱을 미리 설치)
> **소요 시간**: 30분

#### 전원 넣기 전 점검표 (어댑터 뽑은 상태)

분배 커넥터는 구멍이 다 차 있어 리드를 댈 곳이 없으면: **TB1 = 릴레이 K1 COM 나사 머리**, **TB2 = J1 − 나사 머리**(또는 STEP4에서 TB2-6에 꽂아 둔 시험 선 끝), **TB3 = 확장보드 3V3 단자**에 댑니다.

| □ | 점검 항목 | 방법 | 정상 |
|:-:|---|---|---|
| [ ] | TB1(5V) ↔ TB2(GND) 단락 없음 | 저항 모드 | 숫자가 커지다 OL (도통 모드면 처음 잠깐 "삐" 후 조용해짐 — C1 충전) |
| [ ] | TB3(3V3) ↔ TB2(GND), TB1 ↔ TB3 단락 없음 | 저항 모드 | 0Ω 근처가 아님(보통 수백 Ω 이상) |
| [ ] | C1 극성 | 눈으로 | + → TB1, 띠(−) → TB2 |
| [ ] | 릴레이 점퍼 상태 | 눈으로 | A안: 캡 없음 / B안: 캡 있음(캡 아래 JD-VCC 핀에 다른 선 없음) |
| [ ] | B안일 때 ⑪(VCC ← 3V3)이 연결 안 됨, ⑨(+5V)가 입력 헤더 VCC 핀에 꽂힘 | 눈으로 | ⑪ 없음, ⑨ = VCC 핀 |
| [ ] | B안일 때 5V 경로 | 도통 모드 | TB1 ↔ 릴레이 VCC 핀·JD-VCC 핀 모두 "삐", TB1 ↔ TB3 무음 |
| [ ] | ESP32의 5V 핀(⑧) 연결, **USB 케이블 뽑힘** | 눈으로 | |
| [ ] | 퓨즈 3A 들어 있음 | 눈으로 | |
| [ ] | 드러난 심선·잘린 선 부스러기 없음 | 눈·손전등 | 박스 안에 금속 조각 없음 |
| [ ] | 모든 나사 단자·레버 잠김 | 당겨 보기 | 레버가 모두 내려가 있음 |
| [ ] | 펌프 선(㉑~㉘)은 아직 연결 안 됨 | 눈으로 | 첫 전원은 펌프 없이 |

#### 첫 전원 투입 절차

1. SW1을 **OFF**로 두고 어댑터를 콘센트에 꽂습니다.
2. 한 손을 SW1에 두고 **ON** → 3초 동안 냄새·연기·"지지직" 소리가 없는지 봅니다. 이상하면 즉시 OFF, 어댑터를 뽑습니다.
3. 전압을 잽니다.

| □ | 측정 위치 | 정상값 |
|:-:|---|---|
| [ ] | TB1 ↔ TB2 | 4.9~5.25 V |
| [ ] | 확장보드 5V ↔ GND | 4.8~5.25 V |
| [ ] | 확장보드 3V3 ↔ GND (= TB3 ↔ TB2) | 3.2~3.4 V |
| [ ] | 릴레이 VCC ↔ GND | A안 약 3.3 V / B안 약 5 V |
| [ ] | 릴레이 JD-VCC ↔ GND | 약 5 V |

4. ESP32의 빨간 전원 LED가 켜져 있는지 봅니다. 휴대폰 블루투스 앱(STEP7의 Serial Bluetooth Terminal)으로 검색했을 때 `SmartBartender-XXXX`가 보이면 ESP32가 어댑터 전원으로 정상 동작하는 것입니다.
5. 5분 뒤 손등으로 ESP32·릴레이·J1·퓨즈홀더·레버 커넥터를 살짝 대 봅니다. ESP32는 미지근해도 괜찮고, **나머지가 뜨거우면** 즉시 끄고 배선을 확인합니다.
6. SW1 OFF.

#### 확인 포인트

- [ ] ✔ 점검표 전 항목 통과
- [ ] ✔ 전압 5개 모두 정상 범위
- [ ] ✔ 블루투스 검색에 장치 이름이 보임
- [ ] ✔ 5분 후 이상 발열 없음

#### 흔한 실수

- ⚠ 점검 없이 펌프까지 다 연결하고 첫 전원 → 문제가 생겼을 때 원인을 찾기 어렵습니다. 첫 전원은 펌프 없이.
- ⚠ 3V3이 0V → ESP32 5V 핀 연결(⑧) 확인, 확장보드에 ESP32가 끝까지 꽂혔는지 확인.

### STEP 7. 펌웨어 업로드 · 앱 블루투스 연결 {#step7}

> **목표**: 조립된 상태에서 안전하게 펌웨어를 올리는 방법을 익히고, 휴대폰 앱과 블루투스로 연결해 릴레이를 움직인다.
> **어디서 · 난이도**: 집 · ★☆☆
> **준비물**: PC + USB 케이블, 안드로이드 휴대폰(갤럭시 등, 블루투스 켜기), 바텐더 앱 v3.1(APK — [https://github.com/paperji/smart-bartender/releases/latest](https://github.com/paperji/smart-bartender/releases/latest) 의 `SmartBartender-버전.apk`, 또는 휴대폰·PC Chrome 으로 웹앱 [https://paperji.github.io/smart-bartender/](https://paperji.github.io/smart-bartender/)), Serial Bluetooth Terminal 앱(Play 스토어, 무료)
> **소요 시간**: 1시간

#### 절차 가. 조립 상태에서 펌웨어 올리기 (나중에 펌웨어를 고칠 때마다 이 순서)

1. **SW1 OFF** → 어댑터를 콘센트에서 뽑습니다.
2. 박스 뚜껑을 열고 **TB1-7의 ⑧(노란 테이프) 레버를 올려 선을 뺍니다.**
   *왜?* USB 5V와 어댑터 5V가 ESP32의 5V 줄에서 만나지 않게 하기 위해서입니다(SPEC §1 "USB 업로드 시 5V 선 분리").
   - **뺀 ⑧ 끝을 바로 절연합니다.** 이 끝(ESP32 5V 핀에 연결된 맨 심선)은 USB를 꽂으면 전기가 흐릅니다. 수축튜브 캡(P26 조각을 씌우고 끝을 접음)이나 절연·마스킹테이프로 끝을 감싸고, 릴레이 나사 단자·J1 나사에서 먼 박스 벽에 테이프로 붙여 둡니다. 다시 꽂을 때 테이프를 벗깁니다.
     *왜?* 이 끝이 J1 − 나사(GND)에 닿으면 USB 단락(PC 포트 보호 동작), 릴레이 COM 나사(+5V)에 닿으면 금지한 이중 전원 상태가 됩니다. 박스 안이 좁아 닿기 쉽습니다.
3. USB 케이블을 ESP32에 꽂고 STEP2 절차 가와 같이 업로드 → 시리얼 모니터에서 `{"cmd":"hello"}`로 확인합니다. (STEP2에서 이미 올렸고 펌웨어가 바뀌지 않았다면 건너뜁니다.)
4. USB를 뽑고 → **⑧ 끝의 테이프(캡)를 벗기고 TB1-7에 다시 꽂은 뒤 레버를 내립니다** → 어댑터 → SW1 ON.
   - 캘리브레이션 값은 플래시의 별도 영역에 저장되어 펌웨어를 다시 올려도 유지됩니다.
   - **디버깅 팁**: ⑧을 빼고 **끝을 절연해 둔 상태에서만** USB를 꽂은 채 SW1을 켜도 안전합니다(ESP32는 USB, 릴레이·펌프는 어댑터 — STEP2와 같은 구성). 이때 시리얼 모니터로 동작 로그를 보며 시험할 수 있습니다. 이 상태에서는 다이오드가 반대로 달린 펌프가 있으면 단락이 계속되므로(ESP32가 USB로 켜져 있어 리셋되지 않고 릴레이가 계속 붙어 있음) STEP3에서 방향을 확인한 펌프만 연결합니다. 끝나면 USB를 뽑고 테이프를 벗긴 뒤 ⑧을 다시 꽂으세요.

#### 절차 나. 테스트 앱으로 블루투스 확인 (앱 없이)

5. 휴대폰에 **Serial Bluetooth Terminal**(Kai Morich)을 설치 → 메뉴 **Devices → BLUETOOTH LE → SCAN** → `SmartBartender-XXXX` 선택. 기기의 상태 LED가 천천히 깜빡임 → **계속 켜짐**으로 바뀝니다.
6. 메뉴 Settings → Send → 줄바꿈(Newline)을 **LF**로. `{"cmd":"hello"}` 전송 → `{"ev":"info",...}` 수신.
7. `{"cmd":"run","p":1,"ms":1000}` … p 2~4 → 릴레이가 딸깍합니다(펌프는 아직 미연결).
8. 연결을 끊습니다(한 번에 휴대폰 한 대만 연결됩니다).
   - 휴대폰 **블루투스 설정 화면에서 "페어링"하지 마세요.** 앱에서 직접 연결합니다.

#### 절차 다. 바텐더 앱 연결

9. 앱 설치: GitHub Releases [https://github.com/paperji/smart-bartender/releases/latest](https://github.com/paperji/smart-bartender/releases/latest) 에서 최신 `SmartBartender-버전.apk` 를 휴대폰으로 내려받아 열고 설치합니다("출처를 알 수 없는 앱" 허용 — `../../app/README.md` 3-3 "휴대폰에 설치"). APK 를 직접 만들려면 같은 3-3 의 `npm run build:android`.
    - 설치 없이 쓰려면 휴대폰(안드로이드)·PC 의 **Chrome·Edge** 로 웹앱 [https://paperji.github.io/smart-bartender/](https://paperji.github.io/smart-bartender/) 을 엽니다. 아이폰(사파리)은 블루투스가 안 됩니다.
10. 처음 연결할 때 **근처 기기(블루투스)** 권한(안드로이드 11 이하는 위치), 첫 제조 때 **알림(제조 완료 알림)** 권한을 허용합니다. 날씨 자동 채우기를 쓰려면 **위치(대략적 위치)** 도 허용합니다.
11. **기기 탭 → 데모 모드 끄기 → 주변 기기 검색 → `SmartBartender-XXXX`** 를 누르면 연결됩니다(웹앱은 **기기 선택 (브라우저 창)** → 브라우저 창에서 고르기). 기기 정보(펌웨어 2.1.x, 펌프 4개, 유량표)가 보이면 성공. (화면 설명: `../../app/README.md` 4-2 "기기 연결 · 기기 변경")
    - 목록에 기기가 여러 개 보이면 STEP2에서 적어 둔 이름을 고릅니다(신호 세기가 가장 센 것이 보통 가장 가까운 기기). 앱(APK)이 마지막 기기를 기억해 다음부터는 앱을 켜면 자동으로 다시 연결합니다(웹앱은 브라우저에 따라 다시 골라야 할 수 있음). 바꾸려면 기기 탭의 **다른 기기로 변경**.
    - 아직 캘리브레이션 전이므로 바텐더·기기 탭에 **"캘리브레이션 전 — 실제보다 적게 나올 수 있어요"** 배너가 보이는 것이 정상입니다. STEP11을 마치면 사라집니다.
12. **재료 탭**: 펌프 1~4에 지금은 모두 "물"(종류: 물, 도수 0)을 등록합니다. 실제 재료는 STEP11 이후에 바꿉니다.
13. 기기 탭의 **프라이밍** 버튼을 길게 눌러 해당 릴레이가 켜지는지(딸깍) 확인합니다.

#### 확인 포인트

- [ ] ✔ ⑧ 분리·끝 절연 → USB 업로드 → 테이프 벗기고 ⑧ 재연결 순서를 팀원 모두가 알고 있음
- [ ] ✔ 테스트 앱으로 `hello` 응답 확인
- [ ] ✔ 바텐더 앱에서 연결, 기기 정보 표시, 상태 LED 계속 켜짐
- [ ] ✔ 앱 프라이밍으로 릴레이 4개 동작
- [ ] ✔ "캘리브레이션 전" 배너가 보임(지금은 정상)

#### 흔한 실수

- ⚠ ⑧을 다시 꽂지 않고 USB만 뽑음 → 어댑터로 켜도 ESP32가 꺼져 있습니다(블루투스 안 보임).
- ⚠ 다른 휴대폰이 이미 연결돼 있으면 목록에 안 보입니다. 그 연결을 끊거나 EN 버튼으로 재시작.
- ⚠ 안드로이드 12 이상에서 "근처 기기" 권한을 거부하면 검색이 안 됩니다. 앱 설정에서 권한 허용.

### STEP 8. 배관 (튜브 · 체크밸브 · 누수 테스트) {#step8}

> **목표**: 펌프 모듈 4개에 튜브와 체크밸브를 연결하고, 외형에 넣기 전에 책상 위(대야 안)에서 누수·역류 테스트를 끝낸다. 노즐 연결은 STEP10에서 한다.
> **어디서 · 난이도**: 집 · ★★☆
> **준비물**: 펌프 모듈 4(STEP3), 내경5 튜브(P29) 약 3m, 내경4 튜브(P30) 약 0.7m, 체크밸브(P31) 4, 케이블타이(P27), 색 테이프(색 절연테이프) 또는 마스킹테이프, 뜨거운 물 한 컵(튜브만 담금), 큰 대야, 키친타월
> **소요 시간**: 2~3시간

그림 12. 액체 경로도

> 그림 12의 노즐(M1, 출구 z 230, 튜브 3mm 돌출)은 포맥스 노즐 판 기준입니다. 출력 노즐 블록 02는 튜브를 블록 아래로 10mm 내려 **튜브 끝이 z 220**(최대 액면 z 160보다 60mm 높음)입니다(STEP10 절차 7).

**액체 경로(SPEC §1)**: 용기(뚜껑에 Ø3 공기 구멍) → 펌프 출수구(외경 7.5 / 내경 4.9mm) → **내경5/외경7 실리콘 튜브** → (내경4 튜브 3cm 슬리브로 이음) → **체크밸브**(노즐 바로 앞, 화살표가 노즐 쪽) → 노즐. 노즐 출구는 모든 용기의 최대 액면보다 높게.

#### 튜브 재단표 (펌프 1개당, 4세트)

| 부분 | 튜브 | 길이 | 비고 |
|---|---|---|---|
| ② 펌프 → 체크밸브 | 내경5/외경7 (P29) | **70cm** | 실제 배치 후 남으면 STEP10에서 잘라 냄 |
| ③ 겹침 이음 슬리브 | 내경4/외경6 (P30) | **3cm** | 밸브 입구 바브에 1cm, 나머지 2cm에 내경5 튜브를 겹침 |
| ⑤ 체크밸브 → 노즐 | 내경4/외경6 (P30) | **15cm** (길게 자르고 STEP10에서 맞춤) | 최종 약 10~13cm |

*튜브는 가위나 니퍼 대신 **커터칼로 직각으로** 자릅니다. 비스듬히 잘리면 노즐에서 물줄기가 옆으로 휩니다.*

시음을 위해 식품용 부품(선택 P65 → P29 자리, P66 → P30 자리, P67 → P31 자리, [1.3](#food))으로 바꿀 때도 길이·잇는 방법은 이 표와 같습니다. 바꾼 뒤에는 이 STEP의 누수·역류 테스트(절차 7)와 STEP11 캘리브레이션을 다시 합니다(밸브 개방압·유로가 달라 유량이 바뀔 수 있음).

#### 절차

1. **번호 색 표시** — 튜브 양 끝에 색 테이프를 한 바퀴 감아 펌프 번호를 표시합니다(예: 1 빨강, 2 노랑, 3 파랑, 4 초록). 색이 없으면 마스킹테이프에 번호.
2. **튜브를 뚜껑에 통과** — 내경5 튜브 끝을 뚜껑 **위에서 아래로** Ø7 구멍에 통과시킵니다.
3. **펌프 출수구에 끼우기** — 튜브 끝을 뜨거운 물에 10초 담갔다가 펌프 출수구(외경 7.5mm)에 **끝까지(약 8mm)** 밀어 넣습니다. *왜 뜨거운 물?* 실리콘이 부드러워져 쉽게 늘어나고, 식으면 다시 조여 새지 않습니다.
4. 펌프가 용기 바닥에 닿았을 때 튜브가 꺾이지 않는지, 뚜껑을 잡고 **몸통을 돌려** 닫을 수 있는지 확인하고, 뚜껑 위 Ø7 구멍 둘레를 글루건으로 살짝 고정합니다(튜브가 미끄러져 펌프가 들리지 않게).
5. **겹침 이음 + 체크밸브(그림 12 확대도)**
   1. 내경4 튜브 3cm를 체크밸브 **입구 바브**(화살표 시작 쪽)에 1cm 끼웁니다.
   2. 내경5 튜브의 다른 끝을 뜨거운 물에 담근 뒤, 그 내경4 슬리브 위로 **1.5cm 이상** 겹쳐 끼웁니다.
   3. 케이블타이로 ① 겹친 부분(내경5 위) ② 바브 위(슬리브 위)를 조이고 꼬리를 자릅니다.
   4. 체크밸브 **출구 바브**에 내경4 튜브 15cm를 끼우고 케이블타이로 조입니다.
   *왜 이렇게 잇나?* 펌프 출수구는 내경5 튜브에, 체크밸브 바브(Ø3.2~5.0)는 내경4 튜브에 맞습니다. 내경4 튜브의 바깥지름(6mm)이 내경5 튜브 안(5mm)에 꽉 끼므로, 어댑터 없이 보유 튜브만으로 이을 수 있습니다.
6. **화살표 방향 재확인** — 체크밸브의 화살표(FLOW)가 **펌프에서 멀어지는 쪽(노즐 쪽)** 을 가리켜야 합니다. 거꾸로면 액체가 한 방울도 나오지 않습니다.
7. **누수 테스트(대야 위)**
   1. 용기 4개에 물을 반쯤(약 500ml) 채우고 펌프 모듈 뚜껑을 닫습니다(뚜껑을 잡고 몸통을 돌림). 출구 튜브 끝을 각각 컵에 넣고, 체크밸브가 용기 뚜껑보다 높게(약 10cm 위) 오도록 들어 올려 잡습니다(실제 배치와 비슷하게).
   2. **SW1 OFF, 어댑터를 뽑고** 펌프 선을 박스에 임시 연결합니다: 빨강 → 릴레이 K1~K4 NO, 검정 → TB2-2~5 (연결표 ㉑~㉘). 다 이은 뒤 어댑터를 꽂고 SW1 ON.
   3. 앱의 기기 탭 → **프라이밍**(길게 누르기)으로 각 펌프를 튜브가 물로 찰 때까지 돌립니다. 처음에는 공기가 빠지느라 몇 초 걸립니다.
   4. `{"cmd":"run","p":1,"ms":10000}` 또는 앱 프라이밍으로 10초씩 돌리며, 이음부마다 **마른 키친타월**을 감아 젖는지 봅니다.
   5. 펌프를 멈춘 뒤 출구 튜브 끝을 위로 들어 보세요. 밸브 아래쪽 튜브의 물이 **빠지지 않고** 남아 있으면 체크밸브가 제대로 닫히는 것입니다.
8. 새는 곳은 케이블타이를 한 번 더 감거나, 튜브를 1cm 잘라 새 단면으로 다시 끼웁니다.
9. (참고 측정) 체크밸브를 단 상태의 10초 유량을 재서 적습니다. 약 30~60ml(3~6 ml/초, 추정)이 예상값입니다. 3 ml/초보다 훨씬 적으면 [4장 문제 해결](#s4)을 보세요.

#### 확인 포인트

- [ ] ✔ 4세트 모두 체크밸브 화살표가 노즐 쪽
- [ ] ✔ 10초 구동 시 세트마다 이음부 4곳(펌프 출수구 · 겹침 이음 · 체크밸브 입구 바브 · 출구 바브) 모두 마름
- [ ] ✔ 멈춘 뒤 밸브 아래 튜브에 물이 남아 있음(역류·드립 방지 확인)
- [ ] ✔ 튜브 번호 색 표시
- [ ] ✔ 체크밸브 포함 10초 유량: 1 ____ / 2 ____ / 3 ____ / 4 ____ ml

#### 흔한 실수

- ⚠ 체크밸브 거꾸로 — 가장 흔한 실수입니다. 설치 직후 바로 확인.
- ⚠ 펌프를 물이 거의 없는 용기에서 돌림 → 공기를 빨아 유량이 0이 되고 펌프가 공회전합니다. 액면은 최소 약 30mm.
- ⚠ 튜브가 납작하게 꺾임 → 유량 감소. 구부릴 때는 크게(반지름 1cm 이상) 돌립니다.
- ⚠ 펌프 출수구에 내경4 튜브를 억지로 끼우기 → 너무 빡빡해 출수구가 부러질 수 있습니다. 출수구는 내경5.

### STEP 9. 외형 제작 (재단 · 구멍 · 앞판 · 조립 · 방수) {#step9}

> **목표**: 포맥스 5T로 본체를 만든다(W420 × D260 × H380). 구멍을 모두 뚫은 뒤 조립하고, 액체가 닿는 이음새를 방수 처리한다.
> **어디서 · 난이도**: 학교 실습실(판 구멍 · 앞판 납땜 — [2차 방문](#school2)) + 집(재단 · 조립 · 방수) · ★★★
> **준비물**: 포맥스(P34) 3장 또는 재단된 판 A~L·N, **출력 브래킷 01** 12(+예비 2), **출력 그로밋 04** 2, **출력 베젤 03** 1 + 라벨 스티커 2장, **출력 상판 모서리 캡 06** 4, **출력 노즐 블록 02** 1(확인만, 붙이는 것은 STEP10), M3×10 볼트(P37)·너트(P38) 24쌍(+예비), 순간접착제(P42), 글루건+스틱(P43), 폼 양면테이프(P71), 네오디뮴 자석(P45) 2 · 접착식 철판(P80) 2(상판 C도 자석으로 붙이면 P69로 자석·철판 1팩씩 더, 선택), 고무발(P41) 4, 버튼(P03), LED(P05)+R1(P06), 부저(P04, 선택), 앞판 선: UL1007 노랑(P24) 40cm × 4 + 검정(P62) 40cm 1가닥과 짧은 검정 3가닥(8cm × 2 · 20cm × 1), 듀폰 F/F(P20) 3가닥, 수축튜브(P26), 인두·실납(학교), 드릴·스텝드릴, 커터칼(대)·쇠자 60cm·커팅매트·직각자, 연필, 사포
> **소요 시간**: 6~8시간 (재단 주문 시 3~4시간) + 접착제 굳는 시간

그림 13. 패널 재단 배치도 (직접 자를 때 — 판 3의 M1·M2 노즐 판은 자르지 않음)

그림 14. 외형 조립 순서 (판 붙이는 순서 — ④의 "노즐 블록 M1·M2" 표시는 예전 방식이라 건너뜀, 출력 부품 위치는 부록 D 그림 17)

#### 절차 가. 판 준비

1. **판 확인** — 산 포맥스(P34)가 맞춤 재단 판이면 [부록 B 재단표](#appB)의 치수·수량과 맞는지 줄자로 잽니다(오차 ±1~2mm).
   **600×900 통판이면 직접 재단**: 그림 13대로 연필로 모든 선과 기호를 먼저 그린 뒤, 쇠자(60cm 이상)를 대고 커터칼(대)로 5~6번 그어 꺾어 자릅니다. 긴 직선부터, 작은 부품은 나중에. 판 3의 노즐 판 M1·M2는 자르지 않습니다. 뒤판 G는 STEP4 때 이미 잘랐습니다.
   *왜 여러 번?* 포맥스는 한 번에 세게 자르면 칼이 휘어 단면이 비뚤어집니다.
2. 모든 판의 **안쪽 면**에 연필로 기호(A, B좌, B우 …)와 "앞" 방향 화살표를 적습니다. 단면은 사포로 살짝 다듬습니다.
3. 재단된 판을 바닥에 놓고 직각자로 네 모서리가 직각인지 확인합니다.

#### 절차 나. 구멍 가공 (조립 전에 모두 뚫기)

판의 **왼쪽 아래 모서리를 기준(앞에서 볼 때)** 으로 잰 위치입니다. A·B·C·D의 y는 절차 가 2에서 그린 **"앞" 화살표 쪽 끝**에서 잽니다. **B좌·B우는 서로 거울 모양**(안쪽 면끼리 마주 봄)이므로, 두 장을 안쪽 면이 위로 오게 나란히 놓고 각각 "앞" 끝에서 잽니다. 구멍은 송곳으로 중심을 찍고 → Ø3 드릴 날로 안내 구멍 → Ø3.5는 일반 드릴 날, 더 큰 구멍은 스텝드릴로 넓힙니다.

| □ | 판 | 구멍 | 위치 (판 기준) | 용도 |
|:-:|---|---|---|---|
| [ ] | D 선반 410×250 | Ø20 × 2 | 왼쪽 끝에서 55 / 오른쪽 끝에서 55, **뒤쪽 끝에서 35** | 펌프 선 통로 + 그로밋(출력 04) |
| [ ] | D 선반 (선택) | Ø3.5 × 2 | 왼쪽 끝에서 110 / 290, 뒤쪽 끝에서 75 | 전장 박스를 **볼트로** 고정할 때만(M3×15 P68, STEP10 절차 1). 벨크로(P64)로 고정하면 뚫지 않음 |
| [ ] | E 칸막이 410×255 | Ø25 × 1 | 가로 가운데(205), **위쪽 끝에서 17** | 튜브 4가닥 통로 + 튜브 부싱(출력 07) |
| [ ] | F 앞판 상부 410×115 | Ø16 / Ø5 | **앞(바깥)면을 보며** 오른쪽 끝에서 70 / 110, 높이 가운데(57.5) | 버튼 SW2 / LED1 — 바깥면에 "앞(바깥)"이라고 써 둠 |
| [ ] | G 뒤판 상부 410×115 | Ø12 / 사각 / Ø(실측) | **뒤에서 볼 때** 왼쪽 끝에서 40 / 90 / 140, 높이 가운데 | 어댑터 선(그로밋 05) / SW1 / F1 — **STEP4 절차 2에서 미리 뚫음** |
| [ ] | H 뒤 덮개 408×253 | Ø25 (선택) | 가로 가운데, 위쪽 끝에서 25 | 손가락 걸이 |
| [ ] | A 바닥판 · B 측판 · D · C | Ø3.5 | 출력 브래킷 01은 구멍이 바깥 모서리에서 16mm라 위치가 정해짐: **A** 좌·우 끝에서 21, 앞쪽 끝에서 45·90 / **B 아래** 아래 끝에서 16, y 45·90 / **D** 좌·우 끝에서 16, 앞쪽 끝에서 145·215 / **B 가운데** 아래 끝에서 276(선반 D 윗면 z 260 + 16), y 150·220 / **C** 좌·우 끝에서 21, 앞쪽 끝에서 60·200 / **B 위** 위 끝에서 16, y 60·200. 연필로 표시한 자리에 브래킷을 대 보고 확인한 뒤 **판을 붙이기 전에 판만 따로** 뚫음(재단 오차 ±1~2mm). **B는 절차 다 ①에서 A에 붙으므로 B 좌·우의 구멍(한쪽 6개: 아래·가운데·위)을 ① 전에 모두** 뚫고, A는 ① 전, D는 ④ 전, **C도 이때(조립 전) 표 위치대로** 뚫어 둠 — 조립 뒤 브래킷과 1~2mm 어긋나면 줄로 넓힘 | M3 볼트 |

- G판의 사각 구멍(로커 스위치)은 STEP4에서 잰 크기보다 **0.5mm 작게** 4모서리에 Ø3 구멍을 뚫고 커터칼로 잇고, 줄·사포로 넓혀 가며 스위치가 "딸깍" 끼워질 때까지 맞춥니다.
- G판은 뒤에서 볼 때와 앞에서 볼 때 좌우가 바뀝니다. **G판 바깥면에 "뒤(바깥)"라고 써 두고** 바깥면을 보며 위치를 잽니다.
- **출력 그로밋 04(Ø20용)·05(Ø12용)** 는 판 두께 5mm에 맞춰 출력한 것이고, 옆이 3.5mm 트여 있어 **배선을 마친 뒤 케이블에 옆으로 끼울 수 있습니다**. 그래서 어댑터 플러그가 그로밋 구멍을 통과할 필요가 없고, G의 Ø12 구멍은 플러그 머리가 지나갈 크기면 됩니다(머리가 12mm보다 크면 구멍을 키우고 05는 `../3dprint/parts.py`의 구멍 값을 바꿔 다시 출력).

#### 절차 다. 조립 (그림 14 순서)

> 접착: 포맥스끼리는 **순간접착제(P42)** 로 맞대어 붙이고(10초 누름), 굳은 뒤 안쪽 모서리를 **글루건**으로 한 줄 더 보강합니다. 힘을 받는 곳은 **출력 브래킷 01 + M3×10 볼트·너트**로 고정합니다(포맥스에 목나사는 잘 빠짐).
> **출력 브래킷 01 쓰는 법**: M3 너트를 브래킷 안쪽 면의 **육각 홈 2곳(다리마다 1곳)** 에 하나씩 미리 눌러 끼웁니다(헐거우면 순간접착제 한 방울). 브래킷 1개에 볼트·너트 2쌍이 들어갑니다. 브래킷의 **바깥 모서리(모따기 쪽)** 를 두 판이 만나는 안쪽 모서리에 대고, 볼트는 **판 바깥에서** 넣어 브래킷 속 너트로 조입니다(볼트 끝이 너트 위로 약 0.6mm 나옴). 너트 홈을 판 쪽으로 대면 너트가 막혀 들어가지 않습니다. 브래킷이 들어가는 이음새는 **볼트를 먼저 조여 두 판의 위치를 맞춘 뒤** 이음새를 따라 순간접착제를 바릅니다. *왜?* 구멍을 미리 뚫어 두었으므로, 먼저 붙였다가 판이 1~2mm만 어긋나도 볼트가 들어가지 않고 굳은 뒤에는 고칠 수 없습니다.

4. **① 바닥판 A + 측판 B 좌·우** — B를 A 위 양끝(x 0~5, 415~420)에 세워 붙이고, 안쪽 모서리에 브래킷을 한쪽에 2개씩(**y 45, 90** 위치 — 용기가 놓이지 않는 앞쪽 빈 공간, 바닥 아래 볼트 머리가 앞쪽 고무발과 겹치지 않는 자리) 볼트로 고정합니다. 직각자로 A와 B가 90°인지 확인.
   *왜 앞쪽에?* 용기 칸(y 110~255) 바닥에 브래킷이 있으면 용기가 기울어집니다.
5. **② 칸막이 E + 걸림턱 L + 가이드 N** — E를 y 105~110 위치에 세워 A·B에 붙입니다(구멍이 위쪽, 가운데). L(410×15)은 A 위 뒤쪽 끝(y 250~255)에 **세워서** 붙입니다(뒤 덮개가 안으로 밀려 들어오지 않게). N 3개는 용기 사이(x 약 107, 210, 312)에 세워 붙여 용기가 미끄러지지 않게 합니다. 970ml 용기는 폭이 80mm라 칸(약 98mm) 안에서 좌우로 18mm쯤 움직이므로 **N을 붙이는 것을 권장**합니다.
6. **③ 앞판 하부 I + 잔 칸 옆벽 J + 받침대 K** — I 좌·우를 앞면(y 0~5)에, J 좌·우를 x 130~135 / 285~290에 세워 E와 I에 붙입니다(잔 칸 폭 150). K 2개를 측판 안쪽 용기 칸 구간(y 110~255) 높이 z 235~255에 붙입니다(선반 받침).
7. **④ 선반 D** — 출력 그로밋 04 2개를 D의 Ø20 구멍에 끼운 뒤(D가 따로 있는 지금이 양쪽에서 눌러 넣기 쉬움), D를 I·J·E·K 위에 얹어 붙입니다(z 255~260). 선반 위쪽(전장부)에서 D와 B를 브래킷 2개씩(총 4개)으로 고정합니다. 브래킷은 **용기 칸 위 구간(y 150·220)** 의 선반 위에 놓고, 볼트를 **D 아래에서 위로**(뒤쪽 개구부 = H 자리, 아직 열려 있음으로 손을 넣어) 넣어 브래킷 위쪽 홈의 너트에 조입니다. 너트가 위에 있어 손이 쉽게 닿습니다.
   *왜 뒤쪽에?* D의 앞쪽(y 105 이하) 아래는 이미 붙인 I·J·E·B·A로 막힌 빈 공간이라 손이 닿지 않습니다.
   **노즐 블록**: 출력 노즐 블록 02는 만들 필요가 없고, 선반에는 **STEP10에서 튜브를 끼운 뒤** 붙입니다.
   *왜 나중에?* 선반에 먼저 붙이면 좁은 틈(20mm)에서 튜브를 구멍에 넣기가 매우 어렵습니다.
8. **⑤ 앞판 상부 F + 뒤판 상부 G** — F에 부품을 달고 선을 이은 뒤(그림 14-1) F를 붙입니다. F를 붙이기 **전에**, 책상 위에서 합니다.

   그림 14-1. 앞판 F 안쪽 배선 (납땜 기준)

   **앞판 결선 (학교 실습실 — [2차 방문](#school2))** — 납땜할 때마다 **수축튜브를 먼저** 끼웁니다.
   1. F에 버튼(P03)을 끼워 뒤에서 너트로 조입니다. **납땜하기 전에** 멀티미터 도통 모드로 **누를 때만 "삐"** 나는 두 단자를 찾아 "1"·"2"를 적습니다(단자가 3개 이상이면 나머지는 버튼 조명용일 수 있음).
   2. LED를 Ø5 구멍에 앞에서 밀어 넣어 뒤에서 글루건으로 고정합니다. LED의 긴 다리(+)에 R1 220Ω을 납땜하고 수축튜브로 덮습니다. 부저(P04, 선택)는 F 안쪽에 폼 양면테이프(P71) + 글루건으로 붙입니다.
   3. **앞판 GND 이음점**: 먼저 ㉛(40cm)에 굵은 수축튜브 1개, 짧은 검정 3가닥의 부품 쪽 끝에 가는 튜브를 하나씩 끼워 둡니다. 짧은 검정 UL1007(P62) **㉞·㊱ 각 약 8cm**는 버튼 단자 2·LED 짧은 다리에 납땜하고, **㉜ 약 20cm**(부저 위치에 맞춰)는 끝에 듀폰 F를 납땜해 부저 GND 핀에 꽂습니다. 세 가닥의 다른 끝과 박스로 가는 검정 ㉛의 끝을 **한데 꼬아 한 점에서 납땜**하고, ㉛에 끼워 둔 굵은 수축튜브로 덮습니다(그림 14-1). *왜 한 점?* 선 중간 피복을 벗길 필요가 없고 수축튜브 하나로 끝납니다.
   4. 신호선 **노랑 UL1007(P24)** 40cm 4가닥: 버튼 단자 1(㉝), R1의 다른 끝(㉟), 부저 I/O(㉚), 부저 VCC(㉙)를 납땜·연결해 둡니다(부저 핀 쪽은 듀폰 F 끝을 납땜해 핀에 꽂음). 4가닥이 모두 노랑이므로 **자르자마자 양 끝에 번호 테이프(㉙·㉚·㉝·㉟)** 를 붙이고, 납땜할 때 번호를 보며 잇습니다.
   5. **점검(전원 없이)** — 멀티미터 도통 모드로 노랑 ㉝ 끝 ↔ 검정 ㉛ 끝: 버튼을 누를 때만 "삐". 노랑 ㉙ ↔ ㉛, 노랑 ㉟ ↔ ㉛: "삐"가 계속 나면 단락.

   그다음 F를 y 0~5, z 255~370에 붙입니다.
   - **앞면 베젤(출력 03)**: F를 붙인 뒤 베젤을 버튼·LED 위로 씌워 **폼 양면테이프(P71)** 로 F 바깥면에 붙입니다(순간접착제는 쓰지 않음 — LED 테가 베젤 뒤 홈에 물려 있어, LED를 바꾸거나 다시 납땜할 때([4장](#s4) '상태 LED가 안 켜짐')는 베젤을 떼야 함). 베젤의 Ø18.8 구멍으로 버튼 머리가 지나가므로 버튼은 F 판에만 고정되고(베젤 두께와 상관없이 너트가 물림), LED 테는 베젤 뒤쪽 홈에 들어갑니다. 라벨 홈에 "정지/시작"·"상태" 스티커를 붙입니다.
   - **G 붙이기**: G에는 STEP4에서 SW1·F1이 끼워져 납땜되어 있습니다. 먼저 **어댑터를 콘센트에서 뽑고**, ②를 J1 + 나사에서, ④를 TB1-8에서 빼 박스 뒤 벽 구멍 밖으로 빼냅니다(끝에 ②·④ 번호 테이프, 드러난 심선은 테이프로 감쌈). 그다음 G를 바깥면("뒤(바깥)")이 밖을 보게 y 255~260에 붙입니다. ②·④는 STEP10에서 다시 연결하고, G의 Ø12 그로밋도 STEP10에서 끼웁니다.
9. **⑥ 상판 C(탈착)** — **C는 접착하지 않습니다**(전장부 정비용).
   1. **너트 미리 붙이기(캡티브 너트)** — 출력 브래킷 01 4개를 B에 달기 **전에**, 각 브래킷의 가로 다리(C가 얹힐 쪽) 육각 홈에 M3 너트를 넣고(조립하면 홈이 아래를 봄) 홈 테두리에 순간접착제를 조금 바릅니다. 식용유나 바셀린을 살짝 묻힌 M3×10 볼트를 홈 반대쪽 평평한 면에서 너트에 끝까지 돌려 넣은 채 굳히고(약 10분), 굳으면 볼트만 빼 둡니다(기름 때문에 접착제가 볼트에 붙지 않고, 나사산이 막히지 않음).
      *왜?* C를 얹으면 전장부(선반 위 칸)가 B·F·G·D·C로 사방이 막혀 손이 들어가지 않으므로, 브래킷 아래 너트를 손으로 잡을 수 없습니다. 너트를 붙여 두면 처음 조일 때도, 정비 때(STEP7 ⑧ 분리·USB 업로드) C를 풀 때도 위에서 볼트만 돌리면 되고, 빠진 금속 너트가 릴레이 나사 단자·레버 커넥터 위로 떨어져 단락될 일도 없습니다.
   2. 브래킷을 측판 B 안쪽 맨 위에 좌우 2개씩, **y 60·200**(상판 모서리 캡과 겹치지 않게)에 볼트·너트로 답니다(가로 다리 윗면 = B 윗면 높이, 붙인 너트는 아래쪽). 이 볼트는 B 바깥에서 넣어 세로 다리 홈의 너트에 조입니다.
   3. C의 구멍 4개(구멍 표 C 위치 — 좌·우 끝에서 21, 앞쪽 끝에서 60·200)는 학교 2차 방문에 미리 뚫어 두었습니다. C를 얹어 브래킷 홈의 너트와 맞는지 보고, 1~2mm 어긋나면 C를 내려서 줄로 구멍을 넓힙니다(본체 위에서 드릴 금지).
   4. C를 얹고 위에서 M3×10 볼트 4개만 돌려 고정합니다.
   5. **상판 모서리 캡(출력 06)** — C를 얹은 상태에서 캡 4개를 C 네 모서리에 맞춰 보고, 순간접착제로 **C에만** 붙입니다(측판 B·앞판 F·뒤판 G에는 붙이지 않음 — 붙이면 상판을 열 수 없음). 접착제가 B·F·G에 묻지 않게 네 모서리 둘레의 B·F·G 윗부분을 마스킹테이프로 가린 뒤 붙입니다. 굳으면 볼트 4개를 풀고 C를 들어 걸림 없이 열리는지 확인합니다.
   - 대안(선택): 뒤 덮개 H처럼 자석(P45)과 철판(P80)으로 C를 붙여도 됩니다. 이때는 **P69(선택)** 로 자석·철판을 1팩씩 더 삽니다(BOM 3장 '선택' 분류, 다이소).
10. **뒤 덮개 H** — 뒤쪽 개구부(410×255)에 끼워 보고(1mm 여유), 걸림턱 L 뒷면 양쪽(왼쪽·오른쪽 끝에서 약 80mm)에 네오디뮴 자석(P45) 2개를 순간접착제로 붙이고, H 안쪽의 마주 보는 자리에 접착식 철판(P80) 2개를 붙입니다(철판은 붙인 뒤 24시간 지나서 씀).
11. **고무발** — 바닥판 A 아래 네 모서리(각 모서리에서 20mm 안쪽)에 고무발(P41) 4개를 붙입니다.

#### 절차 라. 방수 처리

12. 용기 칸과 잔 칸의 **바닥 이음새**(A와 B·E·I·J·L이 만나는 안쪽 모서리)를 글루건으로 빈틈없이 한 줄 메웁니다.
    *왜?* 흘린 액체가 판 사이 틈으로 스며들면 닦기 어렵고 냄새가 납니다. 바닥에 고여야 닦을 수 있습니다.
13. 잔 칸 바닥에는 드립 매트(P33, 실리콘 코스터)를 놓습니다. 원하면 잔 칸 바닥에 투명 시트지를 붙입니다.
14. 선반 D 위쪽(전장부 쪽) 그로밋 둘레도 배선 후(STEP10) 글루건으로 막습니다.

#### 확인 포인트

- [ ] ✔ 외형 치수 W420 × D260 × H380(±2mm, 판 기준 — 상판 모서리 캡 06은 모서리에서 옆·위로 3mm, 앞면 베젤 03은 앞으로 3mm 더 나옴), 모서리 직각
- [ ] ✔ 구멍 표의 모든 구멍 가공 완료, 버튼·LED 장착
- [ ] ✔ 선반 D의 Ø20 구멍 2개에 출력 그로밋 04
- [ ] ✔ 출력 노즐 블록 02 확인, 선반에는 아직 안 붙임
- [ ] ✔ 상판용 브래킷 너트 4개가 고정되어 있고, 상판 C가 위에서 볼트 4개만으로 열고 닫힘
- [ ] ✔ 상판 모서리 캡 4개가 C에만 붙어 있고, C를 들 때 B·F·G에 걸리지 않음
- [ ] ✔ 앞면 베젤이 붙고 버튼·LED가 제자리에 있음
- [ ] ✔ 앞판 결선: 버튼을 누를 때만 ㉝–㉛ "삐", 납땜부 모두 수축튜브, 노랑 4가닥 양 끝 번호 테이프
- [ ] ✔ G에 SW1·F1이 끼워진 채 붙음, ②·④ 끝에 번호 라벨
- [ ] ✔ 뒤 덮개 H가 자석으로 고정되고 쉽게 열림
- [ ] ✔ 바닥 이음새 방수 처리

#### 흔한 실수

- ⚠ G판을 앞에서 보고 구멍 위치를 잼 → 좌우가 바뀌어 전장 박스와 멀어집니다. 바깥면(뒤) 기준.
- ⚠ F판을 안쪽 면에서 보고 구멍 위치를 잼 → 버튼·LED가 반대쪽으로 가 베젤 03·전장 박스와 어긋납니다. F는 앞(바깥)면 기준.
- ⚠ 순간접착제를 많이 바름 → 오히려 늦게 굳고 하얗게 번집니다. 얇게 바르고 10초 누름.
- ⚠ 조립 후 구멍 뚫기 → 드릴이 다른 판에 닿거나 판이 깨집니다. **조립 전에 모두 뚫기.**
- ⚠ 출력 브래킷의 너트 홈을 판 쪽으로 댐 → 너트가 판에 막혀 볼트가 물리지 않습니다. 바깥 모서리(모따기)를 판 모서리에, 너트 홈은 안쪽.
- ⚠ 용기를 사기 전에 재단 → 용기가 안 맞으면 판을 다시 잘라야 합니다. 970ml 용기 4개를 먼저 사서 [2.4](#s2-4) 기준을 확인합니다.

### STEP 10. 최종 조립 · 배선 정리 {#step10}

> **목표**: 전장 박스·전원 부품·펌프 모듈·배관을 본체에 넣고 연결한다. 액체 쪽(아래)과 전기 쪽(위)이 확실히 나뉘도록 배선·배관을 정리한다.
> **어디서 · 난이도**: 집 · ★★★
> **준비물**: 완성된 본체(STEP9), 전장 박스(STEP5), 전원부(STEP4), 펌프 모듈+배관(STEP8), 출력 노즐 블록 02, 튜브 부싱(출력 07), 그로밋 05(뒤판 G용), 드립 트레이(P33), (선택) 식품용 실리콘 실란트, 케이블타이·접착 마운트(P27·P28), 글루건, 접착식 벨크로 P64 4쌍(2.3), 멀티미터, (박스를 볼트로 고정할 때만) M3×15 볼트 2개(P68, 선택) + M3 너트 2개(P38)
> **소요 시간**: 3~4시간

그림 15. 노즐 매니폴드 상세 (예전 포맥스 M1+M2 방식 그림 — 튜브 연결 순서 참고용)

> 그림 15는 예전 방식(노즐 판 M1 구멍 Ø6.5, 튜브 3mm 돌출, M1 아랫면 z 230, 칸막이 구멍에 튜브를 2×2로 묶어 통과)을 그린 것입니다. 지금 쓰는 출력 노즐 블록 02는 구멍 Ø6.2에 튜브 칸막이·번호 점·'앞' 화살표가 있고, 튜브를 **10mm** 내려 **튜브 끝을 z 220**에 맞춥니다. 칸막이 구멍에는 튜브 부싱 07을 끼웁니다(절차 7). 출력 블록에서 튜브가 꺾이면 `parts.py`의 `nozzle(H=25.0)`을 35로 바꿔 다시 출력합니다([부록 D](#appD)).

#### 절차

1. **전장 박스 올리기** — 상판 C를 떼고, 박스를 선반 D 위 x 105~305, y 40~190 위치(그림 4 (다))에 놓습니다. 박스 바닥 네 모서리와 D의 같은 자리에 **접착식 벨크로(찍찍이) P64** 를 한 쌍씩(10쌍 중 4쌍) 붙여 고정합니다. 붙일 면의 먼지·기름을 닦고 꾹 누르고, 55×35mm가 박스 모서리보다 크면 잘라 씁니다(폼 양면테이프로 한 번 더 잡아도 됨). 박스 바닥과 D에는 구멍을 뚫지 않습니다.
   *왜 볼트가 아닌가?* 박스 앞쪽 모서리 아래(x 5~130 / 290~415, y 5~105)는 I·J·E·B·A·D로 사방이 막힌 빈 공간(그림 4 (나))이라 너트를 끼울 손이 들어가지 않고, 조립이 끝난 본체에 구멍을 뚫으면 STEP9의 "조립 후 구멍 뚫기 금지"와도 어긋납니다. 벨크로는 정비 때 박스를 들어 올릴 수도 있습니다.
   - (선택) 볼트로 단단히 잡고 싶으면 **뒤쪽 두 모서리(x 약 115·295, y 약 180 — 아래가 용기 칸)** 만 씁니다. D 구멍은 STEP9 구멍 표의 "D 선반 (선택)" 행에서 조립 전에, 박스 바닥 구멍은 STEP5 박스 준비 때(속판을 달기 전) 뚫어 둡니다. 볼트는 **M3×15(P68, 선택 — 따로 주문)**, 너트는 **P38**을 씁니다(P38은 25개 중 24개를 브래킷에 쓰므로 **2개를 더 사야** 합니다). 너트는 뒤 덮개 H를 열고 용기를 꺼낸 뒤 용기 칸 쪽(D 아래)에서 끼워 조입니다. *왜 15mm?* 볼트가 박스 바닥 + D(5mm) + 너트를 지나 나와야 해서 M3×10(P37)은 짧을 수 있습니다(박스 바닥 두께 실측).
2. **전원선 ②·④ 다시 연결(필수)** — SW1·F1은 STEP4에서 이미 G에 끼워져 있고, G는 STEP9에서 본체에 붙었습니다.
   1. G 안쪽에 매달린 ②·④ 끝의 테이프를 벗기고 박스 **뒤 벽 Ø16 구멍**으로 넣습니다.
   2. **② → J1 + 나사, ④ → TB1-8**에 연결하고 살짝 당겨 봅니다(STEP9에서 뺀 선 — 빠뜨리면 SW1을 켜도 전원이 들어오지 않습니다).
3. **어댑터 선(①)** — 어댑터 플러그를 G의 **Ø12 구멍(그로밋 없이)** 으로 **바깥에서 안으로** 넣습니다. 그다음 출력 그로밋 05를 옆 트임으로 케이블에 끼우고 오므려 구멍에 눌러 끼운 뒤, 둘레를 글루건으로 고정합니다. 플러그는 박스 뒤 벽 구멍을 지나 J1에 꽂습니다. G 안쪽에서 선을 케이블타이로 한 번 묶어(매듭처럼) 밖에서 잡아당겨도 J1이 빠지지 않게 합니다(장력 완화).
   - ①·②·④가 모두 연결되면 **STEP4 절차 11·12(단락 검사·전압 확인)를 다시** 합니다: 어댑터를 뽑은 상태에서 TB1–TB2 단락 검사 → 어댑터를 꽂고 SW1 OFF **0V** / ON **4.9~5.25V**(이제 TB1 구멍이 다 찼으므로 STEP6의 측정 위치 — 릴레이 K1 COM 나사 머리 ↔ J1 − 나사 머리 — 에 댐) → SW1 OFF → **어댑터를 콘센트에서 뽑습니다**(다음 절차 4·5는 배선 작업).
4. **앞판 배선** — 앞판 선(㉙~㊱)을 박스 앞 벽 구멍으로 넣어 연결합니다(번호 테이프와 색을 보고 하나씩):
   - ㉙ 부저 VCC(노랑, 테이프 ㉙) → **TB3-3** · ㉚ 부저 I/O(노랑, 테이프 ㉚) → **GPIO23 (J3-2)**
   - ㉛ 앞판 GND 이음점에서 오는 검정선 → **ESP32 GND (J3-7)**
   - ㉝ 버튼(노랑, 테이프 ㉝) → **GPIO4 (J3-13)** · ㉟ R1·LED(노랑, 테이프 ㉟) → **GPIO2 (J3-15)**
   - 노랑 4가닥은 색이 같으므로 **번호 테이프만 보고** 꽂습니다. 특히 ㉙(3V3)을 GPIO 단자에, ㉚·㉝·㉟를 TB3에 꽂지 않게 한 가닥씩 확인합니다.
5. **용기·펌프 모듈 넣기** — 뒤 덮개 H를 열고, 뚜껑을 닫은(뚜껑을 잡고 몸통을 돌려) 용기 1~4를 왼쪽부터 순서대로 넣습니다. 좁은 80mm 쪽이 좌우입니다.
   - 펌프 1·2 선 → 선반 왼쪽 그로밋(x 60), 펌프 3·4 선 → 오른쪽 그로밋(x 360) → 박스 옆 벽 구멍 → 연결표 ㉑~㉘:
     펌프 1 빨강 → **K1 NO**, 검정 → **TB2-2** · 펌프 2 → **K2 NO** / **TB2-3** · 펌프 3 → **K3 NO** / **TB2-4** · 펌프 4 → **K4 NO** / **TB2-5**.
   - 하네스의 Y자 이음 덩어리는 박스 벽 구멍 밖(선반 위)에 두고, 빨강·검정 꼬리만 박스 구멍으로 넣습니다.
   - 그로밋 아래에서 전선을 **U자로 한 번 늘어뜨린(드립 루프)** 뒤 올립니다. *왜?* 전선을 타고 흐르는 물방울이 U자 바닥에서 떨어져 구멍으로 들어가지 않습니다.
   - 용기를 뒤로 30cm 꺼낼 수 있을 만큼 전선·튜브 여유를 용기 칸 안에 남깁니다.
6. **체크밸브 고정** — 선반 D 아래(용기 칸 쪽), 칸막이 구멍 근처(y 120~160)에 접착 마운트(P28)를 붙이고 체크밸브 4개를 가로로 케이블타이 고정합니다. **화살표가 앞(칸막이·노즐 쪽)** 을 향합니다.
7. **노즐 연결(그림 15)**
   1. **튜브 부싱(출력 07)** 을 칸막이 E의 Ø25 구멍에 테가 잔 칸 쪽으로 오게, 잔 칸에서 볼 때 **점 1·2개 구멍이 왼쪽, 점 3·4개 구멍이 오른쪽**에 오도록 돌려 끼우고 글루건으로 고정합니다. *왜?* 노즐 블록 구멍이 왼쪽부터 1·2·3·4라, 이렇게 돌려야 좁은 틈(20mm)에서 튜브가 서로 엇갈리지 않습니다. 각 체크밸브의 내경4 출구 튜브를 **부싱 테의 점 개수 = 펌프 번호**인 구멍으로 하나씩 잔 칸 쪽에 통과시킵니다.
   2. 노즐 블록을 잔 칸 안에서 손에 듭니다. 블록 밑판(구멍이 뚫린 판) 윗면의 **'앞' 화살표가 잔 칸 앞쪽**을 보게 들고, 구멍 앞의 **점 1~4개 = 펌프 번호**입니다. 튜브를 **왼쪽부터 펌프 1·2·3·4 순서**로 블록 안 튜브 칸막이 사이를 지나 구멍에 위에서 아래로 끼웁니다. 블록의 구멍(Ø6.2)은 튜브(외경 6)가 꽉 끼므로, 빡빡하면 튜브 끝을 뜨거운 물에 10초 담갔다가 밀어 넣습니다.
   3. 튜브 끝이 블록 아래로 **10mm** 나오게 맞춘 뒤, 커터칼로 4개 끝을 같은 높이로 직각으로 자릅니다.
      *왜 10mm?* 3D 출력물은 층 사이 홈에 액체가 스며들면 씻기 어렵고 식품용 인증도 없으므로, 음료가 블록에 닿지 않고 튜브 끝에서 바로 잔으로 떨어지게 합니다.
   4. 블록 위쪽에서 튜브 둘레를 글루건(또는 식품용 실리콘)으로 **빈틈없이** 막아 고정합니다.
   5. 노즐 블록의 벽 윗면과 양쪽 날개 윗면에 순간접착제(또는 글루건)를 바르고 선반 D 아래 **x 180~240, y 22~82**(블록 중심 = 잔 칸 가운데 x 210, y 52)에 30초간 눌러 붙입니다. 튜브가 납작하게 꺾이지 않았는지 확인합니다.
   6. 줄자로 바닥판 윗면에서 블록 아랫면까지 **230mm**, 튜브 끝까지 **220mm**인지 잽니다.
   *왜 한 줄로?* 2×2로 배치하면 뒤쪽 구멍으로 가는 튜브와 앞쪽 구멍으로 가는 튜브가 같은 줄에서 겹쳐, 좁은 틈(20mm)에서 심하게 꺾입니다. 한 줄이면 4가닥이 나란히 같은 모양으로 구부러집니다.
8. **튜브 길이 정리** — 내경5 튜브(펌프 → 체크밸브)가 너무 길어 용기 칸에서 꼬이면, 용기 인출 여유(약 30cm)를 남기고 잘라 다시 잇습니다.
9. **드립 트레이** — 잔 칸 바닥 가운데에 놓습니다. 노즐 바로 아래가 트레이 가운데가 되도록.
10. **배선 정리**
    - 박스 안: 가는 신호선 묶음과 굵은 전원선을 따로 케이블타이로 묶고, 박스 벽 구멍을 글루건으로 막습니다.
    - 선반 위: 그로밋 둘레와 옆 트임(출력 04, 3.5mm)을 글루건으로 막습니다.
    - 튜브는 **전장부(선반 위)로 절대 올라가지 않게** 합니다. 모든 튜브 이음부는 선반 아래에 있습니다.
11. **최종 연결 확인** — STEP6 점검표를 한 번 더 하고, 이번에는 펌프 선까지 포함해 TB1–TB2 단락이 없는지 봅니다.
12. 박스 뚜껑을 닫고 상판 C를 위에서 볼트 4개로 고정합니다(너트는 STEP9에서 상판용 브래킷 홈에 붙여 둠).

#### 액체·전장부 격리 점검

- [ ] ✔ 튜브·이음부·체크밸브가 모두 선반 **아래**에 있음
- [ ] ✔ 전장 박스 벽 구멍 4곳, 선반 그로밋 2곳이 글루건으로 막힘
- [ ] ✔ 펌프 선에 드립 루프가 있음
- [ ] ✔ 박스 뚜껑이 닫힘, 상판 C 고정
- [ ] ✔ 액체를 흘려도 전장부까지 올라갈 길이 없음(선반이 막고 있음)

#### 확인 포인트

- [ ] ✔ 노즐 튜브 끝 높이 220mm, 튜브 끝 4개 높이 같음, 블록 위쪽 튜브 둘레 실링
- [ ] ✔ 펌프 번호 = 용기 번호 = 부싱 구멍 번호 = 노즐 구멍 번호 = 앱 슬롯 번호
- [ ] ✔ 용기를 뒤로 꺼냈다 넣을 수 있음(선·튜브가 걸리지 않음)
- [ ] ✔ 어댑터 선을 밖에서 당겨도 J1이 빠지지 않음
- [ ] ✔ ② → J1 +, ④ → TB1-8 다시 연결, SW1 OFF 0V / ON 약 5V 재확인
- [ ] ✔ 전장 박스가 벨크로(또는 뒤쪽 볼트 2개)로 고정됨

#### 흔한 실수

- ⚠ 노즐 구멍 번호와 펌프 번호가 뒤섞임 → 기능에는 문제없지만 고장 찾기가 어렵습니다. 번호를 맞추세요.
- ⚠ 튜브를 팽팽하게 당겨 고정 → 용기를 꺼낼 수 없고 이음부가 빠집니다. 여유를 남기세요.
- ⚠ 노즐 블록을 비스듬히 붙임 → 물줄기가 잔 밖으로 떨어집니다. 붙이기 전에 잔을 놓고 위치를 확인.
- ⚠ 출력 노즐 블록을 앞뒤 거꾸로 붙임 → 튜브 칸막이가 앞으로 가서 튜브가 겹칩니다. '앞' 화살표가 잔 칸 앞쪽.

### STEP 11. 캘리브레이션 (유량 맞추기) {#step11}

> **목표**: 펌프마다 "1초에 몇 ml가 나오는지(ml/초)"를 재서 기기에 저장해, 앱에서 정한 양이 정확하게 나오게 한다.
> **어디서 · 난이도**: 집 · ★☆☆
> **준비물**: 실제로 쓸 재료(또는 물), 계량컵 또는 주방 저울(1g 단위), 버릴 컵, 휴대폰 앱, 기록표([부록 C](#appC))
> **소요 시간**: 1~1.5시간 (펌프당 약 15분)

#### 왜 꼭 해야 하나요?

이 기기는 "양"을 직접 재지 않고 **"시간"으로 양을 정합니다**(ml ÷ 유량 = 구동 시간). 펌프마다, 튜브 길이·높이마다, 액체의 끈적임마다 1초에 나오는 양이 다릅니다. 펌웨어의 기본값 20 ml/초는 임시값이라, 실제 유량(약 3~6 ml/초, 추정)보다 크게 잡혀 있어 **캘리브레이션 전에는 요청한 양보다 훨씬 적게** 나옵니다(넘치지 않는 안전한 쪽). 그래서 캘리브레이션하지 않은 펌프가 있으면 앱의 바텐더·기기 탭에 **"캘리브레이션 전 — 실제보다 적게 나올 수 있어요"** 배너와 마법사 바로가기가 뜹니다(SPEC §5.6).

#### 절차 (앱 캘리브레이션 마법사)

1. 용기에 실제로 쓸 액체를 **절반쯤**(970ml 용기면 약 500ml) 채웁니다.
   *왜 절반?* 액면 높이에 따라 유량이 15~20% 달라집니다(가득 찼을 때 많이, 거의 비었을 때 적게 — 추정). 절반에서 재면 평균에 가깝습니다.
2. 앱 **기기 탭 → 캘리브레이션 마법사 → 펌프 1 선택**.
3. 노즐 아래에 버릴 컵을 놓고 **"튜브 채우기(3초)"** 를 노즐에서 끊김 없이 나올 때까지 반복합니다(튜브 속 공기 빼기).
4. 빈 계량컵(또는 저울에 올린 컵, 0점 맞춤)을 노즐 아래에 놓고 **"10초 구동 시작"**.
5. 나온 양을 읽어 입력합니다. 저울을 쓰면 **ml = g ÷ 밀도** (아래 표). 앱이 `ml ÷ 10초`로 유량을 계산합니다.
6. **기기에 저장** → ESP32 플래시에 저장되어 전원을 꺼도 유지됩니다. 기기가 이 펌프를 "저장됨"(`calSet` = 1)으로 알려 주고, 4개 펌프를 모두 저장하면 "캘리브레이션 전" 배너가 사라집니다.
7. **검증**: 앱에서 펌프 1만 50ml인 레시피를 만들어(또는 시리얼 `{"cmd":"make","id":"chk","steps":[{"p":1,"ml":50}]}`) 실제로 47.5~52.5ml(±5%)가 나오는지 봅니다. 벗어나면 3~6을 2~3번 반복해 평균을 씁니다.
8. 펌프 2·3·4도 같은 방법으로 합니다.

시리얼 모니터로 할 때: `{"cmd":"run","p":1,"ms":10000}` → 측정 → `{"cmd":"setcal","p":1,"mlps":4.6}` (예: 46ml ÷ 10초) → `{"cmd":"getcal"}`로 확인(`"calSet":[1,0,0,0]`처럼 저장한 펌프가 1).

#### 액체별 차이 (참고, 추정값)

| 액체 | 밀도(g/ml, 대략) | 물 대비 유량 | 주의 |
|---|---|---|---|
| 물 | 1.00 | 기준 | |
| 맑은 주스(펄프 없음) | 1.04 | 거의 같음 | 펄프·과육은 체크밸브(Ø2mm)를 막음 → 걸러서 사용 |
| 탄산음료 | 1.01~1.04 | 약간 적음 | 펌프 속에서 거품이 생겨 양이 들쭉날쭉. **차갑게** 보관하면 덜함 |
| 시럽(원액) | 1.3 | 크게 적음(절반 이하 가능) | 물과 1:1로 희석해 쓰면 안정적. 사용 후 바로 세척 |
| 증류주 40% | 0.95 | 거의 같음 | 식품용 부품 교체 전·학교 시연에서는 사용하지 않음(1.3·1.4). 교체 뒤에도 성인 인증, 사용 후 바로 세척 |
| 색 물(물 + 식용색소) | 1.00 | 같음 | 시연용(마시지 않음). 사용 후 맑은 물로 세척 |
| 우유·유제품 | — | — | **사용하지 않음**(위생) |

#### 다시 해야 할 때

재료를 바꿨을 때, 튜브를 다시 잘랐을 때, 기기를 옮겨 용기·노즐 높이가 바뀌었을 때, **시연(발표) 당일 아침**.

#### 120초 제한 주의 (SPEC v2.1)

펌웨어는 레시피 제조(`make`)에서 펌프 1개가 **최대 120초**만 돌도록 막습니다(SPEC §2.3, v2.1에서 체크밸브의 느린 유량을 고려해 60→120초로 늘림). 재료 1개 최대 300ml, 한 잔 최대 500ml 제한도 함께 걸립니다.
- 유량이 2.5 ml/초 이상이면 300ml 제한이 먼저 걸리고, 그보다 느리면 120초 제한이 먼저 걸립니다(예: 2 ml/초 → 한 재료 최대 약 240ml).
- 직접 구동(`run`, 캘리브레이션·프라이밍용)은 한 번에 **최대 60초**, 세척(`clean`)은 펌프당 최대 30초입니다.
- 앱에서 `LIMIT` 오류가 나면 잔 용량을 줄이거나 재료 비율을 나누세요. 유량이 비정상적으로 느리면 [4장](#s4)의 원인부터 찾습니다.

#### 확인 포인트

- [ ] ✔ 펌프 4개 모두 유량 저장, `getcal` 값이 기록표와 같음
- [ ] ✔ 50ml 검증 오차 ±5% 이내
- [ ] ✔ 기록표에 날짜·재료·액면 상태 기록

#### 흔한 실수

- ⚠ 튜브를 채우지 않고(프라이밍 없이) 측정 → 처음 몇 초는 공기만 나와 유량이 작게 잡힙니다.
- ⚠ 용기가 가득 찬 상태에서만 측정 → 비어 갈수록 덜 나옵니다. 절반에서.
- ⚠ 저울 값을 그대로 ml로 입력(시럽 등) → 밀도로 나눠야 합니다.

### STEP 12. 시운전 · 세척 · 보관 {#step12}

> **목표**: 실제 사용처럼 여러 잔을 만들어 보며 문제를 찾고, 세척·보관 방법을 익힌다.
> **어디서 · 난이도**: 집 · ★☆☆
> **준비물**: 물(또는 시연용 색 물), 잔 여러 개, 앱, 미지근한 물, 식초 또는 베이킹소다, 키친타월
> **소요 시간**: 2시간

#### 절차 가. 시운전 (물로)

1. 앱 재료 탭을 실제 재료 이름으로 바꾸되, 내용물은 물로 시험합니다(예: 펌프 1 "사이다(물)").
2. **바텐더 탭** → 기분·맛 입력 → AI 레시피 → **기기로 제조 시작** → 진행 화면에서 펌프별 진행률 확인 → 완료 알림·진동·부저 "삐-삐".
   앱에서 평가(좋아요/별로예요 — 마시지 않고 버튼만 누름) 후 **"한 잔 더 만들까요?"** 에서 [예] → 같은 입력으로 다시 추천, [아니요, 다른 걸 원해요] → 탐색 모드(새 재료 제안)를 한 번씩 눌러 봅니다. 레시피 화면의 "다른 추천"을 두 번 연속 누르면 "새 재료를 장착해 볼까요?" 안내가 나오는지도 봅니다.
3. **비상정지 2가지**: 제조 중 ① 앱의 큰 **비상 정지** 버튼, ② 기기 앞의 **시작/정지 버튼** → 모두 즉시 멈추고 부저 "삐----".
4. **연결 끊김 시험**: 제조 중 휴대폰 블루투스를 끄면, 기기는 정해진 양만큼 끝까지 만들고 멈춰야 합니다(SPEC §2.4). 다시 켜면 앱이 자동 재연결합니다.
5. **연속 시험**: 200ml를 10잔 연속으로 만들며 ESP32 재부팅(LED가 다시 천천히 깜빡임), 누수, 발열, 소음을 봅니다. 한 재료를 많이(예: 150ml 이상) 넣어 펌프가 오래 도는 레시피도 만들어 보고, 끝난 뒤 펌프 쪽 용기가 미지근한 정도인지 확인합니다(펌프 1개 최대 120초).
6. **동시 모드**(선택): 앱 기기 탭 배출 모드를 "동시"로 바꿔 2잔 만들어 보고, 재부팅이 생기면 "순차"로 되돌립니다.

#### 절차 나. 세척 (매번 사용 후)

7. 용기의 재료를 비우고 **미지근한 물(40℃ 이하)** 을 채웁니다. 용기 몸체(PET)는 60℃까지만 견딥니다.
8. 앱 기기 탭 → **세척**(펌프당 10초) 2번 → 잔 칸에 큰 그릇을 놓고 받습니다. (시리얼: `{"cmd":"clean","ms":10000}`)
9. 맑은 물로 한 번 더 세척합니다.
10. 튜브 물 빼기: 뚜껑을 잡고 몸통을 돌려 연 뒤 펌프 모듈(뚜껑)을 들어 올려 펌프가 물 밖에 있게 하고, 각 펌프를 **1~2초만** 돌려 튜브 속 물을 뺍니다. *길게 공회전시키지 않습니다.*
11. 용기·드립 트레이를 씻어 말립니다(용기는 부드러운 스펀지로 — 솔·연마분은 긁힘). 펌프 모듈의 뚜껑은 물에 담그지 말고 젖은 키친타월로 닦습니다. 잔 칸 바닥을 닦습니다.

#### 절차 다. 정기 세척 (설탕 음료를 쓴 날, 일주일에 한 번)

12. 미지근한 물 1L에 식초 2~3큰술(또는 베이킹소다 1큰술)을 녹여 용기에 넣고 세척 10초 × 3번 → 10분 그대로 둠 → 맑은 물로 세척 2번.
13. 체크밸브가 끈적이면(잘 안 열림) 따뜻한 물로 여러 번 세척합니다. 그래도 안 되면 예비 체크밸브로 교체합니다.

#### 절차 라. 보관

14. 용기는 비워서 말리고 뚜껑을 살짝 열어 둡니다(곰팡이 방지).
15. 어댑터를 콘센트에서 뽑고, 먼지가 들어가지 않게 천을 덮습니다.
16. 오래 보관한 뒤 처음 쓸 때는 절차 나(세척)부터 합니다.

#### 확인 포인트

- [ ] ✔ 앱 전체 흐름(추천 → 제조 → 완료 → 피드백) 성공
- [ ] ✔ 비상정지 2가지 모두 동작
- [ ] ✔ 연결 끊김 시에도 정량 후 정지
- [ ] ✔ 10잔 연속 동안 재부팅·누수·과열 없음
- [ ] ✔ 세척·물 빼기 완료

#### 흔한 실수

- ⚠ 사용 후 재료를 넣은 채 퇴근 → 다음 날 체크밸브 고착·냄새.
- ⚠ 뜨거운 물(60℃ 이상)로 세척 → 펌프·용기 플라스틱 변형 위험.
- ⚠ 세척수를 받을 그릇 없이 세척 → 잔 칸이 넘칩니다.

<!-- pagebreak -->

## 4. 문제 해결 표 {#s4}

| 증상 | 가능한 원인 | 조치 |
|---|---|---|
| 앱에서 기기가 검색되지 않음 | 전원 꺼짐 / ⑧ 빠짐 / 다른 폰이 연결 중 / 권한 거부 / 웹앱을 지원하지 않는 브라우저 | SW1·어댑터 확인, ⑧ 재연결, 다른 폰 연결 해제, 앱 권한(근처 기기·위치) 허용, EN 버튼으로 재시작, 휴대폰 블루투스 껐다 켜기. 웹앱은 **Chrome·Edge + https 주소**에서만 블루투스가 됨(아이폰 불가) — 안 되면 APK 사용 |
| 연결은 되는데 "기기 정보(info)를 받지 못했어요" | 구버전(Wi-Fi) 펌웨어 | STEP7 절차 가로 v2 펌웨어 업로드 |
| 레시피 화면에 늘 "오프라인 추천"이 표시됨 | AI 키 미등록 / AI 추천 방식이 "오프라인" / 키 오류·사용량 한도·크레딧 소진 / 인터넷 끊김·응답 지연(25초) | 레시피 화면 위 안내에서 이유 확인 → 앱 설정 → **AI 고르기**에서 고른 AI의 **API 키** 칸 **[키 확인]**(성공 / 키가 올바르지 않음 / 권한 없음 / 사용량 한도·크레딧 소진 / 인터넷 연결 없음 — [5장](#s5) 전날 점검, `../../app/README.md` 5장). 시연은 오프라인 추천으로도 진행 가능 |
| 펌프가 켜질 때 ESP32가 재부팅(LED가 다시 천천히 깜빡) | 전압 강하(브라운아웃) / **펌프 다이오드 방향 반대**(켜는 순간 단락) | C1 극성·연결 확인, 다이오드 띠 방향 확인(띠 = 빨강), 전원선을 AWG20으로 짧게, 순차 모드 사용, 필요하면 C2(100µF) 추가. 시리얼에 `리셋 원인: 브라운아웃`이 보이면 확정 |
| 릴레이가 딸깍하지 않음 | JD-VCC(5V) 미연결 / GND 미연결 / 핀 번호 틀림 / A안 입력 전류 부족 / B안인데 ⑨를 VCC 핀으로 옮기지 않음(캡만 끼움) | ⑨(A안: JD-VCC 핀 / B안: 입력 헤더 VCC 핀)·⑯(릴레이 GND)·⑪(VCC) 확인, `run` 명령으로 채널별 확인, A안이 약하면 B안(STEP2 절차 라) |
| 릴레이가 꺼지지 않음(계속 켜짐) | B안인데 ⑪(3V3)이 연결됨 / A안인데 점퍼가 꽂힘 / IN 선 빠짐 | 점퍼·VCC 연결을 STEP2 결정대로, `{"cmd":"stop"}`으로도 안 꺼지면 배선 문제 |
| 전원을 켜자마자 펌프가 돈다 | 펌프가 NC 단자에 연결 | 펌프 빨강을 **NO**로 옮김 |
| 펌프를 켜면 ESP32가 재부팅되거나 어댑터가 꺼짐(또는 퓨즈가 끊어짐) | 다이오드 방향 반대 / 펌프 선 단락 | 해당 펌프의 다이오드 띠가 빨강 쪽인지 확인, 이음부 피복 확인. **퓨즈가 멀쩡해도 다이오드가 맞다는 뜻이 아님**(4A 어댑터는 퓨즈보다 먼저 스스로 끊음). 수축튜브가 변색됐거나 냄새가 나는 다이오드는 교체(다이오드 하네스는 학교 실습실에서 다시 납땜 — 그 전까지는 예비 펌프 모듈로 바꿔 씀). 퓨즈가 끊어졌으면 원인을 고친 뒤 3A로 교체 |
| 릴레이는 딸깍하는데 펌프가 안 돔 | COM에 5V 없음 / NO 선 빠짐 / 펌프 이음 불량 | TB1→COM(⑰~⑳) 확인, COM–GND 5V 측정, 펌프 선 도통 확인 |
| 펌프는 도는데 액체가 안 나옴 | 체크밸브 거꾸로 / 튜브 공기 / 액면 너무 낮음 / 튜브 꺾임 | 화살표 방향 확인, 프라이밍, 액체 보충(최소 30mm), 꺾인 곳 펴기 |
| 양이 레시피보다 훨씬 적음 | 캘리브레이션 안 함(기본 20 ml/초 — 앱에 "캘리브레이션 전" 배너) / 액면 낮음 / 공기 구멍 막힘 | STEP11 캘리브레이션, 용기 보충, 뚜껑 Ø3 공기 구멍 확인 |
| "캘리브레이션 전" 배너가 계속 보임 | 저장 안 된 펌프가 있음(`calSet` 0) | `{"cmd":"getcal"}`로 0인 펌프 확인 → STEP11로 저장 |
| 양이 들쭉날쭉 | 탄산 거품 / 액면 변화 / 튜브 속 공기 | 탄산은 차갑게, 절반 액면에서 재캘리브레이션, 제조 전 프라이밍 |
| 유량이 3 ml/초보다 훨씬 작음 | 체크밸브 유로(Ø2mm) 저항 / 꺾임 / 펄프 막힘 | 꺾임·막힘 해결, 그래도 느리면 체크밸브 제거 시험(노즐 높이 조건은 유지), 동시 모드 사용 |
| `LIMIT` 오류 | 한 재료 300ml 초과 / 총 500ml 초과 / 한 펌프 120초 초과(유량이 매우 느릴 때) / `run` 60초 초과 | 잔 용량 줄이기, 비율 조정, 유량이 너무 낮으면 원인 해결 |
| `BUSY` 오류 | 이미 제조 중 | 끝날 때까지 기다리거나 비상정지 후 다시 |
| 제조가 끝난 뒤에도 노즐에서 계속 똑똑 떨어짐 | 체크밸브 불량·당분 고착 / 노즐이 액면보다 낮음 | 세척 또는 교체, 노즐 튜브 끝 높이 220mm·액면 ≤ 160mm 확인 |
| 펌프가 멈췄는데 액체가 계속 흐름 | 사이펀(노즐이 액면보다 낮음) | 노즐을 높이거나 용기를 덜 채움. 체크밸브 방향 확인 |
| 이음부에서 샘 | 케이블타이 느슨 / 겹침 부족 / 단면 비뚤어짐 | 케이블타이 추가, 1.5cm 이상 겹침, 튜브 끝을 직각으로 다시 자르기 |
| 앱 "펌프 1"인데 다른 펌프가 돎 | GPIO 핀 배선 뒤바뀜 / 노즐·용기 번호 혼동 | 연결표 ⑫~⑮ 재확인(26·27·32·33), 번호 라벨 정리 |
| 부저가 계속 울림 | ONE005가 아닌, LOW에 울리는 부저 모듈을 씀(ONE005는 HIGH = 울림) / I/O·VCC 핀을 바꿔 꽂음 | 모듈 인쇄대로 다시 꽂기, 다른 모듈이면 `config.h` `BUZZER_ON_LEVEL 0` 후 재업로드 |
| 업로드 실패 `Failed to connect` | BOOT 버튼 / 케이블 / 포트 점유 | `Connecting...` 때 BOOT 누르기, 데이터 케이블, 시리얼 모니터 닫기, Upload Speed 115200 |
| 시리얼 모니터 글자가 깨짐 | 속도 다름 | 115200 |
| 버튼을 눌러도 반응 없음 | ㉝·㉞·㉛ 연결 / 버튼 단자 잘못 선택 | 도통 모드로 버튼 누를 때만 "삐" 나는 단자 2개를 찾아 연결 |
| 상태 LED가 안 켜짐 | LED 방향 / R1 빠짐 / ㉟·㊱·㉛ / 외부 LED를 안 담 | 베젤을 떼고 학교 실습실에서 R1·GND 납땜을 풀어 LED 방향을 바꿔 다시 납땜, 연결 확인. 보드에는 GPIO2 LED가 없어 외부 LED가 필수 |
| 용기를 꺼낼 때 튜브가 빠짐 | 여유 부족 | 용기 칸 안에 튜브·전선 30cm 여유 확보 |
| 뚜껑을 닫으면 전선·튜브가 꼬임 | 뚜껑을 돌려 닫음(돌림 뚜껑) | 뚜껑을 잡고 **용기 몸통을 돌려** 여닫기 |
| SW1(로커 스위치)이 G에서 빠짐 | 5mm 포맥스라 걸쇠가 약함 | G 안쪽 구멍 둘레를 커터칼로 얇게 파서 다시 끼우거나, 몸통 둘레를 글루건으로 고정 |
| 납땜한 선이 떨어지거나 흔들면 전원이 끊김 | 냉납 / 수축튜브 없이 꺾임 | 학교 실습실에서 다시 납땜(2.6 바), 수축튜브로 덮고 선을 케이블타이로 고정 |

<!-- pagebreak -->

## 5. 시연(발표) 체크리스트 {#s5}

기말 시연(발표)과 졸업작품 전시에 씁니다. 날짜는 학과 공지로 **확인 필요**합니다.

> ⚠ 식품용 부품으로 바꾸기 전까지는 기기에서 나온 액체를 **아무도 마시지 않습니다**([1.3](#food)). 시연은 색 물을 컵에 따르고 **양·색을 보여 주는 것**까지입니다. 졸업작품 전시에서 시음까지 하려면 그 전에 식품용 튜브·체크밸브 **P65·P66·P67**(BOM 3장 '선택' 분류, 가격 확인 필요)로 교체하고 STEP8·STEP11을 다시 합니다(1.3의 조건 — 팀원만).

### 전날

- [ ] 리허설: 발표 순서대로 한 번(추천 → 제조 → 완료 알림 → 양·색 확인 → 앱 평가 버튼 → "한 잔 더?"/탐색 모드) + 연속 10~20잔(물/색 물) — 문제 기록·수정
- [ ] 휴대폰 2대에 앱 설치(Releases 의 최신 APK, 한 대는 예비), 충전 100%, 보조배터리. 두 폰 모두 근처 기기·위치·알림 권한 허용. 예비로 PC(Chrome 웹앱 또는 EXE)도 준비
- [ ] 앱 AI 키 점검: 시연 폰의 **앱 설정**(오른쪽 위 ⚙, 기기 탭 맨 아래 "앱 설정"으로도 감) → **AI 고르기**에서 고른 AI의 **API 키** 칸이 "저장됨 ••••••••(마지막 4자리)"인지 확인하고 **[키 확인]** 을 누릅니다. 결과는 칸 아래 색 띠로 나옵니다(`../../app/README.md` 5장).
  - 초록 **"성공 — 이 키로 AI 추천을 쓸 수 있어요"** → 정상. **AI 추천 방식**이 **[AI(내 키)]** 인지도 봅니다.
  - 노랑 **"키는 정상이에요 — 모델을 바꿔 주세요"** → 같은 화면의 **모델** 목록에서 다른 모델을 고릅니다.
  - 빨강 **"키가 올바르지 않아요" / "권한 없음"** → 키를 다시 붙여 넣거나 그 AI 회사 사이트(앱 설정의 "키 발급 방법")에서 새 키를 발급받아 [키 확인] → [저장].
  - 노랑 **"사용량 한도·크레딧 소진"** → 무료 등급 한도. 잠시 뒤 다시 확인하고, 시연 직전에는 연습 호출을 줄입니다.
  - 빨강 **"인터넷 연결 없음"** → 휴대폰 인터넷(와이파이·데이터)을 확인하고 다시 누릅니다.
  - 노랑·빨강이 계속되면 같은 화면 맨 위 **"AI 추천 방식"** 을 **[오프라인]** 으로 바꿔 바텐더 탭에서 추천이 나오는지 확인해 둡니다(시연 장소 인터넷이 불안정할 때 이 방식으로 진행). 확인 후 다시 **[AI(내 키)]** 로 돌려 둡니다.
  - 키는 그 폰에만 저장됩니다. 공용·전시용 폰이면 시연이 끝난 뒤 키를 **삭제**합니다.
- [ ] 기기가 고장 났을 때를 대비해 앱 **데모 모드(가상 기기)** 로 화면 시연이 되는지 확인
- [ ] 노트북에 Arduino IDE + 펌웨어 폴더 + USB 케이블(펌웨어 다시 올릴 때)
- [ ] 예비 부품 상자: 퓨즈 3A ×2, 예비 펌프 모듈 1개(학교 1차 때 만듦) + 펌프(P09 예비) ×1, 체크밸브 ×1, 1N4007 ×2, 용기 970ml ×1, 튜브 내경4·5 각 1m, 케이블타이, 점퍼선, 레버 커넥터 PCT-418 ×1, 수축튜브, 멀티미터, 스트리퍼, 일자·십자 드라이버, 글루건
  - 납땜 부품은 학교 실습실에서만 고칠 수 있으므로, 고장 난 펌프 모듈은 통째로 예비 모듈과 바꾸고 고치는 것은 학교에서 합니다.
- [ ] 시연용 액체 4가지 준비: **물에 식용색소를 탄 색 물**(예: 빨강·노랑·파랑·초록 — 섞이면 색이 바뀌어 비율이 눈에 보임) + 예비 1병씩. 앱 재료 이름은 실제 재료 이름(예: "사이다")으로 둬도 되지만 내용물은 색 물. 맑은 음료를 쓰더라도 **펄프 없는(걸러낸) 것만**(펄프는 체크밸브 Ø2mm를 막음), 마시지 않음
- [ ] 투명 **시연용 컵**(높이 190mm 이하 — 노즐 튜브 끝 z 220, [0.1](#s0)) 10개 정도 — 마시지 않는 시연 전용(관람객에게 나눠 주지 않음), 시연 후 액체를 버릴 통
- [ ] 키친타월, 물티슈, 쓰레기봉투, 세척용 물통, 큰 그릇(세척수 받기)
- [ ] 멀티탭(콘센트까지 거리 확인), 테이블보
- [ ] 안내문: "시연용 색 물입니다 — 마시지 마세요", "버튼을 누르면 즉시 멈춥니다", 사용 방법 QR(웹앱 [https://paperji.github.io/smart-bartender/](https://paperji.github.io/smart-bartender/) — 데모 모드로 바로 체험), 팀 소개

### 당일 (설치)

- [ ] 기기를 평평한 테이블에 놓기(기울면 노즐이 잔 가운데를 벗어남), 콘센트 연결
- [ ] STEP6 점검표 빠르게 한 번 + 전압 확인(TB1–TB2 약 5V)
- [ ] 용기 세척 → 재료 채우기(최대 액면 이하, 용기 번호 = 앱 슬롯, 뚜껑 Ø3 공기 구멍이 막히지 않았는지)
- [ ] 앱 재료 탭 이름·잔량 입력, 성인 인증은 사용 안 함(주류 없음)
- [ ] **프라이밍 → 캘리브레이션**(STEP11) — 시연 장소 온도·재료 기준으로 다시. "캘리브레이션 전" 배너가 없는지 확인
- [ ] 시범 3잔: 추천 → 제조 → 양·색 확인(마시지 않음)
- [ ] 비상정지(앱·버튼) 한 번씩 확인

### 시연 중

- [ ] 잔량을 자주 확인(앱 잔량 경고), 액면이 30mm 밑으로 내려가기 전에 보충
- [ ] 드립 트레이 비우기, 잔 칸 닦기
- [ ] 한 사람은 앱 조작·발표, 한 사람은 재료·컵·청소 담당
- [ ] 블루투스가 끊기면: 앱이 자동 재연결 → 안 되면 앱의 기기 탭에서 다시 연결 → 그래도 안 되면 SW1 OFF/ON
- [ ] 이상(누수, 냄새, 재부팅 반복) → 즉시 SW1 OFF, 어댑터 뽑기 → 4장 문제 해결 표. 발표는 데모 모드로 이어 감

### 끝난 뒤

- [ ] 재료 비우기 → STEP12 절차 나(미지근한 물 2번) → 물 빼기
- [ ] 용기·트레이 세척·건조, 어댑터 뽑기
- [ ] 문제·개선점 기록(졸업논문·결과보고서 자료): 만든 잔 수, 오류 횟수, 평균 제조 시간, 50ml 검증 오차, 관람객 반응(앱·추천 화면에 대한 의견)

<!-- pagebreak -->

## 6. 개선 아이디어 (졸업논문 · 특허 · 후속 개선) {#s6}

| 아이디어 | 부품 (BOM) | 효과 | 주의 |
|---|---|---|---|
| **연동(페리스탈틱) 펌프로 교체** | P55 DFRobot DFR0523 ×4 (약 4.5만원/개) | 액체가 튜브에만 닿아 위생적, 회전 수 = 양이라 정확, 높이·점도 영향 적음, 체크밸브 불필요 | 4개 동시 구동 시 큰 전류 → 5V 10A급 전원 필요(확인 필요) |
| **로드셀(무게) 자동 보정** | P56 HX711 + P57 1kg 로드셀 | 잔 받침 아래 무게를 재 실제 나온 양으로 펌프를 멈춤 → 시간 제어 오차 보완, 논문 실험 데이터(정확도 그래프) 확보 | 잔 칸 바닥 구조 변경, 펌웨어에 "무게 목표" 모드 추가 |
| **MOSFET + PWM 속도 제어** | P58 4채널 MOSFET 보드 | 펌프 속도를 조절해 마지막 몇 ml를 천천히 → 정밀도 향상, 릴레이 소음 제거 | ESP32 3.3V로 켜지는지 확인, 플라이백은 쇼트키(1N5819) |
| **식품 등급 부품** | P65·P66 식품용(FDA/LFGB) 실리콘 튜브 · P67 식품용 체크밸브 (BOM 3장 '선택' 분류, 가격 확인 필요) | 위생 기준 충족 → 시음(1.3 조건)·주스 실사용 근거 | 지금과 같은 규격(내경5/외경7·내경4/외경6, 바브 Ø3.2~5.0)으로 고르기. 바꾼 뒤 STEP8·STEP11 다시. 졸업작품 전시에서 시음하려면 그 전에 교체 |
| **잔량 센서** | 초음파·정전용량 레벨 센서 | 앱의 잔량 추정 대신 실제 측정, 빈 용기 공회전 방지 | 용기마다 1개, 방수 |
| **잔 감지** | 적외선 근접 센서 | 잔이 없으면 제조 시작 안 함(쏟음 방지) | GPIO 추가(남는 핀: 25·13·18·19 중 확장 펌프와 겹치지 않게) |
| **펌프 8개 확장** | P08 예비 릴레이 + 펌프 4 | 재료 8가지 → AI 레시피 다양성 증가 | GPIO 25·13·18·19, `PUMP_COUNT 8`, 전원·공간 재검토 |
| **잔량 기반 유량 보정** | 펌웨어·앱 | 액면이 낮을수록 덜 나오는 현상(15~20%) 보정 | 캘리브레이션 데이터 2점(가득/반) 필요 |
| **외관 개선** | 아크릴(투명 앞판), LED 조명 | 졸업작품 전시 완성도 | 레이저 커팅 이용 가능 여부. 3D 프린팅 노즐 블록·앞면 베젤·모서리 캡은 이미 기본으로 씀([부록 D](#appD)) |
| **자동 세척 모드** | 물 전용 5번째 펌프 | 사용 후 버튼 한 번으로 세척 | 펌프·용기 추가 |

---

## 부록 A. 핀맵 요약 (SPEC §1) {#appA}

| 기능 | ESP32 핀 | 연결 | 비고 |
|---|---|---|---|
| 펌프 1 | GPIO 26 | 릴레이 IN1 | LOW = 켜짐 |
| 펌프 2 | GPIO 27 | 릴레이 IN2 | |
| 펌프 3 | GPIO 32 | 릴레이 IN3 | |
| 펌프 4 | GPIO 33 | 릴레이 IN4 | |
| (확장) 펌프 5~8 | GPIO 25, 13, 18, 19 | 2번째 릴레이 IN1~4 | `PUMP_COUNT` |
| 시작/정지 버튼 | GPIO 4 | 버튼 → GND | 제조 중 누르면 비상정지 |
| 상태 LED (필수) | GPIO 2 | 220Ω → 외부 LED → GND | 대기 천천히 깜빡 / 연결 켜짐 / 제조 중 빠르게 깜빡 |
| 부저 | GPIO 23 | 부저 I/O (VCC 3V3) | HIGH = 울림. 완료 삐-삐, 정지 삐---- |
| 릴레이 입력 전원 | 3V3 (TB3) | 릴레이 입력 헤더 VCC | A안(점퍼 제거). B안(USB·어댑터 분리 후): ⑪ 먼저 제거 → ⑨(+5V)를 입력 헤더 VCC 핀으로 옮김 → 점퍼 끼움(JD-VCC 핀엔 캡만) · VCC 5V (3V3 연결 금지) |
| 릴레이 코일 전원 | 5V (TB1) | 릴레이 JD-VCC | B안: VCC 핀 → 점퍼 캡 → JD-VCC |
| ESP32 전원 | 5V (TB1) | ESP32 5V 핀 | USB 사용 시 ⑧ 분리 |
| GND | 공통 | 별형 접지: J1 −에서 ⑤ → TB2(펌프), ⑦ → ESP32 GND(ESP32·릴레이) | 3V3 분배는 TB3 |

ESP32 DevKitC V4 핀 순서(안테나 위, USB 아래):
왼쪽 줄 위→아래 `3V3 EN VP VN 34 35 32 33 25 26 27 14 12 GND 13 D2 D3 CMD 5V`,
오른쪽 줄 위→아래 `GND 23 22 TX RX 21 GND 19 18 5 17 16 4 0 2 15 D1 D0 CLK`.
GPIO 6~11(CLK·D0~D3·CMD)은 플래시용이라 쓰지 않습니다.

## 부록 B. 재단표 (parts_research.md 5.2와 동일, W420 기준) {#appB}

| 기호 | 이름 | 가로 × 세로 (mm) | 수량 | 위치 · 가공 |
|---|---|---|---:|---|
| A | 바닥판 | 420 × 260 | 1 | 맨 아래, 고무발 4개 |
| B | 측판 (좌·우) | 260 × 370 | 2 | 바닥판 위 양끝 |
| C | 상판 (탈착) | 420 × 260 | 1 | 출력 브래킷 01 4개 + M3 볼트. 너트는 브래킷 홈에 순간접착제로 미리 붙여 둠(**캡티브 너트**, STEP9 절차 다 9). 네 모서리에 상판 모서리 캡(출력 06, C에만 접착). 대안: 자석 캐치 P69(선택) |
| D | 중간 선반 | 410 × 250 | 1 | z 255~260, Ø20 × 2 (뒤쪽 끝에서 35, 좌·우 끝에서 55). **(선택) Ø3.5 × 2**(왼쪽 끝에서 110 / 290, 뒤쪽 끝에서 75 — 전장 박스를 볼트 P68로 고정할 때만, 조립 전에 뚫음. 벨크로 P64면 뚫지 않음) |
| E | 칸막이 | 410 × 255 | 1 | y 105~110, Ø25 (가운데, 위에서 17) — 튜브 부싱(출력 07) |
| F | 앞판 상부 | 410 × 115 | 1 | Ø16 (오른쪽 끝에서 70), Ø5 (110), 높이 가운데 |
| G | 뒤판 상부 | 410 × 115 | 1 | 뒤에서 볼 때 왼쪽에서 Ø12(40, 그로밋 05) · 스위치 사각(90) · 퓨즈(140). **구멍은 STEP4(1주차)에서 뚫음**(SW1·F1을 먼저 끼운 뒤 납땜) → G는 가장 먼저 받거나 잘라 둠 |
| H | 뒤 덮개 (탈착) | 408 × 253 | 1 | 자석 P45 + 철판 P80 각 2(자석은 걸림턱 L에), 손가락 구멍 Ø25(선택) |
| I | 앞판 하부 (좌·우) | 125 × 255 | 2 | x 5~130 / 290~415 |
| J | 잔 칸 옆벽 (좌·우) | 105 × 255 | 2 | x 130~135 / 285~290 |
| K | 선반 받침대 | 145 × 20 | 2 | 측판 안쪽 y 110~255, z 235~255 |
| L | 뒤 덮개 걸림턱 | 410 × 15 | 1 | 바닥판 뒤쪽 끝에 세워서 |
| M1 | 노즐 판 | 60 × 60 | 1 | **자르지 않음**(출력 노즐 블록 02 사용). 블록이 깨졌을 때의 대안: Ø6.5 × 4 **한 줄**(왼쪽에서 12·24·36·48, 앞에서 30) — 아래 메모, [부록 D](#appD) |
| M2 | 노즐 걸이 | 60 × 20 | 2 | **자르지 않음**(대안일 때만: M1 위 양끝에 세워 "ㄷ"자 블록) |
| N | 용기 칸 가이드 (970ml 용기는 권장) | 140 × 15 | 3 | 용기 사이 x ≈ 107, 210, 312 |

- **폭 W520으로 늘릴 때**(용기 폭 95mm 초과): A·C 520×260, D 510×250, E 510×255, F·G 510×115, H 508×253, L 510×15, I 175×255. 나머지(B·J·K·M·N)는 그대로이고 잔 칸·노즐은 가운데(x 260), N 위치는 안쪽 폭의 1/4 간격으로 다시 계산합니다.
- **깊이를 늘릴 때**(용기 깊이 135mm 초과): A·B·C·D·K·N의 깊이 방향 치수만 같은 만큼 늘립니다.
- **M1 구멍 배열 메모**: 노즐 판 M1의 구멍은 **한 줄 4개(Ø6.5, 간격 12mm, 왼쪽부터 펌프 1~4)** 입니다. 예전 자료의 2×2 배열은 좁은 틈(20mm)에서 튜브가 서로 겹쳐 꺾이므로 쓰지 않습니다. 판 크기(60×60)와 M1 아랫면 높이(z 230 — 튜브 3mm 돌출이라 튜브 끝 약 z 227)는 같습니다.

## 부록 C. 캘리브레이션 기록표 {#appC}

| 날짜 | 펌프 | 재료 | 액면 상태 | 측정 1 (ml/10초) | 측정 2 | 측정 3 | 평균 ml | 유량 ml/초 | 저장 | 50ml 검증 결과 |
|---|---|---|---|---|---|---|---|---|:-:|---|
| | 1 | | 가득 / 반 / 적음 | | | | | | [ ] | |
| | 2 | | 가득 / 반 / 적음 | | | | | | [ ] | |
| | 3 | | 가득 / 반 / 적음 | | | | | | [ ] | |
| | 4 | | 가득 / 반 / 적음 | | | | | | [ ] | |
| | 1 | | 가득 / 반 / 적음 | | | | | | [ ] | |
| | 2 | | 가득 / 반 / 적음 | | | | | | [ ] | |
| | 3 | | 가득 / 반 / 적음 | | | | | | [ ] | |
| | 4 | | 가득 / 반 / 적음 | | | | | | [ ] | |

유량(ml/초) = 평균 ml ÷ 구동 시간(초). 저울을 쓰면 ml = g ÷ 밀도(물 1.00, 주스 1.04, 시럽 1.3, 40% 술 0.95 — 대략값).

## 부록 D. 3D 프린팅 부품 {#appD}

외형 전체(약 0.96m²)를 3D 프린터로 뽑으면 420mm 판을 2~4조각으로 나눠 이어야 하고(대부분의 출력 장비는 한 변 256~350mm), PLA 약 2.2~3kg·기계 시간 35~65시간·출력 대행비 약 30만~45만 원(추정)이 들며 큰 평판은 식으면서 휩니다. 그래서 큰 판은 포맥스로 만들고, **정밀하게 맞물리거나·시중에서 구하기 어렵거나·겉으로 보이는 부품 7종**만 출력합니다(모두 100mm 안팎, 약 120cm³, 출력 대행 약 2만~7만 원·2~5일, 2026-11-10 업체 공개 단가 기준 추정). 파일과 모델 코드는 `../3dprint/`에 있습니다.

**주문 상태(2026-11-10)**: 업로드 묶음 파일 2개 — `plate_A_brackets_x14.stl`(브래킷 14개) · `plate_B_others_x10.stl`(나머지 10개) — 로 출력 업체(3DFARM)에 주문 완료. PETG 흰색 · 레이어 0.2mm · 벽 3겹 · 인필 plate_A 50% / plate_B 15% · 배율 100% · 방향 원본 그대로. **11/16 도착 예정**, 결제 78,700원(업로드 견적 합계 90,000원보다 적음 — BOM P70).

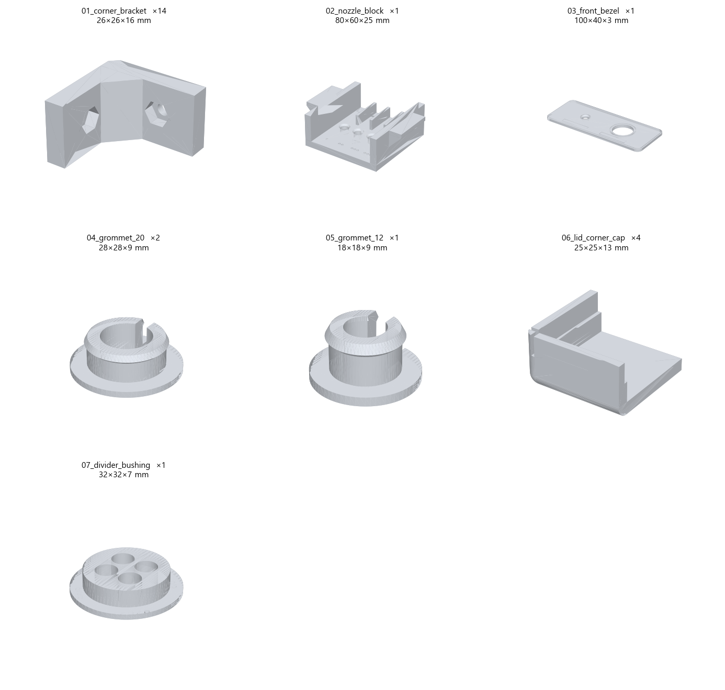
[picture p11: hardware/guide/figures/f16_print_parts.png]
그림 16. 3D 프린팅 부품 7종


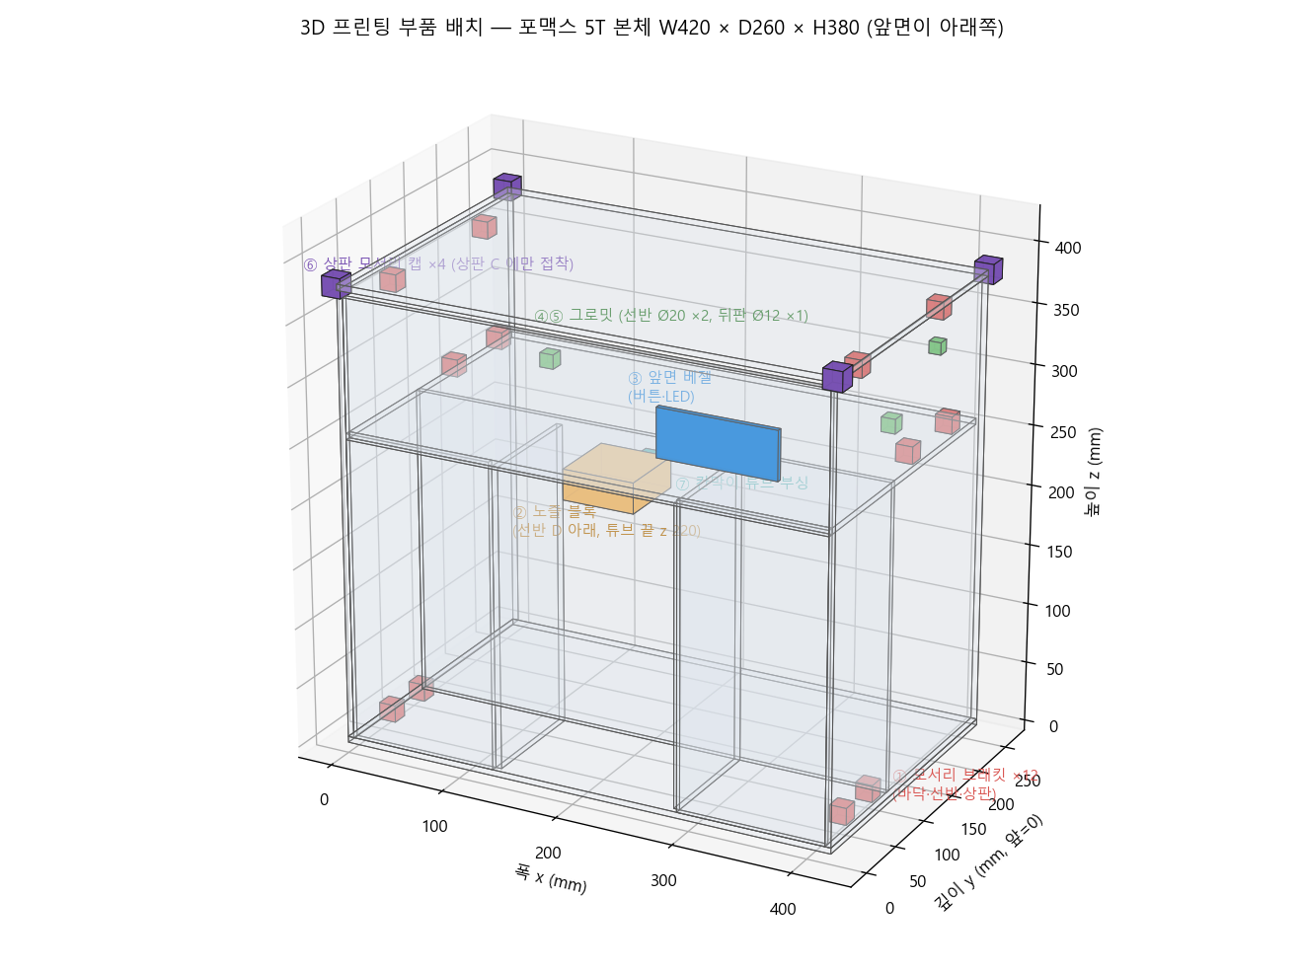
[picture p12: hardware/guide/figures/f17_print_layout.png]
그림 17. 3D 프린팅 부품 위치


| 번호 | 파일 | 수량 | 크기 (mm) | 어디에 | 대신하는 것 | 쓰는 곳 |
|---|---|---:|---|---|---|---|
| 01 | `01_corner_bracket.stl` | 12 (+예비 2) | 26 × 26 × 16 | 바닥 A–B y 45·90 / 선반 D–B y 150·220 / 상판 C–B y 60·200 | L자 꺾쇠 P36 + 너트 접착 | STEP9 |
| 02 | `02_nozzle_block.stl` | 1 | 80 × 60 × 25 | 선반 D 아래 x 180~240, y 22~82 | 노즐 판 M1 + 걸이 M2 | STEP9·10 |
| 03 | `03_front_bezel.stl` | 1 | 100 × 40 × 3 | 앞판 F 바깥(버튼·LED 둘레) | 없음(마감) | STEP9 |
| 04 | `04_grommet_20.stl` | 2 | 28 × 28 × 9 | 선반 D의 Ø20 구멍 | 고무 그로밋 P44 | STEP9·10 |
| 05 | `05_grommet_12.stl` | 1 | 18 × 18 × 9 | 뒤판 G의 Ø12 구멍(어댑터 선) | 고무 그로밋 P44 | STEP10 |
| 06 | `06_lid_corner_cap.stl` | 4 | 25 × 25 × 13 | 상판 C 네 모서리(C에만 접착) | 없음(마감) | STEP9 |
| 07 | `07_divider_bushing.stl` | 1 | 32 × 32 × 7 | 칸막이 E의 Ø25 구멍(튜브 4가닥) | 없음(튜브 보호·번호) | STEP10 |

**출력 조건(주문할 때)**: PETG 흰색(PLA보다 물·알코올·열에 강함), 레이어 0.2mm, 벽 3겹, 인필 브래킷 50%·나머지 15%, **크기 배율 100%**(너트 홈·구멍 치수 고정), **파일 방향 그대로**(바닥면 z=0, 서포트 없이 출력되게 설계 — 브래킷은 L자 단면이 바닥). 이번 주문은 업로드용 묶음 파일(`plate_A_brackets_x14.stl` · `plate_B_others_x10.stl`)로 했습니다. 다시 주문할 때도 부품별 파일과 견적을 비교해 싼 쪽으로 주문합니다.

**받은 뒤 확인**

| 부품 | 확인할 것 | 안 맞을 때 |
|---|---|---|
| 01 브래킷 | M3 너트가 육각 홈(맞변 5.9)에 들어가고, M3 볼트가 구멍(Ø3.5, 위가 뾰족한 눈물방울 모양)을 지남 | 빡빡하면 볼트로 당겨 넣거나, 줄로 다듬거나, 학교 2차 방문에 Ø3.5 드릴 날로 한 번 훑음, 헐거우면 순간접착제 |
| 02 노즐 블록 | 튜브(외경 6)가 Ø6.2 구멍에 꽉 끼움, 점 1~4개·'앞' 화살표 | 너무 빡빡하면 튜브 끝을 뜨거운 물에 10초, 헐거우면 실링으로 메움 |
| 03 베젤 | 버튼 머리(Ø18)가 Ø18.8 구멍을 지나고, LED 테가 뒤쪽 홈에 앉음 | 줄·사포로 다듬음 |
| 04·05 그로밋 | 트임을 오므려 5mm 판 구멍에 눌러 끼워짐 | 빡빡하면 걸림 부분을 사포로, 헐거우면 글루건 |
| 06 캡 | 상판 C 모서리에 맞고, 옆 다리 아래쪽 5mm(C 아랫면보다 아래)는 B·F·G와 1mm 떨어짐 | 틈은 순간접착제·실리콘으로 메움 |
| 07 부싱 | Ø25 구멍에 들어가고, 튜브 4가닥이 지나감 | 빡빡하면 몸통을 사포로 |

- 치수를 바꿔야 하면(예: 어댑터 플러그가 커서 G 구멍을 키움, 튜브 굽힘 때문에 노즐 블록 높이 25 → 35 — 이때 블록 아랫면 z 220·튜브 끝 z 210으로 내려가 잔 높이는 약 180mm까지가 되고, STEP10 절차 7·확인 포인트의 측정값도 10mm씩 줄임) `../3dprint/parts.py`의 숫자를 고쳐 다시 만듭니다(`pip install manifold3d` 후 `python parts.py out`).
- 3D 출력물은 어떤 필라멘트도 식품용 인증이 없습니다. 음료가 지나가는 길은 실리콘 튜브와 체크밸브뿐이고, 출력물(노즐 블록)에는 닿지 않게 튜브 끝을 10mm 내리고 위쪽을 실링합니다([1.3](#food), STEP10 절차 7).

#### 출력 부품이 깨지거나 맞지 않을 때 (대안)

다시 출력하면 2~5일이 걸립니다. 기다릴 수 없을 때 아래 대안을 씁니다. 자세한 방법은 예전 판 [조립가이드](조립가이드.md)의 해당 STEP에 있습니다.

| 부품 | 대안 | 자세한 방법 |
|---|---|---|
| 01 브래킷 | 먼저 예비 2개로 교체. 더 모자라면 L자 꺾쇠(약 25mm, 예전 BOM P36) + M3 볼트·너트(상판 C용은 너트를 꺾쇠 아래에 순간접착제로 붙여 둠) | 조립가이드 STEP9 절차 다 |
| 02 노즐 블록 | 포맥스로 노즐 판 M1(60×60, Ø6.5 구멍 4개 한 줄) + 걸이 M2(60×20) 2개를 붙여 "ㄷ"자 블록. 튜브는 3mm만 내려 튜브 끝 약 z 227 | 부록 B M1·M2 행, 조립가이드 STEP10 절차 7 |
| 03 베젤 · 06 모서리 캡 | 없이도 동작에는 문제없음(마감용) | — |
| 04 · 05 그로밋 | 고무 그로밋(판 두께 5mm용, 예전 BOM P44) 또는 구멍 가장자리를 글루건으로 둥글게 마감(전선 피복 보호가 목적) | 조립가이드 STEP9 절차 나 |
| 07 튜브 부싱 | 튜브 4가닥을 2×2로 묶어 Ø25 구멍으로 통과(번호 테이프로 구분) | 조립가이드 STEP10 절차 7 |

## 부록 E. 용어 사전 {#appE}

처음 보는 낱말이 나오면 여기서 찾으세요. (가나다순이 아니라 처음 나오는 순서에 가깝게 묶었습니다.)

| 용어 | 뜻 | 이 가이드에서 |
|---|---|---|
| 피복 · 심선 | 전선 겉의 비닐(피복)과 속의 구리 가닥(심선) | 피복을 정해진 길이만큼 벗겨 심선을 꼬아 씀 ([2.6](#skills)) |
| AWG | 전선 굵기 번호. **숫자가 작을수록 굵음** | AWG20(빨강·검정 2심, 굵음) · 22AWG(UL1007 노랑·검정·빨강) |
| 도통 | 두 점이 전선으로 이어져 있는지. 멀티미터 `•)))` 모드에서 "삐" 소리가 나면 이어진 것 | 전원 없이 배선 확인 (STEP1·5·6) |
| 단락(쇼트) | +와 −(또는 서로 달라야 할 두 선)가 직접 닿은 것. 큰 전류가 흘러 뜨거워지고 부품이 상함 | 전원 넣기 전 TB1–TB2 단락 검사 (STEP4·6) |
| 극성 | +/− 방향이 정해져 있는 것 | 다이오드 · 커패시터 · LED · DC 단자 (그림 6) |
| 다이오드 · 띠(캐소드) | 전기를 한 방향으로만 흘리는 부품. 몸통의 띠 쪽이 캐소드(−), 반대쪽이 애노드(+) | 1N4007 띠 쪽 = 펌프 빨강(+) (STEP3) |
| 역기전력 | 모터를 끄는 순간 생기는 거꾸로 된 높은 전압. 다이오드가 흘려보내 부품을 보호 | 펌프마다 다이오드 1개 |
| 전해 커패시터 | 전기를 잠깐 모아 두는 부품. 띠 쪽 짧은 다리가 −. 반대로 꽂으면 터질 수 있음 | C1 1000µF — 펌프가 켜질 때 전압이 떨어지는 것을 막음 |
| 릴레이 · NO / COM / NC | 작은 신호로 큰 전기를 켜고 끄는 스위치. COM은 공통, NO는 평소 떨어져 있다가 켜지면 붙음, NC는 그 반대 | 펌프는 **NO**에 연결 (STEP1·5) |
| JD-VCC 점퍼 · A안/B안 | 릴레이 모듈의 코일 전원(JD-VCC)과 입력 전원(VCC)을 잇는 작은 캡. 캡을 빼면 A안, ⑨(+5V)를 입력 헤더 VCC로 옮기고 캡을 끼우면 B안 | STEP2 절차 다·라에서 결정 |
| Active-LOW | 신호가 LOW(0V)일 때 켜지는 방식 | 이 릴레이는 LOW = 켜짐 |
| GND · 5V · 3V3 | 기준 전위(0V) · 5볼트 전원 · 3.3볼트 전원 | TB2 = GND, TB1 = +5V, TB3 = 3V3 |
| 별형 접지 | 여러 GND를 한 점(J1 −)에서 나눠 잡음을 줄이는 배선 | ⑤ → TB2(펌프), ⑦ → ESP32 |
| 브라운아웃 | 전압이 순간적으로 떨어져 ESP32가 스스로 재부팅되는 것 | 4장 문제 해결 |
| 브레드보드 · 레일 | 납땜 없이 부품을 꽂아 시험하는 구멍 판 · 그 가장자리의 +/− 긴 줄(한 줄이 끝까지 이어져 전원·GND를 나눠 줌) | STEP2 시험 |
| EN 버튼 | ESP32 보드의 리셋 버튼(누르면 다시 시작) | STEP2·7 |
| 실크 인쇄 | 보드 위에 흰 글씨로 찍힌 핀 이름·표시 | 확장보드·릴레이 핀 확인 |
| 스탠드오프(서포트) · 속판 | 보드를 판에서 띄워 고정하는 작은 기둥 · 전장 박스 안에 부품을 붙이는 판 | STEP5 |
| 모따기 | 모서리를 비스듬히 깎은 면 | 출력 브래킷 01의 바깥 모서리 |
| 듀폰선(점퍼선) F/F · M/F · M/M | 끝이 소켓(F, 암) 또는 핀(M, 수)인 시험용 선 | 릴레이 입력 · 부저 핀 |
| 레버 커넥터 | 피복 벗긴 선을 넣고 레버를 내리면 물리는 이음 부품. 안의 구멍은 모두 이어져 있음 | PCT-418(8구 분배기) |
| 나사 단자 · 푸시인 단자 | 나사를 조여 선을 무는 단자 · 버튼을 누른 채 선을 넣는 단자 | J1·릴레이 출력 · ESP32 확장보드 |
| 납땜 · 냉납 | 녹인 납으로 금속을 잇는 것. 납이 회색 덩어리로 굳으면 접촉이 나쁜 "냉납" | 학교 실습실 (2.6 바) |
| 솔더 슬리브 | 납 고리와 접착 고리가 든 수축튜브. 열풍기로 데우면 이음 + 방수가 한 번에 됨 | 펌프 리드 이음 (STEP3) |
| 수축튜브 | 열을 가하면 줄어드는 절연 튜브 | 납땜부 절연 |
| 펌웨어 · 업로드 | ESP32 안에서 도는 프로그램 · PC에서 보드로 그 프로그램을 넣는 것 | Arduino IDE (STEP2·7) |
| 시리얼 모니터 | PC에서 USB로 ESP32와 글자를 주고받는 창. 속도 115200 | `{"cmd":"hello"}` 같은 명령 |
| BLE | 블루투스 저전력. 휴대폰 앱과 기기가 공유기 없이 바로 통신 | 앱 연결 (STEP7) |
| 체크밸브 · 바브 | 한 방향으로만 흐르게 하는 밸브 · 튜브를 끼우는 톱니 모양 끝 | 화살표가 노즐 쪽 (STEP8) |
| 프라이밍 | 튜브 속 공기를 빼고 액체로 채우는 것 | 앱 기기 탭 (STEP8·11) |
| 캘리브레이션 · 유량 | 펌프가 1초에 내보내는 양(ml/초)을 재서 저장하는 것 | 앱 마법사 (STEP11) |
| 사이펀 | 노즐이 액면보다 낮으면 펌프가 꺼져도 액체가 계속 흐르는 현상 | 노즐을 액면보다 60mm 높게 |
| 드립 루프 | 전선을 U자로 늘어뜨려 물방울이 구멍으로 타고 들어가지 않게 하는 것 | 선반 그로밋 아래 (STEP10) |
| 포맥스 | PVC를 발포한 가벼운 판(5T = 두께 5mm). 커터칼로 자를 수 있음 | 외형 판 (STEP9) |
| 그로밋 | 판 구멍에 끼워 전선 피복이 긁히지 않게 하는 테 | 출력 04·05 |
| 캡티브 너트 | 미리 붙여 두어 돌지 않는 너트. 볼트만 돌려 조이고 풂 | 상판 C 고정 |
| 스텝드릴 · 테이퍼 리머 | 계단 모양으로 여러 지름 구멍을 내는 드릴 날 · 손으로 돌려 구멍을 넓히는 원뿔 공구 | 구멍 뚫기 |
| PETG · 인필 | 3D 프린팅 재료(물·열에 PLA보다 강함) · 출력물 속을 채운 비율 | 출력 부품 (부록 D) |

---

*그림 원본: `figures/` · 인쇄용: `제작가이드_납땜기준.html` · 이 가이드는 `src/제작가이드.src.md` 한 원본에서 두 기준을 함께 만듭니다(`python src/build_guides.py`) · 회로도: `../circuit/회로도.html` · BOM: `../BOM_납땜기준.md` · 3D 프린팅 부품: `../3dprint/`*
