paperji/smart-bartender/hardware/guide/src/제작가이드.src.md

# 초보자용 제작가이드 (⟦납땜 기준¦무납땜 기준⟧) — 사용자의 감정 및 취향 분석 기반 AI 맞춤형 음료 및 칵테일 배합 메이커

> 팀 **홍당무** · 안양대학교 정보전기전자공학과 캡스톤디자인Ⅱ (2026/2학기) · 작성 2026-11-10 · 2026-11-11 부품 구매 반영 · 최신화 BOM·970ml 용기·3D 프린팅 부품 반영
> 목표: 2학기 **졸업작품 시제품** · **기말 시연(발표)** · 졸업논문·특허용 실험 데이터 · 앱 화면 이름: "AI 스마트 바텐더" · 하드웨어 v2
>
> **이 가이드는 ⟦납땜 기준¦무납땜 기준⟧입니다.** ⟦원래 설계 그대로 **인두기로 납땜**합니다. 집에 납땜 도구가 없으므로 **납땜과 드릴 작업은 학교 실습실에서 두 번에 몰아서** 합니다([2.5](#s2-5)). 집에서만 만들고 싶으면 [무납땜 기준 제작가이드](제작가이드_무납땜기준.md)를 보세요.¦**인두기·열풍기 없이 집에서** 만듭니다. 원래 납땜하던 20여 곳을 **레버 커넥터**(선을 꽂고 레버만 내리면 이어지는 부품)와 **선이 미리 달린 부품**으로 바꿨습니다. 구멍 뚫기(드릴)만 학교에서 빌리거나 손공구로 합니다([2.5](#s2-5)). 납땜으로 만드는 원래 방법은 [납땜 기준 제작가이드](제작가이드_납땜기준.md)에 있습니다.⟧
>
> **기준 문서** (이 가이드와 숫자가 다르면 아래 문서가 우선입니다)
> - 부품 목록(BOM): [`../BOM_⟦납땜¦무납땜⟧기준.md`](../BOM_⟦납땜¦무납땜⟧기준.md) · `../BOM_⟦납땜¦무납땜⟧기준.xlsx` (부품 번호 **⟦P01~P72 · P80¦P01~P80⟧**, 2026-11-11) · 두 기준 비교 통합판 `../BOM.xlsx`
> - 시스템 명세: `../../docs/SPEC.md` (v3.0 — 핀맵 · BLE 프로토콜은 v2.1 그대로 · 앱 동작)
> - 회로도·실물 배선도: `../circuit/회로도.html` (`../circuit/schematic.svg`, `../circuit/wiring.svg`) — 전기 회로는 두 기준이 같습니다⟦.¦(무납땜은 선을 잇는 방법만 다름).⟧
> - 3D 프린팅 부품(출력 부품 01~07): `../3dprint/` (STL·모델 코드·출력 조건) — [부록 D](#appD)
> - 펌웨어 설명서: `../../firmware/README.md`, 앱 설명서: `../../app/README.md`
> - 앱 받기(v3.1): 웹앱 [https://paperji.github.io/smart-bartender/](https://paperji.github.io/smart-bartender/) (Chrome·Edge) · 안드로이드 APK / Windows EXE [https://github.com/paperji/smart-bartender/releases/latest](https://github.com/paperji/smart-bartender/releases/latest)
> - 예전 판: [`조립가이드.md`](조립가이드.md) (2026-11-06 — 3D 출력 부품이 없을 때의 대안 방법까지 들어 있음)

## 처음이라면 — 이것만 기억하세요 {#first}

1. **배선을 만지기 전에는 항상 어댑터를 콘센트에서 뽑습니다.** 스위치만 끄면 안쪽 단자(J1⟦¦와 뒤판 G 쪽 레버 커넥터 G1⟧)에는 아직 전기가 있습니다.
2. **한 STEP의 확인 포인트(✔)를 모두 통과해야** 다음 STEP으로 넘어갑니다. 문제는 일찍 찾을수록 고치기 쉽습니다.
3. **방향(+/−)이 있는 부품은 4가지**뿐입니다: 다이오드(띠 쪽), 커패시터(띠 쪽이 −), LED(긴 다리가 +), DC 단자 J1. 꽂기 전에 [그림 6](#step1)과 비교합니다.
4. **펌프는 물 없이 돌리지 않습니다.** 공회전하면 망가집니다.
5. **선을 자르면 바로 양 끝에 번호 테이프**(①~㊱)를 붙입니다. 같은 색 선이 많아 번호가 유일한 구분 방법입니다.
6. **이 기기에서 나온 액체는 아무도 마시지 않습니다**(펌프·튜브가 식품용이 아님 — [1.3](#food)). 시연은 색 물로 합니다.
7. 막히면 멈추고 [4장 문제 해결 표](#s4)를 봅니다. 모르는 낱말은 [부록 E 용어 사전](#appE)에서 찾고, 손기술은 [2.6](#skills)에서 먼저 연습합니다.

### 지금까지 준비된 것 (2026-11-11 기준) {#status}

| 항목 | 상태 | 할 일 |
|---|---|---|
| 3D 프린팅 출력 부품 7종 24개 (P70) | 주문 완료(결제 78,700원), **11/16 도착 예정** | 받은 날 [부록 D](#appD) '받은 뒤 확인' 표대로 검사 |
| 포맥스 5T 흰색 3장 (P34) | 구매 완료 | 600×900 통판인지, 재단된 판인지 확인 → 통판이면 STEP9에서 직접 재단 |
| 용기 (P32) | **다이소 직사각 저장 용기 970ml 5개 구매 완료(11-11)** (처음 산 TARK 1L은 폭 120mm라 본체에 안 들어가 취소·환불) | 4개가 같은 제품인지 · 펌프가 들어가 눕는지 · 리드 길이 확인 — [2.4](#s2-4) |
| 디바이스마트 추가 부품 | **무납땜 기준 35품목 주문 완료(11-11)** — 결제 102,528원(배송비 3,000원 포함), 배송 대기 | 받으면 [STEP1](#step1) 검수 — 거래명세서와 수량 대조(볼트·너트는 25개씩)⟦. 이 납땜 기준으로 만들려면 납땜 전용 3품목(P13·P14·P26, 5,203원 + 배송비 약 2,700원)을 더 주문 — BOM 엑셀 `주문_링크` 시트¦⟧ |
| 다이소 물건 (코스터 P33 · 자석 P45 · 철판 P80 · 폼 테이프 P71 · 절연테이프 P79) | 구매 완료(11-11, 결제 14,000원 — 배송비 3,000원 포함) | 영수증 보관(정산) |
| 학교 실습실 공구 | 빌릴 수 있는지 아직 모름 | ⟦인두기·열풍기·드릴·스텝드릴·글루건¦드릴·스텝드릴·글루건⟧ 대여 문의 — [2.2](#s2-2) |

## 이 가이드 읽는 법 {#howto}

- 부품 이름 뒤의 **P번호**(예: 수중펌프 P09)는 BOM 번호와 같습니다. 부품 상자에도 P번호를 적어 두면 찾기 쉽습니다.
- 전선 번호 **①~㊱**은 회로도 산출물 `../circuit/회로도.html`의 "③ 연결표"와 `../circuit/wiring.svg`(배선도)의 동그라미 번호와 **같습니다**. [STEP5 연결표](#wiring-table)에 같은 번호로 옮겨 적었습니다. 전선 양 끝에 마스킹테이프로 번호를 붙이세요.
- 회로 기호(U1, K1~K4 = 릴레이 채널 1~4, M1~M4, D1~D4, J1, SW1, SW2, F1, TB1(+5V)·TB2(GND)·TB3(3V3), C1, R1, LED1, BZ1)는 회로도와 같습니다.
  단, **"M1"은 회로도에서는 펌프 1**입니다. 이 가이드에서는 펌프를 "펌프 1~4"라고 적습니다.
- 각 STEP은 **목표 → 어디서·난이도 → 준비물 → 소요 시간 → 그림 → 절차 → 확인 포인트(✔) → 흔한 실수(⚠)** 순서입니다.
  - **어디서**: "집" 또는 "학교 실습실"(공구를 빌려야 하는 작업). **난이도**: ★☆☆ 쉬움 · ★★☆ 보통 · ★★★ 꼼꼼함이 필요함.
  - 절차 속 *"왜?"* 는 그렇게 하는 이유입니다. 이유를 알면 실수가 줄어듭니다.
- **출력 부품 01~07**은 3D 프린팅 업체에 주문해 받는 부품입니다([부록 D](#appD)). 이 가이드는 **출력 부품을 쓰는 방법만** 설명합니다. 출력 부품이 깨지거나 맞지 않을 때의 대안은 부록 D 끝에 모았습니다.
- `□` 체크박스는 인쇄해서 펜으로 표시하며 진행하세요. (인쇄용: `제작가이드_⟦납땜¦무납땜⟧기준.html` → Ctrl+P → A4. 화면에서 누른 체크는 그 브라우저에 저장됩니다.)
- 좌표는 **x = 왼쪽→오른쪽(앞에서 볼 때), y = 앞→뒤, z = 바닥판 윗면에서 잰 높이**, 단위는 mm입니다.
- "추정"이라고 쓴 숫자는 계산이나 자료로 짐작한 값이라 **직접 재서 확인**해야 합니다.

## 목차 {#toc}

- [처음이라면 — 이것만 기억하세요](#first)
- [0. 완성 사양 · 동작 개요](#s0)
- [1. 안전 수칙](#s1)
- [2. 준비물 · 일정 · 기본 손기술](#s2)
- [3. 단계별 제작](#s3)
  - [STEP 1. 부품 검수 · 멀티미터 기초](#step1)
  - [STEP 2. 브레드보드 단위 테스트](#step2)
  - [STEP 3. 펌프 모듈 만들기 (뚜껑 · 연장선 · ⟦납땜 · 열수축¦레버 커넥터⟧ · 다이오드)](#step3)
  - [STEP 4. 전원부 (DC 단자 · 스위치 · 퓨즈 · 분배 커넥터 · 커패시터)](#step4)
  - [STEP 5. ESP32 · 릴레이 영구 배선 (연결표)](#step5)
  - [STEP 6. 전원 넣기 전 점검 · 첫 전원 투입](#step6)
  - [STEP 7. 펌웨어 업로드 · 앱 블루투스 연결](#step7)
  - [STEP 8. 배관 (튜브 · 체크밸브 · 누수 테스트)](#step8)
  - [STEP 9. 외형 제작 (재단 · 구멍 · 앞판 · 조립 · 방수)](#step9)
  - [STEP 10. 최종 조립 · 배선 정리](#step10)
  - [STEP 11. 캘리브레이션 (유량 맞추기)](#step11)
  - [STEP 12. 시운전 · 세척 · 보관](#step12)
- [4. 문제 해결 표](#s4)
- [5. 시연(발표) 체크리스트](#s5)
- [6. 개선 아이디어](#s6)
- [부록 A. 핀맵 요약](#appA) · [부록 B. 재단표](#appB) · [부록 C. 캘리브레이션 기록표](#appC) · [부록 D. 3D 프린팅 부품](#appD) · [부록 E. 용어 사전](#appE)

<!-- pagebreak -->

## 0. 완성 사양 · 동작 개요 {#s0}

### 0.1 완성 사양

| 항목 | 내용 |
|---|---|
| 외형 | 폭 420 × 깊이 260 × 높이 380 mm (고무발 10mm 별도), 흰색 포맥스 5T + 3D 프린팅 부품 7종(모서리 브래킷·노즐 블록·앞면 베젤·그로밋 2종(Ø20용·Ø12용)·상판 모서리 캡·튜브 부싱, PETG, [부록 D](#appD)) |
| 구조 | 위: 전장부(전자 부품 박스) / 아래 뒤: 용기 칸(용기 4개) / 아래 앞 가운데: 잔 칸 |
| 재료 수 | 4가지 (펌프 1~4). 두 번째 릴레이(P08 예비)를 달면 8가지까지 확장 가능 (펌웨어 `PUMP_COUNT`) |
| 용기 | **다이소 직사각 저장 용기 970ml**(품번 1069852) 4개 — 약 앞뒤 105 × 좌우 80 × 높이 150 mm(뚜껑 포함), 몸체 PET(60℃까지)·돌려 닫는 PP 뚜껑. 칸 하나에 들어가는 한계는 좌우 ≤ 95, 앞뒤 ≤ 135, 높이 ≤ 170 mm |
| 노즐 높이 | 튜브 끝 z 220 mm (출력 노즐 블록 02 아랫면 z 230에서 튜브를 10mm 내림). 설계상 최대 액면 z 160보다 60mm 높음(970ml 용기는 높이 150이라 실제 액면은 이보다 낮음) → 잔 높이 약 190mm까지 |
| 제조량 | 한 잔 30~500 ml (재료 1개 최대 300 ml, 펌프 1개 최대 120초) — SPEC §2.3 |
| 유량 | 약 3~6 ml/초 (체크밸브 포함, **추정**). 캘리브레이션으로 펌프마다 실제 값 저장 |
| 한 잔(200 ml) 시간 | 약 35~65초 (추정) |
| 전원 | DC 5V 4A 어댑터(P11) → ⟦로커 스위치 SW1(P13) → 3A 퓨즈 F1(패널형 홀더 P14)¦선 달린 로커 스위치 SW1(P73) → 3A 퓨즈 F1(인라인 홀더 P74)⟧ → 분배 커넥터 TB1(+5V)·TB2(GND)·TB3(3V3) |
| 제어 | ESP32 DevKitC(P01) + 4채널 릴레이(P08), 펌웨어 v2.1.2 |
| 선 잇는 방법 | ⟦인두 납땜 약 20~23곳 + 솔더 슬리브 8곳 + 수축튜브(학교 실습실)¦레버 커넥터(PCT-413·412·415·418)와 선 달린 부품, 절연은 절연테이프 — 납땜 0곳⟧ |
| 통신 | 블루투스 저전력(BLE, Nordic UART). 공유기·IP 주소 필요 없음 |
| 조작 | 스마트폰 앱 + 기기 앞면 시작/정지 버튼(비상정지) + 상태 LED + 부저 |

### 0.2 동작 순서 (한 잔이 만들어지기까지)

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

그림 1. 시스템 구성도

그림 2. 완성 모습

### 0.3 세 구역으로 나누는 이유

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

그림 3. 외형 3면도 (단위 mm)

그림 4. 내부 배치도

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

### 0.4 전기 연결 요약 (SPEC §1)

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

<!-- pagebreak -->

## 1. 안전 수칙 {#s1}

### 1.1 전기

- [ ] **배선을 바꾸거나 손댈 때는 항상 어댑터를 콘센트에서 뽑습니다.** 스위치(SW1)만 끄는 것으로는 J1 단자⟦¦와 그에 이어진 ②·G1(SW1 앞쪽)⟧까지 전기가 살아 있습니다.
- [ ] 5V는 감전 위험은 거의 없지만, **+와 −가 직접 닿으면(단락)** 수 A가 흘러 전선이 뜨거워지고 피복이 녹을 수 있습니다. 단락이 나면 **먼저 어댑터(P11)의 내장 보호가 출력을 끊고**(꺼졌다 켜졌다 반복), 3A 퓨즈(F1)는 어댑터 보호가 고장 났거나 더 센 어댑터를 쓸 때를 위한 **백업 보호**입니다. 5V 4A 어댑터로는 단락이 나도 퓨즈가 끊어지지 않을 수 있으므로 **"퓨즈가 멀쩡하다 = 배선이 맞다"가 아닙니다.** 퓨즈를 더 큰 값이나 철사로 바꾸지 마세요.
- [ ] **USB와 어댑터 5V를 동시에 ESP32에 넣지 않습니다(이중 전원 금지).** USB를 꽂기 전에 ⑧(TB1 → ESP32 5V 선)을 뽑고, **뽑은 끝은 테이프로 감쌉니다**(STEP7). PC USB 포트나 보드가 상할 수 있습니다.
- [ ] 극성(+/−)이 있는 부품(다이오드·커패시터·LED·DC 단자)은 그림 6과 비교해 확인한 뒤 연결합니다.
- [ ] **벤치 테스트(STEP2)에는 아직 퓨즈(F1)가 없습니다.** 어댑터를 꽂기 전에 멀티미터로 +5V 레일–GND 레일이 단락(0Ω, 계속 "삐")이 아닌지 보고, 냄새·열이 나면 바로 어댑터를 뽑습니다.
- [ ] 젖은 손으로 전원부를 만지지 않습니다. 액체를 쏟으면 먼저 어댑터를 뽑고 닦습니다.
- [ ] 어댑터(P11)의 콘센트 쪽(220V)은 절대 분해하지 않습니다.

### 1.2 공구

<!--S-->
- [ ] **인두(약 350℃), 열풍기(250~300℃), 글루건**은 화상 위험이 큽니다. 인두는 항상 스탠드에 두고, 열풍기 노즐은 사용 후 5분간 만지지 않습니다.
- [ ] 납땜 연기는 들이마시지 않게 창문을 열거나 선풍기로 옆으로 날립니다. 납땜 후 손을 씻습니다. 학교 실습실의 사용 규칙(환기·보호구·뒷정리)을 따릅니다.
<!--/S-->
<!--N-->
- [ ] 이 기준은 인두·열풍기를 쓰지 않습니다. 남는 뜨거운 공구는 **글루건**(녹은 접착제 약 150~200℃)뿐입니다. 쓰지 않을 때는 받침대에 세워 두고, 녹은 접착제를 손으로 만지지 않습니다.
- [ ] **라이터로 선·수축튜브·포맥스를 데우지 않습니다.** 포맥스(PVC)는 불에 닿으면 유독가스가 나옵니다. 절연은 절연테이프(P79)로 합니다.
<!--/N-->
- [ ] 드릴·스텝드릴을 쓸 때는 판을 클램프로 고정하고 보안경을 씁니다. **회전 공구를 쓸 때는 장갑을 끼지 않습니다**(장갑이 말려 들어갈 수 있음).
- [ ] 커터칼은 쇠자를 대고 몸 바깥쪽으로 긋습니다. 커팅매트 위에서 작업합니다.

### 1.3 식품 위생 — 지금 부품으로는 아무도 마시지 않습니다 {#food}

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

### 1.4 음주 관련

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

<!-- pagebreak -->

## 2. 준비물 · 일정 · 기본 손기술 {#s2}

### 2.1 부품 (BOM 번호 기준) {#s2-1}

"보유" = 1학기에 이미 산 것, "구매" = 이번 학기에 사는 수량(예비 포함 — 11-11에 산 부품은 실제로 산 수량). 상세 사양·구매처·가격은 [`../BOM_⟦납땜¦무납땜⟧기준.md`](../BOM_⟦납땜¦무납땜⟧기준.md) 3장에 있습니다.⟦¦ 납땜 기준과 달라진 부품(P73~P79)은 **굵게** 적었습니다.⟧ **2026-11-11 무납땜 기준의 '구매' 열 부품을 모두 샀습니다**⟦(이 납땜 기준에만 쓰는 P13·P14·P26은 사지 않음)¦⟧ — 물건이 오면 [STEP1](#step1)에서 이 표로 하나씩 확인합니다.

| 확인 | ID | 부품 | 필요 | 보유 | 구매 | 이 가이드에서 쓰는 곳 |
|:-:|---|---|---:|---:|---:|---|
| [ ] | P01 | ESP32 DevKitC WROOM-32D V4 (U1) | 1 | 2 | 0 | STEP2·5 |
| [ ] | P02 | ESP32-DevKitC 터미널 확장보드 Push-in (ElectroCookie) | 1 | 0 | 1 | STEP5 |
| [ ] | P03 | 메탈 푸시 스위치 16mm HX16-B1 (SW2, 시작/정지 버튼) | 1 | 0 | 1 | STEP2·9·10 앞판 |
| [ ] | P04 | 액티브 부저 모듈 ONE005 (BZ1, 선택) | 1 | 0 | 1 | STEP2·9·10 앞판 |
| [ ] | P05 | 5mm LED 빨강 (LED1, **필수**) | 1 | 0 | 2 | STEP2·9 |
| [ ] | P06 | 저항 220Ω (R1) | 1 | 0 | 10 | STEP2·9 |
| [ ] | P07 | Micro USB **데이터** 케이블 | 1 | 0 | 1 | STEP2·7 (있으면 생략) |
| [ ] | P08 | 4채널 5V 릴레이 SZH-RLBG-012 (K1~K4) | 1 | 2 | 0 | STEP2·5 |
| [ ] | P09 | 수중펌프 SZH-GNP155 (펌프 1~4, 본체 약 43×23mm) | 4 | 4 | 2(예비) | STEP2·3·8 |
| [ ] | P10 | 다이오드 1N4007 (D1~D4) | 4 | 10 | 0 | STEP2·3 |
| [ ] | P11 | 어댑터 5V 4A | 1 | 1 | 0 | STEP1·2·4 |
| [ ] | P12 | 터미널블럭 to DC 암 단자 (J1) | 1 | 2 | 0 | STEP1·2·4 |
<!--S-->
| [ ] | P13 | 로커 스위치 KCD1-101A (SW1, 단자에 납땜) | 1 | 0 | 1 | STEP4·9·10 |
| [ ] | P14 | 패널형 퓨즈홀더 FH-303 (F1, 단자에 납땜) | 1 | 0 | 1 | STEP4·9·10 |
<!--/S-->
<!--N-->
| [ ] | **P73** | **하네스 로커 스위치 101A-5264** (SW1, 리드선 200mm가 달려 나옴 — P13 대신) | 1 | 0 | 1 | STEP4·9·10 |
| [ ] | **P74** | **인라인 퓨즈홀더 FH-201** (F1, 양쪽에 선이 달린 형 — P14 대신) | 1 | 0 | 1 | STEP4·10 |
<!--/N-->
| [ ] | P15 | 유리관 퓨즈 5×20 3A | 1 | 0 | 3 | STEP4 (2개는 예비) |
| [ ] | P16 | 전해 커패시터 1000µF 16V (C1) | 1 | 0 | 10 | STEP4 |
| [ ] | P17 | 전해 커패시터 100µF 16V (C2, 선택) | 1 | 0 | 10 | STEP5 (선택) |
| [ ] | P18 | 레버형 8구 커넥터 PCT-418 (TB1 +5V · TB2 GND · TB3 3V3) | 3 | 0 | 4 | STEP4·5 |
<!--N-->
| [ ] | **P75** | **3구 레버 커넥터 PCT-413** (펌프 리드 + 연장선 + 다이오드를 한 점에) | 8 | 0 | 10 | STEP3 |
| [ ] | **P76** | **2구 레버 커넥터 PCT-412** (선 두 가닥 1:1 이음) | 8 | 0 | 10 | STEP4(3곳)·9(5곳) |
| [ ] | **P77** | **5구 레버 커넥터 PCT-415** (앞판 GND 모음) | 1 | 0 | 1 | STEP9 |
| [ ] | **P78** | **2.8mm 암 단자 달린 케이블 CG0731** (30cm, 검정) | 2 | 0 | 2 | STEP2·9 버튼 |
<!--/N-->
| [ ] | P19 | AWG20 2심 전선 10m (빨강/검정) | 1 | 1 | 0 | STEP3·4·5 |
| [ ] | P20~P22 | 점퍼 케이블 F/F · M/F · M/M | 각 1 | 각 1 | 0 | STEP2·5·9 |
| [ ] | P23 | 브레드보드 830핀 | 1 | 2 | 0 | STEP2 |
| [ ] | P24 | UL1007 22AWG 전선 10m **노랑** | 1 | 0 | 1 | STEP5·9·10 신호선 ⑩·㉙·㉚·㉝·㉟ (모두 노랑이라 양 끝 번호 테이프로 구분) |
| [ ] | P62 | UL1007 22AWG 전선 10m **검정** | 1 | 0 | 1 | STEP4·5 ⑦(ESP32 GND), STEP9 앞판 GND ㉛⟦·㉜·㉞·㊱¦⟧ |
| [ ] | P63 | UL1007 22AWG 전선 10m **빨강** | 1 | 0 | 1 | STEP5 ⑧(ESP32 5V) |
<!--S-->
| [ ] | P25 | 열수축 솔더 슬리브 1.0SQ | 8 | 10 | 0 | STEP3 펌프 리드 이음 |
| [ ] | P26 | 열수축튜브 세트 | 1 | 0 | 1 | STEP3·4·7·9 |
<!--/S-->
<!--N-->
| [ ] | **P79** | **전기 절연테이프** 19mm×10m 2개입 (다이소, 수축튜브 대신) | 1 | 0 | 1 | STEP3·4·7·9 |
<!--/N-->
| [ ] | P27 | 케이블타이 100mm | 1 | 0 | 1 | STEP⟦5·8·10¦3·4·5·8·10⟧ |
| [ ] | P28 | 케이블타이 접착 마운트 | 10 | 0 | 10 | STEP⟦5·10¦4·5·10⟧ |
| [ ] | P29 | 실리콘 튜브 내경5/외경7 (1m) | 3 | 8 | 0 | STEP8 |
| [ ] | P30 | 실리콘 튜브 내경4/외경6 (1m) | 1 | 5 | 0 | STEP8 |
| [ ] | P31 | 체크밸브 JGB32PPS (CV1~CV4) | 4 | 4 | 1(예비) | STEP1·8 |
| [ ] | P32 | **다이소 직사각 저장 용기 970ml** (품번 1069852, 약 105×80×150mm) | 4 | 0 | 5(예비 1) | STEP1·3·8·10 |
| [ ] | P33 | 실리콘 원형 코스터 2개입 (지름 10cm, 다이소 — 드립 매트) | 1 | 0 | 1 | STEP9·10 |
| [ ] | P34 | 포맥스 5T 흰색 600×900 — **구매 완료** | 3 | 3 | 0 | STEP4(뒤판 G)·9 |
| [ ] | P35 | 화신박스 단자함 EG AGH-152010 (150×200×100, 속판 포함 — 전장 박스) | 1 | 0 | 1 | STEP5·10 |
| [ ] | P37·P38 | M3×10 볼트 · M3 너트 (브래킷 12개 × 2쌍 + 예비 1 — 25개씩 삼, 잃어버리지 않게 따로 보관) | 24 · 24 | 0 | 25 · 25 | STEP9·10 |
| [ ] | P39·P40 | M3 서포트 10mm · M3×6 볼트 | 4 · 8 | 0 | 4 · 10 | STEP5 |
| [ ] | P41 | 고무발 18×10 | 4 | 0 | 10 | STEP9 |
| [ ] | P42·P43 | 순간접착제 · 핫멜트(글루건) 스틱 11mm | 1 · 1 | 0 | 1 · 1 | STEP3·9·10 |
| [ ] | P45 | 네오디뮴 자석 13mm 3개입 (다이소, 뒤 덮개 H용 — 2개 사용) | 1팩 | 0 | 1 | STEP9 |
| [ ] | P80 | 자석용 보조 설치판(접착식 철판) 3개입 (다이소, P45와 짝 — 2개 사용) | 1팩 | 0 | 1 | STEP9 |
| [ ] | P64 | 접착식 벨크로(찍찍이) 55×35mm 10쌍 (Coms T9162) | 1팩 | 0 | 1 | STEP10 전장 박스 고정(4쌍 사용) |
| [ ] | P70 | **3D 프린팅 출력 부품 7종 24개** (PETG 흰색) — **주문 완료, 11/16 도착 예정** | 1식 | 0 | 0 | STEP9·10, [부록 D](#appD) |
| [ ] | P71 | 폼 양면테이프 (오공 18mm×2m, 두께 1mm, 다이소) | 1 | 0 | 1 | STEP5·9 (앞면 베젤·부저⟦¦·GND 모음⟧) |
| [ ] | P65~P69 | (선택) 식품용 튜브·체크밸브 P65~P67 · M3×15 볼트 P68 · 자석·철판 추가분 P69 | 선택 | 0 | 0 | 1.3 · STEP8·9·10 — 아래 메모 |

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

### 2.2 공구 {#s2-2}

| ID | 공구 | 구하는 방법 | 쓰는 곳 |
|---|---|---|---|
| P48 · P72 | 디지털 멀티미터 M300 + 12V **23A 전지**(멀티미터에 들어 있지 않음) | **구매**(둘 다 11-11 디바이스마트 주문 — 집에서 STEP1부터 계속 씀) | 모든 STEP (도통·전압·다이오드 방향) — 다이오드 모드(▶ 기호)는 받은 날 확인(STEP1 절차 3) |
| P49 | 와이어 스트리퍼 TU-2022 (구멍 0.4~1.3mm) | **구매**(11-11 주문) | 피복 벗기기 — [2.6 가](#skills) |
<!--S-->
| P46 · P47 | 인두기 세트 + 실납 1.0mm | 학교 대여 | STEP3·4·9 납땜 (학교 실습실) |
| P52 | 열풍기 | 학교 대여 | STEP3 솔더 슬리브, 수축튜브 (학교 실습실) |
| P53 | 드릴 + 스텝드릴 4~35mm | 학교 대여 | 구멍 약 52~56개 (뚜껑 12 · 뒤판 G 3 · 전장 박스 8~12 · 외형 판 약 29) |
<!--/S-->
<!--N-->
| P53 | 드릴 + 스텝드릴 4~35mm | 학교 대여 (못 빌리면 손공구 — 아래 메모) | 구멍 약 51~55개 (뚜껑 12 · 뒤판 G 2 · 전장 박스 8~12 · 외형 판 약 29) |
<!--/N-->
| — | 일반(트위스트) 드릴 날 **Ø3 · Ø3.5** | 학교 대여 (없으면 구매) | Ø3 안내 구멍 · 뚜껑 공기 구멍, Ø3.5 브래킷·상판·릴레이 고정 구멍 (스텝드릴은 4mm부터라 이 구멍을 못 뚫음). 스텝드릴에 Ø5·Ø7 단이 없으면 한 단 작게 뚫고 줄로 넓힘(받은 날 확인) |
| P51 | 글루건 (11mm 스틱용 — P43) | **집에서 계속 씀** — 학교 것을 집에 가져올 수 없으면 구매 | 구멍 막기·LED 고정·보강 |
| P50 | 니퍼 | **집에서 계속 씀** — 가져올 수 없으면 구매 | 선·부품 다리 자르기 |
| P54 | 커터칼(대) · 쇠자 60cm 이상 · 커팅매트 | **집에서 씀**(재단) — 가져올 수 없으면 구매 | 포맥스 재단 (600×900 통판이면 꼭 필요 — 다이소 50cm 자는 짧음) |
| — | 줄자, 직각자(ㄱ자), 연필, 송곳, 사포 #240, 작은 줄, 십자드라이버, 작은 일자드라이버(릴레이·J1 나사 단자) | 집 | 공통 |
| — | 클램프 2개, 보안경 | 학교 | 드릴 작업 |
| — | 계량컵(100ml 이상) 또는 주방 저울(1g 단위), 스톱워치(휴대폰) | 집 | STEP2·11 |

<!--S-->
> 학교에서 빌릴 수 없을 때(BOM `예산` 시트 '공구 직접 구매'): 인두 최저 구성(인두 ZD-70RA + 스탠드 + 실납) **11,440원** — 열풍기는 사지 않고 수축튜브는 인두 옆면으로 줄입니다(솔더 슬리브는 [STEP3](#step3)의 그림 9 B 방법으로 대신) · 글루건·니퍼 **11,550원** · 드릴 대신 손공구(테이퍼 리머·줄·대형 커터칼) **15,990원**(손으로 하면 몇 시간 걸림).
<!--/S-->
<!--N-->
> **인두기(P46)·실납(P47)·열풍기(P52)는 쓰지 않습니다**(펌프 리드가 3cm보다 짧은 펌프가 있을 때만 그 펌프에 학교 열풍기 — [STEP3](#step3) 절차 3). 학교에서 빌릴 수 없을 때(BOM `예산` 시트 '공구 직접 구매'): 글루건·니퍼 **11,550원** · 드릴 대신 손공구(테이퍼 리머·줄·대형 커터칼) **15,990원**. 포맥스와 PP 뚜껑은 무른 재료라, 송곳으로 작은 구멍을 낸 뒤 테이퍼 리머를 돌려 넓히고 사각 구멍은 커터칼과 줄로 만들 수 있습니다(구멍이 많아 몇 시간 걸림).
<!--/N-->

### 2.3 소모품 {#s2-3}

마스킹테이프(번호 테이프 — 노랑 UL1007 선 구분에 꼭 필요), 네임펜, **폼 양면테이프 P71**, **접착식 벨크로 P64**(전장 박스 고정, 10쌍 중 4쌍 — 필요하면 잘라 씀),⟦ 절연테이프(있으면 편함),¦ **절연테이프 P79**(수축튜브 대신 — 이 기준의 필수 소모품),⟧ 작은 지퍼백(작은 부품을 P번호별로 나눠 담기), 식용색소(시연용 색 물), 키친타월, 물티슈, 식초 또는 베이킹소다(세척), 큰 대야(누수 테스트), 일회용 컵 여러 개.

### 2.4 시작하기 전에 확인할 것 {#s2-4}

- [x] **고정 방식 — 기본으로 정함(11-11 주문 기준)**: 전장 박스는 벨크로 P64, 상판 C는 캡티브 너트입니다(볼트 P68·자석 P69는 사지 않음). 나중에 전장 박스를 볼트로 잡고 싶으면 P68 M3×15와 P38 너트 2개를 더 사고, 선반 D·박스 바닥에 Ø3.5 구멍을 **조립 전에** 뚫습니다(STEP5·STEP10).
- [x] **디바이스마트 주문 — 2026-11-11 완료** — 무납땜 기준 35품목, 결제 102,528원(상품 99,528원 + CG0731 따로 배송 3,000원 · 부품별 내역은 BOM 엑셀 `지출_완료` 시트). 도착까지 1~4일입니다. **멀티미터(P48)·23A 전지(P72)·스트리퍼(P49)·USB 데이터 케이블(P07)도 이 주문에 들어 있으므로, 주문품이 온 뒤에 STEP1을 시작합니다.** 받으면 거래명세서(35줄)와 수량을 하나씩 맞춰 봅니다 — 볼트 P37·너트 P38은 **25개씩**(BOM 계획 30개보다 적음, 필요 24). 거래명세서 원본은 개인정보가 있으니 팀만 보관합니다.
  - 기다리는 동안 할 수 있는 것: 용기 확인(아래), 포맥스 뒤판 G 자르기, [2.6](#skills) 읽기, (집에 데이터용 Micro USB 케이블이 있으면) STEP2 절차 가 펌웨어 업로드.
<!--S-->
- [ ] **납땜 전용 부품 추가 주문 — 학교 1차 방문 전에** — 11-11 주문은 무납땜 기준이라 이 납땜 기준에만 쓰는 **P13 로커 스위치 · P14 패널 퓨즈홀더 · P26 수축튜브**가 없습니다. BOM 엑셀 `주문_링크` 시트에서 3품목(5,203원 + 배송비 약 2,700원 — 66,000원 미만 주문)을 주문합니다.
<!--/S-->
- [x] **용기(P32) — 다이소 직사각 저장 용기 970ml(품번 1069852) 5개 구매 완료(11-11).**
- [ ] **용기 확인** — 집에서 자와 펌프 1개로 아래를 확인합니다(안 맞으면 구매처에서 교환·반품).
  - 4개가 **같은 제품**인지(높이가 같아야 노즐·액면 계산이 맞음)
  - 몸통이 **좌우 ≤ 95, 앞뒤 ≤ 135, 높이 ≤ 170mm**(뚜껑 포함) 안인지 — 970ml는 약 80 × 105 × 150mm라 **좁은 80mm 쪽을 좌우**로 놓습니다.
  - 입구 안지름이 60mm 이상이고 **펌프(약 43×23mm)가 입구로 들어가 바닥에 눕는지**
  - 뚜껑이 손으로 돌려 꽉 닫히는지, 뚜껑 윗면에 구멍 3개(Ø7·Ø5·Ø3)를 낼 평평한 자리가 있는지
  - 산 날 집에서 펌프를 용기 바닥에 눕히고 **리드가 입구 위로 몇 cm 나오는지** 잽니다. **약 5cm 이상**이면 충분합니다(뚜껑 두께와 안쪽 여유 1~2cm를 빼고 뚜껑 위로 3cm 이상 — 추정). ⟦짧은 펌프는 STEP3 절차 3대로 뚜껑 안쪽에서 솔더 슬리브로 잇습니다(학교 1차 방문).¦짧은 펌프가 있으면 아래 학교 대여 문의에 열풍기를 넣습니다.⟧
  - *왜?* 본체 안쪽 폭 410mm에 용기 4개를 한 줄로 넣고(칸 하나 약 98mm), 뚜껑에 펌프를 매달아 넣기 때문입니다.
  - 970ml가 맞지 않으면 **원형 900ml(품번 1035184)** 4개로 바꿉니다(같은 기준으로 확인). 처음 산 TARK 1L(폭 120mm)은 W420 본체에 들어가지 않으므로 취소·환불합니다.
- [x] **다이소에서 함께 산 것 — 11-11 구매 완료**(링크는 BOM 엑셀 `주문_링크` 시트의 '이미 산 것') — 폼 양면테이프 P71(오공 18mm×2m, 2,000원) · 네오디뮴 자석 13mm 3개입 P45(1,000원) + 접착식 철판 3개입 P80(1,000원) · 실리콘 원형 코스터 P33(드립 매트, 1,000원)⟦ · 전기 절연테이프 P79(1,000원 — 무납땜용으로 함께 샀음, 이 기준에서는 있으면 편함)¦ · **전기 절연테이프** P79(1,000원, **STEP3 전에 꼭**)⟧. 멀티미터용 23A 전지(P72)는 디바이스마트 주문에 들어 있습니다. 결제는 14,000원(물건 11,000원 + 배송비 3,000원)입니다. 영수증을 모아 둡니다(정산).
- [ ] **학교 실습실 공구 대여 묻기** — ⟦인두기·열풍기·드릴·스텝드릴·일반 드릴 날(Ø3·Ø3.5)·글루건·니퍼·커터칼/쇠자¦드릴·스텝드릴·일반 드릴 날(Ø3·Ø3.5)·글루건·니퍼·커터칼/쇠자(용기를 산 날 잰 리드가 짧은 펌프가 있으면 열풍기도)⟧를 빌릴 수 있는지, 언제 쓸 수 있는지, **글루건·니퍼·커터칼·쇠자는 집에 가져가 써도 되는지**(집에서 계속 씀) 학과(조교)에 먼저 묻습니다. BOM은 '대여 가능'을 전제로 했을 뿐 확인된 적은 없습니다. 안 되면 [2.2](#s2-2) 아래 메모(공구 직접 구매)를 봅니다.
- [ ] **포맥스(P34, 구매 완료) 확인** — 받은 판이 **600×900 통판**이면 STEP9에서 직접 재단합니다(그림 13 — 커터칼(대)·쇠자 60cm 이상·커팅매트). 맞춤 재단 판이면 [부록 B](#appB) 치수와 맞는지 줄자로 잽니다. **뒤판 G(410×115)는 STEP4에 필요하므로 가장 먼저** 자릅니다 — 판 2에 그림 13대로 모든 선을 먼저 그린 뒤 G 자리만 잘라 냅니다(아무 데서나 자르면 D·E·F 자리가 모자랄 수 있음). 노즐 판 M1·M2는 자르지 않습니다(출력 노즐 블록 02 사용).
- [ ] **3D 출력 부품(P70, 주문 완료 · 11/16 도착 예정)** — STEP 1~8은 출력 부품 없이 할 수 있고, STEP9부터 필요합니다. 받은 날 [부록 D](#appD)의 '받은 뒤 확인' 표대로 끼워 봅니다.
  - 지금 어댑터(P11) **플러그 머리 지름**을 자로 잽니다. 12mm보다 크면 뒤판 G의 Ø12 구멍을 키워야 하고, 이미 주문한 그로밋 05(Ø12용)는 맞지 않습니다 → 구멍 가장자리를 글루건으로 둥글게 마감하거나 05의 구멍 값을 바꿔 다시 출력합니다([부록 D](#appD)).
<!--N-->
- [ ] **무납땜 부품(P73~P78)을 받으면 바로 확인** — ① PCT-413·412·415가 **레버형**인지(레버를 올렸다 내릴 수 있어야 함) ② CG0731의 2.8mm 단자가 버튼(P03) 단자에 꽉 끼워지는지 ③ 하네스 스위치(P73)·퓨즈홀더(P74) 리드선 피복에 인쇄된 굵기(AWG 숫자가 22 이하면 충분 — 숫자가 작을수록 굵음) ④ 버튼 단자 개수. 안 맞으면 [4장](#s4)의 무납땜 줄을 봅니다.
<!--/N-->

### 2.5 일정 예시 (날짜 없는 상대 일정) {#s2-5}

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

<!--S-->
집에는 납땜 도구가 없으므로 **인두·열풍기·드릴이 필요한 일을 학교 실습실에 두 번 가서 몰아서** 합니다. 나머지는 집에서 합니다.

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

#### 학교 1차 방문 — 챙길 것과 순서 {#school1}

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

#### 학교 2차 방문 — 챙길 것과 순서 {#school2}

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

- [ ] 챙길 것: 재단한 판 A·B좌우·C·D·E·F·H, **출력 브래킷 01 전부 · 그로밋 04 2개 · 튜브 부싱 07 · 베젤 03**(구멍에 바로 끼워 보기), 버튼 P03 · LED P05 · R1 P06 · 부저 P04 + 듀폰 F/F 3가닥(㉙·㉚·㉜ 끝), UL1007 **노랑 40cm × 4 · 검정 40cm × 1 · 검정 약 8cm × 2(㉞·㊱) · 약 20cm × 1(㉜)**, 수축튜브, 번호 테이프, 멀티미터, 스트리퍼, 니퍼, 폼 양면테이프 P71, 글루건 스틱 P43, 자·연필·직각자·송곳, 일반 드릴 날 Ø3·Ø3.5(학교에 없을 때)
- [ ] 순서: ① 외형 판 구멍(STEP9 구멍 표 — **Ø3.5 24개**(A 4 · B 12 · D 4 · C 4) · Ø20 × 2 · Ø25 · Ø16 · Ø5, 선택: H 손가락 구멍, 볼트 고정을 고르면 D Ø3.5 × 2) → 뚫자마자 브래킷 01·그로밋 04·부싱 07을 끼워 보고 안 맞으면 그 자리에서 넓힘 → ② F에 버튼·LED → ③ 앞판 납땜(STEP9 절차 다 8)
- [ ] 돌아오기 전에: 버튼을 누를 때만 ㉝–㉛ "삐", 납땜부 모두 수축튜브, 노랑 4가닥 양 끝 번호 테이프
<!--/S-->
<!--N-->
인두·열풍기가 필요 없으므로 거의 모든 일을 집에서 합니다. **드릴이 필요한 구멍만 두 번에 몰아서**(학교 실습실에서 빌리거나 손공구로) 뚫습니다.

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

#### 구멍 뚫는 날 ① — 챙길 것과 순서 {#drill1}

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

#### 구멍 뚫는 날 ② — 챙길 것과 순서 {#drill2}

- [ ] 챙길 것: 재단한 판 A·B좌우·C·D·E·F·H, **출력 브래킷 01 전부 · 그로밋 04 2개 · 튜브 부싱 07 · 베젤 03**(구멍에 바로 끼워 보기), 버튼 P03 · LED P05(구멍 맞춰 보기), 자·연필·직각자·송곳, 일반 드릴 날 Ø3·Ø3.5(학교에 없을 때)
- [ ] 순서: STEP9 구멍 표대로 — **Ø3.5 24개**(A 4 · B 12 · D 4 · C 4) · Ø20 × 2 · Ø25 · Ø16 · Ø5 (선택: H 손가락 구멍, 볼트 고정을 고르면 D Ø3.5 × 2) → 뚫자마자 브래킷 01·그로밋 04·부싱 07을 끼워 보고 안 맞으면 그 자리에서 넓힘
<!--/N-->

### 2.6 기본 손기술 (처음이면 자투리 선으로 먼저 연습) {#skills}

이 가이드에서 반복해서 쓰는 손기술입니다. 실제 부품에 하기 전에 남는 전선으로 두세 번 해 보세요.

#### 가. 피복 벗기기 (와이어 스트리퍼 TU-2022)

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

#### 나. 레버 커넥터 (PCT-418⟦¦ · PCT-412 · PCT-413 · PCT-415⟧)

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

#### 다. 나사 단자 (J1 · 릴레이 출력 단자)

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

#### 라. 푸시인 단자 (ESP32 확장보드 P02)

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

#### 마. 듀폰(점퍼)선 끝 처리

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

<!--S-->
#### 바. 납땜 기초 (학교 실습실에서, 실제 작업 전에 자투리 선으로 3번)

그림은 [STEP3](#step3)의 그림 9(납땜 · 열수축 절차)를 함께 봅니다.

1. 인두를 스탠드에 꽂고 약 350℃로 켭니다. 젖은 스펀지(또는 황동 수세미)로 팁을 닦고 실납을 살짝 녹여 팁을 은색으로 만듭니다.
2. 이을 곳에 **수축튜브를 먼저** 끼워 둡니다. (가장 흔한 실수: 잊고 납땜 → 다시 풀어야 함)
3. 심선을 꼬아 잇고, 인두 팁을 심선에 2~3초 대어 데운 뒤 **실납을 심선 쪽에** 댑니다(인두 끝에 직접 녹이지 않음). 납이 심선 사이로 스며들면 실납 → 인두 순서로 뗍니다.
4. 5초 동안 움직이지 않고 식힙니다. **반짝이고 심선 모양이 보이면 좋음**, 회색의 둥근 덩어리면 "냉납"(접촉 불량)이라 다시 데웁니다.
5. 수축튜브를 이음부 위로 밀어 열풍기(또는 인두 옆면)로 줄입니다.
- ⚠ 인두 팁은 약 350℃입니다. 손에서 놓을 때는 항상 스탠드에 꽂습니다. 포맥스 판·전선 피복에 닿으면 녹습니다.
<!--/S-->
<!--N-->
#### 바. 절연테이프 감기 (수축튜브 대신)

1. 테이프를 살짝 당겨 늘리며 감습니다(늘어난 테이프가 다시 줄어들며 꽉 조임).
2. 한 바퀴마다 **반씩 겹치게** 2~3겹, 드러난 금속보다 양쪽으로 1cm씩 더 감습니다.
3. 끝은 가위로 자르고(손으로 뜯으면 늘어나 들뜸) 손가락으로 눌러 붙입니다. 끝이 들뜨면 케이블타이로 한 번 묶습니다.
- 레버 커넥터 덩어리(STEP3)는 커넥터 2개와 다이오드를 나란히 놓고 한꺼번에 감습니다.
- 수축튜브(P26)가 있으면 헐겁게 씌우고 양 끝을 절연테이프로 감아 고정해도 됩니다(열을 쓰지 않으므로 줄어들지 않음).
<!--/N-->

#### 사. 글루건 · 스텝드릴 · 순간접착제

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

**연습 체크**

- [ ] 자투리 AWG20 · UL1007 · 듀폰선을 각 2번씩 벗겨 봄
- [ ] 레버 커넥터에 넣고 당김 테스트 3번
- [ ] ⟦납땜 3번(학교 1차 방문 첫 10분)¦절연테이프로 이음 하나를 감아 봄⟧

<!-- pagebreak -->

## 3. 단계별 제작 {#s3}

| STEP | 내용 | 어디서 | 난이도 | 소요 시간 | 먼저 끝나야 하는 STEP |
|---|---|---|:-:|---|---|
| 1 | 부품 검수 · 멀티미터 기초 | 집 | ★☆☆ | 1~1.5시간 | — |
| 2 | 브레드보드 단위 테스트 | 집 | ★★☆ | 2~3시간 | 1 |
| 3 | 펌프 모듈 (뚜껑 · 연장선 · ⟦납땜¦레버 커넥터⟧ · 다이오드) | ⟦**학교**(구멍·납땜) + 집(물 시험)¦집 (뚜껑 구멍은 드릴 — 구멍 뚫는 날 ①)⟧ | ★★☆ | ⟦2~3시간¦2~2.5시간⟧ | 1, 용기 구입 |
| 4 | 전원부 | ⟦**학교**(G 구멍·SW1·F1 납땜) + 집¦집 (G 구멍 2개는 드릴 — 구멍 뚫는 날 ①)⟧ | ★★☆ | ⟦2~2.5시간¦1.5~2시간⟧ | 1, 뒤판 G 재단 |
| 5 | ESP32 · 릴레이 영구 배선 | 집 (박스 구멍은 ⟦학교 1차¦구멍 뚫는 날 ①⟧) | ★★★ | 3~4시간 | 2, 4 |
| 6 | 전원 넣기 전 점검 · 첫 전원 | 집 | ★☆☆ | 30분 | 5 |
| 7 | 펌웨어 업로드 · 앱 연결 | 집 | ★☆☆ | 1시간 | 6 |
| 8 | 배관 · 누수 테스트 | 집 | ★★☆ | 2~3시간 | 3, 7 |
| 9 | 외형 제작 | ⟦**학교**(판 구멍·앞판 납땜) + 집(재단·조립)¦집 (판 구멍은 드릴 — 구멍 뚫는 날 ②)⟧ | ★★★ | 6~8시간 (직접 재단) + 접착제 굳는 시간 | 4(뒤판 G), 판 준비, 출력 부품 |
| 10 | 최종 조립 · 배선 정리 | 집 | ★★★ | 3~4시간 | 5, 8, 9 |
| 11 | 캘리브레이션 | 집 | ★☆☆ | 1~1.5시간 | 10 |
| 12 | 시운전 · 세척 · 보관 | 집 | ★☆☆ | 2시간 | 11 |

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

<!-- pagebreak -->

### STEP 1. 부품 검수 · 멀티미터 기초 {#step1}

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

그림 5. 멀티미터 기초

그림 6. 극성(방향)이 있는 부품 확대도

#### 절차

1. **부품 대조** — 2.1 표를 인쇄해 부품을 하나씩 꺼내며 수량과 외관(깨짐·휘어짐)을 확인하고 표에 체크합니다. 디바이스마트 상자는 **거래명세서(35줄)** 와도 수량을 맞춰 봅니다(볼트·너트 25개씩, PCT-413·PCT-412 10개씩, CG0731 2개 — CG0731은 따로 배송되어 늦게 올 수 있음). 작은 부품(저항·다이오드·볼트)은 지퍼백에 P번호를 적어 나눠 담습니다.
   *왜?* 조립 도중 부품이 모자라면 주문·배송에 며칠이 걸립니다.
2. **번호 붙이기** — 펌프 4개, 용기 4개(몸통과 뚜껑 모두), 체크밸브 4개에 마스킹테이프로 1~4 번호를 붙입니다. 같은 번호끼리 한 세트가 됩니다.
3. **멀티미터 준비** — M300 뒷면을 열어 **23A 전지(P72)** 를 넣습니다(제품에 들어 있지 않음). 다이얼에 다이오드(`▶|`) 자리가 있는지 봅니다(판매 페이지에는 적혀 있지 않음). **없으면** 이 가이드의 다이오드 방향 확인(STEP1 절차 7, STEP3)은 저항 모드(2k)로 두 방향을 재서 합니다: 한쪽만 숫자가 나오고 반대쪽이 OL이면, 숫자가 나올 때 **빨강 리드가 닿은 다리가 띠 없는 쪽(애노드)** 입니다. 두 방향 모두 OL이면(멀티미터마다 다름 — 추정) 띠 위치를 사진으로 찍어 팀원과 두 번 확인합니다. 검정 리드를 **COM**, 빨강 리드를 **VΩ** 구멍에 꽂습니다. (A·mA 구멍은 쓰지 않습니다.)
4. **도통 테스트 연습(그림 5 ①)** — 다이얼을 `•)))`(삐 소리) 위치로 돌리고 두 리드 끝을 맞대 보면 "삐" 소리가 납니다. 점퍼선 한 가닥의 양 끝에 대어 삐 소리가 나는지 확인합니다.
   *왜?* 앞으로 "이 선이 저 단자에 제대로 연결됐나?"를 전원 없이 확인할 때 계속 씁니다.
5. **어댑터 전압·극성 측정(그림 5 ②③)** — J1(P12)에 어댑터 플러그를 꽂고 콘센트에 연결합니다. 다이얼을 `V⎓ 20V`(직류 전압)로 두고 빨강을 J1의 **+**, 검정을 **−** 단자에 댑니다.
   - 4.9~5.25V가 나오면 정상입니다.
   - 숫자 앞에 **−**가 나오면 J1의 +/− 표시가 반대이거나 어댑터가 "센터 −" 형입니다. J1의 표시 옆에 실제 극성을 네임펜으로 적어 둡니다.
   - 측정 후 어댑터를 콘센트에서 뽑습니다.
6. **펌프 확인** — 멀티미터를 저항(Ω, 200 또는 2k) 모드로 두고 펌프의 빨강·검정 선 사이를 잽니다. 수 Ω~수십 Ω(추정)이 나오면 정상, **OL**(무한대)이면 선이 끊긴 불량입니다. 펌프는 **물 없이 돌리지 않습니다**(공회전하면 망가짐).
7. **다이오드 확인(그림 6 ①)** — 다이얼을 다이오드(`▶|`) 모드로 두고, 빨강을 띠 없는 쪽(애노드), 검정을 띠 쪽(캐소드)에 대면 0.5~0.7 정도가 나옵니다. 반대로 대면 OL. 4개 모두 확인합니다.
8. **릴레이 모듈 살펴보기 · NO/NC 확인(전원 없이)** — 입력 핀(`GND IN1 IN2 IN3 IN4 VCC`), 옆의 2핀 점퍼(보드 인쇄 `JD-VCC`·`VCC`, 작은 플라스틱 점퍼 캡이 두 핀을 잇고 있음 — 캡 색은 제품마다 다름), 출력 나사 단자에 인쇄된 **NO / COM / NC** 순서를 확인해 사진으로 찍어 둡니다. **JD-VCC 핀 옆에 빨간 네임펜으로 점**을 찍어 둡니다(VCC 핀과 바로 붙어 있어 헷갈리기 쉬움).
   - 멀티미터를 도통(`•)))`) 모드로 두고, 채널마다 나사 단자 3개 중 **COM(보통 가운데)** 과 나머지 두 단자를 차례로 잽니다. **COM–NC = "삐"**, **COM–NO = 소리 없음**이 정상입니다(릴레이가 꺼져 있을 때는 COM과 NC가 붙어 있기 때문). 소리가 안 난 단자 옆에 "NO"라고 적습니다. 4채널 모두 합니다.
   *왜?* 제품마다 단자 순서가 다를 수 있어서, 가이드 그림보다 **보드 인쇄와 멀티미터 결과가 정답**입니다. 펌프를 NC에 물리면 전원을 켜자마자 펌프가 계속 돕니다.
9. **ESP32 확인** — 데이터용 USB 케이블(P07)로 PC에 꽂으면 보드의 빨간 전원 LED가 켜지고, 윈도우 **장치 관리자 → 포트(COM & LPT)** 에 `Silicon Labs CP210x … (COMx)`가 보여야 합니다. 안 보이면 다른 케이블(충전 전용 케이블은 안 됨)을 쓰거나 CP210x 드라이버를 설치합니다.
10. **체크밸브 방향 확인** — 체크밸브(P31) 몸통의 **화살표(FLOW)** 방향으로 입으로 살짝 불면 바람이 통하고, 반대로는 막혀야 합니다. 불량은 예비(P31 추가 1개)로 교체합니다. 확인 후 물로 헹굽니다.
11. **튜브 확인** — 내경5 튜브(P29)를 펌프 출수구에 끼워 보아 헐겁지 않은지, 내경4 튜브(P30)가 체크밸브 바브에 끼워지는지 맞춰 봅니다(끝까지 끼우지 않아도 됨).
12. **용기 확인** — 펌프를 970ml 용기 입구로 넣어 바닥에 눕혀 보고, 뚜껑이 끝까지 돌아가 닫히는지 봅니다. 용기 4개를 나란히 세워 높이가 같은지도 봅니다. 펌프 리드가 입구 위로 몇 cm 나오는지 재서 적습니다(약 5cm 이상이면 STEP3의 "뚜껑 위로 3cm 이상"을 채움 — 추정).
<!--N-->
13. **무납땜 부품 확인** — PCT-413·412·415의 레버를 올렸다 내려 보고(레버형인지), CG0731 단자를 버튼(P03) 단자에 끼워 봅니다(꽉 끼면 정상). 하네스 스위치(P73)·퓨즈홀더(P74)의 리드 피복에 인쇄된 굵기(AWG)를 적어 둡니다. 안 맞는 것은 [4장](#s4)의 무납땜 줄을 봅니다.
<!--/N-->

#### 확인 포인트

- [ ] ✔ 2.1 표의 "보유" 부품이 모두 있음, 부족한 것은 주문 목록에 적음
- [ ] ✔ 어댑터 출력 4.9~5.25V, J1의 +/− 극성 확인 및 표시
- [ ] ✔ 펌프 4개 모두 저항값 정상(OL 아님)
- [ ] ✔ 다이오드 4개 정방향 0.5~0.7, 역방향 OL (다이오드 모드가 없으면 절차 3의 저항 모드 판정)
- [ ] ✔ 릴레이 4채널 모두 COM–NC "삐", COM–NO 무음 → NO 단자에 표시, JD-VCC 핀에 빨간 점
- [ ] ✔ ESP32가 PC에서 COM 포트로 인식됨
- [ ] ✔ 체크밸브 4개 모두 한쪽으로만 통함, 화살표 방향 확인
- [ ] ✔ 펌프가 용기 입구로 들어가고 뚜껑이 닫힘, 용기 4개 높이 같음, 펌프 리드 길이 기록: ____ cm
<!--N-->
- [ ] ✔ 레버 커넥터 3종이 레버형, CG0731 단자가 버튼에 끼워짐, P73·P74 리드 굵기 기록: AWG ____
<!--/N-->

#### 흔한 실수

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

### STEP 2. 브레드보드 단위 테스트 {#step2}

> **목표**: ⟦납땜·조립¦배선·조립⟧ 전에 펌웨어를 올리고, 시리얼 명령으로 릴레이 4개가 "딸깍" 켜지고 꺼지는지, 펌프 1개가 물을 퍼 올리는지 확인한다. 릴레이 연결 방식(A안/B안)을 여기서 결정한다.
> **어디서 · 난이도**: 집 · ★★☆
> **준비물**: ESP32(P01), 릴레이(P08), 어댑터(P11)+J1(P12), 브레드보드(P23), 점퍼선(P20~P22), LED(P05)+220Ω(P06), 1N4007(P10) 1개, 펌프(P09) 1개, 내경5 튜브 30cm, 물컵 2개, USB 케이블(P07), PC, **멀티미터(P48)**, (절차 바, 선택) 버튼 P03 · 부저 P04 · ⟦M/F 점퍼 2가닥¦CG0731(P78) 2개⟧
> **소요 시간**: 2~3시간 (Arduino IDE 설치 포함)

그림 7. 벤치 테스트 연결도 (A안)

#### 절차 가. 펌웨어 업로드 (ESP32만 USB에 연결)

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

#### 절차 나. 상태 LED 테스트

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

#### 절차 다. 릴레이 테스트 — A안 (SPEC 기본)

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

#### 절차 라. (A안이 안 될 때만) B안

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

#### 절차 마. 펌프 1개 물 테스트

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

#### 절차 바. (선택) 버튼·부저 테스트

26. 버튼(P03) 한쪽 단자 → GPIO4(오른쪽 줄 13번, J3-13), 다른 쪽 → GND. 버튼 단자에는 ⟦M/F 점퍼의 F 소켓을 끼워(단자가 두꺼워 안 끼워지면 이 선택 시험은 학교 2차 방문 뒤로 미룸)¦CG0731 단자 케이블(P78) 2개를 두 단자에 하나씩 꽂고, 케이블의 벗긴 끝을 M/M 점퍼선과 꼬아 테이프로 감아⟧ 브레드보드에 잇습니다. 버튼은 방향이 없지만, 단자가 3개 이상이면 멀티미터 도통 모드로 **버튼을 누를 때만 "삐"** 나는 두 단자를 고릅니다(나머지는 버튼 조명용일 수 있음). 대기 중 짧게 누르면 시리얼에 `{"ev":"status",...}`가 나옵니다. 펌프를 20초 돌리는 중에 누르면 즉시 멈추고 `"reason":"button"`이 나옵니다.
27. 부저(P04): 모듈에 인쇄된 핀 이름을 보고 `VCC → 3V3`, `GND → GND`, `I/O → GPIO23`(오른쪽 줄 2번, J3-2). ONE005는 **I/O가 HIGH일 때 울리는** 모듈이라 펌웨어 기본값(`config.h`의 `BUZZER_ON_LEVEL 1`, SPEC §1)과 맞습니다. EN 버튼을 누르면 부팅 때 "삑" 소리가 나야 합니다. 다른 부저로 바꿨는데 부팅 후 계속 울린다면 LOW에 울리는 모듈이니 `BUZZER_ON_LEVEL`을 0으로 바꿉니다.

#### 확인 포인트

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

#### 흔한 실수

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

### STEP 3. 펌프 모듈 만들기 (뚜껑 · 연장선 · ⟦납땜 · 열수축¦레버 커넥터⟧ · 다이오드) {#step3}

> **목표**: 펌프 4개 각각을 "뚜껑 + 펌프 + 70cm 연장선 + 다이오드"가 한 덩어리인 **펌프 모듈**로 만든다. ⟦이음부는 물에 닿지 않는 뚜껑 위에, 다이오드는 젖지 않는 전장 박스 쪽 끝에 둔다.¦이음(레버 커넥터)과 다이오드는 모두 **뚜껑 위**에 두고 절연테이프로 감싼다.⟧
> **어디서 · 난이도**: ⟦학교 실습실(뚜껑 구멍 · 다이오드 납땜 · 솔더 슬리브 — [1차 방문](#school1)) + 집(물 시험)¦집 (뚜껑 구멍만 드릴 — [구멍 뚫는 날 ①](#drill1))⟧ · ★★☆
> **준비물**: 펌프(P09) 4, 용기(P32, 970ml) 4, AWG20 2심(P19) 약 3m, 1N4007(P10) 4, ⟦솔더 슬리브(P25) 8, 수축튜브(P26), 인두(P46)·실납(P47), 열풍기(P52)¦3구 레버 커넥터 PCT-413(P75) 8, 절연테이프(P79), 케이블타이(P27)⟧, 스트리퍼(P49)·니퍼(P50), 멀티미터(P48), 스텝드릴(P53)·송곳, 글루건, 마스킹테이프·네임펜
> **소요 시간**: ⟦2~3시간 (학교 1~1.5시간 포함)¦2~2.5시간⟧

그림 8. 용기 뚜껑 가공 상세 (970ml 용기, ⟦납땜 기준¦무납땜 기준⟧)

<!--S-->
그림 9. 납땜 · 열수축 절차
<!--/S-->
<!--N-->
그림 9. 레버 커넥터로 펌프 리드 · 다이오드 잇기
<!--/N-->

#### 970ml 용기의 돌림 뚜껑

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

#### 절차

1. **연장선 자르기** — AWG20 2심을 **70cm × 4가닥**으로 자릅니다. 양 끝에 펌프 번호(1~4) 테이프를 붙이고, 한쪽 끝에는 "펌프 쪽", 다른 쪽에는 "박스 쪽"이라고 씁니다.
   *왜 70cm?* 용기 바닥 → 뚜껑 → 선반 구멍 → 박스까지 약 40cm에, 용기를 뒤로 30cm 꺼낼 수 있는 여유를 더한 길이입니다. 실제 배치에서 남으면 묶어 두면 됩니다.
2. **뚜껑 가공(그림 8)** — 펌프를 용기 바닥에 눕혀 놓고 뚜껑을 덮어 위치를 봅니다. 뚜껑 윗면의 평평한 부분 안에 **Ø7 튜브 구멍**(펌프 출수구에 가까운 쪽), 거기서 20mm 떨어진 곳에 **Ø5 전선 구멍**, 뚜껑 가장자리에서 10mm 안쪽에 **Ø3 공기 구멍**을 연필로 표시합니다.
   - Ø7·Ø5는 송곳으로 작은 구멍을 낸 뒤 스텝드릴을 **천천히** 돌려 넓히고, Ø3 공기 구멍은 Ø3 일반 드릴 날로 천천히 뚫습니다(스텝드릴은 4mm부터). *왜?* PP 뚜껑은 빨리 돌리면 열로 녹아 구멍이 지저분해집니다.
   - *왜 공기 구멍?* 밀폐용기는 액체를 퍼낼수록 안이 진공이 되어 유량이 줄어듭니다. 작은 구멍 하나로 공기가 들어오게 합니다(SPEC §1). **Ø3 공기 구멍은 글루건으로 막지 않습니다.**
   - 거스러미는 커터칼로 정리합니다. 4개 모두 같은 위치로 가공하고, 뚜껑에도 몸통과 같은 번호를 적습니다.
3. **펌프 리드선 통과** — 펌프의 빨강·검정 리드선을 뚜껑 **안쪽에서 바깥쪽으로** Ø5 구멍에 통과시킵니다. 펌프를 바닥에 눕혀 뚜껑을 덮었을 때 리드가 팽팽하지 않게 **뚜껑 안쪽에 1~2cm 여유**를 남기고, 그 상태에서 뚜껑 위로 **최소 3cm** 나와야 합니다.
<!--S-->
   - 리드가 짧아 뚜껑 위로 나오지 않으면: 뚜껑 안쪽에서 잇고, 이음부를 솔더 슬리브(접착제 내장이라 방수)로 확실히 감싼 뒤 액면보다 높은 곳(뚜껑 바로 아래)에 오게 합니다.
4. **다이오드 하네스(박스 쪽 끝) 먼저 만들기(그림 9 C 오른쪽)** — 학교 실습실에서
   1. 박스 쪽 끝의 빨강·검정을 **약 28cm** 갈라 놓습니다([2.6 가](#skills) 5).
   2. **빨강은 끝에서 약 20cm, 검정은 끝에서 약 23cm** 되는 곳을 자릅니다(두 이음이 3cm 엇갈림). 잘려 나온 **꼬리 2가닥(빨강 20cm · 검정 23cm)** 에도 펌프 번호 테이프를 붙이고, 잘린 네 끝을 모두 **8~10mm** 벗깁니다.
   3. **수축튜브를 먼저 끼웁니다**: 가는 튜브(약 2cm)를 빨강 꼬리·검정 꼬리에 하나씩 끼워 꼬리 끝 쪽으로 밀어 두고, 굵은 튜브 1개(약 6cm)는 케이블 쪽 빨강·검정 두 가닥을 함께 감싸게 끼워 2심이 붙은 곳까지 멀리 밀어 둡니다.
   4. 다이오드를 두 이음 사이에 **선과 나란히** 놓습니다(띠 쪽이 빨강 이음, 반대쪽이 검정 이음 — 3cm 거리에 맞춰 다리를 자름). **빨강 이음**: 케이블 쪽 빨강 + 빨강 꼬리 + 다이오드 **띠(캐소드) 쪽 다리**를 함께 꼬아 납땜. **검정 이음**: 케이블 쪽 검정 + 검정 꼬리 + 다이오드 반대쪽 다리를 같은 방법으로. 가는 튜브를 각 이음 위로 밀어 수축한 뒤, 굵은 튜브를 다이오드와 두 이음 위로 밀어 한꺼번에 수축합니다(Y자 이음 — 그림 9 C는 연결 관계만 그린 것).
   5. 꼬리 끝을 벗깁니다: **빨강 6~7mm(릴레이 NO 나사 단자), 검정 10~11mm(TB2 레버 커넥터)**.
   6. **바로 확인**: 멀티미터 다이오드 모드로 꼬리 끝에서 **검정 리드 → 빨강 꼬리, 빨강 리드 → 검정 꼬리**에 대면 0.5~0.7, 반대로 대면 OL이어야 합니다(다이오드 모드가 없으면 STEP1 절차 3의 저항 모드 판정).
   *왜 꼬리를 길게?* 빨강은 릴레이 NO, 검정은 TB2로 따로 가야 하고, 굵은 이음 덩어리는 박스 벽 구멍 밖(선반 위)에 두고 가는 꼬리만 구멍을 지나게 하려는 것입니다. 다이오드를 선 맨 끝에 달면 두 끝이 다이오드 길이만큼밖에 벌어지지 않아 두 단자에 동시에 닿지 않을 수 있습니다.
   *왜 먼저?* 펌프를 연결하면 펌프 코일이 다이오드와 나란히 붙어 멀티미터로 방향을 확인할 수 없습니다. 펌프를 잇기 전에 확인해야 합니다.
   *왜 박스 쪽?* 다이오드와 납땜부가 액체·습기에 닿지 않는 곳에 있어야 오래갑니다. SPEC §1은 다이오드 위치를 "펌프 리드선 이음부(뚜껑 위) 또는 연장선의 박스 쪽 끝 — **전기적으로 동일**"이라고 정해 두었습니다. 어느 쪽이든 펌프와 **병렬**이고 **띠 = 빨강(+)** 이면 똑같이 동작합니다.
5. **이음(그림 9 A — 솔더 슬리브)** — 학교 실습실에서
   1. 이음 위치가 **2cm 엇갈리도록** 자릅니다(그림 9 C 왼쪽): 펌프 리드가 뚜껑 위로 5cm 이상 나오면 **펌프 검정 리드를 2cm 짧게**, 연장선은 펌프 쪽 끝을 약 5cm 가른 뒤 **빨강만 2cm 잘라 냅니다**(그러면 검정이 2cm 길어져 길이가 맞음)(리드가 그보다 짧으면 자르지 않음 — 슬리브가 이음을 하나씩 감싸므로 엇갈리지 않아도 됨). 그다음 펌프 리드와 연장선(펌프 쪽 끝)의 피복을 각각 **8~10mm** 벗깁니다.
      *왜?* 두 이음이 나란히 있으면 굵어지고, 혹시 피복이 벗겨졌을 때 서로 닿아 단락될 수 있습니다.
   2. 솔더 슬리브(P25)를 굵은 연장선 쪽에 먼저 끼웁니다.
   3. 두 심선을 나란히 겹쳐 살짝 비틀고, 슬리브를 밀어 와서 **가운데 은색 납 고리가 겹친 곳 한가운데** 오게 합니다.
   4. 열풍기(약 250~300℃ 또는 1단)를 슬리브 가운데부터 쬡니다. 은색 납이 녹아 심선 사이로 스미고, 양 끝 빨간 접착 고리가 녹아 선에 달라붙으면 끝입니다(약 20~40초).
   5. 식힌 뒤 양쪽을 살짝(약 1kg 힘) 당겨 빠지지 않는지 봅니다.
   - **열풍기를 빌리지 못하면 그림 9 B**: 수축튜브를 먼저 끼우고 → 심선을 꼬아 잇고 → 인두로 심선을 3초 데운 뒤 실납을 심선에 대어 녹이고(인두 끝에 직접 녹이지 않음) → 식힌 뒤 수축튜브를 덮어 인두 옆면으로 수축합니다.
6. **색 확인** — 펌프 빨강 ↔ 연장선 빨강, 펌프 검정 ↔ 연장선 검정인지 다시 봅니다. 판매처 안내대로 **빨강 = +**입니다.
<!--/S-->
<!--N-->
   - **(선택 대안) 리드가 3cm보다 짧으면**: 레버 커넥터는 **방수가 아니므로 뚜껑 안쪽(용기 안)에 둘 수 없습니다.** 그 펌프만 학교에서 열풍기를 빌려, 뚜껑 안쪽에서 펌프 리드에 AWG20 짧은 선(빨강·검정 각 약 6cm)을 보유한 솔더 슬리브(P25)로 이어(방수 — 방법은 [납땜 기준 가이드](제작가이드_납땜기준.md) STEP3 절차 5의 1~5) 뚜껑 위로 3cm 이상 빼냅니다. 그 끝을 펌프 리드 대신 아래 절차 4~9대로 PCT-413에 꽂습니다(다이오드 위치는 그대로). 용기를 산 날(2.4)·STEP1에서 잰 리드 길이를 먼저 보고, 짧은 펌프가 있으면 2.4의 대여 문의에 열풍기를 넣습니다.
4. **선 끝 벗기기** — 연장선 **펌프 쪽 끝**의 빨강·검정을 약 5cm 갈라 각각 피복을 **9~10mm**, 펌프 리드도 **9~10mm** 벗깁니다(가는 리드가 헐겁게 물리면 두 배 길이로 벗겨 접어 꼬기 — [2.6 나](#skills)). 연장선 **박스 쪽 끝**은 빨강 **6~7mm**(나중에 릴레이 나사 단자), 검정 **10~11mm**(나중에 TB2 레버 커넥터)를 벗겨 둡니다.
5. **다이오드 다리 준비** — 1N4007 몸통의 **띠(캐소드) 쪽 끝에 빨간 네임펜으로 점**을 찍고, 두 다리를 각각 약 12mm만 남기고 니퍼로 자릅니다.
   *왜?* 레버 커넥터에 9~10mm가 들어가고, 다리가 길면 남은 부분이 드러나 다른 금속에 닿을 수 있습니다.
6. **레버 커넥터 2개에 연장선과 다이오드 꽂기(그림 9)** — PCT-413 2개를 준비해 하나에 "+", 다른 하나에 "−"를 네임펜으로 씁니다.
   - **"+" 커넥터**: 연장선 **빨강** + 다이오드 **띠 쪽(빨간 점) 다리** — 구멍 하나는 비워 둠(펌프 빨강 자리)
   - **"−" 커넥터**: 연장선 **검정** + 다이오드 **반대쪽 다리** — 구멍 하나는 비워 둠(펌프 검정 자리)
   - 레버를 내리고 하나씩 당겨 봅니다.
7. **다이오드 방향 확인 (펌프를 꽂기 전에!)** — 멀티미터를 다이오드(`▶|`) 모드로 두고, 연장선 **박스 쪽 끝**에서 **검정 리드 → 빨강 선, 빨강 리드 → 검정 선**에 대면 0.5~0.7, 반대로 대면 OL이어야 합니다(다이오드 모드가 없으면 STEP1 절차 3의 저항 모드 판정). 거꾸로 나오면 두 레버를 올려 다이오드를 뒤집어 다시 꽂습니다.
   *왜 지금?* 펌프를 꽂으면 펌프 코일이 다이오드와 나란히 이어져 멀티미터로 방향을 확인할 수 없습니다.
8. **펌프 리드 꽂기** — 펌프 **빨강 → "+" 커넥터**의 빈 구멍, 펌프 **검정 → "−" 커넥터**의 빈 구멍. 판매처 안내대로 **빨강 = +**입니다. 레버를 내리고 당겨 봅니다.
9. **절연·고정** — 두 커넥터와 그 사이의 다이오드를 나란히 붙여 **절연테이프로 한 덩어리로** 감습니다([2.6 바](#skills)). 덩어리는 뚜껑 윗면에서 1~2cm 띄워 연장선에 케이블타이로 한 번 묶습니다.
   *왜?* 다이오드 다리가 드러나 있으면 다른 금속에 닿아 단락될 수 있고, 덩어리가 연장선에 묶여 있어야 선을 당겨도 커넥터에 힘이 가지 않습니다. 뚜껑에서 띄우면 뚜껑 위에 흘린 물이 커넥터로 스며들지 않습니다.
   - ⚠ 레버 커넥터는 **방수가 아닙니다.** 재료를 채울 때는 뚜껑 모듈을 들어 옆에 두고 붓습니다. 커넥터 위로 액체를 붓지 않습니다.
<!--/N-->
⟦7¦10⟧. **전선 구멍 막기** — 펌프를 바닥에 내려놓고 뚜껑 안쪽 리드에 여유(1~2cm)가 남았는지 다시 본 뒤, 뚜껑 위 Ø5 구멍 둘레를 글루건으로 막습니다(전선이 빠지지 않게 + 물방울 차단). Ø7 튜브 구멍은 STEP8에서 튜브를 끼운 뒤 마무리합니다. Ø3 공기 구멍은 그대로 둡니다.
⟦8¦11⟧. **동작 확인** — **어댑터를 뽑은 상태에서** STEP2의 벤치 연결에서 펌프 1을 빼고, 그 자리에 펌프 모듈의 박스 쪽 끝을 **빨강⟦(꼬리)¦⟧ → 줄 A(NO1로 가는 점퍼가 꽂힌 줄), 검정⟦(꼬리)¦⟧ → GND 레일**로 꽂고(벤치용 다이오드 D1은 빼도 됨 — 모듈에 다이오드가 있음), 펌프를 물컵에 넣습니다. USB → 어댑터 순으로 전원을 넣고 `{"cmd":"run","p":1,"ms":2000}`. 물이 나오면 성공. 펌프를 바꿀 때마다 어댑터를 뽑고 바꿔 4개 모두 반복합니다.

#### 확인 포인트

<!--S-->
- [ ] ✔ 다이오드 하네스 4개 모두 방향 확인 — **펌프를 잇기 전에**(다이오드 모드: 검정 리드→빨강 꼬리 0.5~0.7 / 모드가 없으면 STEP1 절차 3 판정)
- [ ] ✔ 펌프 리드 이음 8곳 + 하네스 이음 8곳 당김 테스트 통과, 빨강-빨강·검정-검정
- [ ] ✔ 펌프 리드 이음(솔더 슬리브)이 모두 뚜껑 **위**에 있음(리드가 짧아 안쪽에서 이은 것은 뚜껑 바로 아래, 액면보다 위)
<!--/S-->
<!--N-->
- [ ] ✔ 다이오드 4개 방향 확인 — **펌프를 꽂기 전**에(다이오드 모드: 검정 리드→빨강 선 0.5~0.7 / 모드가 없으면 STEP1 절차 3 판정)
- [ ] ✔ 레버 커넥터 8개, 모든 선 당김 테스트 통과, 빨강-빨강·검정-검정
- [ ] ✔ 커넥터 덩어리가 절연테이프로 감겨 있고, 뚜껑 윗면에서 1~2cm 위에 연장선과 묶여 있음
<!--/N-->
- [ ] ✔ 뚜껑마다 Ø7·Ø5·Ø3 구멍 3개, 몸통과 같은 번호
- [ ] ✔ 펌프 모듈 4개 물 테스트 통과

#### 흔한 실수

<!--S-->
- ⚠ 수축튜브·솔더 슬리브를 **미리 끼우지 않고** 납땜 → 다시 풀어야 합니다. 납땜 전에 항상 "튜브 끼웠나?"를 먼저.
- ⚠ 열풍기를 한곳에 너무 오래 → 피복이 녹습니다. 슬리브를 돌려 가며 고르게.
- ⚠ 납땜 덩어리가 회색·둥근 공 모양이면 "냉납"(접촉 불량). 심선을 충분히 데운 뒤 다시.
<!--/S-->
<!--N-->
- ⚠ 펌프를 먼저 꽂고 다이오드 방향을 재려 함 → 펌프 코일 때문에 어느 쪽으로 대도 비슷한 값이 나와 확인할 수 없습니다. 펌프 리드를 잠시 빼고 다시 잽니다.
- ⚠ 피복을 너무 길게 벗김 → 심선이 커넥터 밖으로 드러나 테이프 안에서 다른 선과 닿을 수 있습니다. 9~10mm.
- ⚠ 커넥터 덩어리를 뚜껑 안쪽(용기 안)으로 넣음 → 방수가 아니라 습기로 녹슬거나 단락됩니다. 항상 뚜껑 위.
<!--/N-->
- ⚠ 다이오드 방향 반대 → 펌프를 켜는 순간 5V가 다이오드로 바로 흘러(단락) ESP32가 재부팅되거나 어댑터가 꺼집니다. **퓨즈(F1)는 멀쩡할 수 있고**, ESP32를 USB로 켠 상태(STEP7 디버깅)에서는 단락이 계속돼 다이오드가 뜨거워집니다. ⟦수축 전에 사진을 찍어 두세요.¦테이프를 감기 전에 사진을 찍어 두세요.⟧
- ⚠ 펌프 모듈을 만든 뒤 뚜껑을 돌려 닫음 → 전선·튜브가 꼬입니다. 뚜껑을 잡고 **몸통을 돌립니다**.

### STEP 4. 전원부 (DC 단자 · 스위치 · 퓨즈 · 분배 커넥터 · 커패시터) {#step4}

<!--S-->
> **목표**: `어댑터 → J1 → SW1 → F1(3A) → TB1(+5V 분배)` 와 `J1(−) → TB2(GND 분배)` 를 만들고, 1000µF 커패시터 C1을 TB1–TB2 사이에 단다 (연결표 ②~⑦).
> **어디서 · 난이도**: 학교 실습실(G 구멍 · SW1·F1 납땜 — [1차 방문](#school1)) + 집(J1·TB·C1·시험) · ★★☆
> **준비물**: J1(P12), SW1(P13), F1 퓨즈홀더(P14) + 3A 퓨즈(P15), PCT-418(P18) 2개(TB1·TB2), C1 1000µF(P16), AWG20(P19), UL1007 22AWG **검정(P62)** — ⑦용, 수축튜브(P26), 인두·실납(학교), 스트리퍼(P49), 멀티미터, **뒤판 G(재단된 판 410×115)** + 드릴·스텝드릴
> **소요 시간**: 2~2.5시간

그림 10. 전원부 결선도

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

#### 절차

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

#### 확인 포인트

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

#### 흔한 실수

- ⚠ SW1·F1을 G에 끼우기 전에 ③까지 납땜 → 둘을 G에 끼울 수 없습니다(바깥에서 끼우는 부품 두 개가 선으로 이어져 있기 때문). ③ 한쪽을 인두로 떼고 G에 끼운 뒤 다시 납땜하세요.
- ⚠ 피복을 너무 짧게 벗겨 레버 커넥터 안에서 피복이 물림 → 접촉 불량. 너무 길면 심선이 밖으로 드러나 단락 위험.
- ⚠ 퓨즈가 끊어졌다고 더 큰 퓨즈나 은박지로 바꾸기 → 단락 시 화재 위험. 원인(다이오드 방향, 선 닿음)을 먼저 찾으세요.
- ⚠ 한 레버 구멍에 선 두 개를 억지로 꽂기 → 한 구멍에 한 선이 원칙입니다(두 가닥을 함께 조이는 곳은 J1 − 나사뿐).
<!--/S-->
<!--N-->
> **목표**: `어댑터 → J1 → SW1(선 달린 로커 스위치) → F1(인라인 퓨즈 3A) → TB1(+5V 분배)` 와 `J1(−) → TB2(GND 분배)` 를 만들고, 1000µF 커패시터 C1을 TB1–TB2 사이에 단다 (연결표 ②~⑦). 납땜 대신 **2구 레버 커넥터 PCT-412 3개**로 잇는다.
> **어디서 · 난이도**: 집 (뒤판 G 구멍 2개만 드릴 — [구멍 뚫는 날 ①](#drill1)) · ★★☆
> **준비물**: J1(P12), 하네스 스위치 SW1(P73), 인라인 퓨즈홀더 F1(P74) + 3A 퓨즈(P15), PCT-418(P18) 2개(TB1·TB2), PCT-412(P76) 3개, C1 1000µF(P16), AWG20 빨강·검정(P19), UL1007 **검정(P62)** — ⑦용, 절연테이프(P79), 접착 마운트(P28) 1 + 케이블타이(P27), 스트리퍼(P49)·니퍼, 멀티미터, **뒤판 G(재단된 판 410×115, Ø12·사각 구멍)**
> **소요 시간**: 1.5~2시간

그림 10. 전원부 결선도 (무납땜 — 레버 커넥터)

#### 납땜 기준과 다른 점

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

#### 절차

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

#### 확인 포인트

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

#### 흔한 실수

- ⚠ 리드 끝의 작은 커넥터를 자르지 않고 레버 커넥터에 넣으려 함 → 들어가지 않습니다. 잘라 내고 피복을 벗깁니다.
- ⚠ PCT-412 한 구멍에 두 가닥 → 한 구멍에 한 선이 원칙입니다(두 가닥을 함께 조이는 곳은 J1 − 나사뿐).
- ⚠ 피복을 너무 짧게 벗겨 커넥터 안에서 피복이 물림 → 접촉 불량. 투명 몸통으로 심선이 끝까지 들어갔는지 봅니다.
- ⚠ 퓨즈가 끊어졌다고 더 큰 퓨즈나 은박지로 바꾸기 → 단락 시 화재 위험. 원인(다이오드 방향, 선 닿음)을 먼저 찾으세요.
- ⚠ 퓨즈홀더를 박스 안에 넣음 → 퓨즈를 바꿀 때마다 박스를 열어야 합니다. G 안쪽(박스 밖)에 둡니다.
<!--/N-->

### STEP 5. ESP32 · 릴레이 영구 배선 (연결표) {#step5}

> **목표**: 전장 박스(P35) 안에 ESP32+확장보드, 릴레이, 분배 커넥터를 고정하고, 아래 **연결표 순서 그대로**(⑦~⑳) 영구 배선한다. STEP2에서 정한 A안/B안을 따른다.
> **어디서 · 난이도**: 집 (박스·속판 구멍만 드릴 — ⟦[학교 1차 방문](#school1)¦[구멍 뚫는 날 ①](#drill1)⟧) · ★★★
> **준비물**: 전장 박스(P35), ESP32(P01)+확장보드(P02), 릴레이(P08), STEP4 전원부, M3 서포트(P39) 4 + M3×6(P40) 8, 점퍼선 F/F(P20)·M/F(P21), AWG20(P19), UL1007 빨강(P63, ⑧)·노랑(P24, ⑩을 UL1007로 할 때), 레버 커넥터 1개 더(TB3, 3V3용), 100µF(P17, 선택), 폼 양면테이프(P71), 접착 마운트(P28), 케이블타이(P27), 스트리퍼(P49), 스텝드릴(박스 구멍 — ⟦학교 1차 방문¦구멍 뚫는 날 ①⟧), 마스킹테이프
> **소요 시간**: 3~4시간

그림 11. 전장 박스 배치 예시

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

#### 절차 가. 박스 준비

1. 박스의 안쪽 크기(가로·세로·높이)와 속판 크기를 재서 적고, 부품들을 속판 위에 올려 그림 11처럼 배치해 봅니다. 겹치면 조정합니다.
2. **벽 구멍** — 스텝드릴로 뚫습니다(⟦학교 1차 방문¦구멍 뚫는 날 ①⟧). 왼쪽 벽 Ø12(펌프 1·2), 오른쪽 벽 Ø12(펌프 3·4), 뒤 벽 Ø16(어댑터 선 ①, SW1·F1 왕복선 ②·④), 앞 벽 Ø10(앞판의 버튼·LED·부저 선 ㉙~㊱). 높이는 박스 바닥에서 약 20mm.
   - 뒤 벽 구멍으로는 STEP10에서 **어댑터 플러그 머리**가 지나가야 합니다. 플러그 머리 지름에 약 5mm(먼저 지나가 있는 ②·④ 두 가닥)를 더한 값이 16mm보다 크면 구멍을 그만큼 넓힙니다.
   - 박스 **바닥에는 구멍을 뚫지 않습니다**(STEP10에서 벨크로로 고정). 볼트 고정(선택, M3×15 P68 + 너트 P38 — 둘 다 따로 더 주문)을 고른 경우만, 이때(속판을 달기 전) 바닥 **뒤쪽 두 모서리**(박스 좌·우 끝에서 약 10mm, 뒤 끝에서 약 10mm — 선반 D의 선택 구멍과 맞는 자리, 박스 벽 두께를 재서 확인)에 Ø3.5를 뚫습니다(STEP10 절차 1).
   *왜?* 선반 구멍(x 60, x 360)이 박스 양옆에 있고, 전원 부품은 뒤판 G, 버튼·LED는 앞판 F에 있기 때문입니다(그림 4 (다)).
3. **릴레이 고정** — 릴레이의 고정 구멍(Ø3, 간격 약 69.6 × 49.4mm)에 맞춰 속판에 Ø3.5 구멍 4개를 뚫고, M3 서포트 10mm(P39)를 아래에서 M3×6(P40)으로 고정 → 릴레이를 올리고 위에서 M3×6으로 고정합니다.
   *왜 띄우나?* 릴레이 뒷면의 납땜 점이 다른 금속에 닿지 않게 하고, 열이 빠지게 합니다.
4. **ESP32 + 확장보드(P02)** — 확장보드에 동봉 스탠드오프를 달아 속판에 고정하고(나사로 고정하려면 ⟦학교 1차 방문¦구멍 뚫는 날 ①⟧에 보드를 대고 표시해 함께 뚫어 둠 — 구멍 없이 스탠드오프 바닥을 폼 양면테이프 P71로 붙여도 됨), ESP32를 확장보드 소켓에 핀 이름이 맞게 꽂습니다(보드의 `3V3`이 확장보드의 `3V3` 표시와 같은 자리). **USB 단자가 박스 앞쪽**을 보게 둡니다.
5. **TB1~TB3, C1, J1** — 폼 양면테이프(P71)로 붙이고, 필요하면 접착 마운트(P28)+케이블타이로 한 번 더 잡습니다. ⟦넣기 전에 ②(J1 +)·④(TB1-8)를 잠시 빼서, G에 달린 쪽 끝이 박스 밖에 남도록 **박스 뒤 벽 Ø16 구멍으로 바깥→안으로** 넣은 뒤 다시 연결합니다.¦②·④는 **G 쪽 G1·G3의 레버만 올려** 빼낸 뒤, 박스 안쪽에서 **뒤 벽 Ø16 구멍으로 밖으로** 빼서 다시 꽂고 레버를 내립니다(J1·TB1 쪽은 그대로).⟧
6. **A안이면 릴레이 JD-VCC 점퍼 캡을 뽑습니다.** **B안이면**(이 STEP은 전원 없이 배선) 아래 연결표의 ⑪은 **연결하지 않고**, ⑨(+5V)를 JD-VCC 핀이 아닌 **입력 헤더 `VCC` 핀**에 꽂은 뒤 점퍼 캡을 끼웁니다(JD-VCC 핀에는 캡만).
   *왜?* 점퍼 헤더는 2핀이라 캡이 두 핀을 모두 덮습니다. 선이 꽂힌 핀에는 캡이 들어가지 않고, ⑨를 빼고 캡만 끼우면 릴레이에 5V가 들어가지 않습니다.

#### 절차 나. 배선 요령

7. 연결표 순서대로 **한 줄씩** 연결하고, 끝날 때마다 표의 □에 체크합니다. 선 양 끝에 번호 테이프(⑦, ⑧ …)를 붙입니다. 선 색은 아래 표의 색(= 회로도 배선도의 색)을 따르면 나중에 찾기 쉽습니다.
   - **UL1007 22AWG는 노랑(P24)·검정(P62)·빨강(P63) 세 색만 삽니다.** GND선(⑦, ⟦앞판 GND 이음점으로 가는 ㉛과 짧은 선 ㉜·㉞·㊱¦앞판 GND 모음으로 가는 ㉛ — ㉜·㉞·㊱는 듀폰·CG0731·LED 다리⟧)은 검정, ESP32 5V선(⑧)은 빨강, 그 밖의 UL1007 선(⑩을 UL1007로 할 때, ㉙·㉚·㉝·㉟)은 모두 노랑입니다.
   - *왜?* ⑦(GND)과 ⑧(5V)을 바꿔 물면 ESP32에 거꾸로 전기가 들어가 고장 나므로 색으로 확실히 나눕니다. 노랑 선은 여러 가닥이 같은 색이라 **양 끝 번호 테이프가 유일한 구분 방법**입니다. 자르자마자 번호를 붙이세요.
8. **릴레이 입력 헤더 ↔ 확장보드**: F/F 점퍼선의 한쪽 끝(암 소켓)은 릴레이 핀에 꽂고, 다른 쪽 끝을 잘라 피복을 8mm 벗겨 꼬은 뒤 확장보드 푸시인 단자에 넣습니다. 소켓이 헐거우면 글루건 한 방울로 고정합니다.
9. **릴레이 나사 단자**: 피복 6~7mm, 일자드라이버로 단자를 풀고 넣은 뒤 조이고 당겨 봅니다.
10. 3V3은 **TB3(레버 커넥터)** 에서 나눕니다: ESP32 3V3 → TB3-2(⑩), TB3-1 → 릴레이 VCC(⑪), TB3-3 → 부저 VCC(㉙). ESP32의 GND 단자는 J3-1(⑦), J2-14(⑯), J3-7(㉛)을 하나씩 씁니다.

#### 연결표 (①~㊱ — 회로도.html ③ 연결표와 같은 번호) {#wiring-table}

| □ | 번호 | 출발 | 도착 | 선 (색 · 대략 길이) | STEP | 비고 |
|:-:|:-:|---|---|---|:-:|---|
| [ ] | ① | 어댑터 DC 플러그 | J1 DC잭(암) | (꽂기) | 10 | 뒤판 G의 Ø12 구멍(그로밋) → 박스 뒤 벽 구멍 통과, 장력 완화 묶음 |
<!--S-->
| [ ] | ② | J1 **+** 나사 | SW1 단자 1 | AWG20 빨강 25cm | 4 | 박스 뒤 벽 구멍 통과. STEP9에서 J1 쪽을 빼고 STEP10에서 다시 연결 |
<!--/S-->
<!--N-->
| [ ] | ② | J1 **+** 나사 | SW1 리드 SW-a (PCT-412) | AWG20 빨강 25cm | 4 | 박스 뒤 벽 구멍 통과. STEP9에서 G 쪽 레버를 올려 빼고 STEP10에서 다시 꽂음 |
<!--/N-->
<!--S-->
| [ ] | ③ | SW1 단자 2 | F1 단자 1 | AWG20 빨강 8cm | 4 | 납땜 + 수축튜브 (뒤판 G 안쪽) |
<!--/S-->
<!--N-->
| [ ] | ③ | SW1 리드 SW-b | F1 리드 F-a | 따로 자르는 선 없음 — 두 리드를 PCT-412로 바로 이음 | 4 | 뒤판 G 안쪽(박스 밖) |
<!--/N-->
<!--S-->
| [ ] | ④ | F1 단자 2 | **TB1-8** | AWG20 빨강 30cm | 4 | 박스 뒤 벽 구멍 통과. STEP9에서 TB1 쪽을 빼고 STEP10에서 다시 연결 |
<!--/S-->
<!--N-->
| [ ] | ④ | F1 리드 F-b (PCT-412) | **TB1-8** | AWG20 빨강 30cm | 4 | 박스 뒤 벽 구멍 통과. STEP9에서 G 쪽 레버를 올려 빼고 STEP10에서 다시 꽂음 |
<!--/N-->
| [ ] | ⑤ | J1 **−** 나사 | **TB2-1** | AWG20 검정 15cm | 4 | J1 − 나사에 ⑤·⑦ 함께 조임 |
| [ ] | ⑥ | C1 긴 다리(+) / 띠 다리(−) | **TB1-1** / **TB2-8** | 부품 다리 | 4 | 극성 반대 금지 |
| [ ] | ⑦ | J1 **−** 나사 | ESP32 **GND** (J3-1) | UL1007 검정(P62) 20cm | 4·5 | ESP32 쪽 GND (별형 접지) |
| [ ] | ⑧ | **TB1-7** | ESP32 **5V** (J2-19) | UL1007 빨강(P63) 20cm | 5 | 노란 테이프 "USB 꽂을 때 분리" |
| [ ] | ⑨ | **TB1-6** | A안: 릴레이 **JD-VCC** 핀 (빨간 점) / **B안: 입력 헤더 VCC 핀**(⑪ 자리) | 듀폰 F 빨강 | 5 | A안: 점퍼 캡 빼서 보관 / B안: ⑨를 VCC 핀에 꽂고 캡 끼움 — JD-VCC 핀에는 캡만 |
| [ ] | ⑩ | ESP32 **3V3** (J2-1) | **TB3-2** | 듀폰 주황(양 끝을 잘라 씀) 또는 UL1007 노랑(P24) + 번호 테이프 ⑩, 약 15cm | 5 | 3V3선. 노랑으로 하면 번호 테이프로만 구분 |
| [ ] | ⑪ | 릴레이 입력 헤더 **VCC** 핀 | **TB3-1** | 듀폰 F 주황 | 5 | **B안이면 연결하지 않음**(그 VCC 핀에 ⑨가 들어감, B안에서 3V3 연결 금지) |
| [ ] | ⑫ | ESP32 **GPIO26** (J2-10) | 릴레이 **IN1** | 듀폰 파랑 | 5 | 펌프 1 |
| [ ] | ⑬ | ESP32 **GPIO27** (J2-11) | 릴레이 **IN2** | 듀폰 초록 | 5 | 펌프 2 |
| [ ] | ⑭ | ESP32 **GPIO32** (J2-7) | 릴레이 **IN3** | 듀폰 노랑 | 5 | 펌프 3 |
| [ ] | ⑮ | ESP32 **GPIO33** (J2-8) | 릴레이 **IN4** | 듀폰 보라 | 5 | 펌프 4 |
| [ ] | ⑯ | 릴레이 **GND** 핀 | ESP32 **GND** (J2-14) | 듀폰 F 검정 | 5 | 릴레이 코일 전류(최대 약 0.3A)도 이 선으로 |
| [ ] | ⑰ | **TB1-5** | 릴레이 **K1 COM** | AWG20 빨강 15cm | 5 | |
| [ ] | ⑱ | **TB1-4** | 릴레이 **K2 COM** | AWG20 빨강 15cm | 5 | |
| [ ] | ⑲ | **TB1-3** | 릴레이 **K3 COM** | AWG20 빨강 15cm | 5 | |
| [ ] | ⑳ | **TB1-2** | 릴레이 **K4 COM** | AWG20 빨강 15cm | 5 | |
| [ ] | ㉑ | 릴레이 **K1 NO** | 펌프 1 빨강(+) | 펌프 모듈 연장선 빨강 | 10 | 왼쪽 벽 구멍 |
| [ ] | ㉒ | 펌프 1 검정(−) | **TB2-2** | 펌프 모듈 연장선 검정 | 10 | |
| [ ] | ㉓ | 릴레이 **K2 NO** | 펌프 2 빨강(+) | 펌프 모듈 연장선 빨강 | 10 | 왼쪽 벽 구멍 |
| [ ] | ㉔ | 펌프 2 검정(−) | **TB2-3** | 펌프 모듈 연장선 검정 | 10 | |
| [ ] | ㉕ | 릴레이 **K3 NO** | 펌프 3 빨강(+) | 펌프 모듈 연장선 빨강 | 10 | 오른쪽 벽 구멍 |
| [ ] | ㉖ | 펌프 3 검정(−) | **TB2-4** | 펌프 모듈 연장선 검정 | 10 | |
| [ ] | ㉗ | 릴레이 **K4 NO** | 펌프 4 빨강(+) | 펌프 모듈 연장선 빨강 | 10 | 오른쪽 벽 구멍 |
| [ ] | ㉘ | 펌프 4 검정(−) | **TB2-5** | 펌프 모듈 연장선 검정 | 10 | |
<!--S-->
| [ ] | D1~D4 | 1N4007 띠(캐소드) → 펌프 빨강(+) | 반대쪽(애노드) → 펌프 검정(−) | 부품 다리 | 3 | 위치: 박스 쪽 끝에서 약 20cm 앞 Y자 이음(이 가이드) 또는 뚜껑 위 이음부(배선도 그림) — 전기적으로 동일 |
<!--/S-->
<!--N-->
| [ ] | D1~D4 | 1N4007 띠(캐소드) → "+" PCT-413(펌프 빨강) | 반대쪽(애노드) → "−" PCT-413(펌프 검정) | 부품 다리 | 3 | 위치: 뚜껑 위 레버 커넥터 덩어리(배선도 그림과 같은 자리) |
<!--/N-->
<!--S-->
| [ ] | ㉙ | **TB3-3** | 부저 BZ1 VCC | UL1007 노랑(P24) 40cm + 듀폰 F 끝, 번호 테이프 ㉙ (듀폰 주황을 이어 써도 됨) | 10 | 부저를 달 때만. 3V3선 |
<!--/S-->
<!--N-->
| [ ] | ㉙ | **TB3-3** | 부저 BZ1 VCC | UL1007 노랑(P24) 40cm, 번호 테이프 ㉙ → 앞판 PCT-412 → 듀폰 F/F(부저 핀) | 9·10 | 부저를 달 때만. 3V3선 — PCT-412에 피복 9~10mm만 |
<!--/N-->
<!--S-->
| [ ] | ㉚ | ESP32 **GPIO23** (J3-2) | 부저 BZ1 I/O | UL1007 노랑(P24) 40cm + 듀폰 F 끝, 번호 테이프 ㉚ | 10 | |
<!--/S-->
<!--N-->
| [ ] | ㉚ | ESP32 **GPIO23** (J3-2) | 부저 BZ1 I/O | UL1007 노랑(P24) 40cm, 번호 테이프 ㉚ → 앞판 PCT-412 → 듀폰 F/F | 9·10 | |
<!--/N-->
<!--S-->
| [ ] | ㉛ | ESP32 **GND** (J3-7) | 앞판 GND 이음점 | UL1007 검정(P62) 40cm | 9·10 | 짧은 검정 3가닥(㉜·㉞·㊱)과 한 점에서 납땜 |
<!--/S-->
<!--N-->
| [ ] | ㉛ | ESP32 **GND** (J3-7) | 앞판 GND 모음(PCT-415) | UL1007 검정(P62) 40cm | 9·10 | |
<!--/N-->
<!--S-->
| [ ] | ㉜ | 부저 BZ1 GND | 앞판 GND 이음점 | 듀폰 F + UL1007 검정(P62) 약 20cm | 9 | 이음점에 납땜 |
<!--/S-->
<!--N-->
| [ ] | ㉜ | 부저 BZ1 GND | 앞판 GND 모음(PCT-415) | 듀폰 F/F(끝을 벗겨 꼼) | 9 | |
<!--/N-->
<!--S-->
| [ ] | ㉝ | ESP32 **GPIO4** (J3-13) | 버튼 SW2 단자 1 | UL1007 노랑(P24) 40cm, 번호 테이프 ㉝ | 10 | 버튼은 방향 없음 |
<!--/S-->
<!--N-->
| [ ] | ㉝ | ESP32 **GPIO4** (J3-13) | 버튼 SW2 단자 1 | UL1007 노랑(P24) 40cm ㉝ → 앞판 PCT-412 → CG0731(단자 1에 꽂음, 양 끝 ㉝ 테이프) | 9·10 | 버튼은 방향 없음 |
<!--/N-->
<!--S-->
| [ ] | ㉞ | 버튼 SW2 단자 2 | 앞판 GND 이음점 | UL1007 검정(P62) 약 8cm | 9 | 납땜 |
<!--/S-->
<!--N-->
| [ ] | ㉞ | 버튼 SW2 단자 2 | 앞판 GND 모음(PCT-415) | CG0731(단자 2에 꽂음) | 9 | |
<!--/N-->
<!--S-->
| [ ] | ㉟ | ESP32 **GPIO2** (J3-15) | R1 220Ω → LED1 긴 다리(+) | UL1007 노랑(P24) 40cm, 번호 테이프 ㉟ | 10 | R1은 LED 다리에 납땜 |
<!--/S-->
<!--N-->
| [ ] | ㉟ | ESP32 **GPIO2** (J3-15) | R1 220Ω → LED1 긴 다리(+) | UL1007 노랑(P24) 40cm ㉟ → PCT-412 → R1 → PCT-412 → LED 긴 다리 | 9·10 | |
<!--/N-->
<!--S-->
| [ ] | ㊱ | LED1 짧은 다리(−) | 앞판 GND 이음점 | UL1007 검정(P62) 약 8cm | 9 | 납땜 |
<!--/S-->
<!--N-->
| [ ] | ㊱ | LED1 짧은 다리(−) | 앞판 GND 모음(PCT-415) | 부품 다리 | 9 | |
<!--/N-->
| [ ] | (선택) | C2 100µF + / − | 확장보드 5V / GND | 부품 다리 | 5 | 회로도 외 추가 보조(재부팅이 잦을 때만) |

**분배 커넥터 구멍 배정** (그림 10, 회로도와 같음)

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

> 참고: 분배 커넥터 배정은 SPEC v2.1 §1·회로도(v3)와 같이 **TB1 = +5V, TB2 = GND, TB3 = 3V3**입니다(예전 자료에 "GND 2개"로 적힌 메모가 있어도 이 배정이 맞습니다). ESP32 GND는 J1 − 나사에서 바로(⑦), 다이오드는 ⟦펌프 선에 납땜하므로¦뚜껑 위 PCT-413에 있으므로⟧ GND 레버 커넥터는 TB2 하나로 충분합니다. 구매 수량(4개: 3개 사용 + 예비 1)은 그대로입니다.

#### 절차 다. 배선 후 점검 (전원 없이)

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

#### 확인 포인트

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

#### 흔한 실수

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

### STEP 6. 전원 넣기 전 점검 · 첫 전원 투입 {#step6}

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

#### 전원 넣기 전 점검표 (어댑터 뽑은 상태)

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

#### 첫 전원 투입 절차

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

#### 확인 포인트

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

#### 흔한 실수

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

### STEP 7. 펌웨어 업로드 · 앱 블루투스 연결 {#step7}

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

#### 절차 가. 조립 상태에서 펌웨어 올리기 (나중에 펌웨어를 고칠 때마다 이 순서)

1. **SW1 OFF** → 어댑터를 콘센트에서 뽑습니다.
2. 박스 뚜껑을 열고 **TB1-7의 ⑧(노란 테이프) 레버를 올려 선을 뺍니다.**
   *왜?* USB 5V와 어댑터 5V가 ESP32의 5V 줄에서 만나지 않게 하기 위해서입니다(SPEC §1 "USB 업로드 시 5V 선 분리").
   - **뺀 ⑧ 끝을 바로 절연합니다.** 이 끝(ESP32 5V 핀에 연결된 맨 심선)은 USB를 꽂으면 전기가 흐릅니다. ⟦수축튜브 캡(P26 조각을 씌우고 끝을 접음)이나 절연·마스킹테이프로¦절연테이프(P79)로⟧ 끝을 감싸고, 릴레이 나사 단자·J1 나사에서 먼 박스 벽에 테이프로 붙여 둡니다. 다시 꽂을 때 테이프를 벗깁니다.
     *왜?* 이 끝이 J1 − 나사(GND)에 닿으면 USB 단락(PC 포트 보호 동작), 릴레이 COM 나사(+5V)에 닿으면 금지한 이중 전원 상태가 됩니다. 박스 안이 좁아 닿기 쉽습니다.
3. USB 케이블을 ESP32에 꽂고 STEP2 절차 가와 같이 업로드 → 시리얼 모니터에서 `{"cmd":"hello"}`로 확인합니다. (STEP2에서 이미 올렸고 펌웨어가 바뀌지 않았다면 건너뜁니다.)
4. USB를 뽑고 → **⑧ 끝의 테이프(캡)를 벗기고 TB1-7에 다시 꽂은 뒤 레버를 내립니다** → 어댑터 → SW1 ON.
   - 캘리브레이션 값은 플래시의 별도 영역에 저장되어 펌웨어를 다시 올려도 유지됩니다.
   - **디버깅 팁**: ⑧을 빼고 **끝을 절연해 둔 상태에서만** USB를 꽂은 채 SW1을 켜도 안전합니다(ESP32는 USB, 릴레이·펌프는 어댑터 — STEP2와 같은 구성). 이때 시리얼 모니터로 동작 로그를 보며 시험할 수 있습니다. 이 상태에서는 다이오드가 반대로 달린 펌프가 있으면 단락이 계속되므로(ESP32가 USB로 켜져 있어 리셋되지 않고 릴레이가 계속 붙어 있음) STEP3에서 방향을 확인한 펌프만 연결합니다. 끝나면 USB를 뽑고 테이프를 벗긴 뒤 ⑧을 다시 꽂으세요.

#### 절차 나. 테스트 앱으로 블루투스 확인 (앱 없이)

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

#### 절차 다. 바텐더 앱 연결

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

#### 확인 포인트

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

#### 흔한 실수

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

### STEP 8. 배관 (튜브 · 체크밸브 · 누수 테스트) {#step8}

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

그림 12. 액체 경로도

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

#### 튜브 재단표 (펌프 1개당, 4세트)

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

*튜브는 가위나 니퍼 대신 **커터칼로 직각으로** 자릅니다. 비스듬히 잘리면 노즐에서 물줄기가 옆으로 휩니다.*

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

#### 절차

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

#### 확인 포인트

- [ ] ✔ 4세트 모두 체크밸브 화살표가 노즐 쪽
- [ ] ✔ 10초 구동 시 세트마다 이음부 4곳(펌프 출수구 · 겹침 이음 · 체크밸브 입구 바브 · 출구 바브) 모두 마름
- [ ] ✔ 멈춘 뒤 밸브 아래 튜브에 물이 남아 있음(역류·드립 방지 확인)
- [ ] ✔ 튜브 번호 색 표시
<!--N-->
- [ ] ✔ 누수 테스트 뒤 뚜껑 위 레버 커넥터 덩어리가 젖지 않았음
<!--/N-->
- [ ] ✔ 체크밸브 포함 10초 유량: 1 ____ / 2 ____ / 3 ____ / 4 ____ ml

#### 흔한 실수

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

### STEP 9. 외형 제작 (재단 · 구멍 · 앞판 · 조립 · 방수) {#step9}

> **목표**: 포맥스 5T로 본체를 만든다(W420 × D260 × H380). 구멍을 모두 뚫은 뒤 조립하고, 액체가 닿는 이음새를 방수 처리한다.
> **어디서 · 난이도**: ⟦학교 실습실(판 구멍 · 앞판 납땜 — [2차 방문](#school2)) + 집(재단 · 조립 · 방수)¦집 (판 구멍만 드릴 — [구멍 뚫는 날 ②](#drill2))⟧ · ★★★
> **준비물**: 포맥스(P34) 3장 또는 재단된 판 A~L·N, **출력 브래킷 01** 12(+예비 2), **출력 그로밋 04** 2, **출력 베젤 03** 1 + 라벨 스티커 2장, **출력 상판 모서리 캡 06** 4, **출력 노즐 블록 02** 1(확인만, 붙이는 것은 STEP10), M3×10 볼트(P37)·너트(P38) 24쌍(+예비), 순간접착제(P42), 글루건+스틱(P43), 폼 양면테이프(P71), 네오디뮴 자석(P45) 2 · 접착식 철판(P80) 2(상판 C도 자석으로 붙이면 P69로 자석·철판 1팩씩 더, 선택), 고무발(P41) 4, 버튼(P03), LED(P05)+R1(P06), 부저(P04, 선택), 앞판 선: UL1007 노랑(P24) 40cm × 4 + 검정(P62) 40cm 1가닥⟦과 짧은 검정 3가닥(8cm × 2 · 20cm × 1), 듀폰 F/F(P20) 3가닥, 수축튜브(P26), 인두·실납(학교)¦, PCT-412(P76) 5, PCT-415(P77) 1, CG0731(P78) 2, 듀폰 F/F(P20) 3가닥, 절연테이프(P79)⟧, 드릴·스텝드릴, 커터칼(대)·쇠자 60cm·커팅매트·직각자, 연필, 사포
> **소요 시간**: 6~8시간 (재단 주문 시 3~4시간) + 접착제 굳는 시간

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

#### 절차 가. 판 준비

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

#### 절차 나. 구멍 가공 (조립 전에 모두 뚫기)

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

| □ | 판 | 구멍 | 위치 (판 기준) | 용도 |
|:-:|---|---|---|---|
| [ ] | D 선반 410×250 | Ø20 × 2 | 왼쪽 끝에서 55 / 오른쪽 끝에서 55, **뒤쪽 끝에서 35** | 펌프 선 통로 + 그로밋(출력 04) |
| [ ] | D 선반 (선택) | Ø3.5 × 2 | 왼쪽 끝에서 110 / 290, 뒤쪽 끝에서 75 | 전장 박스를 **볼트로** 고정할 때만(M3×15 P68, STEP10 절차 1). 벨크로(P64)로 고정하면 뚫지 않음 |
| [ ] | E 칸막이 410×255 | Ø25 × 1 | 가로 가운데(205), **위쪽 끝에서 17** | 튜브 4가닥 통로 + 튜브 부싱(출력 07) |
| [ ] | F 앞판 상부 410×115 | Ø16 / Ø5 | **앞(바깥)면을 보며** 오른쪽 끝에서 70 / 110, 높이 가운데(57.5) | 버튼 SW2 / LED1 — 바깥면에 "앞(바깥)"이라고 써 둠 |
<!--S-->
| [ ] | G 뒤판 상부 410×115 | Ø12 / 사각 / Ø(실측) | **뒤에서 볼 때** 왼쪽 끝에서 40 / 90 / 140, 높이 가운데 | 어댑터 선(그로밋 05) / SW1 / F1 — **STEP4 절차 2에서 미리 뚫음** |
<!--/S-->
<!--N-->
| [ ] | G 뒤판 상부 410×115 | Ø12 / 사각 | **뒤에서 볼 때** 왼쪽 끝에서 40 / 90, 높이 가운데 | 어댑터 선(그로밋 05) / SW1 — **STEP4 절차 2에서 미리 뚫음**. 퓨즈 구멍은 없음(인라인 퓨즈홀더) |
<!--/N-->
| [ ] | H 뒤 덮개 408×253 | Ø25 (선택) | 가로 가운데, 위쪽 끝에서 25 | 손가락 걸이 |
| [ ] | A 바닥판 · B 측판 · D · C | Ø3.5 | 출력 브래킷 01은 구멍이 바깥 모서리에서 16mm라 위치가 정해짐: **A** 좌·우 끝에서 21, 앞쪽 끝에서 45·90 / **B 아래** 아래 끝에서 16, y 45·90 / **D** 좌·우 끝에서 16, 앞쪽 끝에서 145·215 / **B 가운데** 아래 끝에서 276(선반 D 윗면 z 260 + 16), y 150·220 / **C** 좌·우 끝에서 21, 앞쪽 끝에서 60·200 / **B 위** 위 끝에서 16, y 60·200. 연필로 표시한 자리에 브래킷을 대 보고 확인한 뒤 **판을 붙이기 전에 판만 따로** 뚫음(재단 오차 ±1~2mm). **B는 절차 다 ①에서 A에 붙으므로 B 좌·우의 구멍(한쪽 6개: 아래·가운데·위)을 ① 전에 모두** 뚫고, A는 ① 전, D는 ④ 전, **C도 이때(조립 전) 표 위치대로** 뚫어 둠 — 조립 뒤 브래킷과 1~2mm 어긋나면 줄로 넓힘 | M3 볼트 |

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

#### 절차 다. 조립 (그림 14 순서)

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

<!--S-->
   그림 14-1. 앞판 F 안쪽 배선 (납땜 기준)

   **앞판 결선 (학교 실습실 — [2차 방문](#school2))** — 납땜할 때마다 **수축튜브를 먼저** 끼웁니다.
   1. F에 버튼(P03)을 끼워 뒤에서 너트로 조입니다. **납땜하기 전에** 멀티미터 도통 모드로 **누를 때만 "삐"** 나는 두 단자를 찾아 "1"·"2"를 적습니다(단자가 3개 이상이면 나머지는 버튼 조명용일 수 있음).
   2. LED를 Ø5 구멍에 앞에서 밀어 넣어 뒤에서 글루건으로 고정합니다. LED의 긴 다리(+)에 R1 220Ω을 납땜하고 수축튜브로 덮습니다. 부저(P04, 선택)는 F 안쪽에 폼 양면테이프(P71) + 글루건으로 붙입니다.
   3. **앞판 GND 이음점**: 먼저 ㉛(40cm)에 굵은 수축튜브 1개, 짧은 검정 3가닥의 부품 쪽 끝에 가는 튜브를 하나씩 끼워 둡니다. 짧은 검정 UL1007(P62) **㉞·㊱ 각 약 8cm**는 버튼 단자 2·LED 짧은 다리에 납땜하고, **㉜ 약 20cm**(부저 위치에 맞춰)는 끝에 듀폰 F를 납땜해 부저 GND 핀에 꽂습니다. 세 가닥의 다른 끝과 박스로 가는 검정 ㉛의 끝을 **한데 꼬아 한 점에서 납땜**하고, ㉛에 끼워 둔 굵은 수축튜브로 덮습니다(그림 14-1). *왜 한 점?* 선 중간 피복을 벗길 필요가 없고 수축튜브 하나로 끝납니다.
   4. 신호선 **노랑 UL1007(P24)** 40cm 4가닥: 버튼 단자 1(㉝), R1의 다른 끝(㉟), 부저 I/O(㉚), 부저 VCC(㉙)를 납땜·연결해 둡니다(부저 핀 쪽은 듀폰 F 끝을 납땜해 핀에 꽂음). 4가닥이 모두 노랑이므로 **자르자마자 양 끝에 번호 테이프(㉙·㉚·㉝·㉟)** 를 붙이고, 납땜할 때 번호를 보며 잇습니다.
   5. **점검(전원 없이)** — 멀티미터 도통 모드로 노랑 ㉝ 끝 ↔ 검정 ㉛ 끝: 버튼을 누를 때만 "삐". 노랑 ㉙ ↔ ㉛, 노랑 ㉟ ↔ ㉛: "삐"가 계속 나면 단락.
<!--/S-->
<!--N-->
   그림 14-1. 앞판 F 안쪽 배선 (무납땜 기준)

   **앞판 결선 (납땜 없이)**
   1. **버튼** — F의 Ø16 구멍에 앞에서 버튼(P03)을 끼우고 뒤에서 너트를 조입니다. 멀티미터 도통 모드로 **누를 때만 "삐"** 나는 두 단자를 찾아 "1"·"2"를 적습니다(단자가 3개 이상이면 나머지는 쓰지 않음). CG0731 단자 케이블 2개를 약 10cm로 잘라(단자 쪽을 남김) 자른 끝을 9~10mm 벗긴 뒤, 단자를 버튼 단자 1·2에 끝까지 꽂고, 단자 둘레를 절연테이프로 감습니다. **단자 1 쪽 케이블은 양 끝에 ㉝ 테이프**를 붙입니다(검정 선이지만 GND가 아니라 신호선).
   2. **LED** — 꽂기 전에 **긴 다리(+) 쪽 몸통에 빨간 점**을 찍습니다(꽂고 나면 다리 길이로 구분하기 어려움). LED를 Ø5 구멍에 앞에서 밀어 넣고 뒤에서 글루건으로 고정합니다. 다리는 짧게 자르지 않습니다 — LED 뒤로 약 2cm만 나오므로(추정), 다리를 구부려 바로 옆의 ⓐ와 바로 아래의 GND 모음(PCT-415)에 닿게 합니다(그림 14-1).
   3. **R1 220Ω** — R1 두 다리를 각각 약 12mm로 자릅니다. LED 바로 옆(긴 다리가 닿는 1cm 안)에 놓은 PCT-412 ⓐ에 **LED 긴 다리 + R1 한쪽 다리**, PCT-412 ⓑ에 **R1 다른 다리 + 노랑 ㉟**를 꽂습니다. LED 다리를 옆으로 눕혀 커넥터가 F 안쪽 면에 납작하게 붙게 하고, R1과 두 커넥터 둘레를 절연테이프로 감습니다.
      *왜 납작하게?* F와 전장 박스 사이가 약 35mm뿐이라, 튀어나오면 박스에 눌려 레버가 열리거나 선이 빠집니다.
   4. **부저(선택)** — 부저 모듈을 F 안쪽, LED·버튼에서 몇 cm 떨어진 빈 곳(그림 14-1, 듀폰선이 닿는 거리)에 폼 양면테이프(P71)로 붙입니다. 듀폰 F/F 3가닥을 부저의 `VCC`·`I/O`·`GND` 핀에 꽂고(모듈 인쇄 이름 확인), 반대쪽 끝 소켓을 잘라 피복을 9~10mm 벗겨 꼽니다(헐거우면 [2.6 나](#skills)의 접기). **VCC 점퍼 + 노랑 ㉙** → PCT-412 ⓒ, **I/O 점퍼 + 노랑 ㉚** → PCT-412 ⓓ.
      - ⚠ ㉙는 3V3 전원선입니다. 피복을 9~10mm보다 길게 벗기지 말고, ⓒ 커넥터는 다른 금속(LED·R1 다리, 버튼 단자, GND 모음)에서 떨어뜨려 붙입니다. 닿으면 3V3이 단락됩니다.
   5. **버튼 신호** — **CG0731(단자 1, ㉝ 테이프) + 노랑 ㉝** → PCT-412 ⓔ.
   6. **GND 모음(PCT-415)** — 다섯 구멍 중 넷에 **검정 ㉛(박스로 가는 40cm)**, **CG0731(버튼 단자 2) ㉞**, **LED 짧은 다리 ㊱**, **부저 GND 점퍼 ㉜**를 꽂습니다(1구멍은 비워 둠). PCT-415는 **LED 바로 아래**(짧은 다리가 닿는 1cm 안)에 폼 양면테이프로 붙입니다. 다른 선(㉛·㉞·㉜)은 길이가 넉넉하니 LED 다리에 맞춰 자리를 정합니다.
   7. **점검(전원 없이)** — 멀티미터 도통 모드로 노랑 ㉝ 끝 ↔ 검정 ㉛ 끝을 대고 버튼을 누르면 "삐", 떼면 조용해야 합니다. 노랑 ㉙ ↔ 검정 ㉛, 노랑 ㉟ ↔ 검정 ㉛은 **"삐" 소리가 계속 나면 안 됩니다**(단락).
   8. 노랑 4가닥(㉙·㉚·㉝·㉟)과 검정 ㉛의 **박스 쪽 끝**은 STEP10에서 박스에 넣습니다. 노랑은 모두 같은 색이므로 양 끝 번호 테이프를 다시 확인합니다.
<!--/N-->

   그다음 F를 y 0~5, z 255~370에 붙입니다.
   - **앞면 베젤(출력 03)**: F를 붙인 뒤 베젤을 버튼·LED 위로 씌워 **폼 양면테이프(P71)** 로 F 바깥면에 붙입니다(순간접착제는 쓰지 않음 — LED 테가 베젤 뒤 홈에 물려 있어, ⟦LED를 바꾸거나 다시 납땜할 때¦LED를 바꿀 때⟧([4장](#s4) '상태 LED가 안 켜짐')는 베젤을 떼야 함). 베젤의 Ø18.8 구멍으로 버튼 머리가 지나가므로 버튼은 F 판에만 고정되고(베젤 두께와 상관없이 너트가 물림), LED 테는 베젤 뒤쪽 홈에 들어갑니다. 라벨 홈에 "정지/시작"·"상태" 스티커를 붙입니다.
<!--S-->
   - **G 붙이기**: G에는 STEP4에서 SW1·F1이 끼워져 납땜되어 있습니다. 먼저 **어댑터를 콘센트에서 뽑고**, ②를 J1 + 나사에서, ④를 TB1-8에서 빼 박스 뒤 벽 구멍 밖으로 빼냅니다(끝에 ②·④ 번호 테이프, 드러난 심선은 테이프로 감쌈). 그다음 G를 바깥면("뒤(바깥)")이 밖을 보게 y 255~260에 붙입니다. ②·④는 STEP10에서 다시 연결하고, G의 Ø12 그로밋도 STEP10에서 끼웁니다.
<!--/S-->
<!--N-->
   - **G 붙이기**: G에는 STEP4에서 SW1·퓨즈홀더 F1·PCT-412 3개가 달려 있습니다. 먼저 **어댑터를 콘센트에서 뽑고**, G 쪽 **G1·G3**에서 ②·④가 꽂힌 쪽 **레버만 올려** ②·④를 빼냅니다(끝에 ②·④ 번호 테이프가 있는지 확인, 드러난 심선은 테이프로 감쌈). ②·④는 박스 쪽(J1 +, TB1-8)에 그대로 남습니다. 어댑터 플러그도 J1에서 뽑아 두고, **STEP10 절차 2를 마칠 때까지 어댑터를 꽂지 않습니다**(J1 +에 남은 ② 끝은 퓨즈 앞이라, 어댑터가 꽂히면 5V가 살아 있음). 그다음 G를 바깥면("뒤(바깥)")이 밖을 보게 y 255~260에 붙입니다. ②·④는 STEP10에서 다시 꽂고, G의 Ø12 그로밋 05도 STEP10에서 끼웁니다.
<!--/N-->
9. **⑥ 상판 C(탈착)** — **C는 접착하지 않습니다**(전장부 정비용).
   1. **너트 미리 붙이기(캡티브 너트)** — 출력 브래킷 01 4개를 B에 달기 **전에**, 각 브래킷의 가로 다리(C가 얹힐 쪽) 육각 홈에 M3 너트를 넣고(조립하면 홈이 아래를 봄) 홈 테두리에 순간접착제를 조금 바릅니다. 식용유나 바셀린을 살짝 묻힌 M3×10 볼트를 홈 반대쪽 평평한 면에서 너트에 끝까지 돌려 넣은 채 굳히고(약 10분), 굳으면 볼트만 빼 둡니다(기름 때문에 접착제가 볼트에 붙지 않고, 나사산이 막히지 않음).
      *왜?* C를 얹으면 전장부(선반 위 칸)가 B·F·G·D·C로 사방이 막혀 손이 들어가지 않으므로, 브래킷 아래 너트를 손으로 잡을 수 없습니다. 너트를 붙여 두면 처음 조일 때도, 정비 때(STEP7 ⑧ 분리·USB 업로드) C를 풀 때도 위에서 볼트만 돌리면 되고, 빠진 금속 너트가 릴레이 나사 단자·레버 커넥터 위로 떨어져 단락될 일도 없습니다.
   2. 브래킷을 측판 B 안쪽 맨 위에 좌우 2개씩, **y 60·200**(상판 모서리 캡과 겹치지 않게)에 볼트·너트로 답니다(가로 다리 윗면 = B 윗면 높이, 붙인 너트는 아래쪽). 이 볼트는 B 바깥에서 넣어 세로 다리 홈의 너트에 조입니다.
   3. C의 구멍 4개(구멍 표 C 위치 — 좌·우 끝에서 21, 앞쪽 끝에서 60·200)는 ⟦학교 2차 방문¦구멍 뚫는 날 ②⟧에 미리 뚫어 두었습니다. C를 얹어 브래킷 홈의 너트와 맞는지 보고, 1~2mm 어긋나면 C를 내려서 줄로 구멍을 넓힙니다(본체 위에서 드릴 금지).
   4. C를 얹고 위에서 M3×10 볼트 4개만 돌려 고정합니다.
   5. **상판 모서리 캡(출력 06)** — C를 얹은 상태에서 캡 4개를 C 네 모서리에 맞춰 보고, 순간접착제로 **C에만** 붙입니다(측판 B·앞판 F·뒤판 G에는 붙이지 않음 — 붙이면 상판을 열 수 없음). 접착제가 B·F·G에 묻지 않게 네 모서리 둘레의 B·F·G 윗부분을 마스킹테이프로 가린 뒤 붙입니다. 굳으면 볼트 4개를 풀고 C를 들어 걸림 없이 열리는지 확인합니다.
   - 대안(선택): 뒤 덮개 H처럼 자석(P45)과 철판(P80)으로 C를 붙여도 됩니다. 이때는 **P69(선택)** 로 자석·철판을 1팩씩 더 삽니다(BOM 3장 '선택' 분류, 다이소).
10. **뒤 덮개 H** — 뒤쪽 개구부(410×255)에 끼워 보고(1mm 여유), 걸림턱 L 뒷면 양쪽(왼쪽·오른쪽 끝에서 약 80mm)에 네오디뮴 자석(P45) 2개를 순간접착제로 붙이고, H 안쪽의 마주 보는 자리에 접착식 철판(P80) 2개를 붙입니다(철판은 붙인 뒤 24시간 지나서 씀).
11. **고무발** — 바닥판 A 아래 네 모서리(각 모서리에서 20mm 안쪽)에 고무발(P41) 4개를 붙입니다.

#### 절차 라. 방수 처리

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

#### 확인 포인트

- [ ] ✔ 외형 치수 W420 × D260 × H380(±2mm, 판 기준 — 상판 모서리 캡 06은 모서리에서 옆·위로 3mm, 앞면 베젤 03은 앞으로 3mm 더 나옴), 모서리 직각
- [ ] ✔ 구멍 표의 모든 구멍 가공 완료, 버튼·LED 장착
- [ ] ✔ 선반 D의 Ø20 구멍 2개에 출력 그로밋 04
- [ ] ✔ 출력 노즐 블록 02 확인, 선반에는 아직 안 붙임
- [ ] ✔ 상판용 브래킷 너트 4개가 고정되어 있고, 상판 C가 위에서 볼트 4개만으로 열고 닫힘
- [ ] ✔ 상판 모서리 캡 4개가 C에만 붙어 있고, C를 들 때 B·F·G에 걸리지 않음
- [ ] ✔ 앞면 베젤이 붙고 버튼·LED가 제자리에 있음
- [ ] ✔ 앞판 결선: 버튼을 누를 때만 ㉝–㉛ "삐", ⟦납땜부 모두 수축튜브¦레버 커넥터가 F 면에 납작하게 붙고 절연테이프로 감김⟧, 노랑 4가닥 양 끝 번호 테이프
- [ ] ✔ G에 ⟦SW1·F1이 끼워진 채¦SW1과 퓨즈홀더·PCT-412 3개가 달린 채⟧ 붙음, ②·④ 끝에 번호 라벨
- [ ] ✔ 뒤 덮개 H가 자석으로 고정되고 쉽게 열림
- [ ] ✔ 바닥 이음새 방수 처리

#### 흔한 실수

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

### STEP 10. 최종 조립 · 배선 정리 {#step10}

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

#### 절차

1. **전장 박스 올리기** — 상판 C를 떼고, 박스를 선반 D 위 x 105~305, y 40~190 위치(그림 4 (다))에 놓습니다. 박스 바닥 네 모서리와 D의 같은 자리에 **접착식 벨크로(찍찍이) P64** 를 한 쌍씩(10쌍 중 4쌍) 붙여 고정합니다. 붙일 면의 먼지·기름을 닦고 꾹 누르고, 55×35mm가 박스 모서리보다 크면 잘라 씁니다(폼 양면테이프로 한 번 더 잡아도 됨). 박스 바닥과 D에는 구멍을 뚫지 않습니다.
   *왜 볼트가 아닌가?* 박스 앞쪽 모서리 아래(x 5~130 / 290~415, y 5~105)는 I·J·E·B·A·D로 사방이 막힌 빈 공간(그림 4 (나))이라 너트를 끼울 손이 들어가지 않고, 조립이 끝난 본체에 구멍을 뚫으면 STEP9의 "조립 후 구멍 뚫기 금지"와도 어긋납니다. 벨크로는 정비 때 박스를 들어 올릴 수도 있습니다.
   - (선택) 볼트로 단단히 잡고 싶으면 **뒤쪽 두 모서리(x 약 115·295, y 약 180 — 아래가 용기 칸)** 만 씁니다. D 구멍은 STEP9 구멍 표의 "D 선반 (선택)" 행에서 조립 전에, 박스 바닥 구멍은 STEP5 박스 준비 때(속판을 달기 전) 뚫어 둡니다. 볼트는 **M3×15(P68, 선택 — 따로 주문)**, 너트는 **P38**을 씁니다(P38은 25개 중 24개를 브래킷에 쓰므로 **2개를 더 사야** 합니다). 너트는 뒤 덮개 H를 열고 용기를 꺼낸 뒤 용기 칸 쪽(D 아래)에서 끼워 조입니다. *왜 15mm?* 볼트가 박스 바닥 + D(5mm) + 너트를 지나 나와야 해서 M3×10(P37)은 짧을 수 있습니다(박스 바닥 두께 실측).
<!--S-->
2. **전원선 ②·④ 다시 연결(필수)** — SW1·F1은 STEP4에서 이미 G에 끼워져 있고, G는 STEP9에서 본체에 붙었습니다.
   1. G 안쪽에 매달린 ②·④ 끝의 테이프를 벗기고 박스 **뒤 벽 Ø16 구멍**으로 넣습니다.
   2. **② → J1 + 나사, ④ → TB1-8**에 연결하고 살짝 당겨 봅니다(STEP9에서 뺀 선 — 빠뜨리면 SW1을 켜도 전원이 들어오지 않습니다).
<!--/S-->
<!--N-->
2. **전원선 ②·④ 다시 꽂기(필수)** — SW1·퓨즈홀더는 STEP4에서 G에 달렸고, G는 STEP9에서 본체에 붙었습니다.
   1. 박스 뒤 벽 Ø16 구멍 밖으로 나와 있는 ②·④ 끝의 테이프를 벗깁니다.
   2. **② → G1(SW-a가 꽂힌 것), ④ → G3(F-b가 꽂힌 것)**에 꽂고 레버를 내린 뒤 당겨 봅니다(STEP9에서 뺀 선 — 빠뜨리면 SW1을 켜도 전원이 들어오지 않습니다).
   3. 퓨즈홀더와 커넥터 묶음이 G 안쪽 마운트에 묶여 있고, 상판 C를 열었을 때 손이 닿는지 봅니다.
<!--/N-->
3. **어댑터 선(①)** — 어댑터 플러그를 G의 **Ø12 구멍(그로밋 없이)** 으로 **바깥에서 안으로** 넣습니다. 그다음 출력 그로밋 05를 옆 트임으로 케이블에 끼우고 오므려 구멍에 눌러 끼운 뒤, 둘레를 글루건으로 고정합니다. 플러그는 박스 뒤 벽 구멍을 지나 J1에 꽂습니다. G 안쪽에서 선을 케이블타이로 한 번 묶어(매듭처럼) 밖에서 잡아당겨도 J1이 빠지지 않게 합니다(장력 완화).
   - ①·②·④가 모두 연결되면 **STEP4 절차 ⟦11·12¦13·14⟧(단락 검사·전압 확인)를 다시** 합니다: 어댑터를 뽑은 상태에서 TB1–TB2 단락 검사 → 어댑터를 꽂고 SW1 OFF **0V** / ON **4.9~5.25V**(이제 TB1 구멍이 다 찼으므로 STEP6의 측정 위치 — 릴레이 K1 COM 나사 머리 ↔ J1 − 나사 머리 — 에 댐) → SW1 OFF → **어댑터를 콘센트에서 뽑습니다**(다음 절차 4·5는 배선 작업).
4. **앞판 배선** — 앞판 선(㉙~㊱)을 박스 앞 벽 구멍으로 넣어 연결합니다(번호 테이프와 색을 보고 하나씩):
   - ㉙ 부저 VCC(노랑, 테이프 ㉙) → **TB3-3** · ㉚ 부저 I/O(노랑, 테이프 ㉚) → **GPIO23 (J3-2)**
   - ㉛ ⟦앞판 GND 이음점에서 오는 검정선¦앞판 GND 모음(PCT-415)에서 오는 검정선⟧ → **ESP32 GND (J3-7)**
   - ㉝ 버튼(노랑, 테이프 ㉝) → **GPIO4 (J3-13)** · ㉟ R1·LED(노랑, 테이프 ㉟) → **GPIO2 (J3-15)**
   - 노랑 4가닥은 색이 같으므로 **번호 테이프만 보고** 꽂습니다. 특히 ㉙(3V3)을 GPIO 단자에, ㉚·㉝·㉟를 TB3에 꽂지 않게 한 가닥씩 확인합니다.
5. **용기·펌프 모듈 넣기** — 뒤 덮개 H를 열고, 뚜껑을 닫은(뚜껑을 잡고 몸통을 돌려) 용기 1~4를 왼쪽부터 순서대로 넣습니다. 좁은 80mm 쪽이 좌우입니다.⟦¦ 뚜껑 위 레버 커넥터 덩어리가 선반 D 아래에 눌리지 않는지 봅니다.⟧
   - 펌프 1·2 선 → 선반 왼쪽 그로밋(x 60), 펌프 3·4 선 → 오른쪽 그로밋(x 360) → 박스 옆 벽 구멍 → 연결표 ㉑~㉘:
     펌프 1 빨강 → **K1 NO**, 검정 → **TB2-2** · 펌프 2 → **K2 NO** / **TB2-3** · 펌프 3 → **K3 NO** / **TB2-4** · 펌프 4 → **K4 NO** / **TB2-5**.
<!--S-->
   - 하네스의 Y자 이음 덩어리는 박스 벽 구멍 밖(선반 위)에 두고, 빨강·검정 꼬리만 박스 구멍으로 넣습니다.
<!--/S-->
   - 그로밋 아래에서 전선을 **U자로 한 번 늘어뜨린(드립 루프)** 뒤 올립니다. *왜?* 전선을 타고 흐르는 물방울이 U자 바닥에서 떨어져 구멍으로 들어가지 않습니다.
   - 용기를 뒤로 30cm 꺼낼 수 있을 만큼 전선·튜브 여유를 용기 칸 안에 남깁니다.
6. **체크밸브 고정** — 선반 D 아래(용기 칸 쪽), 칸막이 구멍 근처(y 120~160)에 접착 마운트(P28)를 붙이고 체크밸브 4개를 가로로 케이블타이 고정합니다. **화살표가 앞(칸막이·노즐 쪽)** 을 향합니다.
7. **노즐 연결(그림 15)**
   1. **튜브 부싱(출력 07)** 을 칸막이 E의 Ø25 구멍에 테가 잔 칸 쪽으로 오게, 잔 칸에서 볼 때 **점 1·2개 구멍이 왼쪽, 점 3·4개 구멍이 오른쪽**에 오도록 돌려 끼우고 글루건으로 고정합니다. *왜?* 노즐 블록 구멍이 왼쪽부터 1·2·3·4라, 이렇게 돌려야 좁은 틈(20mm)에서 튜브가 서로 엇갈리지 않습니다. 각 체크밸브의 내경4 출구 튜브를 **부싱 테의 점 개수 = 펌프 번호**인 구멍으로 하나씩 잔 칸 쪽에 통과시킵니다.
   2. 노즐 블록을 잔 칸 안에서 손에 듭니다. 블록 밑판(구멍이 뚫린 판) 윗면의 **'앞' 화살표가 잔 칸 앞쪽**을 보게 들고, 구멍 앞의 **점 1~4개 = 펌프 번호**입니다. 튜브를 **왼쪽부터 펌프 1·2·3·4 순서**로 블록 안 튜브 칸막이 사이를 지나 구멍에 위에서 아래로 끼웁니다. 블록의 구멍(Ø6.2)은 튜브(외경 6)가 꽉 끼므로, 빡빡하면 튜브 끝을 뜨거운 물에 10초 담갔다가 밀어 넣습니다.
   3. 튜브 끝이 블록 아래로 **10mm** 나오게 맞춘 뒤, 커터칼로 4개 끝을 같은 높이로 직각으로 자릅니다.
      *왜 10mm?* 3D 출력물은 층 사이 홈에 액체가 스며들면 씻기 어렵고 식품용 인증도 없으므로, 음료가 블록에 닿지 않고 튜브 끝에서 바로 잔으로 떨어지게 합니다.
   4. 블록 위쪽에서 튜브 둘레를 글루건(또는 식품용 실리콘)으로 **빈틈없이** 막아 고정합니다.
   5. 노즐 블록의 벽 윗면과 양쪽 날개 윗면에 순간접착제(또는 글루건)를 바르고 선반 D 아래 **x 180~240, y 22~82**(블록 중심 = 잔 칸 가운데 x 210, y 52)에 30초간 눌러 붙입니다. 튜브가 납작하게 꺾이지 않았는지 확인합니다.
   6. 줄자로 바닥판 윗면에서 블록 아랫면까지 **230mm**, 튜브 끝까지 **220mm**인지 잽니다.
   *왜 한 줄로?* 2×2로 배치하면 뒤쪽 구멍으로 가는 튜브와 앞쪽 구멍으로 가는 튜브가 같은 줄에서 겹쳐, 좁은 틈(20mm)에서 심하게 꺾입니다. 한 줄이면 4가닥이 나란히 같은 모양으로 구부러집니다.
8. **튜브 길이 정리** — 내경5 튜브(펌프 → 체크밸브)가 너무 길어 용기 칸에서 꼬이면, 용기 인출 여유(약 30cm)를 남기고 잘라 다시 잇습니다.
9. **드립 트레이** — 잔 칸 바닥 가운데에 놓습니다. 노즐 바로 아래가 트레이 가운데가 되도록.
10. **배선 정리**
    - 박스 안: 가는 신호선 묶음과 굵은 전원선을 따로 케이블타이로 묶고, 박스 벽 구멍을 글루건으로 막습니다.
    - 선반 위: 그로밋 둘레와 옆 트임(출력 04, 3.5mm)을 글루건으로 막습니다.
    - 튜브는 **전장부(선반 위)로 절대 올라가지 않게** 합니다. 모든 튜브 이음부는 선반 아래에 있습니다.
11. **최종 연결 확인** — STEP6 점검표를 한 번 더 하고, 이번에는 펌프 선까지 포함해 TB1–TB2 단락이 없는지 봅니다.
12. 박스 뚜껑을 닫고 상판 C를 위에서 볼트 4개로 고정합니다(너트는 STEP9에서 상판용 브래킷 홈에 붙여 둠).

#### 액체·전장부 격리 점검

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

#### 확인 포인트

- [ ] ✔ 노즐 튜브 끝 높이 220mm, 튜브 끝 4개 높이 같음, 블록 위쪽 튜브 둘레 실링
- [ ] ✔ 펌프 번호 = 용기 번호 = 부싱 구멍 번호 = 노즐 구멍 번호 = 앱 슬롯 번호
- [ ] ✔ 용기를 뒤로 꺼냈다 넣을 수 있음(선·튜브가 걸리지 않음)
- [ ] ✔ 어댑터 선을 밖에서 당겨도 J1이 빠지지 않음
- [ ] ✔ ⟦② → J1 +, ④ → TB1-8 다시 연결¦②·④를 G1·G3에 다시 꽂음⟧, SW1 OFF 0V / ON 약 5V 재확인
- [ ] ✔ 전장 박스가 벨크로(또는 뒤쪽 볼트 2개)로 고정됨

#### 흔한 실수

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

### STEP 11. 캘리브레이션 (유량 맞추기) {#step11}

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

#### 왜 꼭 해야 하나요?

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

#### 절차 (앱 캘리브레이션 마법사)

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

#### 액체별 차이 (참고, 추정값)

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

#### 다시 해야 할 때

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

#### 120초 제한 주의 (SPEC v2.1)

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

#### 확인 포인트

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

#### 흔한 실수

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

### STEP 12. 시운전 · 세척 · 보관 {#step12}

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

#### 절차 가. 시운전 (물로)

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

#### 절차 나. 세척 (매번 사용 후)

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

#### 절차 다. 정기 세척 (설탕 음료를 쓴 날, 일주일에 한 번)

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

#### 절차 라. 보관

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

#### 확인 포인트

- [ ] ✔ 앱 전체 흐름(추천 → 제조 → 완료 → 피드백) 성공
- [ ] ✔ 비상정지 2가지 모두 동작
- [ ] ✔ 연결 끊김 시에도 정량 후 정지
- [ ] ✔ 10잔 연속 동안 재부팅·누수·과열 없음
- [ ] ✔ 세척·물 빼기 완료
<!--N-->
- [ ] ✔ 시운전·세척 뒤 뚜껑 위 레버 커넥터 덩어리가 젖지 않았음
<!--/N-->

#### 흔한 실수

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

<!-- pagebreak -->

## 4. 문제 해결 표 {#s4}

| 증상 | 가능한 원인 | 조치 |
|---|---|---|
| 앱에서 기기가 검색되지 않음 | 전원 꺼짐 / ⑧ 빠짐 / 다른 폰이 연결 중 / 권한 거부 / 웹앱을 지원하지 않는 브라우저 | SW1·어댑터 확인, ⑧ 재연결, 다른 폰 연결 해제, 앱 권한(근처 기기·위치) 허용, EN 버튼으로 재시작, 휴대폰 블루투스 껐다 켜기. 웹앱은 **Chrome·Edge + https 주소**에서만 블루투스가 됨(아이폰 불가) — 안 되면 APK 사용 |
| 연결은 되는데 "기기 정보(info)를 받지 못했어요" | 구버전(Wi-Fi) 펌웨어 | STEP7 절차 가로 v2 펌웨어 업로드 |
| 레시피 화면에 늘 "오프라인 추천"이 표시됨 | AI 키 미등록 / AI 추천 방식이 "오프라인" / 키 오류·사용량 한도·크레딧 소진 / 인터넷 끊김·응답 지연(25초) | 레시피 화면 위 안내에서 이유 확인 → 앱 설정 → **AI 고르기**에서 고른 AI의 **API 키** 칸 **[키 확인]**(성공 / 키가 올바르지 않음 / 권한 없음 / 사용량 한도·크레딧 소진 / 인터넷 연결 없음 — [5장](#s5) 전날 점검, `../../app/README.md` 5장). 시연은 오프라인 추천으로도 진행 가능 |
| 펌프가 켜질 때 ESP32가 재부팅(LED가 다시 천천히 깜빡) | 전압 강하(브라운아웃) / **펌프 다이오드 방향 반대**(켜는 순간 단락) | C1 극성·연결 확인, 다이오드 띠 방향 확인(띠 = 빨강), 전원선을 AWG20으로 짧게, 순차 모드 사용, 필요하면 C2(100µF) 추가. 시리얼에 `리셋 원인: 브라운아웃`이 보이면 확정 |
| 릴레이가 딸깍하지 않음 | JD-VCC(5V) 미연결 / GND 미연결 / 핀 번호 틀림 / A안 입력 전류 부족 / B안인데 ⑨를 VCC 핀으로 옮기지 않음(캡만 끼움) | ⑨(A안: JD-VCC 핀 / B안: 입력 헤더 VCC 핀)·⑯(릴레이 GND)·⑪(VCC) 확인, `run` 명령으로 채널별 확인, A안이 약하면 B안(STEP2 절차 라) |
| 릴레이가 꺼지지 않음(계속 켜짐) | B안인데 ⑪(3V3)이 연결됨 / A안인데 점퍼가 꽂힘 / IN 선 빠짐 | 점퍼·VCC 연결을 STEP2 결정대로, `{"cmd":"stop"}`으로도 안 꺼지면 배선 문제 |
| 전원을 켜자마자 펌프가 돈다 | 펌프가 NC 단자에 연결 | 펌프 빨강을 **NO**로 옮김 |
| 펌프를 켜면 ESP32가 재부팅되거나 어댑터가 꺼짐(또는 퓨즈가 끊어짐) | 다이오드 방향 반대 / 펌프 선 단락 | 해당 펌프의 다이오드 띠가 빨강 쪽인지 확인, 이음부 피복 확인. **퓨즈가 멀쩡해도 다이오드가 맞다는 뜻이 아님**(4A 어댑터는 퓨즈보다 먼저 스스로 끊음). ⟦수축튜브가 변색됐거나 냄새가 나는 다이오드는 교체(다이오드 하네스는 학교 실습실에서 다시 납땜 — 그 전까지는 예비 펌프 모듈로 바꿔 씀)¦감아 둔 절연테이프가 녹았거나 변색·냄새가 나면 어댑터를 뽑고 테이프를 풀어 다이오드·레버 커넥터를 교체⟧. 퓨즈가 끊어졌으면 원인을 고친 뒤 3A로 교체 |
| 릴레이는 딸깍하는데 펌프가 안 돔 | COM에 5V 없음 / NO 선 빠짐 / 펌프 이음 불량 | TB1→COM(⑰~⑳) 확인, COM–GND 5V 측정, 펌프 선 도통 확인 |
| 펌프는 도는데 액체가 안 나옴 | 체크밸브 거꾸로 / 튜브 공기 / 액면 너무 낮음 / 튜브 꺾임 | 화살표 방향 확인, 프라이밍, 액체 보충(최소 30mm), 꺾인 곳 펴기 |
| 양이 레시피보다 훨씬 적음 | 캘리브레이션 안 함(기본 20 ml/초 — 앱에 "캘리브레이션 전" 배너) / 액면 낮음 / 공기 구멍 막힘 | STEP11 캘리브레이션, 용기 보충, 뚜껑 Ø3 공기 구멍 확인 |
| "캘리브레이션 전" 배너가 계속 보임 | 저장 안 된 펌프가 있음(`calSet` 0) | `{"cmd":"getcal"}`로 0인 펌프 확인 → STEP11로 저장 |
| 양이 들쭉날쭉 | 탄산 거품 / 액면 변화 / 튜브 속 공기 | 탄산은 차갑게, 절반 액면에서 재캘리브레이션, 제조 전 프라이밍 |
| 유량이 3 ml/초보다 훨씬 작음 | 체크밸브 유로(Ø2mm) 저항 / 꺾임 / 펄프 막힘 | 꺾임·막힘 해결, 그래도 느리면 체크밸브 제거 시험(노즐 높이 조건은 유지), 동시 모드 사용 |
| `LIMIT` 오류 | 한 재료 300ml 초과 / 총 500ml 초과 / 한 펌프 120초 초과(유량이 매우 느릴 때) / `run` 60초 초과 | 잔 용량 줄이기, 비율 조정, 유량이 너무 낮으면 원인 해결 |
| `BUSY` 오류 | 이미 제조 중 | 끝날 때까지 기다리거나 비상정지 후 다시 |
| 제조가 끝난 뒤에도 노즐에서 계속 똑똑 떨어짐 | 체크밸브 불량·당분 고착 / 노즐이 액면보다 낮음 | 세척 또는 교체, 노즐 튜브 끝 높이 220mm·액면 ≤ 160mm 확인 |
| 펌프가 멈췄는데 액체가 계속 흐름 | 사이펀(노즐이 액면보다 낮음) | 노즐을 높이거나 용기를 덜 채움. 체크밸브 방향 확인 |
| 이음부에서 샘 | 케이블타이 느슨 / 겹침 부족 / 단면 비뚤어짐 | 케이블타이 추가, 1.5cm 이상 겹침, 튜브 끝을 직각으로 다시 자르기 |
| 앱 "펌프 1"인데 다른 펌프가 돎 | GPIO 핀 배선 뒤바뀜 / 노즐·용기 번호 혼동 | 연결표 ⑫~⑮ 재확인(26·27·32·33), 번호 라벨 정리 |
| 부저가 계속 울림 | ONE005가 아닌, LOW에 울리는 부저 모듈을 씀(ONE005는 HIGH = 울림) / I/O·VCC 핀을 바꿔 꽂음 | 모듈 인쇄대로 다시 꽂기, 다른 모듈이면 `config.h` `BUZZER_ON_LEVEL 0` 후 재업로드 |
| 업로드 실패 `Failed to connect` | BOOT 버튼 / 케이블 / 포트 점유 | `Connecting...` 때 BOOT 누르기, 데이터 케이블, 시리얼 모니터 닫기, Upload Speed 115200 |
| 시리얼 모니터 글자가 깨짐 | 속도 다름 | 115200 |
| 버튼을 눌러도 반응 없음 | ㉝·㉞·㉛ 연결 / 버튼 단자 잘못 선택 | 도통 모드로 버튼 누를 때만 "삐" 나는 단자 2개를 찾아 연결 |
| 상태 LED가 안 켜짐 | LED 방향 / R1 빠짐 / ㉟·㊱·㉛ / 외부 LED를 안 담 | ⟦베젤을 떼고 학교 실습실에서 R1·GND 납땜을 풀어 LED 방향을 바꿔 다시 납땜¦어댑터를 뽑고 LED 두 다리를 레버 커넥터에서 빼 서로 바꿔 꽂기(긴 다리 = ⓐ)⟧, 연결 확인. 보드에는 GPIO2 LED가 없어 외부 LED가 필수 |
| 용기를 꺼낼 때 튜브가 빠짐 | 여유 부족 | 용기 칸 안에 튜브·전선 30cm 여유 확보 |
| 뚜껑을 닫으면 전선·튜브가 꼬임 | 뚜껑을 돌려 닫음(돌림 뚜껑) | 뚜껑을 잡고 **용기 몸통을 돌려** 여닫기 |
<!--S-->
| SW1(로커 스위치)이 G에서 빠짐 | 5mm 포맥스라 걸쇠가 약함 | G 안쪽 구멍 둘레를 커터칼로 얇게 파서 다시 끼우거나, 몸통 둘레를 글루건으로 고정 |
| 납땜한 선이 떨어지거나 흔들면 전원이 끊김 | 냉납 / 수축튜브 없이 꺾임 | 학교 실습실에서 다시 납땜(2.6 바), 수축튜브로 덮고 선을 케이블타이로 고정 |
<!--/S-->
<!--N-->
| 펌프·LED가 됐다 안 됐다 함, 선이 쉽게 빠짐 | 레버 커넥터: 피복 길이 틀림 / 레버를 덜 내림 / 가는 선을 그냥 넣음 / 한 구멍에 두 가닥 | 어댑터를 뽑고 레버를 올려 선을 뺀 뒤 9~10mm(PCT-418은 10~11mm) 다시 벗겨 꼬고(가는 선은 두 배 길이로 벗겨 반으로 접어 — 2.6 나 6) 끝까지 넣고 레버를 내린 뒤 당김 테스트 |
| SW1을 켜도 전원이 안 들어옴 | ②·④를 G1·G3에 다시 꽂지 않음 / 퓨즈 빠짐·끊어짐 / G2(SW-b–F-a) 빠짐 | STEP10 절차 2 확인 → 어댑터를 뽑고 상판 C를 열어 퓨즈홀더를 돌려 열고 퓨즈를 멀티미터 도통 모드로 확인 |
| 퓨즈를 바꿔야 함 | 단락 뒤 끊어짐 | **원인부터 찾음**(다이오드 방향·선 닿음). 어댑터를 뽑고 → 상판 C를 열고 → G 안쪽 인라인 퓨즈홀더를 돌려 열어 **3A** 예비 퓨즈로 교체 |
| 하네스 스위치(SW1)가 G에서 빠짐 | 5mm 판이라 걸쇠가 약함 | 다시 끼우고 G 안쪽에서 몸통 둘레를 글루건으로 고정 |
| P73·P74 리드가 가늘다(피복 인쇄 AWG 숫자 24 이상) | 리드가 얇은 제품 | 이 선에는 기기 전체 전류(보통 1A 안팎, 펌프를 동시에 돌리면 더 큼 — 추정)가 흐름. 리드를 G 안쪽에서 약 5cm만 남기고 자르고, ②·④를 그만큼 길게 해 가는 구간을 짧게(추가 부품 없음). 쓰는 중에 리드가 뜨거워지면 바로 끄고 판매처 규격 확인 |
| CG0731 단자가 버튼에 안 맞음 | 버튼 단자가 2.8mm 탭이 아님 | 케이블 끝을 벗겨 버튼 단자 구멍에 감아 꼬고 절연테이프로 감음. 그래도 안 되면 학교에서 그 2곳만 납땜([납땜 기준 가이드](제작가이드_납땜기준.md) STEP9) |
| 받은 PCT-41x가 레버형이 아님 | 다른 모델이 옴 | 판매처에 교환을 요청하거나 같은 칩센 PCT-41x **레버형**으로 다시 주문(BOM P75~P77 상품 번호) |
| 뚜껑 위 레버 커넥터가 젖음 | 재료를 채울 때 튐 / 덩어리가 뚜껑에 닿아 있음 | 어댑터를 뽑고 레버를 열어 말린 뒤 다시 꽂음. 덩어리를 뚜껑에서 1~2cm 띄워 다시 묶고, 재료는 뚜껑 모듈을 옆에 두고 채움 |
<!--/N-->

<!-- pagebreak -->

## 5. 시연(발표) 체크리스트 {#s5}

기말 시연(발표)과 졸업작품 전시에 씁니다. 날짜는 학과 공지로 **확인 필요**합니다.

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

### 전날

- [ ] 리허설: 발표 순서대로 한 번(추천 → 제조 → 완료 알림 → 양·색 확인 → 앱 평가 버튼 → "한 잔 더?"/탐색 모드) + 연속 10~20잔(물/색 물) — 문제 기록·수정
- [ ] 휴대폰 2대에 앱 설치(Releases 의 최신 APK, 한 대는 예비), 충전 100%, 보조배터리. 두 폰 모두 근처 기기·위치·알림 권한 허용. 예비로 PC(Chrome 웹앱 또는 EXE)도 준비
- [ ] 앱 AI 키 점검: 시연 폰의 **앱 설정**(오른쪽 위 ⚙, 기기 탭 맨 아래 "앱 설정"으로도 감) → **AI 고르기**에서 고른 AI의 **API 키** 칸이 "저장됨 ••••••••(마지막 4자리)"인지 확인하고 **[키 확인]** 을 누릅니다. 결과는 칸 아래 색 띠로 나옵니다(`../../app/README.md` 5장).
  - 초록 **"성공 — 이 키로 AI 추천을 쓸 수 있어요"** → 정상. **AI 추천 방식**이 **[AI(내 키)]** 인지도 봅니다.
  - 노랑 **"키는 정상이에요 — 모델을 바꿔 주세요"** → 같은 화면의 **모델** 목록에서 다른 모델을 고릅니다.
  - 빨강 **"키가 올바르지 않아요" / "권한 없음"** → 키를 다시 붙여 넣거나 그 AI 회사 사이트(앱 설정의 "키 발급 방법")에서 새 키를 발급받아 [키 확인] → [저장].
  - 노랑 **"사용량 한도·크레딧 소진"** → 무료 등급 한도. 잠시 뒤 다시 확인하고, 시연 직전에는 연습 호출을 줄입니다.
  - 빨강 **"인터넷 연결 없음"** → 휴대폰 인터넷(와이파이·데이터)을 확인하고 다시 누릅니다.
  - 노랑·빨강이 계속되면 같은 화면 맨 위 **"AI 추천 방식"** 을 **[오프라인]** 으로 바꿔 바텐더 탭에서 추천이 나오는지 확인해 둡니다(시연 장소 인터넷이 불안정할 때 이 방식으로 진행). 확인 후 다시 **[AI(내 키)]** 로 돌려 둡니다.
  - 키는 그 폰에만 저장됩니다. 공용·전시용 폰이면 시연이 끝난 뒤 키를 **삭제**합니다.
- [ ] 기기가 고장 났을 때를 대비해 앱 **데모 모드(가상 기기)** 로 화면 시연이 되는지 확인
- [ ] 노트북에 Arduino IDE + 펌웨어 폴더 + USB 케이블(펌웨어 다시 올릴 때)
- [ ] 예비 부품 상자: 퓨즈 3A ×2, ⟦예비 펌프 모듈 1개(학교 1차 때 만듦) + 펌프(P09 예비) ×1¦펌프(P09 예비) ×2⟧, 체크밸브 ×1, 1N4007 ×2, 용기 970ml ×1, 튜브 내경4·5 각 1m, 케이블타이, 점퍼선, 레버 커넥터 PCT-418 ×1, ⟦수축튜브¦PCT-412 ×2 · PCT-413 ×2, 절연테이프⟧, 멀티미터, 스트리퍼, 일자·십자 드라이버, 글루건
<!--S-->
  - 납땜 부품은 학교 실습실에서만 고칠 수 있으므로, 고장 난 펌프 모듈은 통째로 예비 모듈과 바꾸고 고치는 것은 학교에서 합니다.
<!--/S-->
- [ ] 시연용 액체 4가지 준비: **물에 식용색소를 탄 색 물**(예: 빨강·노랑·파랑·초록 — 섞이면 색이 바뀌어 비율이 눈에 보임) + 예비 1병씩. 앱 재료 이름은 실제 재료 이름(예: "사이다")으로 둬도 되지만 내용물은 색 물. 맑은 음료를 쓰더라도 **펄프 없는(걸러낸) 것만**(펄프는 체크밸브 Ø2mm를 막음), 마시지 않음
- [ ] 투명 **시연용 컵**(높이 190mm 이하 — 노즐 튜브 끝 z 220, [0.1](#s0)) 10개 정도 — 마시지 않는 시연 전용(관람객에게 나눠 주지 않음), 시연 후 액체를 버릴 통
- [ ] 키친타월, 물티슈, 쓰레기봉투, 세척용 물통, 큰 그릇(세척수 받기)
- [ ] 멀티탭(콘센트까지 거리 확인), 테이블보
- [ ] 안내문: "시연용 색 물입니다 — 마시지 마세요", "버튼을 누르면 즉시 멈춥니다", 사용 방법 QR(웹앱 [https://paperji.github.io/smart-bartender/](https://paperji.github.io/smart-bartender/) — 데모 모드로 바로 체험), 팀 소개

### 당일 (설치)

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

### 시연 중

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

### 끝난 뒤

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

<!-- pagebreak -->

## 6. 개선 아이디어 (졸업논문 · 특허 · 후속 개선) {#s6}

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

---

## 부록 A. 핀맵 요약 (SPEC §1) {#appA}

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

## 부록 B. 재단표 (parts_research.md 5.2와 동일, W420 기준) {#appB}

| 기호 | 이름 | 가로 × 세로 (mm) | 수량 | 위치 · 가공 |
|---|---|---|---:|---|
| A | 바닥판 | 420 × 260 | 1 | 맨 아래, 고무발 4개 |
| B | 측판 (좌·우) | 260 × 370 | 2 | 바닥판 위 양끝 |
| C | 상판 (탈착) | 420 × 260 | 1 | 출력 브래킷 01 4개 + M3 볼트. 너트는 브래킷 홈에 순간접착제로 미리 붙여 둠(**캡티브 너트**, STEP9 절차 다 9). 네 모서리에 상판 모서리 캡(출력 06, C에만 접착). 대안: 자석 캐치 P69(선택) |
| D | 중간 선반 | 410 × 250 | 1 | z 255~260, Ø20 × 2 (뒤쪽 끝에서 35, 좌·우 끝에서 55). **(선택) Ø3.5 × 2**(왼쪽 끝에서 110 / 290, 뒤쪽 끝에서 75 — 전장 박스를 볼트 P68로 고정할 때만, 조립 전에 뚫음. 벨크로 P64면 뚫지 않음) |
| E | 칸막이 | 410 × 255 | 1 | y 105~110, Ø25 (가운데, 위에서 17) — 튜브 부싱(출력 07) |
| F | 앞판 상부 | 410 × 115 | 1 | Ø16 (오른쪽 끝에서 70), Ø5 (110), 높이 가운데 |
| G | 뒤판 상부 | 410 × 115 | 1 | 뒤에서 볼 때 왼쪽에서 Ø12(40, 그로밋 05) · 스위치 사각(90)⟦ · 퓨즈(140)¦ — 퓨즈 구멍 없음(인라인 퓨즈홀더)⟧. **구멍은 STEP4(1주차)에서 뚫음**⟦(SW1·F1을 먼저 끼운 뒤 납땜)¦(SW1을 끼워 전원부를 먼저 만듦)⟧ → G는 가장 먼저 받거나 잘라 둠 |
| H | 뒤 덮개 (탈착) | 408 × 253 | 1 | 자석 P45 + 철판 P80 각 2(자석은 걸림턱 L에), 손가락 구멍 Ø25(선택) |
| I | 앞판 하부 (좌·우) | 125 × 255 | 2 | x 5~130 / 290~415 |
| J | 잔 칸 옆벽 (좌·우) | 105 × 255 | 2 | x 130~135 / 285~290 |
| K | 선반 받침대 | 145 × 20 | 2 | 측판 안쪽 y 110~255, z 235~255 |
| L | 뒤 덮개 걸림턱 | 410 × 15 | 1 | 바닥판 뒤쪽 끝에 세워서 |
| M1 | 노즐 판 | 60 × 60 | 1 | **자르지 않음**(출력 노즐 블록 02 사용). 블록이 깨졌을 때의 대안: Ø6.5 × 4 **한 줄**(왼쪽에서 12·24·36·48, 앞에서 30) — 아래 메모, [부록 D](#appD) |
| M2 | 노즐 걸이 | 60 × 20 | 2 | **자르지 않음**(대안일 때만: M1 위 양끝에 세워 "ㄷ"자 블록) |
| N | 용기 칸 가이드 (970ml 용기는 권장) | 140 × 15 | 3 | 용기 사이 x ≈ 107, 210, 312 |

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

## 부록 C. 캘리브레이션 기록표 {#appC}

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

## 부록 D. 3D 프린팅 부품 {#appD}

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

그림 16. 3D 프린팅 부품 7종

그림 17. 3D 프린팅 부품 위치

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

**받은 뒤 확인**

| 부품 | 확인할 것 | 안 맞을 때 |
|---|---|---|
| 01 브래킷 | M3 너트가 육각 홈(맞변 5.9)에 들어가고, M3 볼트가 구멍(Ø3.5, 위가 뾰족한 눈물방울 모양)을 지남 | 빡빡하면 볼트로 당겨 넣거나, 줄로 다듬거나, ⟦학교 2차 방문¦구멍 뚫는 날 ②⟧에 Ø3.5 드릴 날로 한 번 훑음, 헐거우면 순간접착제 |
| 02 노즐 블록 | 튜브(외경 6)가 Ø6.2 구멍에 꽉 끼움, 점 1~4개·'앞' 화살표 | 너무 빡빡하면 튜브 끝을 뜨거운 물에 10초, 헐거우면 실링으로 메움 |
| 03 베젤 | 버튼 머리(Ø18)가 Ø18.8 구멍을 지나고, LED 테가 뒤쪽 홈에 앉음 | 줄·사포로 다듬음 |
| 04·05 그로밋 | 트임을 오므려 5mm 판 구멍에 눌러 끼워짐 | 빡빡하면 걸림 부분을 사포로, 헐거우면 글루건 |
| 06 캡 | 상판 C 모서리에 맞고, 옆 다리 아래쪽 5mm(C 아랫면보다 아래)는 B·F·G와 1mm 떨어짐 | 틈은 순간접착제·실리콘으로 메움 |
| 07 부싱 | Ø25 구멍에 들어가고, 튜브 4가닥이 지나감 | 빡빡하면 몸통을 사포로 |

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

#### 출력 부품이 깨지거나 맞지 않을 때 (대안)

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

## 부록 E. 용어 사전 {#appE}

처음 보는 낱말이 나오면 여기서 찾으세요. (가나다순이 아니라 처음 나오는 순서에 가깝게 묶었습니다.)

| 용어 | 뜻 | 이 가이드에서 |
|---|---|---|
| 피복 · 심선 | 전선 겉의 비닐(피복)과 속의 구리 가닥(심선) | 피복을 정해진 길이만큼 벗겨 심선을 꼬아 씀 ([2.6](#skills)) |
| AWG | 전선 굵기 번호. **숫자가 작을수록 굵음** | AWG20(빨강·검정 2심, 굵음) · 22AWG(UL1007 노랑·검정·빨강) |
| 도통 | 두 점이 전선으로 이어져 있는지. 멀티미터 `•)))` 모드에서 "삐" 소리가 나면 이어진 것 | 전원 없이 배선 확인 (STEP1·5·6) |
| 단락(쇼트) | +와 −(또는 서로 달라야 할 두 선)가 직접 닿은 것. 큰 전류가 흘러 뜨거워지고 부품이 상함 | 전원 넣기 전 TB1–TB2 단락 검사 (STEP4·6) |
| 극성 | +/− 방향이 정해져 있는 것 | 다이오드 · 커패시터 · LED · DC 단자 (그림 6) |
| 다이오드 · 띠(캐소드) | 전기를 한 방향으로만 흘리는 부품. 몸통의 띠 쪽이 캐소드(−), 반대쪽이 애노드(+) | 1N4007 띠 쪽 = 펌프 빨강(+) (STEP3) |
| 역기전력 | 모터를 끄는 순간 생기는 거꾸로 된 높은 전압. 다이오드가 흘려보내 부품을 보호 | 펌프마다 다이오드 1개 |
| 전해 커패시터 | 전기를 잠깐 모아 두는 부품. 띠 쪽 짧은 다리가 −. 반대로 꽂으면 터질 수 있음 | C1 1000µF — 펌프가 켜질 때 전압이 떨어지는 것을 막음 |
| 릴레이 · NO / COM / NC | 작은 신호로 큰 전기를 켜고 끄는 스위치. COM은 공통, NO는 평소 떨어져 있다가 켜지면 붙음, NC는 그 반대 | 펌프는 **NO**에 연결 (STEP1·5) |
| JD-VCC 점퍼 · A안/B안 | 릴레이 모듈의 코일 전원(JD-VCC)과 입력 전원(VCC)을 잇는 작은 캡. 캡을 빼면 A안, ⑨(+5V)를 입력 헤더 VCC로 옮기고 캡을 끼우면 B안 | STEP2 절차 다·라에서 결정 |
| Active-LOW | 신호가 LOW(0V)일 때 켜지는 방식 | 이 릴레이는 LOW = 켜짐 |
| GND · 5V · 3V3 | 기준 전위(0V) · 5볼트 전원 · 3.3볼트 전원 | TB2 = GND, TB1 = +5V, TB3 = 3V3 |
| 별형 접지 | 여러 GND를 한 점(J1 −)에서 나눠 잡음을 줄이는 배선 | ⑤ → TB2(펌프), ⑦ → ESP32 |
| 브라운아웃 | 전압이 순간적으로 떨어져 ESP32가 스스로 재부팅되는 것 | 4장 문제 해결 |
| 브레드보드 · 레일 | 납땜 없이 부품을 꽂아 시험하는 구멍 판 · 그 가장자리의 +/− 긴 줄(한 줄이 끝까지 이어져 전원·GND를 나눠 줌) | STEP2 시험 |
| EN 버튼 | ESP32 보드의 리셋 버튼(누르면 다시 시작) | STEP2·7 |
| 실크 인쇄 | 보드 위에 흰 글씨로 찍힌 핀 이름·표시 | 확장보드·릴레이 핀 확인 |
| 스탠드오프(서포트) · 속판 | 보드를 판에서 띄워 고정하는 작은 기둥 · 전장 박스 안에 부품을 붙이는 판 | STEP5 |
| 모따기 | 모서리를 비스듬히 깎은 면 | 출력 브래킷 01의 바깥 모서리 |
| 듀폰선(점퍼선) F/F · M/F · M/M | 끝이 소켓(F, 암) 또는 핀(M, 수)인 시험용 선 | 릴레이 입력 · 부저 핀 |
| 레버 커넥터 | 피복 벗긴 선을 넣고 레버를 내리면 물리는 이음 부품. 안의 구멍은 모두 이어져 있음 | PCT-418(8구 분배기)⟦¦ · PCT-412(2구) · PCT-413(3구) · PCT-415(5구)⟧ |
| 나사 단자 · 푸시인 단자 | 나사를 조여 선을 무는 단자 · 버튼을 누른 채 선을 넣는 단자 | J1·릴레이 출력 · ESP32 확장보드 |
<!--S-->
| 납땜 · 냉납 | 녹인 납으로 금속을 잇는 것. 납이 회색 덩어리로 굳으면 접촉이 나쁜 "냉납" | 학교 실습실 (2.6 바) |
<!--/S-->
| 솔더 슬리브 | 납 고리와 접착 고리가 든 수축튜브. 열풍기로 데우면 이음 + 방수가 한 번에 됨 | ⟦펌프 리드 이음 (STEP3)¦이 기준에서는 펌프 리드가 짧을 때만 (STEP3 절차 3)⟧ |
| 수축튜브 | 열을 가하면 줄어드는 절연 튜브 | ⟦납땜부 절연¦이 기준에서는 쓰지 않음(절연테이프로 대신)⟧ |
<!--N-->
| 하네스 스위치 | 선(리드)이 공장에서 미리 달려 나온 스위치 | SW1 (P73) |
| 인라인 퓨즈홀더 | 선 중간에 매다는 퓨즈 통. 돌려 열고 퓨즈를 바꿈 | F1 (P74) |
| 2.8mm 탭 단자 | 버튼 등의 납작한 금속 단자에 끼우는 암 단자 | CG0731 → 버튼 (P78) |
| 절연테이프 | 늘려 감는 전기용 비닐 테이프. 수축튜브 대신 | P79 (2.6 바) |
<!--/N-->
| 펌웨어 · 업로드 | ESP32 안에서 도는 프로그램 · PC에서 보드로 그 프로그램을 넣는 것 | Arduino IDE (STEP2·7) |
| 시리얼 모니터 | PC에서 USB로 ESP32와 글자를 주고받는 창. 속도 115200 | `{"cmd":"hello"}` 같은 명령 |
| BLE | 블루투스 저전력. 휴대폰 앱과 기기가 공유기 없이 바로 통신 | 앱 연결 (STEP7) |
| 체크밸브 · 바브 | 한 방향으로만 흐르게 하는 밸브 · 튜브를 끼우는 톱니 모양 끝 | 화살표가 노즐 쪽 (STEP8) |
| 프라이밍 | 튜브 속 공기를 빼고 액체로 채우는 것 | 앱 기기 탭 (STEP8·11) |
| 캘리브레이션 · 유량 | 펌프가 1초에 내보내는 양(ml/초)을 재서 저장하는 것 | 앱 마법사 (STEP11) |
| 사이펀 | 노즐이 액면보다 낮으면 펌프가 꺼져도 액체가 계속 흐르는 현상 | 노즐을 액면보다 60mm 높게 |
| 드립 루프 | 전선을 U자로 늘어뜨려 물방울이 구멍으로 타고 들어가지 않게 하는 것 | 선반 그로밋 아래 (STEP10) |
| 포맥스 | PVC를 발포한 가벼운 판(5T = 두께 5mm). 커터칼로 자를 수 있음 | 외형 판 (STEP9) |
| 그로밋 | 판 구멍에 끼워 전선 피복이 긁히지 않게 하는 테 | 출력 04·05 |
| 캡티브 너트 | 미리 붙여 두어 돌지 않는 너트. 볼트만 돌려 조이고 풂 | 상판 C 고정 |
| 스텝드릴 · 테이퍼 리머 | 계단 모양으로 여러 지름 구멍을 내는 드릴 날 · 손으로 돌려 구멍을 넓히는 원뿔 공구 | 구멍 뚫기 |
| PETG · 인필 | 3D 프린팅 재료(물·열에 PLA보다 강함) · 출력물 속을 채운 비율 | 출력 부품 (부록 D) |

---

*그림 원본: `figures/` · 인쇄용: `제작가이드_⟦납땜¦무납땜⟧기준.html` · 이 가이드는 `src/제작가이드.src.md` 한 원본에서 두 기준을 함께 만듭니다(`python src/build_guides.py`) · 회로도: `../circuit/회로도.html` · BOM: `../BOM_⟦납땜¦무납땜⟧기준.md` · 3D 프린팅 부품: `../3dprint/`*
