paperji/smart-bartender/hardware/guide/제작가이드_무납땜기준.html

체크 초기화인쇄 / PDF 저장 (A4)

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

이 가이드는 무납땜 기준입니다. 인두기·열풍기 없이 집에서 만듭니다. 원래 납땜하던 20여 곳을 레버 커넥터(선을 꽂고 레버만 내리면 이어지는 부품)와 선이 미리 달린 부품으로 바꿨습니다. 구멍 뚫기(드릴)만 학교에서 빌리거나 손공구로 합니다(2.5). 납땜으로 만드는 원래 방법은 납땜 기준 제작가이드에 있습니다.

기준 문서 (이 가이드와 숫자가 다르면 아래 문서가 우선입니다)

- 부품 목록(BOM): ../BOM_무납땜기준.md · ../BOM_무납땜기준.xlsx (부품 번호 P01~P80, 2026-11-11) · 두 기준 비교 통합판 ../BOM.xlsx
- 시스템 명세: ../../docs/SPEC.md (v3.0 — 핀맵 · BLE 프로토콜은 v2.1 그대로 · 앱 동작)
- 회로도·실물 배선도: ../circuit/회로도.html (../circuit/schematic.svg, ../circuit/wiring.svg) — 전기 회로는 두 기준이 같습니다(무납땜은 선을 잇는 방법만 다름).
- 3D 프린팅 부품(출력 부품 01~07): ../3dprint/ (STL·모델 코드·출력 조건) — 부록 D
- 펌웨어 설명서: ../../firmware/README.md, 앱 설명서: ../../app/README.md
- 앱 받기(v3.1): 웹앱 https://paperji.github.io/smart-bartender/ (Chrome·Edge) · 안드로이드 APK / Windows EXE https://github.com/paperji/smart-bartender/releases/latest
- 예전 판: 조립가이드.md (2026-11-06 — 3D 출력 부품이 없을 때의 대안 방법까지 들어 있음)

## 처음이라면 — 이것만 기억하세요

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

### 지금까지 준비된 것 (2026-11-11 기준)

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

## 이 가이드 읽는 법

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

## 목차

- 처음이라면 — 이것만 기억하세요
- 0. 완성 사양 · 동작 개요
- 1. 안전 수칙
- 2. 준비물 · 일정 · 기본 손기술
- 3. 단계별 제작
  - STEP 1. 부품 검수 · 멀티미터 기초
  - STEP 2. 브레드보드 단위 테스트
  - STEP 3. 펌프 모듈 만들기 (뚜껑 · 연장선 · 레버 커넥터 · 다이오드)
  - STEP 4. 전원부 (DC 단자 · 스위치 · 퓨즈 · 분배 커넥터 · 커패시터)
  - STEP 5. ESP32 · 릴레이 영구 배선 (연결표)
  - STEP 6. 전원 넣기 전 점검 · 첫 전원 투입
  - STEP 7. 펌웨어 업로드 · 앱 블루투스 연결
  - STEP 8. 배관 (튜브 · 체크밸브 · 누수 테스트)
  - STEP 9. 외형 제작 (재단 · 구멍 · 앞판 · 조립 · 방수)
  - STEP 10. 최종 조립 · 배선 정리
  - STEP 11. 캘리브레이션 (유량 맞추기)
  - STEP 12. 시운전 · 세척 · 보관
- 4. 문제 해결 표
- 5. 시연(발표) 체크리스트
- 6. 개선 아이디어
- 부록 A. 핀맵 요약 · 부록 B. 재단표 · 부록 C. 캘리브레이션 기록표 · 부록 D. 3D 프린팅 부품 · 부록 E. 용어 사전

## 0. 완성 사양 · 동작 개요

### 0.1 완성 사양

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

### 0.2 동작 순서 (한 잔이 만들어지기까지)

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

그림 1. 시스템 구성도 (figures/f01n_system.svg)

그림 2. 완성 모습 (figures/f02_complete_iso.svg)

### 0.3 세 구역으로 나누는 이유

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

그림 3. 외형 3면도 (단위 mm) (figures/f03_views.svg)

그림 4. 내부 배치도 (figures/f04_interior.svg)

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

### 0.4 전기 연결 요약 (SPEC §1)

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

## 1. 안전 수칙

### 1.1 전기

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

### 1.2 공구

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

### 1.3 식품 위생 — 지금 부품으로는 아무도 마시지 않습니다

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

### 1.4 음주 관련

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

## 2. 준비물 · 일정 · 기본 손기술

### 2.1 부품 (BOM 번호 기준)

"보유" = 1학기에 이미 산 것, "구매" = 이번 학기에 사는 수량(예비 포함 — 11-11에 산 부품은 실제로 산 수량). 상세 사양·구매처·가격은 ../BOM_무납땜기준.md 3장에 있습니다. 납땜 기준과 달라진 부품(P73~P79)은 굵게 적었습니다. 2026-11-11 무납땜 기준의 '구매' 열 부품을 모두 샀습니다 — 물건이 오면 STEP1에서 이 표로 하나씩 확인합니다.

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

쓰지 않는 보유품: P59 솔레노이드(설계 변경으로 제외), P60 솔더 슬리브 6.0SQ(너무 굵음), P61 DC 플러그 NT10-AF35(수 플러그라 불필요), P25 솔더 슬리브 1.0SQ 10개(레버 커넥터로 바꿔 쓰지 않음 — 펌프 리드가 짧아 뚜껑 안쪽에서 이어야 할 때만, STEP3 참고). 납땜 기준의 P13 로커 스위치·P14 패널형 퓨즈홀더·P26 수축튜브는 사지 않습니다.

### 2.2 공구

ID | 공구 | 구하는 방법 | 쓰는 곳
P48 · P72 | 디지털 멀티미터 M300 + 12V 23A 전지(멀티미터에 들어 있지 않음) | 구매(둘 다 11-11 디바이스마트 주문 — 집에서 STEP1부터 계속 씀) | 모든 STEP (도통·전압·다이오드 방향) — 다이오드 모드(▶ 기호)는 받은 날 확인(STEP1 절차 3)
P49 | 와이어 스트리퍼 TU-2022 (구멍 0.4~1.3mm) | 구매(11-11 주문) | 피복 벗기기 — 2.6 가
P53 | 드릴 + 스텝드릴 4~35mm | 학교 대여 (못 빌리면 손공구 — 아래 메모) | 구멍 약 51~55개 (뚜껑 12 · 뒤판 G 2 · 전장 박스 8~12 · 외형 판 약 29)
— | 일반(트위스트) 드릴 날 Ø3 · Ø3.5 | 학교 대여 (없으면 구매) | Ø3 안내 구멍 · 뚜껑 공기 구멍, Ø3.5 브래킷·상판·릴레이 고정 구멍 (스텝드릴은 4mm부터라 이 구멍을 못 뚫음). 스텝드릴에 Ø5·Ø7 단이 없으면 한 단 작게 뚫고 줄로 넓힘(받은 날 확인)
P51 | 글루건 (11mm 스틱용 — P43) | 집에서 계속 씀 — 학교 것을 집에 가져올 수 없으면 구매 | 구멍 막기·LED 고정·보강
P50 | 니퍼 | 집에서 계속 씀 — 가져올 수 없으면 구매 | 선·부품 다리 자르기
P54 | 커터칼(대) · 쇠자 60cm 이상 · 커팅매트 | 집에서 씀(재단) — 가져올 수 없으면 구매 | 포맥스 재단 (600×900 통판이면 꼭 필요 — 다이소 50cm 자는 짧음)
— | 줄자, 직각자(ㄱ자), 연필, 송곳, 사포 #240, 작은 줄, 십자드라이버, 작은 일자드라이버(릴레이·J1 나사 단자) | 집 | 공통
— | 클램프 2개, 보안경 | 학교 | 드릴 작업
— | 계량컵(100ml 이상) 또는 주방 저울(1g 단위), 스톱워치(휴대폰) | 집 | STEP2·11

인두기(P46)·실납(P47)·열풍기(P52)는 쓰지 않습니다(펌프 리드가 3cm보다 짧은 펌프가 있을 때만 그 펌프에 학교 열풍기 — STEP3 절차 3). 학교에서 빌릴 수 없을 때(BOM 예산 시트 '공구 직접 구매'): 글루건·니퍼 11,550원 · 드릴 대신 손공구(테이퍼 리머·줄·대형 커터칼) 15,990원. 포맥스와 PP 뚜껑은 무른 재료라, 송곳으로 작은 구멍을 낸 뒤 테이퍼 리머를 돌려 넓히고 사각 구멍은 커터칼과 줄로 만들 수 있습니다(구멍이 많아 몇 시간 걸림).

### 2.3 소모품

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

### 2.4 시작하기 전에 확인할 것

- 고정 방식 — 기본으로 정함(11-11 주문 기준): 전장 박스는 벨크로 P64, 상판 C는 캡티브 너트입니다(볼트 P68·자석 P69는 사지 않음). 나중에 전장 박스를 볼트로 잡고 싶으면 P68 M3×15와 P38 너트 2개를 더 사고, 선반 D·박스 바닥에 Ø3.5 구멍을 조립 전에 뚫습니다(STEP5·STEP10).
- 디바이스마트 주문 — 2026-11-11 완료 — 무납땜 기준 35품목, 결제 102,528원(상품 99,528원 + CG0731 따로 배송 3,000원 · 부품별 내역은 BOM 엑셀 지출_완료 시트). 도착까지 1~4일입니다. 멀티미터(P48)·23A 전지(P72)·스트리퍼(P49)·USB 데이터 케이블(P07)도 이 주문에 들어 있으므로, 주문품이 온 뒤에 STEP1을 시작합니다. 받으면 거래명세서(35줄)와 수량을 하나씩 맞춰 봅니다 — 볼트 P37·너트 P38은 25개씩(BOM 계획 30개보다 적음, 필요 24). 거래명세서 원본은 개인정보가 있으니 팀만 보관합니다.
  - 기다리는 동안 할 수 있는 것: 용기 확인(아래), 포맥스 뒤판 G 자르기, 2.6 읽기, (집에 데이터용 Micro USB 케이블이 있으면) STEP2 절차 가 펌웨어 업로드.
- 용기(P32) — 다이소 직사각 저장 용기 970ml(품번 1069852) 5개 구매 완료(11-11).
- 용기 확인 — 집에서 자와 펌프 1개로 아래를 확인합니다(안 맞으면 구매처에서 교환·반품).
  - 4개가 같은 제품인지(높이가 같아야 노즐·액면 계산이 맞음)
  - 몸통이 좌우 ≤ 95, 앞뒤 ≤ 135, 높이 ≤ 170mm(뚜껑 포함) 안인지 — 970ml는 약 80 × 105 × 150mm라 좁은 80mm 쪽을 좌우로 놓습니다.
  - 입구 안지름이 60mm 이상이고 펌프(약 43×23mm)가 입구로 들어가 바닥에 눕는지
  - 뚜껑이 손으로 돌려 꽉 닫히는지, 뚜껑 윗면에 구멍 3개(Ø7·Ø5·Ø3)를 낼 평평한 자리가 있는지
  - 산 날 집에서 펌프를 용기 바닥에 눕히고 리드가 입구 위로 몇 cm 나오는지 잽니다. 약 5cm 이상이면 충분합니다(뚜껑 두께와 안쪽 여유 1~2cm를 빼고 뚜껑 위로 3cm 이상 — 추정). 짧은 펌프가 있으면 아래 학교 대여 문의에 열풍기를 넣습니다.
  - 왜? 본체 안쪽 폭 410mm에 용기 4개를 한 줄로 넣고(칸 하나 약 98mm), 뚜껑에 펌프를 매달아 넣기 때문입니다.
  - 970ml가 맞지 않으면 원형 900ml(품번 1035184) 4개로 바꿉니다(같은 기준으로 확인). 처음 산 TARK 1L(폭 120mm)은 W420 본체에 들어가지 않으므로 취소·환불합니다.
- 다이소에서 함께 산 것 — 11-11 구매 완료(링크는 BOM 엑셀 주문_링크 시트의 '이미 산 것') — 폼 양면테이프 P71(오공 18mm×2m, 2,000원) · 네오디뮴 자석 13mm 3개입 P45(1,000원) + 접착식 철판 3개입 P80(1,000원) · 실리콘 원형 코스터 P33(드립 매트, 1,000원) · 전기 절연테이프 P79(1,000원, STEP3 전에 꼭). 멀티미터용 23A 전지(P72)는 디바이스마트 주문에 들어 있습니다. 결제는 14,000원(물건 11,000원 + 배송비 3,000원)입니다. 영수증을 모아 둡니다(정산).
- 학교 실습실 공구 대여 묻기 — 드릴·스텝드릴·일반 드릴 날(Ø3·Ø3.5)·글루건·니퍼·커터칼/쇠자(용기를 산 날 잰 리드가 짧은 펌프가 있으면 열풍기도)를 빌릴 수 있는지, 언제 쓸 수 있는지, 글루건·니퍼·커터칼·쇠자는 집에 가져가 써도 되는지(집에서 계속 씀) 학과(조교)에 먼저 묻습니다. BOM은 '대여 가능'을 전제로 했을 뿐 확인된 적은 없습니다. 안 되면 2.2 아래 메모(공구 직접 구매)를 봅니다.
- 포맥스(P34, 구매 완료) 확인 — 받은 판이 600×900 통판이면 STEP9에서 직접 재단합니다(그림 13 — 커터칼(대)·쇠자 60cm 이상·커팅매트). 맞춤 재단 판이면 부록 B 치수와 맞는지 줄자로 잽니다. 뒤판 G(410×115)는 STEP4에 필요하므로 가장 먼저 자릅니다 — 판 2에 그림 13대로 모든 선을 먼저 그린 뒤 G 자리만 잘라 냅니다(아무 데서나 자르면 D·E·F 자리가 모자랄 수 있음). 노즐 판 M1·M2는 자르지 않습니다(출력 노즐 블록 02 사용).
- 3D 출력 부품(P70, 주문 완료 · 11/16 도착 예정) — STEP 1~8은 출력 부품 없이 할 수 있고, STEP9부터 필요합니다. 받은 날 부록 D의 '받은 뒤 확인' 표대로 끼워 봅니다.
  - 지금 어댑터(P11) 플러그 머리 지름을 자로 잽니다. 12mm보다 크면 뒤판 G의 Ø12 구멍을 키워야 하고, 이미 주문한 그로밋 05(Ø12용)는 맞지 않습니다 → 구멍 가장자리를 글루건으로 둥글게 마감하거나 05의 구멍 값을 바꿔 다시 출력합니다(부록 D).
- 무납땜 부품(P73~P78)을 받으면 바로 확인 — ① PCT-413·412·415가 레버형인지(레버를 올렸다 내릴 수 있어야 함) ② CG0731의 2.8mm 단자가 버튼(P03) 단자에 꽉 끼워지는지 ③ 하네스 스위치(P73)·퓨즈홀더(P74) 리드선 피복에 인쇄된 굵기(AWG 숫자가 22 이하면 충분 — 숫자가 작을수록 굵음) ④ 버튼 단자 개수. 안 맞으면 4장의 무납땜 줄을 봅니다.

### 2.5 일정 예시 (날짜 없는 상대 일정)

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

#### 구멍 뚫는 날 ① — 챙길 것과 순서

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

#### 구멍 뚫는 날 ② — 챙길 것과 순서

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

### 2.6 기본 손기술 (처음이면 자투리 선으로 먼저 연습)

이 가이드에서 반복해서 쓰는 손기술입니다. 실제 부품에 하기 전에 남는 전선으로 두세 번 해 보세요.

#### 가. 피복 벗기기 (와이어 스트리퍼 TU-2022)

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

#### 나. 레버 커넥터 (PCT-418 · PCT-412 · PCT-413 · PCT-415)

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

#### 다. 나사 단자 (J1 · 릴레이 출력 단자)

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

#### 라. 푸시인 단자 (ESP32 확장보드 P02)

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

#### 마. 듀폰(점퍼)선 끝 처리

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

#### 바. 절연테이프 감기 (수축튜브 대신)

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

#### 사. 글루건 · 스텝드릴 · 순간접착제

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

연습 체크

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

## 3. 단계별 제작

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

### STEP 1. 부품 검수 · 멀티미터 기초

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

그림 5. 멀티미터 기초 (figures/f05_multimeter.svg)

그림 6. 극성(방향)이 있는 부품 확대도 (figures/f06_polarity.svg)

#### 절차

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

9. ESP32 확인 — 데이터용 USB 케이블(P07)로 PC에 꽂으면 보드의 빨간 전원 LED가 켜지고, 윈도우 장치 관리자 → 포트(COM & LPT) 에 Silicon Labs CP210x … (COMx)가 보여야 합니다. 안 보이면 다른 케이블(충전 전용 케이블은 안 됨)을 쓰거나 CP210x 드라이버를 설치합니다.
10. 체크밸브 방향 확인 — 체크밸브(P31) 몸통의 화살표(FLOW) 방향으로 입으로 살짝 불면 바람이 통하고, 반대로는 막혀야 합니다. 불량은 예비(P31 추가 1개)로 교체합니다. 확인 후 물로 헹굽니다.
11. 튜브 확인 — 내경5 튜브(P29)를 펌프 출수구에 끼워 보아 헐겁지 않은지, 내경4 튜브(P30)가 체크밸브 바브에 끼워지는지 맞춰 봅니다(끝까지 끼우지 않아도 됨).
12. 용기 확인 — 펌프를 970ml 용기 입구로 넣어 바닥에 눕혀 보고, 뚜껑이 끝까지 돌아가 닫히는지 봅니다. 용기 4개를 나란히 세워 높이가 같은지도 봅니다. 펌프 리드가 입구 위로 몇 cm 나오는지 재서 적습니다(약 5cm 이상이면 STEP3의 "뚜껑 위로 3cm 이상"을 채움 — 추정).
13. 무납땜 부품 확인 — PCT-413·412·415의 레버를 올렸다 내려 보고(레버형인지), CG0731 단자를 버튼(P03) 단자에 끼워 봅니다(꽉 끼면 정상). 하네스 스위치(P73)·퓨즈홀더(P74)의 리드 피복에 인쇄된 굵기(AWG)를 적어 둡니다. 안 맞는 것은 4장의 무납땜 줄을 봅니다.

#### 확인 포인트

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

#### 흔한 실수

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

### STEP 2. 브레드보드 단위 테스트

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

그림 7. 벤치 테스트 연결도 (A안) (figures/f07_bench_test.svg)

#### 절차 가. 펌웨어 업로드 (ESP32만 USB에 연결)

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

#### 절차 나. 상태 LED 테스트

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

#### 절차 다. 릴레이 테스트 — A안 (SPEC 기본)

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

#### 절차 라. (A안이 안 될 때만) B안

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

#### 절차 마. 펌프 1개 물 테스트

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

#### 절차 바. (선택) 버튼·부저 테스트

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

#### 확인 포인트

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

#### 흔한 실수

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

### STEP 3. 펌프 모듈 만들기 (뚜껑 · 연장선 · 레버 커넥터 · 다이오드)

목표: 펌프 4개 각각을 "뚜껑 + 펌프 + 70cm 연장선 + 다이오드"가 한 덩어리인 펌프 모듈로 만든다. 이음(레버 커넥터)과 다이오드는 모두 뚜껑 위에 두고 절연테이프로 감싼다.
어디서 · 난이도: 집 (뚜껑 구멍만 드릴 — 구멍 뚫는 날 ①) · ★★☆
준비물: 펌프(P09) 4, 용기(P32, 970ml) 4, AWG20 2심(P19) 약 3m, 1N4007(P10) 4, 3구 레버 커넥터 PCT-413(P75) 8, 절연테이프(P79), 케이블타이(P27), 스트리퍼(P49)·니퍼(P50), 멀티미터(P48), 스텝드릴(P53)·송곳, 글루건, 마스킹테이프·네임펜
소요 시간: 2~2.5시간

그림 8. 용기 뚜껑 가공 상세 (970ml 용기, 무납땜 기준) (figures/f08n_lid_970.svg)

그림 9. 레버 커넥터로 펌프 리드 · 다이오드 잇기 (figures/f09n_lever.svg)

#### 970ml 용기의 돌림 뚜껑

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

#### 절차

1. 연장선 자르기 — AWG20 2심을 70cm × 4가닥으로 자릅니다. 양 끝에 펌프 번호(1~4) 테이프를 붙이고, 한쪽 끝에는 "펌프 쪽", 다른 쪽에는 "박스 쪽"이라고 씁니다. 왜 70cm? 용기 바닥 → 뚜껑 → 선반 구멍 → 박스까지 약 40cm에, 용기를 뒤로 30cm 꺼낼 수 있는 여유를 더한 길이입니다. 실제 배치에서 남으면 묶어 두면 됩니다.
2. 뚜껑 가공(그림 8) — 펌프를 용기 바닥에 눕혀 놓고 뚜껑을 덮어 위치를 봅니다. 뚜껑 윗면의 평평한 부분 안에 Ø7 튜브 구멍(펌프 출수구에 가까운 쪽), 거기서 20mm 떨어진 곳에 Ø5 전선 구멍, 뚜껑 가장자리에서 10mm 안쪽에 Ø3 공기 구멍을 연필로 표시합니다.
  - Ø7·Ø5는 송곳으로 작은 구멍을 낸 뒤 스텝드릴을 천천히 돌려 넓히고, Ø3 공기 구멍은 Ø3 일반 드릴 날로 천천히 뚫습니다(스텝드릴은 4mm부터). 왜? PP 뚜껑은 빨리 돌리면 열로 녹아 구멍이 지저분해집니다.
  - 왜 공기 구멍? 밀폐용기는 액체를 퍼낼수록 안이 진공이 되어 유량이 줄어듭니다. 작은 구멍 하나로 공기가 들어오게 합니다(SPEC §1). Ø3 공기 구멍은 글루건으로 막지 않습니다.
  - 거스러미는 커터칼로 정리합니다. 4개 모두 같은 위치로 가공하고, 뚜껑에도 몸통과 같은 번호를 적습니다.
3. 펌프 리드선 통과 — 펌프의 빨강·검정 리드선을 뚜껑 안쪽에서 바깥쪽으로 Ø5 구멍에 통과시킵니다. 펌프를 바닥에 눕혀 뚜껑을 덮었을 때 리드가 팽팽하지 않게 뚜껑 안쪽에 1~2cm 여유를 남기고, 그 상태에서 뚜껑 위로 최소 3cm 나와야 합니다.
  - (선택 대안) 리드가 3cm보다 짧으면: 레버 커넥터는 방수가 아니므로 뚜껑 안쪽(용기 안)에 둘 수 없습니다. 그 펌프만 학교에서 열풍기를 빌려, 뚜껑 안쪽에서 펌프 리드에 AWG20 짧은 선(빨강·검정 각 약 6cm)을 보유한 솔더 슬리브(P25)로 이어(방수 — 방법은 납땜 기준 가이드 STEP3 절차 5의 1~5) 뚜껑 위로 3cm 이상 빼냅니다. 그 끝을 펌프 리드 대신 아래 절차 4~9대로 PCT-413에 꽂습니다(다이오드 위치는 그대로). 용기를 산 날(2.4)·STEP1에서 잰 리드 길이를 먼저 보고, 짧은 펌프가 있으면 2.4의 대여 문의에 열풍기를 넣습니다.
4. 선 끝 벗기기 — 연장선 펌프 쪽 끝의 빨강·검정을 약 5cm 갈라 각각 피복을 9~10mm, 펌프 리드도 9~10mm 벗깁니다(가는 리드가 헐겁게 물리면 두 배 길이로 벗겨 접어 꼬기 — 2.6 나). 연장선 박스 쪽 끝은 빨강 6~7mm(나중에 릴레이 나사 단자), 검정 10~11mm(나중에 TB2 레버 커넥터)를 벗겨 둡니다.
5. 다이오드 다리 준비 — 1N4007 몸통의 띠(캐소드) 쪽 끝에 빨간 네임펜으로 점을 찍고, 두 다리를 각각 약 12mm만 남기고 니퍼로 자릅니다. 왜? 레버 커넥터에 9~10mm가 들어가고, 다리가 길면 남은 부분이 드러나 다른 금속에 닿을 수 있습니다.
6. 레버 커넥터 2개에 연장선과 다이오드 꽂기(그림 9) — PCT-413 2개를 준비해 하나에 "+", 다른 하나에 "−"를 네임펜으로 씁니다.
  - "+" 커넥터: 연장선 빨강 + 다이오드 띠 쪽(빨간 점) 다리 — 구멍 하나는 비워 둠(펌프 빨강 자리)
  - "−" 커넥터: 연장선 검정 + 다이오드 반대쪽 다리 — 구멍 하나는 비워 둠(펌프 검정 자리)
  - 레버를 내리고 하나씩 당겨 봅니다.
7. 다이오드 방향 확인 (펌프를 꽂기 전에!) — 멀티미터를 다이오드(▶|) 모드로 두고, 연장선 박스 쪽 끝에서 검정 리드 → 빨강 선, 빨강 리드 → 검정 선에 대면 0.5~0.7, 반대로 대면 OL이어야 합니다(다이오드 모드가 없으면 STEP1 절차 3의 저항 모드 판정). 거꾸로 나오면 두 레버를 올려 다이오드를 뒤집어 다시 꽂습니다. 왜 지금? 펌프를 꽂으면 펌프 코일이 다이오드와 나란히 이어져 멀티미터로 방향을 확인할 수 없습니다.
8. 펌프 리드 꽂기 — 펌프 빨강 → "+" 커넥터의 빈 구멍, 펌프 검정 → "−" 커넥터의 빈 구멍. 판매처 안내대로 빨강 = +입니다. 레버를 내리고 당겨 봅니다.
9. 절연·고정 — 두 커넥터와 그 사이의 다이오드를 나란히 붙여 절연테이프로 한 덩어리로 감습니다(2.6 바). 덩어리는 뚜껑 윗면에서 1~2cm 띄워 연장선에 케이블타이로 한 번 묶습니다. 왜? 다이오드 다리가 드러나 있으면 다른 금속에 닿아 단락될 수 있고, 덩어리가 연장선에 묶여 있어야 선을 당겨도 커넥터에 힘이 가지 않습니다. 뚜껑에서 띄우면 뚜껑 위에 흘린 물이 커넥터로 스며들지 않습니다.
  - ⚠ 레버 커넥터는 방수가 아닙니다. 재료를 채울 때는 뚜껑 모듈을 들어 옆에 두고 붓습니다. 커넥터 위로 액체를 붓지 않습니다.
10. 전선 구멍 막기 — 펌프를 바닥에 내려놓고 뚜껑 안쪽 리드에 여유(1~2cm)가 남았는지 다시 본 뒤, 뚜껑 위 Ø5 구멍 둘레를 글루건으로 막습니다(전선이 빠지지 않게 + 물방울 차단). Ø7 튜브 구멍은 STEP8에서 튜브를 끼운 뒤 마무리합니다. Ø3 공기 구멍은 그대로 둡니다.
11. 동작 확인 — 어댑터를 뽑은 상태에서 STEP2의 벤치 연결에서 펌프 1을 빼고, 그 자리에 펌프 모듈의 박스 쪽 끝을 빨강 → 줄 A(NO1로 가는 점퍼가 꽂힌 줄), 검정 → GND 레일로 꽂고(벤치용 다이오드 D1은 빼도 됨 — 모듈에 다이오드가 있음), 펌프를 물컵에 넣습니다. USB → 어댑터 순으로 전원을 넣고 {"cmd":"run","p":1,"ms":2000}. 물이 나오면 성공. 펌프를 바꿀 때마다 어댑터를 뽑고 바꿔 4개 모두 반복합니다.

#### 확인 포인트

- ✔ 다이오드 4개 방향 확인 — 펌프를 꽂기 전에(다이오드 모드: 검정 리드→빨강 선 0.5~0.7 / 모드가 없으면 STEP1 절차 3 판정)
- ✔ 레버 커넥터 8개, 모든 선 당김 테스트 통과, 빨강-빨강·검정-검정
- ✔ 커넥터 덩어리가 절연테이프로 감겨 있고, 뚜껑 윗면에서 1~2cm 위에 연장선과 묶여 있음
- ✔ 뚜껑마다 Ø7·Ø5·Ø3 구멍 3개, 몸통과 같은 번호
- ✔ 펌프 모듈 4개 물 테스트 통과

#### 흔한 실수

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

### STEP 4. 전원부 (DC 단자 · 스위치 · 퓨즈 · 분배 커넥터 · 커패시터)

목표: 어댑터 → J1 → SW1(선 달린 로커 스위치) → F1(인라인 퓨즈 3A) → TB1(+5V 분배) 와 J1(−) → TB2(GND 분배) 를 만들고, 1000µF 커패시터 C1을 TB1–TB2 사이에 단다 (연결표 ②~⑦). 납땜 대신 2구 레버 커넥터 PCT-412 3개로 잇는다.
어디서 · 난이도: 집 (뒤판 G 구멍 2개만 드릴 — 구멍 뚫는 날 ①) · ★★☆
준비물: J1(P12), 하네스 스위치 SW1(P73), 인라인 퓨즈홀더 F1(P74) + 3A 퓨즈(P15), PCT-418(P18) 2개(TB1·TB2), PCT-412(P76) 3개, C1 1000µF(P16), AWG20 빨강·검정(P19), UL1007 검정(P62) — ⑦용, 절연테이프(P79), 접착 마운트(P28) 1 + 케이블타이(P27), 스트리퍼(P49)·니퍼, 멀티미터, 뒤판 G(재단된 판 410×115, Ø12·사각 구멍)
소요 시간: 1.5~2시간

그림 10. 전원부 결선도 (무납땜 — 레버 커넥터) (figures/f10n_power.svg)

#### 납땜 기준과 다른 점

- 스위치 SW1(P73)은 리드선이 공장에서 달려 나온 제품이라 단자에 납땜하지 않습니다. 리드 끝의 작은 커넥터를 잘라 내고 피복을 벗겨 레버 커넥터로 잇습니다.
- 퓨즈 F1(P74)은 판에 끼우는 형이 아니라 선 중간에 매다는 인라인형입니다. 그래서 뒤판 G에 퓨즈 구멍이 없고, 퓨즈홀더는 G 안쪽 면(상판 C를 열면 손이 닿는 곳)에 케이블타이로 고정합니다. 퓨즈를 바꿀 때는 상판 C를 엽니다.
- 회로도의 ③(SW1–F1 사이 짧은 선)은 따로 자르지 않고 SW1 리드와 F1 리드를 레버 커넥터로 바로 잇습니다.
- G 쪽 2구 레버 커넥터 3개는 G1(② + SW-a) · G2(SW-b + F-a, ③ 대신) · G3(F-b + ④) 라고 부릅니다(앞판의 ⓐ~ⓔ와 다른 것). 네임펜으로 몸통에 적어 둡니다.
- G판을 본체에 붙일 때(STEP9) ②·④를 박스에서 빼는 대신, G 쪽 레버 커넥터의 레버만 올려 ②·④를 뺐다가 STEP10에서 다시 꽂습니다.

#### 절차

1. 부품 재기 — 하네스 스위치(P73) 몸통 크기(가로×세로, 보통 약 19×13mm — 추정)와 어댑터(P11) 플러그 머리 지름을 자로 재서 적어 둡니다. 플러그 머리가 12mm보다 크면 G의 어댑터 선 구멍(Ø12)을 그만큼 키웁니다(STEP9 절차 나).
2. 뒤판 G에 구멍 내기 — 재단된 G판에 STEP9 구멍 표의 G 행대로 Ø12(어댑터 선)·사각(SW1) 구멍 2개를 뚫습니다(구멍 뚫는 날 ①). 사각 구멍 맞추는 법과 "뒤(바깥)" 표시는 STEP9 절차 나를 따릅니다.
3. SW1 끼우기 — G의 바깥면("뒤(바깥)"이라고 쓴 면)에서 스위치의 리드선부터 사각 구멍에 넣어 안쪽으로 빼낸 뒤, 몸통을 밀어 "딸깍" 끼웁니다. ON 표시("I")가 위로 오게 합니다.
  - 5mm 판이라 걸쇠가 헐거우면, 절차 14 시험 뒤 G 안쪽에서 몸통 둘레를 글루건으로 한 바퀴 둘러 고정합니다(추정).
4. SW1 리드 정리 — 리드 끝의 커넥터를 니퍼로 자르고, 두 가닥을 G 안쪽에서 약 10cm 남기고 자릅니다. 끝 피복을 9~10mm 벗깁니다. ON/OFF 스위치는 두 리드의 구별이 없으므로 하나에 "SW-a", 다른 하나에 "SW-b" 테이프를 붙입니다.
  - 리드가 가늘면(피복 인쇄 AWG 숫자가 24 이상 — 더 가는 선) 심선이 끊어지지 않게 작은 구멍(0.5~0.65)부터 해 봅니다.
5. F1 퓨즈홀더 준비 — 인라인 퓨즈홀더를 돌려 열어 3A 퓨즈(P15)를 넣고 닫습니다. 양쪽 리드를 각각 약 10cm로 자르고 끝 피복을 9~10mm 벗깁니다. 한쪽에 "F-a", 다른 쪽에 "F-b" 테이프.
6. ③ 대신 — SW1과 F1 바로 잇기 — PCT-412 하나(G2)에 SW-b + F-a를 꽂고 레버를 내린 뒤 당겨 봅니다(연결표 ③). 왜 이 순서(스위치 → 퓨즈)? 스위치를 끄면 퓨즈 이후 전체가 꺼지고, 퓨즈는 스위치 뒤의 모든 배선을 보호합니다.
7. ②·④ 만들기 — 빨강 AWG20 ② 약 25cm, ④ 약 30cm를 자르고 양 끝에 번호 테이프를 붙입니다.
  - ② 한쪽 끝(9~10mm) + SW-a → PCT-412 G1
  - ④ 한쪽 끝(9~10mm) + F-b → PCT-412 G3
  - ②의 다른 끝은 6~7mm(J1 나사 단자), ④의 다른 끝은 10~11mm(TB1 레버 커넥터)로 벗깁니다.
8. G 쪽 정리 — G 안쪽 면 위쪽(상판 C를 열면 손이 닿는 곳)에 접착 마운트(P28)를 붙이고, 퓨즈홀더와 PCT-412 3개를 케이블타이로 함께 묶습니다. 레버가 위를 보게 묶으면 나중에 ②·④를 빼고 꽂기 쉽습니다.
  - 이제 G판은 ②·④로 전원부에 매달린 채 STEP9까지 함께 다닙니다(그림 10의 "뒤판 G" 점선 상자).
9. J1 연결 — J1(P12) 나사 단자를 일자드라이버로 풉니다. ② 빨강 → J1 + 에 넣고 조입니다. J1 − 에는 ⑤ 검정 AWG20(약 15cm) 과 ⑦ 검정 UL1007(P62, 약 20cm, 나중에 ESP32 GND로 감) 두 가닥을 함께 꼬아 넣고 조인 뒤 당겨 봅니다. STEP1에서 표시한 실제 극성을 따릅니다. 왜 J1 −에서 바로 ESP32로? 펌프의 큰 전류가 흐르는 GND(TB2)와 ESP32의 GND를 J1 한 점에서 나눠, 펌프가 켜질 때 생기는 잡음이 ESP32로 덜 들어가게 합니다(SPEC §1 별형 접지, 회로도 ⑤·⑦). 릴레이 GND는 STEP5에서 ESP32 GND에 연결합니다(⑯). 결국 모든 GND는 하나로 이어집니다.
10. TB1 (+5V) — ④ 끝 → TB1 8번 구멍.
11. TB2 (GND) — ⑤ 끝 → TB2 1번 구멍. (TB3는 STEP5에서 3V3 분배용으로 씁니다.)
12. C1 커패시터(그림 6 ②) — 두 다리를 각각 절연테이프로 감아 끝 10mm만 드러내고, 긴 다리(+) → TB1 1번, 띠 쪽 짧은 다리(−) → TB2 8번 에 꽂습니다(⑥). TB2를 TB1 아래에 반대 방향으로 놓으면 TB1-1과 TB2-8이 위아래로 마주 보아 다리를 바로 꽂을 수 있습니다(그림 10). 왜? 펌프가 켜지는 순간 큰 전류가 흘러 5V가 순간적으로 떨어지는데, 커패시터가 작은 물탱크처럼 전기를 보충해 ESP32가 재부팅(브라운아웃)되는 것을 막습니다.
13. 단락 검사(그림 5 ④) — 어댑터를 뽑은 상태에서 멀티미터 저항 모드로 TB1–TB2 사이를 잽니다(TB1·TB2의 빈 구멍에 10~11mm 벗긴 자투리 "시험 선"을 하나씩 꽂아 그 끝에 리드를 대면 쉬움 — 두 시험 선 끝이 서로 닿지 않게 떨어뜨려 놓고, 재지 않을 때는 끝을 테이프로 감아 둠. TB1의 시험 선은 STEP5에서 TB1 구멍을 다 쓰기 전에 뽑고, TB2의 시험 선은 예비 구멍 6번에 남겨도 됨). 숫자가 점점 커져 OL이 되면 정상(커패시터가 충전되는 중)입니다. 0Ω 근처에서 그대로면 어딘가 단락입니다.
14. 전압 확인 — SW1을 OFF로 두고 어댑터를 꽂습니다. TB1–TB2(시험 선 끝): 0V → SW1 ON: 4.9~5.25V → SW1 OFF, 어댑터 뽑기. 퓨즈 시험: 퓨즈홀더를 돌려 열어 퓨즈를 뺌 → 어댑터를 꽂고 SW1 ON → 0V면 정상 → SW1 OFF, 어댑터 뽑기 → 퓨즈를 다시 넣고 홀더를 닫음. 예비 퓨즈 2개는 예비 부품 상자(5장)에 넣어 둡니다.

#### 확인 포인트

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

#### 흔한 실수

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

### STEP 5. ESP32 · 릴레이 영구 배선 (연결표)

목표: 전장 박스(P35) 안에 ESP32+확장보드, 릴레이, 분배 커넥터를 고정하고, 아래 연결표 순서 그대로(⑦~⑳) 영구 배선한다. STEP2에서 정한 A안/B안을 따른다.
어디서 · 난이도: 집 (박스·속판 구멍만 드릴 — 구멍 뚫는 날 ①) · ★★★
준비물: 전장 박스(P35), ESP32(P01)+확장보드(P02), 릴레이(P08), STEP4 전원부, M3 서포트(P39) 4 + M3×6(P40) 8, 점퍼선 F/F(P20)·M/F(P21), AWG20(P19), UL1007 빨강(P63, ⑧)·노랑(P24, ⑩을 UL1007로 할 때), 레버 커넥터 1개 더(TB3, 3V3용), 100µF(P17, 선택), 폼 양면테이프(P71), 접착 마운트(P28), 케이블타이(P27), 스트리퍼(P49), 스텝드릴(박스 구멍 — 구멍 뚫는 날 ①), 마스킹테이프
소요 시간: 3~4시간

그림 11. 전장 박스 배치 예시 (figures/f11_ebox.svg)

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

#### 절차 가. 박스 준비

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

#### 절차 나. 배선 요령

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

#### 연결표 (①~㊱ — 회로도.html ③ 연결표와 같은 번호)

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

분배 커넥터 구멍 배정 (그림 10, 회로도와 같음)

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

#### 절차 다. 배선 후 점검 (전원 없이)

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

#### 확인 포인트

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

#### 흔한 실수

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

### STEP 6. 전원 넣기 전 점검 · 첫 전원 투입

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

#### 전원 넣기 전 점검표 (어댑터 뽑은 상태)

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

#### 첫 전원 투입 절차

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

#### 확인 포인트

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

#### 흔한 실수

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

### STEP 7. 펌웨어 업로드 · 앱 블루투스 연결

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

#### 절차 가. 조립 상태에서 펌웨어 올리기 (나중에 펌웨어를 고칠 때마다 이 순서)

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

#### 절차 나. 테스트 앱으로 블루투스 확인 (앱 없이)

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

#### 절차 다. 바텐더 앱 연결

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

#### 확인 포인트

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

#### 흔한 실수

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

### STEP 8. 배관 (튜브 · 체크밸브 · 누수 테스트)

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

그림 12. 액체 경로도 (figures/f12_liquid_path.svg)

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

#### 튜브 재단표 (펌프 1개당, 4세트)

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

튜브는 가위나 니퍼 대신 커터칼로 직각으로 자릅니다. 비스듬히 잘리면 노즐에서 물줄기가 옆으로 휩니다.

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

#### 절차

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

#### 확인 포인트

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

#### 흔한 실수

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

### STEP 9. 외형 제작 (재단 · 구멍 · 앞판 · 조립 · 방수)

목표: 포맥스 5T로 본체를 만든다(W420 × D260 × H380). 구멍을 모두 뚫은 뒤 조립하고, 액체가 닿는 이음새를 방수 처리한다.
어디서 · 난이도: 집 (판 구멍만 드릴 — 구멍 뚫는 날 ②) · ★★★
준비물: 포맥스(P34) 3장 또는 재단된 판 A~L·N, 출력 브래킷 01 12(+예비 2), 출력 그로밋 04 2, 출력 베젤 03 1 + 라벨 스티커 2장, 출력 상판 모서리 캡 06 4, 출력 노즐 블록 02 1(확인만, 붙이는 것은 STEP10), M3×10 볼트(P37)·너트(P38) 24쌍(+예비), 순간접착제(P42), 글루건+스틱(P43), 폼 양면테이프(P71), 네오디뮴 자석(P45) 2 · 접착식 철판(P80) 2(상판 C도 자석으로 붙이면 P69로 자석·철판 1팩씩 더, 선택), 고무발(P41) 4, 버튼(P03), LED(P05)+R1(P06), 부저(P04, 선택), 앞판 선: UL1007 노랑(P24) 40cm × 4 + 검정(P62) 40cm 1가닥, PCT-412(P76) 5, PCT-415(P77) 1, CG0731(P78) 2, 듀폰 F/F(P20) 3가닥, 절연테이프(P79), 드릴·스텝드릴, 커터칼(대)·쇠자 60cm·커팅매트·직각자, 연필, 사포
소요 시간: 6~8시간 (재단 주문 시 3~4시간) + 접착제 굳는 시간

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

#### 절차 가. 판 준비

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

#### 절차 나. 구멍 가공 (조립 전에 모두 뚫기)

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

#### 절차 다. 조립 (그림 14 순서)

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

4. ① 바닥판 A + 측판 B 좌·우 — B를 A 위 양끝(x 0~5, 415~420)에 세워 붙이고, 안쪽 모서리에 브래킷을 한쪽에 2개씩(y 45, 90 위치 — 용기가 놓이지 않는 앞쪽 빈 공간, 바닥 아래 볼트 머리가 앞쪽 고무발과 겹치지 않는 자리) 볼트로 고정합니다. 직각자로 A와 B가 90°인지 확인. 왜 앞쪽에? 용기 칸(y 110~255) 바닥에 브래킷이 있으면 용기가 기울어집니다.
5. ② 칸막이 E + 걸림턱 L + 가이드 N — E를 y 105~110 위치에 세워 A·B에 붙입니다(구멍이 위쪽, 가운데). L(410×15)은 A 위 뒤쪽 끝(y 250~255)에 세워서 붙입니다(뒤 덮개가 안으로 밀려 들어오지 않게). N 3개는 용기 사이(x 약 107, 210, 312)에 세워 붙여 용기가 미끄러지지 않게 합니다. 970ml 용기는 폭이 80mm라 칸(약 98mm) 안에서 좌우로 18mm쯤 움직이므로 N을 붙이는 것을 권장합니다.
6. ③ 앞판 하부 I + 잔 칸 옆벽 J + 받침대 K — I 좌·우를 앞면(y 0~5)에, J 좌·우를 x 130~135 / 285~290에 세워 E와 I에 붙입니다(잔 칸 폭 150). K 2개를 측판 안쪽 용기 칸 구간(y 110~255) 높이 z 235~255에 붙입니다(선반 받침).
7. ④ 선반 D — 출력 그로밋 04 2개를 D의 Ø20 구멍에 끼운 뒤(D가 따로 있는 지금이 양쪽에서 눌러 넣기 쉬움), D를 I·J·E·K 위에 얹어 붙입니다(z 255~260). 선반 위쪽(전장부)에서 D와 B를 브래킷 2개씩(총 4개)으로 고정합니다. 브래킷은 용기 칸 위 구간(y 150·220) 의 선반 위에 놓고, 볼트를 D 아래에서 위로(뒤쪽 개구부 = H 자리, 아직 열려 있음으로 손을 넣어) 넣어 브래킷 위쪽 홈의 너트에 조입니다. 너트가 위에 있어 손이 쉽게 닿습니다. 왜 뒤쪽에? D의 앞쪽(y 105 이하) 아래는 이미 붙인 I·J·E·B·A로 막힌 빈 공간이라 손이 닿지 않습니다. 노즐 블록: 출력 노즐 블록 02는 만들 필요가 없고, 선반에는 STEP10에서 튜브를 끼운 뒤 붙입니다. 왜 나중에? 선반에 먼저 붙이면 좁은 틈(20mm)에서 튜브를 구멍에 넣기가 매우 어렵습니다.
8. ⑤ 앞판 상부 F + 뒤판 상부 G — F에 부품을 달고 선을 이은 뒤(그림 14-1) F를 붙입니다. F를 붙이기 전에, 책상 위에서 합니다.
  그림 14-1. 앞판 F 안쪽 배선 (무납땜 기준) (figures/f14n_front.svg)
  앞판 결선 (납땜 없이)
  1. 버튼 — F의 Ø16 구멍에 앞에서 버튼(P03)을 끼우고 뒤에서 너트를 조입니다. 멀티미터 도통 모드로 누를 때만 "삐" 나는 두 단자를 찾아 "1"·"2"를 적습니다(단자가 3개 이상이면 나머지는 쓰지 않음). CG0731 단자 케이블 2개를 약 10cm로 잘라(단자 쪽을 남김) 자른 끝을 9~10mm 벗긴 뒤, 단자를 버튼 단자 1·2에 끝까지 꽂고, 단자 둘레를 절연테이프로 감습니다. 단자 1 쪽 케이블은 양 끝에 ㉝ 테이프를 붙입니다(검정 선이지만 GND가 아니라 신호선).
  2. LED — 꽂기 전에 긴 다리(+) 쪽 몸통에 빨간 점을 찍습니다(꽂고 나면 다리 길이로 구분하기 어려움). LED를 Ø5 구멍에 앞에서 밀어 넣고 뒤에서 글루건으로 고정합니다. 다리는 짧게 자르지 않습니다 — LED 뒤로 약 2cm만 나오므로(추정), 다리를 구부려 바로 옆의 ⓐ와 바로 아래의 GND 모음(PCT-415)에 닿게 합니다(그림 14-1).
  3. R1 220Ω — R1 두 다리를 각각 약 12mm로 자릅니다. LED 바로 옆(긴 다리가 닿는 1cm 안)에 놓은 PCT-412 ⓐ에 LED 긴 다리 + R1 한쪽 다리, PCT-412 ⓑ에 R1 다른 다리 + 노랑 ㉟를 꽂습니다. LED 다리를 옆으로 눕혀 커넥터가 F 안쪽 면에 납작하게 붙게 하고, R1과 두 커넥터 둘레를 절연테이프로 감습니다. 왜 납작하게? F와 전장 박스 사이가 약 35mm뿐이라, 튀어나오면 박스에 눌려 레버가 열리거나 선이 빠집니다.
  4. 부저(선택) — 부저 모듈을 F 안쪽, LED·버튼에서 몇 cm 떨어진 빈 곳(그림 14-1, 듀폰선이 닿는 거리)에 폼 양면테이프(P71)로 붙입니다. 듀폰 F/F 3가닥을 부저의 VCC·I/O·GND 핀에 꽂고(모듈 인쇄 이름 확인), 반대쪽 끝 소켓을 잘라 피복을 9~10mm 벗겨 꼽니다(헐거우면 2.6 나의 접기). VCC 점퍼 + 노랑 ㉙ → PCT-412 ⓒ, I/O 점퍼 + 노랑 ㉚ → PCT-412 ⓓ.
    - ⚠ ㉙는 3V3 전원선입니다. 피복을 9~10mm보다 길게 벗기지 말고, ⓒ 커넥터는 다른 금속(LED·R1 다리, 버튼 단자, GND 모음)에서 떨어뜨려 붙입니다. 닿으면 3V3이 단락됩니다.
  5. 버튼 신호 — CG0731(단자 1, ㉝ 테이프) + 노랑 ㉝ → PCT-412 ⓔ.
  6. GND 모음(PCT-415) — 다섯 구멍 중 넷에 검정 ㉛(박스로 가는 40cm), CG0731(버튼 단자 2) ㉞, LED 짧은 다리 ㊱, 부저 GND 점퍼 ㉜를 꽂습니다(1구멍은 비워 둠). PCT-415는 LED 바로 아래(짧은 다리가 닿는 1cm 안)에 폼 양면테이프로 붙입니다. 다른 선(㉛·㉞·㉜)은 길이가 넉넉하니 LED 다리에 맞춰 자리를 정합니다.
  7. 점검(전원 없이) — 멀티미터 도통 모드로 노랑 ㉝ 끝 ↔ 검정 ㉛ 끝을 대고 버튼을 누르면 "삐", 떼면 조용해야 합니다. 노랑 ㉙ ↔ 검정 ㉛, 노랑 ㉟ ↔ 검정 ㉛은 "삐" 소리가 계속 나면 안 됩니다(단락).
  8. 노랑 4가닥(㉙·㉚·㉝·㉟)과 검정 ㉛의 박스 쪽 끝은 STEP10에서 박스에 넣습니다. 노랑은 모두 같은 색이므로 양 끝 번호 테이프를 다시 확인합니다.

그다음 F를 y 0~5, z 255~370에 붙입니다.

  - 앞면 베젤(출력 03): F를 붙인 뒤 베젤을 버튼·LED 위로 씌워 폼 양면테이프(P71) 로 F 바깥면에 붙입니다(순간접착제는 쓰지 않음 — LED 테가 베젤 뒤 홈에 물려 있어, LED를 바꿀 때(4장 '상태 LED가 안 켜짐')는 베젤을 떼야 함). 베젤의 Ø18.8 구멍으로 버튼 머리가 지나가므로 버튼은 F 판에만 고정되고(베젤 두께와 상관없이 너트가 물림), LED 테는 베젤 뒤쪽 홈에 들어갑니다. 라벨 홈에 "정지/시작"·"상태" 스티커를 붙입니다.
  - G 붙이기: G에는 STEP4에서 SW1·퓨즈홀더 F1·PCT-412 3개가 달려 있습니다. 먼저 어댑터를 콘센트에서 뽑고, G 쪽 G1·G3에서 ②·④가 꽂힌 쪽 레버만 올려 ②·④를 빼냅니다(끝에 ②·④ 번호 테이프가 있는지 확인, 드러난 심선은 테이프로 감쌈). ②·④는 박스 쪽(J1 +, TB1-8)에 그대로 남습니다. 어댑터 플러그도 J1에서 뽑아 두고, STEP10 절차 2를 마칠 때까지 어댑터를 꽂지 않습니다(J1 +에 남은 ② 끝은 퓨즈 앞이라, 어댑터가 꽂히면 5V가 살아 있음). 그다음 G를 바깥면("뒤(바깥)")이 밖을 보게 y 255~260에 붙입니다. ②·④는 STEP10에서 다시 꽂고, G의 Ø12 그로밋 05도 STEP10에서 끼웁니다.
9. ⑥ 상판 C(탈착) — C는 접착하지 않습니다(전장부 정비용).
  1. 너트 미리 붙이기(캡티브 너트) — 출력 브래킷 01 4개를 B에 달기 전에, 각 브래킷의 가로 다리(C가 얹힐 쪽) 육각 홈에 M3 너트를 넣고(조립하면 홈이 아래를 봄) 홈 테두리에 순간접착제를 조금 바릅니다. 식용유나 바셀린을 살짝 묻힌 M3×10 볼트를 홈 반대쪽 평평한 면에서 너트에 끝까지 돌려 넣은 채 굳히고(약 10분), 굳으면 볼트만 빼 둡니다(기름 때문에 접착제가 볼트에 붙지 않고, 나사산이 막히지 않음). 왜? C를 얹으면 전장부(선반 위 칸)가 B·F·G·D·C로 사방이 막혀 손이 들어가지 않으므로, 브래킷 아래 너트를 손으로 잡을 수 없습니다. 너트를 붙여 두면 처음 조일 때도, 정비 때(STEP7 ⑧ 분리·USB 업로드) C를 풀 때도 위에서 볼트만 돌리면 되고, 빠진 금속 너트가 릴레이 나사 단자·레버 커넥터 위로 떨어져 단락될 일도 없습니다.
  2. 브래킷을 측판 B 안쪽 맨 위에 좌우 2개씩, y 60·200(상판 모서리 캡과 겹치지 않게)에 볼트·너트로 답니다(가로 다리 윗면 = B 윗면 높이, 붙인 너트는 아래쪽). 이 볼트는 B 바깥에서 넣어 세로 다리 홈의 너트에 조입니다.
  3. C의 구멍 4개(구멍 표 C 위치 — 좌·우 끝에서 21, 앞쪽 끝에서 60·200)는 구멍 뚫는 날 ②에 미리 뚫어 두었습니다. C를 얹어 브래킷 홈의 너트와 맞는지 보고, 1~2mm 어긋나면 C를 내려서 줄로 구멍을 넓힙니다(본체 위에서 드릴 금지).
  4. C를 얹고 위에서 M3×10 볼트 4개만 돌려 고정합니다.
  5. 상판 모서리 캡(출력 06) — C를 얹은 상태에서 캡 4개를 C 네 모서리에 맞춰 보고, 순간접착제로 C에만 붙입니다(측판 B·앞판 F·뒤판 G에는 붙이지 않음 — 붙이면 상판을 열 수 없음). 접착제가 B·F·G에 묻지 않게 네 모서리 둘레의 B·F·G 윗부분을 마스킹테이프로 가린 뒤 붙입니다. 굳으면 볼트 4개를 풀고 C를 들어 걸림 없이 열리는지 확인합니다.
  - 대안(선택): 뒤 덮개 H처럼 자석(P45)과 철판(P80)으로 C를 붙여도 됩니다. 이때는 P69(선택) 로 자석·철판을 1팩씩 더 삽니다(BOM 3장 '선택' 분류, 다이소).
10. 뒤 덮개 H — 뒤쪽 개구부(410×255)에 끼워 보고(1mm 여유), 걸림턱 L 뒷면 양쪽(왼쪽·오른쪽 끝에서 약 80mm)에 네오디뮴 자석(P45) 2개를 순간접착제로 붙이고, H 안쪽의 마주 보는 자리에 접착식 철판(P80) 2개를 붙입니다(철판은 붙인 뒤 24시간 지나서 씀).
11. 고무발 — 바닥판 A 아래 네 모서리(각 모서리에서 20mm 안쪽)에 고무발(P41) 4개를 붙입니다.

#### 절차 라. 방수 처리

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

#### 확인 포인트

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

#### 흔한 실수

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

### STEP 10. 최종 조립 · 배선 정리

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

#### 절차

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

#### 액체·전장부 격리 점검

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

#### 확인 포인트

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

#### 흔한 실수

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

### STEP 11. 캘리브레이션 (유량 맞추기)

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

#### 왜 꼭 해야 하나요?

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

#### 절차 (앱 캘리브레이션 마법사)

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

#### 액체별 차이 (참고, 추정값)

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

#### 다시 해야 할 때

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

#### 120초 제한 주의 (SPEC v2.1)

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

#### 확인 포인트

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

#### 흔한 실수

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

### STEP 12. 시운전 · 세척 · 보관

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

#### 절차 가. 시운전 (물로)

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

#### 절차 나. 세척 (매번 사용 후)

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

#### 절차 다. 정기 세척 (설탕 음료를 쓴 날, 일주일에 한 번)

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

#### 절차 라. 보관

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

#### 확인 포인트

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

#### 흔한 실수

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

## 4. 문제 해결 표

증상 | 가능한 원인 | 조치
앱에서 기기가 검색되지 않음 | 전원 꺼짐 / ⑧ 빠짐 / 다른 폰이 연결 중 / 권한 거부 / 웹앱을 지원하지 않는 브라우저 | SW1·어댑터 확인, ⑧ 재연결, 다른 폰 연결 해제, 앱 권한(근처 기기·위치) 허용, EN 버튼으로 재시작, 휴대폰 블루투스 껐다 켜기. 웹앱은 Chrome·Edge + https 주소에서만 블루투스가 됨(아이폰 불가) — 안 되면 APK 사용
연결은 되는데 "기기 정보(info)를 받지 못했어요" | 구버전(Wi-Fi) 펌웨어 | STEP7 절차 가로 v2 펌웨어 업로드
레시피 화면에 늘 "오프라인 추천"이 표시됨 | AI 키 미등록 / AI 추천 방식이 "오프라인" / 키 오류·사용량 한도·크레딧 소진 / 인터넷 끊김·응답 지연(25초) | 레시피 화면 위 안내에서 이유 확인 → 앱 설정 → AI 고르기에서 고른 AI의 API 키 칸 [키 확인](성공 / 키가 올바르지 않음 / 권한 없음 / 사용량 한도·크레딧 소진 / 인터넷 연결 없음 — 5장 전날 점검, ../../app/README.md 5장). 시연은 오프라인 추천으로도 진행 가능
펌프가 켜질 때 ESP32가 재부팅(LED가 다시 천천히 깜빡) | 전압 강하(브라운아웃) / 펌프 다이오드 방향 반대(켜는 순간 단락) | C1 극성·연결 확인, 다이오드 띠 방향 확인(띠 = 빨강), 전원선을 AWG20으로 짧게, 순차 모드 사용, 필요하면 C2(100µF) 추가. 시리얼에 리셋 원인: 브라운아웃이 보이면 확정
릴레이가 딸깍하지 않음 | JD-VCC(5V) 미연결 / GND 미연결 / 핀 번호 틀림 / A안 입력 전류 부족 / B안인데 ⑨를 VCC 핀으로 옮기지 않음(캡만 끼움) | ⑨(A안: JD-VCC 핀 / B안: 입력 헤더 VCC 핀)·⑯(릴레이 GND)·⑪(VCC) 확인, run 명령으로 채널별 확인, A안이 약하면 B안(STEP2 절차 라)
릴레이가 꺼지지 않음(계속 켜짐) | B안인데 ⑪(3V3)이 연결됨 / A안인데 점퍼가 꽂힘 / IN 선 빠짐 | 점퍼·VCC 연결을 STEP2 결정대로, {"cmd":"stop"}으로도 안 꺼지면 배선 문제
전원을 켜자마자 펌프가 돈다 | 펌프가 NC 단자에 연결 | 펌프 빨강을 NO로 옮김
펌프를 켜면 ESP32가 재부팅되거나 어댑터가 꺼짐(또는 퓨즈가 끊어짐) | 다이오드 방향 반대 / 펌프 선 단락 | 해당 펌프의 다이오드 띠가 빨강 쪽인지 확인, 이음부 피복 확인. 퓨즈가 멀쩡해도 다이오드가 맞다는 뜻이 아님(4A 어댑터는 퓨즈보다 먼저 스스로 끊음). 감아 둔 절연테이프가 녹았거나 변색·냄새가 나면 어댑터를 뽑고 테이프를 풀어 다이오드·레버 커넥터를 교체. 퓨즈가 끊어졌으면 원인을 고친 뒤 3A로 교체
릴레이는 딸깍하는데 펌프가 안 돔 | COM에 5V 없음 / NO 선 빠짐 / 펌프 이음 불량 | TB1→COM(⑰~⑳) 확인, COM–GND 5V 측정, 펌프 선 도통 확인
펌프는 도는데 액체가 안 나옴 | 체크밸브 거꾸로 / 튜브 공기 / 액면 너무 낮음 / 튜브 꺾임 | 화살표 방향 확인, 프라이밍, 액체 보충(최소 30mm), 꺾인 곳 펴기
양이 레시피보다 훨씬 적음 | 캘리브레이션 안 함(기본 20 ml/초 — 앱에 "캘리브레이션 전" 배너) / 액면 낮음 / 공기 구멍 막힘 | STEP11 캘리브레이션, 용기 보충, 뚜껑 Ø3 공기 구멍 확인
"캘리브레이션 전" 배너가 계속 보임 | 저장 안 된 펌프가 있음(calSet 0) | {"cmd":"getcal"}로 0인 펌프 확인 → STEP11로 저장
양이 들쭉날쭉 | 탄산 거품 / 액면 변화 / 튜브 속 공기 | 탄산은 차갑게, 절반 액면에서 재캘리브레이션, 제조 전 프라이밍
유량이 3 ml/초보다 훨씬 작음 | 체크밸브 유로(Ø2mm) 저항 / 꺾임 / 펄프 막힘 | 꺾임·막힘 해결, 그래도 느리면 체크밸브 제거 시험(노즐 높이 조건은 유지), 동시 모드 사용
LIMIT 오류 | 한 재료 300ml 초과 / 총 500ml 초과 / 한 펌프 120초 초과(유량이 매우 느릴 때) / run 60초 초과 | 잔 용량 줄이기, 비율 조정, 유량이 너무 낮으면 원인 해결
BUSY 오류 | 이미 제조 중 | 끝날 때까지 기다리거나 비상정지 후 다시
제조가 끝난 뒤에도 노즐에서 계속 똑똑 떨어짐 | 체크밸브 불량·당분 고착 / 노즐이 액면보다 낮음 | 세척 또는 교체, 노즐 튜브 끝 높이 220mm·액면 ≤ 160mm 확인
펌프가 멈췄는데 액체가 계속 흐름 | 사이펀(노즐이 액면보다 낮음) | 노즐을 높이거나 용기를 덜 채움. 체크밸브 방향 확인
이음부에서 샘 | 케이블타이 느슨 / 겹침 부족 / 단면 비뚤어짐 | 케이블타이 추가, 1.5cm 이상 겹침, 튜브 끝을 직각으로 다시 자르기
앱 "펌프 1"인데 다른 펌프가 돎 | GPIO 핀 배선 뒤바뀜 / 노즐·용기 번호 혼동 | 연결표 ⑫~⑮ 재확인(26·27·32·33), 번호 라벨 정리
부저가 계속 울림 | ONE005가 아닌, LOW에 울리는 부저 모듈을 씀(ONE005는 HIGH = 울림) / I/O·VCC 핀을 바꿔 꽂음 | 모듈 인쇄대로 다시 꽂기, 다른 모듈이면 config.h BUZZER_ON_LEVEL 0 후 재업로드
업로드 실패 Failed to connect | BOOT 버튼 / 케이블 / 포트 점유 | Connecting... 때 BOOT 누르기, 데이터 케이블, 시리얼 모니터 닫기, Upload Speed 115200
시리얼 모니터 글자가 깨짐 | 속도 다름 | 115200
버튼을 눌러도 반응 없음 | ㉝·㉞·㉛ 연결 / 버튼 단자 잘못 선택 | 도통 모드로 버튼 누를 때만 "삐" 나는 단자 2개를 찾아 연결
상태 LED가 안 켜짐 | LED 방향 / R1 빠짐 / ㉟·㊱·㉛ / 외부 LED를 안 담 | 어댑터를 뽑고 LED 두 다리를 레버 커넥터에서 빼 서로 바꿔 꽂기(긴 다리 = ⓐ), 연결 확인. 보드에는 GPIO2 LED가 없어 외부 LED가 필수
용기를 꺼낼 때 튜브가 빠짐 | 여유 부족 | 용기 칸 안에 튜브·전선 30cm 여유 확보
뚜껑을 닫으면 전선·튜브가 꼬임 | 뚜껑을 돌려 닫음(돌림 뚜껑) | 뚜껑을 잡고 용기 몸통을 돌려 여닫기
펌프·LED가 됐다 안 됐다 함, 선이 쉽게 빠짐 | 레버 커넥터: 피복 길이 틀림 / 레버를 덜 내림 / 가는 선을 그냥 넣음 / 한 구멍에 두 가닥 | 어댑터를 뽑고 레버를 올려 선을 뺀 뒤 9~10mm(PCT-418은 10~11mm) 다시 벗겨 꼬고(가는 선은 두 배 길이로 벗겨 반으로 접어 — 2.6 나 6) 끝까지 넣고 레버를 내린 뒤 당김 테스트
SW1을 켜도 전원이 안 들어옴 | ②·④를 G1·G3에 다시 꽂지 않음 / 퓨즈 빠짐·끊어짐 / G2(SW-b–F-a) 빠짐 | STEP10 절차 2 확인 → 어댑터를 뽑고 상판 C를 열어 퓨즈홀더를 돌려 열고 퓨즈를 멀티미터 도통 모드로 확인
퓨즈를 바꿔야 함 | 단락 뒤 끊어짐 | 원인부터 찾음(다이오드 방향·선 닿음). 어댑터를 뽑고 → 상판 C를 열고 → G 안쪽 인라인 퓨즈홀더를 돌려 열어 3A 예비 퓨즈로 교체
하네스 스위치(SW1)가 G에서 빠짐 | 5mm 판이라 걸쇠가 약함 | 다시 끼우고 G 안쪽에서 몸통 둘레를 글루건으로 고정
P73·P74 리드가 가늘다(피복 인쇄 AWG 숫자 24 이상) | 리드가 얇은 제품 | 이 선에는 기기 전체 전류(보통 1A 안팎, 펌프를 동시에 돌리면 더 큼 — 추정)가 흐름. 리드를 G 안쪽에서 약 5cm만 남기고 자르고, ②·④를 그만큼 길게 해 가는 구간을 짧게(추가 부품 없음). 쓰는 중에 리드가 뜨거워지면 바로 끄고 판매처 규격 확인
CG0731 단자가 버튼에 안 맞음 | 버튼 단자가 2.8mm 탭이 아님 | 케이블 끝을 벗겨 버튼 단자 구멍에 감아 꼬고 절연테이프로 감음. 그래도 안 되면 학교에서 그 2곳만 납땜(납땜 기준 가이드 STEP9)
받은 PCT-41x가 레버형이 아님 | 다른 모델이 옴 | 판매처에 교환을 요청하거나 같은 칩센 PCT-41x 레버형으로 다시 주문(BOM P75~P77 상품 번호)
뚜껑 위 레버 커넥터가 젖음 | 재료를 채울 때 튐 / 덩어리가 뚜껑에 닿아 있음 | 어댑터를 뽑고 레버를 열어 말린 뒤 다시 꽂음. 덩어리를 뚜껑에서 1~2cm 띄워 다시 묶고, 재료는 뚜껑 모듈을 옆에 두고 채움

## 5. 시연(발표) 체크리스트

기말 시연(발표)과 졸업작품 전시에 씁니다. 날짜는 학과 공지로 확인 필요합니다.

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

### 전날

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

### 당일 (설치)

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

### 시연 중

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

### 끝난 뒤

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

## 6. 개선 아이디어 (졸업논문 · 특허 · 후속 개선)

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

## 부록 A. 핀맵 요약 (SPEC §1)

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

## 부록 B. 재단표 (parts_research.md 5.2와 동일, W420 기준)

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

## 부록 C. 캘리브레이션 기록표

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

## 부록 D. 3D 프린팅 부품

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

그림 16. 3D 프린팅 부품 7종

그림 16. 3D 프린팅 부품 7종 (figures/f16_print_parts.png)

그림 17. 3D 프린팅 부품 위치

그림 17. 3D 프린팅 부품 위치 (figures/f17_print_layout.png)

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

받은 뒤 확인

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

#### 출력 부품이 깨지거나 맞지 않을 때 (대안)

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

## 부록 E. 용어 사전

처음 보는 낱말이 나오면 여기서 찾으세요. (가나다순이 아니라 처음 나오는 순서에 가깝게 묶었습니다.)

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
