paperji/smart-bartender/hardware/guide/조립가이드.html

체크 초기화인쇄 / PDF 저장 (A4)

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

팀 홍당무 · 안양대학교 정보전기전자공학과 캡스톤디자인Ⅱ (2026/2학기) · 작성 2026-11-06 · SPEC v2.1 반영 · 앱 v3.0 반영 2026-11-07 · 3D 프린팅 부품 반영 2026-11-10
최신판(2026-11-10): 제작가이드_납땜기준.md · 제작가이드_무납땜기준.md — 970ml 용기·주문한 3D 출력 부품·최신 BOM 기준. 이 문서는 예전 판(출력 부품이 없을 때의 대안 방법 참고용)입니다.
목표: 2학기 졸업작품 시제품 · 기말 시연(발표) · 졸업논문·특허용 실험 데이터
앱 화면 이름: "AI 스마트 바텐더" · 하드웨어 v2

기준 문서 (이 가이드와 숫자가 다르면 아래 문서가 우선입니다)

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

## 이 가이드 읽는 법

- 부품 이름 뒤의 P번호(예: 수중펌프 P09)는 BOM 번호와 같습니다. 부품 상자에도 P번호를 적어 두면 찾기 쉽습니다.
- 전선 번호 ①~㊱은 회로도 산출물 ../circuit/회로도.html의 "③ 연결표"와 ../circuit/wiring.svg(배선도)의 동그라미 번호와 같습니다. STEP5 연결표에 같은 번호로 옮겨 적었습니다. 전선 양 끝에 마스킹테이프로 번호를 붙이세요.
- 회로 기호(U1, K1~K4 = 릴레이 채널 1~4, M1~M4, D1~D4, J1, SW1, SW2, F1, TB1(+5V)·TB2(GND)·TB3(3V3), C1, R1, LED1, BZ1)는 회로도와 같습니다. 단, "M1"은 회로도에서는 펌프 1, 재단표에서는 노즐 판(패널 M1) 이라 두 가지로 쓰입니다. 이 가이드에서는 펌프는 "펌프 1~4", 판은 "노즐 판 M1"이라고 적습니다.
- 각 STEP은 목표 → 준비물 → 소요 시간 → 그림 → 절차 → 확인 포인트(✔) → 흔한 실수(⚠) 순서입니다. 절차 속 "왜?" 는 그렇게 하는 이유입니다. 이유를 알면 실수가 줄어듭니다.
- 출력 부품 01~07은 3D 프린터로 주문해 받는 부품입니다(부록 D). 이 가이드는 출력 부품을 쓰는 것이 기본입니다. 출력 부품이 없을 때의 방법(L자 꺾쇠·고무 그로밋·포맥스 노즐 판)은 "(출력 부품이 없을 때)", "(또는 꺾쇠)", "(포맥스 M1이면 …)"처럼 괄호 안에 함께 적었으니, 출력 부품을 쓰면 괄호 속 방법은 건너뜁니다.
- □ 체크박스는 인쇄해서 펜으로 표시하며 진행하세요. (인쇄용: 조립가이드.html → Ctrl+P → A4)
- 좌표는 x = 왼쪽→오른쪽(앞에서 볼 때), y = 앞→뒤, z = 바닥판 윗면에서 잰 높이, 단위는 mm입니다.
- "추정"이라고 쓴 숫자는 계산이나 자료로 짐작한 값이라 직접 재서 확인해야 합니다.

## 목차

- 0. 완성 사양 · 동작 개요
- 1. 안전 수칙
- 2. 준비물
- 3. 단계별 제작
  - STEP 1. 부품 검수 · 멀티미터 기초
  - STEP 2. 브레드보드 단위 테스트
  - STEP 3. 펌프 리드선 연장 · 납땜 · 열수축 · 다이오드
  - STEP 4. 전원부 (DC 단자 · 스위치 · 퓨즈 · 분배 커넥터 · 커패시터)
  - STEP 5. ESP32 · 릴레이 영구 배선 (연결표)
  - STEP 6. 전원 넣기 전 점검 · 첫 전원 투입
  - STEP 7. 펌웨어 업로드 · 앱 블루투스 연결
  - STEP 8. 배관 (튜브 · 체크밸브 · 누수 테스트)
  - STEP 9. 외형 제작 (재단 · 구멍 · 조립 · 방수)
  - STEP 10. 최종 조립 · 배선 정리
  - STEP 11. 캘리브레이션 (유량 맞추기)
  - STEP 12. 시운전 · 세척 · 보관
- 4. 문제 해결 표
- 5. 시연(발표) 체크리스트
- 6. 개선 아이디어
- 부록 A. 핀맵 요약 · 부록 B. 재단표 · 부록 C. 캘리브레이션 기록표 · 부록 D. 3D 프린팅 부품

## 0. 완성 사양 · 동작 개요

### 0.1 완성 사양

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

### 0.2 동작 순서 (한 잔이 만들어지기까지)

1. 사용자가 앱에 기분·맛·도수·날씨·상황·성향과 잔 용량을 입력합니다.
2. 앱이 기기에 장착된 재료 목록(펌프 1~4의 이름·종류·도수·잔량)과 함께 Google Gemini에 보냅니다. 이때 앱 설정에 등록한 사용자 본인의 Gemini API 키를 씁니다(팀 서버 없음).
3. AI(Gemini)가 장착된 재료만으로 레시피(재료별 ml)를 만들어 돌려주면, 앱이 SPEC §3.3 규칙으로 다시 검증·보정합니다. 키가 없거나 AI가 안 되면 앱이 자체 규칙(오프라인 추천)으로 추천합니다.
4. 사용자가 레시피를 확인·조정하고 제조 시작을 누르면, 앱이 블루투스로 {"cmd":"make", ...} 명령을 보냅니다.
5. ESP32가 구동 시간 = ml ÷ 유량(ml/초)을 계산해 릴레이를 켜고 끕니다. 릴레이가 켜진 동안 해당 펌프가 용기 속 액체를 밀어 올립니다.
6. 액체는 튜브 → 체크밸브 → 노즐을 지나 잔으로 떨어집니다. 펌프는 하나씩 차례로(순차 모드) 돌아갑니다.
7. 끝나면 기기가 done을 보내고 부저가 "삐-삐" 울립니다. 휴대폰에는 완료 알림과 진동이 옵니다. 앱은 잔량을 줄이고 기록을 남깁니다.
8. 맛 평가(좋아요/별로예요)를 하면 앱이 "한 잔 더 만들까요?"를 묻습니다. [예] → 같은 입력으로 다시 추천, [아니요, 다른 걸 원해요] → 새 재료를 제안하는 탐색 모드(SPEC §5).

그림 1. 시스템 구성도 (figures/f01_system.svg)

그림 2. 완성 모습 (figures/f02_complete_iso.svg)

### 0.3 세 구역으로 나누는 이유

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

그림 3. 외형 3면도 (단위 mm) (figures/f03_views.svg)

그림 4. 내부 배치도 (figures/f04_interior.svg)

그림 2~4는 포맥스 노즐 판(M1+M2) 기준이라 노즐 출구를 z 230, 최대 액면보다 70mm 높음, 잔 약 200mm로 적었습니다. 기본 방식(출력 노즐 블록 02)에서는 블록 아랫면이 z 230이고 튜브 끝이 z 220(최대 액면 z 160보다 60mm 높음)이므로 잔은 높이 약 190mm까지입니다(0.1).

### 0.4 전기 연결 요약 (SPEC §1)

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

## 1. 안전 수칙

### 1.1 전기

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

### 1.2 공구

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

### 1.3 식품 위생 — 지금 부품으로는 아무도 마시지 않습니다

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

### 1.4 음주 관련

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

## 2. 준비물

### 2.1 부품 (BOM 번호 기준)

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

선택 부품 P65~P69는 BOM 분류가 '선택'이라 구매 수량이 0이고 필수 합계에 들어가지 않습니다(../research/BOM_원본_20261106.md 4.2절). 기본 방식(전장 박스 = 벨크로 P64, 상판 C = 캡티브 너트, 시연 = 색 물)이면 하나도 사지 않습니다. 시음을 할 때만 P65·P66·P67(디바이스마트에 없어 판매처·가격 확인 필요), 볼트 고정을 고르면 P68(디바이스마트 주문에 함께), 상판을 자석으로 붙이면 P69(다이소)를 삽니다. 부품 검수(STEP1)에서는 고른 것만 체크합니다.

3D 프린팅 부품(출력 부품 01~07)은 BOM 밖에서 출력 업체에 따로 주문합니다(부록 D). 출력 부품을 쓰면 위 표의 P36(L자 꺾쇠)·P44(고무 그로밋)는 사지 않고, 포맥스 노즐 판 M1·M2도 자르지 않습니다(BOM 수량은 출력 부품이 없을 때 기준). 출력 부품을 받으면 그날 부록 D의 '받은 뒤 확인' 표대로 너트·볼트·튜브·버튼을 끼워 봅니다. 왜? 안 맞아 다시 출력하면 2~5일이 더 걸립니다.

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

### 2.2 공구 (학교 실습실 대여 우선)

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

### 2.3 소모품

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

### 2.4 시작하기 전에 결정할 것

- 용기(P32) 고르기 — 다이소 매장에 자를 가져가서 외곽 폭 ≤ 95mm, 깊이 ≤ 135mm, 높이 ≤ 170mm(뚜껑 포함), 뚜껑 입구 ≥ 60mm인 같은 제품 4개를 삽니다. 왜? 본체 안쪽 폭 410mm에 용기 4개를 한 줄로 넣어야 하기 때문입니다.
  - 폭 95mm 이하가 없으면 본체 폭을 520mm로 늘립니다(재단표 폭 변경 규칙, 부록 B). 이 가이드의 x 치수는 W420 기준이므로, W520이면 잔 칸·노즐은 가운데(x 260)로 옮겨 읽으세요.
- 포맥스 재단 방법 — 맞춤 재단 주문(권장, 배송 2~4일) 또는 직접 재단(그림 13). 주문은 부록 B 표를 그대로 보내면 됩니다(출력 노즐 블록을 쓰면 M1·M2는 빼고 주문).
- 3D 프린팅 부품 주문 — 부록 D의 파일(../3dprint/)을 출력 업체에 시작일에 주문합니다(받기까지 2~5일). STEP 1~8은 출력 부품 없이 할 수 있고, STEP 9부터 필요합니다. 주문 전에 어댑터(P11) 플러그 머리 지름을 자로 잽니다. 12mm보다 크면 뒤판 G의 Ø12 구멍을 키워야 하므로 그로밋 05의 구멍 값을 먼저 바꿔 출력합니다(STEP9 절차 나, 부록 D). 출력 부품을 쓰지 않기로 하면 P36 꺾쇠 12개·P44 그로밋 3개를 사고 노즐 판 M1·M2를 포맥스로 자릅니다.
- 고정 방식 정하기(주문 전) — 전장 박스: 벨크로 P64(기본, 필수 구매에 포함) 또는 볼트(선택 P68 M3×15 + P38 너트, 선반 D·박스 바닥에 Ø3.5 구멍을 조립 전에 뚫음). 상판 C: 캡티브 너트(기본, 추가 구매 없음) 또는 자석(선택 P69). 볼트를 고르면 P68을 디바이스마트 주문에 함께 넣고, 자석을 고르면 P69를 다이소에서 P45와 같이 삽니다.
- 부품 주문 — 디바이스마트 추가 주문(BOM 추가구매 시트)은 준비 기간 1~4일, 포맥스 맞춤 재단은 2~4일이므로 STEP1을 시작하는 날 바로 주문합니다. 보유 부품으로 STEP1과 STEP2(펌웨어·릴레이·펌프 시험)를 하는 동안 도착합니다. STEP2의 상태 LED 테스트(절차 나 — LED P05·220Ω P06)와 (선택) 버튼·부저 테스트(절차 바 — P03·P04)는 보유품이 없으므로 주문품이 온 뒤에 합니다.

### 2.5 일정 예시 (날짜 없는 상대 일정)

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

시기 | 할 일 | 비고
시작일 | 부품 주문(디바이스마트 추가 구매 · 포맥스 재단 · 3D 프린팅 부품), 용기 구매 | 배송 1~4일, 재단 2~4일, 출력 2~5일
1주차 | 벤치 테스트 · 배선: STEP1 검수 → STEP2 벤치 테스트(릴레이 A안/B안 결정) → STEP3 펌프 모듈 → STEP4 전원부 → STEP5 영구 배선 → STEP6 첫 전원 → STEP7 펌웨어·앱 연결 | STEP1과 STEP2의 펌웨어·릴레이·펌프 시험은 보유 부품만으로 가능(주문품을 기다리는 동안). 단, STEP2 절차 나(상태 LED — P05·P06)와 절차 바(선택, 버튼·부저 — P03·P04)는 주문품 도착 후. STEP4는 재단된 뒤판 G가 있어야 함(SW1·F1을 G에 끼운 뒤 납땜)
2주차 | 외형 제작: STEP8 배관·누수 테스트(책상 위) → STEP9 외형(재단·구멍·조립·방수) → STEP10 최종 조립 | 접착제 굳는 시간 포함. STEP9는 다른 팀원이 1주차부터 같이 해도 됨
3주차 | 캘리브레이션 · 시연 리허설: STEP11 캘리브레이션 → STEP12 시운전·세척 → 리허설(발표 순서대로 + 연속 10~20잔), 예비 부품 준비 | 5장
그 뒤 | 논문용 반복 측정(유량·50ml 정확도·제조 시간), 개선 | 부록 C 기록표, 6장
기말 발표 · 졸업작품 전시 | 날짜 확인 필요(학과 공지) | 날짜가 정해지면 그 1주 전에 리허설을 한 번 더

## 3. 단계별 제작

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

STEP 9(외형)는 전기 작업과 동시에 다른 팀원이 진행하면 시간을 크게 줄일 수 있습니다.

### STEP 1. 부품 검수 · 멀티미터 기초

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

그림 5. 멀티미터 기초 (figures/f05_multimeter.svg)

그림 6. 극성(방향)이 있는 부품 확대도 (figures/f06_polarity.svg)

#### 절차

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

#### 확인 포인트

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

#### 흔한 실수

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

### STEP 2. 브레드보드 단위 테스트

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

그림 7. 벤치 테스트 연결도 (A안) (figures/f07_bench_test.svg)

#### 절차 가. 펌웨어 업로드 (ESP32만 USB에 연결)

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

#### 절차 나. 상태 LED 테스트

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

#### 절차 다. 릴레이 테스트 — A안 (SPEC 기본)

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

#### 절차 라. (A안이 안 될 때만) B안

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

#### 절차 마. 펌프 1개 물 테스트

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

#### 절차 바. (선택) 버튼·부저 테스트

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

#### 확인 포인트

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

#### 흔한 실수

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

### STEP 3. 펌프 리드선 연장 · 납땜 · 열수축 · 다이오드

목표: 펌프 4개 각각을 "뚜껑 + 펌프 + 70cm 연장선 + 다이오드"가 붙은 펌프 모듈로 만든다. 이음부는 물에 닿지 않는 뚜껑 위에, 다이오드는 젖지 않는 전장 박스 쪽 끝에 둔다.
준비물: 펌프(P09) 4, 용기(P32) 4, AWG20 2심(P19) 약 3m, 솔더 슬리브(P25) 8, 1N4007(P10) 4, 수축튜브(P26), 인두(P46)·실납(P47), 열풍기(P52), 스트리퍼(P49)·니퍼(P50), 스텝드릴(P53)·송곳, 글루건, 마스킹테이프
소요 시간: 2~3시간

그림 8. 용기 뚜껑 가공 상세 (figures/f08_lid.svg)

그림 9. 납땜 · 열수축 절차 (figures/f09_solder.svg)

#### 절차

1. 연장선 자르기 — AWG20 2심을 70cm × 4가닥으로 자릅니다. 양 끝에 펌프 번호(1~4) 테이프를 붙이고, 한쪽 끝에는 "펌프 쪽", 다른 쪽에는 "박스 쪽"이라고 씁니다. 왜 70cm? 용기 바닥 → 뚜껑 → 선반 구멍 → 박스까지 약 40cm에, 용기를 뒤로 30cm 꺼낼 수 있는 여유를 더한 길이입니다. 실제 배치에서 남으면 묶어 두면 됩니다.
2. 다이오드 하네스(박스 쪽 끝) 먼저 만들기(그림 9 C 오른쪽)
  1. 박스 쪽 끝의 빨강·검정을 약 5cm 갈라 놓고, 각각 피복을 15mm 벗깁니다.
  2. 다이오드의 띠(캐소드) 쪽 다리를 빨강, 반대쪽 다리를 검정 심선에 피복 가까운 곳부터 3바퀴 감습니다. 감기 전에 두 심선에 수축튜브(다이오드 길이 + 1cm)를 미리 한 개씩 끼워 둡니다.
  3. 감은 부분만 납땜합니다. 심선의 끝 8mm에는 납을 많이 먹이지 않습니다(나중에 단자에 꽂는 부분).
  4. 남는 다이오드 다리를 자르고, 수축튜브를 다이오드·납땜부 위로 덮어 열풍기로 수축합니다.
  5. 바로 확인: 멀티미터 다이오드 모드로 검정 리드 → 빨강 선 끝, 빨강 리드 → 검정 선 끝에 대면 0.5~0.7, 반대로 대면 OL이어야 합니다.

왜 먼저? 펌프를 연결하면 펌프 코일이 다이오드와 나란히 붙어 멀티미터로 방향을 확인할 수 없습니다. 펌프를 잇기 전에 확인해야 합니다. 왜 박스 쪽? 다이오드와 납땜부가 액체·습기에 닿지 않는 곳에 있어야 오래갑니다. SPEC §1은 다이오드 위치를 "펌프 리드선 이음부(뚜껑 위) 또는 연장선의 박스 쪽 끝 — 전기적으로 동일"이라고 정해 두었습니다. 배선도(wiring.svg)는 이음부 쪽으로 그렸지만, 어느 쪽이든 펌프와 병렬이고 띠 = 빨강(+) 이면 똑같이 동작합니다.

3. 뚜껑 가공(그림 8) — 용기 안에 펌프를 놓아 보고, 출수구 바로 위 뚜껑에 Ø7 튜브 구멍, 그 옆 20mm에 Ø5 전선 구멍, 가장자리 15mm 안쪽에 Ø3 공기 구멍을 연필로 표시합니다.
  - 송곳으로 작은 구멍을 낸 뒤 스텝드릴을 천천히 돌려 넓힙니다. 왜? PP 뚜껑은 빨리 돌리면 열로 녹아 구멍이 지저분해집니다.
  - 왜 공기 구멍? 밀폐용기는 액체를 퍼낼수록 안이 진공이 되어 유량이 줄어듭니다. 작은 구멍 하나로 공기가 들어오게 합니다(SPEC §1). Ø3 공기 구멍은 글루건으로 막지 않습니다.
  - 거스러미는 커터칼로 정리합니다. 4개 모두 같은 위치로 가공합니다.
4. 펌프 리드선 통과 — 펌프의 빨강·검정 리드선을 뚜껑 안쪽에서 바깥쪽으로 Ø5 구멍에 통과시킵니다. 펌프 리드가 뚜껑 위로 최소 3cm 나와야 합니다.
  - 리드가 짧아 뚜껑 위로 나오지 않으면: 뚜껑 안쪽에서 잇고, 이음부를 솔더 슬리브(접착제 내장이라 방수)로 확실히 감싼 뒤 액면보다 높은 곳(뚜껑 바로 아래)에 오게 합니다.
5. 이음(그림 9 A — 솔더 슬리브, 권장)
  1. 펌프 리드와 연장선(펌프 쪽 끝)의 피복을 각각 8~10mm 벗깁니다. 빨강·검정의 이음 위치가 2cm 엇갈리도록 연장선의 빨강과 검정 길이를 2cm 다르게 자릅니다(그림 9 C 왼쪽). 왜? 두 이음이 나란히 있으면 굵어지고, 혹시 피복이 벗겨졌을 때 서로 닿아 단락될 수 있습니다.
  2. 솔더 슬리브(P25)를 굵은 연장선 쪽에 먼저 끼웁니다.
  3. 두 심선을 나란히 겹쳐 살짝 비틀고, 슬리브를 밀어 와서 가운데 은색 납 고리가 겹친 곳 한가운데 오게 합니다.
  4. 열풍기(약 250~300℃ 또는 1단)를 슬리브 가운데부터 쬡니다. 은색 납이 녹아 심선 사이로 스미고, 양 끝 빨간 접착 고리가 녹아 선에 달라붙으면 끝입니다(약 20~40초).
  5. 식힌 뒤 양쪽을 살짝(약 1kg 힘) 당겨 빠지지 않는지 봅니다.
  - 열풍기가 없으면 그림 9 B: 수축튜브를 먼저 끼우고 → 심선을 꼬아 잇고 → 인두로 심선을 3초 데운 뒤 실납을 심선에 대어 녹이고(인두 끝에 직접 녹이지 않음) → 식힌 뒤 수축튜브를 덮어 열풍기나 인두 옆면으로 수축합니다.
6. 색 확인 — 펌프 빨강 ↔ 연장선 빨강, 펌프 검정 ↔ 연장선 검정인지 다시 봅니다. 판매처 안내대로 빨강 = +입니다.
7. 전선 구멍 막기 — 뚜껑 안쪽에서 펌프 리드를 1~2cm 당겨 여유를 두고, 뚜껑 위 Ø5 구멍 둘레를 글루건으로 막습니다(전선이 빠지지 않게 + 물방울 차단). Ø7 튜브 구멍은 STEP8에서 튜브를 끼운 뒤 마무리합니다. Ø3 공기 구멍은 그대로 둡니다.
8. 동작 확인 — STEP2의 벤치 연결에서 펌프 모듈의 박스 쪽 끝을 빨강 → NO1, 검정 → GND 레일에 꽂고, 펌프를 물컵에 넣은 채 {"cmd":"run","p":1,"ms":2000}. 물이 나오면 성공. 4개 모두 반복합니다.

#### 확인 포인트

- ✔ 다이오드 하네스 4개 모두 다이오드 모드로 방향 확인(검정 리드→빨강 선: 0.5~0.7)
- ✔ 이음부 8곳 당김 테스트 통과, 빨강-빨강·검정-검정
- ✔ 이음부가 모두 뚜껑 위에 있음
- ✔ 뚜껑마다 Ø7·Ø5·Ø3 구멍 3개, 번호 스티커
- ✔ 펌프 모듈 4개 물 테스트 통과

#### 흔한 실수

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

### STEP 4. 전원부 (DC 단자 · 스위치 · 퓨즈 · 분배 커넥터 · 커패시터)

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

그림 10. 전원부 결선도 (figures/f10_power.svg)

#### 레버 커넥터(PCT-418) 사용법

레버를 위로 올림 → 피복을 제품 옆면에 표시된 길이(보통 10~11mm)만큼 벗긴 선을 끝까지 넣음 → 레버를 내림 → 살짝 당겨 빠지지 않는지 확인. 8구는 모두 서로 연결되어 있어서, 한 구멍에 넣은 전기가 나머지 7구로 나눠집니다("전선 분배기").

#### 절차

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

#### 확인 포인트

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

#### 흔한 실수

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

### STEP 5. ESP32 · 릴레이 영구 배선 (연결표)

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

그림 11. 전장 박스 배치 예시 (figures/f11_ebox.svg)

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

#### 절차 가. 박스 준비

1. 박스의 안쪽 크기(가로·세로·높이)와 속판 크기를 재서 적고, 부품들을 속판 위에 올려 그림 11처럼 배치해 봅니다. 겹치면 조정합니다.
2. 벽 구멍 — 스텝드릴로 뚫습니다. 왼쪽 벽 Ø12(펌프 1·2), 오른쪽 벽 Ø12(펌프 3·4), 뒤 벽 Ø16(어댑터 선 ①, SW1·F1 왕복선 ②·④), 앞 벽 Ø10(앞판의 버튼·LED·부저 선 ㉙~㊱). 높이는 박스 바닥에서 약 20mm.
  - 뒤 벽 구멍으로는 STEP10에서 어댑터 플러그 머리가 지나가야 합니다. 플러그 머리 지름을 재서 Ø16보다 크면 구멍을 더 넓힙니다.
  - 박스 바닥에는 구멍을 뚫지 않습니다(STEP10에서 벨크로로 고정). 볼트 고정(선택, M3×15 P68 + 너트 P38)을 고른 경우만, 이때(속판을 달기 전) 바닥 뒤쪽 두 모서리에 Ø3.5를 뚫습니다(STEP10 절차 1).

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

#### 절차 나. 배선 요령

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

#### 연결표 (①~㊱ — 회로도.html ③ 연결표와 같은 번호)

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

분배 커넥터 구멍 배정 (그림 10, 회로도와 같음)

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

#### 절차 다. 배선 후 점검 (전원 없이)

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

#### 확인 포인트

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

#### 흔한 실수

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

### STEP 6. 전원 넣기 전 점검 · 첫 전원 투입

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

#### 전원 넣기 전 점검표 (어댑터 뽑은 상태)

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

#### 첫 전원 투입 절차

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

#### 확인 포인트

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

#### 흔한 실수

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

### STEP 7. 펌웨어 업로드 · 앱 블루투스 연결

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

#### 절차 가. 조립 상태에서 펌웨어 올리기 (나중에 펌웨어를 고칠 때마다 이 순서)

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

#### 절차 나. 테스트 앱으로 블루투스 확인 (앱 없이)

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

#### 절차 다. 바텐더 앱 연결

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

#### 확인 포인트

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

#### 흔한 실수

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

### STEP 8. 배관 (튜브 · 체크밸브 · 누수 테스트)

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

그림 12. 액체 경로도 (figures/f12_liquid_path.svg)

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

#### 튜브 재단표 (펌프 1개당, 4세트)

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

튜브는 가위나 니퍼 대신 커터칼로 직각으로 자릅니다. 비스듬히 잘리면 노즐에서 물줄기가 옆으로 휩니다.

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

#### 절차

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

#### 확인 포인트

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

#### 흔한 실수

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

### STEP 9. 외형 제작 (재단 · 구멍 · 조립 · 방수)

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

그림 13. 패널 재단 배치도 (직접 자를 때) (figures/f13_cut_layout.svg)

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

#### 절차 가. 판 준비

1. 재단 주문(권장): 부록 B 재단표의 치수·수량을 그대로 재단 쇼핑몰에 주문합니다(오차 ±1~2mm). 직접 재단: 그림 13대로 연필로 모든 선과 기호를 먼저 그린 뒤, 쇠자를 대고 커터칼로 5~6번 그어 꺾어 자릅니다. 긴 직선부터, 작은 부품은 나중에. 왜 여러 번? 포맥스는 한 번에 세게 자르면 칼이 휘어 단면이 비뚤어집니다.
2. 모든 판의 안쪽 면에 연필로 기호(A, B좌, B우 …)와 "앞" 방향 화살표를 적습니다. 단면은 사포로 살짝 다듬습니다.
3. 재단된 판을 바닥에 놓고 직각자로 네 모서리가 직각인지 확인합니다.

#### 절차 나. 구멍 가공 (조립 전에 모두 뚫기)

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

- G판의 사각 구멍(로커 스위치)은 STEP4에서 잰 크기보다 0.5mm 작게 4모서리에 Ø3 구멍을 뚫고 커터칼로 잇고, 줄·사포로 넓혀 가며 스위치가 "딸깍" 끼워질 때까지 맞춥니다.
- G판은 뒤에서 볼 때와 앞에서 볼 때 좌우가 바뀝니다. G판 바깥면에 "뒤(바깥)"라고 써 두고 바깥면을 보며 위치를 잽니다.
- 출력 그로밋 04(Ø20용)·05(Ø12용) 는 판 두께 5mm에 맞춰 출력한 것이고, 옆이 3.5mm 트여 있어 배선을 마친 뒤 케이블에 옆으로 끼울 수 있습니다. 그래서 어댑터 플러그가 그로밋 구멍을 통과할 필요가 없고, G의 Ø12 구멍은 플러그 머리가 지나갈 크기면 됩니다(머리가 12mm보다 크면 구멍을 키우고 05는 ../3dprint/parts.py의 구멍 값을 바꿔 다시 출력).
- (출력 부품이 없을 때) 그로밋(P44) 은 선반 D의 Ø20 구멍 2개용과 뒤판 G의 Ø12 구멍 1개용, 모두 판 두께 5mm용입니다(BOM P44와 같음). 5mm 판에 맞는 그로밋을 못 구하면 사지 않고 글루건으로 구멍 가장자리를 둥글게 마감해도 됩니다(전선 피복 보호가 목적).
- (고무 그로밋 P44를 쓸 때) 뒤판 G의 Ø12 그로밋은 어댑터 플러그(머리)가 그로밋 가운데 구멍보다 커서 통과하지 못할 수 있습니다(추정). 그래서 G에는 지금 끼우지 않고, STEP10에서 플러그를 맨 구멍으로 먼저 통과시킨 뒤 끼웁니다. 구멍을 뚫기 전에 플러그 머리 지름을 자로 재서, 12mm보다 크면 G 구멍을 그만큼 키웁니다(실측).

#### 절차 다. 조립 (그림 14 순서)

접착: 포맥스끼리는 순간접착제(P42) 로 맞대어 붙이고(10초 누름), 굳은 뒤 안쪽 모서리를 글루건으로 한 줄 더 보강합니다. 힘을 받는 곳은 출력 브래킷 01(없으면 L자 꺾쇠) + M3×10 볼트·너트로 고정합니다(포맥스에 목나사는 잘 빠짐).
출력 브래킷 01 쓰는 법: M3 너트를 브래킷 안쪽 면의 육각 홈 2곳(다리마다 1곳) 에 하나씩 미리 눌러 끼웁니다(헐거우면 순간접착제 한 방울). 브래킷 1개에 볼트·너트 2쌍이 들어갑니다. 브래킷의 바깥 모서리(모따기 쪽) 를 두 판이 만나는 안쪽 모서리에 대고, 볼트는 판 바깥에서 넣어 브래킷 속 너트로 조입니다(볼트 끝이 너트 위로 약 0.6mm 나옴). 너트 홈을 판 쪽으로 대면 너트가 막혀 들어가지 않습니다. 브래킷이 들어가는 이음새는 볼트를 먼저 조여 두 판의 위치를 맞춘 뒤 이음새를 따라 순간접착제를 바릅니다. 왜? 구멍을 미리 뚫어 두었으므로, 먼저 붙였다가 판이 1~2mm만 어긋나도 볼트가 들어가지 않고 굳은 뒤에는 고칠 수 없습니다.

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

그다음 F를 y 0~5, z 255~370에 붙입니다.

  - 앞면 베젤(출력 03): F를 붙인 뒤 베젤을 버튼·LED 위로 씌워 양면테이프(폼형) 로 F 바깥면에 붙입니다(순간접착제는 쓰지 않음 — LED 테가 베젤 뒤 홈에 물려 있어, LED를 돌려 꽂거나 바꿀 때(4장 '상태 LED가 안 켜짐')는 베젤을 떼야 함). 베젤의 Ø18.8 구멍으로 버튼 머리가 지나가므로 버튼은 F 판에만 고정되고(베젤 두께와 상관없이 너트가 물림), LED 테는 베젤 뒤쪽 홈에 들어갑니다. 라벨 홈에 "정지/시작"·"상태" 스티커를 붙입니다.
  - G 붙이기: G에는 STEP4에서 SW1·F1이 끼워져 납땜되어 있습니다. 먼저 어댑터를 콘센트에서 뽑고, ②를 J1 + 나사에서, ④를 TB1-8에서 빼 박스 뒤 벽 구멍 밖으로 빼냅니다(끝에 ②·④ 번호 테이프, 드러난 심선은 테이프로 감쌈). 그다음 G를 바깥면("뒤(바깥)")이 밖을 보게 y 255~260에 붙입니다. ②·④는 STEP10에서 다시 연결하고, G의 Ø12 그로밋도 STEP10에서 끼웁니다.
9. ⑥ 상판 C(탈착) — C는 접착하지 않습니다(전장부 정비용).
  1. 너트 미리 붙이기(캡티브 너트) — 출력 브래킷 01 4개를 B에 달기 전에, 각 브래킷의 가로 다리(C가 얹힐 쪽) 육각 홈에 M3 너트를 넣고(조립하면 홈이 아래를 봄) 홈 테두리에 순간접착제를 조금 바릅니다. 식용유나 바셀린을 살짝 묻힌 M3×10 볼트를 홈 반대쪽 평평한 면에서 너트에 끝까지 돌려 넣은 채 굳히고(약 10분), 굳으면 볼트만 빼 둡니다(기름 때문에 접착제가 볼트에 붙지 않고, 나사산이 막히지 않음). (출력 부품이 없을 때) 각 꺾쇠의 가로 다리(C가 얹힐 쪽) 구멍 아래에 M3 너트를 대고 위에서 M3×10 볼트를 돌려 너트를 붙잡습니다. 그 상태로 너트 바깥 테두리에 순간접착제(P42)를 조금 바릅니다(에폭시가 있으면 더 튼튼함). 볼트 나사산에 식용유나 바셀린을 살짝 묻혀 두면 접착제가 볼트에 붙지 않습니다. 굳으면(약 10분) 볼트만 빼 둡니다. 왜? C를 얹으면 전장부(선반 위 칸)가 B·F·G·D·C로 사방이 막혀 손이 들어가지 않으므로, 브래킷(꺾쇠) 아래 너트를 손으로 잡을 수 없습니다. 너트를 붙여 두면 처음 조일 때도, 정비 때(STEP7 ⑧ 분리·USB 업로드) C를 풀 때도 위에서 볼트만 돌리면 되고, 빠진 금속 너트가 릴레이 나사 단자·레버 커넥터 위로 떨어져 단락될 일도 없습니다.
  2. 브래킷(또는 꺾쇠)을 측판 B 안쪽 맨 위에 좌우 2개씩, y 60·200(상판 모서리 캡과 겹치지 않게)에 볼트·너트로 답니다(가로 다리 윗면 = B 윗면 높이, 붙인 너트는 아래쪽). 이 볼트는 B 바깥에서 넣어 세로 다리 홈의 너트에 조입니다(꺾쇠는 안쪽 너트를 위가 열려 있는 지금 끼웁니다).
  3. C에 구멍 표의 C 위치(좌·우 끝에서 21, 앞쪽 끝에서 60·200)를 연필로 표시합니다(꺾쇠는 C를 얹고 꺾쇠 구멍 위치를 표시) → C를 내려서 따로 Ø3.5로 뚫습니다(본체 위에서 드릴 금지).
  4. C를 얹고 위에서 M3×10 볼트 4개만 돌려 고정합니다.
  5. 상판 모서리 캡(출력 06) — C를 얹은 상태에서 캡 4개를 C 네 모서리에 맞춰 보고, 순간접착제로 C에만 붙입니다(측판 B·앞판 F·뒤판 G에는 붙이지 않음 — 붙이면 상판을 열 수 없음). 접착제가 B·F·G에 묻지 않게 네 모서리 둘레의 B·F·G 윗부분을 마스킹테이프로 가린 뒤 붙입니다. 굳으면 볼트 4개를 풀고 C를 들어 걸림 없이 열리는지 확인합니다.
  - 대안(선택): 뒤 덮개 H처럼 자석 캐치로 C를 붙여도 됩니다. 이때는 H용 P45 2개와 별도로 P69(선택, 2~4개) 를 삽니다(BOM 4.2절, 다이소).
10. 뒤 덮개 H — 뒤쪽 개구부(410×255)에 끼워 보고(1mm 여유), 걸림턱 L과 H 안쪽에 자석 캐치(P45) 2개를 붙입니다.
11. 고무발 — 바닥판 A 아래 네 모서리(각 모서리에서 20mm 안쪽)에 고무발(P41) 4개를 붙입니다.

#### 절차 라. 방수 처리

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

#### 확인 포인트

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

#### 흔한 실수

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

### STEP 10. 최종 조립 · 배선 정리

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

그림 15. 노즐 매니폴드 상세 (포맥스 M1+M2 방식 그림) (figures/f15_nozzle.svg)

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

#### 절차

1. 전장 박스 올리기 — 상판 C를 떼고, 박스를 선반 D 위 x 105~305, y 40~190 위치(그림 4 (다))에 놓습니다. 박스 바닥 네 모서리와 D의 같은 자리에 접착식 벨크로(찍찍이) P64 를 한 쌍씩(10쌍 중 4쌍) 붙여 고정합니다. 붙일 면의 먼지·기름을 닦고 꾹 누르고, 55×35mm가 박스 모서리보다 크면 잘라 씁니다(폼 양면테이프로 한 번 더 잡아도 됨). 박스 바닥과 D에는 구멍을 뚫지 않습니다. 왜 볼트가 아닌가? 박스 앞쪽 모서리 아래(x 5~130 / 290~415, y 5~105)는 I·J·E·B·A·D로 사방이 막힌 빈 공간(그림 4 (나))이라 너트를 끼울 손이 들어가지 않고, 조립이 끝난 본체에 구멍을 뚫으면 STEP9의 "조립 후 구멍 뚫기 금지"와도 어긋납니다. 벨크로는 정비 때 박스를 들어 올릴 수도 있습니다.
  - (선택) 볼트로 단단히 잡고 싶으면 뒤쪽 두 모서리(x 약 115·295, y 약 180 — 아래가 용기 칸) 만 씁니다. D 구멍은 STEP9 구멍 표의 "D 선반 (선택)" 행에서 조립 전에, 박스 바닥 구멍은 STEP5 박스 준비 때(속판을 달기 전) 뚫어 둡니다. 볼트는 M3×15(P68, 선택 — 디바이스마트 주문에 함께), 너트는 P38을 씁니다. 너트는 뒤 덮개 H를 열고 용기를 꺼낸 뒤 용기 칸 쪽(D 아래)에서 끼워 조입니다. 왜 15mm? 볼트가 박스 바닥 + D(5mm) + 너트를 지나 나와야 해서 M3×10(P37)은 짧을 수 있습니다(박스 바닥 두께 실측).
2. 전원선 ②·④ 다시 연결(필수) — SW1·F1은 STEP4에서 이미 G에 끼워져 있고, G는 STEP9에서 본체에 붙었습니다.
  1. G 안쪽에 매달린 ②·④ 끝의 테이프를 벗기고 박스 뒤 벽 Ø16 구멍으로 넣습니다.
  2. ② → J1 + 나사, ④ → TB1-8에 연결하고 살짝 당겨 봅니다(STEP9에서 뺀 선 — 빠뜨리면 SW1을 켜도 전원이 들어오지 않습니다).
3. 어댑터 선(①) — 어댑터 플러그를 G의 Ø12 구멍(그로밋 없이) 으로 바깥에서 안으로 넣습니다. 그다음 출력 그로밋 05를 옆 트임으로 케이블에 끼우고 오므려 구멍에 눌러 끼운 뒤, 둘레를 글루건으로 고정합니다. (출력 부품이 없을 때) 고무 그로밋 P44는 한쪽을 커터칼로 한 번 갈라 케이블에 옆으로 끼우고 구멍에 밀어 넣습니다. 플러그는 박스 뒤 벽 구멍을 지나 J1에 꽂습니다. G 안쪽에서 선을 케이블타이로 한 번 묶어(매듭처럼) 밖에서 잡아당겨도 J1이 빠지지 않게 합니다(장력 완화).
  - ①·②·④가 모두 연결되면 STEP4 절차 11·12를 다시 합니다: 어댑터를 뽑은 상태에서 TB1–TB2 단락 검사 → 어댑터를 꽂고 SW1 OFF 0V / ON 4.9~5.25V → SW1 OFF.
4. 앞판 배선 — 앞판 선(㉙~㊱)을 박스 앞 벽 구멍으로 넣어 연결합니다(번호 테이프와 색을 보고 하나씩):
  - ㉙ 부저 VCC(노랑, 테이프 ㉙) → TB3-3 · ㉚ 부저 I/O(노랑, 테이프 ㉚) → GPIO23 (J3-2)
  - ㉛ 앞판 GND 공통선(검정) → ESP32 GND (J3-7)
  - ㉝ 버튼(노랑, 테이프 ㉝) → GPIO4 (J3-13) · ㉟ R1·LED(노랑, 테이프 ㉟) → GPIO2 (J3-15)
  - 노랑 4가닥은 색이 같으므로 번호 테이프만 보고 꽂습니다. 특히 ㉙(3V3)을 GPIO 단자에, ㉚·㉝·㉟를 TB3에 꽂지 않게 한 가닥씩 확인합니다.
5. 용기·펌프 모듈 넣기 — 뒤 덮개 H를 열고 용기 1~4를 왼쪽부터 순서대로 넣습니다.
  - 펌프 1·2 선 → 선반 왼쪽 그로밋(x 60), 펌프 3·4 선 → 오른쪽 그로밋(x 360) → 박스 옆 벽 구멍 → 연결표 ㉑~㉘: 펌프 1 빨강 → K1 NO, 검정 → TB2-2 · 펌프 2 → K2 NO / TB2-3 · 펌프 3 → K3 NO / TB2-4 · 펌프 4 → K4 NO / TB2-5.
  - 그로밋 아래에서 전선을 U자로 한 번 늘어뜨린(드립 루프) 뒤 올립니다. 왜? 전선을 타고 흐르는 물방울이 U자 바닥에서 떨어져 구멍으로 들어가지 않습니다.
  - 용기를 뒤로 30cm 꺼낼 수 있을 만큼 전선·튜브 여유를 용기 칸 안에 남깁니다.
6. 체크밸브 고정 — 선반 D 아래(용기 칸 쪽), 칸막이 구멍 근처(y 120~160)에 접착 마운트(P28)를 붙이고 체크밸브 4개를 가로로 케이블타이 고정합니다. 화살표가 앞(칸막이·노즐 쪽) 을 향합니다.
7. 노즐 연결(그림 15)
  1. 튜브 부싱(출력 07) 을 칸막이 E의 Ø25 구멍에 테가 잔 칸 쪽으로 오게, 잔 칸에서 볼 때 점 1·2개 구멍이 왼쪽, 점 3·4개 구멍이 오른쪽에 오도록 돌려 끼우고 글루건으로 고정합니다. 왜? 노즐 블록 구멍이 왼쪽부터 1·2·3·4라, 이렇게 돌려야 좁은 틈(20mm)에서 튜브가 서로 엇갈리지 않습니다. 각 체크밸브의 내경4 출구 튜브를 부싱 테의 점 개수 = 펌프 번호인 구멍으로 하나씩 잔 칸 쪽에 통과시킵니다. (부싱이 없을 때) 4가닥을 2×2로 묶어 Ø25 구멍으로 통과시킵니다.
  2. 노즐 블록을 잔 칸 안에서 손에 듭니다. 출력 02는 블록 밑판(구멍이 뚫린 판) 윗면의 '앞' 화살표가 잔 칸 앞쪽을 보게 들고, 구멍 앞의 점 1~4개 = 펌프 번호입니다. 튜브를 왼쪽부터 펌프 1·2·3·4 순서로 블록 안 튜브 칸막이 사이를 지나 구멍에 위에서 아래로 끼웁니다. 출력 블록의 구멍(Ø6.2)은 튜브(외경 6)가 꽉 끼므로, 빡빡하면 튜브 끝을 뜨거운 물에 10초 담갔다가 밀어 넣습니다.
  3. 튜브 끝이 블록 아래로 10mm(포맥스 M1이면 3mm) 나오게 맞춘 뒤, 커터칼로 4개 끝을 같은 높이로 직각으로 자릅니다. 왜 10mm? 3D 출력물은 층 사이 홈에 액체가 스며들면 씻기 어렵고 식품용 인증도 없으므로, 음료가 블록에 닿지 않고 튜브 끝에서 바로 잔으로 떨어지게 합니다.
  4. 블록 위쪽에서 튜브 둘레를 글루건(또는 식품용 실리콘)으로 빈틈없이 막아 고정합니다.
  5. 노즐 블록의 벽 윗면(출력 02는 양쪽 날개 윗면도)에 순간접착제(또는 글루건)를 바르고 선반 D 아래 x 180~240, y 22~82(블록 중심 = 잔 칸 가운데 x 210, y 52)에 30초간 눌러 붙입니다. 튜브가 납작하게 꺾이지 않았는지 확인합니다.
  6. 줄자로 바닥판 윗면에서 블록 아랫면까지 230mm, 튜브 끝까지 220mm(포맥스 M1이면 약 227mm)인지 잽니다.

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

#### 액체·전장부 격리 점검

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

#### 확인 포인트

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

#### 흔한 실수

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

### STEP 11. 캘리브레이션 (유량 맞추기)

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

#### 왜 꼭 해야 하나요?

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

#### 절차 (앱 캘리브레이션 마법사)

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

#### 액체별 차이 (참고, 추정값)

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

#### 다시 해야 할 때

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

#### 120초 제한 주의 (SPEC v2.1)

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

#### 확인 포인트

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

#### 흔한 실수

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

### STEP 12. 시운전 · 세척 · 보관

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

#### 절차 가. 시운전 (물로)

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

#### 절차 나. 세척 (매번 사용 후)

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

#### 절차 다. 정기 세척 (설탕 음료를 쓴 날, 일주일에 한 번)

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

#### 절차 라. 보관

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

#### 확인 포인트

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

#### 흔한 실수

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

## 4. 문제 해결 표

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

## 5. 시연(발표) 체크리스트

기말 시연(발표)과 졸업작품 전시에 씁니다. 날짜는 학과 공지로 확인 필요합니다.

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

### 전날

- 리허설: 발표 순서대로 한 번(추천 → 제조 → 완료 알림 → 양·색 확인 → 앱 평가 버튼 → "한 잔 더?"/탐색 모드) + 연속 10~20잔(물/색 물) — 문제 기록·수정
- 휴대폰 2대에 앱 설치(Releases 의 최신 APK, 한 대는 예비), 충전 100%, 보조배터리. 두 폰 모두 근처 기기·위치·알림 권한 허용. 예비로 PC(Chrome 웹앱 또는 EXE)도 준비
- 앱 AI 키 점검: 시연 폰의 앱 설정(오른쪽 위 ⚙, 기기 탭 맨 아래 "앱 설정"으로도 감) → Gemini API 키 칸이 "저장됨 ••••••••(마지막 4자리)"인지 확인하고 [키 확인] 을 누릅니다. 결과는 칸 아래 색 띠로 나옵니다(../../app/README.md 5장).
  - 초록 "성공 — 이 키로 AI 추천을 쓸 수 있어요" → 정상. AI 추천 방식이 [Gemini(내 키)] 인지도 봅니다.
  - 노랑 "키는 정상이에요 — 모델을 바꿔 주세요" → 같은 화면의 모델 목록에서 다른 모델을 고릅니다.
  - 빨강 "키가 올바르지 않아요" / "권한 없음" → 키를 다시 붙여 넣거나 Google AI Studio 에서 새 키를 발급받아 [키 확인] → [저장].
  - 노랑 "사용량 한도·크레딧 소진" → 무료 등급 한도. 잠시 뒤 다시 확인하고, 시연 직전에는 연습 호출을 줄입니다.
  - 빨강 "인터넷 연결 없음" → 휴대폰 인터넷(와이파이·데이터)을 확인하고 다시 누릅니다.
  - 노랑·빨강이 계속되면 같은 화면 맨 위 "AI 추천 방식" 을 [오프라인] 으로 바꿔 바텐더 탭에서 추천이 나오는지 확인해 둡니다(시연 장소 인터넷이 불안정할 때 이 방식으로 진행). 확인 후 다시 [Gemini(내 키)] 로 돌려 둡니다.
  - 키는 그 폰에만 저장됩니다. 공용·전시용 폰이면 시연이 끝난 뒤 키를 삭제합니다.
- 기기가 고장 났을 때를 대비해 앱 데모 모드(가상 기기) 로 화면 시연이 되는지 확인
- 노트북에 Arduino IDE + 펌웨어 폴더 + USB 케이블(펌웨어 다시 올릴 때)
- 예비 부품 상자: 퓨즈 3A ×2, 펌프(P09 예비) ×2, 체크밸브 ×1, 1N4007 ×2, 튜브 내경4·5 각 1m, 케이블타이, 점퍼선, 레버 커넥터 ×1, 수축튜브, 멀티미터, 일자·십자 드라이버, 글루건
- 시연용 액체 4가지 준비: 물에 식용색소를 탄 색 물(예: 빨강·노랑·파랑·초록 — 섞이면 색이 바뀌어 비율이 눈에 보임) + 예비 1병씩. 앱 재료 이름은 실제 재료 이름(예: "사이다")으로 둬도 되지만 내용물은 색 물. 맑은 음료를 쓰더라도 펄프 없는(걸러낸) 것만(펄프는 체크밸브 Ø2mm를 막음), 마시지 않음
- 투명 시연용 컵(높이 190mm 이하 — 노즐 튜브 끝 z 220, 0.1) 10개 정도 — 마시지 않는 시연 전용(관람객에게 나눠 주지 않음), 시연 후 액체를 버릴 통
- 키친타월, 물티슈, 쓰레기봉투, 세척용 물통, 큰 그릇(세척수 받기)
- 멀티탭(콘센트까지 거리 확인), 테이블보
- 안내문: "시연용 색 물입니다 — 마시지 마세요", "버튼을 누르면 즉시 멈춥니다", 사용 방법 QR(웹앱 https://paperji.github.io/smart-bartender/ — 데모 모드로 바로 체험), 팀 소개

### 당일 (설치)

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

### 시연 중

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

### 끝난 뒤

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

## 6. 개선 아이디어 (졸업논문 · 특허 · 후속 개선)

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

## 부록 A. 핀맵 요약 (SPEC §1)

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

## 부록 B. 재단표 (parts_research.md 5.2와 동일, W420 기준)

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

## 부록 C. 캘리브레이션 기록표

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

## 부록 D. 3D 프린팅 부품

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

그림 16. 3D 프린팅 부품 7종

그림 16. 3D 프린팅 부품 7종 (figures/f16_print_parts.png)

그림 17. 3D 프린팅 부품 위치

그림 17. 3D 프린팅 부품 위치 (figures/f17_print_layout.png)

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

받은 뒤 확인

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
