paperji/smart-bartender/hardware/circuit/wiring.png

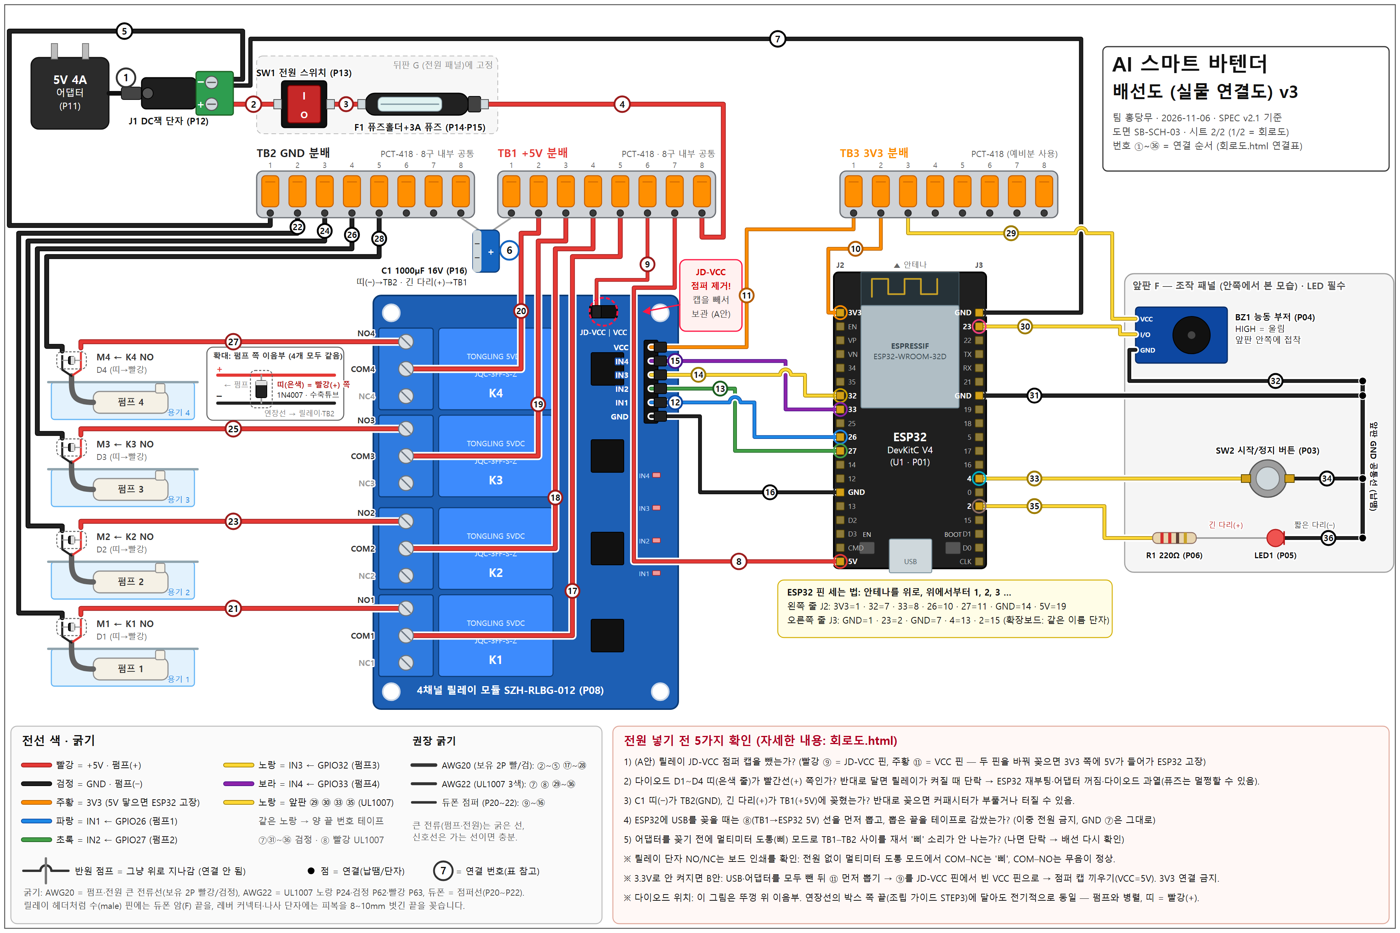
hardware/circuit/wiring.png
