paperji/smart-bartender/(commit log)

2026-11-06 AI 스마트 바텐더 v3.0 — 웹앱·안드로이드 APK·Windows EXE
    팀 홍당무 캡스톤디자인 과제. 기분·맛·도수·날씨·상황·성향을 입력하면
    기기에 장착된 재료만으로 AI(Gemini, 본인 키) 또는 오프라인 규칙이 레시피를 만들고,
    블루투스(BLE)로 ESP32 칵테일 메이커에 보내 음료를 배합합니다.
    - app/: Vite + React + TypeScript 웹앱(PWA). 같은 빌드로 Android APK(Capacitor),
    Windows portable EXE(Electron)도 만듦. GitHub Pages 로 배포
    - firmware/: ESP32 BLE 펌웨어 + PC 단위 테스트
    - backend/: v2.1 AI 서버(기준 구현, v3.0 앱은 쓰지 않음)
    - hardware/: 회로도·BOM·조립 가이드
    -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
    [BOM.xlsx]
2026-11-07 v3.0.1 · 펌웨어 2.1.1 — 실제 ESP32 연결 시험 뒤 고친 것
    실제 ESP32(DevKitC)에 펌웨어를 올리고 PC 블루투스·Windows 앱으로 연결해 본 뒤,
    독립 검토로 찾은 문제를 고쳤습니다. 명령·이벤트 형식(SPEC §1·§2)은 그대로입니다.
    펌웨어 2.1.1
    - BLE 송신 링버퍼를 TxRing.h 로 분리: 혼잡(ERROR_GATT)이면 30→60→120→240ms 로 쉬며
    4초까지 다시 보내고, 그래도 안 되면 맨 앞 줄 하나만 포기. 반쪽만 나간 줄이면 다음 전송
    앞에 '\n' 을 붙여 앱의 줄 조립을 맞춤 (2.1.0 은 0.33초 만에 조각 전체를 버렸음)
    - 줄 맞춤 '\n' 만 남은 동안에는 포기 시계를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
    [SmartBartender.ino, TxRing.h, ble_e2e.py, config.h, host_test.cpp, host_test_tx.cpp, test_util.h]
2026-11-07 v3.0.3 · 펌웨어 2.1.2 — 앱 안 자동 업데이트, 휴대폰 첫 연결 재시도
    - 앱 업데이트(APK·EXE): GitHub 최신 릴리스 확인 → 추천 → 내려받기(SHA-256 확인) → 설치
    - APK: AppUpdaterPlugin(같은 패키지·더 높은 versionCode 만, 설치는 사용자가 "업데이트"), "이 출처 허용" 뒤 이어서(앱이 다시 켜져도)
    - EXE: 새 EXE 를 받아 실행 뒤 종료(주소·버전 검사, 시간 초과, 한 번만 받기, 파일 잠금 재시도, 남은 임시 파일 정리)
    - 기기 작업 중·다른 창이 열려 있을 때는 창을 미룸, 받아 둔 뒤 "지금 설치", 나중에·건너뛰기
    - 모달: Esc·뒤로 버튼은 맨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
2026-11-07 문서: v3.0.3 실기 시험 결과 기록 (자동 업데이트·페어링)
    - 웹 자동 업데이트(PC·휴대폰 크롬 3.0.1 → 3.0.3), 앱 안 업데이트(APK·EXE 3.0.2 → 3.0.3)
    - 페어링: PC 크롬 5/5, 휴대폰 크롬 6/6, APK 8/8(모두 첫 시도), EXE 5/5, 세척 명령 완료
    - 갤럭시는 "이 출처 허용" 설정이 목록으로 열린다는 안내 추가
2026-11-07 v3.1.0 — 모두의 레시피(공유·TOP 5·검색), AI 키 8곳, 화면 문구 "AI"
    - 모두의 레시피(공유 탭): 기록의 다 만든 잔 → 공유(별명·한마디, AI 설명·팁은 선택)
    - 실제로 많이 만든 순 TOP 5 + 새로 올라온 레시피 + 이름·재료 검색 + 신고 + 내 공유 취소
    - 만든 수는 실제 기기로 만들기 시작할 때 기기당 1번(데모·내 레시피는 세지 않음)
    - 공유 서버: Supabase, 표 직접 접근 없이 함수 5개만(docs/shared-recipes.sql), IP 해시별 하루 한도·신고 숨김·술 이름 판별
    - 성인 인증 전에는 무알콜 레시피만, 내 펌프에 없는 재료는 미리 알려 줌
    - AI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
2026-11-07 문서: v3.1.0 공개 결과 기록 (웹 자동 업데이트·EXE 앱 안 업데이트)
    - 프로젝트_정리 10.2장: 커밋·Actions·Releases v3.1.0, 웹 열린 탭 3.0.3 → 3.1.0 자동 전환,
    공개 주소에서 공유 서버 응답, 3.0.3 EXE → 3.1.0 앱 안 업데이트(받기·SHA-256·새 EXE 실행),
    공개 직후 첫 다운로드 일시 실패(HTTP 400) 뒤 정상, APK 파일 SHA-256 확인
2026-11-08 문서: 프로젝트 이름을 과제명으로 통일
    - README·앱 README·SPEC·펌웨어 README·부품표(BOM.md) 제목을
    "사용자의 감정 및 취향 분석 기반 AI 맞춤형 음료 및 칵테일 배합 메이커"로 바꿈
    - 앱 화면 이름 "AI 스마트 바텐더"는 그대로 두고, 문서에 따로 적음
2026-11-09 하드웨어: 3D 프린팅 부품 7종 추가, 조립가이드를 출력 부품 기준으로 고침
    - hardware/3dprint: 부품별 STL 7종, 업로드용 묶음 2판, parts.py(manifold3d), parts.json, README(출력 조건·주문 구성)
    - 조립가이드: 출력 브래킷·노즐 블록(튜브 끝 z 220)·베젤·그로밋·상판 모서리 캡·튜브 부싱 기준으로 절차·구멍 표·확인 항목 수정, 부록 D와 그림 16·17 추가
    - 교차 검토 반영: 선반 브래킷 측판 구멍 높이 276, 측판 구멍은 조립 전에 뚫기, 볼트로 위치를 맞춘 뒤 접착, 포맥스 기준 그림에 메모
    - README: 폴더 표에 hardware/3dprint 추가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
    [01_corner_bracket.stl, 02_nozzle_block.stl, 03_front_bezel.stl, 04_grommet_20.stl, 05_grommet_12.stl, 06_lid_corner_cap.stl, 07_divider_bushing.stl, plate_A_brackets_x14.stl]
2026-11-09 하드웨어: 최신화 BOM 두 벌 추가 (납땜 기준 / 무납땜 기준)
    - BOM_납땜기준: 지금 설계 그대로, 인두기·열풍기·드릴은 학교 대여 기준. 학교에서 몰아서 할 납땜·구멍 작업 순서 표
    - BOM_무납땜기준: 납땜 20~23곳·솔더 슬리브 8곳을 레버 커넥터(PCT-413/412/415), 하네스 로커 스위치, 인라인 퓨즈홀더, 2.8mm 단자 케이블로 대체
    - 공통: 3D 프린팅 출력 부품 반영(L자 꺾쇠·고무 그로밋 불필요), 용기를 다이소 직사각 저장 용기 970ml로 변경, M3 볼트·너트 24+예비 6, 멀티미터·와이어 스트리퍼 구매
    - 이미 결제한 것(지출_완료 시트)과 앞으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
    [BOM_납땜기준.xlsx, BOM_무납땜기준.xlsx]
2026-11-10 하드웨어: 초보자용 제작가이드 두 벌 추가 (납땜 기준 / 무납땜 기준)
    - 970ml 용기, 주문한 3D 출력 부품, 최신 BOM 두 벌 기준으로 STEP 1~12를 다시 씀
    - 납땜 기준: 학교 실습실 1·2차 방문 계획, 다이오드 하네스 Y자 이음(꼬리가 릴레이 NO·TB2로)
    - 무납땜 기준: 레버 커넥터·선 달린 스위치·인라인 퓨즈, 구멍 뚫는 날 ①②, 뒤판 커넥터 G1~G3
    - 처음 안내, 기본 손기술, 용어 사전, 어디서·난이도 표시, 새 그림(뚜껑·레버·전원·앞판)
    - 한 원본 src/제작가이드.src.md 에서 build_guides.py 로 md·html 두 벌 생성
    - BOM 두 벌·README·예전 조립가이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
    [BOM_납땜기준.xlsx, BOM_무납땜기준.xlsx]
2026-11-10 하드웨어: BOM.xlsx 통합판으로 최신화, 세 BOM에 주문 링크 시트 추가
    - BOM.xlsx/BOM.md: 공통·납땜만·무납땜만 부품을 한 표로 합친 통합판
    (기준별 수량·금액 나란히, 요약·예산 비교 포함)
    - BOM.xlsx·BOM_납땜기준·BOM_무납땜기준 모두 '주문_링크' 시트 추가:
    추가로 살 부품만 구매처별로, 체크칸·단가·수량·금액·상품 페이지 링크
    - 다이소 물건을 실제 상품으로 정함(코스터·네오디뮴 자석·폼 양면테이프),
    자석용 보조 철판 P80 추가, 23A 12V 전지 P72는 디바이스마트 주문에 포함
    - 2학기 합계(VAT 포함): 납땜 238,318원 / 무납땜 244,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
    [BOM.xlsx, BOM_납땜기준.xlsx, BOM_무납땜기준.xlsx, BOM_원본_20261106.xlsx]
2026-11-10 하드웨어: 2026-11-11 무납땜 기준 부품 구매 반영 (거래명세서 대조)
    - 디바이스마트 35품목 결제 102,528원(상품 99,528 + CG0731 배송비 3,000)을
    거래명세서와 대조해 기록 — BOM 무납땜 주문 목록과 품목 모두 일치,
    차이는 볼트 P37·너트 P38 30→25개(필요 24), 단가 P05·P28·P39 낮음, P72 770원
    - 다이소 6품목 14,000원(배송비 3,000원 포함), 3D 프린팅 실제 결제 78,700원
    → 2학기 지출 238,228원, 무납땜 기준 앞으로 살 것 0원
    (납땜 기준으로 바꾸면 P13·P14·P26 + 배송비 → 246,131원)
    - 생성기: bom_variants.json의 purchases(구매 기록)로 보유·구매 수량·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
    [BOM.xlsx, BOM_납땜기준.xlsx, BOM_무납땜기준.xlsx]
2026-11-12 앱: 처음 쓰는 사람을 위한 사용법 안내(튜토리얼) 추가
    - 처음 접속하면 환영 창: [사용법 보기 (1분)] / [건너뛰기] — 이미 아는 사람은 바로 사용
    - 안내: 실제 화면을 차례로 열어 해당 칸을 밝게 비추며 9단계로 설명
    (기분·맛 고르기 → AI 레시피 만들기 → 레시피·제조 → 재료 → 기기 연결 →
    캘리브레이션 → 모두의 레시피 → 기록 → 내 AI 고르기), 마지막 [첫 잔 만들어 보기]
    - 다시 보기: 설정 화면 맨 위 '사용법'(이미 봤어도 처음부터) · 바텐더 화면 ? 버튼
    - 키보드 → ← Esc, 안드로이드 뒤로 버튼(안내 닫기), 화면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
